BroncoSpace-Lab/scales-hardware/README.md

# scales-hardware
Hardware design files for the Spacecraft Compartmentalized Autonomous Learning and Edge Computing System (SCALES)
