BroncoSpace-Lab/scales-hardware/power_system/readme.md

    
- **Viking 1-C Board Ordered (7/9/25)**
    
    This is the third board of the SCALES EPS. It is based on the RevF schematic which yields the Viking 1-C Board. This board improves on the success of the 1-B board and implements some minor improvements that prevented the Peripheral and Jetson subsystem from activating correctly. 
    
    **List of Changes in Viking 1-C After Production Errors in Viking 1-B**
    
    - Removed R48
    - Removed R83
    - The above mentioned resistors caused too low of a voltage to fully enable the En pins on the load switches, and by simply removing them we can successfully drive the load switches on using GPIO pins.
    - Added 3 MCP9808 I2C Temperature Sensors so we can have some on board temp monitoring, I made sure the addresses dont conflict with that of the other i2c devices on board.
    
    **EPS REV F/ Viking 1-C System Overview:**
    
    - Power Requirements (+28v 8A Max)
        - ML/Edge Computer - Nvidia Jetson (+20V 4A)
        - OBC/Flight Computer - IMX8 (+3.3V 2A)
        - Peripheral System - Raspberry Pi + Wiznet (+5V 2A)
    - Component List
        - Load Switch + Controller: [TPS1HA08-Q1](https://www.ti.com/lit/ds/symlink/tps1ha08-q1.pdf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)
        - Switching Regulator: [LT8612](https://jlcpcb.com/api/file/downloadByFileSystemAccessId/8589836477510287360)
        - IV-Sensor: [INA260AIPWR](https://jlcpcb.com/api/file/downloadByFileSystemAccessId/8589836477510287360)
        - Temperature Sensor: [MCP9808](https://www.microchip.com/en-us/product/mcp9800)
        - Clock Generator: [LTC6902](https://www.analog.com/media/en/technical-documentation/data-sheets/6902f.pdf)
        - I2C Buffer: [TCA4307](https://www.ti.com/lit/ds/symlink/tca4307.pdf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)
        - Comparator (WD Circuit): [TLV1704](https://www.ti.com/lit/ds/symlink/tlv1704-sep.pdf)
        - Subsystem Connector: [DF-11 (2x8)](https://www.lcsc.com/product-detail/Wire-To-Board-Wire-To-Wire-Connector_HRS-Hirose-HRS-DF11-16DP-2DSA-08_C530981.html)
        - Power Connector: [XT-60PWF](https://www.lcsc.com/product-detail/plug_Changzhou-Amass-Elec-XT60PW-F_C428722.html)
    - Concept of Operations
        - OBC is the primary subsystem, which is always enabled. The OBC controls the ML and Perif. via load switches. OBC must hold the respective subsystem EN pin high for it to be active.
        - Each subsystem has a Watch dog that verifies its normal operation; in the case of a fault, the subsystem is disabled by its watch dog.
            - OBC: If the OBC hangs and fails to pet, it is power cycled, as the EN pin for its load switch is always held high with respect to the battery voltage
            - ML/Perif: If either of these subsystems hang and fail to pet, they are disabled until the OBC re-enables them.
        - Monitoring is done by the OBC via I2C from the INA260s, which allows the subsystem to get basic telemetry on the subsystem state of operation
        - There are also 3 seperate temperature sensors that send telemetry back to the IMX8X over a 3.3v I2C
    
    **Block Diagram and Visual Con. Ops**
    
    - EPS RevF Block Diagram

      

    - EPS RevF Concept of Operations
        
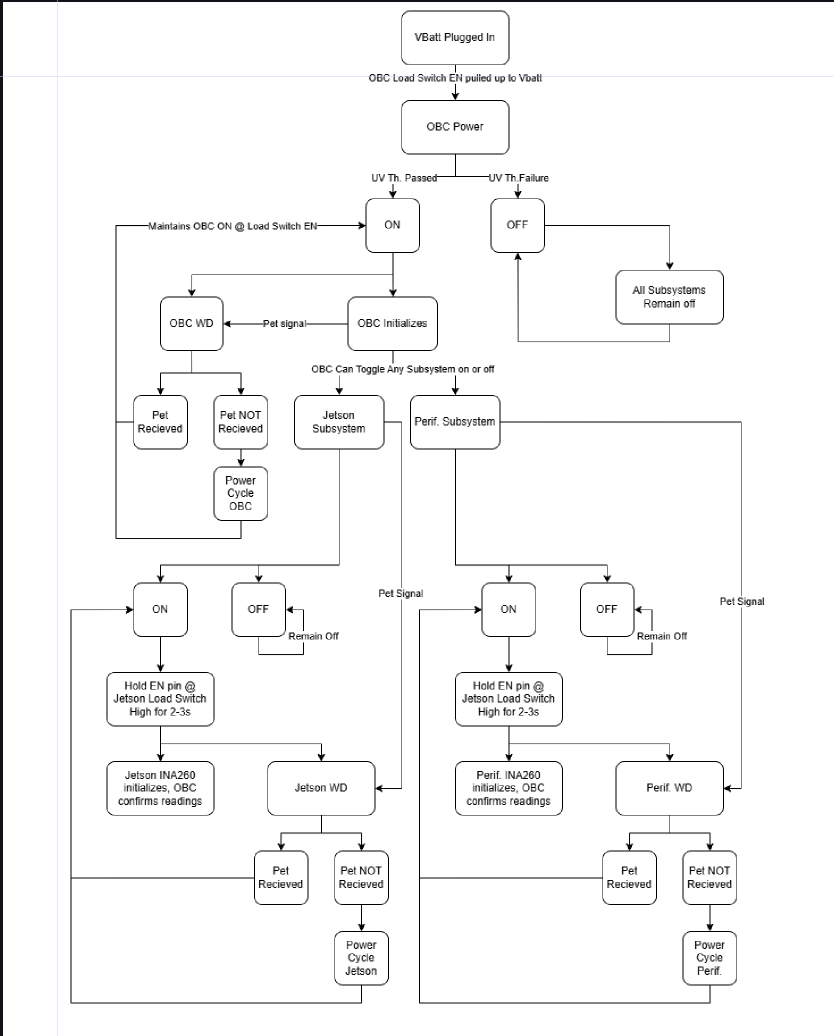
[picture p1: power_system/images/RevE/RevE Con Cops.png]
EPS RevE Con Ops
        

    **Board Schematic**
    
    - Root
        
       
        
    - OBC Subsystem
        
        
        
    - Perif. Subsystem
        
       
        
    - Jetson Subsystem
        
       
        
    - OBC Watchdog Circuit
        
        
        
    - Peripheral Watchdog Circuit
        
       
        
    - Jetson Watchdog Circuit
        
       

    **Board Layout**
    
    - Signal1 Layer
        
        
        
    - GND Layer
        
       
        
    - Power Layer
        
        
        
    - Signal2 Layer
        
        

    **3D Render Front and Back**
    
    - Front
        
        
        
    - Back
        
        
      
###  Viking 1-B Board Ordered (6/20/25) ###
This is the second board of the SCALES EPS. It is based on the RevE schematic which yields the Viking 1-B Board. It seeks to improve on numerous calculation and placement errors in the first prototype. Particularly miscalculated resistor and inductor values as well as significant improvements in placement, routing, fills, and smaller components.

### List of Changes in Viking 1-B After Production Errors in Viking 1-A ###
* R66 was incorrect in 1-A, should have been a 100k, was a 10k instead. Fixed in this revision
* L2 was 8.2uH, should have been 6.1uH (OBC Subsystem)
* L1 was 12uH, should have been 10uH (Perif. Subsystem)
* L3 was 4.7uH, should have been 47uH (Jetson Subsystem)
* Most capacitors were changed to 50V/35V rated 0603 caps, any others are 10v 0402 caps.
* Small change to the Jetson WD circuit, adding a voltage divider to make the voltage safe for the the 10v 0402 caps
* Soft start capacitor was changed for each subsystem, set to 2.2uF for about 1 second. Using the V(t) = (I/C) * t equation, rearrange for t, and I is 2.1*10^-6, C is 2.2uF, and V(t) is 0.97v.
* LEDs on ST pin for all load switches were rearranged for (hopefully) proper fault indication
* 4.7k resistor removed for the I2C buffer
* Connectors were changed for identical variants of the 2*8 Df11 due to low stock
* D1N141WS diodes were changes to D1N4448WS diodes. Almost identical, same package
* Replaced mounting holes with slightly larger ones to match the M2.5 Spec (2.7mm hole diameter)

## EPS_REVE / Viking 1-BSystem Overview: ##

- Power Requirements (+28v 8A Max)
    - ML/Edge Computer - Nvidia Jetson (+20V 4A)
    - OBC/Flight Computer - IMX8 (+3.3V 2A)
    - Peripheral System - Raspberry Pi + Wiznet (+5V 2A)
- Component List
    - Load Switch + Controller: [TPS1HA08-Q1](https://www.ti.com/lit/ds/symlink/tps1ha08-q1.pdf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)
    - Switching Regulator: [LT8612](https://jlcpcb.com/api/file/downloadByFileSystemAccessId/8589836477510287360)
    - IV-Sensor: [INA260AIPWR](https://jlcpcb.com/api/file/downloadByFileSystemAccessId/8589836477510287360)
    - Clock Generator: [LTC6902](https://www.analog.com/media/en/technical-documentation/data-sheets/6902f.pdf)
    - I2C Buffer: [TCA4307](https://www.ti.com/lit/ds/symlink/tca4307.pdf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)
    - Comparator (WD Circuit): [TLV1704](https://www.ti.com/lit/ds/symlink/tlv1704-sep.pdf)
    - Subsystem Connector: [DF-11 (2x8)](https://www.lcsc.com/product-detail/Wire-To-Board-Wire-To-Wire-Connector_HRS-Hirose-HRS-DF11-16DP-2DSA-08_C530981.html)
    - Power Connector: [XT-60PWF](https://www.lcsc.com/product-detail/plug_Changzhou-Amass-Elec-XT60PW-F_C428722.html)
- Concept of Operations
    - OBC is the primary subsystem, which is always enabled. The OBC controls the ML and Perif. via load switches. OBC must hold the respective subsystem EN pin high for it to be active.
    - Each subsystem has a Watch dog that verifies its normal operation; in the case of a fault, the subsystem is disabled by its watch dog.
        - OBC: If the OBC hangs and fails to pet, it is power cycled, as the EN pin for its load switch is always held high with respect to the battery voltage
        - ML/Perif: If either of these subsystems hang and fail to pet, they are disabled until the OBC re-enables them.
    - Monitoring is done by the OBC via I2C from the INA260s, which allows the subsystem to get basic telemetry on the subsystem state of operation

## Block Diagram and Visual Con. Ops ##

* EPS RevE Block Diagram

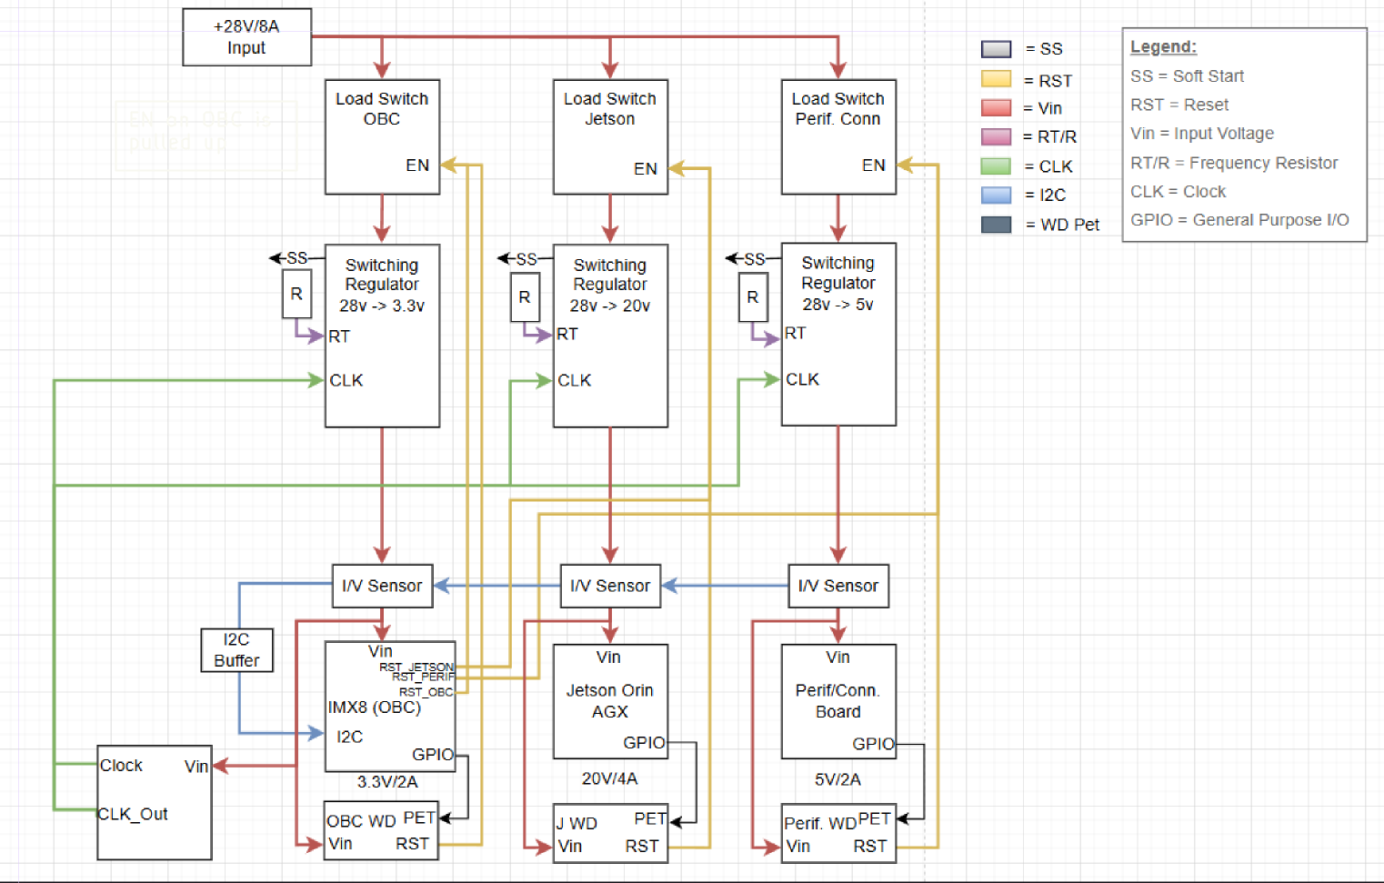
[picture p2: power_system/images/RevE/EPSREVEBlockDiagram.png]
EPS RevE Block Diagram
    

* EPS RevD Concept of Operations

    EPS RevE Con Ops

## **Board Schematic** ##
* Root

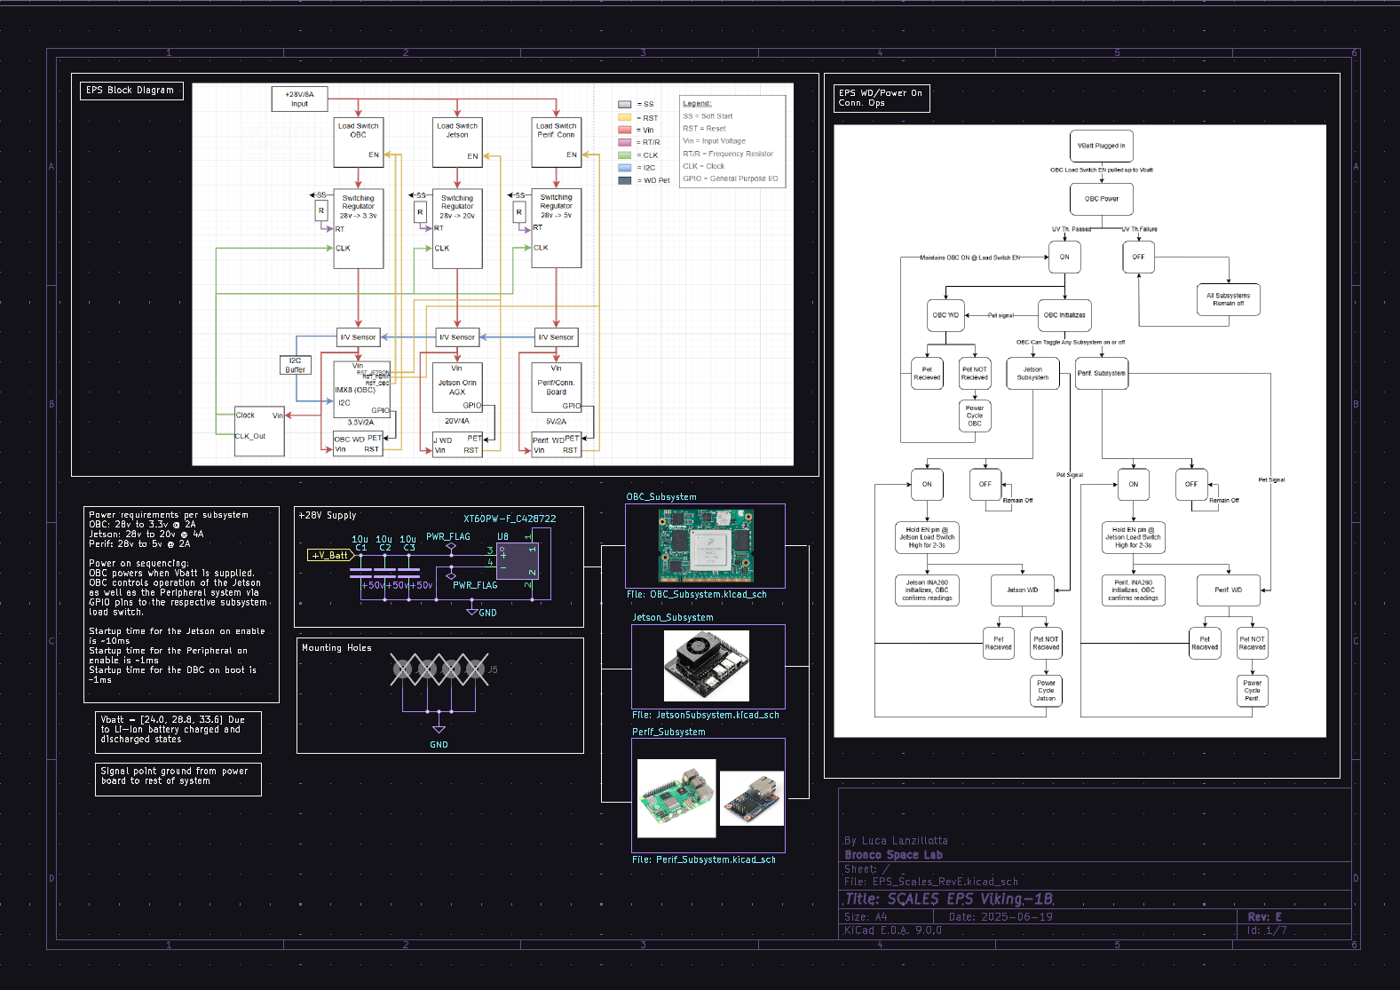
[picture p3: power_system/images/RevE/Root.png]
Root
    

* OBC Subsystem

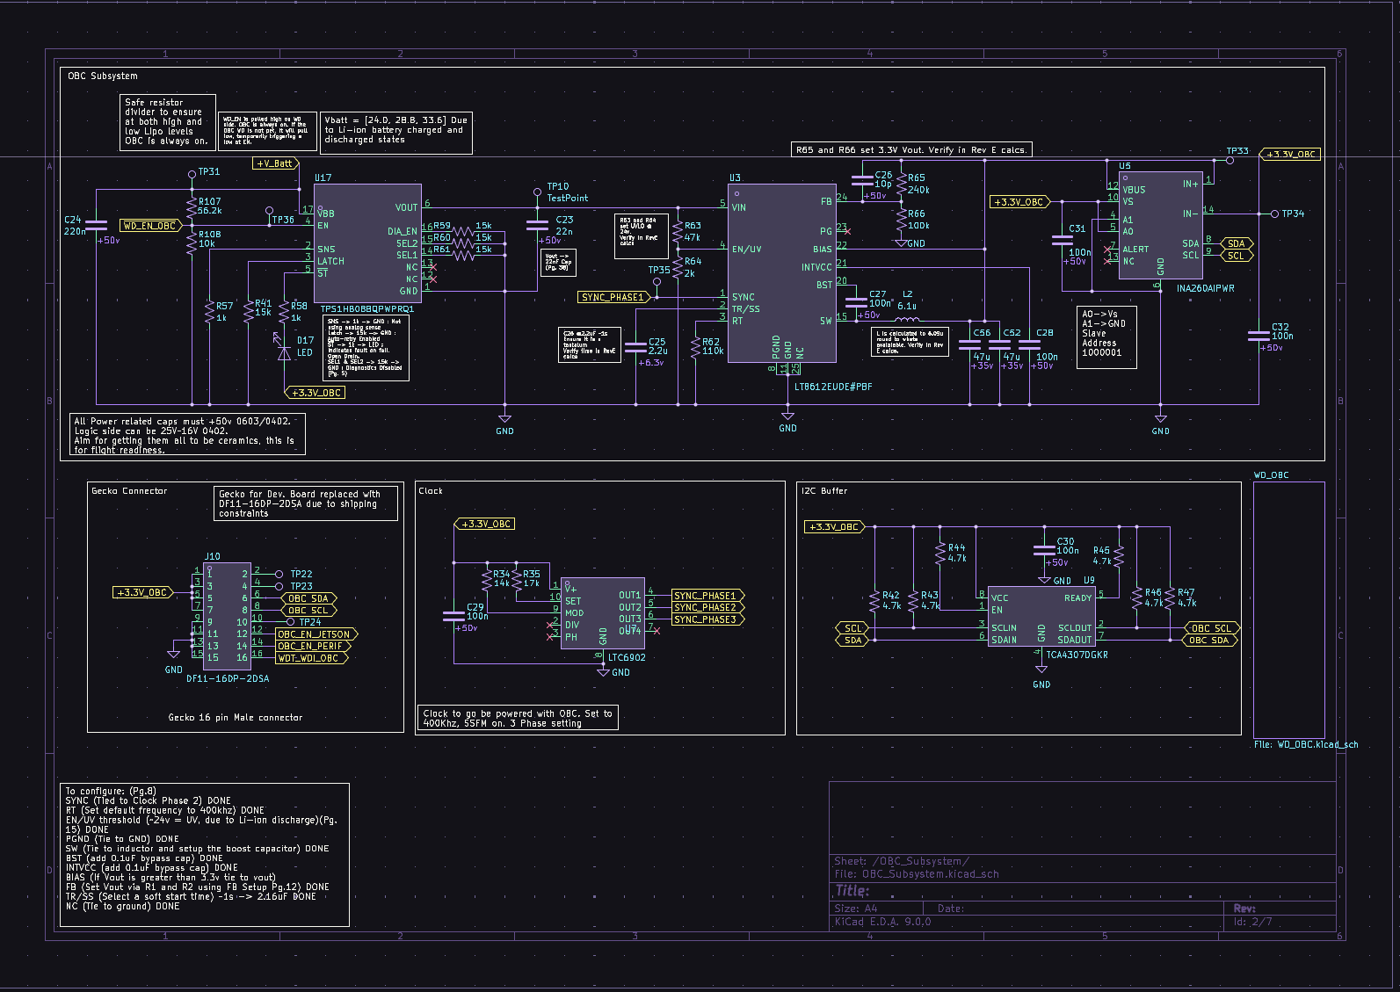
[picture p4: power_system/images/RevE/OBCSubsystem.png]
OBC Subsystem
    

* Perif. Subsystem

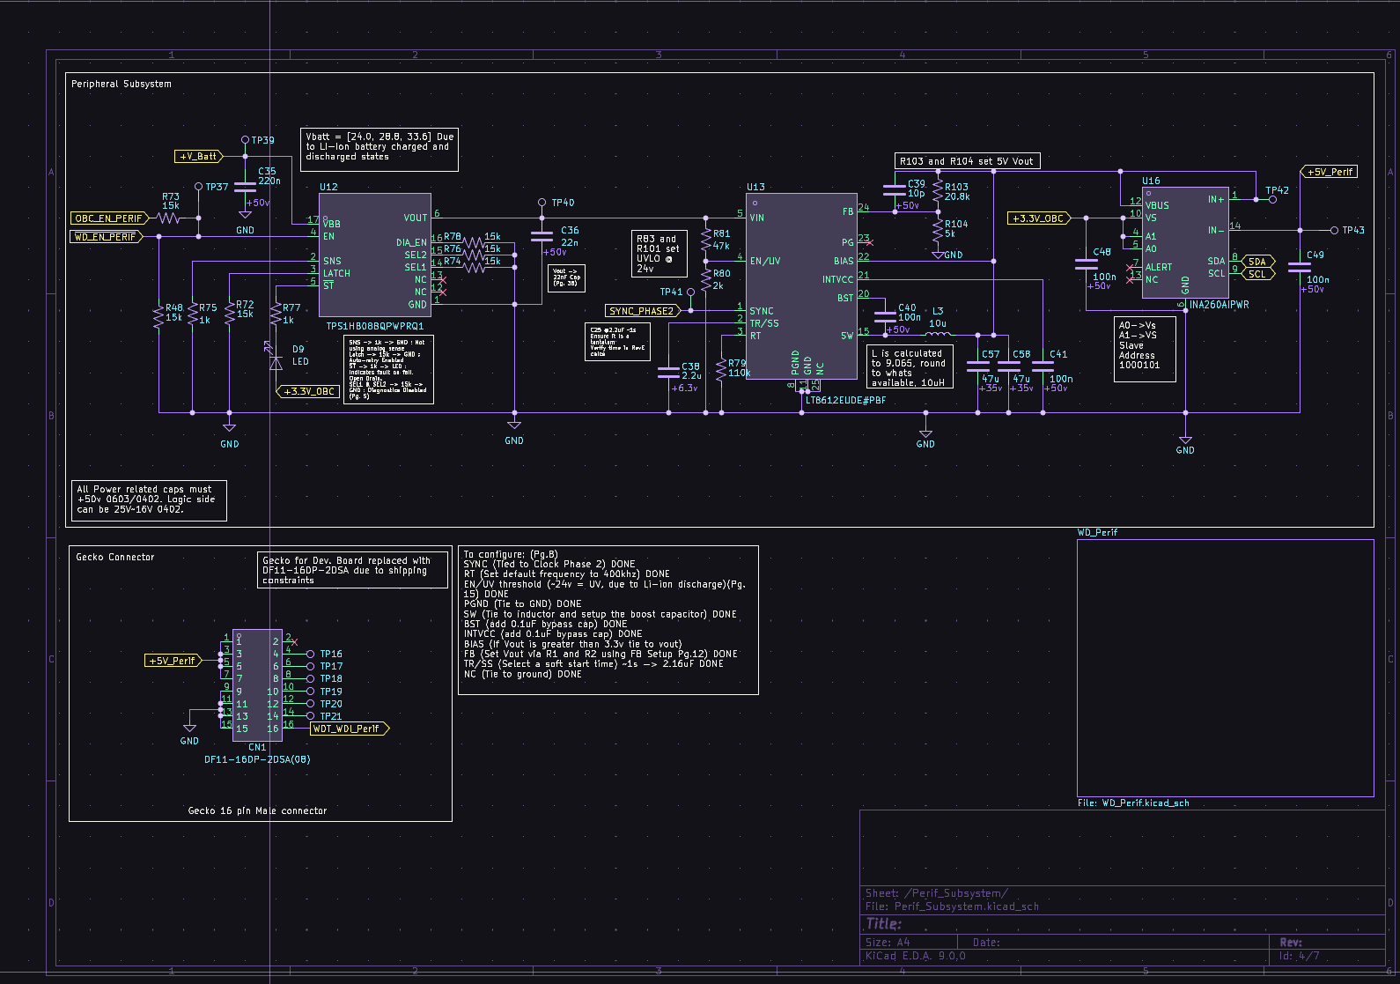
[picture p5: power_system/images/RevE/Perif.Subsystem.png]
Perif. Subsystem
    

* Jetson Subsystem

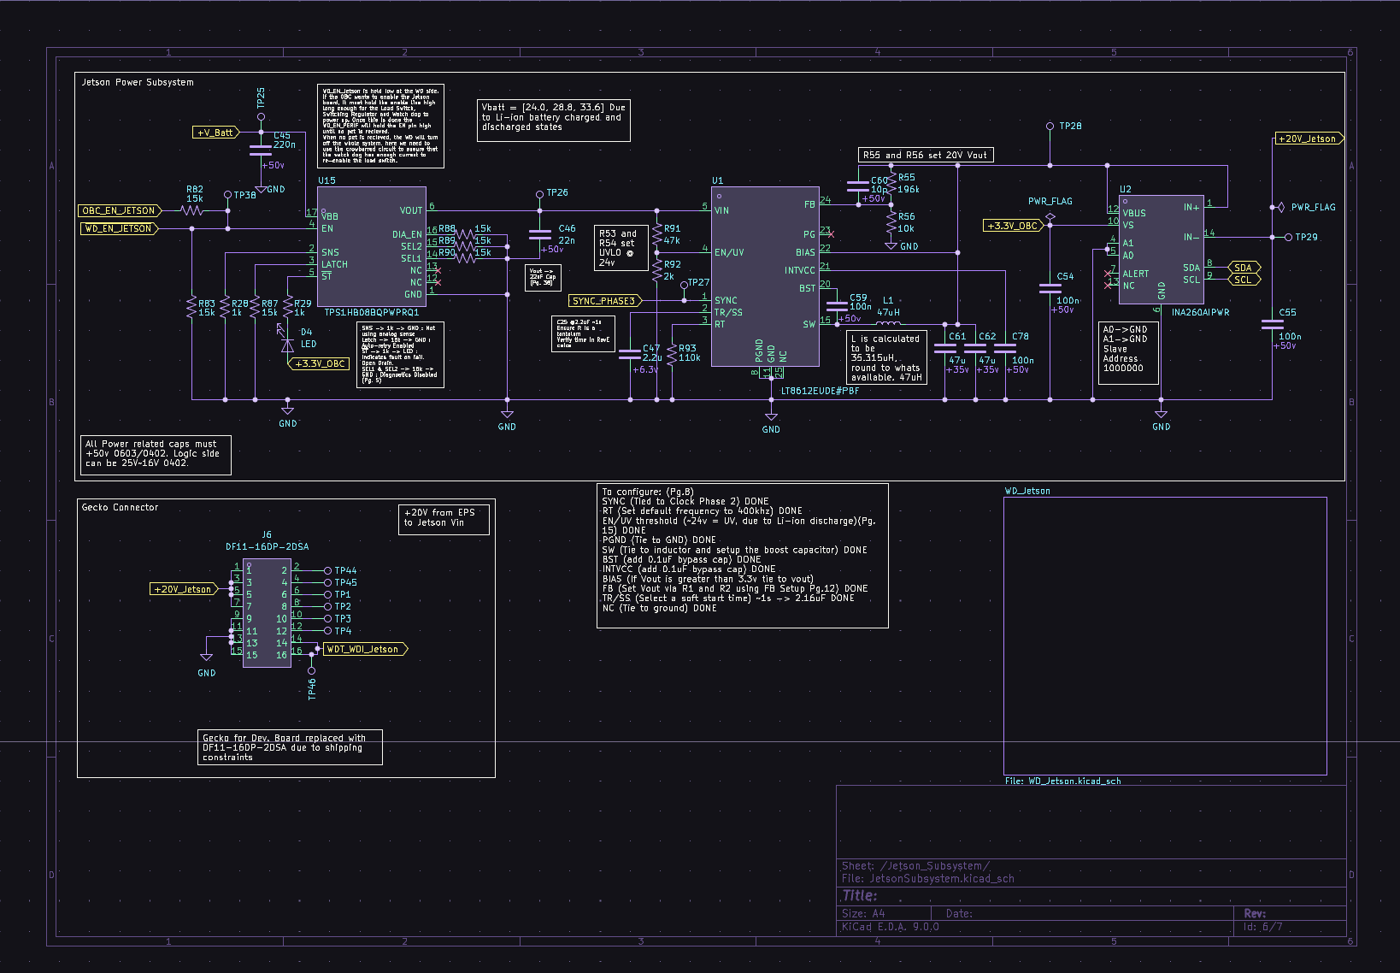
[picture p6: power_system/images/RevE/JetsonSubsystem.png]
Jetson Subsystem
    

* OBC Watchdog Circuit

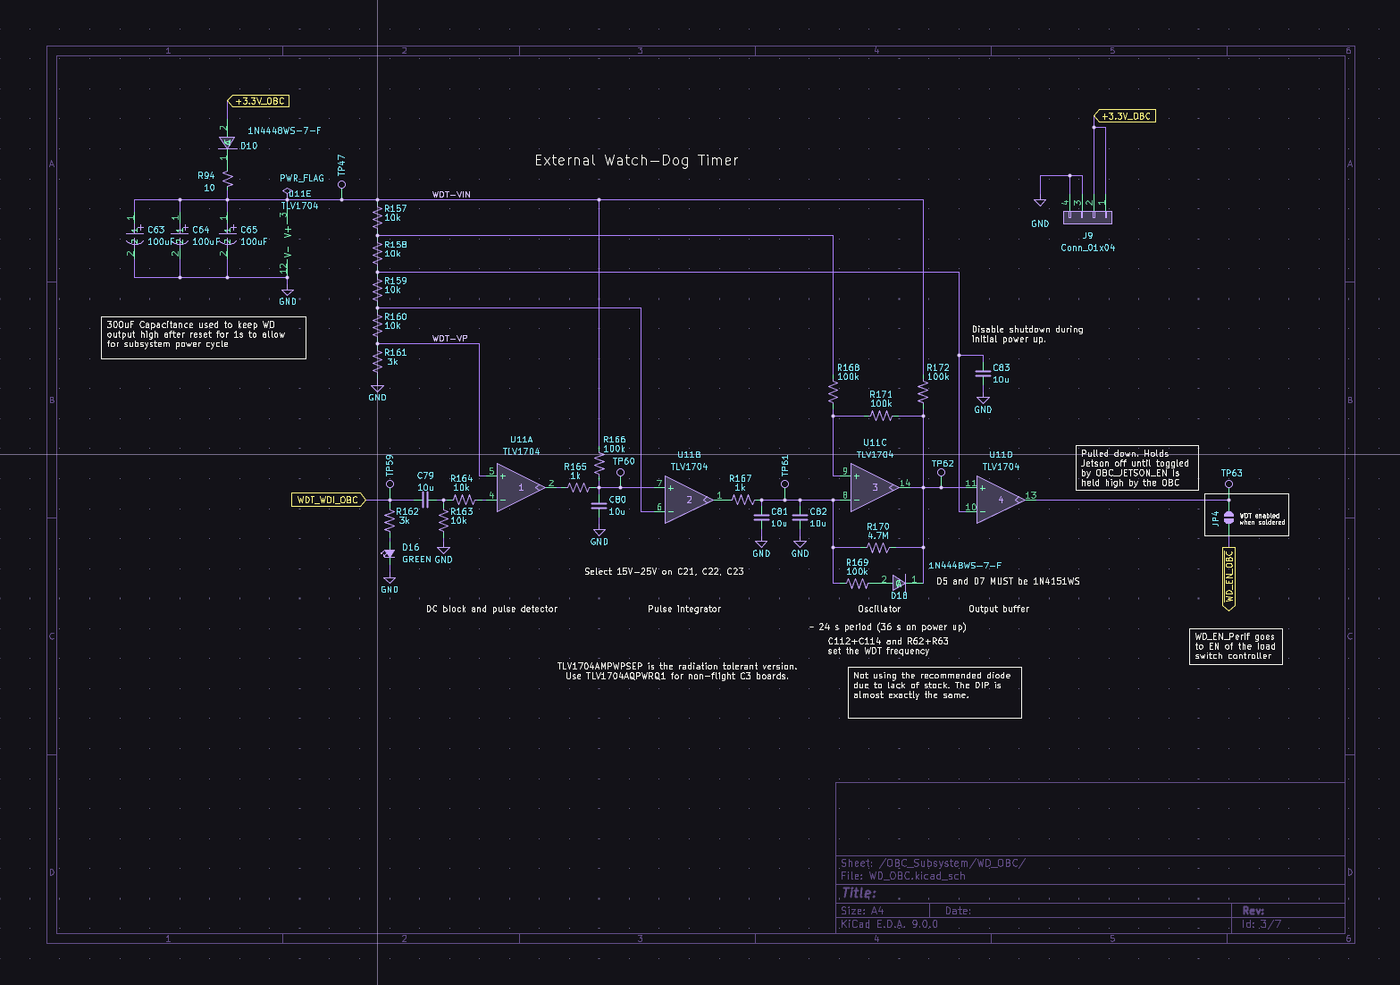
[picture p7: power_system/images/RevE/OBCWD.png]
    

* Peripheral Watchdog Circuit

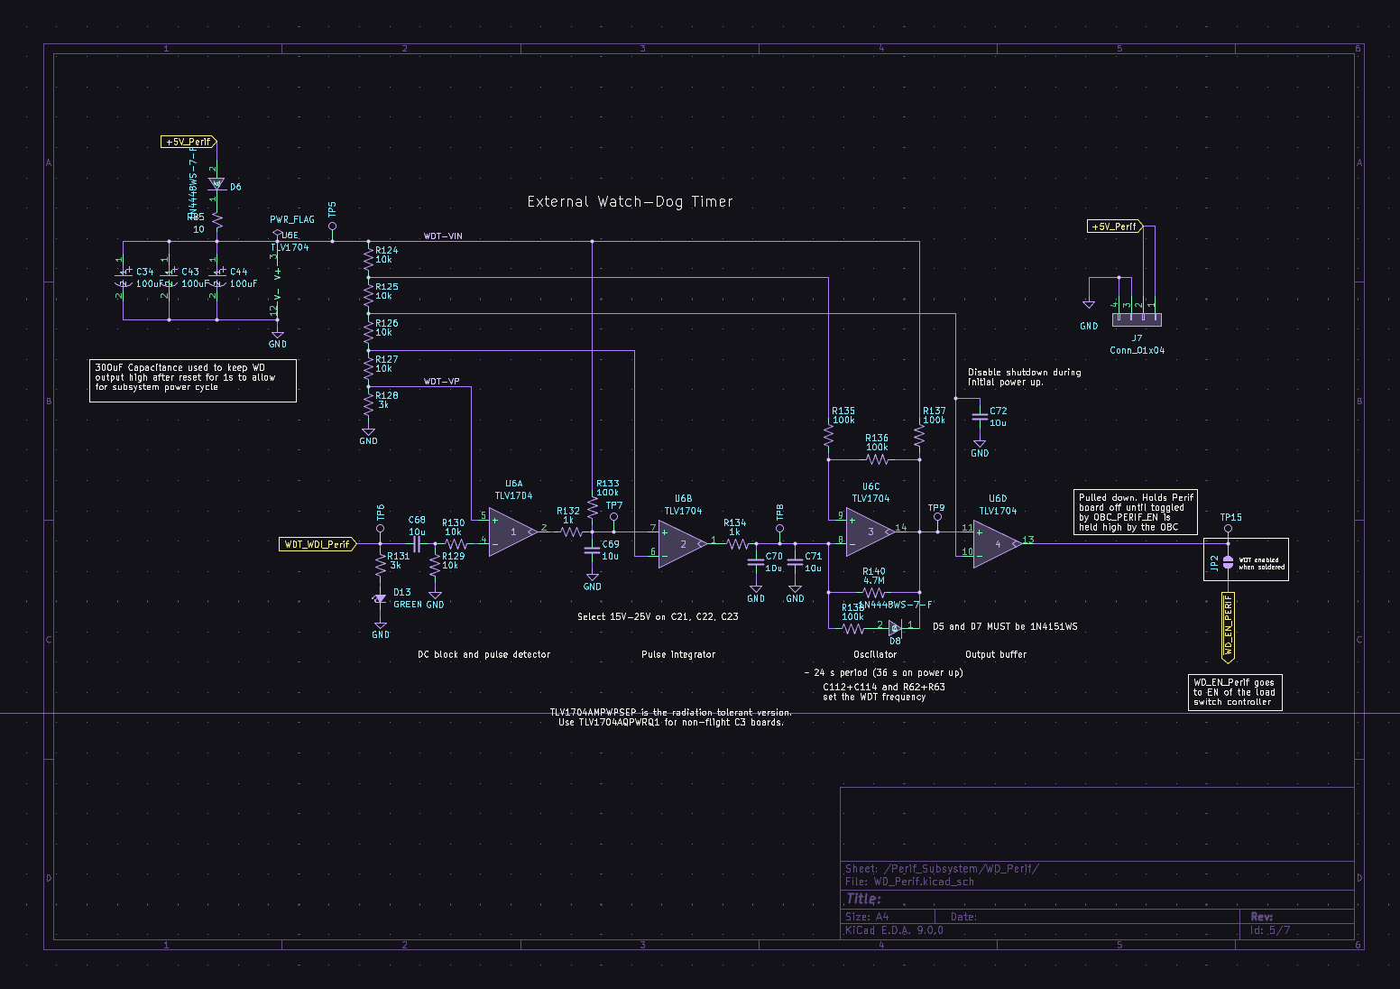
[picture p8: power_system/images/RevE/PerifWD.png]
    

* Jetson Watchdog Circuit
    
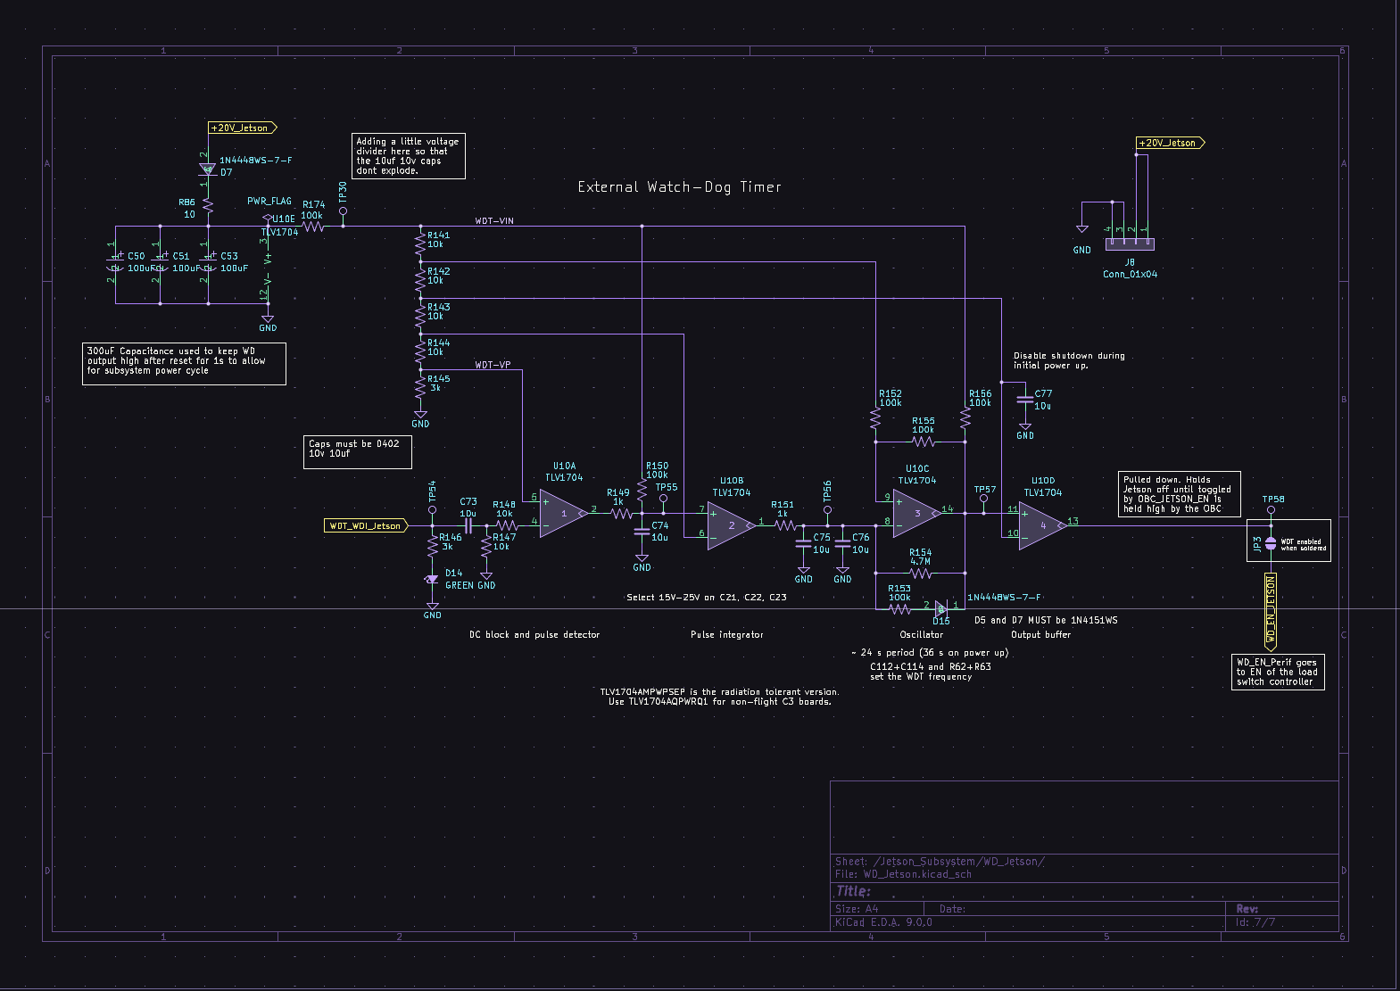
[picture p9: power_system/images/RevE/JetsonWD.png]
    

## **Board Layout** ##

* Signal1 Layer

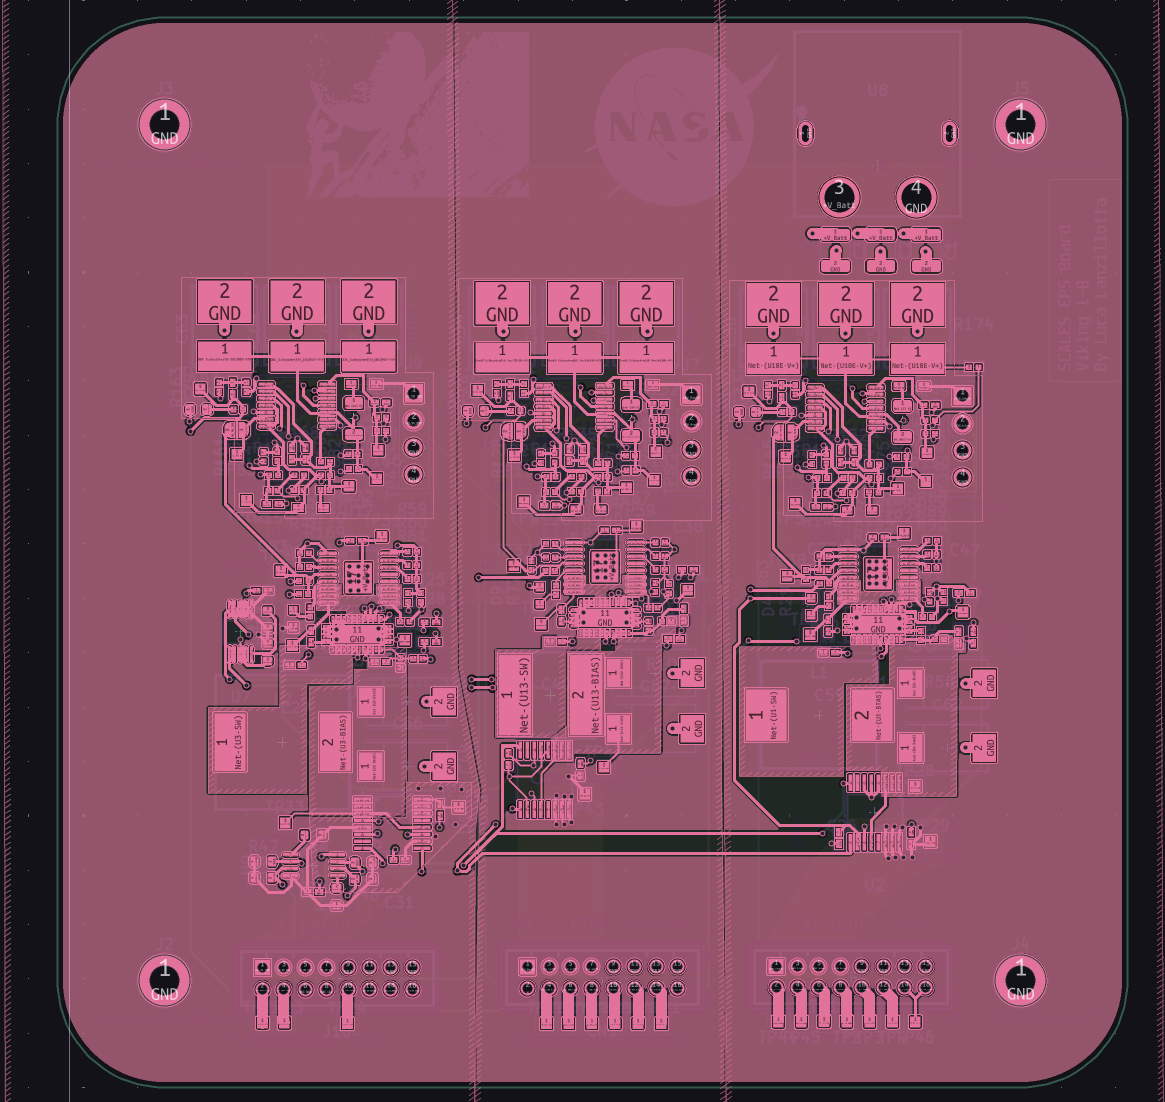
[picture p10: power_system/images/RevE/Signal1.png]
Signal1 Layer
    
    
* GND Layer

    GND Layer
    
* Power Layer

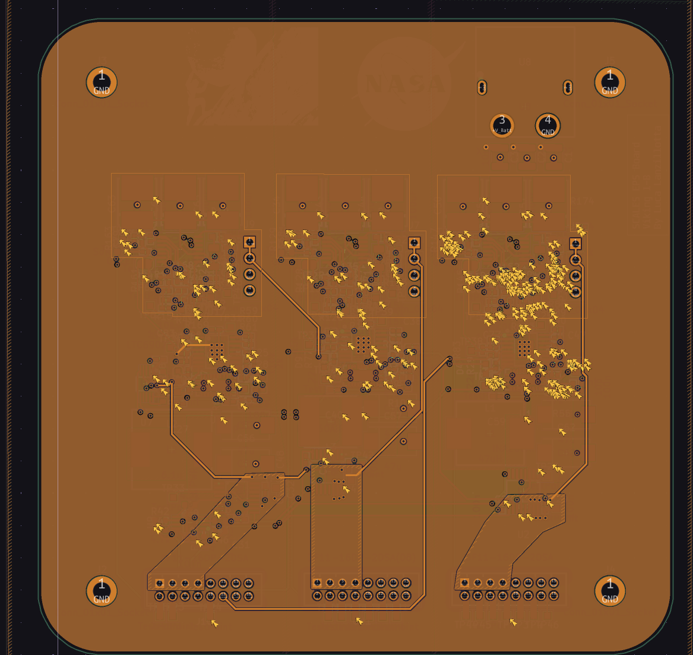
[picture p11: power_system/images/RevE/Power.png]
Power Layer
    
    
* Signal2 Layer

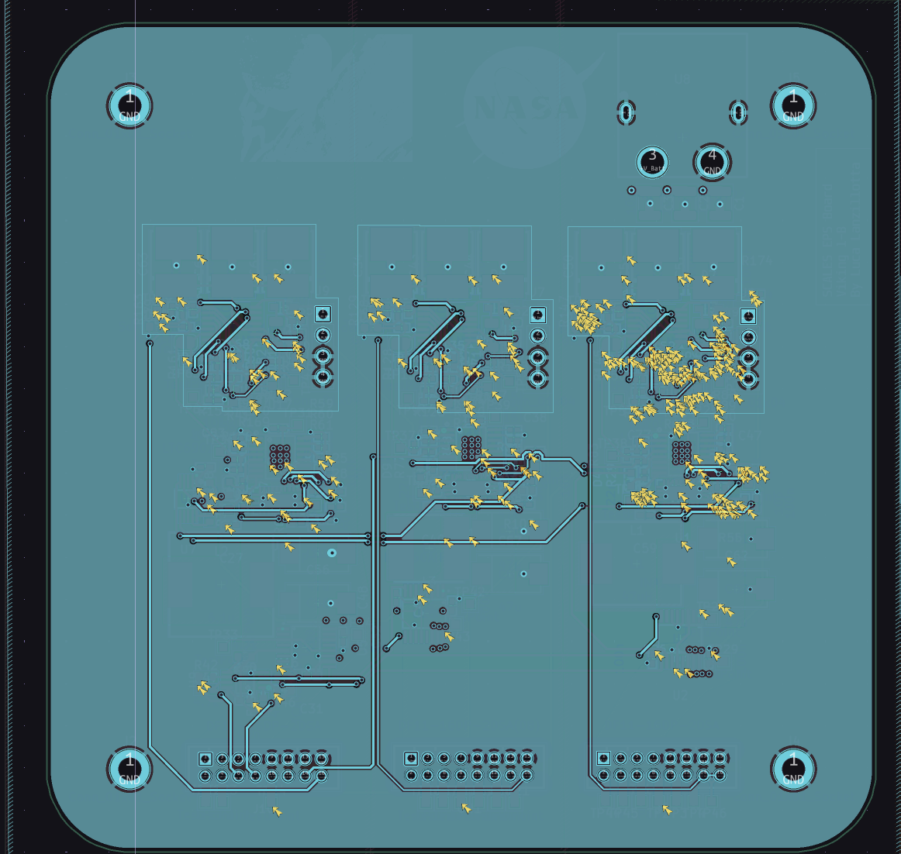
[picture p12: power_system/images/RevE/Signal2.png]
Signal2 Layer
    
    
## 3D Render Front and Back ##
    
* Front

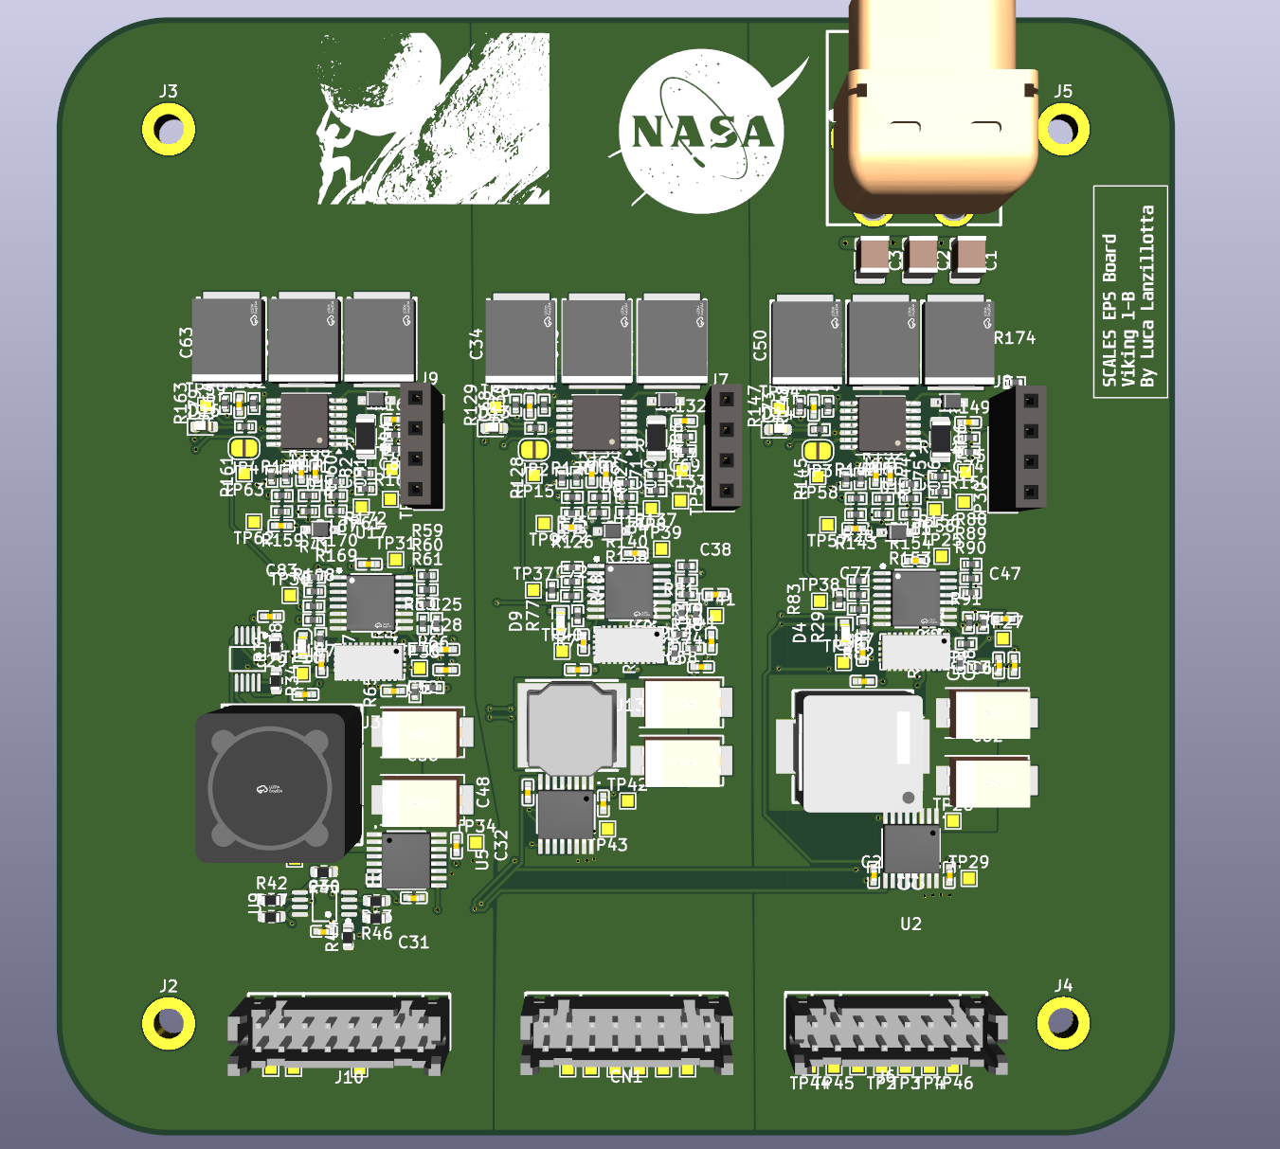
[picture p13: power_system/images/RevE/Front.png]
Front
    
        
* Back   

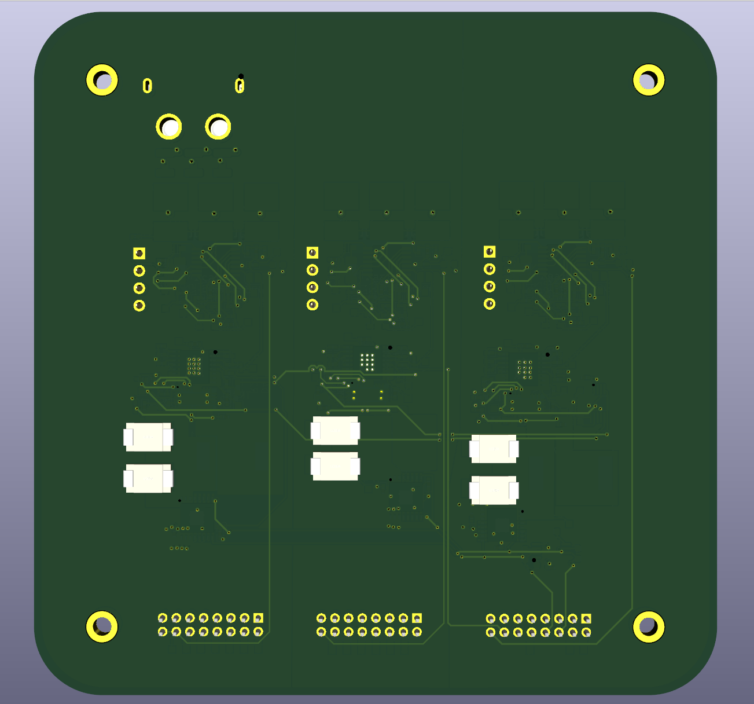
[picture p14: power_system/images/RevE/Back.png]
Back
    

## **Testing and Evaluation**

Using the on board test points in the schematic, we can check if all the voltages behave as designed. Use the below references to check if the expectations are met.

Overall Board:

- [ ]  TP 31, 39, 25  → 28v (Vbatt)
- [ ]  Mounting Holes → GND

OBC Subsystem:

- [ ]  TP 36 → EN (Should be 28*10k/66.2k)
- [ ]  TP 32 → ~28v to Switching Regulator
- [ ]  TP 35 → SYNCPHASE1 (400Khz 0 deg out of phase)
- [ ]  TP 33 → Output of Switching regulator (~3.3V)
- [ ]  TP 34 → Output of INA260 (~3.3V)

WD_OBC:

- [ ]  TP 48 → Ensures WD is supplied with power
- [ ]  TP 49 → WD Input from OBC GPIO for pet
- [ ]  TP 53 → WD Open collector output, can only drive low, otherwise floating

Jetson Subsystem: 

- [ ]  TP 38 → Tests the GPIO input from the OBC/WD EN Pin (Should be held high when System is active, low on PET failure)
- [ ]  TP 25 → ~28v (Vbatt)
- [ ]  TP 26 → ~28v output from load switch
- [ ]  TP 27 → SYNCPHASE3 (400khz 180 deg out of phase from PHASE1)
- [ ]  TP28 → ~20v (Output from Switching regulator)
- [ ]  TP 29 → ~20v (Output from INA290 to Jetson Subsystem)
    
    WD_OBC:
    
    - [ ]  TP 10 → Check WD Supply power, should be 20v
    - [ ]  TP 11 → WD Interface input line, held high when there is a pet
    - [ ]  TP 47 Open collector output from the Watchdog, should be half of whatever the OBC GPIO pin voltage is when high, and then ground any other time

Peripheral Subsystem:

- [ ]  TP 39 → ~28v (Vbatt)
- [ ]  TP 82 → OBC GPIO input for EN line and WD En line, should be ~1.4v when high for OBC holding it high, and low when not held high.
- [ ]  TP 40 → ~28v output of the load switch
- [ ]  TP 41 → SYNCPHASE2 Output of LTC6902 (400khz 90 deg out of phase)
- [ ]  TP 42 → Input regulated power to the INA260, should be roughly +5v
- [ ]  TP 43 → output for the Peripheral subsystem, should be roughly +5v
    
    WD_Perif:
    
    - [ ]  TP 5 → 5v supply to power the watch dog
    - [ ]  TP 15 → WD Perif output always pulled low, should be low when the system is off, and held high when the OBC enables it, when the pet fails it will hold low until the subsystem turns off.

------------------------------------------------------------------------------------------------------------------------------------------

###  Viking 1-A Board Ordered (6/4/25) ###
The first board that was ordered was based on the EPS SCALES REV D schematic and is the Viking 1-A board.
This board can be found on github with the commit titled the same name.
This board does have some production issues which were already fixed and committed under the same name.
The production errors that this board include are simple, which is why they are included under the same board revision, they are simply lack of copper fills over the remaining area of the board which were corrected by the manufacturer. Post evaluation and testing of the Viking 1-A board will allow for next design implementation and lead to the Viking 1-B board.

### List of Changes After Production Errors for Viking 1-A ###
Copper fills were missing around the majority of non power traces and were causing difficulties in manufacuring, this was corrected by JLCPCB by their fab engineers, but I took the liberty of adding the same type of corrections to the existing board version. These are included in the latest commit.

## EPS_REVD / Viking 1-A System Overview: ##

- Power Requirements (+28v 8A Max)
    - ML/Edge Computer - Nvidia Jetson (+20V 4A)
    - OBC/Flight Computer - IMX8 (+3.3V 2A)
    - Peripheral System - Raspberry Pi + Wiznet (+5V 2A)
- Component List
    - Load Switch + Controller: [TPS1HA08-Q1](https://www.ti.com/lit/ds/symlink/tps1ha08-q1.pdf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)
    - Switching Regulator: [LT8612](https://jlcpcb.com/api/file/downloadByFileSystemAccessId/8589836477510287360)
    - IV-Sensor: [INA260AIPWR](https://jlcpcb.com/api/file/downloadByFileSystemAccessId/8589836477510287360)
    - Clock Generator: [LTC6902](https://www.analog.com/media/en/technical-documentation/data-sheets/6902f.pdf)
    - I2C Buffer: [TCA4307](https://www.ti.com/lit/ds/symlink/tca4307.pdf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)
    - Comparator (WD Circuit): [TLV1704](https://www.ti.com/lit/ds/symlink/tlv1704-sep.pdf)
    - Subsystem Connector: [DF-11 (2x8)](https://www.lcsc.com/product-detail/Wire-To-Board-Wire-To-Wire-Connector_HRS-Hirose-HRS-DF11-16DP-2DSA-08_C530981.html)
    - Power Connector: [XT-60PWF](https://www.lcsc.com/product-detail/plug_Changzhou-Amass-Elec-XT60PW-F_C428722.html)
- Concept of Operations
    - OBC is the primary subsystem, which is always enabled. The OBC controls the ML and Perif. via load switches. OBC must hold the respective subsystem EN pin high for it to be active.
    - Each subsystem has a Watch dog that verifies its normal operation; in the case of a fault, the subsystem is disabled by its watch dog.
        - OBC: If the OBC hangs and fails to pet, it is power cycled, as the EN pin for its load switch is always held high with respect to the battery voltage
        - ML/Perif: If either of these subsystems hang and fail to pet, they are disabled until the OBC re-enables them.
    - Monitoring is done by the OBC via I2C from the INA260s, which allows the subsystem to get basic telemetry on the subsystem state of operation

## Block Diagram and Visual Con. Ops ##

* EPS RevD Block Diagram

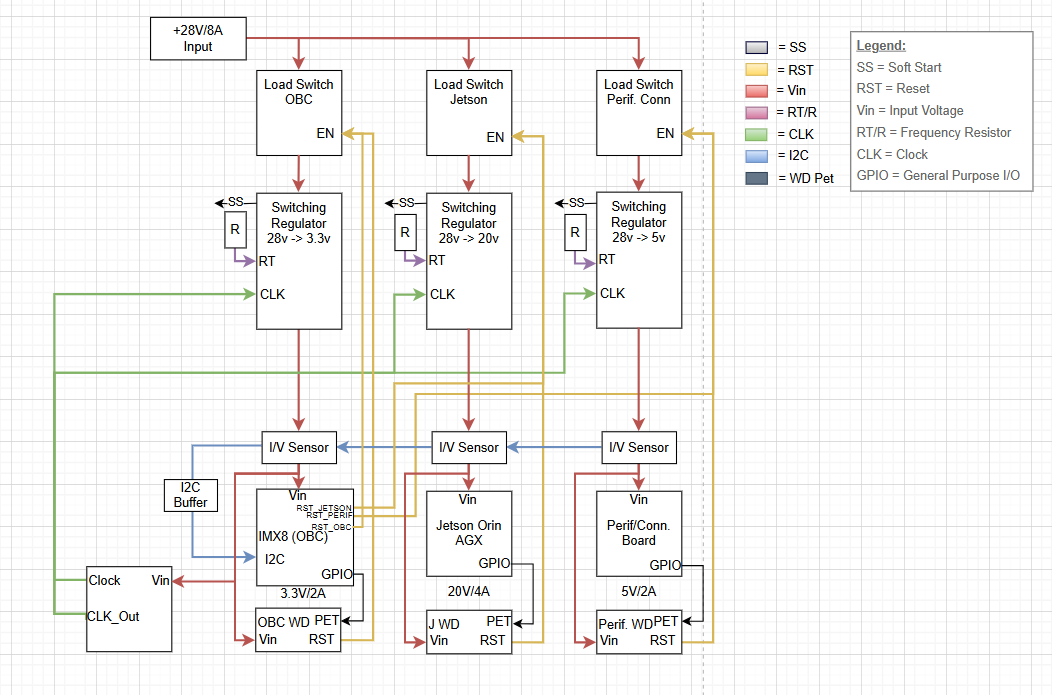
[picture p15: power_system/images/RevD/Block_Diagram_EPSREVD.png]
EPS RevD Block Diagram
    

* EPS RevD Concept of Operations

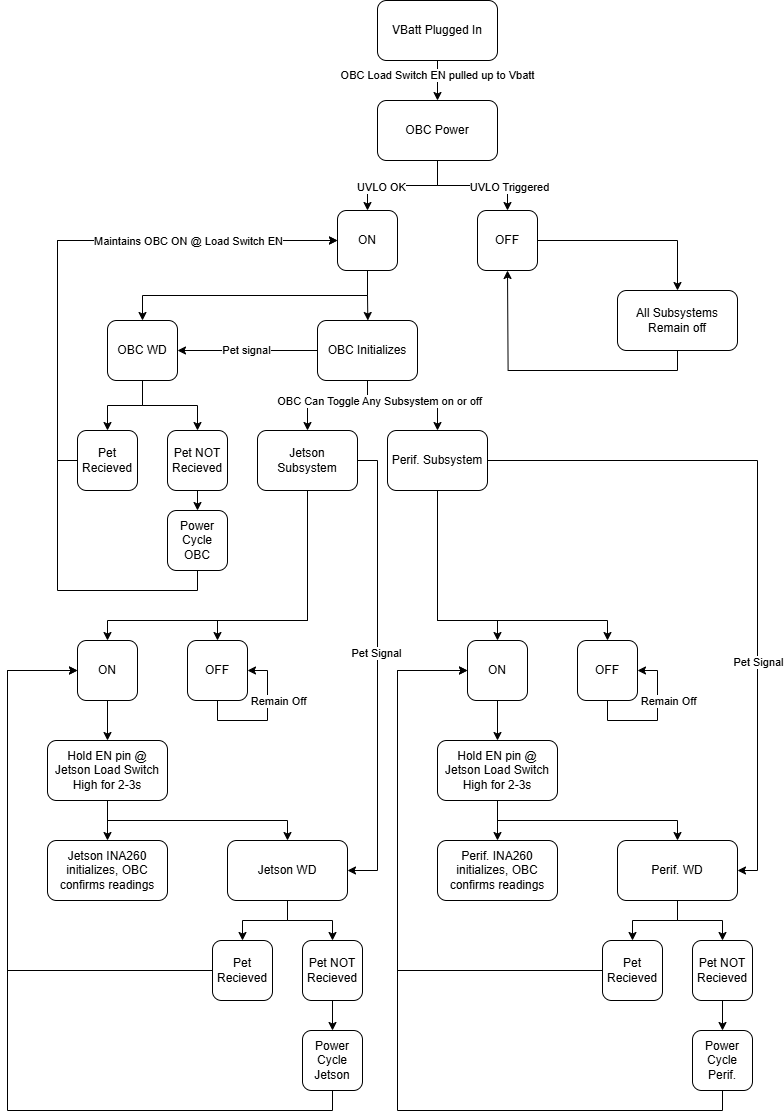
[picture p16: power_system/images/RevD/EPS_RevD_ConnOps.drawio.png]
EPS RevD Concept of Operations
    

## **Board Schematic** ##
* Root

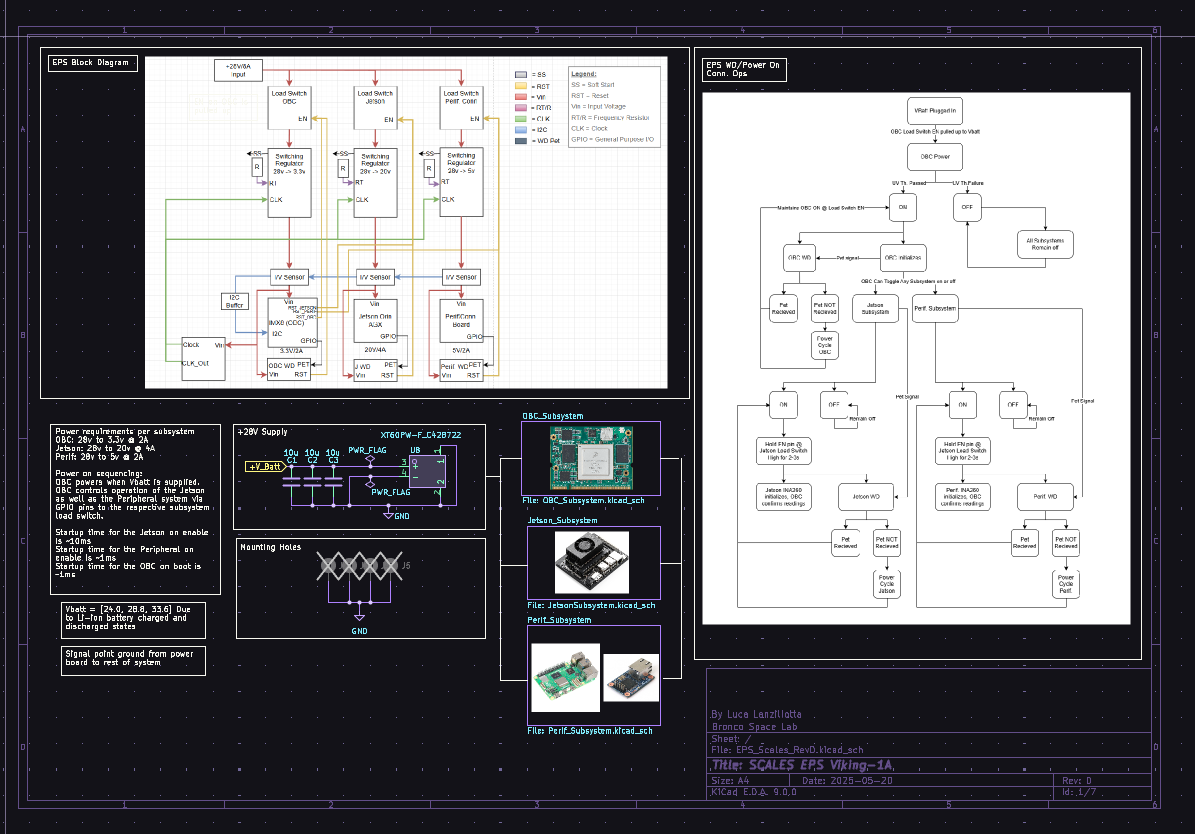
[picture p17: power_system/images/RevD/Root.png]
Root
    

* Jetson Subsystem

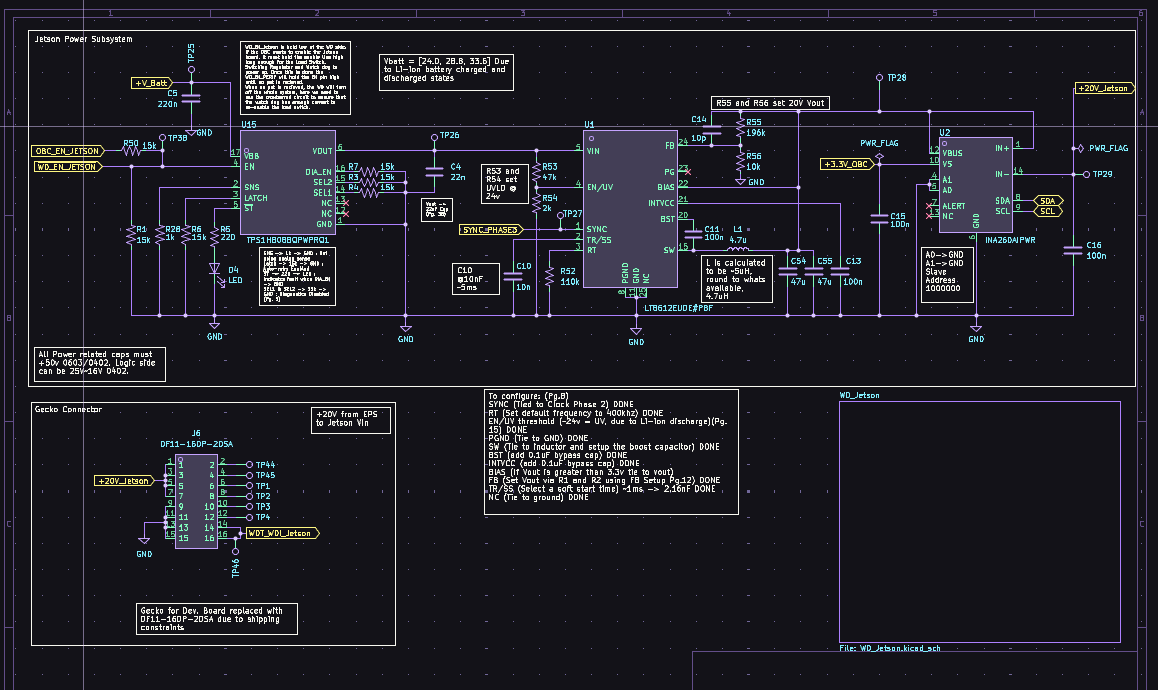
[picture p18: power_system/images/RevD/Jetson Subsystem.png]
Jetson Subsystem
    

* OBC Subsystem

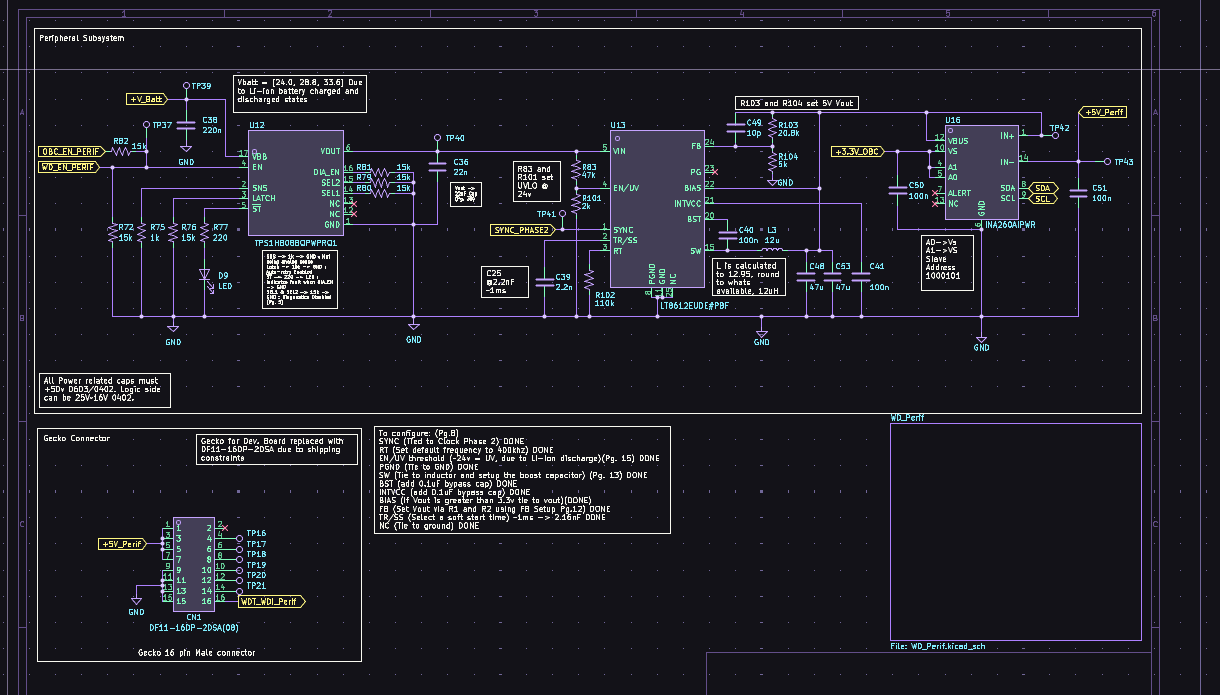
[picture p19: power_system/images/RevD/OBC Subsystem.png]
OBC Subsystem
    

* Perif. Subsystem

    Perif. Subsystem
    
* Watchdog Circuit

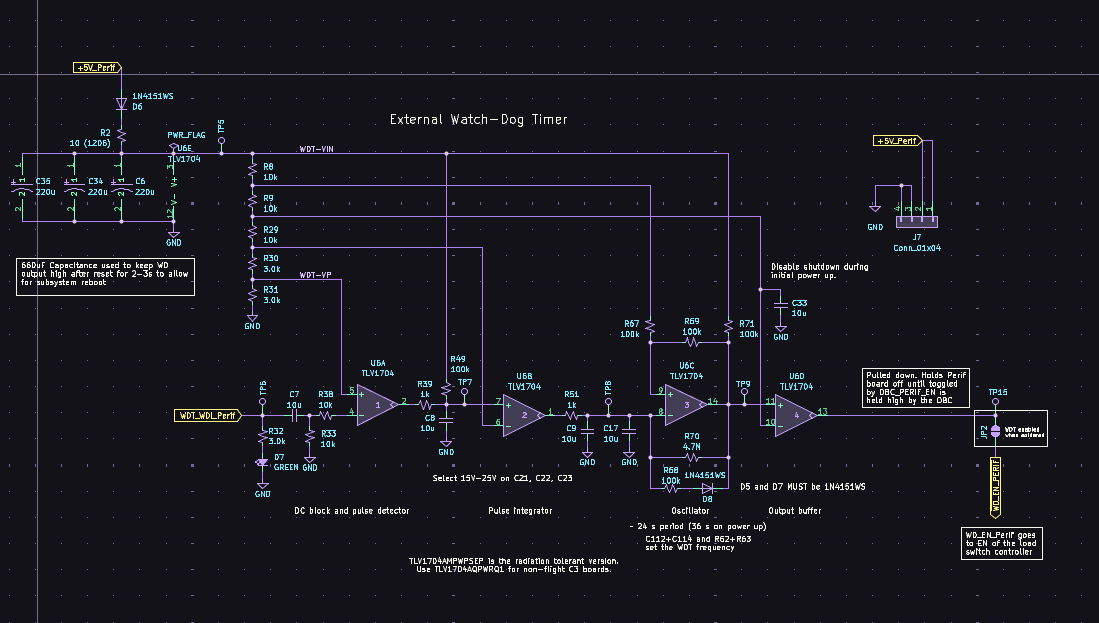
[picture p20: power_system/images/RevD/Watchdog Circuit.png]
Watchdog Circuit
    

## **Board Layout** ##

* Signal1 Layer

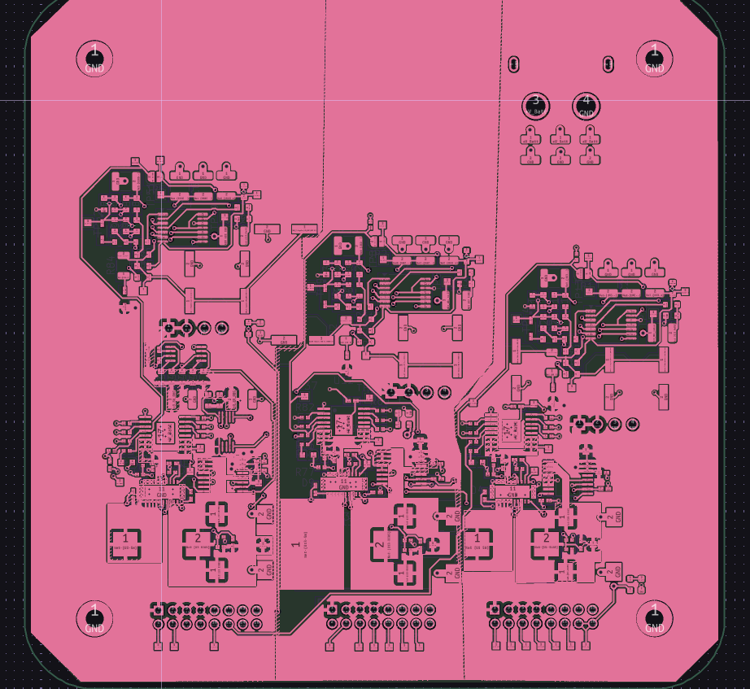
[picture p21: power_system/images/RevD/Signal1 Layer.png]
Signal1 Layer
    
    
* GND Layer

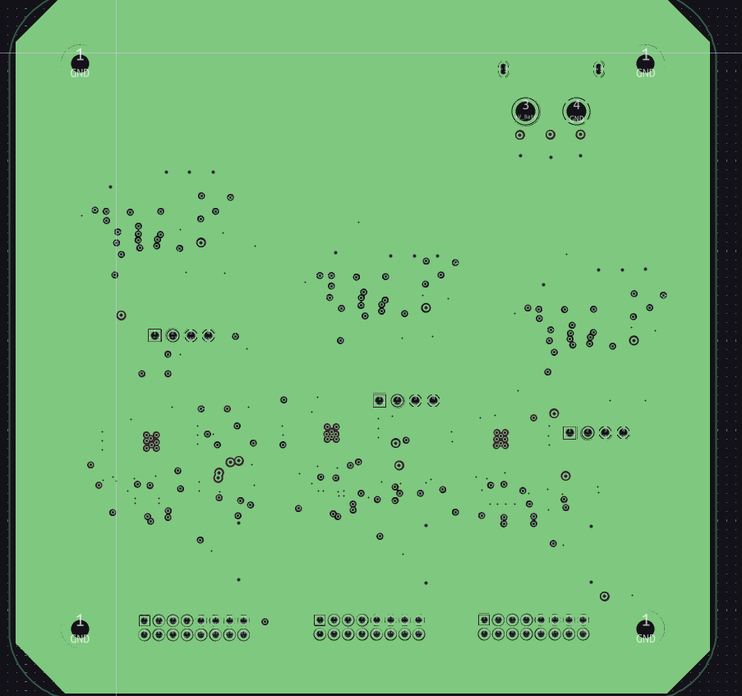
[picture p22: power_system/images/RevD/GND Layer.png]
GND Layer
    
    
* Power Layer

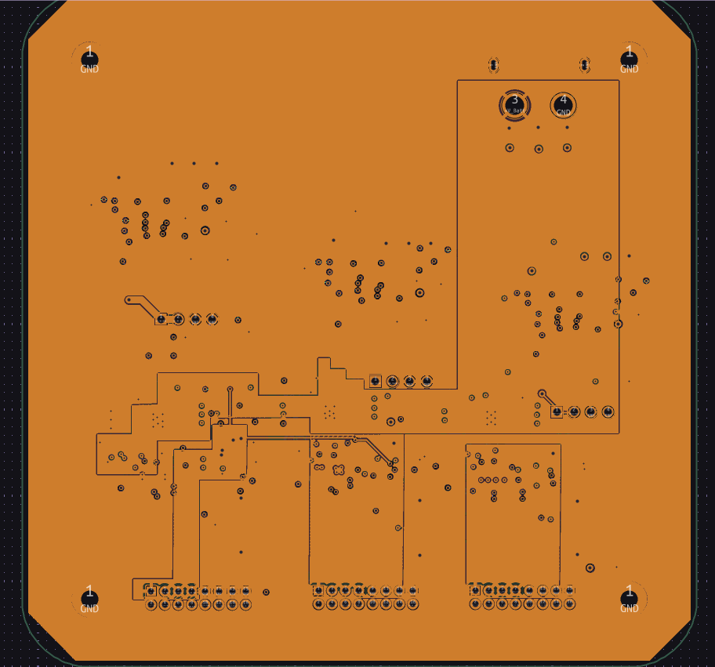
[picture p23: power_system/images/RevD/Power Layer.png]
Power Layer
    
    
* Signal2 Layer

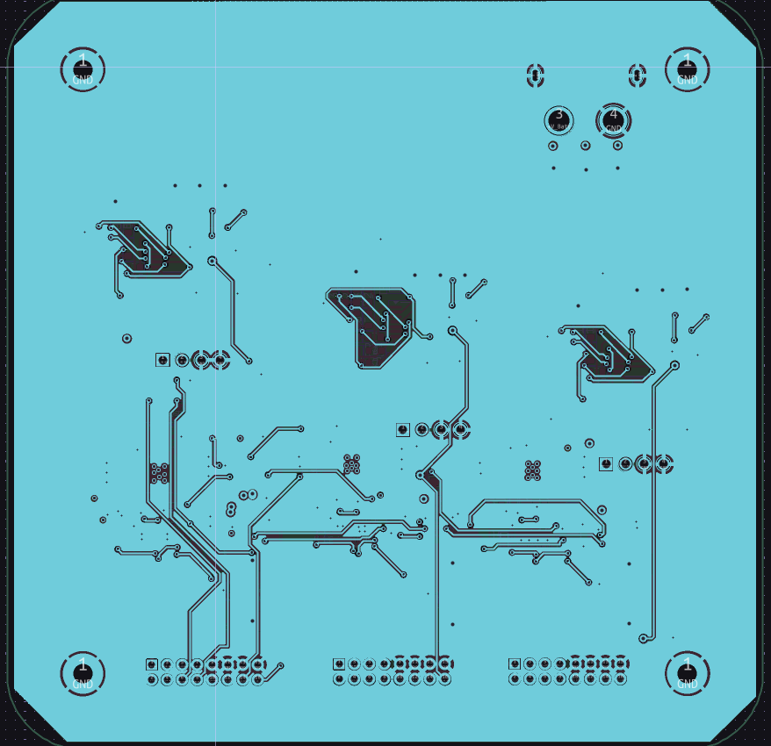
[picture p24: power_system/images/RevD/Signal2 Layer.png]
Signal2 Layer
    
    
## 3D Render Front and Back ##
    
* Front

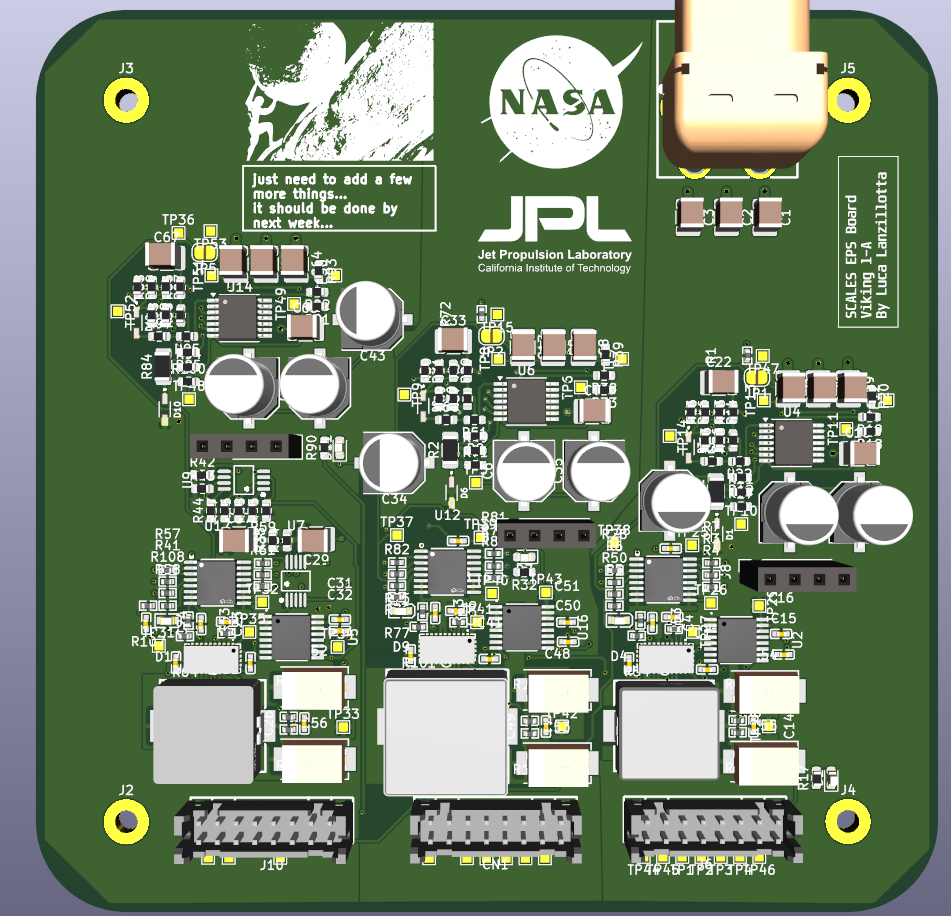
[picture p25: power_system/images/RevD/Front.png]
Front
    
        
* Back   

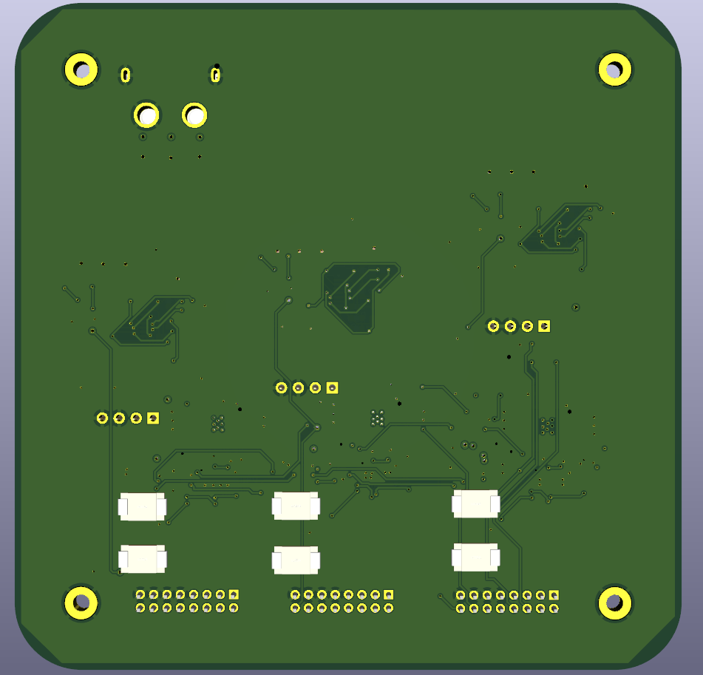
[picture p26: power_system/images/RevD/Back.png]
Back
    

## **Testing and Evaluation**

Using the on board test points and the expected probe locations based on the schematic, we can check if all the voltages are as required, if the watch dogs are behaving as expected, and if there are any components that may not be performing as required.

Overall Board:

- [ ]  TP 25, 31, 39 → 28v (Vbatt)
- [ ]  Mounting Holes → GND

OBC Subsystem:

- [ ]  TP 36 → EN
- [ ]  TP 32 → ~28v to Switching Regulator
- [ ]  TP 35 → SYNCPHASE1 (400Khz 0 deg out of phase)
- [ ]  TP 33 → Output of Switching regulator (~3.3V)
- [ ]  TP 34 → Output of INA260 (~3.3V)

WD_OBC:

- [ ]  TP 48 → Ensures WD is supplied with power
- [ ]  TP 49 → WD Input from OBC GPIO for pet
- [ ]  TP 53 → WD Open collector output, can only drive low, otherwise floating

Jetson Subsystem: 

- [ ]  TP 38 → Tests the GPIO input from the OBC/WD EN Pin (Should be held high when System is active, low on PET failure)
- [ ]  TP 25 → ~28v (Vbatt)
- [ ]  TP 26 → ~28v output from load switch
- [ ]  TP 27 → SYNCPHASE3 (400khz 180 deg out of phase from PHASE1)
- [ ]  TP28 → ~20v (Output from Switching regulator)
- [ ]  TP 29 → ~20v (Output from INA290 to Jetson Subsystem)
    
    WD_OBC:
    
    - [ ]  TP 10 → Check WD Supply power, should be 20v
    - [ ]  TP 11 → WD Interface input line, held high when there is a pet
    - [ ]  TP 47 Open collector output from the Watchdog, should be half of whatever the OBC GPIO pin voltage is when high, and then ground any other time

Peripheral Subsystem:

- [ ]  TP 39 → ~28v (Vbatt)
- [ ]  TP 82 → OBC GPIO input for EN line and WD En line, should be ~1.4v when high for OBC holding it high, and low when not held high.
- [ ]  TP 40 → ~28v output of the load switch
- [ ]  TP 41 → SYNCPHASE2 Output of LTC6902 (400khz 90 deg out of phase)
- [ ]  TP 42 → Input regulated power to the INA260, should be roughly +5v
- [ ]  TP 43 → output for the Peripheral subsystem, should be roughly +5v
    
    WD_Perif:
    
    - [ ]  TP 5 → 5v supply to power the watch dog
    - [ ]  TP 15 → WD Perif output always pulled low, should be low when the system is off, and held high when the OBC enables it, when the pet fails it will hold low until the subsystem turns off.
