BroncoSpace-Lab/scales-hardware/peripheral_board/Raspberry_Pi_Dev_Code/readme.md

# Development of the code for the Peripheral Board
Using the [Adafruit networking with WizNet](https://learn.adafruit.com/networking-in-circuitpython/networking-with-wiznet-ethernet) as a foundation of the code. 

Might be using [fprime-arduino](https://github.com/fprime-community/fprime-arduino)

*Still in development*
