BroncoSpace-Lab/scales-hardware/imx8x/fprime/docs/terminal outputs.md

Final build error:

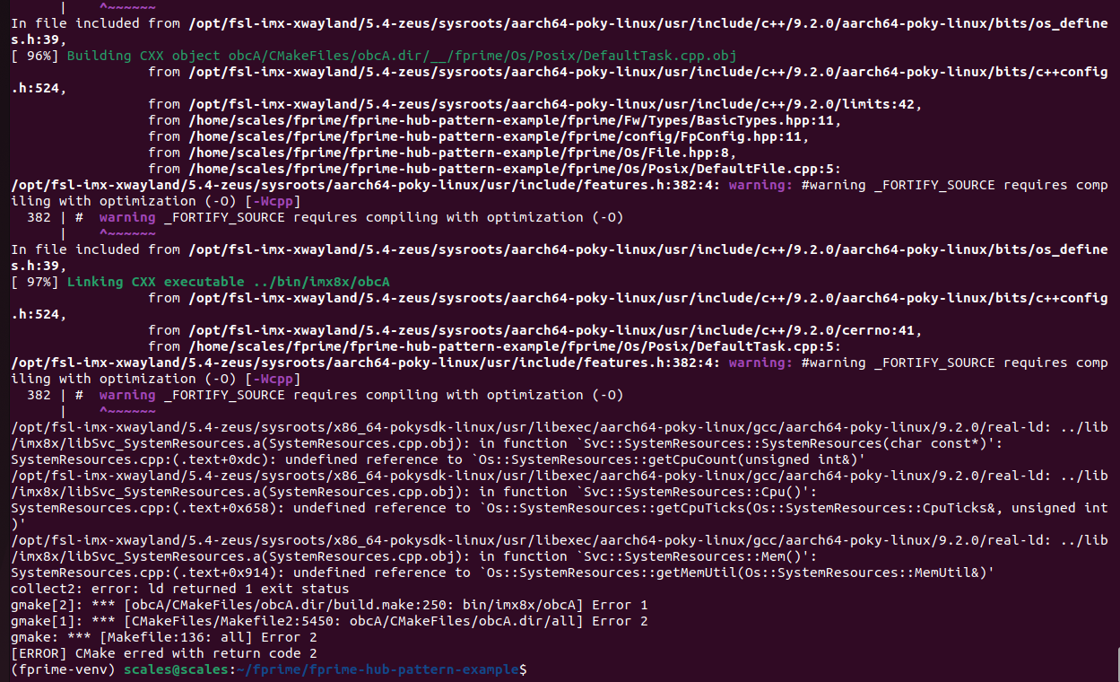
[picture p53: imx8x/fprime/docs/fprime terminal output 7.png]
final build error
