BroncoSpace-Lab/scales-hardware/docs/Images/peripheral_board_back_v0.png

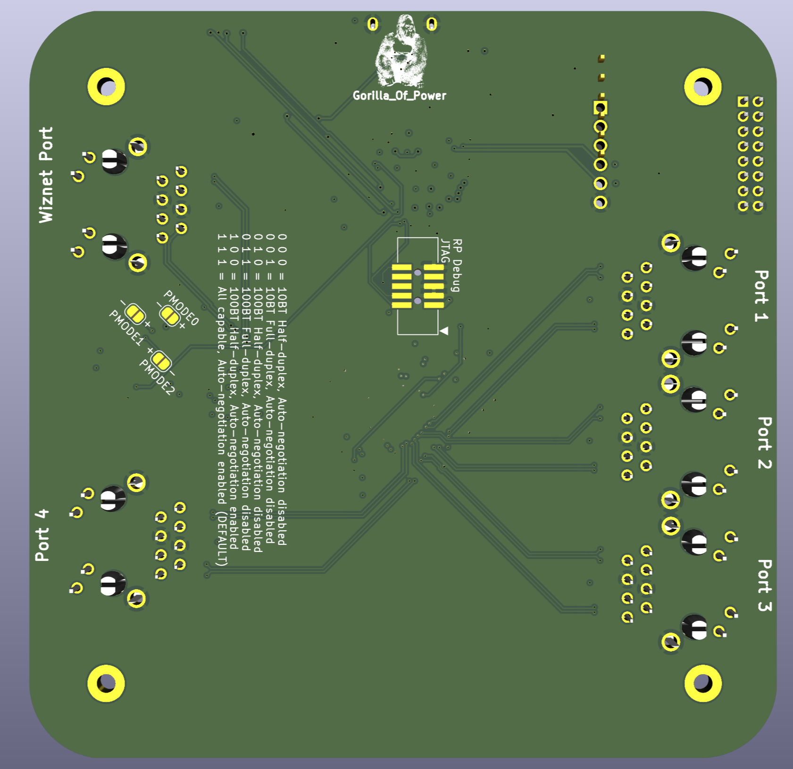
docs/Images/peripheral_board_back_v0.png
