BroncoSpace-Lab/scales-hardware/docs/Images/peripheral_board_front_v0.png

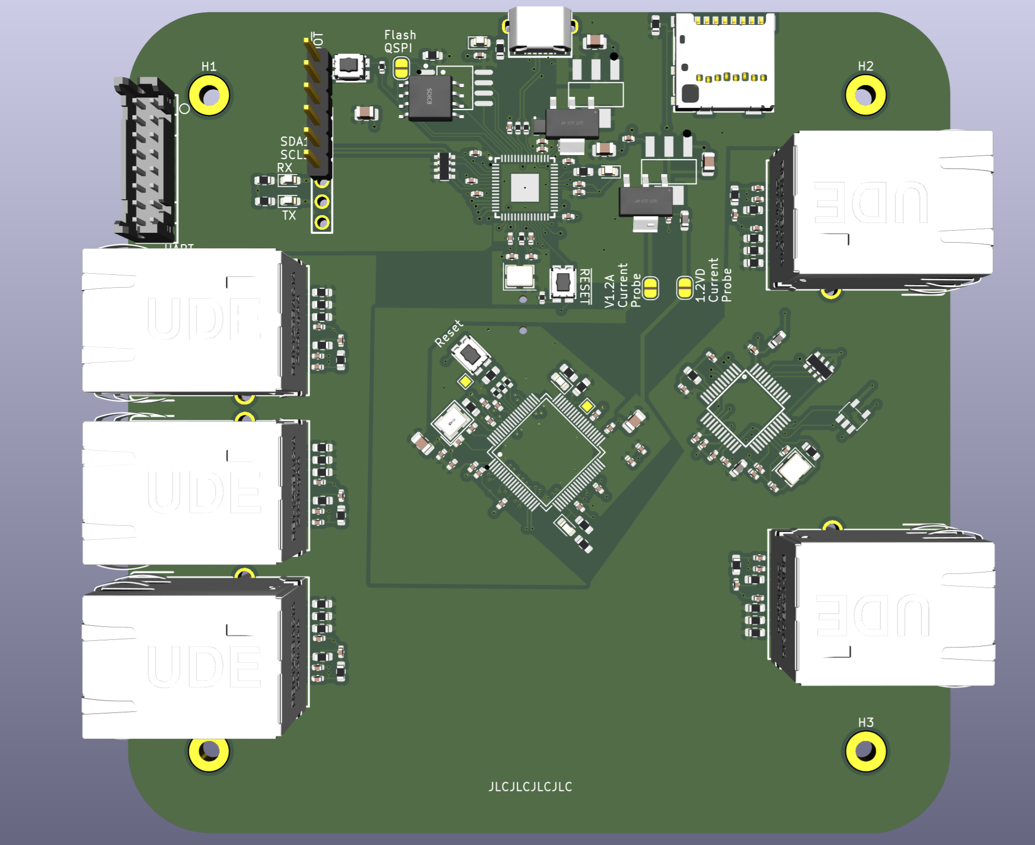
docs/Images/peripheral_board_front_v0.png
