BroncoSpace-Lab/scales-hardware/docs/Images/resnet_training_15W_gr3d.png

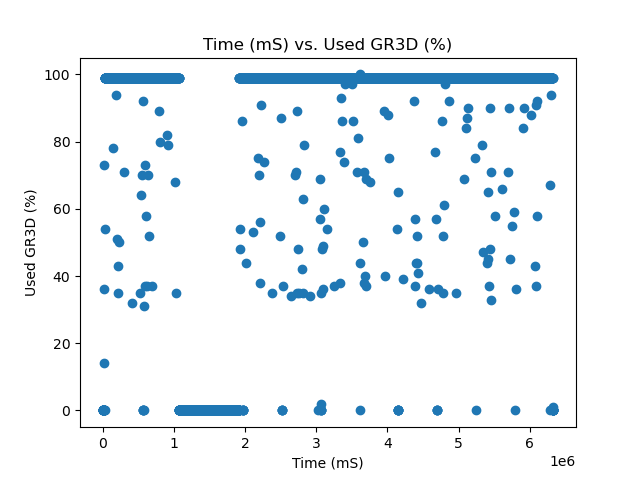
docs/Images/resnet_training_15W_gr3d.png
