BroncoSpace-Lab/scales-hardware/docs/Images/resnet_training_30W_gr3d.png

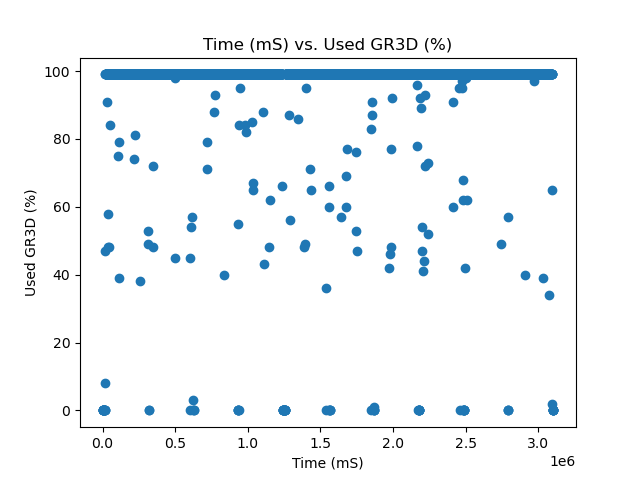
docs/Images/resnet_training_30W_gr3d.png
