BroncoSpace-Lab/scales-hardware/docs/Images/resnet_training_30W_used_ram.png

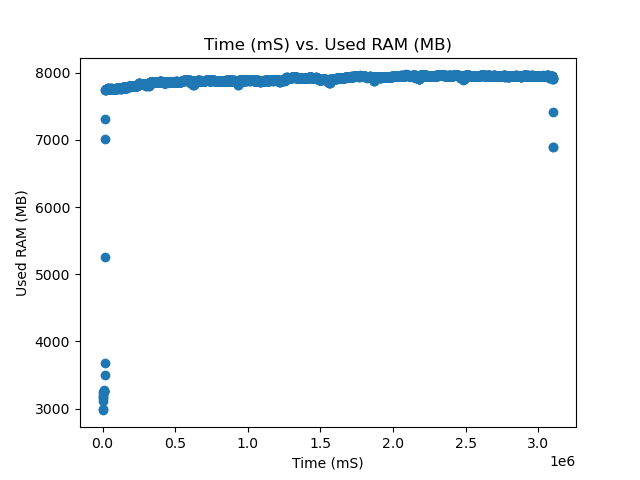
docs/Images/resnet_training_30W_used_ram.png
