BroncoSpace-Lab/scales-hardware/docs/Images/resnet_training_50W_used_ram.png

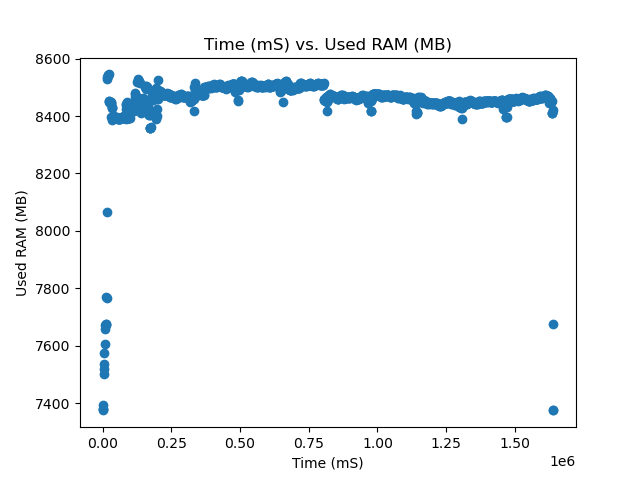
docs/Images/resnet_training_50W_used_ram.png
