BroncoSpace-Lab/scales-hardware/docs/Images/satcat_switch_config.png

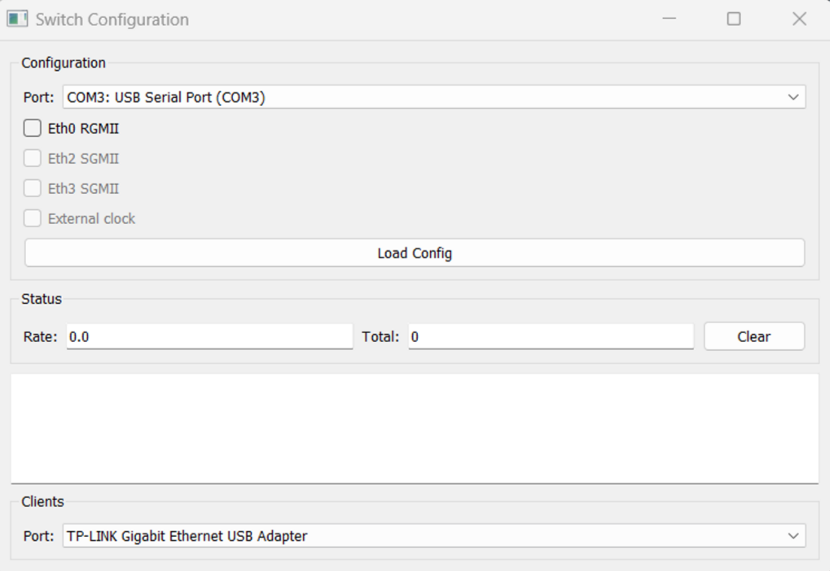
docs/Images/satcat_switch_config.png
