BroncoSpace-Lab/scales-hardware/imx8x/fprime/docs/fprime terminal output 1.png

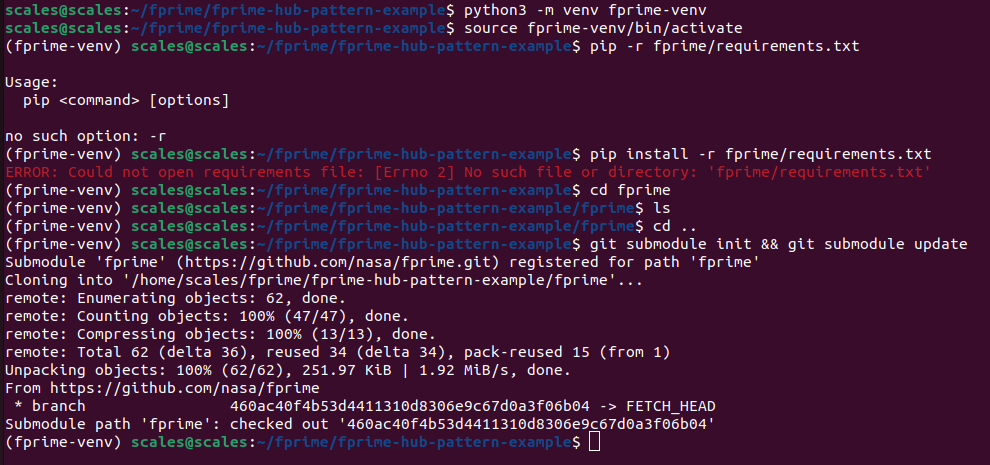
imx8x/fprime/docs/fprime terminal output 1.png
