BroncoSpace-Lab/scales-hardware/imx8x/fprime/docs/fprime terminal output 3.png

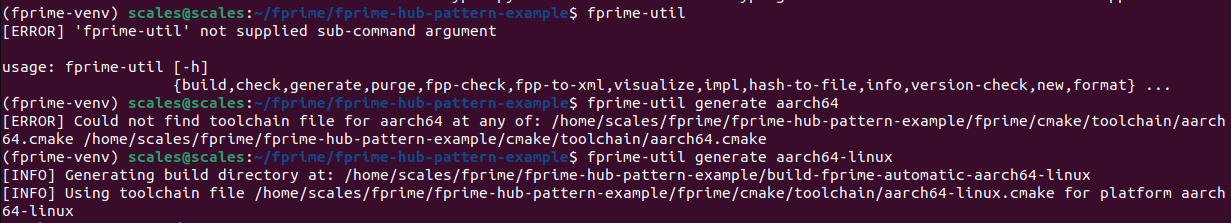
imx8x/fprime/docs/fprime terminal output 3.png
