BroncoSpace-Lab/scales-hardware/imx8x/fprime/docs/fprime terminal output 5.png

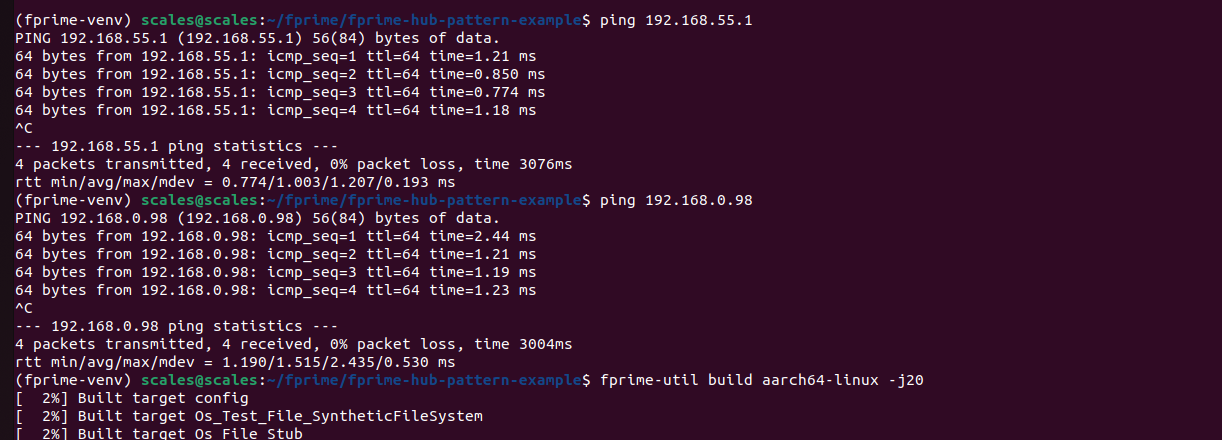
imx8x/fprime/docs/fprime terminal output 5.png
