BroncoSpace-Lab/scales-hardware/imx8x/fprime/docs/fprime terminal output 6.png

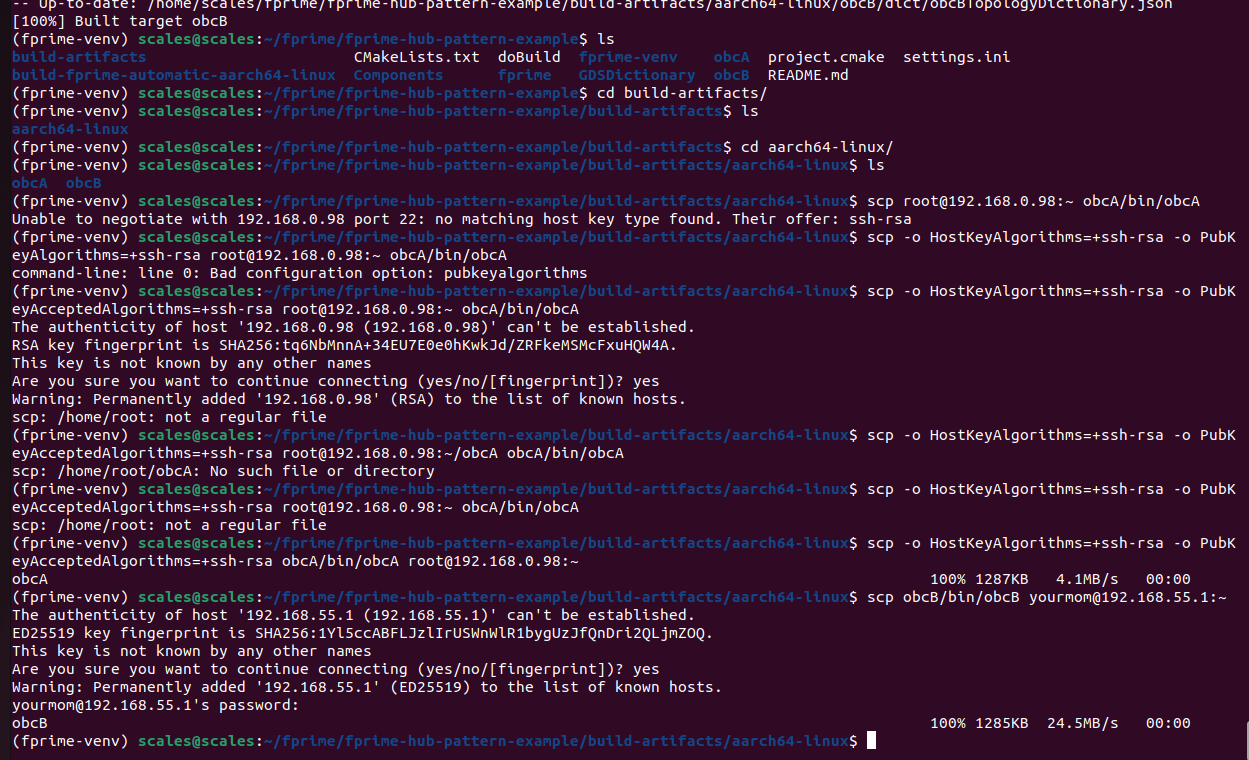
imx8x/fprime/docs/fprime terminal output 6.png
