BroncoSpace-Lab/scales-hardware/imx8x_eps_leviathan_v2/simulation_models/pspiceForTI/TPS1HB08/TPS1HB08.png

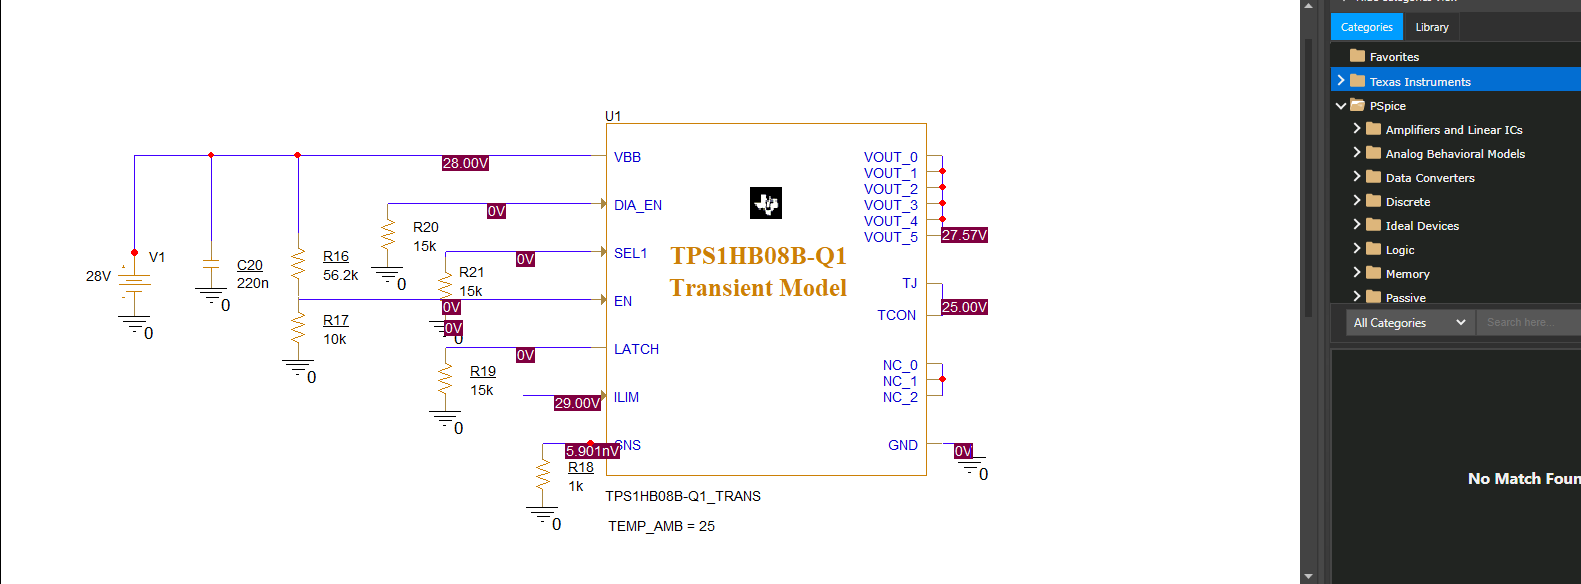
imx8x_eps_leviathan_v2/simulation_models/pspiceForTI/TPS1HB08/TPS1HB08.png
