BroncoSpace-Lab/scales-hardware/power_system/images/RevE/GND.png

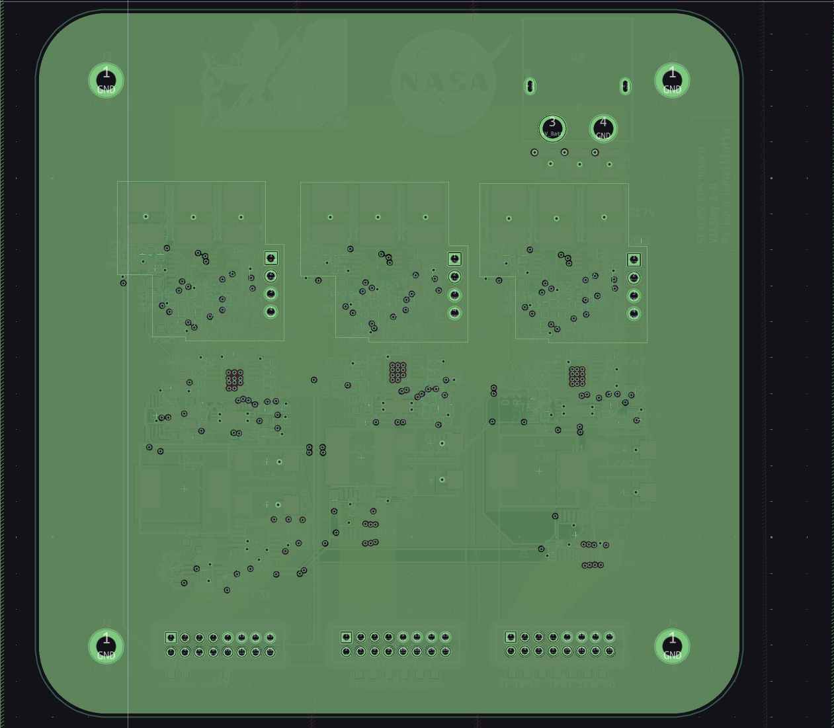
power_system/images/RevE/GND.png
