BroncoSpace-Lab/scales-hardware/imx8x_carrier_board/imx8x_carrier_v1/SOM_config/SCALES i.MX8QXP SOM config_pinmux.xlsx

Pin | Signal Pad Name | Signal Name | Fixed Pin or Not | Included in Schematic? | PinMUX Parity? | Notes
A10 | USDHC1_CD_B | CONN_USDHC1_CD_B | N | Y | Y | Leave Unconnected
A11 | USDHC1_RESET_B | CONN_USDHC1_RESET_B | N | Y | Y | Not usng Wifi or BT, leave unconnected
A12 | GND | GND | Y | Y | Y
A13 | USDHC1_DATA3 | CONN_USDHC1_DATA3 | N | Y | Y
A14 | USDHC1_DATA2 | CONN_USDHC1_DATA2 | N | Y | Y
A15 | USDHC1_DATA1 | CONN_USDHC1_DATA1 | N | Y | Y
A16 | USDHC1_DATA0 | CONN_USDHC1_DATA0 | N | Y | Y
A17 | VCC_LDO_SD1 | VCC_LDO_SD1 | Y | Y | Y
A18 | USDHC1_CLK | CONN_USDHC1_CLK | N | Y | Y
A19 | USDHC1_CMD | CONN_USDHC1_CMD | N | Y | Y
A2 | GND | GND | Y | Y | Y
A20 | GND | GND | Y | Y | Y
A21 | SPI2_CS0 | ADMA_SPI2_CS0 | N | Y | Y
A22 | SPI2_SCK | ADMA_SPI2_SCK | N | Y | Y
A23 | SPI2_SDI | ADMA_SPI2_SDI | N | Y | Y
A24 | SPI2_SDO | ADMA_SPI2_SDO | N | Y | Y
A25 | GND | GND | Y | Y | Y
A26 | SPI0_CS0 | ADMA_SPI0_CS0 | N | Y | Y
A27 | SPI0_SCK | ADMA_SPI0_SCK | N | Y | Y
A28 | SPI0_CS1 | ADMA_SPI0_CS1 | N | Y | Y
A29 | SPI0_SDO | ADMA_SPI0_SDO | N | Y | Y
A30 | SPI0_SDI | ADMA_SPI0_SDI | N | Y | Y
A31 | GND | GND | Y | Y | Y
A34 | SAI0_TXFS | ADMA_SPI2_CS1 | N | Y | Y
A36 | GND | GND | Y | Y | Y
A37 | SAI1_RXD | ADMA_SPI1_CS1 | N | Y | Y
A38 | SAI1_RXC | LSIO_GPIO0_IO30 | N | Y | Y
A39 | SAI1_RXFS | LSIO_GPIO0_IO31 | N | Y | Y
A40 | GND | GND | Y | Y | Y
A41 | FLEXCAN0_TX | ADMA_UART0_CTS_B | N | ? | ? | Pretty sure not needed in UART 0. Please verify
A42 | FLEXCAN0_RX | ADMA_UART0_RTS_B | N | ? | ? | Pretty sure not needed in UART 0. Please verify
A43 | FLEXCAN1_RX | LSIO_GPIO1_IO17 | N | Y | Y
A44 | FLEXCAN1_TX | LSIO_GPIO1_IO18 | N | Y | Y
A45 | GND | GND | Y | Y | Y
A46 | FLEXCAN2_TX | LSIO_GPIO1_IO20 | N | Y | Y
A47 | FLEXCAN2_RX | LSIO_GPIO1_IO19 | N | Y | Y
A48 | UART0_TX | ADMA_UART0_TX | N | Y | Y
A49 | UART0_RX | ADMA_UART0_RX | N | Y | Y
A5 | GND | GND | Y | Y | Y
A50 | UART2_RX | ADMA_UART2_RX | N | Y | Y
A51 | UART2_TX | ADMA_UART2_TX | N | Y | Y
A52 | GND | GND | Y | Y | Y
A53 | MCLK_IN0 | LSIO_GPIO0_IO19 | N | Y | Y
A54 | MCLK_IN1 | ADMA_I2C3_SDA | N | Y | Y
A55 | MCLK_OUT0 | LSIO_GPIO0_IO20 | N | Y | Y
A56 | GND | GND | Y | Y | Y
A57 | UART1_CTS_B | ADMA_UART1_CTS_B | N | Y | Y
A58 | UART1_RTS_B | ADMA_UART1_RTS_B | N | Y | Y
A59 | UART1_RX | ADMA_UART1_RX | N | Y | Y
A60 | UART1_TX | ADMA_UART1_TX | N | Y | Y
A61 | GND | GND | Y | Y | Y
A62 | X_ETH0_LED0/MAC_RXD3 | X_ETH0_LED0/MAC_RXD3 | Y
A63 | X_ETH0_LED1/MAC_RXD2 | X_ETH0_LED1/MAC_RXD2 | Y
A64 | X_ETH_GPIO0 | X_ETH_GPIO0 | Y | Y | Y
A65 | X_ETH_GPIO1 | X_ETH_GPIO1 | Y | Y | Y
A66 | GND | GND | Y | Y | Y
A67 | ENET0_MDIO | CONN_ENET0_MDIO | N | Y | Y
A68 | ENET0_MDC | CONN_ENET0_MDC | N | Y | Y
A69 | X_ETH0_INT | X_ETH0_INT | Y |  |  | Leave Disconnected on the dev schematic is is floating
A7 | GND | GND | Y | Y | Y
A70 | GND | GND | Y | Y | Y
A8 | USDHC1_VSELECT | CONN_USDHC1_VSELECT | N | Y | Y` | No Connect based on dev schematic
A9 | USDHC1_WP | CONN_USDHC1_WP | N | ? | ? | No Connect based on Hardware Developer Guide (Pg. 80)
B1 | USB_OTG2_VBUS | CONN_USB_OTG2_VBUS | N | Y | Y | 10k to GND based on Hardware Developer Guide (Pg. 80)
B11 | USB_SS3_TC3 | CONN_USB_OTG2_OC | N | Y | Y | Leave unconnected
B12 | GND | GND | Y | Y | Y
B15 | GND | GND | Y | Y | Y
B18 | GND | GND | Y | Y | Y
B2 | USB_OTG2_ID | CONN_USB_OTG2_ID | N | Y | Y | 10k to GND based on Hardware Developer Guide (Pg. 80)
B20 | GND | GND | Y | Y | Y
B23 | GND | GND | Y | Y | Y
B26 | GND | GND | Y | Y | Y
B29 | GND | GND | Y | Y | Y
B3 | GND | GND | Y | Y | Y
B32 | GND | GND | Y | Y | Y
B33 | SCU_BOOT_MODE0 | SCU_DSC_BOOT_MODE0 | N | Y | Y | Custom Configuration based on the boot select configuration we have setup for this board.
B34 | SCU_BOOT_MODE1 | SCU_DSC_BOOT_MODE1 | N | Y | Y | Custom Configuration based on the boot select configuration we have setup for this board.
B35 | SCU_BOOT_MODE2 | SCU_DSC_BOOT_MODE2 | N | Y | Y | Custom Configuration based on the boot select configuration we have setup for this board.
B36 | SCU_BOOT_MODE3 | SCU_DSC_BOOT_MODE3 | N | Y | Y | Custom Configuration based on the boot select configuration we have setup for this board.
B37 | GND | GND | Y | Y | Y
B38 | ESAI0_FST | CONN_ENET1_RGMII_TXD2 | N | Y | Y
B39 | ESAI0_FSR | CONN_ENET1_RGMII_TXC | N | Y | Y
B4 | USB_OTG2_DN | CONN_USB_OTG2_DN | N | Y | Y | 10k to GND based on Hardware Developer Guide (Pg. 80)
B40 | GND | GND | Y | Y | Y
B41 | ESAI0_SCKT | CONN_ENET1_RGMII_TXD3 | N | Y | Y
B42 | ESAI0_SCKR | CONN_ENET1_RGMII_TX_CTL | N | Y | Y
B43 | ESAI0_TX0 | CONN_ENET1_RGMII_RXC | N | Y | Y
B44 | ESAI0_TX1 | CONN_ENET1_RGMII_RXD3 | N | Y | Y
B45 | GND | GND | Y | Y | Y
B46 | ESAI0_TX2_RX3 | CONN_ENET1_RGMII_RXD2 | N | Y | Y
B47 | ESAI0_TX3_RX2 | CONN_ENET1_RGMII_RXD1 | N | Y | Y
B48 | ESAI0_TX4_RX1 | CONN_ENET1_RGMII_TXD0 | N | Y | Y
B49 | ESAI0_TX5_RX0 | CONN_ENET1_RGMII_TXD1 | N | Y | Y
B5 | USB_OTG2_DP | CONN_USB_OTG2_DP | N | Y | Y | 10k to GND based on Hardware Developer Guide (Pg. 80)
B50 | GND | GND | Y | Y | Y
B51 | SPDIF0_RX | CONN_ENET1_RGMII_RXD0 | N | Y | Y
B52 | SPDIF0_TX | CONN_ENET1_RGMII_RX_CTL | N | Y | Y
B53 | SPDIF0_EXT_CLK | CONN_ENET1_REFCLK_125M_25M | N | Y | Y
B54 | GND | GND | Y | Y | Y
B55 | SPI3_CS0 | LSIO_GPIO0_IO16 | N | Y | Y
B56 | SPI3_CS1 | ADMA_I2C3_SCL | N | Y | Y
B57 | SPI3_SCK | LSIO_GPIO0_IO13 | N | Y | Y
B58 | SPI3_SDI | LSIO_GPIO0_IO15 | N | Y | Y
B59 | SPI3_SDO | LSIO_GPIO0_IO14 | N | Y | Y
B6 | GND | GND | Y | Y | Y
B60 | GND | GND | Y | Y | Y
B61 | X_ETH0_D-/MAC_CLK | X_ETH0_D-/MAC_CLK | Y | Y | Y
B62 | X_ETH0_D+/MAC_RXDV | X_ETH0_D+/MAC_RXDV | Y | Y | Y
B63 | GND | GND | Y | Y | Y
B64 | X_ETH0_C-/MAC_TXEN | X_ETH0_C-/MAC_TXEN | Y | Y | Y
B65 | X_ETH0_C+/MAC_TXCLK | X_ETH0_C+/MAC_TXCLK | Y | Y | Y
B66 | X_ETH0_B-/RX0-/MAC_TXD0 | X_ETH0_B-/RX0-/MAC_TXD0 | Y | Y | Y
B67 | X_ETH0_B+/RX0+/MAC_TXD1 | X_ETH0_B+/RX0+/MAC_TXD1 | Y | Y | Y
B68 | X_ETH0_A-/TX0-/MAC_TXD2 | X_ETH0_A-/TX0-/MAC_TXD2 | Y | Y | Y
B69 | X_ETH0_A+/TX0+/MAC_TXD3 | X_ETH0_A+/TX0+/MAC_TXD3 | Y | Y | Y
B70 | GND | GND | Y | Y | Y
B8 | USB_SS3_TC1 | CONN_USB_OTG2_PWR | N | Y | Y | Leave unconnected (Page. 81)
B9 | GND | GND | Y | Y | Y
C1 | QSPI0A_SS0_B | LSIO_QSPI0A_SS0_B | N | Y | Y
C10 | GND | GND | Y | Y | Y
C11 | MIPI_DSI0_I2C0_SDA | LSIO_GPIO1_IO26 | N | Y | Y
C12 | MIPI_DSI0_I2C0_SCL | LSIO_GPIO1_IO25 | N | Y | Y
C13 | MIPI_DSI0_GPIO0_00 | ADMA_I2C1_SCL | N | Y | Y
C14 | MIPI_DSI0_GPIO0_01 | ADMA_I2C1_SDA | N | Y | Y
C15 | GND | GND | Y | Y | Y
C2 | QSPI0A_SS1_B | LSIO_QSPI0A_SS1_B | N | Y | Y
C20 | GND | GND | Y | Y | Y
C25 | GND | GND | Y | Y | Y
C3 | QSPI0A_SCLK | LSIO_QSPI0A_SCLK | N | Y | Y
C30 | GND | GND | Y | Y | Y
C35 | GND | GND | Y | Y | Y
C4 | QSPI0A_DQS | LSIO_QSPI0A_DQS | N | Y | Y
C40 | GND | GND | Y | Y | Y
C41 | MIPI_DSI1_I2C0_SCL | LSIO_GPIO1_IO29 | N | Y | Y
C42 | MIPI_DSI1_I2C0_SDA | LSIO_GPIO1_IO30 | N | Y | Y
C43 | MIPI_DSI1_GPIO0_00 | ADMA_I2C2_SCL | N | Y | Y
C44 | MIPI_DSI1_GPIO0_01 | ADMA_I2C2_SDA | N | Y | Y
C45 | GND | GND | Y | Y | Y
C46 | X_nRESET_IN | X_nRESET_IN | Y | Y | Y
C47 | VCC_SCU_1V8 | VCC_SCU_1V8 | Y | Y | Y
C48 | GND | GND | Y | Y | Y
C49 | NC | NC | Y | Y | Y
C5 | GND | GND | Y | Y | Y
C51 | X_POR_B_1V8 | X_POR_B_1V8 | Y | Y | Y
C52 | X_POR_B_3V3 | X_POR_B_3V3 | Y | Y | Y
C53 | X_PGOOD | X_PGOOD | Y | ? | ? | Page 27 HW Manual
C54 | GND | GND | Y | Y | Y
C55 | X_PMIC_EWARN | X_PMIC_EWARN | Y | ? | ?
C56 | X_SCU_PMIC_ON_REQ | X_SCU_PMIC_ON_REQ | Y | ? | ?
C57 | X_SCU_PMIC_STANDBY | X_SCU_PMIC_STANDBY | Y | ? | ?
C58 | GND | GND | Y | Y | Y
C59 | X_PMIC_INT_B | X_PMIC_INT_B | Y | ? | ?
C6 | QSPI0B_SS0_B | LSIO_QSPI0B_SS0_B | N | Y | Y
C60 | X_PMIC_WDI | X_PMIC_WDI | Y | ? | ?
C61 | SCU_GPIO0_00 | M40_UART0_RX | N | Y | Y
C62 | SCU_GPIO0_01 | SCU_WDOG0_WDOG_OUT | N | ? | ?
C63 | GND | GND | Y | Y | Y
C64 | VCC_1V8 | VCC_1V8 | Y | Y | Y
C65 | VCC_3V3 | VCC_3V3 | Y | Y | Y
C66 | VBAT | VBAT | Y | Y | Y | Leave unconnected
C67 | VCC | VCC | Y | Y | Y
C68 | VCC | VCC | Y | Y | Y
C69 | VCC | VCC | Y | Y | Y
C7 | QSPI0B_SS1_B | LSIO_QSPI0B_SS1_B | N | Y | Y
C70 | VCC | VCC | Y | Y | Y
C8 | QSPI0B_SCLK | LSIO_QSPI0B_SCLK | N | Y | Y
C9 | QSPI0B_DQS | LSIO_QSPI0B_DQS | N | Y | Y
D1 | QSPI0A_DATA0 | LSIO_QSPI0A_DATA0 | N | Y | Y
D10 | VCC_OSPI_1V8 | VCC_OSPI_1V8 | Y | ? | ? | Leave unconnected?
D11 | GND | GND | Y | Y | Y
D12 | NC | NC | Y | Y | Y
D13 | NC | NC | Y | Y | Y
D18 | GND | GND | Y | Y | Y
D2 | QSPI0A_DATA1 | LSIO_QSPI0A_DATA1 | N | Y | Y
D23 | GND | GND | Y | Y | Y
D26 | CSI_EN | ADMA_SPI1_SDI | N | Y | Y
D27 | CSI_RESET | ADMA_SPI1_CS0 | N | Y | Y
D28 | GND | GND | Y | Y | Y
D29 | CSI_MCLK | ADMA_SPI1_SDO | N | Y | Y
D3 | QSPI0A_DATA2 | LSIO_QSPI0A_DATA2 | N | Y | Y
D30 | CSI_PCLK | ADMA_SPI1_SCK | N | Y | Y
D31 | GND | GND | Y | Y | Y
D33 | MIPI_CSI0_GPIO0_00 | ADMA_I2C0_SCL | N | Y | Y
D34 | MIPI_CSI0_GPIO0_01 | ADMA_I2C0_SDA | N | Y | Y
D35 | GND | GND | Y | Y | Y
D4 | QSPI0A_DATA3 | LSIO_QSPI0A_DATA3 | N | Y | Y
D40 | GND | GND | Y | Y | Y
D45 | GND | GND | Y | Y | Y
D5 | GND | GND | Y | Y | Y
D50 | GND | GND | Y | Y | Y
D51 | JTAG_TCK | SCU_JTAG_TCK | N | Y | Y
D52 | JTAG_TDO | SCU_JTAG_TDO | N | Y | Y
D53 | JTAG_TDI | SCU_JTAG_TDI | N | Y | Y
D54 | JTAG_TMS | SCU_JTAG_TMS | N | Y | Y
D55 | JTAG_TRST_B | SCU_JTAG_TRST_B | N | Y | Y
D56 | GND | GND | Y | Y | Y
D57 | VDD_ADC_1V8 | VDD_ADC_1V8 | Y | Y | Y
D58 | ADC_IN1 | LSIO_GPIO1_IO09 | N | Y | Y
D59 | ADC_IN0 | LSIO_GPIO1_IO10 | N | Y | Y
D6 | QSPI0B_DATA0 | LSIO_QSPI0B_DATA0 | N | Y | Y
D60 | GND | GND | Y | Y | Y
D61 | ADC_IN4 | LSIO_GPIO1_IO14 | N | Y | Y
D62 | ADC_IN3 | M40_UART0_TX | N | Y | Y
D63 | ADC_IN2 | LSIO_GPIO1_IO12 | N | Y | Y
D64 | ADC_IN5 | LSIO_GPIO1_IO13 | N | Y | Y
D65 | GND | GND | Y | Y | Y
D66 | VCC | VCC | Y | Y | Y
D67 | VCC | VCC | Y | Y | Y
D68 | VCC | VCC | Y | Y | Y
D69 | VCC | VCC | Y | Y | Y
D7 | QSPI0B_DATA1 | LSIO_QSPI0B_DATA1 | N | Y | Y
D70 | VCC | VCC | Y | Y | Y
D8 | QSPI0B_DATA2 | LSIO_QSPI0B_DATA2 | N | Y | Y
D9 | QSPI0B_DATA3 | LSIO_QSPI0B_DATA3 | N | Y | Y
