BroncoSpace-Lab/scales-hardware/imx8x_eps_leviathan_v2/simulation_models/ngspice/ngspice-manual.pdf

# Ngspice User’s Manual Version 45 (ngspice release version)

### Holger Vogt, Giles Atkinson, Paolo Nenzi September 1st, 2025

2

## Locations

The project and download pages of ngspice may be found at

Ngspice home page https://ngspice.sourceforge.io/

Project page at SourceForge https://sourceforge.net/projects/ngspice/

Download page at SourceForge https://sourceforge.net/projects/ngspice/files/ng-spice-rework/

Git source download https://sourceforge.net/p/ngspice/ngspice/ci/master/tree/

## Status

This manual is a work in progress. Some to-dos are listed in Chapt. 20.3. More is surely needed. You are invited to report bugs, missing items, wrongly described items, bad English style, etc. The preferred place for such reports is our bug tracker. (https://sourceforge.net/p/ngspice/bugs/)

## How to use this Manual

The manual is a “work in progress.” It may accompany a specific ngspice release, e.g. ngspice-44 as manual version 44. If its name contains ‘Version xxplus’, it describes the actual code status, found at the date of issue in the Git Source Code Management (SCM) tool. This manual is intended to provide a complete description of ngspice’s functionality, features, commands, and procedures. This manual is not a book about learning SPICE usage, however the novice user may find some hints how to start using ngspice. Chapter 17.1 gives a short introduction how to set up and simulate a small circuit. Chapter 28 is about compiling and installing ngspice from a tarball or the actual Git source code, which you may find on the ngspice web pages. (http://ngspice.sourceforge.net/download.html) If you are running a specific Linux distribution, you may check if it provides ngspice as part of the package. Some are listed here. (http://ngspice.sourceforge.net/packages.html)

## License

This document is covered by the Creative Commons Attribution Share-Alike (CC-BY-SA) v4.0.. (https://creativecommons.org/licenses/by-sa/4.0/)

Part of chapters 12 and 25-29 are in the public domain.

Chapter 30 is covered by New BSD (chapt. 29.3.2).

# Contents

I Ngspice User’s Manual | 29
1 Introduction | 35

3

4 | CONTENTS
2 Circuit Description | 47

CONTENTS | 5
3 Circuit Elements and Models | 71
4 Voltage and Current Sources | 93

6 | CONTENTS
5 Non-linear Dependent Sources (Behavioral Sources) | 105

CONTENTS | 7
6 Transmission Lines | 121
7 Device Models | 129

8 | CONTENTS
8 Mixed-Mode and Behavioral Modeling with XSPICE | 175

CONTENTS | 9

10 | CONTENTS

CONTENTS | 11
9 Verilog-A Compact Device Models | 301
9.1 Introduction | 301
9.2 OSDI/OpenVAF | 301
9.3 How to create and apply OpenVAF models | 302
9.3.1 | Preparing for simulation | 302
9.3.2 | OSDI/OpenVAF examples distributed with ngspice | 304
10 Digital Device Models | 305
10.1 U devices (basic digital building blocks) | 305
10.1.1 General format | 306
10.1.2 List of devices available in ngspice (basic types) | 306
10.1.3 URC transmission line versus U devices | 307
10.2 Support for standard digital devices | 307
10.3 Digital devices defined by a Hardware Description Language | 308
10.3.1 Using Verilator, Verilog, and code model d_cosim | 309
10.3.2 Using Icarus Verilog, and code model d_cosim | 309
10.3.3 Using GHDL and code model d_cosim | 310

10.3.4 Using independent processes (e.g. C coded), pipes, and code model
d_process | 311

10.3.5 Using Yosys to map digital Verilog onto basic code model cells . . . . 311

11 Analyses and Output Control (batch mode) | 313
11.1 Simulator Variables (.options) | 313
11.1.1 General Options | 314
11.1.2 OP and DC Solution Options | 315
11.1.3 AC Solution Options | 317
11.1.4 Transient Analysis Options | 317
11.1.5 ELEMENT Specific options | 318
11.1.6 Transmission Lines Specific Options | 319
11.1.7 Precedence of option and .options commands | 319
11.2 Initial Conditions | 319
11.2.1 .NODESET: Specify Initial Node Voltage Guesses | 319
11.2.2 .IC: Set Initial Conditions | 320
11.3 Analyses | 321
11.3.1 .AC: Small-Signal AC Analysis | 321
11.3.2 .DC: DC Transfer Function | 322

12 | CONTENTS
11.3.3 .DISTO: Distortion Analysis | 322
11.3.4 .NOISE: Noise Analysis | 324
11.3.5 .OP: Operating Point Analysis | 325
11.3.6 .PZ: Pole-Zero Analysis | 327
11.3.7 .SENS: DC or Small-Signal AC Sensitivity Analysis | 327
11.3.8 .SP S-Parameter Analysis | 328
11.3.9 .TF: Transfer Function Analysis | 329
11.3.10 .TRAN: Transient Analysis | 329
11.3.11 Transient noise analysis (at low frequency) | 330
11.3.12 .PSS: Periodic Steady State Analysis | 333
11.4 Measurements after AC, DC and Transient Analysis | 334
11.4.1 .meas(ure) | 334
11.4.2 batch versus interactive mode | 334
11.4.3 General remarks | 334
11.4.4 Input | 335
11.4.5 Trig Targ | 335
11.4.6 Find ... When | 337
11.4.7 AVG|MIN|MAX|PP|RMS|MIN_AT|MAX_AT | 338
11.4.8 Integ | 338
11.4.9 param | 339
11.4.10 par(’expression’ ) | 339
11.4.11 Deriv | 340
11.4.12 More examples | 340
11.5 Safe Operating Area (SOA) warning messages | 341
11.5.1 Resistor and Capacitor SOA model parameters | 342
11.5.2 Diode SOA model parameters | 342
11.5.3 BJT SOA model parameters | 343
11.5.4 MOS SOA model parameters | 344
11.5.5 VDMOS SOA model parameters | 345
11.6 Batch Output | 345
11.6.1 .SAVE: Name vector(s) to be saved in raw file | 345
11.6.2 .PRINT Lines | 346
11.6.3 .PLOT Lines | 347
11.6.4 .FOUR: Fourier Analysis of Transient Analysis Output | 347

CONTENTS | 13

11.6.5 .PROBE: Save device node currents, device power dissipation, or dif-
ferential voltages between arbitrary nodes | 348
11.6.6 par(’expression’): Algebraic expressions for output | 352
11.6.7 .width | 353
11.7 Measuring current through device terminals | 353
11.7.1 Using the .probe command | 353
11.7.2 Adding a voltage source in series | 353
11.7.3 Using option ’savecurrents’ | 354
12 Starting ngspice | 355
12.1 Introduction | 355
12.2 Where to obtain ngspice | 355
12.3 Command line options for starting ngspice | 356
12.4 Starting options | 358
12.4.1 Batch mode | 358
12.4.2 Interactive mode | 358

12.4.3 Control mode (Interactive mode with control file or control section) . . 359

12.5 Standard configuration file spinit | 360
12.6 User defined configuration file .spiceinit | 362
12.7 Environmental variables | 363
12.7.1 Ngspice specific variables | 363
12.7.2 Common environment variables | 364
12.8 Memory usage | 364
12.9 Simulation time | 364
12.10Ngspice on multi-core processors using OpenMP | 365
12.10.1 Introduction | 365
12.10.2 Internals | 365
12.10.3 Some results | 366
12.10.4 Usage | 367
12.10.5 Literature | 367
12.11Server mode option -s | 367
12.12Pipe mode option -p | 369
12.13Ngspice control via input, output fifos | 370
12.14Compatibility | 371
12.14.1 Compatibility mode | 371

14 | CONTENTS
12.14.2 Missing functions | 372
12.14.3 Devices | 372
12.14.4 Controls and commands | 373
12.14.5 PSPICE Compatibility mode | 374
12.14.6 LTSPICE Compatibility mode | 375
12.14.7 LTSPICE/PSPICE Compatibility mode | 377
12.14.8 KiCad Compatibility mode | 377
12.14.9 Spectre Compatibility mode | 378
12.14.10HSPICE Compatibility mode | 378
12.15Tests | 378
12.16Tools for debugging a circuit netlist | 379
12.16.1 options and initial conditions | 379
12.16.2 set debug | 379
12.16.3 set ngdebug | 379
12.16.4 miscellaneous | 380
12.17Reporting bugs and errors | 380
13 Interactive Interpreter | 381
13.1 Introduction | 381
13.2 Expressions, Functions, and Constants | 382
13.3 Plots | 386
13.4 Command Interpretation | 387
13.4.1 On the console | 387
13.4.2 Scripts | 387
13.4.3 Add-on to circuit file | 387
13.5 Commands | 388
13.5.1 Ac: Perform an AC, small-signal frequency response analysis | 388
13.5.2 Alias: Create an alias for a command | 389
13.5.3 Alter: Change a device or model parameter | 389
13.5.4 Altermod: Change model parameter(s) | 391
13.5.5 Alterparam: Change value of a global parameter | 392
13.5.6 Asciiplot: Plot values using old-style character plots | 393
13.5.7 Aspice*: Asynchronous ngspice run | 393
13.5.8 Bg_ctrl**: suspend running controls until bg_run has finished | 393
13.5.9 Bg_halt**: halt a run | 393

CONTENTS | 15

13.5.10 Bg_run**: Run analysis from the input file in the background thread . . 394

13.5.11 Bug: Output URL for ngspice bug tracker | 394
13.5.12 Cd: Change directory | 394
13.5.13 Cdump: Dump the control flow to the screen | 394
13.5.14 Circbyline: Enter a circuit line by line | 395
13.5.15 Codemodel: Load an XSPICE code model library | 396
13.5.16 Compose: Compose a vector | 397
13.5.17 Cutout: Cut out a section of all vectors in a tran plot | 398
13.5.18 Dc: Perform a DC-sweep analysis | 398
13.5.19 Define: Define a function | 398
13.5.20 Deftype: Define a new type for a vector or plot | 399
13.5.21 Delete: Remove a trace or breakpoint | 399
13.5.22 Destroy: Delete an output data set | 399
13.5.23 Devhelp: information on available devices | 400
13.5.24 Diff: Compare vectors | 401
13.5.25 Display: List known vectors and types | 401
13.5.26 Echo: Print text | 401
13.5.27 Edit*: Edit the current circuit | 402
13.5.28 Edisplay: Print a list of all the event nodes | 402
13.5.29 Eprint: Print an event driven node | 402
13.5.30 Eprvcd: Dump nodes in VCD format | 402
13.5.31 Esave: Save a set of event node outputs | 403
13.5.32 Fclose: close an open file handle | 403
13.5.33 FFT: fast Fourier transform of vectors | 403
13.5.34 Fopen: open a text file | 405
13.5.35 Fourier: Perform a Fourier transform | 405
13.5.36 Fread: read into a variable from a text file | 406
13.5.37 Getcwd: Print the current working directory | 407
13.5.38 Gnuplot: Graphics output via gnuplot | 407
13.5.39 Hardcopy: Save a plot to a file for printing | 407
13.5.40 Help: Print summaries of Ngspice commands | 407
13.5.41 History: Review previous commands | 408
13.5.42 Inventory: Print circuit inventory | 410
13.5.43 Iplot*: Incremental plot | 411
13.5.44 Jobs*: List active asynchronous ngspice runs | 411

16 | CONTENTS
13.5.45 Let: Assign a value to a vector | 411
13.5.46 Linearize: Interpolate to a linear scale | 412
13.5.47 Listing: Print a listing of the current circuit | 413
13.5.48 Load: Load rawfile data | 414
13.5.49 Mc_source: Reload the circuit netlist from an internal storage | 414
13.5.50 Meas: Measurements on simulation data | 414
13.5.51 Mdump: Dump the matrix values to a file (or to console) | 415

13.5.52 Mrdump: Dump the matrix right hand side values to a file (or to console) 415

13.5.53 Noise: Noise analysis | 415
13.5.54 Op: Perform an operating point analysis | 416
13.5.55 Option: Set a ngspice option | 416
13.5.56 Plot*: Plot vectors on the display | 417

13.5.57 Pre_<command>: execute commands prior to parsing the circuit . . . . 419

13.5.58 Pre_OSDI: load a *.osdi compact device model shared library | 419
13.5.59 Print: Print values | 419
13.5.60 Psd: power spectral density of vectors | 420
13.5.61 Quit: Leave Ngspice | 420
13.5.62 Rehash: Reset internal hash tables | 421
13.5.63 Remcirc: Remove the current circuit | 421
13.5.64 Remzerovec: Remove zero length vectors | 421
13.5.65 Reset: Reset an analysis | 421
13.5.66 Reshape: Alter the dimensionality or dimensions of a vector | 422
13.5.67 Resume: Continue a simulation after a stop | 422
13.5.68 Rspice*: Remote ngspice submission | 423
13.5.69 Run: Run analysis from the input file | 423
13.5.70 Rusage: Resource usage | 423
13.5.71 Save: Save a set of outputs | 424
13.5.72 Sens: Run a sensitivity analysis | 426
13.5.73 Set: Set the value of a variable | 426
13.5.74 Setcs: Set the value of a variable, case preserved | 427
13.5.75 Setcirc: Change the current circuit | 428
13.5.76 Setplot: Switch the current set of vectors | 428
13.5.77 Setscale: Set the scale vector for the current plot | 429
13.5.78 Setseed: Set the seed value for the random number generator | 429
13.5.79 Settype: Set the type of a vector | 429

CONTENTS | 17
13.5.80 Shell: Call the command interpreter | 430
13.5.81 Shift: Alter a list variable | 430
13.5.82 Show: List device state | 430
13.5.83 Showmod: List model parameter values | 430
13.5.84 Snload: Load the snapshot file | 431
13.5.85 Snsave: Save a snapshot file | 432
13.5.86 Source: Read a ngspice input file | 433
13.5.87 Sp: S-Parameter Analysis | 434
13.5.88 Spec: Create a frequency domain plot | 434
13.5.89 Status: Display breakpoint information | 435
13.5.90 Step: Run a fixed number of time-points | 435
13.5.91 Stop: Set a breakpoint | 435
13.5.92 Strcmp: Compare two strings | 436
13.5.93 Strslice: Extract a substring | 436
13.5.94 Strstr: Find a substring | 436
13.5.95 Sysinfo: Print system information | 436
13.5.96 Tf: Run a Transfer Function analysis | 437
13.5.97 Trace: Trace nodes | 438
13.5.98 Tran: Perform a transient analysis | 438
13.5.99 Transpose: Swap the elements in a multi-dimensional data set | 439
13.5.100Unalias: Retract an alias | 439
13.5.101Undefine: Retract a definition | 439
13.5.102Unlet: Delete the specified vector(s) | 439
13.5.103Unset: Clear a variable | 440
13.5.104Version: Print the version of ngspice | 440
13.5.105Where: Identify troublesome node or device | 441
13.5.106Wrdata: Write data to a file (simple table) | 442
13.5.107Write: Write data to a file (Spice3f5 format) | 442
13.5.108Wrnodev: Write node voltage values to a file (.ic=xx format) | 443

13.5.109Wrs2p: Write scattering parameters to file (Touchstone® format) . . . 444

13.6 Control Structures | 444
13.6.1 While - End | 444
13.6.2 Repeat - End | 445
13.6.3 Dowhile - End | 446
13.6.4 Foreach - End | 446

18 | CONTENTS
13.6.5 If - Then - Else | 447
13.6.6 Label | 447
13.6.7 Goto | 447
13.6.8 Continue | 448
13.6.9 Break | 448
13.7 Internally predefined variables | 448
13.8 Scripts | 457
13.8.1 Variables | 457
13.8.2 Vectors | 458
13.8.3 Assessing vectors in subcircuits | 458
13.8.4 Commands | 459
13.8.5 control structures | 459
13.8.6 Example script ’spectrum’ | 463
13.8.7 Example script for random numbers | 465
13.8.8 Parameter sweep | 466
13.8.9 Output redirection | 466
13.9 Scattering parameters (S-parameters) | 468
13.9.1 Intro | 468
13.9.2 S-parameter measurement basics | 468
13.9.3 Usage of .sp and sp | 470
13.9.4 Usage of the script | 470
13.10Using shell variables | 470
13.11MISCELLANEOUS | 471
13.12Bugs | 471
14 Ngspice User Interfaces | 473
14.1 MS Windows Graphical User Interface | 473
14.2 MS Windows Console | 476
14.3 Linux | 476
14.4 CygWin | 476
14.5 Error handling | 477
14.6 Output-to-file options | 477
14.6.1 Graphics files | 477
14.6.2 Tabulated files | 483
14.7 Gnuplot | 486

CONTENTS | 19

14.7.1 Using Gnuplot to produce 1D graphs of (electrical) simulation results . 486

14.7.2 Using gnuplot to produce 2D contour plots for Cider | 487
14.8 Integration with CAD software and ‘third party’ GUIs | 491
14.8.1 KiCad | 491
14.8.2 Xschem | 491
14.8.3 Qucs-S | 491
14.8.4 GNU Spice GUI | 491
14.8.5 XCircuit | 492
14.8.6 GEDA | 492
14.8.7 MSEspice | 492
14.8.8 GNU Octave | 492
15 ngspice as shared library or dynamic link library | 493
15.1 Compile options | 493
15.1.1 How to get the sources | 493
15.1.2 Linux, MINGW, CYGWIN | 493
15.1.3 MS Visual Studio | 494
15.2 Linking shared ngspice to a calling application | 494
15.2.1 Linking during creating the caller | 494
15.2.2 Loading at runtime | 494
15.3 Shared ngspice API | 494
15.3.1 structs and types defined for transporting data | 494
15.3.2 Exported functions | 496
15.3.3 Callback functions | 500
15.4 General remarks on using the API | 504
15.4.1 Loading a netlist | 504
15.4.2 Running the simulation | 506
15.4.3 Accessing data | 507
15.4.4 Altering model or device parameters | 508
15.4.5 Output | 508
15.4.6 Error handling | 508
15.5 Example applications | 508
15.6 ngspice parallel | 509
15.6.1 Go parallel! | 509
15.6.2 Additional exported functions | 510
15.6.3 Additional callback functions | 511
15.6.4 Parallel ngspice example | 511

20 | CONTENTS
16 TCLspice | 513
16.1 tclspice framework | 513
16.2 tclspice documentation | 513
16.3 spicetoblt | 513
16.4 Running TCLspice | 514
16.5 examples | 514
16.5.1 Active capacitor measurement | 514
16.5.2 Optimization of a linearization circuit for a Thermistor | 517
16.5.3 Progressive display | 521
16.6 Compiling | 522
16.6.1 Linux | 522
16.6.2 MS Windows | 522
16.7 MS Windows 32 Bit binaries | 523
17 Example Circuits | 525
17.1 AC coupled transistor amplifier | 525
17.2 Differential Pair | 531
17.3 MOSFET Characterization | 531
17.4 RTL Inverter | 531
17.5 Four-Bit Binary Adder (Bipolar) | 532
17.6 Four-Bit Binary Adder (MOS) | 534
17.7 Transmission-Line Inverter | 535
18 Statistical circuit analysis | 537
18.1 Introduction | 537
18.2 Using random param(eters) | 537
18.3 Behavioral sources (B, E, G, R, L, C) with random control | 539
18.4 ngspice control language | 540
18.5 Monte-Carlo Simulation | 541
18.5.1 Varying model or instance parameters | 542
18.5.2 Using the ngspice control language | 542
18.6 Data evaluation with Gnuplot | 544

CONTENTS | 21
19 Circuit optimization with ngspice | 547
19.1 Optimization of a circuit | 547
19.2 ngspice optimizer using ngspice scripts | 548
19.3 ngspice optimizer using tclspice | 548
19.4 ngspice optimizer using a Python script | 548
19.5 ngspice optimizer using ASCO | 548
19.5.1 Three stage operational amplifier | 549
19.5.2 Digital inverter | 550
19.5.3 Bandpass | 552
19.5.4 Class-E power amplifier | 552
20 Notes | 553
20.1 Glossary | 553
20.2 Acronyms and Abbreviations | 554
20.3 To Do | 555
II XSPICE Software User’s Manual | 561
21 XSPICE Basics | 563
21.1 ngspice with the XSPICE option | 563
21.2 The XSPICE Code Model Subsystem | 563
21.3 XSPICE Top-Level Diagram | 564
22 Execution Procedures | 565
22.1 Simulation and Modeling Overview | 565
22.1.1 Describing the Circuit | 565
22.2 Circuit Description Syntax | 571
22.2.1 XSPICE Syntax Extensions | 571
22.3 How to create code models | 573
23 Example circuits | 577
23.1 Amplifier with XSPICE model ‘gain’ | 577
23.2 XSPICE advanced usage | 579
23.2.1 Circuit example C3 | 579
23.2.2 Running example C3 | 582

22 | CONTENTS
24 Code Models and User-Defined Nodes | 587
24.1 Code Model Data Type Definitions | 588
24.2 Creating Code Models | 588
24.3 Creating User-Defined Nodes | 589
24.4 Adding a new code model library | 590
24.5 Compiling and loading the new code model (library) | 590
24.6 Interface Specification File | 591
24.6.1 The Name Table | 593
24.6.2 The Port Table | 593
24.6.3 The Parameter Table | 595
24.6.4 Static Variable Table | 596
24.7 Model Definition File | 598
24.7.1 Macros | 598
24.7.2 Function Library | 607
24.8 User-Defined Node Definition File | 617
24.8.1 Macros | 617
24.8.2 Function Library | 618
24.8.3 Example UDN Definition File | 620
25 Error Messages | 625
25.1 Preprocessor Error Messages | 625
25.2 Simulator Error Messages | 630
25.3 Code Model Error Messages | 631
25.3.1 Code Model aswitch | 631
25.3.2 Code Model climit | 632
25.3.3 Code Model core | 632
25.3.4 Code Model d_osc | 632
25.3.5 Code Model d_source | 633
25.3.6 Code Model d_state | 633
25.3.7 Code Model oneshot | 634
25.3.8 Code Model pwl | 634
25.3.9 Code Model s_xfer | 634
25.3.10 Code Model sine | 635
25.3.11 Code Model square | 635
25.3.12 Code Model triangle | 636

CONTENTS | 23
III CIDER | 637
26 CIDER User’s Manual | 639

24 | CONTENTS

CONTENTS | 25
26.16.1 DESCRIPTION | 662
26.16.2 Parameters | 663
26.16.3 EXAMPLES | 663
26.16.4 SEE ALSO | 663
26.17NUMD | 664
26.17.1 DESCRIPTION | 664
26.17.2 Parameters | 665
26.17.3 EXAMPLES | 665
26.17.4 SEE ALSO | 666
26.17.5 BUGS | 666
26.18NBJT | 666
26.18.1 DESCRIPTION | 666
26.18.2 Parameters | 667
26.18.3 EXAMPLES | 667
26.18.4 SEE ALSO | 668
26.18.5 BUGS | 668
26.19NUMOS | 668
26.19.1 DESCRIPTION | 668
26.19.2 Parameters | 669
26.19.3 EXAMPLES | 669
26.19.4 SEE ALSO | 670
26.202D contour plots | 670
26.21Cider examples | 670
IV Miscellaneous | 671
27 Model and Device Parameters | 673
27.1 Accessing internal device parameters | 673
27.2 Elementary Devices | 675
27.2.1 Resistor | 675
27.2.2 Capacitor - Fixed capacitor | 677
27.2.3 Inductor - Fixed inductor | 678
27.2.4 Mutual - Mutual Inductor | 679
27.3 Voltage and current sources | 680
27.3.1 Bxxxx - Arbitrary source (ASRC) | 680

26 | CONTENTS
27.3.2 Isource - Independent current source | 681
27.3.3 Vsource - Independent voltage source | 682
27.3.4 Fxxxx: Current-Controlled Current Source (CCCS) | 683
27.3.5 Hxxxx: Current-Controlled Voltage Source (CCVS) | 683
27.3.6 Gxxxx: Voltage-Controlled Current Source (VCCS) | 684
27.3.7 Exxxx: Voltage-Controlled Voltage Source (VCVS) | 684
27.4 Transmission Lines | 685
27.4.1 CplLines - Simple Coupled Multiconductor Lines | 685
27.4.2 LTRA - Lossy transmission line | 686
27.4.3 Tranline - Lossless transmission line | 687
27.4.4 TransLine - Simple Lossy Transmission Line | 688
27.4.5 URC - Uniform R. C. line | 689
27.5 BJTs | 690
27.5.1 BJT - Bipolar Junction Transistor | 690
27.5.2 VBIC - Vertical Bipolar Inter-Company Model | 693
27.6 MOSFETs | 697

27.6.1 MOS1 - Level 1 MOSFET model with Meyer capacitance model . . . . 697

27.6.2 MOS2 - Level 2 MOSFET model with Meyer capacitance model . . . . 700

27.6.3 MOS3 - Level 3 MOSFET model with Meyer capacitance model . . . . 704

27.6.4 MOS6 - Level 6 MOSFET model with Meyer capacitance model . . . . 708

27.6.5 MOS9 - Modified Level 3 MOSFET model | 711
27.6.6 BSIM1 - Berkeley Short Channel IGFET Model | 715
27.6.7 BSIM2 - Berkeley Short Channel IGFET Model | 718
27.6.8 BSIM3 | 722
27.6.9 BSIM4 | 723
28 Compilation notes | 725
28.1 Ngspice Installation under Linux (and other ’UNIXes’) | 725
28.1.1 Prerequisites | 725
28.1.2 Install from Git | 725
28.1.3 Install from a tarball, e.g. from ngspice-44.tar.gz | 727

28.1.4 Compilation using an user defined directory tree for object files . . . . 728

28.1.5 ngspice as a shared library | 728
28.1.6 Relative paths for spinit and code models | 728

28.1.7 Installation on Red Hat or Oracle Linux (and similar, e.g. Centos) . . . 729

CONTENTS | 27
28.1.8 Advanced Install | 729
28.2 Ngspice Compilation under Windows OS | 733
28.2.1 Building ngspice with MS Visual Studio 2022 | 733
28.2.2 How to make ngspice with MINGW and MSYS2 | 737
28.2.3 make ngspice with pure CYGWIN | 740
28.2.4 ngspice mingw or cygwin console executable w/o graphics | 740
28.2.5 ngspice for MS Windows, cross compiled from Linux | 741
28.3 Ngspice Compilation under macOS | 741
28.3.1 Prerequisites | 741
28.3.2 Compiling ngspice | 742
28.3.3 Compiling ngspice shared library | 742
28.3.4 Compiling with Apple M2 | 743
28.4 Reporting errors | 743
29 Copyrights and licenses | 745
29.1 Documentation license | 745
29.2 ngspice license | 745
29.3 Some license details | 745
29.3.1 CC-BY-SA | 745
29.3.2 ‘Modified’ BSD license | 746
29.4 On the historical evolvement of the ngspice licenses | 747
29.4.1 XSPICE SOFTWARE (documentation) copyright | 747

29.4.2 CIDER RESEARCH SOFTWARE AGREEMENT (superseded by 29.4.3)747

29.4.3 ‘Modified’ BSD license | 748
29.4.4 XSPICE | 748
29.4.5 OSDI | 748
29.4.6 tclspice, numparam | 749
29.4.7 Linking to GPLd libraries (e.g. readline, fftw, table.cm): | 749
Index | 751

28 | CONTENTS

# Part I

# Ngspice User’s Manual

29

# Prefaces

## Preface to the first edition

This manual has been assembled from different sources:

1. The spice3f5 manual,
2. the XSPICE user’s manual,
3. the CIDER user’s manual

and some original material needed to describe the new features and the newly implemented models. This cut and paste approach, while not being orthodox, allowed ngspice to have a full manual in a fraction of the time that writing a completely new text would have required. The use of LaTex and LYX instead of TeXinfo, which was the original encoding for the manual, further helped to reduce the writing effort and improved the quality of the result, at the expense of an on-line version of the manual but, due to the complexity of the software I hardly think that users will ever want to read an on-line text version.

In writing this text I followed the spice3f5 manual, both in the chapter sequence and presentation of material, mostly because that was already the user manual of SPICE.

Ngspice is an open source software, users can download the source code, compile, and run it. This manual has an entire chapter describing program compilation and available options to help users in building ngspice (see Chapt. 28). The source package already comes with all ‘safe’ options enabled by default, and activating the others can produce unpredictable results and thus is recommended to expert users only. This is the first ngspice manual and I have removed all the historical material that described the differences between ngspice and spice3, since it was of no use for the user and not so useful for the developer who can look for it in the Changelogs of in the revision control system.

I want to acknowledge the work done by Emmanuel Rouat and Arno W. Peters for converting the original spice3f documentation to TEXinfo. Their effort gave ngspice users the only available documentation that described the changes for many years. A good source of ideas for this manual came from the on-line spice3f manual written by Charles D.H. Williams (Spice3f5 User Guide), (http://newton.ex.ac.uk/teaching/CDHW/Electronics2/userguide/index.html#toc) constantly updated and useful for its many insights.

As always, errors, omissions and unreadable phrases are only my fault.

Paolo Nenzi

Roma, March 24th 2001

31

32

Indeed. At the end of the day, this is engineering, and one learns to live within the limitations of the tools.

Kevin Aylward, Warden of the King’s Ale

## Preface to the current edition (as of Dec 2024)

Due to the wealth of new material and options in ngspice the actual order of chapters has been revised. Several new chapters have been added. The LYX text processor has allowed adding internal cross references. The PDF format has become the standard format for distribution of the manual. There is also a xhtml (http://ngspice.sourceforge.net/docs/ngspice-html-manual/manual.xhtml) version available. Within each new ngspice distribution a manual edition is provided reflecting the ngspice status at the time of distribution. At the same time, located at ngspice manuals, (http://ngspice.cvs.sourceforge.net/viewvc/ngspice/ngspice/ng-spice-manuals/) the manual is constantly updated. Every new ngspice feature should enter this manual as soon as it has been made available in the Git source code master branch.

Holger Vogt

Mülheim, 2024

# Acknowledgments

## ngspice contributors

Spice3 and CIDER were originally written at The University of California at Berkeley (USA).

XSPICE has been provided by Georgia Institute of Technology, Atlanta (USA).

Since then, there have been many people working on the software, most of them releasing patches to the original code through the Internet.

The following people have contributed in some way:

Vera Albrecht,
Cecil Aswell,
Giles Atkinson,
Giles C. Billingsley,
Phil Barker,
Steven Borley,
Stuart Brorson,
Alessio Cacciatori,
Mansun Chan,
Wayne A. Christopher,
Al Davis,
Glao S. Dezai,
Jon Engelbert,
Daniele Foci,
Noah Friedman,
David A. Gates,
Alan Gillespie,
John Heidemann,
Marcel Hendrix,
Jeffrey M. Hsu,
JianHui Huang,
S. Hwang,
Chris Inbody,
Gordon M. Jacobs,
Min-Chie Jeng,
Beorn Johnson,
Stefan Jones,
Kenneth H. Keller,

33

34

Francesco Lannutti,
Robert Larice,
Mathew Lew,
Robert Lindsell,
Weidong Liu,
Kartikeya Mayaram,
Richard D. McRoberts,
Manfred Metzger,
Jim Monte,
Wolfgang Muees,
Paolo Nenzi,
Gary W. Ng,
Hong June Park,
Stefano Perticaroli,
Arno Peters,
Serban-Mihai Popescu,
Georg Post,
Thomas L. Quarles,
Emmanuel Rouat,
Jean-Marc Routure,
Jaijeet S. Roychowdhury,
Lionel Sainte Cluque,
Takayasu Sakurai,
Amakawa Shuhei,
Kanwar Jit Singh,
Bill Swartz,
Hitoshi Tanaka,
Brian Taylor,
Steve Tell,
Andrew Tuckey,
Andreas Unger,
Holger Vogt,
Dietmar Warning,
Michael Widlok,
Charles D.H. Williams,
Antony Wilson,

and many others...

If someone helped in the development and has not been inserted in this list then this omission was unintentional. If you feel you should be on this list then please write to <ngspicedevel@lists.sourceforge.net>. Do not be shy, we would like to make a list as complete as possible.

# Chapter 1

# Introduction

Ngspice is a general-purpose circuit simulation program for nonlinear and linear analyses. Circuits may contain resistors, capacitors, inductors, mutual inductors, independent or dependent voltage and current sources, loss-less and lossy transmission lines, switches, uniform distributed RC lines, and the five most common semiconductor devices: diodes, BJTs, JFETs, MESFETs, and MOSFETs.

The most common way to use Ngspice is to start it from the OS command prompt, passing the name of a netlist file: one containing the definition of a circuit. The largest part of this manual is the description of such files. For a full description of starting options see Chapter 12. Input files may also contain scripts written in Ngspice’s command language (13). Interactive user interfaces are described in Chapter 14.

Some introductory remarks on how to use ngspice may be found in Chapter 17.

Ngspice is an update of Spice3f5, the last Berkeley’s release of Spice3 simulator family. Ngspice is being developed to include new features to existing Spice3f5 and to fix its bugs. Improving a complex software like a circuit simulator is a very hard task and, while some improvements have been made, most of the work has been done on bug fixing and code refactoring.

Ngspice has built-in models for the semiconductor devices, and the user need specify only the pertinent model parameter values.

Ngspice supports mixed-level simulation and provides a direct link between technology parameters and circuit performance. A mixed-level circuit and device simulator can provide greater simulation accuracy than a stand-alone circuit or device simulator by numerically modeling the critical devices in a circuit. Compact models can be used for all other devices. The mixed-level extensions to ngspice is CIDER, a mixed-level circuit and device simulator integrated into ngspice code.

Ngspice supports mixed-signal simulation through the integration of XSPICE code. XSPICE software, developed as an extension to Spice3C1 by GeorgiaTech, has been enhanced and ported to ngspice to provide ‘board’ level and mixed-signal simulation. Digital Verilog modules, compiled with Verilator or Icarus Verilog, can be attached. Communication with (C coded) processes via pipes may be established.

The XSPICE extension enables pure digital simulation as well.

New devices can be added to ngspice by several means: behavioral B-, E- or G-sources, the XSPICE code-model interface for C-like device coding, and Verilog-A models, when compiled with OpenVAF, via the OSDI interface.

35

36 | CHAPTER 1. INTRODUCTION

Finally, numerous small bugs have been discovered and fixed, and the program has been ported to a wider variety of computing platforms.

## 1.1 Simulation Algorithms

Computer-based circuit simulation is often used as a tool by designers, test engineers, and others who want to analyze the operation of a design without examining the physical circuit. Simulation allows you to change quickly the parameters of many of the circuit elements to determine how they affect the circuit response. Often it is difficult or impossible to change these parameters in a physical circuit.

However, to be practical, a simulator must execute in a reasonable amount of time. The key to efficient execution is choosing the proper level of modeling abstraction for a given problem. To support a given modeling abstraction, the simulator must provide appropriate algorithms.

Historically, circuit simulators have supported either an analog simulation algorithm or a digital simulation algorithm. Ngspice inherits the XSPICE framework and supports both analog and digital algorithms and is a ‘mixed-mode’ simulator.

### 1.1.1 Analog Simulation

Analog simulation focuses on the linear and non-linear behavior of a circuit over a continuous time or frequency interval. The circuit response is obtained by iteratively solving Kirchhoff’s Laws for the circuit at time steps selected to ensure the solution has converged to a stable value and that numerical approximations of integrations are sufficiently accurate. Since Kirchhoff’s laws form a set of simultaneous equations, the simulator operates by solving a matrix of equations at each time point. This matrix processing generally results in slower simulation times when compared to digital circuit simulators.

The response of a circuit is a function of the applied sources. Ngspice offers a variety of source types including DC, sine-wave, and pulse. In addition to specifying sources, the user must define the type of simulation to be run. This is termed the ‘mode of analysis’. Analysis modes include DC analysis, AC analysis, and transient analysis. For DC analysis, the time-varying behavior of reactive elements is neglected and the simulator calculates the DC solution of the circuit. Swept DC analysis may also be accomplished with ngspice. This is simply the repeated application of DC analysis over a range of DC levels for the input sources. For AC analysis, the simulator determines the response of the circuit, including reactive elements to small-signal sinusoidal inputs over a range of frequencies. The simulator output in this case includes amplitudes and phases as a function of frequency. For transient analysis, the circuit response, including reactive elements, is analyzed to calculate the behavior of the circuit as a function of time.

### 1.1.2 Matrix solvers

Since version 42 ngspice offers two matrix solvers. Spice3f5 originally has used the solver Sparse 1.3, which has proven to be robust for all simulation tasks [26]. It is especially suited for simulating behavioral models. Optionally, to speed up the simulation of large circuits with thousands of transistors, the KLU matrix solver [27, 28] may be selected (see chapter 11.1.1).

1.1. SIMULATION ALGORITHMS | 37

### 1.1.3 Device Models for Analog Simulation

There are three models for bipolar junction transistors, all based on the integral-charge model of Gummel and Poon; however, if the Gummel-Poon parameters are not specified, the basic model (BJT) reduces to the simpler Ebers-Moll model. In either case and in either model, charge storage effects, ohmic resistances, and a current-dependent output conductance may be included. The second bipolar model BJT2 adds dc current computation in the substrate diode. The third model (VBIC) contains further enhancements for advanced bipolar devices.

The semiconductor diode model can be used for either junction diodes or Schottky barrier diodes. There are two models for JFET: the first (JFET) is based on the model of Shichman and Hodges, the second (JFET2) is based on the Parker-Skellern model. All the original six MOSFET models are implemented: MOS1 is described by a square-law I-V characteristic, MOS2 [28] is an analytical model, while MOS3 [28] is a semi-empirical model; MOS6 [2] is a simple analytic model accurate in the short channel region; MOS9, is a slightly modified Level 3 MOSFET model - not to confuse with Philips level 9; BSIM 1 [3, 4]; BSIM2 [5] are the old BSIM (Berkeley Short-channel IGFET Model) models. MOS2, MOS3, and BSIM include second-order effects such as channel-length modulation, subthreshold conduction, scatteringlimited velocity saturation, small-size effects, and charge controlled capacitances. The recent MOS models for submicron devices are the BSIM3 (Berkeley BSIM3 web page) (http://bsim.berkeley.edu/models/bsim3/) and BSIM4 (Berkeley BSIM4 web page) (http://bsim.berkeley.edu/models/bsim4/) models. Silicon-on-insulator MOS transistors are described by the SOI models from the BSIMSOI family (Berkeley BSIMSOI web page) (http://bsim.berkeley.edu/models/bsimsoi/) and the STAG [18] model. There is some support for a couple of HFET models and one model for MESA devices. Verilog-A models are made available via the OpenVAF/OSDI interface (see chapter 9).

### 1.1.4 Digital Simulation

Digital circuit simulation differs from analog circuit simulation in several respects. A primary difference is that a solution of Kirchhoff’s laws is not required. Instead, the simulator must only determine whether a change in the logic state of a node has occurred and propagate this change to connected elements. Such a change is called an ‘event’.

When an event occurs, the simulator examines only those circuit elements that are affected by the event. As a result, matrix analysis is not required in digital simulators. By comparison, analog simulators must iteratively solve for the behavior of the entire circuit because of the forward and reverse transmission properties of analog components. This difference results in a considerable computational advantage for digital circuit simulators, which is reflected in the significantly greater speed of digital simulations.

### 1.1.5 Mixed-Signal Simulation

Modern circuits often contain a mix of analog and digital circuits. To simulate such circuits efficiently and accurately, a mix of analog and digital simulation techniques is required. When analog simulation algorithms are combined with digital simulation algorithms, the result is termed ‘mixed-mode simulation’.

Two basic methods of implementing mixed-mode simulation used in practice are the ‘native mode’ and ‘glued mode’ approaches. Native mode simulators implement both an analog algorithm and a digital algorithm in the same executable. Glued mode simulators actually use two

38 | CHAPTER 1. INTRODUCTION

simulators, one of which is analog and the other digital. This type of simulator must define an input/output protocol so that the two executables can communicate with each other effectively. The communication constraints tend to reduce the speed, and sometimes the accuracy, of the complete simulator. On the other hand, the use of a glued mode simulator allows the component models developed for the separate executables to be used without modification.

Ngspice is a native mode simulator providing both analog and event-based simulation in the same executable. The underlying algorithms of ngspice (coming from XSPICE and its Code Model Subsystem) allow use of all the standard SPICE models, provide a pre-defined collection of the most common analog and digital functions, and provide an extensible base on which to build additional models.

### 1.1.5.1 User-Defined Nodes

Ngspice supports creation of ‘User-Defined Node’ types. User-Defined Node types allow you to specify nodes that propagate data other than voltages, currents, and digital states. Like digital nodes, User-Defined Nodes use event-driven simulation, but the state value may be an arbitrary data type. A simple example application of User-Defined Nodes is the simulation of a digital signal processing filter algorithm. In this application, each node could assume a real or integer value. More complex applications may define types that involve complex data such as digital data vectors or even non-electronic data.

Ngspice digital simulation is actually implemented as a special case of this User-Defined Node capability where the digital state is defined by a data structure that holds a Boolean logic state and a strength value.

### 1.1.6 Mixed-Level Simulation (Electronic and TCAD)

Ngspice implements mixed-level simulation through the merging of its code with CIDER (details see Chapt. 26).

CIDER is a mixed-level circuit and device simulator that provides a direct link between technology parameters and circuit performance. A mixed-level circuit and device simulator can provide greater simulation accuracy than a stand-alone circuit or device simulator by numerically modeling the critical devices in a circuit. Compact models can be used for noncritical devices.

CIDER couples ngspice to a internal C-based device simulator, thus providing circuit analyses, compact models for semiconductor devices, and an interactive user interface. CIDER provides accurate, one- and two-dimensional numerical device models based on the solution of Poisson’s equation, and the electron and hole current-continuity equations. CIDER incorporates many of the same basic physical models found in the the Stanford two-dimensional device simulator PISCES [PINT85]. Input to CIDER consists of a SPICE-like description of the circuit and its compact models, and PISCES-like descriptions of the structures of numerically modeled devices. As a result, CIDER should seem familiar to designers already accustomed to these two tools.

The CIDER input format has great flexibility and allows increased access to physical model parameters. New physical models have been added to allow simulation of state-of-the-art devices. These include transverse field mobility degradation [GATE90] that is important in scaled-down

1.2. SUPPORTED ANALYSES | 39

MOSFETs and a polysilicon model for poly-emitter bipolar transistors. Temperature dependence has been included for most physical models over the range from -50°C to 150°C. The numerical models can be used to simulate all the basic types of semiconductor devices: resistors, MOS capacitors, diodes, BJTs, JFETs and MOSFETs. BJTs and JFETs can be modeled with or without a substrate contact. Support has been added for the management of device internal states. Post-processing of device states can be performed using the control language user interface of ngspice. Previously computed states can be loaded into the program to provide accurate initial guesses for subsequent analyses.

Details of the basic semiconductor equations and the physical models used by CIDER are not provided in this manual. Unfortunately, no other single source exists that describes all of the relevant background material. Comprehensive reviews of device simulation can be found in [PINT90] and the book [SELB84]. CODECS (predecessor to CIDER) and its inversion-layer mobility model are described in [MAYA88] and [LGATE90], respectively. PISCES and its models are described in [PINT85]. Temperature dependencies for the PISCES models used by CIDER are available in [SOLL90].

For Linux users the cooperation of the TCAD software GSS with ngspice might be of interest, see https://ngspice.sourceforge.io/gss.html. This project is no longer maintained however, but has moved into the Genius simulator, still available as open source cogenda genius. (http://www.cogenda.com/article/download)

## 1.2 Supported Analyses

The ngspice simulator supports the following different types of analysis:

1. DC Analysis (Operating Point and DC Sweep) (11.3.2 and 11.3.5)
2. AC Small-Signal Analysis (11.3.1)
3. Transient Analysis (11.3.10)
4. Pole-Zero Analysis (11.3.6)
5. Small-Signal Distortion Analysis (11.3.3)
6. Sensitivity Analysis (11.3.7)
7. Noise Analysis (11.3.4)

The different types of analysis are described below, the cross-references above are to the netlist directives used to request them. Applications that are exclusively analog can make use of all analysis modes with the exception of the Code Model subsystem that does not implement Pole-Zero, Distortion, Sensitivity and Noise analyses. Event-driven applications that include digital and User-Defined Node types may make use of DC (operating point and DC sweep) and Transient only.

In order to understand the relationship between the different analyses and the two underlying simulation algorithms of ngspice, it is important to understand what is meant by each analysis type. This is detailed below.

40 | CHAPTER 1. INTRODUCTION

### 1.2.1 DC Analysis

The DC analysis portion of ngspice determines the dc operating point of the circuit with inductors shorted and capacitors opened. DC analysis options are specified on the .DC, .TF, and .OP control lines.

DC analysis does not consider any time dependence on any of the sources within the system description. The simulator algorithm subdivides the circuit into those portions that require the analog simulator algorithm and those that require the event-driven algorithm. Each subsystem block is then iterated to solution, with the interfaces between analog nodes and event-driven nodes iterated for consistency across the entire system.

Once stable values are obtained for all nodes in the system, the analysis halts and the results may be displayed or printed out as you request them.

A dc analysis is automatically performed prior to a transient analysis to determine the transient initial conditions, and prior to an ac small-signal analysis to determine the linearized, small-signal models for nonlinear devices. If requested, the DC small-signal value of a transfer function (ratio of output variable to input source), input resistance, and output resistance is also computed as a part of the DC solution. DC analysis can also be used to generate DC transfer curves: a specified independent voltage, current source, resistor or temperature is stepped over a user-specified range and the DC output variables are stored for each sequential source value.

### 1.2.2 AC Small-Signal Analysis

AC analysis is limited to analog nodes and represents the small signal, sinusoidal solution of the analog system described at a particular frequency or set of frequencies. This analysis is similar to the DC analysis in that it represents the steady-state behavior of the described system with a single input node at a given set of stimulus frequencies.

The program first computes the dc operating point of the circuit and determines linearized, small-signal models for all of the nonlinear devices in the circuit. The resultant linear circuit is then analyzed over a user-specified range of frequencies. The desired output of an ac small-signal analysis is usually a transfer function (voltage gain, transimpedance, etc). If the circuit has only one ac input, it is convenient to set that input to unity and zero phase, so that output variables have the same value as the transfer function of the output variable with respect to the input.

### 1.2.3 Transient Analysis

Transient analysis is an extension of DC analysis to the time domain. A transient analysis first obtains a DC solution to provide a point of departure for simulating time-varying behavior. Once the DC solution is obtained, the time-dependent aspects of the system are reintroduced, and the two simulator algorithms incrementally solve for the time varying behavior of the entire system. Inconsistencies in node values are resolved by the two simulation algorithms such that the time-dependent waveforms created by the analysis are consistent across the entire simulated time interval. Resulting time-varying descriptions of node behavior for the specified time interval are accessible to you.

All sources that are not time dependent (for example, power supplies) are set to their dc value. The transient time interval is specified on a .TRAN control line.

1.2. SUPPORTED ANALYSES | 41

### 1.2.4 Pole-Zero Analysis

Pole-zero analysis in ngspice computes the poles and/or zeros in the small-signal ac transfer function. Ngspice first computes the dc operating point and then determines the linearized, small-signal models for all the nonlinear devices in the circuit. The small-signal circuit model is then used to find the poles and zeros of the transfer function. Two types of transfer functions are allowed: one of the form (output voltage)/(input voltage) and the other of the form (output voltage)/(input current). These two types of transfer functions cover all the cases and one can find the poles/zeros of functions like input/output impedance and voltage gain. The input and output ports are specified as two pairs of nodes. The pole-zero analysis works with resistors, capacitors, inductors, linear-controlled sources, independent sources, BJTs, MOSFETs, JFETs and diodes. Transmission lines are not supported.

The method used in the analysis is a sub-optimal numerical search. For large circuits it may take a considerable time or fail to find all poles and zeros. Please note, that for some circuits, the method becomes “lost” and may find an excessive number of poles or zeros.

### 1.2.5 Small-Signal Distortion Analysis

Distortion analysis in ngspice computes steady-state harmonic and intermodulation products for small input signal magnitudes. If signals of a single frequency are specified as the input to the circuit, the complex values of the second and third harmonics are determined at every point in the circuit. If there are signals of two frequencies input to the circuit, the analysis finds out the complex values of the circuit variables at the sum and difference of the input frequencies, and at the difference of the smaller frequency from the second harmonic of the larger frequency. Distortion analysis is supported for the following nonlinear devices:

- Diodes (DIO),
- BJT,
- JFET (level 1),
- MOSFETs (levels 1, 2, 3, 9, and BSIM1),
- MESFET (level 1).

All linear devices are automatically supported by distortion analysis. If there are switches present in the circuit, the analysis continues to be accurate provided the switches do not change state under the small excitations used for distortion calculations.

If a device model does not support direct small signal distortion analysis, please use the Fourier of FFT statements and evaluate the output per scripting.

### 1.2.6 Sensitivity Analysis

Ngspice can calculate either the DC operating-point sensitivity or the AC small-signal sensitivity of an output variable with respect to all circuit variables, including model parameters. Ngspice calculates the difference in an output variable (either a node voltage or a branch current)

42 | CHAPTER 1. INTRODUCTION

by perturbing each parameter of each device independently. Since the method is a numerical approximation, the results may demonstrate second order effects in highly sensitive parameters, or may fail to show very low but non-zero sensitivity.

Since each variable is perturbed by a small fraction of its value, zero-valued parameters are not analyzed, reducing what is usually a very large amount of data.

### 1.2.7 Noise Analysis

Noise analysis in ngspice measures the device-generated noise for a given circuit. When provided with an input source and an output port, the analysis calculates the noise contributions of each device, and each noise generator within each device, as measured as a voltage at the output port. Noise analysis also calculates the equivalent input noise of the circuit, based on the output noise. This is done for every frequency point in a specified range - the calculated value of the noise corresponds to the spectral density of the circuit variable viewed as a stationary Gaussian stochastic process. After calculating the spectral densities, noise analysis integrates these values over the specified frequency range to arrive at the total noise voltage and current over this frequency range. The calculated values correspond to the variance of the circuit variables viewed as stationary Gaussian processes.

### 1.2.8 Periodic Steady State Analysis

Experimental code.

PSS is a radio frequency periodical large-signal dedicated analysis. The implementation is based on a time domain shooting method that make use of transient analysis. As it is in early development stage, PSS performs analysis only on autonomous circuits, meaning that it is able to predict fundamental frequency and (harmonic) amplitude(s) for oscillators, VCOs, etc.. The algorithm is based on a search of the minimum error vector defined as the difference of RHS vectors between two occurrences of an estimated period. Convergence is reached when the mean of this error vector decreases below a given threshold parameter. Results of PSS are the basis of periodical large-signal analyses like PAC or PNoise.

## 1.3 Analysis at Different Temperatures

### 1.3.1 Introduction

Temperature, in ngspice, is a property associated to the entire circuit, rather than an analysis option. Circuit temperature has a default (nominal) value of 27°C (300.15 K) that can be changed using the TEMP option in an .option control line (see 11.1.1) or by the .TEMP line (see 2.14), which has precedence over the .option TEMP line. All analyses are, thus, performed at circuit temperature, and if you want to simulate circuit behavior at different temperatures you should prepare a netlist for each temperature.

All input data for ngspice is assumed to have been measured at the circuit nominal temperature. This value can further be overridden for any device that models temperature effects by specifying the TNOM parameter on the .model itself. Individual instances may further override

1.3. ANALYSIS AT DIFFERENT TEMPERATURES | 43

the circuit temperature through the specification of TEMP and DTEMP parameters on the instance. The two options are not independent even if you can specify both on the instance line, the TEMP option overrides DTEMP. The algorithm to compute instance temperature is described below:

Algorithm 1.1 Instance temperature computation

IF TEMP is specified THEN
instance_temperature = TEMP
ELSE
instance_temperature = circuit_temperature + DTEMP END IF

Temperature dependent support is provided for all devices except voltage and current sources (either independent and controlled) and BSIM models. BSIM MOSFETs have an alternate temperature dependency scheme that adjusts all of the model parameters before input to ngspice.

For details of the BSIM temperature adjustment, see [6] and [7]. Temperature appears explicitly in the exponential terms of the BJT and diode model equations. In addition, saturation currents have a built-in temperature dependence. The temperature dependence of the saturation current in the BJT models is determined by:

IS (T1) = IS (T0)

T1
T0

XT I
exp
Egq(T1 −T0)
k (T1T0)
(1.1)

where k is Boltzmann’s constant, q is the electronic charge, Eg is the energy gap model parameter, and XT I is the saturation current temperature exponent (also a model parameter, and usually equal to 3).

The temperature dependence of forward and reverse beta is according to the formula:

B(T1) = B(T0)

T1
T0

XT B
(1.2)

where T0 and T1 are in degrees Kelvin, and XT B is a user-supplied model parameter. Temperature effects on beta are carried out by appropriate adjustment to the values of BF, ISE, BR, and ISC (SPICE model parameters BF, ISE, BR, and ISC, respectively).

Temperature dependence of the saturation current in the junction diode model is determined by:

IS (T1) = IS (T0)

T1
T0

XT I
N

exp
Egq(T1 −T0)
Nk (T1T0)
(1.3)

where N is the emission coefficient model parameter, and the other symbols have the same meaning as above. Note that for Schottky barrier diodes, the value of the saturation current temperature exponent, XT I, is usually 2. Temperature appears explicitly in the value of junction potential, U (in Ngspice PHI), for all the device models.

The temperature dependence is determined by:

U (T) = kT
q

ln

NaNd
Ni(T)

2

!
(1.4)

44 | CHAPTER 1. INTRODUCTION

where k is Boltzmann’s constant, q is the electronic charge, Na is the acceptor impurity density, Nd is the donor impurity density, Ni

is the intrinsic carrier concentration, and Eg is the energy gap. Temperature appears explicitly in the value of surface mobility, M0(or U0), for the MOSFET model.

The temperature dependence is determined by:

M0 (T) = M0 (T0)
T
T0

1.5

(1.5)

The effects of temperature on resistors, capacitor and inductors is modeled by the formula:

R(T) = R(T0)

h
1+TC1 (T −T0) +TC2 (T −T0)

2

i
(1.6)

where T is the circuit temperature, T0 is the nominal temperature, and TC1 and TC2 are the first and second order temperature coefficients.

### 1.3.2 Controlling the temperature

The default temperature is set to 27 °C.

.temp 40

will set the overall temperature to 40 °C (2.14). The command

.options temp=60

will set the overall temperature to 60 °C (11.1.1). Both commands are equivalent, however .temp will override .options temp.

The temperature of an individual device may be determined by the instance parameters temp or dtemp.

M1 d g s b MOSN temp=35

will set the temperature of the specific MOS device to 35 °C.

M2 d g s b MOSN dtemp=20

will set the temperature of device M2 at a delta of 20° above the overall temperature.

The temperatures thus set are static throughout the simulation. It is possible, however, to sweep the temperature by a command like

.dc temp 25 49 2

1.4. CONVERGENCE | 45

starting at 25 °C, stopping at 49 °C with a step of 2° (see 11.3.2).

The current overall temperature may be assessed by the variable TEMPER, which can be used as part of an equation in B sources (5.1.2) or behavioral E, G, R, L, C sources (e.g. 5.2). A typical example may look like

Bt1 1 2 V=’5 + TEMPER*TEMPER’

The nominal temperature, a reference temperature where device model parameters have been measured, is called tnom.

.options tnom=25

will set the nominal temperature for all devices to 25 °C (11.1.1). Tnom sometimes may be set as a model parameter in a .model line (3.2.2), depending on the specific class of devices and its model parameter set.

## 1.4 Convergence

Ngspice uses the Newton-Raphson algorithm to solve nonlinear equations arising from circuit description. The NR algorithm is interactive and terminates when both of the following conditions hold:

1. The nonlinear branch currents converge to within a tolerance of 0.1% or 1 picoamp (1.0e-12 Amp), whichever is larger.
2. The node voltages converge to within a tolerance of 0.1% or 1 microvolt (1.0e-6 Volt), whichever is larger.

### 1.4.1 Voltage convergence criterion

The algorithm has reached convergence when the difference between the last iteration k and the current one (k +1)

v

(k+1)
n −v

(k)
| n
≤ RELTOL vnmax +VNTOL, | (1.7)

where

vnmax = max

v

(k+1)
n

,

v

(k)
n
. | (1.8)
The RELTOL (RELative TOLerance) parameter, which default value is 10⁻³ | , specifies how small
the solution update must be, relative to the node voltage, to consider the solution to have converged. The VNTOL (absolute convergence) parameter, which has 1µV as default value, becomes important when node voltages have near zero values. The relative parameter alone, in such case, would need too strict tolerances, perhaps lower than computer round-off error, and thus convergence would never be achieved. VNTOL forces the algorithm to consider as converged any node whose solution update is lower than its value.

46 | CHAPTER 1. INTRODUCTION

### 1.4.2 Current convergence criterion

Ngspice checks the convergence on the non-linear functions that describe the non-linear branches in circuit elements. In semiconductor devices the functions defines currents through the device and thus the name of the criterion.

Ngspice computes the difference between the value of the nonlinear function computed for the last voltage and the linear approximation of the same current computed with the actual voltage

i\(k+1)
branch −i

(k)
branch
≤ RELTOL ibrmax +ABSTOL, | (1.9)

where

ibrmax = max

i\(k+1)
branch,i

(k)

branch
. | (1.10)

In the two expressions above, the i\branch indicates the linear approximation of the current.

### 1.4.3 Convergence failure

Although the algorithm used in ngspice has been found to be very reliable, in some cases it fails to converge to a solution. When this failure occurs, the program terminates the job. Failure to converge in dc analysis is usually due to an error in specifying circuit connections, element values, or model parameter values. Regenerative switching circuits or circuits with positive feedback probably will not converge in the dc analysis unless the OFF option is used for some of the devices in the feedback path, .nodeset control line is used to force the circuit to converge to the desired state.

# Chapter 2

# Circuit Description

## 2.1 General Structure and Conventions

### 2.1.1 Input file structure

The circuit to be analyzed is described to ngspice by a set of element instance lines, which define the circuit topology and element instance values, and a set of control lines, which define the model parameters and the run controls. All lines are assembled in an input file to be read by ngspice. Two lines are essential:

- The first line in the input file must be the title, which is the only comment line that does not need any special character in the first place.
- The last line must be .end, plus a newline delimiter.

The order of the remaining lines is alomost arbitrary (except, of course, that continuation lines must immediately follow the line being continued, .subckt ... .ends, .if ... .endif, or .control ... .endc have to enclose their specific lines). Leading white spaces in a line are ignored, as well as empty lines.

The lines described in sections 2.1 to 2.12 are typically used in the core of the input file, outside of a .control section (see 12.4.3). An exception is the .include includefile line (2.8) that may be placed anywhere in the input file. The contents of includefile will be inserted exactly in place of the .include line.

### 2.1.2 Syntax check

A very preliminary syntax check has been added to the input parser.

### 2.1.2.1 Valid utf-8 characters

The input file will be scanned for valid utf-8 characters. If non-valid characters are found, reading the input is stopped.

47

48 | CHAPTER 2. CIRCUIT DESCRIPTION

### 2.1.2.2 Special characters leading a line

If the first character in a netlist or .control line is one of =[]?()&%$§\"!:, then ngspice replaces it by ’*’ and issues a warning. Command set strict_errorhandling will force ngspice to exit.

### 2.1.2.3 Dot command couple completion

Check for .control ... | .endc, .subckt ... | .ends, .if ... | .endif.

### 2.1.3 Some naming conventions

### 2.1.3.1 Lines

Fields on a line are separated by one or more blanks, a comma, an equal (=) sign, or a left or right parenthesis; extra spaces are ignored. A line may be continued by entering a ‘+’ (plus) in column 1 of the following line; ngspice continues reading beginning with column 2. Lines may also be continued in Unix shell style, when the final two characters are backslashes. A device name field must begin with a letter (A through Z) and cannot contain any delimiters.

### 2.1.3.2 Numbers

A number field may be an integer field (12, -44), a floating point field (3.14159), either an integer or floating point number followed by an integer exponent (1e-14, 2.65e3), or either an integer or a floating point number followed by one of the following scale factors:

Suffix | Name | Factor
T | Tera | 10¹²
G | Giga | 10⁹
Meg | Mega | 10⁶
K | Kilo | 10³
mil | Mil | 25.4×10⁻⁶
m | milli | 10⁻³
u | micro | 10⁻⁶
n | nano | 10⁻⁹
p | pico | 10⁻¹²
f | femto | 10⁻¹⁵
a | atto | 10⁻¹⁸

Table 2.1: Ngspice scale factors

### 2.1.3.3 Letters following a number

Letters immediately following a number that are not scale factors are ignored, and letters immediately following a scale factor are ignored. Hence, 10, 10V, 10Volts, and 10Hz all represent the same number, and M, MA, MSec, and MMhos all represent the same scale factor. Note

2.2. DOT COMMANDS | 49

that 1000, 1000.0, 1000Hz, 1e3, 1.0e3, 1kHz, and 1k all represent the same number. Note that ‘M’ or ‘m’ denote ‘milli’, i.e. 10⁻³
. Suffix meg has to be used for 10⁶ . If compatibility mode
LT (12.14.6) is set, ngspice will accept the RKM notation for entering resistance or capacitance values, e.g. 2K7 or 100R.

### 2.1.3.4 Node names

Node names may be arbitrary character strings (exceptions see below) and are case insensitive, if ngspice is used in batch mode (12.4.1). If in interactive (12.4.2) or control (12.4.3) mode, node names may either be plain numbers or arbitrary character strings, not starting with a number. The following characters = % ( ) , [ ] < > ~ are not allowed in a node name, especially when XSPICE code models are used (they have their special meanings then and act as string delimiters).

### 2.1.3.5 Ground node

The ground node must be named ‘0’ (zero). For compatibility reason gnd is accepted as ground node, and will internally be treated as a global node and be converted to ‘0’. If this is not feasible, you may switch the conversion off by setting set no_auto_gnd in one of the configuration files spinit or .spiceinit. Each circuit has to have a ground node (gnd or 0)! Note the difference in ngspice where the nodes are treated as character strings and not evaluated as numbers, thus ‘0’ and 00 are distinct nodes in ngspice but not in SPICE2.

### 2.1.4 Topological constraints

Ngspice requires that the following topological constraints are satisfied:

- The circuit cannot contain a loop of voltage sources and/or inductors and cannot contain a cut-set of current sources and/or capacitors.
- Each node in the circuit must have a dc path to ground.
- Every node must have at least two connections except for transmission line nodes (to permit unterminated transmission lines) and MOSFET substrate nodes (which have two internal connections anyway).

## 2.2 Dot commands

This section summarizes all dot commands available in ngspice, with links to their detailed presentation, in alphabetical order. Control section (or interactive) commands are listed and explained in chapter 13.5.

.AC start an ac simulation (11.3.1).

.CONTROL start a .control section (12.4.3).

50 | CHAPTER 2. CIRCUIT DESCRIPTION

.CSPARAM define parameter(s) made available in a control section (2.13).

.DC start a dc simulation (11.3.2).

.DISTO start a distortion analysis simulation (11.3.3).

.ELSE conditional branching in the netlist (2.15).

.ELSEIF conditional branching in the netlist (2.15).

.END end of the netlist (2.4.2).

.ENDC end of the .control section (12.4.3).

.ENDIF conditional branching in the netlist (2.15).

.ENDS end of subcircuit definition (2.6.2).

.FOUR Fourier analysis of transient simulation output (11.6.4).

.FUNC define a function (2.12).

.GLOBAL define global nodes (2.7).

.IC set initial conditions (11.2.2).

.IF conditional branching in the netlist (2.15).

.INCLUDE include part of the netlist (2.8).

.INCPSLT include part of the netlist with compatibility mode ’pslt’ (2.9, 12.14.4.2).

.LIB include a library (2.10).

.MEAS measurements during the simulation (11.4).

.MODEL list of device model parameters (2.5).

.NODESET set initial conditions (11.2.1).

.NOISE start a noise simulation (11.3.4).

.OP start an operating point simulation (11.3.5).

.OPTIONS set simulator options (11.1).

.PARAM define parameter(s) (2.11).

.PLOT printer plot during batch simulation (11.6.3).

.PRINT tabular listing during batch simulation (11.6.2).

.PROBE save device currents, voltages and differential voltages (11.6.5).

.PSS start a periodic steady state analysis (11.3.12).

.PZ start a pole-zero analysis simulation (11.3.6).

2.3. CIRCUIT ELEMENTS (DEVICE INSTANCES) | 51

.SAVE name simulation result vectors to be saved (11.6.1).

.SENS start a sensitivity analysis (11.3.7).

.SP S parameter analysis (11.3.8).

.SUBCKT start of subcircuit definitions (2.6).

.TEMP set the ciruit temperature (2.14).

.TF start a transfer function analysis (11.3.9).

.TITLE title of the netlist (2.4.1).

.TRAN start a transient simulation (11.3.10).

.WIDTH width of printer plot (11.6.7).

## 2.3 Circuit elements (device instances)

Each element in the circuit is a device instance specified by an instance line that contains:

- the element instance name,
- the circuit nodes to which the element is connected,
- and the values of the parameters that determine the electrical characteristics of the element.

The first letter of the element instance name specifies the element type. The format for the ngspice element types is given in the following manual chapters, e.g. BZZZZ. The tokens XXXXXXX, YYYYYYY, and ZZZZZZZ denote arbitrary alphanumeric strings.

For example, a resistor instance name must begin with the letter R and can contain one or more characters. Hence, R, R1, RSE, ROUT, and R3AC2ZY are valid resistor names. Details of each type of device are supplied in a following section 3. Table 2.2 lists the element types available in ngspice, sorted by their first letter.

52 | CHAPTER 2. CIRCUIT DESCRIPTION
First letter | Element description | Comments, links
A | XSPICE code model | 8 analog (8.2) digital (8.4) mixed signal (8.3)
B | Behavioral (arbitrary) source | 5.1
C | Capacitor | 3.3.6
D | | 7
E | Voltage-controlled voltage source (VCVS) | linear (4.2.2), non-linear (5.2)
F | Current-controlled current source (CCCs) | linear (4.2.3)
G | Voltage-controlled current source (VCCS) | linear (4.2.1), non-linear (5.3)
H | Current-controlled voltage source (CCVS) | linear (4.2.4)
I | Current source | 4.1
J | Junction field effect transistor (JFET) | 7.4
K | Coupled (Mutual) Inductors | 3.3.12
L | Inductor | 3.3.10
M | Metal oxide field effect transistor (MOSFET) | 7.6 BSIM3 (7.6.3.3) BSIM4 (7.6.3.4)
N | Verilog-A Compact Device Models | 9
O | Lossy transmission line | 6.2
P | Coupled multiconductor line (CPL) | 6.4.2
Q | Bipolar junction transistor (BJT) | 7.3
R | Resistor | 3.3.1
S | Switch (voltage-controlled) | 3.3.15
T | Lossless transmission line | 6.1
U | Uniformly distributed RC line | 6.3*
U | Basic digital building blocks using XSPICE | 10*
V | Voltage source | 4.1
W | Switch (current-controlled) | 3.3.15
X | Subcircuit | 2.6.3
Y | Single lossy transmission line (TXL) | 6.4.1
Z | Metal semiconductor field effect transistor (MESFET) | 7.5

Table 2.2: ngspice element types

*) For a disambiguation see chapter 10.1.3.

2.4. BASIC LINES | 53

## 2.4 Basic lines

### 2.4.1 .TITLE line

Examples:

POWER AMPLIFIER CIRCUIT
* additional lines following *...

Test of CAM cell
* additional lines following
*...

The title line must be the first in the input file. Its contents are printed verbatim as the heading for each section of output.

As an alternative, you may place a .TITLE <any title> line anywhere in your input deck. The first line of your input deck will be overridden by the contents of this line following the .TITLE statement.

.TITLE line example:

****************************** * additional lines following *...
.TITLE Test of CAM cell
* additional lines following *...

will internally be replaced by

Internal input deck:

Test of CAM cell
* additional lines following *...
*TITLE Test of CAM cell
* additional lines following *...

### 2.4.2 .END Line

Examples:

.end

The .end line must always be the last in the input file. Note that the period is an integral part of the name.

54 | CHAPTER 2. CIRCUIT DESCRIPTION

### 2.4.3 Comments

General Form:

* <any comment>

Examples:

* RF=1K Gain should be 100
| * Check open-loop gain and phase margin

The asterisk in the first column indicates that this line is a comment line. Comment lines may be placed anywhere in the circuit description.

### 2.4.4 End-of-line comments

General Form:

<any command> $ <any comment> <any command> ; <any comment>

Examples:

RF2=1K $ Gain should be 100
| C1=10p ; Check open-loop gain and phase margin
.param n1=1 //new value

ngspice supports comments that begin with double characters ‘$ ’ (dollar plus space) or ‘//’. For readability you should precede each comment character with a space. ngspice will accept the single character ‘$’.
Please note that the ‘$’ character is not a valid end-of-line comment delimiter, if the PSPICE compatibility mode (12.14.5) has been chosen. Then ’$’ becomes an ordinary character.

### 2.4.5 Continuation lines

General Form:

<any command>
| + <continuation of any command> ; some comment + <further continuation of any command>

If input lines get overly long, they may be split into two or more lines (e.g. for better readability). Internally they will be merged into a single line. Each follow-up line starts with character ’+’ plus additional space. Follow-up lines have to follow immediately after each other. Endof-line comments will be ignored. Lines may also be continued by ending the line with two backslashes, as used in Unix shells. The following lines do not allow using continuation lines: .title, .lib, and .include.

2.5. .MODEL DEVICE MODELS | 55

## 2.5 .MODEL Device Models

General form:

.model mname type(pname1=pval1 pname2=pval2 ... )

Examples:

.model MOD1 npn (bf=50 is=1e-13 vbf=50)

Most simple circuit elements typically require only a few parameter values. However, some devices (semiconductor devices in particular) that are included in ngspice require many parameter values. Often, many devices in a circuit are defined by the same set of device model parameters. For these reasons, a set of device model parameters is defined on a separate .model line and assigned a unique model name. The device element lines in ngspice then refer to the model name.

For these more complex device types, each device element line contains the device name, the nodes the device is connected to, and the device model name. In addition, other optional parameters may be specified for some devices: geometric factors and an initial condition (see the following section on Transistors (7.3 to 7.6) and Diodes (7) for more details). mname in the above is the model name, and type is one of the following fifteen types:

Code | Model Type
R | Semiconductor resistor model
C | Semiconductor capacitor model
L | Inductor model
SW | Voltage controlled switch
CSW | Current controlled switch
URC | Uniform distributed RC model
LTRA | Lossy transmission line model
D | Diode model
NPN | NPN BJT model
PNP | PNP BJT model
NJF | N-channel JFET model
PJF | P-channel JFET model
NMOS | N-channel MOSFET model
PMOS | P-channel MOSFET model
NMF | N-channel MESFET model
PMF | P-channel MESFET model
VDMOS | Power MOS model

Table 2.3: Ngspice model types

Parameter values are defined by appending the parameter name followed by an equal sign and the parameter value. Model parameters that are not given a value are assigned the default values given below for each model type. Models are listed in the section on each device along with the description of device element lines. Model parameters and their default values are given in Chapt. 27.

56 | CHAPTER 2. CIRCUIT DESCRIPTION

## 2.6 .SUBCKT Subcircuits

Subcircuits consisting of ngspice elements can be defined and used similarly to device models. Subcircuits are the way ngspice implements hierarchical modeling and make circuits with repeated sections easier to represent. During parsing of a SPICE deck, each subcircuit instance is replaced by its definition using text expansion and the hierarchy is not present after input processing.

The subcircuit is defined in the input deck by a grouping of element cards delimited by the .subckt and the .ends cards (or the keywords defined by the substart and subend options (see 13.7)); the program then automatically inserts the defined group of elements wherever the subcircuit is referenced. Instances of subcircuits within a larger circuit are defined through the use of an instance card that begins with the letter ‘X’. A complete example of all three of these cards follows:

Example:

| * The following is the instance card:
*
xdiv1 10 7 0 vdivide
| * The following are the subcircuit definition cards:
*
.subckt vdivide 1 2 3
r1 1 2 10K
r2 2 3 5K
.ends

The above specifies a subcircuit with ports numbered ‘1’, ‘2’ and ‘3’:

| • Resistor ‘R1’ is connected from port ‘1’ to port ‘2’, and has value 10 kOhms.
| • Resistor ‘R2’ is connected from port ‘2’ to port ‘3’, and has value 5 kOhms.

The instance card, when placed in an ngspice deck, will cause subcircuit port ‘1’ to be equated to circuit node ‘10’, while port ‘2’ will be equated to node ‘7’ and port ‘3’ will equated to node ‘0’.

There is no limit on the size or complexity of subcircuits, and subcircuits may contain other subcircuits. An example of subcircuit usage is given in Chapt. 17.6.

### 2.6.1 .SUBCKT Line

General form:

.SUBCKT subnam N1 <N2 N3 ...>

Examples:

.SUBCKT OPAMP 1 2 3 4

2.6. .SUBCKT SUBCIRCUITS | 57

A circuit definition is begun with a .SUBCKT line. subnam is the subcircuit name, and N1, N2, ... are the external nodes, which cannot be zero. The group of element lines that immediately follow the .SUBCKT line define the subcircuit. The last line in a subcircuit definition is the .ENDS line (see below). Control lines may not appear within a subcircuit definition; however, subcircuit definitions may contain anything else, including other subcircuit definitions, device models, and subcircuit calls (see below). Note that any device models or subcircuit definitions included as part of a subcircuit definition are strictly local (i.e., such models and definitions are not known outside the subcircuit definition). Also, any element nodes not included on the .SUBCKT line are strictly local, with the exception of 0 (ground) and any other nodes that have been declared as global. If you use parameters, the .SUBCKT line will be extended (see 2.11.3).

### 2.6.2 .ENDS Line

General form:

.ENDS <SUBNAM>

Examples:

.ENDS OPAMP

The .ENDS line must be the last one for any subcircuit definition. The subcircuit name, if included, indicates which subcircuit definition is being terminated, but is not checked.

### 2.6.3 Subcircuit Calls

General form:

XYYYYYYY N1 <N2 N3 ...> SUBNAM

Examples:

X1 2 4 17 3 1 MULTI

Subcircuits are used in ngspice by specifying pseudo-elements beginning with the letter X, followed by the circuit nodes to be used in expanding the subcircuit. If you use parameters, the subcircuit call will be modified (see 2.11.3).

58 | CHAPTER 2. CIRCUIT DESCRIPTION

## 2.7 .GLOBAL

General form:

.GLOBAL nodename1 [ nodename2 ... ]

Examples:

.GLOBAL gnd vcc

Nodes defined in the .GLOBAL statement are available to all circuit and subcircuit blocks independently from any circuit hierarchy. After parsing the circuit, these nodes are accessible from top level.

## 2.8 .INCLUDE

General form:

.INCLUDE filename

Examples:

.INCLUDE /users/spice/common/bsim3-param.mod

Frequently, portions of circuit descriptions will be reused in several input files, particularly with common models and subcircuits. In any ngspice input file, the .INCLUDE line may be used to copy some other file as if that second file appeared in place of the .INCLUDE line in the original file.

If the filename is a relative path and the file is not found, it is searched for in the locations given by variable sourcepath (13.7). There is no restriction on the file name imposed by ngspice beyond those imposed by the local operating system.

## 2.9 .INCPSLT

General form:

.INCPSLT filename

Examples:

.INCPSLT /users/spice/models/OPA1641.lib

2.10. .LIB | 59

A special form of including a portion of a netlist: The included part is treated as if its compatibility mode had been set to ’pslt’, even if the main netlist has a different compatibility mode. See also chapter 12.14.4.2.

If the filename is a relative path and the file is not found, it is searched for in the locations given by variable sourcepath (13.7). There is no restriction on the file name imposed by ngspice beyond those imposed by the local operating system.

## 2.10 .LIB

General form:

.LIB filename libname

Examples:

.LIB /users/spice/common/mosfets.lib mos1

The .LIB statement allows including library descriptions into the input file. Inside the *.lib file a library libname will be selected. The statements of each library inside the *.lib file are enclosed in .LIB libname <...> .ENDL statements. The file is searched for in the same way as for .include.

If the compatibility mode (12.14) is set to ’ps’ by set ngbehavior=ps (13.7) in spinit (12.5) or .spiceinit (12.6), then a simplified syntax .LIB filename is available: a warning is issued and filename is simply included as described in Chapt. 2.8.

## 2.11 .PARAM Parametric netlists

Ngspice allows for the definition of parametric attributes in the netlists. This is an enhancement of the ngspice front-end that adds arithmetic functionality to the circuit description language.

### 2.11.1 .param line

General form:

.param <ident> = <expr> <ident> = <expr> ...

Examples:

.param pippo=5
.param po=6 pp=7.8 pap={AGAUSS(pippo, 1, 1.67)} .param pippp={pippo + pp}
.param p={pp}
.param pop=’pp+p’

60 | CHAPTER 2. CIRCUIT DESCRIPTION

This line assigns numerical values to identifiers. More than one assignment per line is possible using a separating space. Parameter identifier names must begin with an alphabetic character. The other characters must be either alphabetic, a number, or ! # $ % [ ] _ as special characters. The variables time, temper, and hertz (see 5.1.1) are not valid identifier names. Other restrictions on naming conventions apply as well, see 2.11.6.

The .param lines inside subcircuits are copied per call, like any other line. All assignments are executed sequentially through the expanded circuit. Before its first use, a parameter name must have been assigned a value. Expressions defining a parameter should be put within braces {p+p2}, or alternatively within single quotes ’AGAUSS(pippo, 1, 1.67)’. An assignment cannot be self-referential, something like .param pip = ’pip+3’ will not work.

The current ngspice version does not always need quotes or braces in expressions, especially when spaces are used sparingly. However, it is recommended to do so, as the following examples demonstrate.

.param a = 123 * 3 | b = sqrt(9) $ doesn’t work, a <= 123
.param a = ’123 * 3’ | b = sqrt(9) $ ok.
.param c = a + 123 | $ won’t work
.param c = ’a + 123’ $ ok.
.param c = a+123 | $ ok.

Parameters may also have string values, but support is limited. String-valued parameters can be defined by .param and used in the same ways as numeric parameters. The only operation on string values is concatenation and that is possible only in top-level .param assignments.

.param str1="first" str2="second"
.param both={str1}" and "str2

### 2.11.2 Brace expressions in circuit elements:

General form:

{ <expr> }

Examples:

These are allowed in .model lines and in device lines. A SPICE number is a floating point number with an optional scaling suffix, immediately glued to the numeric tokens (see Chapt. 2.11.5). Brace expressions ({..}) cannot be used to parameterize node names or parts of names. All identifiers used within an <expr> must have known values at the time when the line is evaluated, else an error is flagged.

2.11. .PARAM PARAMETRIC NETLISTS | 61

### 2.11.3 Subcircuit parameters

General form:

.subckt <identn> node node ... <ident>=<value> <ident>=<value> ...

Examples:

.subckt myfilter in out rval=100k cval=100nF

<identn> is the name of the subcircuit given by the user. node is an integer number or an identifier, for one of the external nodes. The first <ident>=<value> introduces an optional section of the line. Each <ident> is a formal parameter, and each <value> is either a SPICE number or a brace expression. Inside the .subckt ... .ends context, each formal parameter may be used like any identifier that was defined on a .param control line. The <value> parts are default values of the parameters.

The syntax of a subcircuit call (invocation) is:

General form:

X<name> node node ... <identn> <ident>=<value> <ident>=<value> ...

Examples:

X1 input output myfilter rval=1k

Here <name> is the symbolic name given to that instance of the subcircuit, <identn> is the name of a subcircuit defined beforehand. node node ... is the list of actual nodes where the subcircuit is connected. <value> is either a SPICE number or a brace expression { <expr> } .

Subcircuit example with parameters:

* Param-example
.param amplitude= 1V
*
.subckt myfilter in out rval=100k | cval=100nF
Ra in p1 | {2*rval}
Rb p1 out | {2*rval}
C1 p1 0 | {2*cval}
Ca in p2 | {cval}
Cb p2 out | {cval}
R1 p2 0 | {rval}
.ends myfilter
*
X1 input output myfilter rval=1k cval=1n V1 input 0 AC {amplitude}
.end

62 | CHAPTER 2. CIRCUIT DESCRIPTION

### 2.11.4 Symbol scope

All subcircuit and model names are considered global and must be unique. The .param symbols that are defined outside of any .subckt ... .ends section are global. Inside such a section, the pertaining params: symbols and any .param assignments are considered local: they mask any global identical names, until the .ends line is encountered. You cannot reassign to a global number inside a .subckt, a local copy is created instead. Scope nesting works up to a level of
10. For example, if the main circuit calls A that has a formal parameter xx, A calls B that has a param. xx, and B calls C that also has a formal param. xx, there will be three versions of ‘xx’ in the symbol table but only the most local one - belonging to C - is visible.

### 2.11.5 Syntax of expressions

| <expr> ( optional parts within [...] )

An expression may be one of:

<atom> where <atom> is either a spice number or an identifier <unary-operator> <atom>
<function-name> ( <expr> [ , <expr> ...] )
<atom> <binary-operator> <expr>
( <expr> )

As expected, atoms, built-in function calls and stuff within parentheses are evaluated before the other operators. The operators are evaluated following a list of precedence close to the one of the C language. For equal precedence binary ops, evaluation goes left to right. Most functions operate on real values only!

Operator | Alias | Precedence | Description
- | | 1 | unary -
! | | 1 | unary not
** | ^ | 2 | power, like pwr
* | | 3 | multiply
/ | | 3 | divide
% | | 3 | modulo
\ | | 3 | integer divide
+ | | 4 | add
- | | 4 | subtract
== | | 5 | equality
!= | <> | 5 | non-equal
<= | | 5 | less or equal
>= | | 5 | greater or equal
< | | 5 | less than
> | | 5 | greater than
&& | | 6 | boolean and
|| | | 7 | boolean or
c?x:y | | 8 | ternary operator

2.11. .PARAM PARAMETRIC NETLISTS | 63

The evaluation of the power functions ** or ^ depends on the compatibility mode (12.14.1) chosen.

Power function source code implementation:

compatmode hs: x>0 pow(x, y); x<0 pow(x, round(y)); X=0 0 compatmode lt: x>0 pow(x, y); x<0 pow(x, y)
if y is close to integer; else 0

The number zero is used to represent boolean False. Any other number represents boolean True. The result of logical operators is 1 or 0. An example input file is shown below:

Example input file with logical operators:

* Logical operators

v1or | 1 0 | {1 || 0}
v1and | 2 0 | {1 && 0}
v1not | 3 0 | {! 1}
v1mod | 4 0 | {5 % 3}
v1div | 5 0 | {5 \ 3}
v0not | 6 0 | {! 0}

.control
op
print allv
.endc

.end

64 | CHAPTER 2. CIRCUIT DESCRIPTION
Built-in function | Notes
sqrt(x) | y = sqrt(x)
sin(x), cos(x), tan(x)
sinh(x), cosh(x), tanh(x)
asin(x), acos(x), atan(x)
asinh(x), acosh(x), atanh(x)
arctan(x) | atan(x), kept for compatibility
exp(x)
ln(x), log(x)
abs(x)
nint(x) | Nearest integer, half integers towards even
int(x) | Nearest integer rounded towards 0
floor(x) | Nearest integer rounded towards -∞
ceil(x) | Nearest integer rounded towards +∞
pow(x,y) | x raised to the power of y (pow from C runtime library)
pwr(x,y) | pow(fabs(x), y)
min(x, y)
max(x, y)
sgn(x) | 1.0 for x > 0, 0.0 for x == 0, -1.0 for x < 0
ternary_fcn(x, y, z) | x ? y : z
gauss(nom, rvar, sigma) | nominal value plus variation drawn from Gaussian distribution with mean 0 and standard deviation rvar (relative to nominal), divided by sigma
agauss(nom, avar, sigma) | nominal value plus variation drawn from Gaussian distribution with mean 0 and standard deviation avar (absolute), divided by sigma
unif(nom, rvar) | nominal value plus relative variation (to nominal) uniformly distributed between +/-rvar
aunif(nom, avar) | nominal value plus absolute variation uniformly distributed between +/-avar
limit(nom, avar) | nominal value +/-avar, depending on random number in [-1, 1[ being > 0 or < 0
var(name) | returns the value of an interpreter variable, or zero if the variable does not exist. The argument is evaluated as a string expression, but used directly if that fails.
vec(name) | similar to var(), but returns the first value of a vector in the current plot, or the const plot if that fails. It may be used to access the named constants from the const plot, for example “vec(pi)”.

The scaling suffixes (any decorative alphanumeric string may follow):

2.12. .FUNC | 65
suffix | value
g | 1e9
meg | 1e6
k | 1e3
m | 1e-3
u | 1e-6
n | 1e-9
p | 1e-12
f | 1e-15

Note: there are intentional redundancies in expression syntax, e.g. x^y , x**y and pwr(x,y) all have nearly the same result.

### 2.11.6 Reserved words

In addition to the above function names and to the verbose operators ( not and or div mod ), other words are reserved and cannot be used as parameter names: or, defined, sqr, sqrt, sin, cos, exp, ln, log, log10, arctan, abs, pwr, time, temper, hertz.

### 2.11.7 A word of caution on the three ngspice expression parsers

The historical parameter notation using & as the first character of a line as equivalence to .param. is deprecated and will be removed in a coming release.

Confusion may arise in ngspice because of its multiple numerical expression features. The .param lines and the brace expressions (see 2.11.1 and 2.11.2) are evaluated in the front-end, that is, just after the subcircuit expansion. (Technically, the X lines are kept as comments in the expanded circuit so that the actual parameters can be correctly substituted). Therefore, after the netlist expansion and before the internal data setup, all number attributes in the circuit are known constants. However, there are circuit elements in Spice that accept arithmetic expressions not evaluated at this point, but only later during circuit analysis. These are the arbitrary current and voltage sources (B-sources, 5), as well as E- and G-sources and R-, L-, or C-devices. The syntactic difference is that ‘compile-time’ expressions are within braces, but ‘run-time’ expressions have no braces. To make things more complicated, the back-end ngspice scripting language accepts arithmetic/logic expressions that operate only on its own scalar or vector data sets (13.2). Please see Chapt. 2.16.

It would be desirable to have the same expression syntax, operator and function set, and precedence rules, for the three contexts mentioned above. In the current Numparam implementation, that goal is not achieved.

## 2.12 .FUNC

This keyword defines a function. The syntax of the expression is the same as for a .param (2.11.5).

66 | CHAPTER 2. CIRCUIT DESCRIPTION

General form:

.func <ident> { <expr> }
.func <ident> = { <expr> }

Examples:

.func icos(x) {cos(x) - 1} .func f(x,y) {x*y}
.func foo(a,b) = {a + b}

.func will initiate a replacement operation. After reading the input files, and before parameters are evaluated, all occurrences of the icos(x) function will be replaced by cos(x)-1. All occurrences of f(x,y) will be replaced by x*y. Function statements may be nested to a depth of t.b.d..

## 2.13 .CSPARAM

Create a constant vector (see 13.8.2) from a parameter in plot (13.3) const.

General form:

.csparam <ident> = <expr>

Examples:

.param pippo=5
.param pp=6
.csparam pippp={pippo + pp} .param p={pp}
.csparam pap=’pp+p’

In the example shown, vectors pippp, and pap are added to the constants that already reside in plot const, having length one and real values. These vectors are generated during circuit parsing and thus cannot be changed later (same as with ordinary parameters). They may be used in ngspice scripts and .control sections (see Chapt. 13).

The use of .csparam is still experimental and has to be tested. A simple usage is shown below.

* test csparam
.param TEMPS = 27
.csparam newt = {3*TEMPS}
.csparam mytemp = ’2 + TEMPS’ .control
echo $&newt $&mytemp
.endc
.end

2.14. .TEMP | 67

## 2.14 .TEMP

Sets the circuit temperature in degrees Celsius.

General form:

.temp value

Examples:

.temp 27

This card overrides the circuit temperature given in an .option line (11.1.1).

## 2.15 .IF Condition-Controlled Netlist

A simple .IF-.ELSE(IF) block allows condition-controlling of the netlist. boolean expression is any expression according to Chapt. 2.11.5 that evaluates parameters and returns a boolean 1 or 0. The netlist block in between the .if ... .endif statements may contain device instances or .model cards that are selected according to the logic condition.

68 | CHAPTER 2. CIRCUIT DESCRIPTION

General form:

.if(boolean expression)
.elseif(boolean expression) ...
.else
.endif

Example 1:

* device instance in IF-ELSE block .param ok=0 ok2=1

v1 1 0 1
R1 1 0 2

.if (ok && ok2)
R11 1 0 2
.else
R11 1 0 0.5 $ <-- selected .endif

Example 2:

* .model in IF-ELSE block
.param m0=0 m1=1

M1 1 2 3 4 N1 W=1 L=0.5

.if(m0==1)
.model N1 NMOS level=49 Version=3.1
.elseif(m1==1)
.model N1 NMOS level=49 Version=3.2.4 $ <-- selected .else
.model N1 NMOS level=49 Version=3.3.0
.endif

Nesting of .IF-.ELSE(IF)-.ENDIF blocks is possible. Several .elseif (but of course only one .else)are allowed per block (please see example ngspice/tests/regression/misc/if-elseif.cir). However some restrictions apply, as the following netlist components are not supported within the .IF-.ENDIF block: .SUBCKT, .INC, .LIB, and .PARAM.

2.16. PARAMETERS, FUNCTIONS, EXPRESSIONS, AND COMMAND SCRIPTS 69

## 2.16 Parameters, functions, expressions, and command scripts

In ngspice there are several ways to describe functional dependencies. In fact there are three independent function parsers, being active before, during, and after the simulation. So it might be due to have a few words on their interdependence.

### 2.16.1 Parameters

Parameters (Chapt. 2.11.1) and functions, either defined within the .param statement or with the .func statement (Chapt. 2.12) are evaluated before any simulation is started, that is during the setup of the input and the circuit. Therefore these statements may not contain any simulation output (voltage or current vectors), because it is simply not yet available. The syntax is described in Chapt. 2.11.5. During the circuit setup all functions are evaluated, all parameters are replaced by their resulting numerical values. Thus it will not be possible to get feedback from a later stage (during or after simulation) to change any of the parameters.

### 2.16.2 Nonlinear sources

During the simulation, the B source (Chapt. 5) and their associated E and G sources, as well as some devices (R, C, L) may contain expressions. These expressions may contain parameters from above (evaluated immediately upon ngspice start up), numerical data, predefined functions, but also node voltages and branch currents resulting from the simulation. The source or device values are continuously updated during the simulation. Therefore the sources are powerful tools to define non-linear behavior, you may even create new ‘devices’ by yourself. Unfortunately the expression syntax (see Chapt. 5.1) and the predefined functions may deviate from the ones for parameters listed in 2.11.1.

### 2.16.3 Control commands, Command scripts

Commands, as described in detail in Chapt. 13.5, may be used interactively, but also as a command script enclosed in .control ... .endc lines. The scripts may contain expressions (see Chapt. 13.2). The expressions may work upon simulation output vectors (of node voltages, branch currents), as well as upon predefined or user defined vectors and variables, and are invoked after the simulation. Parameters from 2.11.1 defined by the .param statement are not allowed in these expressions. However you may define such parameters with .csparam (2.13). Again the expression syntax (see Chapt. 13.2) will deviate from the one for parameters or B sources listed in 2.11.1 and 5.1.

If you want to use parameters from 2.11.1 inside your control script, you may use .csparam
(2.13) or apply a trick by defining a voltage source with the parameter as its value, and then have it available as a vector (e.g. after a transient simulation) with a then constant output (the parameter). A feedback from here back into parameters (2.16.1) is never possible. Also you cannot access non-linear sources of the preceding simulation. However you may start a first simulation inside your control script, then evaluate its output using expressions, change some of the element or model parameters with the alter and altermod statements (see Chapt. 13.5.3) and then automatically start a new simulation.

70 | CHAPTER 2. CIRCUIT DESCRIPTION

Expressions and scripting are powerful tools within ngspice, and we will enhance the examples given in Chapt. 17 continuously to describe these features.

# Chapter 3

# Circuit Elements and Models

Data fields that are enclosed in less-than and greater-than signs (‘< >’) are optional. All indicated punctuation (parentheses, equal signs, etc.) is optional but indicate the presence of any delimiter. Further, future implementations may require the punctuation as stated. A consistent style adhering to the punctuation shown here makes the input easier to understand. With respect to branch voltages and currents, ngspice uniformly uses the associated reference convention (current flows in the direction of voltage drop).

## 3.1 About netlists, device instances, models and model parameters

The input to ngspice is a netlist, which lists all circuit elements, their interconnects and model parameters.

71

72 | CHAPTER 3. CIRCUIT ELEMENTS AND MODELS

Netlist example of a simple bipolar amplifier:

bipolar amplifier

R3 vcc intc 10k
R1 vcc intb 68k
R2 intb 0 10k
Cout out intc 10u
Cin intb in 10u
RLoad out 0 100k
Q1 intc intb 0 BC546B

VCC vcc 0 5
Vin in 0 dc 0 ac 1 sin(0 1m 500)

.model BC546B npn ( IS=7.59E-15 VAF=73.4 BF=480 IKF=0.0962 + NE=1.2665 ISE=3.278E-15 IKR=0.03 ISC=2.00E-13 NC=1.2 NR=1 + BR=5 RC=0.25 CJC=6.33E-12 FC=0.5 MJC=0.33 VJC=0.65
+ CJE=1.25E-11 MJE=0.55 VJE=0.65 TF=4.26E-10 ITF=0.6 VTF=3 + XTF=20 RB=100 IRB=0.0001 RBM=10 RE=0.5 TR=1.50E-07)
.end

After the first line, which is always a title line only, the netlist starts. Each line here is a device instance (except for lines starting with a dot ’.’). We have simple circuit elements that consist of a single line only, e.g. resistors like R3. In its simplest implementation, the resistor model does not need any model parameters except for the resistance value (same for capacitors like Cout). Netlist lines like R3 vcc intc 10k are called instance lines, as each line is the representation of an instance of a generic model hard-coded into the ngspice simulator (here: resistor). R3 denotes the device name. Its first character R denotes a resistor. The next two tokens vcc intc are the two nodes of the resistor, 10k is the resistance value. Equal node names on different devices denote a connection between these nodes.

A more complex device is described by the instance line Q1 intc intb 0 BC546B. Q denotes a bipolar transistor, intc intb 0 are the three nodes collector, base, and emitter. BC546B is the name of a model parameter set, named after a real transistor and describing (together with the implemented bipolar transistor model) its electrical behavior. The associated model parameters are given in the line .model BC546B npn (IS=7.59E-15 ...). This is not an instance line, because starting with a dot. It contains the model parameters as supplied by the device manufacturer or by people having them extracted from the electrical behavior and data sheet (to be found e.g. on his or her web pages). BC546B is the name of the model parameter set and relates it to the device instance. npn is the type of the device. The parameters (name=value) are given in brackets.

The instance Q1... requires model parameters. For a quick test one may do without device maker’s model parameters.

Simplified bipolar transistor instance and model parameter set:

Q1 intc intb 0 defaultmod
.model defaultmod npn

3.2. GENERAL OPTIONS | 73

If you enter the bipolar transistor instance as shown above, you make use of a default model parameter set supplied by ngspice. defaultmod is an arbitrary name. This procedure models a generic bipolar transistor, not resembling any commercial device. The default parameter values may be assessed by the command showmod Q1.

You will get more information on devices, instances and models in the following chapters 3.3 to 12.

## 3.2 General options

### 3.2.1 Paralleling devices with multiplier m

When it is needed to simulate several devices of the same kind in parallel, use the ‘m’ (parallel multiplier) instance parameter available for the devices listed in Table 3.1. This multiplies the value of the element’s matrix stamp with m’s value. The netlist below shows how to correctly use the parallel multiplier:

Multiple device example:

d1 2 0 mydiode m=10
d01 1 0 mydiode
d02 1 0 mydiode
d03 1 0 mydiode
d04 1 0 mydiode
d05 1 0 mydiode
d06 1 0 mydiode
d07 1 0 mydiode
d08 1 0 mydiode
d09 1 0 mydiode
d10 1 0 mydiode

The d1 instance connected between nodes 2 and 0 is equivalent to the 10 parallel devices d01-d10 connected between nodes 1 and 0.

The following devices support the multiplier m:

74 | CHAPTER 3. CIRCUIT ELEMENTS AND MODELS
First letter | Element description
C | Capacitor
D
F | Current-controlled current source (CCCs)
G | Voltage-controlled current source (VCCS)
I | Current source
J | Junction field effect transistor (JFET)
L | Inductor
M | Metal oxide field effect transistor (MOSFET)
Q | Bipolar junction transistor (BJT)
R | Resistor
X | Subcircuit (for details see below)
Z | Metal semiconductor field effect transistor (MESFET)

Table 3.1: ngspice elements supporting multiplier ’m’

When the X line (e.g. x1 a b sub1 m=5) contains the token m=value (as shown) or m=expression, subcircuit invocation is done in a special way. If an instance line of the subcircuit sub1 contains any of the elements shown in table 3.1, then these elements are instantiated with the additional parameter m (in this example having the value 5). If such an element already has an m multiplier parameter, the element m is multiplied with the m derived from the X line. This works recursively, meaning that if a subcircuit contains another subcircuit (a nested X line), then the latter m parameter will be multiplied by the former one, and so on.

Example 1:

.param madd = 6
X1 a b sub1 m=5
.subckt sub1 a1 b1
Cs1 a1 b1 C=5p m=’madd-2’
.ends

In example 1, the capacitance between nodes a and b will be C = 5pF*(madd-2)*5 = 100pF.

Example 2:

.param madd = 4
X1 a b sub1 m=3
.subckt sub1 a1 b1
X2 a1 b1 sub2 m=’madd-2’
.ends
.subckt sub2 a2 b2
Cs2 a2 b2 3p m=2
.ends

In example 2, the capacitance between nodes a and b is C = 3pF*2*(madd-2)*3 = 36pF.

Using m may fail to correctly describe geometrical properties for real devices like MOS transistors.

3.2. GENERAL OPTIONS | 75

M1 d g s nmos W=0.3u L=0.18u m=20

is probably not be the same as

M1 d g s nmos W=6u L=0.18u

because the former may suffer from small width (or edge) effects, whereas the latter is simply a wide transistor.

### 3.2.2 Instance and model parameters

The simple device example below consists of two lines: The device is defined on the instance line, starting with Lload ...: The first letter determines the device type (an inductor in this example). Following the device name are two nodes 1 and 2, then the inductance value 1u is set. The model name ind1 is a connection to the respective model line. Finally we have a parameter on the instance line, together with its value dtemp=5. Parameters on an instance line are called instance parameters.

The model line starts with the token .model, followed by the model name, the model type and at least one model parameter, here tc1=0.001. There are complex models with more than 100 model parameters.

Lload 1 2 1u ind1 dtemp=5
.MODEL ind1 L tc1=0.001

Instance parameters are listed in each of the following device descriptions. Model parameters sometimes are given below as well, for complex models like the BSIM transistor models, they are available in the model makers documentation. (http://ngspice.sourceforge.net/literature.html) Instance parameters may also be placed in the .model line. Thus they are recognized by each device instance referring to that model. Their values may be overridden for a specific instance of a device by placing them additionally onto its instance line.

### 3.2.3 Model binning

Binning is a kind of range partitioning for geometry dependent models like MOSFET’s. The purpose is to cover larger geometry ranges (Width and Length) with higher accuracy than the model built-in geometry formulas. Each size range described by the additional model parameters LMIN, LMAX, WMIN and WMAX has its own model parameter set. These model cards are defined by a number extension, like ‘nch.1’. ngspice has an algorithm to choose the right model card by the requested W and L.

This is implemented for BSIM3 (7.6.3.3) and BSIM4 (7.6.3.4) models.

### 3.2.4 Initial conditions

Two different forms of initial conditions may be specified for some devices. The first form is included to improve the dc convergence for circuits that contain more than one stable state. If a device is specified OFF, the dc operating point is determined with the terminal voltages for that device set to zero. After convergence is obtained, the program continues to iterate to

76 | CHAPTER 3. CIRCUIT ELEMENTS AND MODELS

obtain the exact value for the terminal voltages. If a circuit has more than one dc stable state, the OFF option can be used to force the solution to correspond to a desired state. If a device is specified OFF when in reality the device is conducting, the program still obtains the correct solution (assuming the solutions converge) but more iterations are required since the program must independently converge to two separate solutions.

The .NODESET control line (see Chapt. 11.2.1) serves a similar purpose as the OFF option. The .NODESET option is easier to apply and is the preferred means to aid convergence. The second form of initial conditions are specified for use with the transient analysis. These are true ‘initial conditions’ as opposed to the convergence aids above. See the description of the .IC control line (Chapt. 11.2.2) and the .TRAN control line (Chapt. 11.3.10) for a detailed explanation of initial conditions.

## 3.3 Elementary Devices

### 3.3.1 Resistors

General form:

RXXXXXXX n+ n- <resistance|r=>value <ac=val> <m=val>
+ <scale=val> <temp=val> <dtemp=val> <tc1=val> <tc2=val> + <noisy=0|1>

Examples:

R1 1 2 100
RC1 12 17 1K
R2 5 7 1K ac=2K
RL 1 4 2K m=2

Ngspice has a fairly complex model for resistors. It can simulate both discrete and semiconductor resistors. Semiconductor resistors in ngspice means: resistors described by geometrical parameters. So, do not expect detailed modeling of semiconductor effects.

n+ and n- are the two element nodes, value is the resistance (in ohms) and may be positive or negative¹ but not zero. If value resistance 0 is given, it will be automatically set to 1e-12.

Simulating small valued resistors: If you need to simulate very small resistors (0.001 Ohm or less), you should use CCVS (transresistance). It is less
efficient but improves overall numerical accuracy. Consider a small resistance as a large conductance.

Ngspice can assign a resistor instance a different value for AC analysis, specified using the ac keyword. This value must not be zero as described above. The AC resistance is used in AC analysis only (neither Pole-Zero nor Noise). If you do not specify the ac parameter, it is defaulted to value.

Ngspice calculates the nominal resistance as

1A negative resistor modeling an active element can cause convergence problems, please avoid it.

3.3. ELEMENTARY DEVICES | 77

Rnom =

VALUE scale
m

Racnom =

ac scale
m

(3.1)

If you want to simulate temperature dependence of a resistor, you need to specify its temperature coefficients, using a .model line or as instance parameters, like in the examples below:

Examples:

RE1 1 2 800 newres dtemp=5 .MODEL newres R tc1=0.001

RE2 a b 1.4k tc1=2m tc2=1.4u

RE3 n1 n2 1Meg tce=700m

The temperature coefficients tc1 and tc2 describe a quadratic temperature dependence (see equation 1.6) of the resistance. If given in the instance line (the R... line) their values will override the tc1 and tc2 of the .model line (3.3.3). Ngspice has an additional temperature model equation 3.2 parameterized by tce given in model or instance line. If all parameters are given (quadratic and exponential) the exponential temperature model is chosen.

R(T) = R(T0)

h
1.01TCE·(T−T0)

i
(3.2)

where T is the circuit temperature, T0 is the nominal temperature, and TCE is the exponential temperature coefficients.

Instance temperature is useful even if resistance does not vary with it, since the thermal noise generated by a resistor depends on its absolute temperature. Resistors in ngspice generates two different noises: thermal and flicker. While thermal noise is always generated in the resistor, to add a flicker noise²
source you have to add a .model card defining the flicker noise parameters. It is possible to simulate resistors that do not generate any kind of noise using the noisy (or noise) keyword and assigning zero to it, as in the following example:

Example:

Rmd 134 57 1.5k noisy=0

If you are interested in temperature effects or noise equations, read the next section on semiconductor resistors.

2Flicker noise can be used to model carbon resistors.

78 | CHAPTER 3. CIRCUIT ELEMENTS AND MODELS

### 3.3.2 Semiconductor Resistors

General form:

| RXXXXXXX n+ n- <value> <mname> <l=length> <w=width> + <temp=val> <dtemp=val> <m=val> <ac=val> <scale=val>

+ <noisy = 0|1>

Examples:

RLOAD 2 10 10K
| RMOD 3 7 RMODEL L=10u W=1u

This is the more general form of the resistor presented before (3.3.1) and allows the modeling of temperature effects and for the calculation of the actual resistance value from strictly geometric information and the specifications of the process. If value is specified, it overrides the geometric information and defines the resistance. If mname is specified, then the resistance may be calculated from the process information in the model mname and the given length and width. If value is not specified, then mname and length must be specified. If width is not specified, then it is taken from the default width given in the model.

The (optional) temp value is the temperature at which this device is to operate, and overrides the temperature specification on the .option control line and the value specified in dtemp.

### 3.3.3 Semiconductor Resistor Model (R)

The resistor model consists of process-related device data that allow the resistance to be calculated from geometric information and to be corrected for temperature. The parameters available are as follows:

Name | Parameter | Units | Default | Example
TC1 | first order temperature coeff. | Ω/ ◦C | 0.0 | -
TC2 | second order temperature coeff. | Ω/ ◦C 2 | 0.0 | -
RSH | sheet resistance | Ω/□ | - | 50
DEFW | default width | m | 1e-6 | 2e-6
NARROW | narrowing due to side etching | m | 0.0 | 1e-7
SHORT | shortening due to side etching | m | 0.0 | 1e-7
TNOM | parameter measurement temperature | ◦C | 27 | 50
KF | flicker noise coefficient | | 0.0 | 1e-25
AF | flicker noise exponent | | 0.0 | 1.0
WF | flicker noise width exponent | | 1.0
LF | flicker noise length exponent | | 1.0
EF | flicker noise frequency exponent | | 1.0
R (RES) | default value if element value not given | Ω | - | 1000

The sheet resistance is used with the narrowing parameter and l and w from the resistor device to determine the nominal resistance by the formula:

3.3. ELEMENTARY DEVICES | 79

Rnom = rsh l −SHORT
w−NARROW

(3.3)

DEFW is used to supply a default value for w if one is not specified for the device. If either rsh or l is not specified, then the standard default resistance value of 1 mOhm is used. TNOM is used to override the circuit-wide value given on the .options control line where the parameters of this model have been measured at a different temperature. After the nominal resistance is calculated, it is adjusted for temperature by the formula:

R(T) = R(TNOM)

1+TC1(T −TNOM) +TC2(T −TNOM)

2

(3.4)

where R(TNOM) = Rnom|Racnom. In the above formula, ‘T’ represents the instance temperature, which can be explicitly set using the temp keyword or calculated using the circuit temperature and dtemp, if present. If both temp and dtemp are specified, the latter is ignored. Ngspice improves SPICE’s resistors noise model, adding flicker noise (¹/f) to it and the noisy (or noise) keyword to simulate noiseless resistors. The thermal noise in resistors is modeled according to the equation:

¯
i

2
R =

4kT
R
∆f | (3.5)

where ‘k’ is the Boltzmann’s constant, and ‘T’ the instance temperature.

Flicker noise model is:

¯
i

2
R f n =

KFI

AF
R
WWFL

LF f

EF ∆f | (3.6)

A small list of sheet resistances (in Ω/□) for conductors is shown below. The table represents typical values for MOS processes in the 0.5 - 1 um

range. The table is taken from: N. Weste, K. Eshraghian - Principles of CMOS VLSI Design 2nd Edition, Addison Wesley.

Material | Min. | Typ. | Max.
Inter-metal (metal1 - metal2) | 0.005 | 0.007 | 0.1
Top-metal (metal3) | 0.003 | 0.004 | 0.05
Polysilicon (poly) | 15 | 20 | 30
Silicide | 2 | 3 | 6
Diffusion (n+, p+) | 10 | 25 | 100
Silicided diffusion | 2 | 4 | 10
n-well | 1000 | 2000 | 5000

80 | CHAPTER 3. CIRCUIT ELEMENTS AND MODELS

### 3.3.4 Resistors, dependent on expressions (behavioral resistor)

General form:

RXXXXXXX n+ n- R = ’expression’ <tc1=value> <tc2=value> <noisy=0> RXXXXXXX n+ n- ’expression’ <tc1=value> <tc2=value> <noisy=0>

Examples:

R1 rr 0 r = ’V(rr) < {Vt} ? {R0} : {2*R0}’ tc1=2e-03 tc2=3.3e-06 R2 r2 rr r = {5k + 50*TEMPER}
.param rp1 = 20
R3 no1 no2 r = ’5k * rp1’ noisy=1

Expression may be an equation or an expression containing node voltages or branch currents (in the form of i(vm)) and any other terms as given for the B source and described in Chapt. 5.1. It may contain parameters (2.11.1) and the special variables time, temper, and hertz (5.1.2). An example file is given below. Small signal noise in the resistor (11.3.4) may be evaluated as white noise, depending on resistance, temperature and tc1, tc2. To enable noise calculation, add the flag noisy=1 to the instance line. As a default the behavioral resistor is noiseless.

Example input file for non-linear resistor:

Non-linear resistor
.param R0=1k Vi=1 Vt=0.5
* resistor depending on control voltage V(rr) R1 rr 0 r = ’V(rr) < {Vt} ? {R0} : {2*R0}’
* control voltage
V1 rr 0 PWL(0 0 100u {Vi})
.control
unset askquit
tran 100n 100u uic
plot i(V1)
.endc
.end

### 3.3.5 Resistor with nonlinear r2_cmc or r3_cmc models

2-terminal resistor models developed by the resistor subcommittee of the CMC are made available via the OSDI interface by loading OpenVAF-compiled Verilog-A models (see chapter 9.2 for details). The goal was to have a standard 2-terminal resistor model with standard parameter names and a standard, numerically well behaved nonlinearity model.

3.3. ELEMENTARY DEVICES | 81

### 3.3.6 Capacitors

General form:

CXXXXXXX n+ n- <value> <mname> <m=val> <scale=val> <temp=val> + <dtemp=val> <tc1=val> <tc2=val> <ic=init_condition>

Examples:

CBYP 13 0 1UF
COSC 17 23 10U IC=3V

Ngspice provides a detailed model for capacitors. Capacitors in the netlist can be specified giving their capacitance or their geometrical and physical characteristics. Following the original SPICE3 ‘convention’, capacitors specified by their geometrical or physical characteristics are called ‘semiconductor capacitors’ and are described in the next section.

In this first form n+ and n- are the positive and negative element nodes, respectively and value is the capacitance in Farads.

Capacitance can be specified in the instance line as in the examples above or in a .model line, as in the example below:

C1 15 5 cstd
C2 2 7 cstd
.model cstd C cap=3n

Both capacitors have a capacitance of 3nF.

If you want to simulate temperature dependence of a capacitor, you need to specify its temperature coefficients, using a .model line, like in the example below:

CEB 1 2 1u cap1 dtemp=5
.MODEL cap1 C tc1=0.001

The (optional) initial condition is the initial (time zero) value of capacitor voltage (in Volts). Note that the initial conditions (if any) apply only if the uic option is specified on the .tran control line.

Ngspice calculates the nominal capacitance as described below:

Cnom = value ·scale ·m | (3.7)

The temperature coefficients tc1 and tc2 describe a quadratic temperature dependence (see equation13.14) of the capacitance. If given in the instance line (the C... line) their values will override the tc1 and tc2 of the .model line (3.3.8).

82 | CHAPTER 3. CIRCUIT ELEMENTS AND MODELS

### 3.3.7 Semiconductor Capacitors

General form:

| CXXXXXXX n+ n- <value> <mname> <l=length> <w=width> <m=val> + <scale=val> <temp=val> <dtemp=val> <ic=init_condition>

Examples:

CLOAD 2 10 10P
| CMOD 3 7 CMODEL L=10u W=1u

This is the more general form of the Capacitor presented in section (3.3.6), and allows for the calculation of the actual capacitance value from strictly geometric information and the specifications of the process. If value is specified, it defines the capacitance and both process and geometrical information are discarded. If value is not specified, the capacitance is calculated from information contained model mname and the given length and width (l, w keywords, respectively).

It is possible to specify mname only, without geometrical dimensions and set the capacitance in the .model line (3.3.6).

### 3.3.8 Semiconductor Capacitor Model (C)

The capacitor model contains process information that may be used to compute the capacitance from strictly geometric information.

Name | Parameter | Units | Default | Example
CAP | model capacitance | F | 0.0 | 1e-6
CJ | junction bottom capacitance | F/m 2 | - 5e-5
CJSW | junction sidewall capacitance | F/m | - | 2e-11
DEFW | default device width | m | 1e-6 | 2e-6
DEFL | default device length | m | 0.0 | 1e-6
NARROW | narrowing due to side etching | m | 0.0 | 1e-7
SHORT | shortening due to side etching | m | 0.0 | 1e-7
TC1 | first order temperature coeff. | F/ ◦C | 0.0 | 0.001
TC2 | second order temperature coeff. | F/ ◦C 2 | 0.0 | 0.0001
TNOM | parameter measurement temperature | ◦C | 27 | 50
DI | relative dielectric constant | F/m | - | 1
THICK | insulator thickness | m | 0.0 | 1e-9

The capacitor has a capacitance computed as:

If value is specified on the instance line then

Cnom = value ·scale ·m | (3.8)

If model capacitance is specified then

3.3. ELEMENTARY DEVICES | 83
Cnom = CAP·scale ·m | (3.9)

If neither value nor CAP are specified, then geometrical and physical parameters are take into account:

C0 = CJ(l −SHORT)(w−NARROW) +2CJSW(l −SHORT+w−NARROW) (3.10)

CJ can be explicitly given on the .model line or calculated by physical parameters. When CJ is not given, is calculated as:

If THICK is not zero:

CJ =

DI ε0
THICK if DI is specified,

CJ =

εSiO2
THICK otherwise.

(3.11)

If the relative dielectric constant is not specified the one for SiO2 is used. The values of the constants are ε0 = 8.854214871e − 12F
m

and εSiO2 = 3.4531479969e − 11F
m

. The nominal capacitance is then computed as:

Cnom = C0 scalem | (3.12)

After the nominal capacitance is calculated, it is adjusted for temperature by the formula:

C(T) = C(TNOM)

1+TC1(T −TNOM) +TC2(T −TNOM)

2

(3.13)

where C(TNOM) = Cnom.

In the above formula, ‘T’ represents the instance temperature, which can be explicitly set using the temp keyword or calculated using the circuit temperature and dtemp, if present.

### 3.3.9 Capacitors, dependent on expressions (behavioral capacitor)

There are two forms for behavioral capacitors allowed:

1. Capacitance formulated expressions C = ’expression’
2. Charge formulated expressions Q = ’expression’

84 | CHAPTER 3. CIRCUIT ELEMENTS AND MODELS

General form:

CXXXXXXX n+ n- C = ’expression’ <tc1=value> <tc2=value> CXXXXXXX n+ n- ’expression’ <tc1=value> <tc2=value>

CXXXXXXX n+ n- Q = ’expression’ <tc1=value> <tc2=value>

Examples:

C1 cc 0 c = ’V(cc) < {Vt} ? {C1} : {Ch}’ tc1=-1e-03 tc2=1.3e-05 C1 a b q = ’1u*(4*atan(V(a,b)/4)*2+V(a,b))/3’

Expression may be an equation or an expression containing node voltages or branch currents (in the form of i(vm)) and any other terms as given for the B source and described in Chapt. 5.1. It may contain parameters (2.11.1) and the special variables time, temper, and hertz (5.1.2).

Example input file:

Behavioral Capacitor
.param Cl=5n Ch=1n Vt=1m Il=100n
.ic v(cc) = 0 v(cc2) = 0
* capacitor depending on control voltage V(cc) C1 cc 0 c = ’V(cc) < {Vt} ? {Cl} : {Ch}’
I1 0 1 {Il}
Exxx | n1-copy n2 | n2 cc2 | 1
Cxxx | n1-copy n2 | 1
Bxxx | cc2 n2 | I = ’(V(cc2) < {Vt} ? {Cl} : {Ch})’ * i(Exxx)
I2 n2 22 {Il}
vn2 n2 0 DC 0
* measure charge by integrating current
aint1 %id(1 cc) 2 time_count
aint2 %id(22 cc2) 3 time_count
.model time_count int(in_offset=0.0 gain=1.0 + out_lower_limit=-1e12 out_upper_limit=1e12 + limit_range=1e-9 out_ic=0.0)
.control
unset askquit
tran 100n 100u
plot v(2)
plot v(cc) v(cc2)
.endc
.end

3.3. ELEMENTARY DEVICES | 85

### 3.3.10 Inductors

General form:

LYYYYYYY n+ n- <value> <mname> <nt=val> <m=val> + <scale=val> <temp=val> <dtemp=val> <tc1=val> + <tc2=val> <ic=init_condition>

Examples:

LLINK 42 69 1UH
LSHUNT 23 51 10U IC=15.7MA

The inductor device implemented into ngspice has many enhancements over the original one.n+ and n- are the positive and negative element nodes, respectively. value is the inductance in Henry. The initial condition (a curremt through L) becomes effective when the uic parameter is set on the .tran line. Inductance can be specified in the instance line as in the examples above or in a .model line, as in the example below:

L1 15 5 indmod1
L2 2 7 indmod1
.model indmod1 L ind=3n

Both inductors have an inductance of 3nH.
The nt is used in conjunction with a .model line, and is used to specify the number of turns of the inductor. If you want to simulate temperature dependence of an inductor, you need to specify its temperature coefficients, using a .model line, like in the example below:

Lload 1 2 1u ind1 dtemp=5
.MODEL ind1 L tc1=0.001

The (optional) initial condition is the initial (time zero) value of inductor current (in Amps) that flows from n+, through the inductor, to n-. Note that the initial conditions (if any) apply only if the UIC option is specified on the .tran analysis line.

Ngspice calculates the nominal inductance as described below:

Lnom =

value scale
m

(3.14)

### 3.3.11 Inductor model

The inductor model contains physical and geometrical information that may be used to compute the inductance of some common topologies like solenoids and toroids, wound in air or other material with constant magnetic permeability.

86 | CHAPTER 3. CIRCUIT ELEMENTS AND MODELS
Name | Parameter | Units | Default | Example
IND | model inductance | H | 0.0 | 1e-3
CSECT | cross section | m 2 | 0.0 | 1e-6
DIA | coil diameter | m | 0.0 | 1e-3
LENGTH | length | m | 0.0 | 1e-2
TC1 | first order temperature coeff. | H/ ◦C | 0.0 | 0.001
TC2 | second order temperature coeff. | H/ ◦C 2 | 0.0 | 0.0001
TNOM | parameter measurement temperature | ◦C | 27 | 50
NT | number of turns | - | 0.0 | 10
MU | relative magnetic permeability | - | 1.0 | -

The inductor’s inductance is computed as follows:

If value is specified on the instance line then

Lnom =

value scale
m

(3.15)

If model inductance is specified then

Lnom =

IND scale
m

(3.16)

If neither value nor IND are specified, then geometrical and physical parameters are taken into account. In the following formulas

NT refers to both instance and model parameter (instance parameter overrides model parameter):

If LENGTH is not zero:
(
Lnom =

MU µ0 NT² π DIA²
4 LENGTH if DIA is specified,

Lnom =

MU µ0 NT² CSECT
LENGTH otherwise.

(3.17)

with µ0 = 1.25663706143592 µH
m

. DIA takes preference over CSECT. kl is the geometry correction factor according to Lundin (see D. W. Knight, (https://g3ynh.info/zdocs/magnetics/Solenoids.pdf) pp. 35-36), which is important when inductor length and diameter have the same order of magnitude. After the nominal inductance is calculated, it is adjusted for temperature by the formula

L(T) = L(TNOM)

1+TC1(T −TNOM) +TC2(T −TNOM)

2

, | (3.18)

where L(TNOM) = Lnom. In the above formula, ‘T’ represents the instance temperature, which can be explicitly set using the temp keyword or calculated using the circuit temperature and dtemp, if present.

3.3. ELEMENTARY DEVICES | 87

### 3.3.12 Coupled (Mutual) Inductors

General form:

KXXXXXXX LYYYYYYY LZZZZZZZ value

Examples:

K43 LAA LBB 0.999
KXFRMR L1 L2 0.87

LYYYYYYY and LZZZZZZZ are the names of the two coupled inductors, and value is the coefficient of coupling, K, which must be greater than 0 and less than or equal to 1. Using the ‘dot’ convention for drawing the coupled inductors, place a ‘dot’ on the first node of each inductor. If you have more than two inductors interacting, pairwise coupling is supported.

Pairwise coupling of more than two inductors:

L1 1 0 | 10u
L2 2 0 | 11u
L3 3 0 | 10u

K12 L1 L2 0.99
K23 L2 L3 0.99
K13 L1 L3 0.98

When there are more than two inductors coupled for interaction, some combinations of coupling constants are not possible physically because the magnetic fields then would violate energy conservation. ngspice checks the coupling matrix for such conditions and issues a warning.

Coupling of more than two inductors in a single K statement is supported as well. All coupling constants are then equal.

Coupling of more than two inductors in a single statement:

L1 1 0 | 10u
L2 2 0 | 11u
L3 3 0 | 10u

K123 L1 L2 L3 0.97

88 | CHAPTER 3. CIRCUIT ELEMENTS AND MODELS

### 3.3.13 Inductors, dependent on expressions (behavioral inductor)

General form:

LXXXXXXX n+ n- L = ’expression’ <tc1=value> <tc2=value> LXXXXXXX n+ n- ’expression’ <tc1=value> <tc2=value>

Examples:

L1 l2 lll L = ’i(Vm) < {It} ? {Ll} : {Lh}’ tc1=-4e-03 tc2=6e-05

Expression may be an equation or an expression containing node voltages or branch currents (in the form of i(vm)) and any other terms as given for the B source and described in Chapt. 5.1. It may contain parameters (2.11.1) and the special variables time, temper, and hertz (5.1.2).

3.3. ELEMENTARY DEVICES | 89

Example input file:

Variable inductor
.param Ll=0.5m Lh=5m It=50u Vi=2m
.ic v(int21) = 0

* variable inductor depending on control current i(Vm) L1 l2 lll L = ’i(Vm) < {It} ? {Ll} : {Lh}’
* measure current through inductor
vm lll 0 dc 0
* voltage on inductor
V1 l2 0 {Vi}

* fixed inductor
L3 33 331 {Ll}
* measure current through inductor vm33 331 0 dc 0
* voltage on inductor
V3 33 0 {Vi}

* non linear inductor (discrete setup)
F21 int21 0 B21 -1
L21 int21 0 1
B21 n1 n2 V = ’(i(Vm21) < {It} ? {Ll} : {Lh})’ * v(int21) * measure current through inductor
vm21 n2 0 dc 0
V21 n1 0 {Vi}

.control
unset askquit
tran 1u 100u uic
plot i(Vm) i(vm33)
plot i(vm21) i(vm33)
plot i(vm)-i(vm21)
.endc
.end

### 3.3.14 Capacitor or inductor with initial conditions

The simulator supports the specification of voltage and current initial conditions on capacitor and inductor models, respectively. These models are not the standard ones supplied with SPICE3, but are in fact code models that can be substituted for the SPICE models when realistic initial conditions are required. For details please refer to Chapter 8. A XSPICE deck example using these models is shown below:

*
* This circuit contains a capacitor and an inductor with

90 | CHAPTER 3. CIRCUIT ELEMENTS AND MODELS

* initial conditions on them. Each of the components
* has a parallel resistor so that an exponential decay
* of the initial condition occurs with a time constant of * 1 second.
*
a1 1 0 cap
.model cap capacitoric (c=1000uf ic=1) r1 1 0 1k
*
a2 2 0 ind
.model ind inductoric (l=1H ic=1) r2 2 0 1.0
*
.control
tran 0.01 3
plot v(1) v(2)
.endc
.end

### 3.3.15 Switches

Two types of switches are available: a voltage controlled switch (type SXXXXXX, model SW) and a current controlled switch (type WXXXXXXX, model CSW). A switching hysteresis may be defined, as well as on- and off-resistances (0 < R < ∞).

General form:

SXXXXXXX N+ N- NC+ NC- MODEL <ON><OFF> WYYYYYYY N+ N- VNAM MODEL <ON><OFF>

Examples:

s1 1 2 3 4 switch1 ON
s2 5 6 3 0 sm2 off
Switch1 1 2 10 0 smodel1
w1 1 2 vclock switchmod1
W2 3 0 vramp sm1 ON
wreset 5 6 vclck lossyswitch OFF

Nodes 1 and 2 are the nodes between which the switch terminals are connected. The model name is mandatory while the initial conditions are optional. For the voltage controlled switch, nodes 3 and 4 are the positive and negative controlling nodes respectively. For the current controlled switch, the controlling current is that through the specified voltage source. The direction of positive controlling current flow is from the positive node, through the source, to the negative node.

The instance parameters ON or OFF are required, when the controlling voltage (current) starts inside the range of the hysteresis loop (different outputs during forward vs. backward voltage or current ramp). Then ON or OFF determine the initial state of the switch.

3.3. ELEMENTARY DEVICES | 91

### 3.3.16 Switch Model (SW/CSW)

The switch model allows an almost ideal switch to be described in ngspice. The switch is not quite ideal, in that the resistance can not change from 0 to infinity, but must always have a finite positive value. By proper selection of the on and off resistances, they can be effectively zero and infinity in comparison to other circuit elements. The parameters available are shown below.

Name | Parameter | Units | Default | Switch model
VT | threshold voltage | V | 0.0 | SW
IT | threshold current | A | 0.0 | CSW
VH | hysteresis voltage | V | 0.0 | SW
IH | hysteresis current | A | 0.0 | CSW
RON | on resistance | Ω | 1.0 | SW,CSW
ROFF | off resistance | Ω | 1.0e+12 (*) | SW,CSW

(*) Or 1/GMIN, if you have set GMIN to any other value, see the .OPTIONS control line
(11.1.2) for a description of GMIN, its default value results in an off-resistance of 1.0e+12 ohms.

The use of an ideal element that is highly nonlinear such as a switch can cause large discontinuities to occur in the circuit node voltages. A rapid change such as that associated with a switch changing state can cause numerical round-off or tolerance problems leading to erroneous results or time step difficulties. The user of switches can improve the situation by taking the following steps:

- First, it is wise to set the ideal switch impedance just high or low enough to be negligible with respect to other circuit elements. Using switch impedances that are close to ‘ideal’ in all cases aggravates the problem of discontinuities mentioned above. Of course, when modeling real devices such as MOSFETS, the on resistance should be adjusted to a realistic level depending on the size of the device being modeled.
- If a wide range of ON to OFF resistance must be used in the switches (ROFF/RON > 1e+12), then the tolerance on errors allowed during transient analysis should be decreased by using the .OPTIONS control line and specifying TRTOL to be less than the default value of 7.0.
- When switches are placed around capacitors, then the option CHGTOL should also be reduced. Suggested values for these two options are 1.0 and 1e-16 respectively. These changes inform ngspice to be more careful around the switch points so that no errors are made due to the rapid change in the circuit.

92 | CHAPTER 3. CIRCUIT ELEMENTS AND MODELS

Example input file:

Switch test
.tran 2us 5ms
*switch control voltage
v1 1 0 DC 0.0 PWL(0 0 2e-3 2 4e-3 0)
*switch control voltage starting inside hysteresis window *please note influence of instance parameters ON, OFF
v2 2 0 DC 0.0 PWL(0 0.9 2e-3 2 4e-3 0.4)
*switch control current
i3 3 0 DC 0.0 PWL(0 0 2e-3 2m 4e-3 0) $ <--- switch control current *load voltage
v4 4 0 DC 2.0
*input load for current source i3
r3 3 33 10k
vm3 0 33 dc 0 $ <--- measure the current * ouput load resistors
r10 4 10 10k
r20 4 20 10k
r30 4 30 10k
r40 4 40 10k
*
s1 10 0 1 0 switch1 OFF
s2 20 0 2 0 switch1 OFF
s3 30 0 2 0 switch1 ON
.model switch1 sw vt=1 vh=0.2 ron=1 roff=10k
*
w1 40 0 vm3 wswitch1 off
.model wswitch1 csw it=1m ih=0.2m ron=1 roff=10k *
.control
run
set xbrushwidth=3
plot v(1) v(10)
plot v(10) vs v(1) retraceplot $ <-- get hysteresis loop plot v(2) v(20) $ <--- different initial values
plot v(20) vs v(2) retraceplot $ <-- get hysteresis loop
plot v(2) v(30) $ <--- different initial values
plot v(30) vs v(2) retraceplot $ <-- get hysteresis loop
plot v(40) vs vm3#branch retraceplot $ <--- current controlled switch hysteresis .endc
.end

# Chapter 4

# Voltage and Current Sources

## 4.1 Independent Sources for Voltage or Current

General form:

VXXXXXXX N+ N- <<DC> DC/TRAN VALUE> <AC <ACMAG <ACPHASE>>> + <DISTOF1 <F1MAG <F1PHASE>>> <DISTOF2 <F2MAG <F2PHASE>>>

IYYYYYYY N+ N- <<DC> DC/TRAN VALUE> <AC <ACMAG <ACPHASE>>> + <DISTOF1 <F1MAG <F1PHASE>>> <DISTOF2 <F2MAG <F2PHASE>>>

Examples:

VCC 10 0 DC 6
VIN 13 2 0.001 AC 1 SIN(0 1 1MEG)
ISRC 23 21 AC 0.333 45.0 SFFM(0 1 10K 5 1K) VMEAS 12 9
VCARRIER 1 0 DISTOF1 0.1 -90.0
VMODULATOR 2 0 DISTOF2 0.01
IIN1 1 5 AC 1 DISTOF1 DISTOF2 0.001

n+ and n- are the positive and negative nodes, respectively. Note that voltage sources need not be grounded. Positive current is assumed to flow from the positive node, through the source, to the negative node. A current source of positive value forces current to flow out of the n+ node, through the source, and into the n- node. Voltage sources, in addition to being used for circuit excitation, are the ‘ammeters’ for ngspice, that is, zero valued voltage sources may be inserted into the circuit for the purpose of measuring current. They of course have no effect on circuit operation since they represent short-circuits.

DC/TRAN is the dc and transient analysis value of the source. If the source value is zero both for dc and transient analyses, this value may be omitted. If the source value is time-invariant (e.g., a power supply), then the value may optionally be preceded by the letters DC.

The keyword AC together with its value ACMAG (and optional value ACPHASE) are required when the voltage or current source is intended to become the small signal source in an ac simulation.

93

94 | CHAPTER 4. VOLTAGE AND CURRENT SOURCES

ACMAG is the ac magnitude and ACPHASE is the ac phase. The voltage or current source then will become a reference for all nodes. All small signal node amplitude values obtained after the simulation have been divided by the reference ACMAG. A typcal ACMAG value thus may be unity. Any measured phase has been shifted by ACPHASE. If ACPHASE is omitted, a value of zero is assumed. If the source is not an ac small-signal input, the keyword AC and the ac values are to be avoided.

DISTOF1 and DISTOF2 are the keywords that specify that the independent source has distortion inputs at the frequencies F1 and F2 respectively (see the description of the .DISTO control line). The keywords may be followed by an optional magnitude and phase. The default values of the magnitude and phase are 1.0 and 0.0 respectively.

Any independent source can be assigned a time-dependent value for transient analysis. If a source is assigned a time-dependent value, the time-zero value is used for dc analysis. There are nine independent source functions:

- pulse,
- exponential,
- sinusoidal,
- piece-wise linear,
- single-frequency FM,
- AM,
- transient noise,
- random voltages or currents,
- external data (only with ngspice shared library),
- and RF port

If parameters other than source values are omitted or set to zero, the default values shown are assumed. TSTEP is the printing increment and TSTOP is the final time – see the .TRAN control line for an explanation.

### 4.1.1 Pulse

General form:

PULSE(V1 V2 TD TR TF PW PER NP)

Examples:

VIN 3 0 PULSE(-1 1 2NS 2NS 2NS 50NS 100NS 5)

4.1. INDEPENDENT SOURCES FOR VOLTAGE OR CURRENT | 95
Name | Parameter | Default Value | Units
V1 | Initial value | - | V, A
V2 | Pulsed value | - | V, A
TD | Delay time | 0.0 | sec
TR | Rise time | TSTEP | sec
TF | Fall time | TSTEP | sec
PW | Pulse width | TSTOP | sec
PER | Period | TSTOP | sec
NP | Number of Pulses *) | unlimited | -
A single pulse, without repetition count or phase offset, is described by the following table:
Time | Value
0 | V1
TD | V1
TD+TR | V2
TD+TR+PW | V2
TD+TR+PW+TF | V1
TSTOP | V1
Intermediate points are determined by linear interpolation.

*) NP set to 0 or omitted denotes unlimited pulses. If compatibility mode (see 12.14.1) set ngbehavior=xs is set in .spiceinit, the 8th parameter is the phase of the pulse signal (in degrees), which results in forward running (pos. value) or a delay (neg. value) of the pulse sequence.

### 4.1.2 Sinusoidal

General form:

SIN(VO VA FREQ TD THETA PHASE)

Examples:

VIN 3 0 SIN(0 1 100MEG 1NS 1E10)

Name | Parameter | Default Value | Units
VO | Offset | - | V, A
VA | Amplitude | - | V, A
FREQ | Frequency | 1/T STOP | Hz
TD | Delay | 0.0 | sec
THETA | Damping factor | 0.0 | 1/sec
PHASE | Phase | 0.0 | degrees
The shape of the waveform is described by the following formula:

V (t) = (
V0 | if 0 ≤ t < T D
V0+VAe | −(t−T D)T HETA sin(2π ·FREQ·(t −T D) +PHASE) if T D ≤ t < T STOP.
(4.1)

96 | CHAPTER 4. VOLTAGE AND CURRENT SOURCES

### 4.1.3 Exponential

General form:

| EXP(V1 V2 TD1 TAU1 TD2 TAU2)

Examples:

| VIN 3 0 EXP(-4 -1 2NS 30NS 60NS 40NS)
Name | Parameter | Default Value | Units
V1 | Initial value | - | V, A
V2 | pulsed value | - | V, A
TD1 | rise delay time | 0.0 | sec
TAU1 | rise time constant | TSTEP | sec
TD2 | fall delay time | TD1+TSTEP | sec
TAU2 | fall time constant | TSTEP | sec

The shape of the waveform is described by the following formula:

Let V21 = V2−V1,V12 = V1−V2:

V (t) =

V1 | if 0 ≤ t < T D1,
V1+V21
1−e

−

(t−T D1)
TAU1
| if T D1 ≤ t < T D2,
V1+V21
1−e

−

(t−T D1)
TAU1

+V12
1−e

−

(t−T D2)
TAU2
| if T D2 ≤ t < T STOP.

(4.2)

### 4.1.4 Piece-Wise Linear

General form:

PWL(T1 V1 <T2 V2 T3 V3 T4 V4 ...>) <r=value> <td=value>

Examples:

VCLOCK 7 5 PWL(0 -7 10NS -7 11NS -3 17NS -3 18NS -7 50NS -7) + r=0 td=15NS

Each pair of values (Ti

, Vi) specifies that the value of the source is Vi (in Volts or Amps) at time = Ti

. The value of the source at intermediate values of time is determined by using linear interpolation on the input values. The parameter r determines a repeat time point. If r is set to -1 or is not given, the whole sequence of values (Ti

, Vi) is issued once only, then the output stays at its final value. If r = 0, the whole sequence from time 0 to time Tn is repeated forever. If r = 10ns, the sequence between 10ns and 50ns is repeated forever. The r value has to be one of the time points T1 to T(n-1) of the PWL sequence, not the last point Tn. If td is given, the whole PWL sequence is delayed by the value of td. Please note that for now r and td are available only with the voltage source, not with the current source.

4.1. INDEPENDENT SOURCES FOR VOLTAGE OR CURRENT | 97

### 4.1.5 Single-Frequency FM

General Form:

SFFM(VO VA FM MDI FC TD PHASEM PHASEC)

Examples:

V1 12 0 SFFM(0 2 20 45 1k 1m 0 0)

Name | Parameter | Default value | Units
VO | Offset | - | V, A
VA | Amplitude | - | V, A
FM | Modulating frequency | 5/T STOP | Hz
MDI | Modulation index | 90
FC | Carrier frequency | 500/T STOP | Hz
TD | Signal delay | 0.0 | s
PHASEM | Modulation signal phase | 0.0 | degrees
PHASEC | Carrier signal phase | 0.0 | degrees

The shape of the waveform is described by the following equation:

V(t) = VO +VA·
sin(2π ·FC·(t −T D) + MDI sin(2π ·FM ·(t −T D) +PHASEM) +PHASEC) (4.3)

with t > T D, else V(t) = 0.

MDI is limited to 0 <= MDI <= FC/FM. VO and VA have to be given always.

### 4.1.6 Amplitude modulated source (AM)

General form:

AM(VO VMO VMA FM FC TD PHASEM PHASEC)

Examples:

V1 12 0 AM(0.5 2 1.8 20K 5MEG 1m)

98 | CHAPTER 4. VOLTAGE AND CURRENT SOURCES
Name | Parameter | Default value | Units
VO | Overall offset | - | V, A
VMO | Modulation signal offset | - | V, A
VMA | Modulation signal amplitude | 1 | V, A
FM | Modulation signal frequency | 5/T STOP | Hz
FC | Carrier signal frequency | 500/T STOP | Hz
TD | Overall delay | 0.0 | s
PHASEM | Modulation signal phase | 0.0 | degrees
PHASEC | Carrier signal phase | 0.0 | degrees

The shape of the waveform is described by the following equation:

V(t) = VO+ (V MO+V MA·sin(2π ·FM ·(t −T D) +PHASEM))· sin(2π ·FC·(t −T D) +PHASEC) (4.4)

with t > T D, else V(t) = 0.

VO and VMO have to be given always.

With the modulation depth, given by V MA/V MO, varied between 0 and 1, a standard amplitude modulated signal is provided. VMO then also acts as overall multiplier to the signal. On the other hand one may set VMO to 0, then obtaining a signal with double side band and suppressed carrier.

### 4.1.7 Transient noise source

General form:

TRNOISE(NA NT NALPHA NAMP RTSAM RTSCAPT RTSEMT)

Examples:

VNoiw 1 0 DC 0 TRNOISE(20n 0.5n 0 0) | $ white
VNoi1of 1 0 DC 0 TRNOISE(0 10p 1.1 12p) | $ 1/f
VNoiw1of 1 0 DC 0 TRNOISE(20 10p 1.1 12p) $ white and 1/f IALL 10 0 DC 0 trnoise(1m 1u 1.0 0.1m 15m 22u 50u)
| $ white, 1/f, RTS

Transient noise is an experimental feature allowing (low frequency) transient noise injection and analysis. See Chapt. 11.3.11 for a detailed description. NA is the Gaussian noise rms voltage amplitude, NT is the time between sample values (breakpoints will be enforced on multiples of this value). NALPHA (exponent to the frequency dependency), NAMP (rms voltage or current amplitude) are the parameters for 1/f noise, RTSAM the random telegraph signal amplitude, RTSCAPT the mean of the exponential distribution of the trap capture time, and RTSEMT its emission time mean. White Gaussian, 1/f, and RTS noise may be combined into a single statement.

4.1. INDEPENDENT SOURCES FOR VOLTAGE OR CURRENT | 99
Name | Parameter | Default value | Units
NA | Rms noise amplitude (Gaussian) | - | V, A
NT | Time step | - | sec
NALPHA | 1/f exponent | 0 < α < 2 | -
NAMP | Amplitude (1/f) | - | V, A
RTSAM | Amplitude | - | V, A
RTSCAPT | Trap capture time | - | sec
RTSEMT | Trap emission time | - | sec

If you set NT and RTSAM to 0, the noise option TRNOISE ... is ignored. Thus you may switch off the noise contribution of an individual voltage source VNOI by the command

alter @vnoi[trnoise] = [ 0 0 0 0 ] $ no noise

alter @vrts[trnoise] = [ 0 0 0 0 0 0 0] $ no noise

See Chapt. 13.5.3 for the alter command.

You may switch off all TRNOISE noise sources by setting

set notrnoise

to your .spiceinit file (for all your simulations) or into your control section in front of the next run or tran command (for this specific and all following simulations). The command

unset notrnoise

will reinstate all noise sources.

The noise generators are implemented into the independent voltage (vsrc) and current (isrc) sources.

### 4.1.8 Random voltage source

The TRRANDOM option yields statistically distributed voltage values, derived from the ngspice random number generator. These values may be used in the transient simulation directly within a circuit, e.g. for generating a specific noise voltage, but especially they may be used in the control of behavioral sources (B, E, G sources 5, voltage controllable A sources 8, capacitors 3.3.9, inductors 3.3.13, or resistors 3.3.4) to simulate the circuit dependence on statistically varying device parameters. A Monte-Carlo simulation may thus be handled in a single simulation run.

General form:

TRRANDOM(TYPE TS <TD <PARAM1 <PARAM2>>>)

Examples:

VR1 r1 0 dc 0 trrandom (2 10m 0 1) ; Gaussian with mean 0
V1 1 0 dc 0 trrandom (1 1u 0.5u 0.5 0.5) ; Uniform between 0 and 1

100 | CHAPTER 4. VOLTAGE AND CURRENT SOURCES

TYPE determines the random variates generated: 1 is uniformly distributed, 2 Gaussian, 3 exponential, 4 Poisson. TS is the duration of an individual voltage value. TD is a time delay with the output staying at the Offset or Mean value, before the random voltage values start up.

PARAM1 and PARAM2 depend on the type selected. The uniform distribution issues values in the range of ±PARAM1 around the offset PARAM2. The Gaussian distribution issues values with the standard deviation of PARAM1 around the mean PARAM2.
TYPE | description | PARAM1 | default | PARAM2 | default
1 | Uniform | Range | 1 | Offset | 0
2 | Gaussian | Standard Dev. | 1 | Mean | 0
3 | Exponential | Mean | 1 | Offset | 0
4 | Poisson | Lambda | 1 | Offset | 0

### 4.1.9 External voltage or current input

General form:

EXTERNAL

Examples:

Vex 1 0 dc 0 external
Iex i1 i2 dc 0 external <m = xx>

Voltages or currents may be set from the calling process, if ngspice is compiled as a shared library and loaded by the process. See Chapter 15 and 15.3.3.11 for an explanation.

### 4.1.10 Arbitrary Phase Sources

ngspice supports arbitrary phase independent sources that output at TIME=0.0 a value corresponding to some specified phase shift. Other versions of SPICE use the TD (delay time) parameter to set phase-shifted sources to their time-zero value until the delay time has elapsed. The ngspice phase parameter is specified in degrees and is included after the SPICE3 parameters normally used to specify an independent source. Partial examples of usage for pulse and sine waveforms are shown below:

* Phase shift is specified as final parameter
* on the independent source cards. Phase shift for both of the * following is specified as +45 degrees
*
v1 1 0 0.0 sin(0 1 1k 0 0 45.0)
r1 1 0 1k
*
v2 2 0 0.0 pulse(-1 1 0 1e-5 1e-5 5e-4 1e-3 45.0) r2 2 0 1k
*

4.2. LINEAR DEPENDENT SOURCES | 101

### 4.1.11 RF Port

A voltage source VSRC may be defined as RF Port. To do so, there are at least two more parameters required. The first is portnum (integer) which defines the VSRC as a RF Port. Portnum of all VSRCs defined as RF ports must start from 1 and count up to the number of RF ports. You cannot have duplicate portnums. Then you have Z0 (real) which defines the internal impedance. If not provided, its default value is 50Ohm. When declaring a RF ports, the VSRC now become a VSRC with Z0 Ohm in series. This extra resistor affects all simulations.

General form:

DC 0 AC 1 portnum n1 <z0 n2>

Examples:

V1 in 0 dc 0 ac 1 portnum 1 z0 100

At least two ports are required for the S-parameter simulation with the command .sp (11.3.8). If portnum is not provided, the voltage source VRSC behaves as normal.

## 4.2 Linear Dependent Sources

Ngspice allows circuits to contain linear dependent sources characterized by any of the four equations

i = gv | v = ev | i = f i | v = hi

where g, e, f , and h are constants representing transconductance, voltage gain, current gain, and transresistance, respectively. Non-linear dependent sources for voltages or currents (B, E,
G) are described in Chapt. 5.

### 4.2.1 Gxxxx: Linear Voltage-Controlled Current Sources (VCCS)

General form:

GXXXXXXX N+ N- NC+ NC- VALUE <m=val>

Examples:

G1 2 0 5 0 0.1

n+ and n- are the positive and negative nodes, respectively. Current flow is from the positive node, through the source, to the negative

node. nc+ and nc- are the positive and negative controlling nodes, respectively. value is the transconductance (in mhos). m is an optional multiplier to the output current. val may be a numerical value or an expression according to 2.11.5 containing references to other parameters. Instance parameters are listed in chapt. 27.3.6.

102 | CHAPTER 4. VOLTAGE AND CURRENT SOURCES

### 4.2.2 Exxxx: Linear Voltage-Controlled Voltage Sources (VCVS)

General form:

| EXXXXXXX N+ N- NC+ NC- VALUE

Examples:

E1 2 3 14 1 2.0

n+ is the positive node, and n- is the negative node. nc+ and nc- are the positive and negative controlling nodes, respectively. value is the voltage gain. Instance parameters are listed in chapt. 27.3.7.

### 4.2.3 Fxxxx: Linear Current-Controlled Current Sources (CCCS)

General form:

| FXXXXXXX N+ N- VNAM VALUE <m=val>

Examples:

F1 13 5 VSENS 5 m=2

n+ and n- are the positive and negative nodes, respectively. Current flow is from the positive node, through the source, to the negative node. vnam is the name of a voltage source through which the controlling current flows. The direction of positive controlling current flow is from the positive node, through the source, to the negative node of vnam. value is the current gain. m is an optional multiplier to the output current. Instance parameters are listed in chapt. 27.3.4.

### 4.2.4 Hxxxx: Linear Current-Controlled Voltage Sources (CCVS)

General form:

HXXXXXXX N+ N- VNAM VALUE

Examples:

HX 5 17 VZ 0.5K

n+ and n- are the positive and negative nodes, respectively. vnam is the name of a voltage source through which the controlling current flows. The direction of positive controlling current flow is from the positive node, through the source, to the negative node of vnam. value is the transresistance (in ohms). Instance parameters are listed in chapt. 27.3.5.

4.2. LINEAR DEPENDENT SOURCES | 103

### 4.2.5 Polynomial Source Compatibility

Dependent polynomial sources available in SPICE2G6 are fully supported in ngspice using the XSPICE extension (21.1). The form used to specify these sources is shown in Table 4.1. For details on its usage please see Chapt. 5.5.

Dependent Polynomial Sources
Source Type | Instance Card
POLYNOMIAL VCVS | EXXXXXXX N+ N- POLY(ND) NC1+ NC1- P0 (P1...)
POLYNOMIAL VCCS | GXXXXXXX N+ N- POLY(ND) NC1+ NC1- P0 (P1...)
POLYNOMIAL CCCS | FXXXXXXX N+ N- POLY(ND) VNAM1 !VNAM2...? P0 (P1...)
POLYNOMIAL CCVS | HXXXXXXX N+ N- POLY(ND) VNAM1 !VNAM2...? P0 (P1...)

Table 4.1: Dependent Polynomial Sources

104 | CHAPTER 4. VOLTAGE AND CURRENT SOURCES

# Chapter 5

# Non-linear Dependent Sources (Behavioral Sources)

The non-linear dependent sources B ( see Chapt. 5.1), E (see 5.2), G see (5.3) described in this chapter allow the generation of voltages or currents that result from evaluating a mathematical expression. Internally E and G sources are converted to the more general B source. All three sources may be used to introduce behavioral modeling and analysis.

## 5.1 Bxxxx: Nonlinear dependent source (ASRC)

### 5.1.1 Syntax and usage

General form:

BXXXXXXX n+ n- <i=expr> <v=expr> <tc1=value> <tc2=value> + <temp=value> <dtemp=value>

Examples:

B1 0 1 I=cos(v(1))+sin(v(2))
B2 0 1 V=ln(cos(log(v(1,2)^2)))-v(3)^4+v(2)^v(1) B3 3 4 I=17
B4 3 4 V=exp(pi^i(vdd))
B5 2 0 V = V(1) < {Vlow} ? {Vlow} :
+ V(1) > {Vhigh} ? {Vhigh} : V(1)

n+ is the positive node, and n- is the negative node. The values of the V and I parameters determine the voltages and currents across and through the device, respectively. If I is given then the device is a current source, and if V is given the device is a voltage source. One and only one of these parameters must be given. All instance parameters are listed in chapter 27.3.1.

A simple model is implemented for temperature behavior by the formula:

| I(T) = I(TNOM)
| 1+TC1(T −TNOM) +TC2(T −TNOM)

2

(5.1)

105

106 CHAPTER 5. NON-LINEAR DEPENDENT SOURCES (BEHAVIORAL SOURCES)

or

V(T) = V(TNOM)

1+TC1(T −TNOM) +TC2(T −TNOM)

2

(5.2)

In the above formula, ‘T’ represents the instance temperature, which can be explicitly set using the temp keyword or calculated using the circuit temperature and dtemp, if present. If both temp and dtemp are specified, the latter is ignored.

The small-signal AC behavior of the nonlinear source is a linear dependent source (or sources) with a proportionality constant equal to the derivative (or derivatives) of the source at the DC operating point. The expressions given for V and I may be any function of voltages and currents through voltage sources in the system.

The following functions of a single real variable are defined:

Trigonometric functions: cos, sin, tan, acos, asin, atan

Hyperbolic functions: cosh, sinh, acosh, asinh, atanh

Exponential and logarithmic: exp, ln, log, log10 (ln, log with base e, log10 with base 10)

Other: abs, sqrt, u, u2, uramp, floor, ceil, i

Functions of two variables are min, max, pow, **, pwr, ^

Functions of three variables are a ? b:c

For convergence reasons the ‘exp’ function has a limit of 14 for its argument, beyond that value it will increase linearily. The function ‘u’ is the unit step function, with a value of one for arguments greater than zero, a value of 0.5 at zero, and a value of zero for arguments less than zero. The function ‘u2’ returns a value of zero for arguments less than zero, one for arguments greater than one and assumes the value of the argument between these limits. The function ‘uramp’ is the integral of the unit step: for an input x, the value is zero if x is less than zero, or, if x is greater than or equal to zero, the value is x. These three functions are useful in synthesizing piece-wise non-linear functions, though convergence may be adversely affected.

The function i(xyz) returns the current through the first node of device instance xyz.

The following standard operators are defined: +, -, *, /, ^, unary -

Logical operators are !=, <>, >=, <=, ==, >, <, ||, &&, ! | .
A ternary function is defined as a ? | b : | c , which means IF a, THEN b, ELSE c. Be
sure to place a space in front of ‘?’ to allow the parser distinguishing it from other tokens.

The B source functions pow, **, ^, and pwr need some special care to avoid undefined regions in x1, as they differ from the common mathematical usage (and from the functions depicted in chapt. 2.11.5).

The functions y = pow(x1,x2), x1**x2, and x1^x2 , all of them describing y = x1

| | x2 , resolve
to the following:

y = pow(fabs(x1), x2)

5.1. BXXXX: NONLINEAR DEPENDENT SOURCE (ASRC) | 107

pow in the preceding line is the standard C math library function.

The function y = pwr(x1,x2) resolves to

if (x1 < 0.0)
y = (-pow(-x1, x2));
else
y = (pow(x1, x2));

pow here again is the standard C math library function.

Example: Ternary function

* B source test Clamped voltage source
* C. P. Basso "Switched-mode power supplies", New York, 2008 .param Vhigh = 4.6
.param Vlow = 0.4
Vin1 1 0 DC 0 PWL(0 0 1u 5)
Bcl 2 0 V = V(1) < Vlow ? Vlow : V(1) > Vhigh ? Vhigh : V(1) .control
unset askquit
tran 5n 1u
plot V(2) vs V(1)
.endc
.end

If the argument of log, ln, or sqrt becomes less than zero, the absolute value of the argument is used. If a divisor becomes zero or the argument of log or ln becomes zero, an error will result. Other problems may occur when the argument for a function in a partial derivative enters a region where that function is undefined.

Parameters may be used like {Vlow} shown in the example above. Parameters will be evaluated upon set up of the circuit, vectors like V(1) will be evaluated during the simulation.

To get time into the expression you can integrate the current from a constant current source with a capacitor and use the resulting voltage (don’t forget to set the initial voltage across the capacitor).

Non-linear resistors, capacitors, and inductors may be synthesized with the nonlinear dependent source. Nonlinear resistors, capacitors and inductors are implemented with their linear counterparts by a change of variables implemented with the nonlinear dependent source. The following subcircuit will implement a nonlinear capacitor:

108 CHAPTER 5. NON-LINEAR DEPENDENT SOURCES (BEHAVIORAL SOURCES)

Example: Non linear capacitor

.Subckt nlcap pos neg
* Bx: calculate f(input voltage) Bx 1 0 v = f(v(pos,neg))
* Cx: linear capacitance
Cx 2 0 1
* Vx: Ammeter to measure current into the capacitor Vx 2 1 DC 0Volts
* Drive the current through Cx back into the circuit Fx pos neg Vx 1
.ends

Example for f(v(pos,neg)):

Bx 1 0 V = v(pos,neg)*v(pos,neg)

Non-linear resistors or inductors may be described in a similar manner. An example for a nonlinear resistor using this template is shown below.

Example: Non linear resistor

* use of ’hertz’ variable in nonlinear resistor *.param rbase=1k
* some tests
B1 | 1 0 | V = hertz*v(33)
B2 | 2 0 V = v(33)*hertz
b3 | 3 0 V = 6.283e3/(hertz+6.283e3)*v(33)
V1 33 0 DC 0 AC 1
*** Translate R1 10 0 R=’1k/sqrt(HERTZ)’ to B source *** .Subckt nlres pos neg rb=rbase
* Bx: calculate f(input voltage)
Bx | 1 | 0 | v = -1 / {rb} / sqrt(HERTZ) * v(pos, neg)
* Rx: linear resistance
Rx | 2 | 0 | 1

5.1. BXXXX: NONLINEAR DEPENDENT SOURCE (ASRC) | 109

Example: Non linear resistor (continued)

* Vx: Ammeter to measure current into the resistor
Vx | 2 | 1 | DC 0Volts
* Drive the current through Rx back into the circuit
Fx | pos | neg | Vx 1
.ends
Xres 33 10 nlres rb=1k
*Rres 33 10 1k
Vres 10 0 DC 0
.control
define check(a,b) vecmax(abs(a - b)) ac lin 10 100 1k
* some checks
print v(1) v(2) v(3)
if check(v(1), frequency) < 1e-12 echo "INFO: ok"
end
plot vres#branch
.endc
.end

### 5.1.2 Special B-Source Variables time, temper, hertz

The special variables time and temper are available in a transient analysis, reflecting the actual simulation time and circuit temperature. temper returns the circuit temperature, given in degree C (see 2.14). The variable hertz is available in an AC analysis. time is zero in the AC analysis, hertz is zero during transient analysis. Using the variable hertz may cost some CPU time if you have a large circuit, because for each frequency the operating point has to be determined before calculating the AC response.

### 5.1.3 par(’expression’)

The B source syntax may also be used in output lines like .plot as algebraic expressions for output (see Chapt.11.6.6 ).

### 5.1.4 Piecewise Linear Function: pwl

Both B source types may contain a piece-wise linear dependency of one network variable: Example: pwl_current

Bdio 1 0 I = pwl(v(A), 0,0, 33,10m, 100,33m, 200,50m)

v(A) is the independent variable x. Each pair of values following describes the x,y functional relation: In this example at node A voltage of 0V the current of 0A is generated - next pair gives 10mA flowing from ground to node 1 at 33V on node A and so forth.

110 CHAPTER 5. NON-LINEAR DEPENDENT SOURCES (BEHAVIORAL SOURCES)

The same is possible for voltage sources:

Example: pwl_voltage

Blimit b 0 V = pwl(v(1), -4,0, -2,2, 2,4, 4,5, 6,5)

Monotony of the independent variable in the pwl definition is checked - non-monotonic x entries will stop the program execution. v(1) may be replaced by a controlling current source, or it may be replaced by time (for transient simulations). v(1) may also be replaced by an expression, e.g. −2∗i(Vin). The value pairs may also be parameters, and have to be predefined by a .param statement. An example for the pwl function using all of these options is shown below.

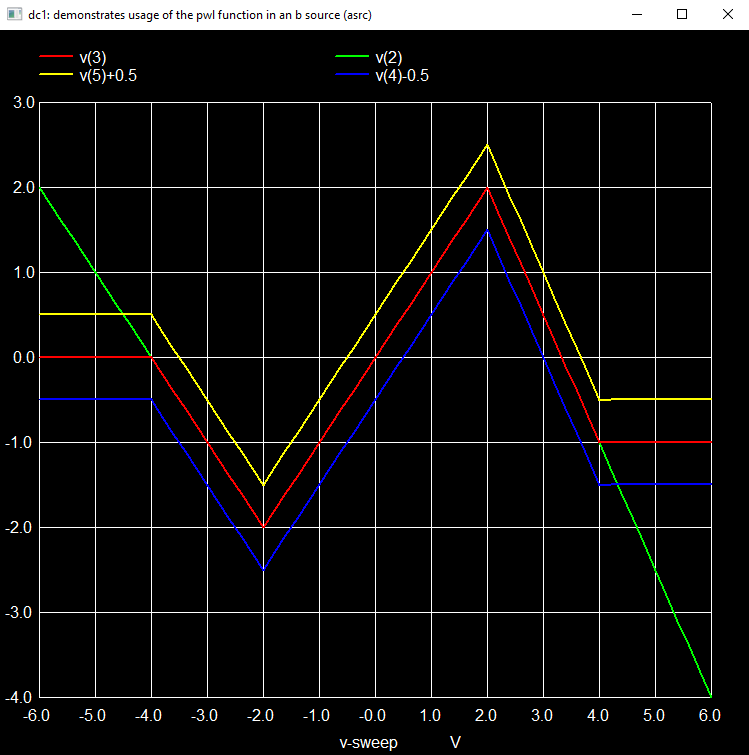
[picture p70: figure]

Figure 5.1: pwl (piece-wise linear) B source

5.1. BXXXX: NONLINEAR DEPENDENT SOURCE (ASRC) | 111

Example: pwl function in B source

Demonstrates usage of the pwl function in an B source (ASRC) * Also emulates the TABLE function with limits

.param x0=-4 y0=0
.param x1=-2 y1=2
.param x2=2 y2=-2
.param x3=4 y3=1
.param xx0=x0-1
.param xx3=x3+1

Vin ctrl 0 DC=0V
R1 ctrl 0 2

* no limits outside of the tabulated x values
* (continues linearily)
Btest2 2 0 I = pwl(v(ctrl),’x0’,’y0’,’x1’,’y1’,’x2’,’y2’, + ’x3’,’y3’)

* like TABLE function with limits:
Btest3 3 0 I = (v(ctrl) < ’x0’) ? ’y0’ : (v(ctrl) < ’x3’) + ? pwl(v(1),’x0’,’y0’,’x1’,’y1’,’x2’,’y2’,’x3’,’y3’) : ’y3’

* more efficient and elegant TABLE function with limits *(voltage controlled):
Btest4 4 0 I = pwl(v(ctrl),
+ ’xx0’,’y0’, ’x0’,’y0’,
+ | | | ’x1’,’y1’,
+ | | | ’x2’,’y2’,
+ | | | ’x3’,’y3’, ’xx3’,’y3’)
*
* more efficient and elegant TABLE function with limits * (controlled by current):
Btest5 5 0 I = pwl(-2*i(Vin),
+ ’xx0’,’y0’, ’x0’,’y0’,
+ | | | ’x1’,’y1’,
+ | | | ’x2’,’y2’,
+ | | | ’x3’,’y3’, ’xx3’,’y3’)

Rint2 2 0 1
Rint3 3 0 1
Rint4 4 0 1
Rint5 5 0 1
.control
dc | Vin | -6 6 | 0.2
plot v(2) v(3) v(4)-0.5 v(5)+0.5 .endc

.end

112 CHAPTER 5. NON-LINEAR DEPENDENT SOURCES (BEHAVIORAL SOURCES)

One characteristic to note: What happens when the controlling input (V(1) or −2 ∗ i(Vin)) is outside of the given limits, e.g. smaller than x0 or larger than x3 in the example given above? New y values outside of the given range will be determined by adding x,y pairs calculated by extending the slope of the output curve, e.g. with (y3−y2)/(x3−x2), as seen with v(2) from example Btest2. If you want to limit the function, keeping the last y value, e.g. y3, you have to add another point (x,y pair) with slightly extended x and y kept constant, e.g. x3+1,y3.

This gets important when we are for example using a behavioral resistor with pwl. In the example below, RR1 quickly moves towards (and beyond) 0, which is unphysical and leads the transient simulation to fail, because the current through RR1 is unbounded. RR2 with its limit given by the 15.1ms,1 couple avoids such malfunctioning.

Example: pwl function in behavioral resistor

* pwl for behavioral R, transient sim
VU1 3 0 DC 9
RR1 3 0 R = pwl(time, 0,1, 7m,1, 8m,1.19, 14m,1.19, 15m,1) RR2 3 0 R = pwl(time, 0,1, 7m,1, 8m,1.19, 14m,1.19, 15m,1, + 15.1m,1)

.tran 100u 20m 0
.probe alli

.control
option noinit
run
display
set xbrushwidth=2
plot rr1#branch rr2#branch ylimit 7 17 .endc

.end

## 5.2 Exxxx: non-linear voltage source

### 5.2.1 VOL

General form:

EXXXXXXX n+ n- vol=’expr’

Examples:

E41 4 0 vol = ’V(3)*V(3)-Offs’

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

5.2. EXXXX: NON-LINEAR VOLTAGE SOURCE | 113
5.1. It may contain parameters (2.11.1) and the special variables time, temper, hertz (5.1.2). ’ or { } may be used to delimit the function.

### 5.2.2 VALUE

Optional syntax:

EXXXXXXX n+ n- value={expr}

Examples:

E41 4 0 value = {V(3)*V(3)-Offs}

The ’=’ sign is optional.

### 5.2.3 TABLE

Data may be entered from the listings of a data table similar to the pwl B-Source (5.1.4). Data are grouped into x, y pairs. Expression may be an equation or an expression containing node voltages or branch currents (in the form of i(vm)) and any other terms as given for the B source and described in Chapt. 5.1. It may contain parameters (2.11.1). ’ or { } may be used to delimit the function. Expression delivers the x-value, which is used to generate a corresponding y-value according to the tabulated value pairs, using linear interpolation. If the x-value is below x0 , y0 is returned, above x2 y2 is returned (limiting function). The value pairs have to be real numbers, parameters are not allowed.

Syntax for data entry from table:

Exxx n1 n2 TABLE {expression} = (x0, y0) (x1, y1) (x2, y2)

Example (simple comparator):

ECMP 11 0 TABLE {V(10,9)} = (-5mV, 0V) (5mV, 5V)

An ’=’ sign may follow the keyword TABLE.

### 5.2.4 POLY

see E-Source at Chapt. 5.5.

### 5.2.5 LAPLACE

Currently ngspice does not offer a direct E-Source element with the LAPLACE option. There is however a XSPICE code model equivalent called s_xfer (see Chapt. 8.2.18), which you

114 CHAPTER 5. NON-LINEAR DEPENDENT SOURCES (BEHAVIORAL SOURCES)

may invoke manually. The XSPICE option has to be enabled (28.1). AC (11.3.1) and transient analysis (11.3.10) is supported.

The following E-Source:

ELOPASS 4 0 LAPLACE {V(1)}
+ | {5 * (s/100 + 1) / (s^2/42000 + s/60 + 1)}

may be replaced by:

AELOPASS 1 int_4 filter1
.model filter1 s_xfer(gain=5
+ | num_coeff=[{1/100} 1]
+ | den_coeff=[{1/42000} {1/60} 1]
+ | int_ic=[0 0])
ELOPASS 4 0 int_4 0 1

where you have the voltage of node 1 as input, an intermediate output node int_4 and an Esource as buffer to keep the name ‘ELOPASS’ available if further processing is required.

If the controlling expression is more complex than just a voltage node, you may add a B-Source
(5.1) for evaluating the expression before entering the A-device.

E-Source with complex controlling expression:

ELOPASS 4 0 LAPLACE {V(1)*v(2)} {10 / (s/6800 + 1)}

may be replaced by:

BELOPASS int_1 0 V=V(1)*v(2) AELOPASS int_1 int_4 filter1
.model filter1 s_xfer(gain=10
+ | num_coeff=[1]
+ | den_coeff=[{1/6800} 1]
+ | int_ic=[0])
ELOPASS 4 0 int_4 0 1

### 5.2.6 FREQ

Currently ngspice does not offer a direct E-Source element with the FREQ option but it is implemented by a XSPICE code model equivalent called xfer (see 8.2.19) that is automatically invoked by rewriting the netlist. The XSPICE option has to be enabled (28.1) and only AC
(11.3.1) analysis is supported.

5.3. GXXXX: NON-LINEAR CURRENT SOURCE | 115

This E-Source:

EXFER 1 0 FREQ {V(20,21)}= DB +(1.000000e+07Hz, 1.633257e-07, -1.859873e+01) +(1.025641e+08Hz, -4.165672e+00, -4.076855e+02)
+(2.000000e+08Hz, -2.798303e-05, -7.519027e+02)

produces a complex voltage determined by multiplying an input differential voltage (v(20, 21)) by a complex-valued PWL function of the simulation frequency (transfer function). The DB keyword indicates that the second column is gain in db and the third is phase in degrees. Alternative keywords are MAG (linear gain), RAD (phase in radians), DEG (phase in degrees, already the default) or R_I (real and imaginary parts).

### 5.2.7 AND/OR/NAND/NOR

This form of E-source provides simple behavioural implementations of basic logic gates with analog inputs and output. It is implemented by a XSPICE code model called multi_input_pwl (see 8.2.10) that is automatically invoked by rewriting the netlist. The XSPICE option has to be enabled (28.1).

This E-Source:

EAND out1 out0 and(2) in1 0 in2 0 (0.5, 0) (2.8, 3.3)

produces a differential output voltage determined by selecting the smallest of any number of differential input voltages, and applying a PWL output function. Here “and(2)” determines the logic function and number of PWL points: output is zero for minimum input voltage less than 0.5 and 3.3 for inputs greater than 2.8, with a linear ramp between. The other three functions are similar: “or” selects the maximum input and “nand/nor” reverse the order of PWL points. Only two points are supported.

An example circuit can be found at examples/digital/compare/adder_esource.cir.

## 5.3 Gxxxx: non-linear current source

### 5.3.1 CUR

General form:

GXXXXXXX n+ n- cur=’expr’ <m=val>

Examples:

G51 55 225 cur = ’V(3)*V(3)-Offs’

116 CHAPTER 5. NON-LINEAR DEPENDENT SOURCES (BEHAVIORAL SOURCES)

Expression may be an equation or an expression containing node voltages or branch currents (in the form of i(vm)) and any other terms as given for the B source and described in Chapt.
5.1. It may contain parameters (2.11.1) and special variables (5.1.2). m is an optional multiplier to the output current. val may be a numerical value or an expression according to 2.11.5 containing only references to other parameters (no node voltages or branch currents!), because it is evaluated before the simulation commences.

### 5.3.2 VALUE

Optional syntax:

GXXXXXXX n+ n- value=’expr’ <m=val>

Examples:

G51 55 225 value = ’V(3)*V(3)-Offs’

The ’=’ sign is optional.

### 5.3.3 TABLE

A data entry by a tabulated listing is available with syntax similar to the E-Source (see Chapt. 5.2.3).

Syntax for data entry from table:

Gxxx n1 n2 TABLE | {expression} =
+ | (x0, y0) (x1, y1) (x2, y2) <m=val>

Example (simple comparator with current output and voltage control):

GCMP 0 11 TABLE {V(10,9)} = (-5MV, 0V) (5MV, 5V)
R 11 0 1k

m is an optional multiplier to the output current. val may be a numerical value or an expression according to 2.11.5 containing only references to other parameters (no node voltages or branch currents!), because it is evaluated before the simulation commences. An ’=’ sign may follow the keyword TABLE.

### 5.3.4 POLY

see E-Source at Chapt. 5.5.

### 5.3.5 LAPLACE

See E-Source, Chapt. 5.2.5 , for an equivalent code model replacement.

5.4. DEBUGGING A BEHAVIORAL SOURCE | 117

### 5.3.6 FREQ

See E-Source, Chapt.5.2.6 , for an equivalent code model replacement.

### 5.3.7 Example

An example file is given below.

Example input file:

VCCS, VCVS, non-linear dependency .param Vi=1
.param Offs=’0.01*Vi’
* VCCS depending on V(3)
B21 int1 0 V = V(3)*V(3)
G1 21 22 int1 0 1
* measure current through VCCS vm 22 0 dc 0
R21 21 0 1
* new VCCS depending on V(3) G51 55 225 cur = ’V(3)*V(3)-Offs’ * measure current through VCCS vm5 225 0 dc 0
R51 55 0 1
* VCVS depending on V(3)
B31 int2 0 V = V(3)*V(3)
E1 1 0 int2 0 1
R1 1 0 1
* new VCVS depending on V(3) E41 4 0 vol = ’V(3)*V(3)-Offs’ R4 4 0 1
* control voltage
V1 3 0 PWL(0 0 100u {Vi})
.control
unset askquit
tran 10n 100u uic
plot i(E1) i(E41)
plot i(vm) i(vm5)
.endc
.end

## 5.4 Debugging a behavioral source

The B, E, G, sources and the behavioral R, C, L elements are powerful tools to set up user defined models. Unfortunately debugging these models is not very comfortable.

118 CHAPTER 5. NON-LINEAR DEPENDENT SOURCES (BEHAVIORAL SOURCES)

Example input file with bug (log(-2)):

B source debugging

V1 1 0 1
V2 2 0 -2

E41 4 0 vol = ’V(1)*log(V(2))’

.control
tran 1 1
.endc

.end

The input file given above results in an error message:

Error: -2 out of range for log

In this trivial example, the reason and location for the bug is obvious. However, if you have several equations using behavioral sources, and several occurrences of the log function, then debugging is nearly impossible.

However, if the variable ngdebug (see 13.7) is set (e.g. in file .spiceinit), a more distinctive error message is issued that (after some closer investigation) will reveal the location and value of the buggy parameter.

Detailed error message for input file with bug (log(-2)):

Error: -2 out of range for log calling PTeval, tree =
(v0) * (log (v1))
d / d v0 : log (v1)
d / d v1 : (v0) * ((0.434294) / (v1)) values: var0 = 1
var1 = -2

If variable strict_errorhandling (see 13.7) is set, ngspice exits after this message. If not, gmin and source stepping may be started, typically without success.

## 5.5 POLY Sources

Polynomial sources are only available when the XSPICE option (see Chapt. 28) is not disabled.

5.5. POLY SOURCES | 119

### 5.5.1 E voltage source, G current source

General form:

EXXXX N+ N- POLY(ND) NC1+ NC1- (NC2+ NC2-...) P0 (P1...)

Example:

ENONLIN 100 101 POLY(2) 3 0 4 0 0.0 13.6 0.2 0.005

POLY(ND) Specifies the number of dimensions of the polynomial. The number of pairs of controlling nodes must be equal to the number of dimensions.

(N+) and (N-) nodes are output nodes. Positive current flows from the (+) node through the source to the (-) node.

The <NC1+> and <NC1-> are in pairs and define a set of controlling voltages. A particular node can appear more than once, and the output and controlling nodes need not be different.

The example yields a voltage output controlled by two input voltages v(3,0) and v(4,0). Four polynomial coefficients are given. The equivalent function to generate the output is:

0 + 13.6 * v(3) + 0.2 * v(4) + 0.005 * v(3) * v(3)

Generally you will set the equation according to

POLY(1) y = p0 + p1*X1 | + p2*X1*X1 | + p3*X1*X1*X1 + ...
POLY(2) y = p0 + p1*X1 | + p2*X2 +
+ p3*X1*X1 | + p4*X2*X1 | + p5*X2*X2 | +
+ p6*X1*X1*X1 | + p7*X2*X1*X1 + p8*X2*X2*X1 +
+ p9*X2*X2*X2 | + ...
POLY(3) y = p0 + p1*X1 | + p2*X2 | + p3*X3 | +
+ p4*X1*X1 + p5*X2*X1 + p6*X3*X1 +
+ p7*X2*X2 + p8*X2*X3 + p9*X3*X3 + ...

where X1 is the voltage difference of the first input node pair, X2 of the second pair and so on. Keeping track of all polynomial coefficient is rather tedious for large polynomials.

### 5.5.2 F voltage source, H current source

General form:

FXXXX N+ N- POLY(ND) V1 (V2 V3 ...) P0 (P1...)

Example:

FNONLIN 100 101 POLY(2) VDD Vxx 0 0.0 13.6 0.2 0.005

120 CHAPTER 5. NON-LINEAR DEPENDENT SOURCES (BEHAVIORAL SOURCES)

POLY(ND) Specifies the number of dimensions of the polynomial. The number of controlling sources must be equal to the number of dimensions.

(N+) and (N-) nodes are output nodes. Positive current flows from the (+) node through the source to the (-) node.

V1 (V2 V3 ...) are the controlling voltage sources. Control variable is the current through these sources.

P0 (P1...) are the coefficients, as have been described in 5.5.1.

# Chapter 6

# Transmission Lines

Ngspice implements both the original SPICE3f5 transmission lines models and the one introduced with KSPICE. The latter provide an improved transient analysis of lossy transmission lines. Unlike SPICE models that use the state-based approach to simulate lossy transmission lines, KSPICE simulates lossy transmission lines and coupled multiconductor line systems using the recursive convolution method. The impulse response of an arbitrary transfer function can be determined by deriving a recursive convolution from the Pade approximations of the function. We use this approach for simulating each transmission line’s characteristics and each multiconductor line’s modal functions. This method of lossy transmission line simulation has been proved to give a speedup of one to two orders of magnitude over SPICE3f5.

## 6.1 Lossless Transmission Lines

General form:

TXXXXXXX N1 N2 N3 N4 Z0=VALUE <TD=VALUE> + <F=FREQ <NL=NRMLEN>> <IC=V1, I1, V2, I2>

Examples:

T1 1 0 2 0 Z0=50 TD=10NS

n1 and n2 are the nodes at port 1; n3 and n4 are the nodes at port 2. z0 is the characteristic impedance. The length of the line may be expressed in either of two forms. The transmission delay, td, may be specified directly (as td=10ns, for example). Alternatively, a frequency f may be given, together with nl, the normalized electrical length of the transmission line with respect to the wavelength in the line at the frequency f. The transmission delay then is calculated as td = nl/ f.If a frequency is specified but nl is omitted, 0.25 is assumed (that is, the frequency is assumed to be the quarter-wave frequency). Note that although both forms for expressing the line length are indicated as optional, one of the two must be specified.

No .model line is required for this element.

Note that this element models only one propagating mode. If all four nodes are distinct in the actual circuit, then two modes may be excited. To simulate such a situation, two transmission-line

121

122 | CHAPTER 6. TRANSMISSION LINES

elements are required. (see the example in Chapt. 17.7 for further clarification.) The (optional) initial condition specification consists of the voltage and current at each of the transmission line ports. Note that the initial conditions (if any) apply only if the UIC option is specified on the .TRAN control line.

Note that a lossy transmission line (see below) with zero loss may be more accurate than the lossless transmission line due to implementation details.

## 6.2 Lossy Transmission Lines

General form:

OXXXXXXX n1 n2 n3 n4 mname

Examples:

O23 1 0 2 0 LOSSYMOD
.model LOSSYMOD ltra rel=1 r=12.45 g=0 l=8.972e-9 c=0.468e-12 +len=16 steplimit compactrel=1.0e-3 compactabs=1.0e-14

OCONNECT 10 5 20 5 INTERCONNECT

This is a two-port convolution model for single conductor lossy transmission lines. n1 and n2 are the nodes at port 1; n3 and n4 are the nodes at port 2. Note that a lossy transmission line with zero loss may be more accurate than the lossless transmission line due to implementation details.

### 6.2.1 Lossy Transmission Line Model (LTRA)

The uniform RLC/RC/LC/RG transmission line model (referred to as the LTRA model henceforth) models a uniform constant-parameter distributed transmission line. The RC and LC cases may also be modeled using the URC and TRA models; however, the newer LTRA model is usually faster and more accurate than the others. The operation of the LTRA model is based on the convolution of the transmission line’s impulse responses with its inputs (see [8]). The LTRA model takes a number of parameters, some of which must be given and some of which are optional.

6.2. LOSSY TRANSMISSION LINES | 123
Name | Parameter | Units/Type | Default | Example
R | resistance/length | Ω/unit | 0.0 | 0.2
L | inductance/length | H/unit | 0.0 | 9.13e-9
G | conductance/length | mhos/unit | 0.0 | 0.0
C | capacitance/length | F/unit | 0.0 | 3.65e-12
LEN | length of line | unit | no default | 1.0
REL | breakpoint control | arbitrary unit | 1 | 0.5
ABS | breakpoint control | | 1 | 5
NOSTEPLIMIT | don’t limit time-step to less than line delay | flag | not set | set
NO CONTROL | don’t do complex time-step control | flag | not set | set
LININTERP | use linear interpolation | flag | not set | set
MIXEDINTERP | use linear when quadratic seems bad | flag | not set | set
COMPACTREL | special reltol for history compaction | | RELTOL | 1.0e-3
COMPACTABS | special abstol for history compaction | | ABSTOL | 1.0e-9
TRUNCNR | use Newton-Raphson method for time-step control | flag | not set | set
TRUNCDONTCUT | don’t limit time-step to keep impulse-response errors low | flag | not set | set

The following types of lines have been implemented so far:

- RLC (uniform transmission line with series loss only),
- RC (uniform RC line),
- LC (lossless transmission line),
- RG (distributed series resistance and parallel conductance only).

Any other combination will yield erroneous results and should not be tried. The length LEN of the line must be specified. NOSTEPLIMIT is a flag that will remove the default restriction of limiting time-steps to less than the line delay in the RLC case. NO CONTROL is a flag that prevents the default limiting of the time-step based on convolution error criteria in the RLC and RC cases. This speeds up simulation but may in some cases reduce the accuracy of results. LININTERP is a flag that, when specified, will use linear interpolation instead of the default quadratic interpolation for calculating delayed signals. MIXEDINTERP is a flag that, when specified, uses a metric for judging whether quadratic interpolation is not applicable and if so uses linear interpolation; otherwise it uses the default quadratic interpolation. TRUNCDONTCUT is a flag that removes the default cutting of the time-step to limit errors in the actual calculation of impulse-response related quantities. COMPACTREL and COMPACTABS are quantities that control the compaction of the past history of values stored for convolution. Larger values of these lower accuracy but usually increase simulation speed. These are to be used with the TRYTOCOMPACT option, described in the .OPTIONS section. TRUNCNR is a flag that turns on the use of Newton-Raphson iterations to determine an appropriate time-step in the time-step control routines. The

124 | CHAPTER 6. TRANSMISSION LINES

default is a trial and error procedure by cutting the previous time-step in half. REL and ABS are quantities that control the setting of breakpoints.

The option most worth experimenting with for increasing the speed of simulation is REL. The default value of 1 is usually safe from the point of view of accuracy but occasionally increases computation time. A value greater than 2 eliminates all breakpoints and may be worth trying depending on the nature of the rest of the circuit, keeping in mind that it might not be safe from the viewpoint of accuracy.

Breakpoints may usually be entirely eliminated if it is expected the circuit will not display sharp discontinuities. Values between 0 and 1 are usually not required but may be used for setting many breakpoints.

COMPACTREL may also be experimented with when the option TRYTOCOMPACT is specified in a .OPTIONS card. The legal range is between 0 and 1. Larger values usually decrease the accuracy of the simulation but in some cases improve speed. If TRYTOCOMPACT is not specified on a .OPTIONS card, history compaction is not attempted and accuracy is high.

NO CONTROL, TRUNCDONTCUT and NOSTEPLIMIT also tend to increase speed at the expense of accuracy.

## 6.3 Uniform Distributed RC Lines

General form:

UXXXXXXX n1 n2 n3 mname l=len <n=lumps>

Examples:

U1 1 2 0 URCMOD L=50U
.model URCMOD URC CPERL=100p RPERL=100k FMAX=10G

URC2 1 12 2 UMODL l=1MIL N=6

n1 and n2 are the two element nodes the RC line connects, while n3 is the node the capacitances are connected to. mname is the model name, len is the length of the RC line in meters. lumps, if specified, is the number of lumped segments to use in modeling the RC line (see the model description for the action taken if this parameter is omitted).

### 6.3.1 Uniform Distributed RC Model (URC)

The URC model is derived from a model proposed by L. Gertzberg in 1974. The model is accomplished by a subcircuit type expansion of the URC line into a network of lumped RC segments with internally generated nodes. The RC segments are in a geometric progression, increasing toward the middle of the URC line, with K as a proportionality constant. The number of lumped segments used, if not specified for the URC line device, is determined by the following formula:

6.4. KSPICE LOSSY TRANSMISSION LINES | 125

N =

log

Fmax

R
L

C
L

2πL

2

(K−1)
K

2

logK

(6.1)

The URC line is made up strictly of resistor and capacitor segments unless the ISPERL parameter is given a nonzero value, in which case the capacitors are replaced with reverse biased diodes with a zero-bias junction capacitance equivalent to the capacitance replaced, and with a saturation current of ISPERL amps per meter of transmission line and an optional series resistance equivalent to RSPERL ohms per meter.

Name | Parameter | Units | Default | Example | Area
K | Propagation Constant | - | 1.5 | 1.2 | -
FMAX | Maximum Frequency of interest | Hz | 1.0 G | 6.5 Meg | -
RPERL | Resistance per unit length | Ω/m | 1000 | 10 | -
CPERL | Capacitance per unit length | F/m | 10e-15 | 1 p | -
ISPERL | Saturation Current per unit length | A/m | 0 | - | -
RSPERL | Resistance per unit length | Ω/m | 0 | - | -

## 6.4 KSPICE Lossy Transmission Lines

Unlike SPICE3, which uses the state-based approach to simulate lossy transmission lines, KSPICE simulates lossy transmission lines and coupled multiconductor line systems using the recursive convolution method. The impulse response of an arbitrary transfer function can be determined by deriving a recursive convolution from the Pade approximations of the function. ngspice is using this approach for simulating each transmission line’s characteristics and each multiconductor line’s modal functions. This method of lossy transmission line simulation has shown to give a sigificant speedup. Please note that the following two models will support only transient simulation, no ac.

Additional Documentation Available:

- S. Lin and E. S. Kuh, ‘Pade Approximation Applied to Transient Simulation of Lossy Coupled Transmission Lines,’ Proc. IEEE Multi-Chip Module Conference, 1992, pp. 52-55.
- S. Lin, M. Marek-Sadowska, and E. S. Kuh, ‘SWEC: A StepWise Equivalent Conductance Timing Simulator for CMOS VLSI Circuits,’ European Design Automation Conf., February 1991, pp. 142-148.
- S. Lin and E. S. Kuh, ‘Transient Simulation of Lossy Interconnect,’ Proc. Design Automation Conference, Anaheim, CA, June 1992, pp. 81-86.

126 | CHAPTER 6. TRANSMISSION LINES

### 6.4.1 Single Lossy Transmission Line (TXL)

General form:

YXXXXXXX N1 0 N2 0 mname <LEN=LENGTH>

Example:

Y1 1 0 2 0 ymod LEN=2
| .MODEL ymod txl R=12.45 L=8.972e-9 G=0 C=0.468e-12 length=16

n1 and n2 are the nodes of the two ports. The optional instance parameter len is the length of the line and may be expressed in multiples of [unit]. Typically unit is given in meters. len will override the model parameter length for the specific instance only.

The TXL model takes a number of parameters:

Name | Parameter | Units/Type | Default | Example
R | resistance/length | Ω/unit | 0.0 | 0.2
L | inductance/length | H/unit | 0.0 | 9.13e-9
G | conductance/length | mhos/unit | 0.0 | 0.0
C | capacitance/length | F/unit | 0.0 | 3.65e-12
LENGTH | length of line | unit | no default | 1.0

Model parameter length must be specified as a multiple of unit. Typically unit is given in [m]. For transient simulation only.

### 6.4.2 Coupled Multiconductor Line (CPL)

The CPL multiconductor line model is in theory similar to the RLGC model, but without frequency dependent loss (neither skin effect nor frequency-dependent dielectric loss). Up to 8 coupled lines are supported in ngspice.

General form:

PXXXXXXX NI1 NI2...NIX GND1 NO1 NO2...NOX GND2 mname <LEN=LENGTH>

Example:

P1 in1 in2 0 b1 b2 0 PLINE .model PLINE CPL length={Len} +R=1 0 1
+L={L11} {L12} {L22}
+G=0 0 0
+C={C11} {C12} {C22}
.param Len=1 Rs=0
+ C11=9.143579E-11 C12=-9.78265E-12 C22=9.143578E-11 + L11=3.83572E-7 L12=8.26253E-8 L22=3.83572E-7

6.4. KSPICE LOSSY TRANSMISSION LINES | 127

ni1 ... nix are the nodes at port 1 with gnd1; no1 ... nox are the nodes at port 2 with gnd2. The optional instance parameter len is the length of the line and may be expressed in multiples of [unit]. Typically unit is given in meters. len will override the model parameter length for the specific instance only.

The CPL model takes a number of parameters:

Name | Parameter | Units/Type | Default | Example
R | resistance/length | Ω/unit | 0.0 | 0.2
L | inductance/length | H/unit | 0.0 | 9.13e-9
G | conductance/length | mhos/unit | 0.0 | 0.0
C | capacitance/length | F/unit | 0.0 | 3.65e-12
LENGTH | length of line | unit | no default | 1.0

All RLGC parameters are given in Maxwell matrix form. For the R and G matrices the diagonal elements must be specified, for L and C matrices the lower or upper triangular elements must specified. The parameter LENGTH is a scalar and is mandatory. For transient simulation only.

128 | CHAPTER 6. TRANSMISSION LINES

# Chapter 7

# Device Models

## 7.1 Instance lines and .model lines

Adding a device to the ngspice netlist as described in this chapter will require two lines: the instance line and a .model line.

Instance line:

QXXXXXXX node1 node2 node3 modelname <instpar1=val> <instpar2=val> <off>

.model line:

.model modelname modeltype mpar1=val mpar2=val ...

The first letter of the instance line (e.g. Q for bipolar) will select the device (see 2.2), QXXXXXXX denotes a unique name. Next there are the device nodes. modelname is a user-given reference to a specific .model line. Instance parameters (specific to the device, often optional) may follow.

The .model line adds a set of model parameters. After the .model token the modelname sets the link to the devices calling this model parameter set. modeltype links the parameter set to a specific model type, e.g. NPN or PNP for bipolar transistors (see 2.3 for model types available in ngspice). Model parameters may follow.Their number may differ. If no parameters is given, default parameters hardcoded into ngspice are selected. Complex device models may require several hundred parameters. level and version parameters allow to access sub-categories of a specific device model.

Example (integrated NMOS transistor, BSIM3):

M1 dnode1 gnode1 snode1 bnode1 mosnb3 L=0.35u W=2u
.model mosnb3 NMOS level=8 version=3.3.0 tox=6.5n nch=2.4e17 nsub=5e16 vth0=0.3

129

130 | CHAPTER 7. DEVICE MODELS

## 7.2 Junction Diodes

General form:

DXXXXXXX n+ n- mname <area=val> <m=val> <pj=val> <off>
+ | <ic=vd> <temp=val> <dtemp=val>
+ | <lm=val> <wm=val> <lp=val> <wp=val>

Examples:

DBRIDGE 2 10 DIODE1
DCLMP aa cc DMOD AREA=3.0 IC=0.2

The pn junction (diode) implemented in ngspice expands the one found in SPICE3f5. Perimeter effects and high injection level have been introduced into the original model and temperature dependence of some parameters has been added. n+ and n- are the positive (anode) and negative (cathode) nodes, respectively. mname is the model name. Instance parameters may follow, dedicated to only the diode described on the respective line. area is the area scale factor, which may scale the saturation current given by the model parameters (and others, see table below). pj (perim) is the perimeter scale factor, scaling the sidewall saturation current and its associated capacitance. m is a multiplier of area and perimeter, and off indicates an (optional) starting condition on the device for dc analysis. If the area factor is omitted, a value of 1.0 is assumed. The (optional) initial condition specification using ic is intended for use with the uic option on the .tran control line, when a transient analysis is desired starting from other than the quiescent operating point. You should supply the initial voltage across the diode there. The (optional) temp value is the temperature at which this device is to operate, and overrides the temperature specification on the .option control line. The temperature of each instance can be specified as an offset to the circuit temperature with the dtemp option.

To fulfill requirements of modern process design kits (PDK) the basic spice3 model was extended with the capability of modeling parasitic effects like sidewall junction currents and capacitances, tunnel currents and metal and polysilicon overlap capacitances. Latter effect can be activated by LEVEL=3 model parameter or by setting element parameters lm, wm, lp and wp. If both are given, element parameters have priority.

With the (new in ngspice-39) OpenVAF/OSDI approach (see 9), all modern diode models, written in Verilog-A, become available, like JUNCAP etc..

### 7.2.1 Diode Model (D)

Diode models may be described in the netlist input file (or an file included by .inc) according to the following example:

7.2. JUNCTION DIODES | 131

General form:

.model mname type(pname1=pval1 pname2=pval2 ... )

Examples:

.model DIODE1 D (bv=50 is=1e-13 n=1.05)

with a user defined model name mname, and the model type D.

A basic model statement using only the internal default model parameters is

Basic model statement:

.model DMOD D

The dc characteristics of the diode are determined by the parameters IS and N. An ohmic resistance, RS, is included. Charge storage effects are modeled by a transit time, TT, and a nonlinear depletion layer capacitance that is determined by the parameters CJO, VJ, and M. The temperature dependence of the saturation current is defined by the parameters EG, the energy, and XTI, the saturation current temperature exponent. The nominal temperature where these parameters were measured is TNOM, which defaults to the circuit-wide value specified on the .options control line. Reverse breakdown is modeled by an exponential increase in the reverse diode current and is determined by the parameters BV and IBV (both of which are positive numbers).

132 | CHAPTER 7. DEVICE MODELS

Junction DC parameters

Name | Parameter | Units | Default | Example | Scale factor
IS (JS) | Saturation current | A | 1.0e-14 | 1.0e-16 | area
JSW (ISW) | Sidewall saturation current | A | 0.0 | 1.0e-15 | perimeter
N | Emission coefficient | - | 1 | 1.5
RS | Ohmic resistance | Ω | 0.0 | 100 | 1/area
BV (VB,VRB,VAR) | Reverse breakdown voltage | V | ∞ | 40
IBV (IB) | Current at breakdown voltage | A | 1.0e-3 | 1.0e-4
NBV (NZ) | Breakdown Emission Coefficient | - | N | 1.2
IKF (IK) | Forward knee current | A | 0.0 | 1.0e-3
IKR | Reverse knee current | A | 0.0 | 1.0e-3
JTUN | Tunneling saturation current | A | 0.0 | | area
JTUNSW | Tunneling sidewall saturation current | A | 0.0 | | perimeter
NTUN | Tunneling emission coefficient | - 30
XTITUN | Tunneling saturation current exponential | - 3
KEG | EG correction factor for tunneling | - 1.0
ISR | Recombination saturation current | A | 1e-14 | 1pA | area
NR | Recombination current emission coefficient | - | 2 | 1.5

Junction capacitance parameters

Name | Parameter | Units | Default | Example | Scale factor
CJO (CJ0) | Zero-bias junction bottom-wall capacitance | F | 0.0 | 2pF | area
CJP (CJSW) | Zero-bias junction sidewall capacitance | F | 0.0 | .1pF | perimeter
FC | Coefficient for forward-bias depletion bottom-wall capacitance formula | - | 0.5 | -
FCS | Coefficient for forward-bias depletion sidewall capacitance formula | - | 0.5 | -
M (MJ) | Area junction grading coefficient | - | 0.5 | 0.5
MJSW | Periphery junction grading coefficient | - | 0.33 | 0.5
VJ (PB) | Junction potential | V | 1 | 0.6
PHP | Periphery junction potential | V | 1 | 0.6
TT | Transit-time | sec | 0 | 0.1ns

7.2. JUNCTION DIODES | 133

Metal and Polysilicon Overlap Capacitances (level=3)

Name | Parameter | Units | Default | Example | Scale factor
LM | Length of metal capacitor | m | 0.0 | 4um | SCALE
LP | Length of polysilicon capacitor | m | 0.0 | 5um | SCALE
WM | Width of metal capacitor | m | 0.0 | 2um | SCALE
WP | Width of polysilicon capacitor | m | 0.0 | 4um | SCALE
XOM | Thickness of the metal to bulk oxide | Å | 10k | -
XOI | Thickness of the polysilicon to bulk oxide | Å | 10k | -
XM | Masking and etching effects in metal | m | 0.0 | -
XP | Masking and etching effects in polysilicon | m | 0.0 | -
XW | Masking and etching effects | m | 0.0 | -

134 | CHAPTER 7. DEVICE MODELS

Temperature effects

Name | Parameter | Units | Default | Example
EG | Activation energy | eV | 1.11 | 1.11 Si 0.69 Sbd 0.67 Ge
GAP1 | First bandgap correction factor (TLEV=2) | eV | 7.02e-4
GAP2 | Secnd bandgap correction factor (TLEV=2) | - 1108
TNOM (TREF) | Parameter measurement temperature | ◦C | 27 | 50
TRS1 (TRS) | 1st order tempco for RS | 1/ ◦C | 0.0 | -
TRS2 | 2nd order tempco for RS | 1/ ◦C 2 | 0.0 | -
TM1 | 1st order tempco for MJ | 1/ ◦C | 0.0 | -
TM2 | 2nd order tempco for MJ | 1/ ◦C 2 | 0.0 | -
TTT1 | 1st order tempco for TT | 1/ ◦C | 0.0 | -
TTT2 | 2nd order tempco for TT | 1/ ◦C 2 | 0.0 | -
XTI | Saturation current temperature exponent | - | 3.0 | 3.0 pn 2.0 Sbd
TLEV | Diode temperature equation selector (0,1,2) | - 0
TLEVC | Diode capac. temperature equation selector | - 0
CTA (CTC) | Area junct. cap. temperature coefficient | 1/ ◦C | 0.0 | -
CTP | Perimeter junct. cap. temperature coefficient | 1/ ◦C | 0.0 | -
TCV (TBV1) | Breakdown voltage temperature coefficient | 1/ ◦C | 0.0 | -

Noise modeling

Name | Parameter | Units | Default | Example | Scale factor
KF | Flicker noise coefficient | - | 0
AF | Flicker noise exponent | - | 1

### 7.2.2 Diode Equations

The junction diode is the basic semiconductor device and the simplest one in ngspice, but its model is quite complex, even when not all the physical phenomena affecting a pn junction are handled. The diode is modeled in three different regions:

- Forward bias: the anode is more positive than the cathode, the diode is ‘on’ and can conduct large currents. To avoid convergence problems and unrealistic high current, it is prudent to specify a series resistance to limit current with the RS model parameter.

7.2. JUNCTION DIODES | 135
- Reverse bias: the cathode is more positive than the anode and the diode is ‘off’. A reverse bias diode conducts a small leakage current.
- Breakdown: the breakdown region is modeled only if the BV model parameter is given. When a diode enters breakdown the current increases exponentially (remember to limit it); BV is a positive value.

Parameters Scaling

Model parameters are scaled using the unit-less parameters area and pj and the multiplier m as depicted below:

AREAe f f = AREAm

PJe f f = PJm

ISe f f = ISAREAe f f +JSWPJe f f

IBVe f f = IBVAREAe f f

IKe f f = IKAREAe f f

IKRe f f = IKRAREAe f f

CJe f f = CJ0AREAe f f

CJPe f f = CJPPJe f f

Diode DC, Transient and AC model equations

The diode model has certain dc currents for bottom and sidewall components. Exemplary here is the equation for the bottom part:

ID =

ISe f f(e

qVD
NkT −1) +VD ·GMIN, | if VD ≥ −3

NkT
q
−ISe f f [1+ ( ³NkT
qVDe

)

3
] +VD ·GMIN, if −BVe f f < VD < −3

NkT
q
−ISe f f(e

−q(BVe f f +VD)
NkT ) +VD ·GMIN, if VD ≤ −BVe f f

(7.1)

Two secondary effects are modeled if the appropriate parameters (see table Junction DC parameters) are given: Recombination current and bottom and sidewall tunnel current.

The breakdown region must be described with more depth since the breakdown is not modeled physically. As written before, the breakdown modeling is based on two model parameters: the ‘nominal breakdown voltage’ BV and the current at the onset of breakdown IBV. For the diode model to be consistent, the current value cannot be arbitrarily chosen, since the reverse bias and breakdown regions must match. When the diode enters breakdown region from reverse bias, the current is calculated using the formula¹
:

Ibdwn = −ISe f f(e

−qBV
NkT −1) | (7.2)

The computed current is necessary to adjust the breakdown voltage making the two regions match. The algorithm is a little bit convoluted and only a brief description is given here:

1
if you look at the source code in file diotemp.c you will discover that the exponential relation is replaced with a first order Taylor series expansion.

136 | CHAPTER 7. DEVICE MODELS

Algorithm 7.1 Diode breakdown current calculation

if IBVe f f < Ibdwn then
IBVe f f = Ibdwn
BVe f f = BV
else
BVe f f = BV−NVt

ln(

IBVe f f

Ibdwn

)

Most real diodes shows a current increase that, at high current levels, does not follow the exponential relationship given above. This behavior is due to high level of carriers injected into the junction. High injection effects (as they are called) are modeled with IK and IKR.

IDe f f =

ID

1+

r
ID
IKe f f

, if VD ≥ −3

NkT
q

ID

1+

r
ID
IKRe f f | , otherwise.

(7.3)

Diode capacitance is divided into two different terms:

- Depletion capacitance
- Diffusion capacitance

Depletion capacitance is composed by two different contributes, one associated to the bottom of the junction (bottom-wall depletion capacitance) and the other to the periphery (sidewall depletion capacitance). The basic equations are

CDiode = Cdi f f usion +Cdepletion

Where the depletion capacitance is defined as:

Cdepletion = Cdeplbw +Cdeplsw

The diffusion capacitance, due to the injected minority carriers, is modeled with the transit time TT:

Cdi f f usion = TT

∂ IDe f f
∂VD

The depletion capacitance is more complex to model, since the function used to approximate it diverges when the diode voltage become greater than the junction built-in potential. To avoid function divergence, the capacitance function is approximated with a linear extrapolation for applied voltage greater than a fraction of the junction built-in potential.

Cdeplbw =

CJe f f(1−

VD
VJ)

−MJ
, | if VD < FC·VJ

CJe f f

1−FC(1+MJ)+MJVD
VJ
(1−FC)

(1+MJ)

, otherwise.

(7.4)

7.2. JUNCTION DIODES | 137

Cdeplsw =

CJPe f f(1−

VD
PHP)
−MJSW, | if VD < FCS·PHP

CJPe f f

1−FCS(1+MJSW)+MJSW·

VD
PHP
(1−FCS) (1+MJSW) | , otherwise.

(7.5)

Temperature dependence

The temperature affects many of the parameters in the equations above, and the following equations show how. One of the most significant parameters that varies with the temperature for a semiconductor is the band-gap energy:

EGnom = 1.16−7.02e

−4 | TNOM²
| TNOM+1108.0

(7.6)

EG(T) = 1.16−7.02e

−4 | T
| 2

TNOM+1108.0

| (7.7)

The leakage current temperature’s dependence is:

IS(T) = ISe

log f actor
N | (7.8)

JSW(T) = JSWe

log f actor
N | (7.9)

where ‘logfactor’ is defined as

log f actor =

EG
Vt(TNOM)

−

EG
Vt(T)

+XTI ln(

T
TNOM
) | (7.10)

The contact potentials (bottom-wall an sidewall) temperature dependence is:

V J(T) = VJ(

T
TNOM

)−Vt(T)

3 ·ln(

T
TNOM

) + EGnom Vt(TNOM)
−

EG(T)
Vt(T)
(7.11)

PHP(T) = PHP(

T
TNOM

)−Vt(T)

3 ·ln(

T
TNOM

) + EGnom
Vt(TNOM)

−

EG(T)
Vt(T)
(7.12)

The depletion capacitances temperature dependence is:

CJ(T) = CJ
1+MJ(4.0e

−4
(T −TNOM)−

V J(T)
VJ

+1)

(7.13)

CJSW(T) = CJSW
1+MJSW(4.0e

−4
(T −TNOM)−

PHP(T)
PHP

+1)

(7.14)

The transit time temperature dependence is:

T T(T) = TT(1+TTT1(T −TNOM) +TTT2(T −TNOM)

2
) | (7.15)

138 | CHAPTER 7. DEVICE MODELS

The junction grading coefficient temperature dependence is:

MJ(T) = MJ(1+TM1(T −TNOM) +TM2(T −TNOM)

2
) | (7.16)

The series resistance temperature dependence is:

RS(T) = RS(1+TRS(T −TNOM) +TRS2(T −TNOM)

2
) | (7.17)

Noise model

The diode has three noise contribution, one due to the presence of the parasitic resistance RS and the other two (shot and flicker) due to the pn junction.

The thermal noise due to the parasitic resistance is:

i

2
RS =

4kT∆f
RS

(7.18)

The shot and flicker noise contributions with model parameters KF and AF are

i

2
d = 2qID∆f +

KF ·I

AF
D
f
∆f | (7.19)

Self Heating model

Ngspice diode model has implemented a simple self heating approach. A current equivalent to the dissipated power is conducted to a RC parallel circuit. The connection node voltage is so a thermal equivalent to the junction overtemperature. This temperature follows in a electro-thermal feedback with appropriate change of the diode current and capacitance.

Compared to the standard diode we have a third node tj and a flag thermal on element line. In the model description we have to set RTH0 and CTH0 model parameter.

General form element usage:

DXXXXXXX n+ n- tj mname <off> <ic=vd> thermal

Example model:

.model DPWR D (bv=16 is=1e-10 n=1.03 rth0=50 cth0=1u)

### 7.2.3 Diode models available via OpenVAF/OSDI

With its integrated OSDI interface (https://semimod.de/projects/) and the OpenVAF (https://openvaf.semimod.de/) compiler (see chapter 9 for details), ngspice makes available more Verilog-A compact diode models:

7.3. BJT | 139

### 7.2.3.1 JUNCAP2 model

Initially developed by Philips research. A widely used diode model in integrated circuit design. Works together with MOS models like PSP and as an alternative diode model for source/drain junctions of BSIM4 models.

### 7.2.3.2 DIODE_CMC

The DIODE_CMC model includes following enhancement beyond JUNCAP2:

1. Series resistor
2. Diffusion cap with soft recovery
3. Breakdown voltage temperature coefficient
4. Noise
5. Min-max parameters for warning purposes

## 7.3 BJT

### 7.3.1 Bipolar Junction Transistors (BJTs)

General form:

QXXXXXXX nc nb ne <ns> <tj> mname <area=val> <areac=val> + <areab=val> <m=val> <off> <ic=vbe,vce> <temp=val>
+ <dtemp=val>

Examples:

Q23 10 24 13 QMOD IC=0.6, 5.0
Q50A 11 26 4 20 MOD1

nc, nb, and ne are the collector, base, and emitter nodes, respectively. ns is the (optional) substrate node. When unspecified, ground is used. tj is the (optional) junction temperature node, available in the VBIC model (see 7.3.4). mname is the model name, area, areab, areac are the area factors (emitter, base and collector respectively), and off indicates an (optional) initial condition on the device for the dc analysis. If the area factor is omitted, a value of 1.0 is assumed.

The (optional) initial condition specification using ic=vbe,vce is intended for use with the uic option on a .tran control line, when a transient analysis is desired to start from other than the quiescent operating point. See the .ic control line description for a better way to set transient initial conditions. The (optional) temp value is the temperature where this device is to operate, and overrides the temperature specification on the .option control line. Using the dtemp option one can specify the instance’s temperature relative to the circuit temperature.

140 | CHAPTER 7. DEVICE MODELS

### 7.3.2 BJT Models (NPN/PNP)

Ngspice provides three different BJT device models, which are selected by the .model card.

.model QMOD1 PNP

.model QMOD3 NPN level=4

These are the minimal versions, using default parameters supplied by ngspice. Further optional parameters listed in the table below may replace the ngspice default parameters. The LEVEL keyword specifies the model to be used:

| • LEVEL=1: This is the original SPICE BJT model, and it is the default model if the LEVEL keyword is not specified on the .model line. By activating certain parameter a modified version of the original SPICE BJT that models both vertical and lateral devices, includes temperature corrections of collector, emitter and base resistors and allow modeling of

quasi-saturation effects.

| • LEVEL=4: Advanced VBIC model (see 7.3.4 and http://www.designers-guide.org/VBIC/
for details)
| • LEVEL=8: HICUM/L2 model (see 7.3.5 and the official website (https://www.iee.et.tu-dresden.de/iee/eb/hic_new/hic_intro.html) for details)

With the (new in ngspice-39) OpenVAF/OSDI approach (see 9), all modern bipolar models, written in Verilog-A, become available, like VBIC, Mextram and HICUM.

### 7.3.3 Gummel-Poon Models

The bipolar junction transistor model in ngspice is an adaptation of the integral charge control model of Gummel and Poon. This modified Gummel-Poon model extends the original model to include several effects at high bias levels. The model automatically simplifies to the simpler Ebers-Moll model when certain parameters are not specified. The parameter names used in the modified Gummel-Poon model have been chosen to be more easily understood by the user, and to reflect better both physical and circuit design thinking.

The dc model is defined by the parameters IS, BF, NF, ISE, IKF, and NE, which determine the forward current gain characteristics, IS, BR, NR, ISC, IKR, and NC, which determine the reverse current gain characteristics, and VAF and VAR, which determine the output conductance for forward and reverse regions.

A more accurate model for transport current components is possible by specification of model parameter IBE and IBC instead of IS.

Parameter NKF(NK)was introduced for more accurate high current beta rolloff modelling.

The BJT model has among the standard temperature parameters an extension compatible with most foundry provided process design kits (see parameter table below TLEV).

The BJT model includes the substrate saturation current ISS. Three ohmic resistances RB, RC, and RE are included, where RB can be high current dependent. Base charge storage is modeled by forward and reverse transit times, TF and TR, where the forward transit time TF can be bias dependent if desired. Nonlinear depletion layer capacitances are defined with CJE, VJE, and

7.3. BJT | 141

NJE for the B-E junction, CJC, VJC, and NJC for the B-C junction and CJS, VJS, and MJS for the C-S (collector-substrate) junction.

The BJT model support a substrate capacitance that is connected to the device’s base or collector, to model lateral or vertical devices dependent on the parameter SUBS. The temperature dependence of the saturation currents, IS and ISS, is determined by the energy-gap, EG, and the saturation current temperature exponent, XTI.

In the new model, additional base current temperature dependence is modeled by the beta temperature exponent XTB. The values specified are assumed to have been measured at the temperature TNOM, which can be specified on the .options control line or overridden by a specification on the .model line.

The BJT parameters used in the modified Gummel-Poon model are listed below. The parameter names used in earlier versions of SPICE2 are still accepted.

Gummel-Poon BJT Parameters (incl. model extensions)

Name | Parameters | Units | Default | Example | Scale factor
SUBS | Substrate connection: 1 for vertical geometry, -1 for lateral geometry | | 1
IS | Transport saturation current | A | 1.0e-16 | 1.0e-15 | area
IBE | Base-Emitter saturation current | A | 0.0 | 1.0e-16 | area
IBC | Base-Collector saturation current | A | 0.0 | 1.0e-16 | areab,areac
ISS | Reverse saturation current, substrate-to-collector for vertical device or substrate-to-base for lateral | A | 0.0 | 1.0e-15 | area
BF | Ideal maximum forward beta. | - | 100 | 100
NF | Forward current emission coefficient | - | 1.0 | 1
VAF (VA) | Forward Early voltage | V | ∞ | 200
IKF | Corner for forward beta current roll-off | A | ∞ | 0.01 | area
NKF(NK) | High current Beta rolloff exponent | - | 0.5 | 0.9
ISE | B-E leakage saturation current. | A | 0.0 | 1e-13 | area
NE | B-E leakage emission coefficient | - | 1.5 | 2
BR | Ideal maximum reverse beta | - | 1 | 0.1
NR | Reverse current emission coefficient | - | 1 | 1
VAR (VB) | Reverse Early voltage | V | ∞ | 200
IKR | Corner for reverse beta high current roll-off | A | ∞ | 0.01 | area
ISC | B-C leakage saturation current (scale is ‘areab’ for vertical devices and ‘areac’ for lateral) | A | 0.0 | 1e-13 | areab,areac
NC | B-C leakage emission coefficient | - | 2 | 1.5
RB | Zero bias base resistance | Ω | 0 | 100 | 1/area

142 | CHAPTER 7. DEVICE MODELS
IRB | Current where base resistance falls halfway to its min value | A | ∞ | 0.1 | area
RBM | Minimum base resistance at high currents | Ω | RB | 10 | 1/area
RE | Emitter resistance | Ω | 0 | 1 | 1/area
RC | Collector resistance | Ω | 0 | 10 | 1/area
CJE | B-E zero-bias depletion capacitance | F | 0 | 2pF | area
VJE (PE) | B-E built-in potential | V | 0.75 | 0.6
MJE (ME) | B-E junction exponential factor | - | 0.33 | 0.33
TF | Ideal forward transit time | sec | 0 | 0.1ns
XTF | Coefficient for bias dependence of TF | - 0
VTF | Voltage describing VBC dependence of TF | V | ∞
ITF | High-current parameter for effect on TF | A | 0 | - | area
PTF | Excess phase at freq= 1 Hz 2πT F | deg | 0
CJC | B-C zero-bias depletion capacitance (scale is ‘areab’ for vertical devices and ‘areac’ for lateral) | F | 0 | 2pF | areab,areac
VJC (PC) | B-C built-in potential | V | 0.75 | 0.5
MJC | B-C junction exponential factor | - | 0.33 | 0.5
XCJC | Fraction of B-C depletion capacitance connected to internal base node | - 1
TR | Ideal reverse transit time | sec | 0 | 10ns
CJS | Zero-bias collector-substrate capacitance (scale is ‘areac’ for vertical devices and ‘areab’ for lateral) | F | 0 | 2pF | areab,areac
VJS (PS) | Substrate junction built-in potential | V | 0.75
MJS (MS) | Substrate junction exponential factor | - | 0 | 0.5
XTB | Forward and reverse beta temperature exponent | - 0
EG | Energy gap for temperature effect on IS | eV | 1.11
XTI | Temperature exponent for effect on IS | - 3
KF | Flicker-noise coefficient | - | 0
AF | Flicker-noise exponent | - | 1
FC | Coefficient for forward-bias depletion capacitance formula | - | 0.5 | 0

7.3. BJT | 143
TNOM (TREF) | Parameter measurement temperature | ◦C | 27 | 50
TLEV | BJT temperature equation selector | - | 0
TLEVC | BJT capac. temperature equation selector | - 0
TRE1 | 1st order temperature coefficient for RE | 1/ ◦C | 0.0 | 1e-3
TRE2 | 2nd order temperature coefficient for RE | 1/ ◦C 2 | 0.0 | 1e-5
TRC1 | 1st order temperature coefficient for RC | 1/ ◦C | 0.0 | 1e-3
TRC2 | 2nd order temperature coefficient for RC | 1/ ◦C 2 | 0.0 | 1e-5
TRB1 | 1st order temperature coefficient for RB | 1/ ◦C | 0.0 | 1e-3
TRB2 | 2nd order temperature coefficient for RB | 1/ ◦C 2 | 0.0 | 1e-5
TRBM1 | 1st order temperature coefficient for RBM | 1/ ◦C | 0.0 | 1e-3
TRBM2 | 2nd order temperature coefficient for RBM | 1/ ◦C 2 | 0.0 | 1e-5
TBF1 | 1st order temperature coefficient for BF | 1/ ◦C | 0.0 | 1e-3
TBF2 | 2nd order temperature coefficient for BF | 1/ ◦C 2 | 0.0 | 1e-5
TBR1 | 1st order temperature coefficient for BR | 1/ ◦C | 0.0 | 1e-3
TBR2 | 2nd order temperature coefficient for BR | 1/ ◦C 2 | 0.0 | 1e-5
TIKF1 | 1st order temperature coefficient for IKF | 1/ ◦C | 0.0 | 1e-3
TIKF2 | 2nd order temperature coefficient for IKF | 1/ ◦C 2 | 0.0 | 1e-5
TIKR1 | 1st order temperature coefficient for IKR | 1/ ◦C | 0.0 | 1e-3
TIKR2 | 2nd order temperature coefficient for IKR | 1/ ◦C 2 | 0.0 | 1e-5
TIRB1 | 1st order temperature coefficient for IRB | 1/ ◦C | 0.0 | 1e-3
TIRB2 | 2nd order temperature coefficient for IRB | 1/ ◦C 2 | 0.0 | 1e-5
TNC1 | 1st order temperature coefficient for NC | 1/ ◦C | 0.0 | 1e-3
TNC2 | 2nd order temperature coefficient for NC | 1/ ◦C 2 | 0.0 | 1e-5

144 | CHAPTER 7. DEVICE MODELS
TNE1 | 1st order temperature coefficient for NE | 1/ ◦C | 0.0 | 1e-3
TNE2 | 2nd order temperature coefficient for NE | 1/ ◦C 2 | 0.0 | 1e-5
TNF1 | 1st order temperature coefficient for NF | 1/ ◦C | 0.0 | 1e-3
TNF2 | 2nd order temperature coefficient for NF | 1/ ◦C 2 | 0.0 | 1e-5
TNR1 | 1st order temperature coefficient for IKF | 1/ ◦C | 0.0 | 1e-3
TNR2 | 2nd order temperature coefficient for IKF | 1/ ◦C 2 | 0.0 | 1e-5
TVAF1 | 1st order temperature coefficient for VAF | 1/ ◦C | 0.0 | 1e-3
TVAF2 | 2nd order temperature coefficient for VAF | 1/ ◦C 2 | 0.0 | 1e-5
TVAR1 | 1st order temperature coefficient for VAR | 1/ ◦C | 0.0 | 1e-3
TVAR2 | 2nd order temperature coefficient for VAR | 1/ ◦C 2 | 0.0 | 1e-5
CTC | 1st order temperature coefficient for CJC | 1/ ◦C | 0.0 | 1e-3
CTE | 1st order temperature coefficient for CJE | 1/ ◦C | 0.0 | 1e-3
CTS | 1st order temperature coefficient for CJS | 1/ ◦C | 0.0 | 1e-3
TVJC | 1st order temperature coefficient for VJC | 1/ ◦C 2 | 0.0 | 1e-5
TVJE | 1st order temperature coefficient for VJE | 1/ ◦C | 0.0 | 1e-3
TITF1 | 1st order temperature coefficient for ITF | 1/ ◦C | 0.0 | 1e-3
TITF2 | 2nd order temperature coefficient for ITF | 1/ ◦C 2 | 0.0 | 1e-5
TTF1 | 1st order temperature coefficient for TF | 1/ ◦C | 0.0 | 1e-3
TTF2 | 2nd order temperature coefficient for TF | 1/ ◦C 2 | 0.0 | 1e-5
TTR1 | 1st order temperature coefficient for TR | 1/ ◦C | 0.0 | 1e-3
TTR2 | 2nd order temperature coefficient for TR | 1/ ◦C 2 | 0.0 | 1e-5
TMJE1 | 1st order temperature coefficient for MJE | 1/ ◦C | 0.0 | 1e-3
TMJE2 | 2nd order temperature coefficient for MJE | 1/ ◦C 2 | 0.0 | 1e-5

7.3. BJT | 145
TMJC1 | 1st order temperature coefficient for MJC | 1/ ◦C | 0.0 | 1e-3
TMJC2 | 2nd order temperature coefficient for MJC | 1/ ◦C 2 | 0.0 | 1e-5

Quasi-Saturation Model extension

By defining parameter RCO, VO, GAMMA and QCO an extension of the Gummel-Poon model will be switched on to model bipolar junction transistors that exhibit quasi-saturation effects. A description can be found in [24].

Name | Parameters | Units | Default | Example | Scale factor
RCO | Epitaxial region resistance | Ω | 0 | 0.45 | 1/area
VO | Carrier mobility knee voltage | V | 10 | 4.16
GAMMA | Epitaxial region doping factor | − | 1e-11 | 1.0e-15
QCO | Epitaxial region charge factor | C | 0.0 | 3.4E-11
VG | Energy gap QS temp. depend. | V | 1.206 | 1.2
CN | Temperature exponent of RCI | | 2.42 NPN 2.2 PNP
D | Temperature exponent of VO | | .87 NPN .52 PNP

The Collector current output characteristic shows a special moderate transition in the BJT saturation region, see figure 7.1. Furthermore DC current gain and the unity gain frequency fT falls sharply.

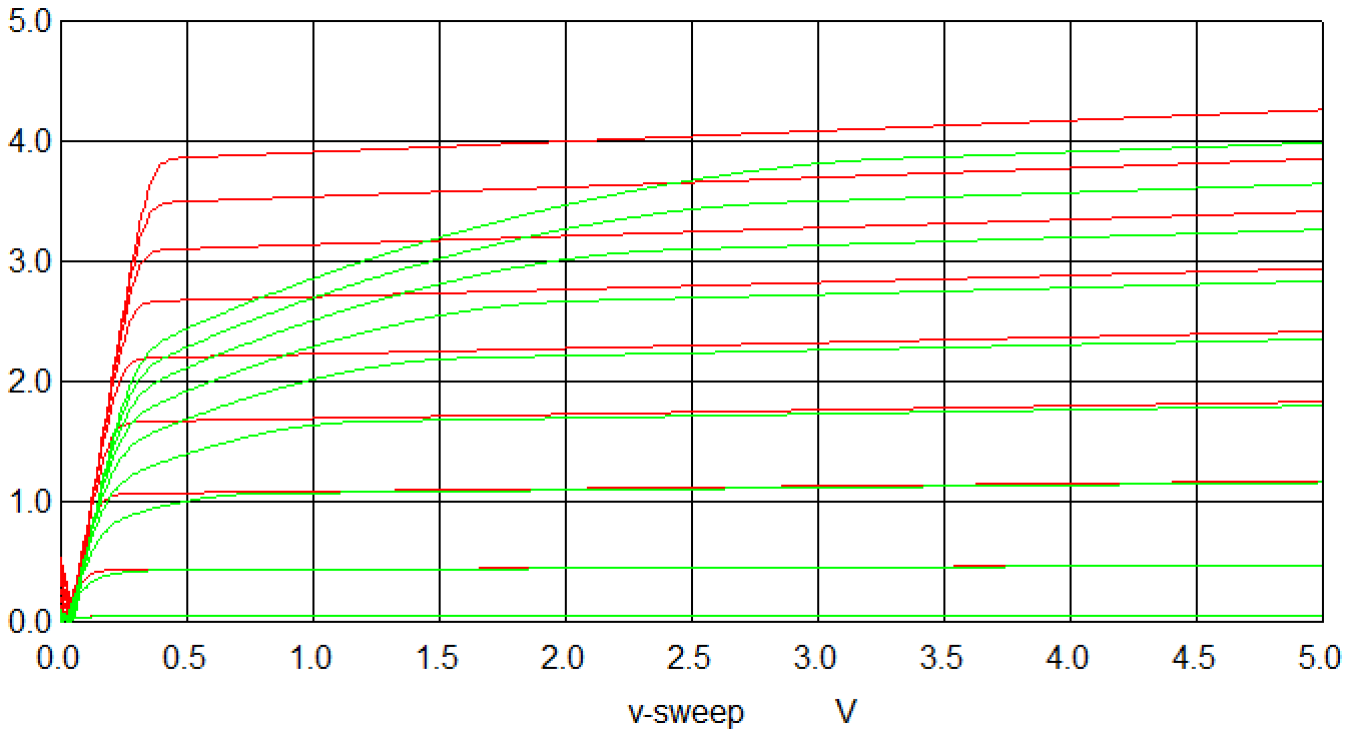
[picture p71: figure]

Figure 7.1: Output characteristic with and w/o Quasi-Saturation

146 | CHAPTER 7. DEVICE MODELS

### 7.3.4 VBIC Model

The VBIC model is an extended development of the Standard Gummel-Poon (SGP) model with the focus of integrated bipolar transistors in today’s modern semiconductor technologies. With the implemented modified Quasi-Saturation model from Kull and Nagel it is also possible to model the special output characteristic of discrete switching and RF transistors. It is a improved alternative to the SGP model for silicon, SiGe and III-V HBT devices.

VBIC Capabilities compared to Standard Gummel-Poon Model:

| • Integrated substrate transistor for parasitic devices in integrated processes
- Weak avalanche and base-emitter breakdown model
- Improved Early effect modeling
- Physical separation of Ic and Ib
- Improved depletion capacitance model
- Improved temperature modeling
- Self-heating modeling

VBIC self-heating model

This model has implemented a simple 1-pole thermal network to cover self-heating effects. That means that the power dissipation is gathered in all branches of the device model and is conducted as an equivalent current Ith into one model node dt. This node has a resistor Rth and capacitor Cth parallel connection to ground. Because the resistor plays the role of the thermal resistance from junction to case the arising voltage at node dt is equivalent the BJT junctions temperature. The model realisizes that this temperature rise leads to deviations for internal resistors, currents and capacitors values, calculated by temperature update equations. This process is included into the ngspice iteration schema for all analyses and is controlled by the model parameter SELFT (SELFT=0: self heating calculation is off (default value), SELFT=1: self-heating is on). In addition the model parameter RTH has to be given.

The simple thermal network of the VBIC model is shown in Fig. 7.2.

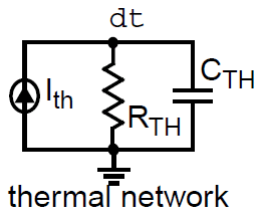
[picture p72: figure]

Figure 7.2: VBIC thermal network

7.3. BJT | 147

How to instantiate the bipolar VBIC model (only minimal version) with self-heating:

vc c 0 0
vb b 0 1
ve e 0 0
vs s 0 0
Q1 c b e s dt mod1 area=1
.model mod1 npn Level=4 selft=1 rth=100

Of course it is possible to connect an more accurate thermal network to the node dt. The following example is showing a simplified thermal network covering the thermal resistances and capacitances of junction-case and case-ambient transitions induced by a heat-sink.

Q1 c b e s dt mod2
.model mod2 npn Level=9 selft=1 rth=20 X1 dt tamb junction-ambient
VTamb tamb 0 30
.subckt junction-ambient jct amb
rjc jct 1 0.4
ccs 1 0 5m
rcs 1 2 0.1
csa 2 0 30m
rsa 2 amb 1.3
.ends

### 7.3.5 HICUM level 2 Model

The physics-based HIgh-CUrrent Model (HICUM) Level2 (L2) has been a standard compact model for bipolar junction transistors and heterojunction bipolar transistors (HBTs) for many years. The model has been shown to be applicable to many process generations of SiGe HBTs and also to InP HBTs, including high-speed and high-voltage device designs. The implemented version in Ngspice is HICUML2/2.4 and can be activated by BJT model parameter level=8.

HICUML2 captures most to all known physical effects relevant in HBTs, in example:

- substrate transistor
- avalanche effect
- physics based transfer current model
- self-heating
- accurate modeling of the temperature dependence
- excess phase between base and collector current

148 | CHAPTER 7. DEVICE MODELS

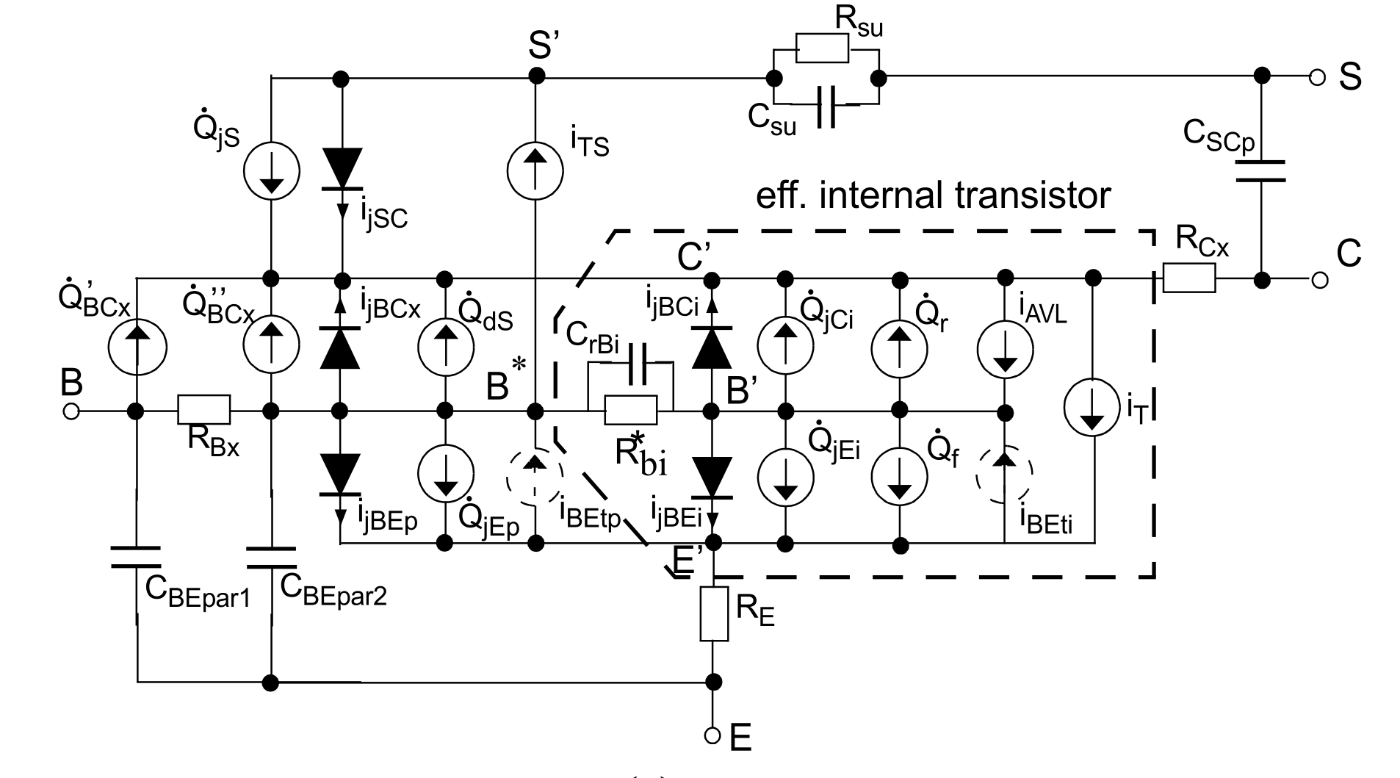
[picture p73: figure]

Figure 7.3: The equivalent circuit of HICUM/L2 without the self-heating, NQS and noise correlation networks.

Note that the noise correlation network is not implemented in Ngspice. More information regarding the model and its parameters can be found on the website. (https://www.iee.et.tu-dresden.de/iee/eb/hic_new/hic_intro.html)

The equivalent circuit of the model is shown in fig. 7.3. The model is employed in many PDKs for state-of-the-art SiGe and InP HBTs and is actively developed at TU Dresden.

The HICUM model exposes the following nodes to the user:

C(ollector) B(ase) E(mitter) S(ubstrate) T(emperature)

By connecting the T and S nodes of the model to other circuit elements, the thermal and substrate network can be modified by the user. Note that both self-heating and the avalanche effect may cause convergency issues if the operating region is too extreme.

The HICUM/L2 model can be initiated like this example:

vc c 0 0
vb b 0 1
ve e 0 0
vs s 0 0
Q1 c b e s dt mod1 area=1
.model mod1 npn Level=8

Self-heating is activated by model parameters FLSH, RTH and connecting T node of the device instance. FLSH = 1 will only consider main thermal contributions of IC and IB, FLSH = 2 include all power dissipations of the transistor.

### 7.3.6 BJT models available via OpenVAF/OSDI

With its integrated OSDI interface (https://semimod.de/projects/) and the OpenVAF (https://openvaf.semimod.de/) compiler (see chapter 9 for details), ngspice makes available more Verilog-A compact BJT models:

7.4. JFETS | 149

### 7.3.6.1 HICUM level 0

HICUM/L0 is being developed to reduce the simulation and design time especially for larger circuits. It addresses, compared to the SPICE Gummel-Poon model, modern BJT and HBT technologies by including more accurate formulations for important physical effects such as forward transit time, base-collector punch-through and collector impact ionization.

### 7.3.6.2 HICUM level 2

HICUM/L2 stands for HIgh CUrrent Model and targets the design of bipolar transistor circuits at high-frequencies and high-current densities using a wide range of Si, SiGe or III-V based process technologies. The compact model that contains accurate formulations of all known physical effects, enables geometry scaling and statistical modeling, and covers a wide temperature, operating and frequency range.

### 7.3.6.3 MEXTRAM 504 and 505

MEXTRAM is an advanced compact model for the description of bipolar transistors. It contains many features that the widely-used Gummel-Poon model lacks. Mextram can be used for advanced processes like double-poly or even SiGe transistors and for high-voltage power devices.

## 7.4 JFETs

### 7.4.1 Junction Field-Effect Transistors (JFETs)

General form:

JXXXXXXX nd ng ns mname <area> <off> <ic=vds,vgs> <temp=t>

Examples:

J1 7 2 3 JM1 OFF

nd, ng, and ns are the drain, gate, and source nodes, respectively. mname is the model name, area is the area factor, and off indicates an (optional) initial condition on the device for dc analysis. If the area factor is omitted, a value of 1.0 is assumed. The (optional) initial condition specification, using ic=VDS,VGS is intended for use with the uic option on the .TRAN control line, when a transient analysis is desired starting from other than the quiescent operating point. See the .ic control line for a better way to set initial conditions. The (optional) temp value is the temperature where this device is to operate, and overrides the temperature specification on the .option control line.

150 | CHAPTER 7. DEVICE MODELS

### 7.4.2 JFET Models (NJF/PJF)

### 7.4.3 Basic model statement

.model JM1 NJF level=1

.model JMOD2 PJF level=2

### 7.4.4 JFET level 1 model with Parker Skellern modification

The JFET level 1 model is derived from the FET model of Shichman and Hodges. The dc characteristics are defined by the parameters VTO and BETA, which determine the variation of drain current with gate voltage, LAMBDA, which determines the output conductance, and IS, the saturation current of the two gate junctions. Two ohmic resistances, RD and RS, are included.

vgst = vgs−V TO | (7.20)
βp = BETA(1+LAMBDA vds) | (7.21)

b f ac =

1−B
PB−V TO

(7.22)

IDrain =

vds·GMIN, | if vgst ≤ 0
βp vds(vds(b f ac vds−B) vgst (2B+3b f ac (vgst −vds))) +vds·GMIN, if vgst ≥ vds βp vgst²
(B+vgst b f ac) +vds·GMIN, | if vgst < vds
| (7.23)

Note that in Spice3f and later, the fitting parameter B has been added by Parker and Skellern. For details, see [9]. If parameter B is set to 1 equation above simplifies to

IDrain =

vds·GMIN, | if vgst ≤ 0
βp vds(2vgst −vds) +vds·GMIN, if vgst ≥ vds
βp vgst² +vds·GMIN, | if vgst < vds

(7.24)

Charge storage is modeled by nonlinear depletion layer capacitances for both gate junctions, which vary as the −¹/2 power of junction voltage and are defined by the parameters CGS, CGD, and PB.

7.4. JFETS | 151
Name | Parameter | Units | Default | Example | Scaling factor
VTO | Threshold voltage VT0 | V | -2.0 | -2.0
BETA | Transconductance parameter (β) | A/V ” | 1.0e-4 | 1.0e-3 | area
LAMBDA | Channel-length modulation parameter (λ) | 1/V | 0 | 1.0e-4
RD | Drain ohmic resistance | Ω | 0 | 100 | 1/area
RS | Source ohmic resistance | Ω | 0 | 100 | 1/area
CGS | Zero-bias G-S junction capacitance Cgs | F | 0 | 5pF | area
CGD | Zero-bias G-D junction capacitance Cgd | F | 0 | 1pF | area
PB | Gate junction potential | V | 1 | 0.6
IS | Gate saturation current IS | A | 1.0e-14 | 1.0e-14 | area
B | Doping tail parameter | - | 1 | 1.1
KF | Flicker noise coefficient | - | 0
AF | Flicker noise exponent | - | 1
NLEV | Noise equation selector | - | 1 | 3
GDSNOI | Channel noise coefficient for nlev=3 | | 1.0 | 2.0
FC | Coefficient for forward-bias depletion capacitance formula | | 0.5
TNOM | Parameter measurement temperature | ◦C | 27 | 50
TCV | Threshold voltage temperature coefficient | 1/°C | 0.0 | 0.01
VTOTC | Threshold voltage temperature coefficient (alternative model) | 1/°C | 0.0 | -2.5m
BEX | Mobility temperature exponent | - | 0.0 | 1.1
BETATCE | Mobility temperature exponent (alternative model) | %/°C | 0.0 | -0.5
XTI | Gate saturation current temperature coefficient | - 3.0
EG | Bandgap voltage | | 1.11

Additional to the standard thermal and flicker noise model an alternative thermal channel noise model is implemented and is selectable by setting NLEV parameter to 3. This leads to a correct channel thermal noise description in the linear region.

Snoise =

2
3

4kT ·BETA·V gst

(1+α +α

2
)
1+α
GDSNOI | (7.25)

with

α =

(
1−

vds
vgs−V TO, if vgs−V TO ≥ vds
0, | else

(7.26)

JFET level 1 model has an alternative temperature model for main parameter VTO and BETA:

152 | CHAPTER 7. DEVICE MODELS
- VTOTC is given:
V TO(Temp) = V TO+V TOTC∗ (Temp−T NOM) | (7.27)
- VTOTC not given:
V TO(Temp) = V TO−TCV ∗ (Temp−T NOM) | (7.28)
- BETATCE is given:

BETA(Temp) = BETA∗ 1.01BETATCE∗(Temp−T NOM) (7.29)

- BETATCE not given:

BETA(Temp) = BETA∗

Temp

T NOM BEX
(7.30)

### 7.4.5 JFET level 2 Parker Skellern model

The level 2 model is an improvement to level 1. Details are available in a pdf (https://ngspice.sourceforge.io/external-documents/models/psfet.pdf) originating from Macquarie University. Some important items are

- The description maintains strict continuity in its high-order derivatives, which is essential for prediction of distortion and intermodulation.
- Frequency dependence of output conductance and transconductance is described as a function of bias.
- Both drain-gate and source-gate potentials modulate the pinch-off potential, which is consistent with S-parameter and pulsed-bias measurements.
- Self-heating varies with frequency.
- Extreme operating regions - subthreshold, forward gate bias, controlled resistance, and breakdown regions - are included.
- Parameters provide independent fitting to all operating regions. It is not necessary to compromise one region in favor of another.
- Strict drain-source symmetry is maintained. The transition during drain-source potential reversal is smooth and continuous.

The model equations are described in this pdf document (https://ngspice.sourceforge.io/external-documents/models/psfet.pdf) and in [19].

7.4. JFETS | 153
Name | Description | Units | Default
ID | Device IDText | Text | PF1
ACGAM | Capacitance modulation | - | 0
BETA | Linear-region transconductance scale | - | 10⁻⁴
CGD | Zero-bias gate-source capacitance | F | 0
CGS | Zero-bias gate-drain capacitance | F | 0
DELTA | Thermal reduction coefficient | 1/W | 0
FC | Forward bias capacitance parameter | - | 0.5
HFETA | High-frequency VGS feedback parameter | - | 0
HFE1 | HFGAM modulation by VGD | 1/V | 0
HFE2 | HFGAM modulation by VGS | 1/V | 0
HFGAM | High-frequency VGD feedback parameter | - | 0
HFG1 | HFGAM modulation by VSG | 1/V | 0
HFG2 | HFGAM modulation by VDG | 1/V | 0
IBD | Gate-junction breakdown current | A | 0
IS | Gate-junction saturation current | A | 10⁻¹⁴
LFGAM | Low-frequency feedback parameter | - | 0
LFG1 | LFGAM modulation by VSG | 1/V | 0
LFG2 | LFGAM modulation by VDG | 1/V | 0
MVST | Subthreshold modulation | 1/V | 0
N | Gate-junction ideality factor | - | 1
P | Linear-region power-law exponent | - | 2
Q | Saturated-region power-law exponent | - | 2
RS | Source ohmic resistance | Ω | 0
RD | Drain ohmic resistance | Ω | 0
TAUD | Relaxation time for thermal reduction | s | 0
TAUG | Relaxation time for gamma feedback | s | 0
VBD | Gate-junction breakdown potential | V | 1
VBI | Gate-junction potential | V | 1
VST | Subthreshold potential | V | 0
VTO | Threshold voltage | V | -2.0
XC | Capacitance pinch-off reduction factor | - | 0
XI | Saturation-knee potential factor | - | 1000
Z | Knee transition parameter | - | 0.5
RG | Gate ohmic resistance | Ω | 0
LG | Gate inductance | H | 0
LS | Source inductance | H | 0
LD | Drain inductance | H | 0
CDSS | Fixed Drain-source capacitance | F | 0
AFAC | Gate-width scale factor | - | 1
NFING | Number of gate fingers scale factor | - | 1
TNOM | Nominal Temperature (Not implemented) | K | 300 K
TEMP | Temperature | K | 300 K

154 | CHAPTER 7. DEVICE MODELS

## 7.5 MESFETs

### 7.5.1 MESFET devices

General form:

ZXXXXXXX ND NG NS MNAME <AREA> <OFF> <IC=VDS, VGS>

Examples:

Z1 7 2 3 ZM1 OFF

### 7.5.2 MESFET Models (NMF/PMF)

.model ZM1 NMF level=1

.model MZMOD PMF level=4

These model statements will use the default parameters (level 1 listed below).

7.5.3 Model by Statz e.a.

The MESFET model level 1 is derived from the GaAs FET model of Statz et al. as described in [11]. The dc characteristics are defined by the parameters VTO, B, and BETA, which determine the variation of drain current with gate voltage, ALPHA, which determines saturation voltage, and LAMBDA, which determines the output conductance. The formula are given by:

Id =

β(Vgs−VTO)

2

1+B(Vgs−VTO)

1−
1−α

Vds
3

3

(1+λVds) for 0 < Vds <

3
α

β(Vgs−VTO)

2

1+B(Vgs−VTO)

(1+λVds) | for Vds ≥

3
α

(7.31)

Two ohmic resistances, RD and RS, are included. Charge storage is modeled by total gate charge as a function of gate-drain and gate-source voltages and is defined by the parameters CGS, CGD, and PB.

7.5. MESFETS | 155
Name | Parameter | Units | Default | Example | Area
VTO | Pinch-off voltage | V | -2.0 | -2.0
BETA | Transconductance parameter | A/V 2 | 1.0e-4 | 1.0e-3 | *
B | Doping tail extending parameter | 1/V | 0.3 | 0.3 | *
ALPHA | Saturation voltage parameter | 1/V | 2 | 2 | *
LAMBDA | Channel-length modulation parameter | 1/V | 0 | 1.0e-4
RD | Drain ohmic resistance | Ω | 0 | 100 | *
RS | Source ohmic resistance | Ω | 0 | 100 | *
CGS | Zero-bias G-S junction capacitance | F | 0 | 5pF | *
CGD | Zero-bias G-D junction capacitance | F | 0 | 1pF | *
PB | Gate junction potential | V | 1 | 0.6
KF | Flicker noise coefficient | - | 0
AF | Flicker noise exponent | - | 1
FC | Coefficient for forward-bias depletion capacitance formula | - 0.5

Device instance:

z1 2 3 0 mesmod area=1.4

Model:

.model mesmod nmf level=1 rd=46 rs=46 vt0=-1.3 + lambda=0.03 alpha=3 beta=1.4e-3

7.5.4 Model by Ytterdal e.a.

level 2 (and levels 3,4) Copyright 1993: T. Ytterdal, K. Lee, M. Shur and T. A. Fjeldly

to be written

M. Shur, T.A. Fjeldly, T. Ytterdal, K. Lee, "Unified GaAs MESFET Model for Circuit Simulation", Int. Journal of High Speed Electronics, vol. 3, no. 2, pp. 201-233, 1992

### 7.5.5 hfet1 and hfet2

hfet1 level 5

Heterostructure Field Effect Transistor model as described in section 4.6 of the book

K. Lee, M. Shur, T. A. Fjeldly and T. Ytterdal, Semiconductor Device Modeling for VLSI, 1993, Prentice Hall, New Jersey.

Model parameters, equivalent circuit diagrams and device equations are also described in the AIM-Spice reference manual, (http://www.aimspice.com/downloads/aimspiceref.2020.100.pdf) section Device Models A.

hfet2 level6

The HFET level 2 model is a simplified version of the level 1 model. The model is optimized for speed and is suitable for simulation of digital circuits. To increase the speed, some of the features included in the level 1 model is not implemented for the level 2 model.

156 | CHAPTER 7. DEVICE MODELS

## 7.6 MOSFETs

Ngspice supports all the original MOSFET models present in SPICE3f5 and almost all the newer ones that have been published and made open-source. Both bulk and SOI (Silicon on Insulator) models are available. When compiled with the cider option, ngspice implements the four terminals numerical model that can be used to simulate a MOSFET (please refer to numerical modeling documentation for additional information and examples).

### 7.6.1 MOSFET devices

General form:

| MXXXXXXX nd ng ns nb mname <m=val> <l=val> <w=val> + <ad=val> <as=val> <pd=val> <ps=val> <nrd=val> + <nrs=val> <off> <ic=vds, vgs, vbs> <temp=t>

Examples:

M1 24 2 0 20 TYPE1
M31 2 17 6 10 MOSN L=5U W=2U
| M1 2 9 3 0 MOSP L=10U W=5U AD=100P AS=100P PD=40U PS=40U

Note the suffixes in the example: the suffix ‘u’ specifies microns (1e-6 m) and ‘p’ sq-microns (1e-12 m²
).

The instance card for MOS devices starts with the letter ’M’. nd, ng, ns, and nb are the drain, gate, source, and bulk (substrate) nodes, respectively. mname is the model name and m is the multiplicity parameter, which simulates ‘m’ paralleled devices. All MOS models support the ‘m’ multiplier parameter. Instance parameters l and w, channel length and width respectively, are expressed in meters. The drain and source diffusion areas are ad and as, in square meters (m²
| ).

If any of l, w, ad, or as are not specified, default values are used. The use of defaults simplifies input file preparation, as well as the editing required if device geometries are to be changed. pd and ps are the perimeters of the drain and source junctions, in meters. nrd and nrs designate the equivalent number of squares of the drain and source diffusions; these values multiply the sheet resistance rsh specified on the .model control line for an accurate representation of the parasitic series drain and source resistance of each transistor. pd and ps default to 0.0 while nrd and nrs to 1.0. off indicates an (optional) initial condition on the device for dc analysis. The (optional) initial condition specification using ic=vds,vgs,vbs is intended for use with the uic option on the .tran control line, when a transient analysis is desired starting from other than the quiescent operating point. See the .ic control line for a better and more convenient way to specify transient initial conditions. The (optional) temp value is the temperature at which this device is to operate, and overrides the temperature specification on the .option control line.

The temperature specification is ONLY valid for level 1, 2, 3, and 6 MOSFETs, not for level 4 or 5 (BSIM) devices.

BSIM3 (v3.2 and v3.3.0), BSIM4 (v4.7 and v4.8) and BSIMSOI models are also supporting the instance parameter delvto and mulu0 for local mismatch and NBTI (negative bias temperature instability) modeling:

7.6. MOSFETS | 157
Name | Parameter | Units | Default | Example
delvto (delvt0) | Threshold voltage shift | V | 0.0 | 0.07
mulu0 | Low-field mobility multiplier (U0) | - | 1.0 | 0.9

### 7.6.2 MOSFET models (NMOS/PMOS)

MOSFET models are the central part of ngspice, probably because they are the most widely used devices in the electronics world. Ngspice provides all the MOSFETs implemented in the original Spice3f and adds several models developed by UC Berkeley’s Device Group (http://www-device.eecs.berkeley.edu/bsim/) and other independent groups.

Each model is invoked with a .model card. A minimal version is:

.model MOSN NMOS level=8 version=3.3.0

The model name MOSN corresponds to the model name in the instance card (see 7.6.1). Parameter NMOS selects an n-channel device, PMOS would point to a p-channel transistor. The LEVEL and VERSION parameters select the specific model. Further model parameters are optional and replace ngspice default values. Due to the large number of parameters (more than 100 for modern models), model cards may be stored in extra files and loaded into the netlist by the .include
(2.8) command. Model cards are specific for a an IC manufacturing process and are typically provided by the IC foundry. Some generic parameter sets, not linked to a specific process, are made available by the model developers, e.g. UC Berkeley’s Device Group (http://www-device.eecs.berkeley.edu/bsim/) for BSIM4 and BSIMSOI.

Ngspice provides several MOSFET device models, which differ in the formulation of the I-V characteristic, and are of varying complexity. Models available are listed in table 7.3. Current models for IC design are BSIM3 (7.6.3.3, down to channel length of 0.25 µm), BSIM4 (7.6.3.4, below 0.25 µm), BSIMSOI (7.6.4, silicon-on-insulator devices), HiSIM2 and HiSIM_HV (7.6.6, surface potential models for standard and high voltage/high power MOS devices).

With the (new in ngspice-39) OpenVAF/OSDI approach (see 9), all modern MOS models, written in Verilog-A, become available, like BSIMBULK, BSIM-CMG and BSIM-IMG, PSP, HiSim etc..

### 7.6.2.1 MOS Level 1

This model is also known as the ‘Shichman-Hodges’ model. This is the first model written and the one often described in the introductory textbooks for electronics. This model is applicable only to long channel devices. The use of Meyer’s model for the C-V part makes it non charge conserving.

### 7.6.2.2 MOS Level 2

This model tries to overcome the limitations of the Level 1 model addressing several short-channel effects, like velocity saturation. The implementation of this model is complicated and this leads to many convergence problems. C-V calculations can be done with the original Meyer model (non charge conserving).

158 | CHAPTER 7. DEVICE MODELS Level Name Model Version Developer References Notes

1 MOS1 Shichman-Hodges - Berkeley This is the classical quadratic model.

2 MOS2 Grove-Frohman - Berkeley Described in [2]

3 MOS3 Berkeley A semi-empirical model (see [1])

4 BSIM1 Berkeley Described in [3]

5 BSIM2 Berkeley Described in [5]

6 MOS6 Berkeley Described in [2]

9 MOS9 Alan Gillespie

8, 49 BSIM3v0 3.0 Berkeley extensions by Alan Gillespie

8, 49 BSIM3v1 3.1 Berkeley extensions by Serban Popescu

8, 49 BSIM3v32 3.2 - 3.2.4 Berkeley Multi version code
8, 49 BSIM3 3.3.0 Berkeley Described in [13]

10, 58 B4SOI 4.3.1 Berkeley

14, 54 BSIM4v5 4.0 - 4.5 Berkeley Multi version code

14, 54 BSIM4v6 4.6.2 Berkeley

14, 54 BSIM4v7 4.7.0 Berkeley

14, 54 BSIM4 4.8.3 Berkeley

55 B3SOIFD Berkeley

56 B3SOIDD Berkeley

57 B3SOIPD Berkeley

60 STAG SOI3 Southampton
68 HiSIM2 2.8.0 Hiroshima

73 HiSIM_HV 1.2.4/2.2.0 Hiroshima High Voltage Version for LDMOS

VDMOS Power MOS ngspice team weak inversion, quasi saturation, self heating
OSDI see 9.2 With its OSDI interface all MOS models written in Verilog-A and compiled with OpenVAF are available Examples: BSIMBULK, BSIM-CMG, BSIM-IMG, PSP, HiSIM (see VA-Models).

Table 7.3: MOSFET model summary

7.6. MOSFETS | 159

### 7.6.2.3 MOS Level 3

This is a semi-empirical model derived from the Level 2 model. In the 80s this model has often been used for digital design and, over the years, has proved to be robust. A discontinuity in the model with respect to the KAPPA parameter has been detected (see [10]). The supplied fix has been implemented in Spice3f2 and later. Since this fix may affect parameter fitting, the option badmos3 may be set to use the old implementation (see the section on simulation variables and the .options line). Ngspice level 3 implementation takes into account length and width mask adjustments (XL and XW) and device width narrowing due to diffusion (WD).

### 7.6.2.4 MOS Level 6

This model is described in [26]. The model can express the current characteristics of short-channel MOSFETs at least down to 0.25 µm channel-length, GaAs FET, and resistance inserted MOSFETs. The model evaluation time is about 1/3 of the evaluation time of the SPICE3 mos level 3 model. The model also enables analytical treatments of circuits in short-channel region and makes up for a missing link between a complicated MOSFET current characteristics and circuit behaviors in the deep submicron region.

### 7.6.2.5 Notes on Level 1-6 models

The dc characteristics of the level 1 through level 3 MOSFETs are defined by the model parameters VTO, KP, LAMBDA, PHI and GAMMA. These parameters are computed by ngspice if process parameters (NSUB, TOX, ...) are given, but users specified values always override. VTO is positive (negative) for enhancement mode and negative (positive) for depletion mode N-channel (P-channel) devices.

Charge storage is modeled by three constant capacitors, CGSO, CGDO and CGBO, which represent overlap capacitances, by the nonlinear thin-oxide capacitance that is distributed among the gate, source, drain, and bulk regions, and by the nonlinear depletion-layer capacitances for both substrate junctions divided into bottom and periphery, which vary as the MJ and MJSW power of junction voltage respectively, and are determined by the parameters CBD, CBS, CJ, CJSW, MJ, MJSW and PB.

Charge storage effects are modeled by the piecewise linear voltages-dependent capacitance model proposed by Meyer. The thin-oxide charge-storage effects are treated slightly different for the level 1 model. These voltage-dependent capacitances are included only if TOX is specified in the input description and they are represented using Meyer’s formulation.

There is some overlap among the parameters describing the junctions, e.g. the reverse current can be input either as IS (in A) or as JS (in A/m
2

). Whereas the first is an absolute value the second is multiplied by ad and as to give the reverse current of the drain and source junctions respectively.

This methodology has been chosen since there is no sense in relating always junction characteristics with ad and as entered on the device line; the areas can be defaulted. The same idea applies also to the zero-bias junction capacitances CBD and CBS (in F) on one hand, and CJ (in

F/m
2

) on the other.

160 | CHAPTER 7. DEVICE MODELS

The parasitic drain and source series resistance can be expressed as either RD and RS (in ohms) or RSH (in ohms/sq.), the latter being multiplied by the number of squares nrd and nrs input on the device line.

MOS level 1, 2, 3 and 6 parameters

Name | Parameter | Units | Default | Example
LEVEL | Model index | - | 1
VTO | Zero-bias threshold voltage (VT0) | V | 0.0 | 1.0
KP GAMMA | Transconductance parameter Bulk threshold parameter | A/V 2 √ | 2.0e-5 | 3.1e-5
| | V | 0.0 | 0.37
PHI | Surface potential (U) | V | 0.6 | 0.65
LAMBDA | Channel length modulation (MOS1 and MOS2 only) (λ) | 1/V | 0.0 | 0.02
RD | Drain ohmic resistance | Ω | 0.0 | 1.0
RS | Source ohmic resistance | Ω | 0.0 | 1.0
CBD | Zero-bias B-D junction capacitance | F | 0.0 | 20fF
CBS | Zero-bias B-S junction capacitance | F | 0.0 | 20fF
IS | Bulk junction saturation current (IS) | A | 1.0e-14 | 1.0e-15
PB | Bulk junction potential | V | 0.8 | 0.87
CGSO | Gate-source overlap capacitance per meter channel width | F/m | 0.0 | 4.0e-11
CGDO | Gate-drain overlap capacitance per meter channel width | F/m | 0.0 | 4.0e-11
CGBO | Gate-bulk overlap capacitance per meter channel width | F/m | 0.0 | 2.0e-11
RSH | Drain and source diffusion sheet resistance | Ω/□ | 0.0 | 10
CJ | Zero-bias bulk junction bottom cap. per sq-meter of junction area | F/m 2 | 0.0 | 2.0e-4
MJ | Bulk junction bottom grading coeff. | - | 0.5 | 0.5
CJSW | Zero-bias bulk junction sidewall cap. per meter of junction perimeter | F/m | 0.0 | 1.0e-9

7.6. MOSFETS | 161
Name | Parameter | Units | Default | Example
MJSW | Bulk junction sidewall grading coeff. | - | 0.50 (level1) 0.33 (level2,3)
JS | Bulk junction saturation current
TOX | Oxide thickness | m | 1.0e-7 | 1.0e-7
NSUB | Substrate doping | cm⁻³ | 0.0 | 4.0e15
NSS | Surface state density | cm⁻² | 0.0 | 1.0e10
NFS | Fast surface state density | cm⁻² | 0.0 | 1.0e10
TPG | Type of gate material: +1 opp. to substrate, -1 same as substrate, 0 Al gate | - 1.0
XJ | Metallurgical junction depth | m | 0.0 | 1M
LD | Lateral diffusion | m | 0.0 | 0.8M
UO | Surface mobility | cm² /V·sec | 600 | 700
UCRIT | Critical field for mobility degradation (MOS2 only) | V/cm | 1.0e4 | 1.0e4
UEXP | Critical field exponent in mobility degradation (MOS2 only) | - | 0.0 | 0.1
UTRA | Transverse field coeff. (mobility) (deleted for MOS2) | - | 0.0 | 0.3
VMAX | Maximum drift velocity of carriers | m/s | 0.0 | 5.0e4
NEFF | Total channel-charge (fixed and mobile) coefficient (MOS2 only) | - | 1.0 | 5.0
KF | Flicker noise coefficient | - | 0.0 | 1.0e-26
AF | Flicker noise exponent | - | 1.0 | 1.2
NLEV | Noise equation selector | - | 1 | 3
GDSNOI | Channel noise coefficient for nlev=3 | | 1.0 | 2.0
FC | Coefficient for forward-bias depletion capacitance formula | - 0.5
DELTA | Width effect on threshold voltage (MOS2 and MOS3) | - | 0.0 | 1.0
THETA | Mobility modulation (MOS3 only) | 1/V | 0.0 | 0.1
ETA | Static feedback (MOS3 only) | - | 0.0 | 1.0
KAPPA | Saturation field factor (MOS3 only) | - | 0.2 | 0.5
TNOM | Parameter measurement temperature | ◦C | 27 | 50

162 | CHAPTER 7. DEVICE MODELS

### 7.6.2.6 MOS Level 9

Documentation is not available..

### 7.6.3 BSIM Models

Ngspice implements many of the BSIM models developed by Berkeley’s BSIM group. (http://bsim.berkeley.edu/) BSIM stands for Berkeley Short-Channel IGFET Model and groups a class of models that is continuously updated. BSIM3 (7.6.3.3) and BSIM4 (7.6.3.4) are industry standards for CMOS processes down to 0.15 µm (BSIM3) and below (BSIM4), are very stable and are supported by model parameter sets from foundries all over the world. BSIM1 and BSIM2 are obsolete today.

In general, all parameters of BSIM models are obtained from process characterization, in particular level 4 and level 5 (BSIM1 and BSIM2) parameters can be generated automatically.
J. Pierret [4] describes a means of generating a ‘process’ file, and the program ngproc2mod provided with ngspice converts this file into a sequence of BSIM1 .model lines suitable for inclusion in an ngspice input file.

Parameters marked below with an * in the l/w column also have corresponding parameters with a length and width dependency. For example, VFB is the basic parameter with units of Volts, and LVFB and WVFB also exist and have units of Volt-meter.

The formula

P = P0 +

PL

Leffective

+

PW

Weffective

(7.32)

is used to evaluate the parameter for the actual device specified with

Leffective = Linput −DL | (7.33)
Weffective = Winput −DW | (7.34)

Note that unlike the other models in ngspice, the BSIM models are designed for use with a process characterization system that provides all the parameters, thus there are no defaults for the parameters, and leaving one out is considered an error. For an example set of parameters and the format of a process file, see the SPICE2 implementation notes [3]. For more information on BSIM2, see reference [5]. BSIM3 (7.6.3.3) and BSIM4 (7.6.3.4) represent state of the art for submicron and deep submicron IC design.

### 7.6.3.1 BSIM1 model (level 4)

BSIM1 model (the first is a long series) is an empirical model. Developers placed less emphasis on device physics and based the model on parametrical polynomial equations to model the various physical effects. This approach pays in terms of circuit simulation behavior but the accuracy degrades in the submicron region. A known problem of this model is the negative output conductance and the convergence problems, both related to poor behavior of the polynomial equations.

7.6. MOSFETS | 163

BSIM1 (level 4) parameters

Name | Parameter | Units | l/w
VFB | Flat-band voltage | V | *
PHI K1 | Surface inversion potential Body effect coefficient | V √ | *
| | V | *
K2 | Drain/source depletion charge-sharing coefficient | - *
ETA | Zero-bias drain-induced barrier-lowering coefficient | - *
MUZ | Zero-bias mobility | cm² /V·sec
DL | Shortening of channel | µm
DW | Narrowing of channel | µm
U0 | Zero-bias transverse-field mobility degradation coefficient | 1/V | *
U1 | Zero-bias velocity saturation coefficient | µ/V | *
X2MZ | Sens. of mobility to substrate bias at v=0 | cm² /V 2 ·sec | *
X2E | Sens. of drain-induced barrier lowering effect to substrate bias | 1/V | *
X3E | Sens. of drain-induced barrier lowering effect to drain bias at Vds = Vdd | 1/V | *
X2U0 | Sens. of transverse field mobility degradation effect to substrate bias | 1/V 2 | *
X2U1 | Sens. of velocity saturation effect to substrate bias | µm/V 2 | *
MUS | Mobility at zero substrate bias and at Vds = Vdd | cm² /V 2 sec
X2MS | Sens. of mobility to substrate bias at Vds = Vdd | cm² /V 2 sec | *
X3MS | Sens. of mobility to drain bias at Vds = Vdd | cm² /V 2 sec | *
X3U1 | Sens. of velocity saturation effect on drain bias at Vds=Vdd | µm/V 2 | *
TOX | Gate oxide thickness | µm
TEMP | Temperature where parameters were measured | ◦C
VDD | Measurement bias range | V
CGDO | Gate-drain overlap capacitance per meter channel width | F/m
CGSO | Gate-source overlap capacitance per meter channel width | F/m
CGBO | Gate-bulk overlap capacitance per meter channel length | F/m
XPART | Gate-oxide capacitance-charge model flag | -
N0 | Zero-bias subthreshold slope coefficient | - | *
NB | Sens. of subthreshold slope to substrate bias | - | *
ND | Sens. of subthreshold slope to drain bias | - | *
RSH | Drain and source diffusion sheet resistance | Ω/□
JS | Source drain junction current density | A/m 2
PB | Built in potential of source drain junction | V
MJ | Grading coefficient of source drain junction | -

164 | CHAPTER 7. DEVICE MODELS
Name | Parameter | Units | l/w
PBSW | Built in potential of source, drain junction sidewall | V
MJSW | Grading coefficient of source drain junction sidewall | -
CJ | Source drain junction capacitance per unit area | F/m 2
CJSW | source drain junction sidewall capacitance per unit length | F/m
WDF | Source drain junction default width | m
DELL | Source drain junction length reduction | m

XPART=0 selects a 40/60 drain/source charge partition in saturation, while XPART=1 selects a 0/100 drain/source charge partition. nd, ng, and ns are the drain, gate, and source nodes, respectively. mname is the model name, area is the area factor, and off indicates an (optional) initial condition on the device for dc analysis. If the area factor is omitted, a value of 1.0 is assumed. The (optional) initial condition specification, using ic=vds,vgs is intended for use with the uic option on the .tran control line, when a transient analysis is desired starting from other than the quiescent operating point. See the .ic control line for a better way to set initial conditions.

### 7.6.3.2 BSIM2 model (level 5)

This model contains many improvements over BSIM1 and is suitable for analog simulation. Nevertheless, even BSIM2 breaks transistor operation into several distinct regions and this leads to discontinuities in the first derivative in C-V and I-V characteristics that can cause numerical problems during simulation.

### 7.6.3.3 BSIM3 model (levels 8, 49)

BSIM3 solves the numerical problems of previous models with the introduction of smoothing functions. It adopts a single equation to describe device characteristics in the operating regions. This approach eliminates the discontinuities in the I-V and C-V characteristics. The original model, BSIM3 (http://bsim.berkeley.edu/models/bsim3/) evolved through three versions: BSIM3v1, BSIM3v2 and BSIM3v3. Both BSIM3v1 and BSIM3v2 had suffered from many mathematical problems and were replaced by BSIM3v3. The latter is the only surviving release and has itself a long revision history.

The following table summarizes the story of this model and their available ngspice versions:

Release | Date | Notes | Version flag
BSIM3v3.0 | 10/30/1995 | | 3.0
BSIM3v3.1 | 12/09/1996 | | 3.1
BSIM3v3.2 | 06/16/1998 | Revisions available: BSIM3v3.2.2, BSIM3v3.2.3, and BSIM3v3.2.4 Parallel processing with OpenMP is available for BSIM3v3.2.4. | 3.2, 3.2.2, 3.2.3, 3.2.4
BSIM3v3.3 | 07/29/2005 | Parallel processing with OpenMP is available for this model. | 3.3.0

7.6. MOSFETS | 165

BSIM3v2 and 3v3 models have been proven for accurate use in 0.18 µm technologies. The model is publicly available as source code (http://bsim.berkeley.edu/BSIM4/BSIM3/ftpv330.zip) form from University of California, Berkeley.

A detailed description is given in the user’s manual available from here (http://ngspice.sourceforge.net/external-documents/models/bsim330_manual.pdf) .

We recommend that you use only the most recent BSIM3 models (version 3.3.0), because it contains corrections to all known bugs. To achieve that, change the version parameter in your modelcard files to

VERSION = 3.3.0.

If no version number is given in the .model card, this (newest) version is selected as the default.

A basic model card using only the intrinsic default parameters may look like

.model n1 nmos level=49 version=3.3.0
.model p1 pmos level=49 version=3.3.0

Unfortunately, due to historical reasons, these purely intrinsic parameters do not describe realistic devices. A better minimum model configuration, roughly describing 0.35µm transistors, is

.model n1 nmos level=49 version=3.3.0 tox=10n nch=1e17 nsub=5e16 .model p1 pmos level=49 version=3.3.0 tox=10n nch=1e17 nsub=5e16

BSIM3v3.2.4 supports the extra model parameter LMLT on channel length scaling and is still used by many foundries today.

The older BSIM3 models will not be supported, they are made available for reference only.

### 7.6.3.4 BSIM4 model (levels 14, 54)

This is the newest class of the BSIM family and introduces noise modeling and extrinsic parasitics. BSIM4, as the extension of BSIM3 model, addresses the MOSFET physical effects into sub-100nm regime. It is a physics-based, accurate, scalable, robust and predictive MOSFET SPICE model for circuit simulation and CMOS technology development. It is developed by the BSIM Research Group in the Department of Electrical Engineering and Computer Sciences (EECS) at the University of California, Berkeley (see BSIM4 home page). (http://bsim.berkeley.edu/models/bsim4/) BSIM4 has a long revision history. The models offered by ngspice are summarized below.

Release | Date | Notes | Version flag
BSIM4.5.0 | 07/29/2005 | ** | 4.5.0
BSIM4.6.5 | 22/09/2009 | ** | 4.6.5
BSIM4.7.0 | 04/08/2011 | ** | 4.7
BSIM4.8.3 | 19/05/2025 | ** | 4.8

**) Parallel processing using OpenMP support is available for this model.

Details of any revision are to be found in the Berkeley user’s manuals, a pdf download of the most recent edition is to be found here. (http://ngspice.sourceforge.net/external-documents/models/BSIM480_Manual.pdf)

We recommend that you use only the most recent BSIM4 model (version 4.8.3), because it contains corrections to all known bugs. To achieve that, change the version parameter in your modelcard files to

166 | CHAPTER 7. DEVICE MODELS

VERSION = 4.8.3

If no version number is given in the .model card, this (newest) version is selected as the default. The older models will typically not be supported, they are made available for reference only. All version parameter starting with 4.8 will use the code of the recent version.

The basic model card, using only the intrinsic default parameters, already delivers reasonable device characteristics.

.model n1 nmos level=54 version=4.8.3 .model p1 pmos level=54 version=4.8.3

### 7.6.4 BSIMSOI models (levels 10, 58, 55, 56, 57)

BSIMSOI is a SPICE compact model for SOI (Silicon-On-Insulator) circuit design, created by University of California at Berkeley. (http://bsim.berkeley.edu/models/bsimsoi/) This model is formulated on top of the BSIM3 framework. It shares the same basic equations with the bulk model so that the physical nature and smoothness of BSIM3v3 are retained. Four models are supported in ngspice, those based on BSIM3 and modeling fully depleted (FD, level 55), partially depleted (PD, level 57) and both (DD, level 56), as well as the modern BSIMSOI version 4 model (levels 10, 58). Detailed descriptions are beyond the scope of this manual, but see e.g. BSIMSOIv4.4 User Manual (http://ngspice.sourceforge.net/external-documents/models/BSIMSOIv4.4_UsersManual.pdf) for a very extensive description of the recent model version. OpenMP support is available for levels 10, 58, version 4.4.

### 7.6.5 SOI3 model (level 60)

see literature citation [18] for a description.

### 7.6.6 HiSIM models of the University of Hiroshima

There are two model implementations available - see also HiSIM Research Center: (https://www.hisim.hiroshima-u.ac.jp/index.php?id=87)

1. HiSIM2 model: Surface-Potential-Based MOSFET Model for Circuit Simulation version 2.8.0 - level 68 (see link to HiSIM2 (http://home.hiroshima-u.ac.jp/usdl/HiSIM2/HiSIM_2.5.1_Release_20110407.zip) for source code and manual).
2. HiSIM_HV model: Surface-Potential-Based HV/LD-MOSFET Model for Circuit Simulation version 1.2.4 and 2.2.0 - level 73 (see link to HiSIM_HV (http://home.hiroshima-u.ac.jp/usdl/HiSIM_HV/C-Code/HiSIM_HV_1.2.2_Release_20110629.zip) for source code and manual).

### 7.6.7 MOS models available via OpenVAF/OSDI

With its integrated OSDI interface (https://semimod.de/projects/) and the OpenVAF (https://openvaf.semimod.de/) compiler (see chapter 9 for details), ngspice makes available several Verilog-A compact MOS models. To obtain the sources you may visit the github repository VA-Models (https://github.com/dwarning/VA-Models) which assembles most of the publicly available Verilog-A compact models. To just name a few models:

7.7. POWER MOSFET MODEL (VDMOS) | 167

### 7.6.7.1 PSP model

The PSP model is a compact MOSFET model intended for digital, analog and RF-design, which is jointly developed by NXP Semiconductors Research (formerly part of Philips), different universities and CEA-Leti.

PSP is a surface-potential based MOS Model, containing all relevant physical effects to model present-day and upcoming deep-submicron bulk CMOS technologies:

- mobility reduction
- velocity saturation drain induced barrier lowering DIBL
- gate current
- lateral doping gradient effects
- STI stress

The source/drain junction model, c.q. the JUNCAP2 model, is fully integrated in PSP. Detailes information and the most recent version of the model documentation are available on the the CEA-Leti web site, (https://www.cea.fr/cea-tech/leti/pspsupport/CurrentRelease) see also the PSP Summary. (https://www.cea.fr/cea-tech/leti/pspsupport/Documents/psp103p8_summary.pdf)

### 7.6.7.2 BSIM-BULK model

BSIM-BULK (http://bsim.berkeley.edu/models/bsimbulk/) is the successor to BSIM4, with high accuracy compared to measured data in all regions of operation. It features model symmetry valued for analog and RF applications.

### 7.6.7.3 BSIM-CMG model

BSIM-CMG (http://bsim.berkeley.edu/models/bsimcmg/) (Common Multi-Gate) is a compact model for the class of common multi-gate FETs, namely FinFETs, Nanowire and Gate-All-Around transistors.

### 7.6.7.4 EKV3

EKV3 (https://github.com/MatBucher/ekv3model) Due to CMOS scaling, ICs operate more and more in moderate and weak inversion. Evolution of CMOS device performance – from planar bulk to double-gate and FinFET. The model is a charge-based compact model – close to physics and design. Modularity allows high-frequency application with special attention to analog/RF IC design requirements.

## 7.7 Power MOSFET model (VDMOS)

The VDMOS model is a relativly simple power MOS model with 3 terminals drain, gate and source. Its current equations are partly based on a modified MOS1 model. The gate-source capacitance is set to a constant value by model parameter CGS. The drain-source capacitance is evaluated from parameters CGDMAX, CGDMIN, and A. The drain-source capacitance is that of a parallel pn diode and calculated by CJO, FC, and M. Leakage and breakdown are modeled by

168 | CHAPTER 7. DEVICE MODELS

the parallel pn diodes as well, using is and other parameters. A subthreshold current model is available, using a single parameter KSUBTHRES. Quasi-saturation is modelled with parameters RQ and VQ. MTRIODE may be used here as well.

The thermal network of the VDMOS model is shown in Fig. 7.4.

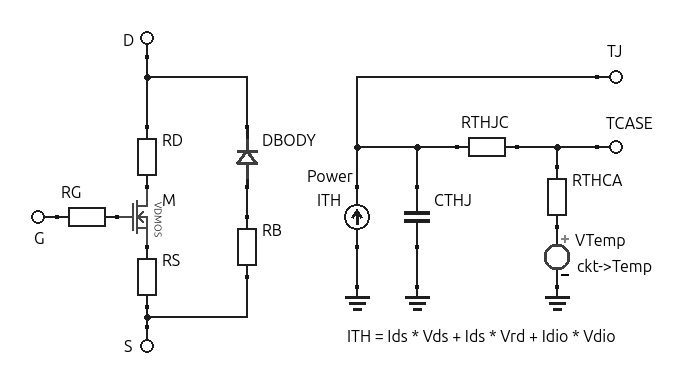
[picture p74: figure]

Figure 7.4: VDMOS model including thermal network

This model does not have a level parameter. It is invoked by the VDMOS token preceding the parameters on the .model line. P-channel or n-channel are selected by the model parameter PCHAN and NCHAN. If no flag is given, n-channel is the default. Standard MOS instance parameters W and L are not acknowledged because they are no design parameters and are not provided by the device manufacturers.

The following ’parameters’ in the .model line are no model parameters, but serve information purposes for the user: mfg=..., Vds=..., Ron=..., and Qg=... They are ignored by ngspice.

General form:

MXXXXXXX nd ng ns mname <m=val> <temp=t> <dtemp=t> .model mname VDMOS <Pchan> <parameters>

Example:

M1 24 2 0 IXTH48P20P
.MODEL IXTH48P20P VDMOS Pchan Vds=200 VTO=-4 KP=10 Lambda=5m + Mtriode=0.3 Ksubthres=120m Rs=10m Rd=20m Rds=200e6
+ Cgdmax=6000p Cgdmin=100p A=0.25 Cgs=5000p Cjo=9000p
+ Is=2e-6 Rb=20m BV=200 IBV=250e-6 NBV=4 TT=260e-9

VDMOS instance parameters

7.7. POWER MOSFET MODEL (VDMOS) | 169
Name | Parameter | Units | Default | Example
m | device multiplier | - | 1 | -
off | Device initially off | - | 0
icvds | Initial D-S voltage | V | 0.0
icvgs | Initial G-S voltage | V | 0.0
temp | device temperature | ◦C | 27 | 100
dtemp | device temperature difference | ◦C | 0.0 | 50
ic | Vector of D-S, G-S voltages | V | 0.0
thermal | Thermal model switch on/off | - -

170 | CHAPTER 7. DEVICE MODELS

VDMOS model parameters

Name | Parameter | Units | Default | Example
VDMOS | select VDMOS model | - | must given | -
NCHAN | nch type transistor | - | default, if not given | -
PCHAN | pch type transistor | - | required, if PMOS | -
VTO | Zero-bias threshold voltage (VT0) | V | 3.0 | 4
KP | Transconductance parameter | A/V 2 | 25+10*chantype | 5.9
PHI | Surface potential | V
LAMBDA | Channel length modulation (λ) | 1/V | 0.0 | 0.001
THETA | Vgs influence on mobility | 1/V | 0.0 | 0.015
RD | Drain ohmic resistance | Ω | 0.0 | 61m
RS | Source ohmic resistance | Ω | 0.0 | 18m
RG | Gate ohmic resistance | Ω | 0.0 | 3
KF | Flicker noise coefficient | - | 0.0
AF | Flicker noise exponent | - | 1.0
TNOM | Parameter measurement temperature | ◦C | 27 | 25
RQ | Quasi saturation resistance fitting parameter | Ω | 0.0 | 0.5
VQ | Quasi saturation voltage fitting parameter | V | 0.0 | 100
MTRIODE | Conductance multiplier in triode region | − | 1.0 | 0.8
SUBSHIFT | shift along gate voltage axis in the dual parameter subthreshold model | V | 0.0
KSUBTHRES | slope in the single parameter subthreshold model | - | 0.1 | 0.27
BV | Vds breakdown voltage | V | ∞
IBV | Current at Vds=bv | A | 1.0e-10
NBV | Vds breakdown emission coefficient | - 1.0
RDS | Drain-source shunt resistance | Ω | ∞ | 1e7
RB | Body diode ohmic resistance | Ω | 0.0 | 14m
N | Body diode emission coefficient | - | 1.0 | 1.1
TT | Body diode transit time | s | 0.0

7.7. POWER MOSFET MODEL (VDMOS) | 171
Name | Parameter | Units | Default | Example
EG | Body diode activation energy for temperature effect on IS | eV | 1.11
XTI | Body diode saturation current temperature exponent | - | 3.0 | 3.2
IS | Body diode saturation current | A | 1e-14 | 60p
VJ | Body diode junction potential | V | 0.8
FC | Body diode coefficient for forward-bias depletion capacitance formula | - 0.5
CJO | Zero-bias body diode junction capacitance | F | 0.5n | 1.5n
M | Body diode grading coefficient | - | 0.5 | 0.6
CGDMIN | Minimum non-linear G-D capacitance | F | 20p | 10p
CGDMAX | Maximum non-linear G-D capacitance | F | 2n | 2.45n
A | Non-linear Cgd capacitance parameter | - | 1 | 0.3
CGS | Gate-source capacitance | F | 1.4n | 1.2n
TCVTH (VTOTC) | Linear Vth0 temperature coefficient | 1/°C | 0.0 | 0.0065
MU (BEX) | Exponent of gain temperature dependency | - | -1.5 | -1.27
TEXP0 | Drain resistance rd0 temperature exponent | - 1.5
TEXP1 | Drain resistance rd1 temperature exponent | - 0.3
TRD1 | Drain resistance linear temperature coefficient | 1/°C | 0.0
TRD2 | Drain resistance quadratic temperature coefficient | 1/(°C) 2 | 0.0
TRG1 | Gate resistance linear temperature coefficient | 1/°C | 0.0
TRG2 | Gate resistance quadratic temperature coefficient | 1/(°C) 2 | 0.0
TRS1 | Source resistance linear temperature coefficient | 1/°C | 0.0

172 | CHAPTER 7. DEVICE MODELS
Name | Parameter | Units | Default | Example
TRS2 | Source resistance quadratic temperature coefficient | 1/(°C) 2 | 0.0
TRB1 | Body resistance linear temperature coefficient | 1/°C | 0.0
TRB2 | Body resistance quadratic temperature coefficient | 1/(°C) 2 | 0.0
TKSUBTHRES1 | Linear temperature coefficient of ksubthres | 1/°C | 0.0
TKSUBTHRES2 | Quadratic temperature coefficient of ksubthres | 1/(°C) 2 | 0.0
RTHJC | Thermal resistance junction-case | K/W | 1.0 | 0.4
CTHJ | Thermal capacitance | J/K | 10e-6 | 5e-3
RTHCA | Thermal resistance case-ambient (w/o heatsink) | K/W | 1000

VDMOS electro-thermal model

Power electronic devices behavior the effect of self-heating effect. That means that the dissipated power has an impact to the electrical behavior of the terminal currents. To minimize this effect and to protect the element from thermal destruction heat sinks are supplied to this kind of power devices.

The ngspice VDMOS model has introduced an electro-thermal approach by stamping additional elements into the circuit matrix and by iteration the additional current control inside the spice solver.

The transistor now has 5 terminals. Besides D, G, and S we have TJ and TCASE. The additional terminals must be activated by the device switch THERMAL. Heat is generated in the MOS channel and peripheral elements like resistors, its temperature is available and may be measured at node TJ, and is fed back internally into the device equations. Within the transistor package the heat is flowing from the channel to the metal surface of the case, at terminal TCASE. Here you may connect a heat sink, to offer a flow path for the heat away from the device. The internal heat resistance is RTHJC (junction to case), a typical data sheet value. The model also includes the heat capacitance CTHJ of the semiconductor die and package (typically not available in the data sheet, so to be estimated only). Internal model resistor RTHCA (case to ambient) is connected to internal voltage source with a value of circuit temperature Tamb and act as an alternative for a missing external heat sink.

The following example show the usage of ngspice electro-thermal model including a simple heat sink:

7.7. POWER MOSFET MODEL (VDMOS) | 173

General form:

MXXXXXXX nd ng ns tj tc mname thermal <m=val> <temp=t> <dtemp=t>

Example:

M1 24 2 0 tj tc IXTH48P20P thermal rcs tc 1 0.1
csa 1 0 30m
rsa 1 amb 1.3
VTamb tamb 0 25
.MODEL IXTH48P20P VDMOS Pchan Vds=200 VTO=-4 KP=10 Lambda=5m + Mtriode=0.3 Ksubthres=120m Rs=10m Rd=20m Rds=200e6
+ Cgdmax=6000p Cgdmin=100p A=0.25 Cgs=5000p Cjo=9000p
+ Is=2e-6 Rb=20m BV=200 IBV=250e-6 NBV=4 TT=260e-9
+ Rthjc=0.4 Cthj=5e-3

174 | CHAPTER 7. DEVICE MODELS

# Chapter 8

# Mixed-Mode and Behavioral Modeling with XSPICE

Ngspice implements XSPICE extensions for behavioral and mixed-mode (analog and digital) modeling. In the XSPICE framework this is referred to as code level modeling. Behavioral modeling may benefit dramatically because XSPICE offers a means to add analog functionality programmed in C. Many examples (amplifiers, oscillators, filters ...) are presented in the following. Even more flexibility is available because you may define your own models and use them in addition and in combination with all the already existing ngspice functionality. Digital and mixed mode simulation is sped up significantly by simulating the digital part in an event driven manner, in that state equations use only a few allowed states and are evaluated only during switching, and not continuously in time and signal as in a pure analog simulator.

This chapter describes the predefined models available in ngspice, stemming from the original XSPICE simulator or being added to enhance the usability. The instructions for writing new code models are given in Chapt. 24.

To make use of the XSPICE extensions, you need to compile them in. Linux, CYGWIN, MINGW and other users may add the flag --enable-xspice to their ./configure command and then recompile. The pre-built ngspice for Windows distribution has XSPICE already enabled. For detailed compiling instructions see Chapt. 28.1.

## 8.1 Code Model Element & .MODEL Cards

### 8.1.1 Syntax

Ngspice includes a library of predefined ‘Code Models’ that can be placed within any circuit description in a manner similar to that used to place standard device models. Code model instance cards always begin with the letter ‘A’, and always make use of a .MODEL card to describe the code model desired. Section 24 of this document goes into greater detail as to how a code model similar to the predefined models may be developed, but once any model is created and linked into the simulator it may be placed using one instance card and one .MODEL card (note here we conform to the SPICE custom of referring to a single logical line of information as a ‘card’). As an example, the following uses a predefined ‘gain’ code model taking as an input some value on node 1, multiplies it by a gain of 5.0, and outputs the new value to node 2.

175

176 CHAPTER 8. MIXED-MODE AND BEHAVIORAL MODELING WITH XSPICE

Note that, by convention, input ports are specified first on code models. Output ports follow the inputs.

Example:

a1 1 2 amp
.model amp gain(gain=5.0)

In this example the numerical values picked up from single-ended (i.e. ground referenced) input node 1 and output to single-ended output node 2 will be voltages, since in the Interface Specification File for this code model (i.e., gain), the default port type is specified as a voltage (more on this later). However, if you didn’t know this, the following modifications to the instance card could be used to insure it:

Example:

a1 %v(1) %v(2) amp
.model amp gain(gain=5.0)

The specification %v preceding the input and output node numbers of the instance card indicate to the simulator that the inputs to the model should be single-ended voltage values. Other possibilities exist, as described later.

Some of the other features of the instance and .MODEL cards are worth noting. Of particular interest is the portion of the .MODEL card that specifies gain=5.0. This portion of the card assigns a value to a parameter of the ‘gain’ model. There are other parameters that can be assigned values for this model, and in general code models will have several. In addition to numeric values, code model parameters can take non-numeric values (such as TRUE and FALSE), and even vector values. All of these topics will be discussed at length in the following pages. In general, however, the instance and .MODEL cards that define a code model will follow the abstract form described below. This form illustrates that the number of inputs and outputs and the number of parameters that can be specified is relatively open-ended and can be interpreted in a variety of ways (note that angle-brackets ‘<’ and ‘>’ enclose optional inputs):

8.1. CODE MODEL ELEMENT & .MODEL CARDS | 177

Example:

AXXXXXXX <%v,%i,%vd,%id,%g,%gd,%h,%hd, or %d> + <[> <~><%v,%i,%vd,%id,%g,%gd,%h,%hd, or %d> + <NIN1 or +NIN1 -NIN1 or "null">
+ <~>...<NIN2.. <]> >
+ <%v,%i,%vd,%id,%g,%gd,%h,%hd,%d or %vnam> + <[> <~><%v,%i,%vd,%id,%g,%gd,%h,%hd,
or %d><NOUT1 or +NOUT1 -NOUT1>
+ <~>...<NOUT2.. <]>>
+ MODELNAME

.MODEL MODELNAME MODELTYPE
+ <( PARAMNAME1= <[> VAL1 <VAL2... <]>> PARAMNAME2..>)>

Square brackets ([ ]) are used to enclose vector input nodes. In addition, these brackets are used to delineate vectors of parameters.

The literal string ‘null’, when included in a node list, is interpreted as no connection at that input to the model. ‘Null’ is not allowed as the name of a model’s input or output if the model only has one input or one output. Also, ‘null’ should only be used to indicate a missing connection for a code model; use on other XSPICE component is not interpreted as a missing connection, but will be interpreted as an actual node name.

The tilde, ‘~’, when prepended to a digital node name, specifies that the logical value of that node be inverted prior to being passed to the code model. This allows for simple inversion of input and output polarities of a digital model in order to handle logically equivalent cases and others that frequently arise in digital system design. The following example defines a NAND gate, one input of which is inverted:

a1 [~1 2] 3 nand1
.model nand1 d_nand (rise_delay=0.1 fall_delay=0.2)

The optional symbols %v, %i, %vd, etc. specify the type of port the simulator is to expect for the subsequent port or port vector. The meaning of each symbol is given in Table 8.1.

The symbols described in Table 8.1 may be omitted if the default port type for the model is desired. Note that non-default port types for multi-input or multi-output (vector) ports must be specified by placing one of the symbols in front of EACH vector port. On the other hand, if all ports of a vector port are to be declared as having the same non-default type, then a symbol may be specified immediately prior to the opening bracket of the vector. The following examples should make this clear:

Example 1: - Specifies two differential voltage connections, one to nodes 1 & 2, and one to nodes 3 & 4.

178 CHAPTER 8. MIXED-MODE AND BEHAVIORAL MODELING WITH XSPICE

Port Type Modifiers
Modifier | Interpretation
%v | represents a single-ended voltage port - one node name or number is expected for each port.
%i | represents a single-ended current port - one node name or number is expected for each port.
%g | represents a single-ended voltage-input, current-output (VCCS) port - one node name or number is expected for each port. This type of port is auto-matically an input/output.
%h | represents a single-ended current-input, voltage-output (CCVS) port - one node name or number is expected for each port. This type of port is auto-matically an input/output.
%d | represents a digital port - one node name or number is expected for each port. This type of port may be either an input or an output.
%vnam | represents the name of a voltage source, the current through which is taken as an input. This notation is provided primarily in order to allow models defined using SPICE2G6 syntax to operate properly in XSPICE.
%vd | represents a differential voltage port - two node names or numbers are ex-pected for each port.
%id | represents a differential current port - two node names or numbers are ex-pected for each port.
%gd | represents a differential VCCS port - two node names or numbers are expected for each port.
%hd | represents a differential CCVS port - two node names or numbers are expected for each port.

Table 8.1: Port Type Modifiers

8.1. CODE MODEL ELEMENT & .MODEL CARDS | 179

%vd [1 2 3 4]

Example 2: - Specifies two single-ended connections to node 1 and at node 2, and one differential connection to nodes 3 & 4.

%v [1 2 %vd 3 4]

Example 3: - Identical to the previous example...parenthesis are added for additional clarity.

%v [1 2 %vd(3 4)]

Example 4: - Specifies that the node numbers are to be treated in the default fashion for the particular model.
If this model had ‘%v” as a default for this
port, then this notation would represent four single-ended voltage connections.

[1 2 3 4]

The parameter names listed on the .MODEL card must be identical to those named in the code model itself. The parameters for each predefined code model are described in detail in Sections 8.2 (analog), 8.3 (Hybrid, A/D) and 8.4 (digital). The steps required in order to specify parameters for user-defined models are described in Chapter 24.

### 8.1.2 Examples

The following is a list of instance card and associated .MODEL card examples showing use of predefined models within an XSPICE deck:

a1 1 2 amp
.model amp gain(in_offset=0.1 gain=5.0 out_offset=-0.01)

a2 %i[1 2] 3 sum1
.model sum1 summer(in_offset=[0.1 -0.2] in_gain=[2.0 1.0] + out_gain=5.0 out_offset=-0.01)

a21 %i[1 %vd(2 5) 7 10] 3 sum2
.model sum2 summer(out_gain=10.0)

a5 1 2 limit5
.model limit5 limit(in_offset=0.1 gain=2.5
+ out_lower_limit=-5.0 out_upper_limit=5.0 limit_range=0.10 + fraction=FALSE)

a7 2 %id(4 7) xfer_cntl1
.model xfer_cntl1 pwl(x_array=[-2.0 -1.0 2.0 4.0 5.0] + y_array=[-0.2 -0.2 0.1 2.0 10.0]

180 CHAPTER 8. MIXED-MODE AND BEHAVIORAL MODELING WITH XSPICE

+ input_domain=0.05 fraction=TRUE)

a8 3 %gd(6 7) switch3
.model switch3 aswitch(cntl_off=0.0 cntl_on=5.0 r_off=1e6 + r_on=10.0 log=TRUE)

### 8.1.3 Search path for file input

Several code models (filesource 8.2.9, d_source 8.4.21, d_state 8.4.18) call additional files for supply of input data. A call to file="path/filename" (or input_file=, state_file=) in the .model card will start a search sequence for finding the file. path may be an absolute path. If path is omitted or is a relative path, filename is looked for according to the following search list:

Infile_Path/<path/filename> (Infile_Path is the path of the input file *.sp containing the netlist)

NGSPICE_INPUT_DIR/<path/filename> (where an additional path is set by the environmental variable)

<path/filename> (where the search is relative to the current directory (OS dependent))

### 8.1.4 Code model location and assessment

To make use of the XSPICE extensions, you have to compile ngspice accordingly (see Chapt. 28.1). ngspice then is prepared to load and use the code models. At the same time the code models are re-made. They are, however, not linked into ngspice at compile time, but reside in extra shared libraries or dlls, with names analog.cm, digital.cm, spice2poly.cm, xtradev.cm, xtraevt.cm, and table.cm. At run time, with XSPICE enabled, they are loaded dynamically into ngspice by the command codemodel (13.5.15). The sequence to load the codemodels is: Upon start-up ngspice locates, reads, and executes spinit, the standard initialization file (12.5). Within spinit, you will find the commands to load the codemodels, typically with a path for the code models relative to the current working directory (the location of ngspice, in case of shared ngspice the location of the caller).

If you don’t want to make use of spinit, you may run a script in ngspice, before loading any circuit, which contains the codemodel commands. When using shared ngspice, one may issue the codemodel commands directly after initialization, with absolute path or path relative to the current working directory.

In a standard ngspice installation in MS Windows, the codemodels are located in ../lib/ngspice, e.g. in C:\Spice64\lib\ngspice (see also 28.2.1).

In Linux, it depends on the OS invocation. In openSUSE you may find the codemodels in /usr/local/lib64/ngspice, while ngspice resides in /usr/local/bin.

8.2. ANALOG MODELS | 181

## 8.2 Analog Models

The following analog models are supplied with XSPICE. The descriptions included consist of the model Interface Specification File and a description of the model’s operation. This is followed by an example of a simulator-deck placement of the model, including the .MODEL card and the specification of all available parameters.

### 8.2.1 Gain

NAME_TABLE:
C_Function_Name: | cm_gain
Spice_Model_Name: | gain
Description: | "A simple gain block"

PORT_TABLE:
Port Name: | in | out
Description: | "input" | "output"
Direction: | in | out
Default_Type: | v | v
Allowed_Types: | [v,vd,i,id,vnam] | [v,vd,i,id]
Vector: | no | no
Vector.Bounds: | - | -
Null.Allowed: | no | no

PARAMETER_TABLE:
Parameter_Name: | in_offset | gain | out_offset
Description: | "input offset" | "gain" | "output offset"
Data_Type: | real | real | real
Default_Value: | 0.0 | 1.0 | 0.0
Limits: | - | - | -
Vector: | no | no | no
Vector_Bounds: | - | - | -
Null_Allowed: | yes | yes | yes

Description: This function is a simple gain block with optional offsets on the input and the output. The input offset is added to the input, the sum is then multiplied by the gain, and the result is produced by adding the output offset. This model will operate in DC, AC, and Transient analysis modes.

Example:

a1 1 2 amp
.model amp gain(in_offset=0.1 gain=5.0 + out_offset=-0.01)

182 CHAPTER 8. MIXED-MODE AND BEHAVIORAL MODELING WITH XSPICE

### 8.2.2 Summer

NAME_TABLE:
C_Function_Name: | cm_summer
Spice_Model_Name: | summer
Description: | "A summer block"

PORT_TABLE:
Port Name: | in | out
Description: | "input vector" | "output"
Direction: | in | out
Default_Type: | v | v
Allowed_Types: | [v,vd,i,id,vnam] | [v,vd,i,id]
Vector: | yes | no
Vector_Bounds: | - | -
Null_Allowed: | no | no

PARAMETER_TABLE:
Parameter_Name: | in_offset | in_gain
Description: | "input offset vector" | "input gain vector"
Data_Type: | real | real
Default_Value: | 0.0 | 1.0
Limits: | - | -
Vector: | yes | yes
Vector_Bounds: | in | in
Null_Allowed: | yes | yes

PARAMETER_TABLE:
Parameter_Name: | out_gain | out_offset
Description: | "output gain" | "output offset"
Data_Type: | real | real
Default_Value: | 1.0 | 0.0
Limits: | - | -
Vector: | no | no
Vector_Bounds: | - | -
Null_Allowed: | yes | yes

Description: This function is a summer block with 2-to-N input ports. Individual gains and offsets can be applied to each input and to the output. Each input is added to its respective offset and then multiplied by its gain. The results are then summed, multiplied by the output gain and added to the output offset. This model will operate in DC, AC, and Transient analysis modes.

Example usage:

a2 [1 2] 3 sum1
.model sum1 summer(in_offset=[0.1 -0.2] in_gain=[2.0 1.0] + out_gain=5.0 out_offset=-0.01)

8.2. ANALOG MODELS | 183

### 8.2.3 Multiplier

NAME_TABLE:
C_Function_Name: | cm_mult
Spice_Model_Name: | mult
Description: | "multiplier block"
PORT_TABLE:
Port_Name: | in | out
Description: | "input vector" | "output"
Direction: | in | out
Default_Type: | v | v
Allowed_Types: | [v,vd,i,id,vnam] | [v,vd,i,id]
Vector: | yes | no
Vector_Bounds: | [2 -] | -
Null_Allowed: | no | no
PARAMETER_TABLE:
Parameter_Name: | in_offset | in_gain
Description: | "input offset vector" | "input gain vector"
Data_Type: | real | real
Default_Value: | 0.0 | 1.0
Limits: | - | -
Vector: | yes | yes
Vector_Bounds: | in | in
Null_Allowed: | yes | yes
PARAMETER_TABLE:
Parameter_Name: | out_gain | out_offset
Description: | "output gain" | "output offset"
Data_Type: | real | real
Default_Value: | 1.0 | 0.0
Limits: | - | -
Vector: | no | no
Vector_Bounds: | - | -
Null_Allowed: | yes | yes

Description: This function is a multiplier block with 2-to-N input ports. Individual gains and offsets can be applied to each input and to the output. Each input is added to its respective offset and then multiplied by its gain. The results are multiplied along with the output gain and are added to the output offset. This model will operate in DC, AC, and Transient analysis modes. However, in ac analysis it is important to remember that results are invalid unless only one input of the multiplier is connected to a node that i connected to an AC signal (this is exemplified by the use of a multiplier to perform a potentiometer function: one input is DC, the other carries the AC signal).

Example SPICE Usage:

a3 [1 2 3] 4 sigmult
.model sigmult mult(in_offset=[0.1 0.1 -0.1]
+ in_gain=[10.0 10.0 10.0] out_gain=5.0 out_offset=0.05)

184 CHAPTER 8. MIXED-MODE AND BEHAVIORAL MODELING WITH XSPICE

### 8.2.4 Divider

NAME_TABLE:
C_Function_Name: | cm_divide
Spice_Model_Name: | divide
Description: | "divider block"
PORT_TABLE:
Port_Name: | num | den | out
Description: | "numerator" | "denominator" | "output"
Direction: | in | in | out
Default_Type: | v | v | v
Allowed_Types: | [v,vd,i,id,vnam] | [v,vd,i,id,vnam] | [v,vd,i,id]
Vector: | no | no | no
Vector_Bounds: | - | - | -
Null_Allowed: | no | no | no
PARAMETER_TABLE:
Parameter_Name: | num_offset | num_gain
Description: | "numerator offset" | "numerator gain"
Data_Type: | real | real
Default_Value: | 0.0 | 1.0
Limits: | - | -
Vector: | no | no
Vector_Bounds: | - | -
Null_Allowed: | yes | yes
PARAMETER_TABLE:
Parameter_Name: | den_offset | den_gain
Description: | "denominator offset" | "denominator gain"
Data_Type: | real | real
Default_Value: | 0.0 | 1.0
Limits: | - | -
Vector: | no | no
Vector_Bounds: | - | -
Null_Allowed: | yes | yes
PARAMETER_TABLE:
Parameter_Name: | den_lower_limit
Description: | "denominator lower limit"
Data_Type: | real
Default_Value: | 1.0e-10
Limits: | -
Vector: | no
Vector_Bounds: | -
Null_Allowed: | yes
PARAMETER_TABLE:
Parameter_Name: | den_domain
Description: | "denominator smoothing domain"
Data_Type: | real
Default_Value: | 1.0e-10
Limits: | -
Vector: | no

8.2. ANALOG MODELS | 185
Vector_Bounds: | -
Null_Allowed: | yes
PARAMETER_TABLE:
Parameter_Name: | fraction
Description: | "smoothing fraction/absolute value switch"
Data_Type: | boolean
Default_Value: | false
Limits: | -
Vector: | no
Vector_Bounds: | -
Null_Allowed: | yes
PARAMETER_TABLE:
Parameter_Name: | out_gain | out_offset
Description: | "output gain" | "output offset"
Data_Type: | real | real
Default_Value: | 1.0 | 0.0
Limits: | - | -
Vector: | no | no
Vector_Bounds: | - | -
Null_Allowed: | yes | yes

Description: This function is a two-quadrant divider. It takes two inputs; num (numerator) and den (denominator). Divide offsets its inputs, multiplies them by their respective gains, divides the results, multiplies the quotient by the output gain, and offsets the result. The denominator is limited to a value above zero via a user specified lower limit. This limit is approached through a quadratic smoothing function, the domain of which may be specified as a fraction of the lower limit value (default), or as an absolute value. This model will operate in DC, AC and Transient analysis modes. However, in ac analysis it is important to remember that results are invalid unless only one input of the divider is connected to a node that is connected to an ac signal (this is exemplified by the use of the divider to perform a potentiometer function: one input is dc, the other carries the ac signal).

Example SPICE Usage:
a4 1 2 4 divider
.model divider divide(num_offset=0.1 num_gain=2.5 den_offset=-0.1 + den_gain=5.0 den_lower_limit=1e-5 den_domain=1e-6
+ fraction=FALSE out_gain=1.0 out_offset=0.0)

### 8.2.5 Limiter

NAME_TABLE:
C_Function_Name: | cm_limit
Spice_Model_Name: | limit
Description: | "limit block"
PORT_TABLE:
Port Name: | in | out
Description: | "input" | "output"
Direction: | in | out

186 | CHAPTER 8. MIXED-MODE AND BEHAVIORAL MODELING WITH XSPICE
Default_Type: | v | v
Allowed_Types: | [v,vd,i,id] | [v,vd,i,id]
Vector: | no | no
Vector_Bounds: | - | -
Null_Allowed: | no | no
PARAMETER_TABLE:
Parameter_Name: | in_offset | gain
Description: | "input offset" | "gain"
Data_Type: | real | real
Default_Value: | 0.0 | 1.0
Limits: | - | -
Vector: | no | no
Vector_Bounds: | - | -
Null_Allowed: | yes | yes
PARAMETER_TABLE:
Parameter_Name: | out_lower_limit | out_upper_limit
Description: | "output lower limit" | "output upper limit"
Data_Type: | real | real
Default_Value: | 0.0 | 1.0
Limits: | - | -
Vector: | no | no
Vector_Bounds: | - | -
Null_Allowed: | yes | yes
PARAMETER_TABLE:
Parameter_Name: | limit_range
Description: | "upper & lower smoothing range"
Data_Type: | real
Default_Value: | 1.0e-6
Limits: | -
Vector: | no
Vector_Bounds: | -
Null_Allowed: | yes
PARAMETER_TABLE:
Parameter_Name: | fraction
Description: | "smoothing fraction/absolute value switch"
Data_Type: | boolean
Default_Value: | FALSE
Limits: | -
Vector: | no
Vector_Bounds: | -
Null_Allowed: | yes

Description: The Limiter is a single input, single output function similar to the Gain Block. However, the output of the Limiter function is restricted to the range specified by the output lower and upper limits. This model will operate in DC, AC and Transient analysis modes. Note that the limit range is the value below the upper limit and above the lower limit at which smoothing of the output begins. For this model, then, the limit range represents the delta with respect to the output level at which smoothing occurs. Thus, for

8.2. ANALOG MODELS | 187

an input gain of 2.0 and output limits of 1.0 and -1.0 volts, the output will begin to smooth out at ±0.9 volts, which occurs when the input value is at ±0.4.

Example SPICE Usage:
a5 1 2 limit5
.model limit5 limit(in_offset=0.1 gain=2.5 out_lower_limit=-5.0 + out_upper_limit=5.0 limit_range=0.10 fraction=FALSE)

### 8.2.6 Controlled Limiter

NAME_TABLE:
C_Function_Name: | cm_climit
Spice_Model_Name: | climit
Description: | "controlled limiter block"
PORT_TABLE:
Port_Name: | in | cntl_upper
Description: | "input" | "upper lim. control input"
Direction: | in | in
Default_Type: | v | v
Allowed_Types: | [v,vd,i,id,vnam] | [v,vd,i,id,vnam]
Vector: | no | no
Vector_Bounds: | - | -
Null_Allowed: | no | no
PORT_TABLE:
Port_Name: | cntl_lower | out
Description: | "lower limit control input" | "output"
Direction: | in | out
Default_Type: | v | v
Allowed_Types: | [v,vd,i,id,vnam] | [v,vd,i,id]
Vector: | no | no
Vector_Bounds: | - | -
Null_Allowed: | no | no
PARAMETER_TABLE:
Parameter_Name: | in_offset | gain
Description: | "input offset" | "gain"
Data_Type: | real | real
Default_Value: | 0.0 | 1.0
Limits: | - | -
Vector: | no | no
Vector_Bounds: | - | -
Null_Allowed: | yes | yes
PARAMETER_TABLE:
Parameter_Name: | upper_delta | lower_delta
Description: | "output upper delta" | "output lower delta"
Data_Type: | real | real
Default_Value: | 0.0 | 0.0
Limits: | - | -
Vector: | no | no

188 | CHAPTER 8. MIXED-MODE AND BEHAVIORAL MODELING WITH XSPICE
Vector_Bounds: | - | -
Null_Allowed: | yes | yes
PARAMETER_TABLE:
Parameter_Name: | limit_range | fraction
Description: | "upper & lower sm. range" | "smoothing %/abs switch"
Data_Type: | real | boolean
Default_Value: | 1.0e-6 | FALSE
Limits: | - | -
Vector: | no | no
Vector_Bounds: | - | -
Null_Allowed: | yes | yes

Description: The Controlled Limiter is a single input, single output function similar to the Gain Block. However, the output of the Limiter function is restricted to the range specified by the output lower and upper limits. This model will operate in DC, AC, and Transient analysis modes. Note that the limit range is the value below the cntl_upper limit and above the cntl_lower limit at which smoothing of the output begins (minimum positive value of voltage must exist between the cntl_upper input and the cntl_lower input at all times). For this model, then, the limit range represents the delta with respect to the output level at which smoothing occurs. Thus, for an input gain of 2.0 and output limits of 1.0 and -1.0 volts, the output will begin to smooth out at ±0.9 volts, which occurs when the input value is at ±0.4. Note also that the Controlled Limiter code tests the input values of cntl_upper and cntl_lower to make sure that they are spaced far enough apart to guarantee the existence of a linear range between them. The range is calculated as the difference between (cntl_upper −upper_delta−limit_range) and (cntl_lower + lower_delta + limit_range) and must be greater than or equal to zero. Note that when the limit range is specified as a fractional value, the limit range used in the above is taken as the calculated fraction of the difference between cntl_upper and cntl_lower. Still, the potential exists for too great a limit range value to be specified for proper operation, in which case the model will return an error message.

Example SPICE Usage:
a6 3 6 8 4 varlimit
.model varlimit climit(in_offset=0.1 gain=2.5 upper_delta=0.0 + lower_delta=0.0 limit_range=0.10 fraction=FALSE)

### 8.2.7 PWL Controlled Source

NAME_TABLE:
C_Function_Name: | cm_pwl
Spice_Model_Name: | pwl
Description: | "piecewise linear controlled source"
PORT_TABLE:
Port_Name: | in | out
Description: | "input" | "output"
Direction: | in | out

8.2. ANALOG MODELS | 189
Default_Type: | v | v
Allowed_Types: | [v,vd,i,id,vnam] | [v,vd,i,id]
Vector: | no | no
Vector_Bounds: | - | -
Null_Allowed: | no | no
PARAMETER_TABLE:
Parameter_Name: | x_array | y_array
Description: | "x-element array" | "y-element array"
Data_Type: | real | real
Default_Value: | - | -
Limits: | - | -
Vector: | yes | yes
Vector_Bounds: | [2 -] | [2 -]
Null_Allowed: | no | no
PARAMETER_TABLE:
Parameter_Name: | input_domain | fraction
Description: | "input sm. domain" | "smoothing %/abs switch"
Data_Type: | real | boolean
Default_Value: | 0.01 | TRUE
Limits: | [1e-12 0.5] | -
Vector: | no | no
Vector_Bounds: | - | -
Null_Allowed: | yes | yes
STATIC_VAR_TABLE:
Static_Var_Name: | last_x_value
Data_Type: | pointer
Description: | "iteration holding variable for limiting"

Description: The Piece-Wise Linear Controlled Source is a single input, single output function similar to the Gain Block. However, the output of the PWL Source is not necessarily linear for all values of input. Instead, it follows an I/O relationship specified by you via the x_array and y_array coordinates. This is detailed below.
The x_array and y_array values represent vectors of coordinate points on the x and y axes, respectively. The x_array values are progressively increasing input coordinate points, and the associated y_array values represent the outputs at those points. There may be as few as two (x_array[n], y_array[n]) pairs specified, or as many as memory and simulation speed allow. This permits you to very finely approximate a non-linear function by capturing multiple input-output coordinate points.
Two aspects of the PWL Controlled Source warrant special attention. These are the handling of endpoints and the smoothing of the described transfer function near coordinate points.
In order to fully specify outputs for values of in outside of the bounds of the PWL function (i.e., less than x_array[0] or greater than x_array[n], where n is the largest user-specified coordinate index), the PWL Controlled Source model extends the slope found between the lowest two coordinate pairs and the highest two coordinate pairs. This has the effect of making the transfer function completely linear for in less than x_array[0] and in greater than x_array[n]. It also has the potentially subtle effect of unrealistically causing an output to reach a very large or small value for large inputs. You should thus

190 CHAPTER 8. MIXED-MODE AND BEHAVIORAL MODELING WITH XSPICE

keep in mind that the PWL Source does not inherently provide a limiting capability.
In order to diminish the potential for non-convergence of simulations when using the PWL block, a form of smoothing around the x_array, y_array coordinate points is necessary. This is due to the iterative nature of the simulator and its reliance on smooth first derivatives of transfer functions in order to arrive at a matrix solution. Consequently, the input_domain and fraction parameters are included to allow you some control over the amount and nature of the smoothing performed.
Fraction is a switch that is either TRUE or FALSE. When TRUE (the default setting), the simulator assumes that the specified input domain value is to be interpreted as a fractional figure. Otherwise, it is interpreted as an absolute value. Thus, if fraction=TRUE and input_domain=0.10, The simulator assumes that the smoothing radius about each coordinate point is to be set equal to 10% of the length of either the x_array segment above each coordinate point, or the x_array segment below each coordinate point. The specific segment length chosen will be the smallest of these two for each coordinate point. On the other hand, if fraction=FALSE and input_domain=0.10, then the simulator will begin smoothing the transfer function at 0.10 volts (or amperes) below each x_array coordinate and will continue the smoothing process for another 0.10 volts (or amperes) above each x_array coordinate point. Since the overlap of smoothing domains is not allowed, checking is done by the model to ensure that the specified input domain value is not excessive.
One subtle consequence of the use of the fraction=TRUE feature of the PWL Controlled Source is that, in certain cases, you may inadvertently create extreme smoothing of functions by choosing inappropriate coordinate value points. This can be demonstrated by considering a function described by three coordinate pairs, such as (-1,-1), (1,1), and (2,1). In this case, with a 10% input_domain value specified (fraction=TRUE, input_domain=0.10), you would expect to see rounding occur between in=0.9 and in=1.1, and nowhere else. On the other hand, if you were to specify the same function using the coordinate pairs (-100,-100), (1,1) and (201,1), you would find that rounding occurs between in=-19 and in=21. Clearly in the latter case the smoothing might cause an excessive divergence from the intended linearity above and below in=1.

Example SPICE Usage:
a7 in out xfer_cntl1
.model xfer_cntl1 pwl(x_array=[-2.0 -1.0 2.0 4.0 5.0]
+ | y_array=[-0.2 -0.2 0.1 2.0 10.0]
+ | input_domain=0.05 fraction=TRUE)

### 8.2.8 PWL Time Controlled Source with optional edge smoothing

NAME_TABLE:
C_Function_Name: | cm_pwlts
Spice_Model_Name: | pwlts
Description: | "piecwise linear controlled source, time input"
PORT_TABLE:
Port_Name: | out
Description: | "output"
Direction: | out
Default_Type: | v

8.2. ANALOG MODELS | 191
Allowed_Types: | [v,vd,i,id]
Vector: | no
Vector_Bounds: | -
Null_Allowed: | no
PARAMETER_TABLE:
Parameter_Name: | x_array | y_array
Description: | "x-element array" | "y-element array"
Data_Type: | real | real
Default_Value: | - | -
Limits: | - | -
Vector: | yes | yes
Vector_Bounds: | [2 -] | [2 -]
Null_Allowed: | no | no
PARAMETER_TABLE:
Parameter_Name: | input_domain | fraction
Description: | "input sm. domain" | "smoothing %/abs switch"
Data_Type: | real | boolean
Default_Value: | 0.01 | TRUE
Limits: | [1e-12 0.5] | -
Vector: | no | no
Vector_Bounds: | - | -
Null_Allowed: | yes | yes
PARAMETER_TABLE:
Parameter_Name: | limit
Description: | "const or linearily extrapolated output"
Data_Type: | boolean
Default_Value: | FALSE
Limits: | -
Vector: | no
Vector_Bounds: | -
Null_Allowed: | yes
STATIC_VAR_TABLE:
Static_Var_Name: | last_x_value
Data_Type: | pointer
Vector: | no
Description: | "iteration holding variable for limiting"
STATIC_VAR_TABLE:
Static_Var_Name: | x | y
Data_Type: | pointer | pointer
Description: | "time array" | "y-coefficient array"

Description: The Piece-Wise Linear Time Controlled Source is a time input, single output function. The output follows an time/output relationship specified by you via the x_array and y_array coordinates. This is detailed below.
The x_array and y_array values represent vectors of coordinate points on the x and y axes, respectively. The x_array values are progressively increasing positive input coordinate points (minimum is 0), and the associated y_array values represent the outputs at those points. There may be as few as two (x_array[n], y_array[n]) pairs specified, or as many as memory and simulation speed allow. This permits you to very finely

192 CHAPTER 8. MIXED-MODE AND BEHAVIORAL MODELING WITH XSPICE

approximate a non-linear time dependent waveform by capturing multiple input-output coordinate points.
Two aspects of the PWLTS Controlled Source warrant special attention. These are the handling of endpoints and the smoothing of the described transfer function near coordinate points.
In order to fully specify outputs for values of in outside of the bounds of the PWLTS function (i.e., less than x_array[0] (with x_array[0] >= 0 always) or greater than x_array[n], where n is the largest user-specified coordinate index), the PWLTS Time Controlled Source model extends the slope found between the lowest two coordinate pairs and the highest two coordinate pairs. This has the effect of making the transfer function completely linear for times less than x_array[0] and times greater than x_array[n]. It also has the potentially subtle effect of unrealistically causing an output to reach a very large or small value for large input times.
In order to diminish the potential for non-convergence of simulations when using the PWL block, a form of smoothing around the x_array, y_array coordinate points is necessary. This is due to the iterative nature of the simulator and its reliance on smooth first derivatives of transfer functions in order to arrive at a matrix solution. Consequently, the input_domain and fraction parameters are included to allow you some control over the amount and nature of the smoothing performed.
Fraction is a switch that is either TRUE or FALSE. When TRUE (the default setting), the simulator assumes that the specified input domain value is to be interpreted as a fractional figure. Otherwise, it is interpreted as an absolute value. Thus, if fraction=TRUE and input_domain=0.10, the simulator assumes that the smoothing radius about each coordinate point is to be set equal to 10% of the length of either the x_array segment above each coordinate point, or the x_array segment below each coordinate point. The specific segment length chosen will be the smallest of these two for each coordinate point. On the other hand, if fraction=FALSE and input_domain=0.10, then the simulator will begin smoothing the transfer function at 0.10 seconds below each x_array coordinate and will continue the smoothing process for another 0.10 seconds above each x_array coordinate point. Since the overlap of smoothing domains is not allowed, checking is done by the model to ensure that the specified input domain value is not excessive.
One subtle consequence of the use of the fraction=TRUE feature of the PWL Time Controlled Source is that, in certain cases, you may inadvertently create extreme smoothing of functions by choosing inappropriate coordinate value points. This can be demonstrated by considering a function described by three coordinate pairs, such as (0,-1), (2,1), and (3,1). In this case, with a 10% input_domain value specified (fraction=TRUE, input_domain=0.10), you would expect to see rounding occur between time=1.9 and time=2.1, and nowhere else. On the other hand, if you were to specify the same function using the coordinate pairs (0,-100), (101,1) and (301,1), you would find that rounding occurs between time=81 and time=121. Clearly in the latter case the smoothing might cause an excessive divergence from the intended linearity above and below time=101.

Example SPICE Usage:
a8 out pwl_cntl1

.model pwl_cntl1 pwlts(x_array=[0 1m 1.1m 2m 2.1m]
+ | y_array=[-0.2 -0.2 0.6 0.6 0.35]
+ | input_domain=0.2 fraction=TRUE
+ | limit=TRUE)

8.2. ANALOG MODELS | 193

### 8.2.9 Filesource (PWL sourced from file)

NAME_TABLE:
C_Function_Name: | cm_filesource
Spice_Model_Name: | filesource
Description: | "File Source"
PORT_TABLE:
Port_Name: | out
Description: | "output"
Direction: | out
Default_Type: | v
Allowed_Types: | [v,vd,i,id]
Vector: | yes
Vector_Bounds: | [1 -]
Null_Allowed: | no
PARAMETER_TABLE:
Parameter_Name: | timeoffset | timescale
Description: | "time offset" | "timescale"
Data_Type: | real | real
Default_Value: | 0.0 | 1.0
Limits: | - | -
Vector: | no | no
Vector_Bounds: | - | -
Null_Allowed: | yes | yes
PARAMETER_TABLE:
Parameter_Name: | timerelative | amplstep
Description: | "relative time" | "step amplitude"
Data_Type: | boolean | boolean
Default_Value: | FALSE | FALSE
Limits: | - | -
Vector: | no | no
Vector_Bounds: | - | -
Null_Allowed: | yes | yes
PARAMETER_TABLE:
Parameter_Name: | amploffset | amplscale
Description: | "ampl offset" | "amplscale"
Data_Type: | real | real
Default_Value: | - | -
Limits: | - | -
Vector: | yes | yes
Vector_Bounds: | [1 -] | [1 -]
Null_Allowed: | yes | yes
PARAMETER_TABLE:
Parameter_Name: | file
Description: | "file name"
Data_Type: | string
Default_Value: | "filesource.txt"
Limits: | -
Vector: | no

194 | CHAPTER 8. MIXED-MODE AND BEHAVIORAL MODELING WITH XSPICE
Vector_Bounds: | -
Null_Allowed: | yes

Description: The File Source is similar to the Piece-Wise Linear (PWL) Source, except that the waveform data is read from a file instead of being taken from parameter vectors. The file format is line oriented ASCII. ‘#’ and ‘;’ are comment characters; all characters from a comment character until the end of the line are ignored. Each line consists of two or more real values. The first value is the time; subsequent values correspond to the outputs. Values are separated by spaces. Time values are absolute and must be monotonically increasing, unless timerelative is set to TRUE, in which case the values specify the interval between two samples and must be positive. Waveforms may be scaled and shifted in the time dimension by setting timescale and timeoffset.
Amplitudes can also be scaled and shifted using amplscale and amploffset. Amplitudes are normally interpolated between two samples, unless amplstep is set to TRUE.

Note: The file named by the parameter filename in file="filename" is sought after according to a search list described in 8.1.3.

Example SPICE Usage:
a8 %vd([1 0 2 0]) filesrc
.model filesrc filesource (file="sine.m" amploffset=[0 0] amplscale=[1 1]
+ | timeoffset=0 timescale=1
+ | timerelative=false amplstep=false)

Example input file:
# name: sine.m

# two output ports

# column 1: time

# columns 2, 3: values

0 0 1
3.90625e-09 0.02454122852291229 0.9996988186962042 7.8125e-09 0.04906767432741801 0.9987954562051724 1.171875e-08 0.07356456359966743 0.9972904566786902 ...

### 8.2.10 Multi_input_PWL_block

NAME_TABLE:
C_Function_Name: | cm_multi_input_pwl
Spice_Model_Name: | multi_input_pwl
Description: | "multi_input_pwl block"
PORT_TABLE:
Port_Name: | in | out
Description: | "input array" | "output"

8.2. ANALOG MODELS | 195
Direction: | in | out
Default_Type: | vd | vd
Allowed_Types: | [vd,id] | [vd,id]
Vector: | yes | no
Vector_Bounds: | [2 -] | -
Null_Allowed: | no | no
PARAMETER_TABLE:
Parameter_Name: | x | y
Description: | "x array" | "y array"
Data_Type: | real | real
Default_Value: | - | -
Limits: | - | -
Vector: | yes | yes
Vector_Bounds: | [2 -] | [2 -]
Null_Allowed: | no | no
PARAMETER_TABLE:
Parameter_Name: | model
Description: | "model type"
Data_Type: | string
Default_Value: | "and"
Limits: | -
Vector: | no
Vector_Bounds: | -
Null_Allowed: | yes

Description: Multi-input gate voltage controlled voltage source that supports and or or gating. The x’s and y’s represent the piecewise linear variation of output (y) as a function of input (x). The type of gate is selectable by the parameter model. In case the model is and, the smallest input determines the output value (i.e. the and function). In case the model is or, the largest input determines the output value (i.e. the or function). The inverse of these functions (i.e. nand and nor) is constructed by complementing the y array.

Example SPICE Usage:
a82 [1 0 2 0 3 0] 7 0 pwlm
.model pwlm multi_input_pwl((x=[-2.0 -1.0 2.0 4.0 5.0]
+ | | y=[-0.2 -0.2 0.1 2.0 10.0]
+ | | model="and")

### 8.2.11 Analog Switch

NAME_TABLE:
C_Function_Name: | cm_aswitch
Spice_Model_Name: | aswitch
Description: | "analog switch"
PORT_TABLE:
Port Name: | cntl_in | out

196 | CHAPTER 8. MIXED-MODE AND BEHAVIORAL MODELING WITH XSPICE
Description: | "input" | "resistive output"
Direction: | in | out
Default_Type: | v | gd
Allowed_Types: | [v,vd,i,id] | [gd]
Vector: | no | no
Vector_Bounds: | - | -
Null_Allowed: | no | no
PARAMETER_TABLE:
Parameter_Name: | cntl_off | cntl_on
Description: | "control ‘off’ value" "control ‘on’ value"
Data_Type: | real | real
Default_Value: | 0.0 | 1.0
Limits: | - | -
Vector: | no | no
Vector_Bounds: | - | -
Null_Allowed: | yes | yes
PARAMETER_TABLE:
Parameter_Name: | r_off | log
Description: | "off resistance" | "log/linear switch"
Data_Type: | real | boolean
Default_Value: | 1.0e12 | TRUE
Limits: | - | -
Vector: | no | no
Vector_Bounds: | - | -
Null_Allowed: | yes | yes
PARAMETER_TABLE:
Parameter_Name: | r_on | limit
Description: | "on resistance" | "set upper and lower
| | limits to resistance"
Data_Type: | real | boolean
Default_Value: | 1.0 | false
Limits: | - | -
Vector: | no | no
Vector_Bounds: | - | -
Null_Allowed: | yes | yes

Description: The Analog Switch is a resistor that varies either logarithmically or linearly between specified values of a controlling input voltage or current. Note that the input is not internally limited when parameter limit is not given. Therefore, if the controlling signal exceeds the specified OFF state or ON state value, the resistance may become excessively large or excessively small (in the case of logarithmic dependence), or may become negative (in the case of linear dependence). For the experienced user, these excursions may prove valuable for modeling certain devices, but in most cases you are advised to add limiting of the controlling input if the possibility of excessive control value variation exists. Alternatively you may set the parameter limit to TRUE. Then the resulting resistance is limited to r_on or r_off if the controlling voltage exceeds the given boundaries cntl_on or cntl_off. At these boundaries sharp edges in the R(control) characteristics will occur which may lead to convergence problems.

8.2. ANALOG MODELS | 197

Example SPICE Usage:
a8 3 %gd(6 7) switch3
.model switch3 aswitch(cntl_off=0.0 cntl_on=5.0 r_off=1e6
+ | r_on=10.0 log=TRUE limit=TRUE)

### 8.2.12 Alternative Analog Switch

NAME_TABLE:
C_Function_Name: | cm_pswitch
Spice_Model_Name: | pswitch
Description: | "analog switch alternative"
PORT_TABLE:
Port Name: | cntl_in | out
Description: | "input" | "resistive output"
Direction: | inout | inout
Default_Type: | gd | gd
Allowed_Types: | [g,gd] | [gd]
Vector: | no | no
Vector_Bounds: | - | -
Null_Allowed: | no | no
PARAMETER_TABLE:
Parameter_Name: | cntl_off | cntl_on
Description: | "control ‘off’ value" "control ‘on’ value"
Data_Type: | real | real
Default_Value: | 0.0 | 1.0
Limits: | - | -
Vector: | no | no
Vector_Bounds: | - | -
Null_Allowed: | yes | yes
PARAMETER_TABLE:
Parameter_Name: | r_off | log
Description: | "off resistance" | "log/linear switch"
Data_Type: | real | boolean
Default_Value: | 1.0e12 | TRUE
Limits: | - | -
Vector: | no | no
Vector_Bounds: | - | -
Null_Allowed: | yes | yes
PARAMETER_TABLE:
Parameter_Name: | r_on | r_cntl_in
Description: | "on resistance" | "input resistance for control terminal"
Data_Type: | real | real
Default_Value: | 1.0 | 1e12
Limits: | - | -
Vector: | no | no
Vector_Bounds: | - | -

198 | CHAPTER 8. MIXED-MODE AND BEHAVIORAL MODELING WITH XSPICE
Null_Allowed: | yes | yes

Description: The Alternative Analog Switch is a resistor that varies either logarithmically or linearly between specified values of a controlling input voltage or current. An input resistance r_cntl_in may be specified. The output resistance is limited to r_on or r_off. At the control boundaries cntl_on or cntl_off the R(control) characteristics are slightly rounded. This behaviour is PSPICE-compatible and instances of this device are generated when parsing PSPICE netlists in compatability mode.

Example SPICE Usage:
a9 %g 13 %gd(16 17) switch4
.model switch4 pswitch(cntl_off=0.0 cntl_on=5.0 r_off=1e6
+ | r_on=10.0 r_cntl_in=1e11 log=TRUE)

### 8.2.13 Zener Diode

NAME_TABLE:
C_Function_Name: | cm_zener
Spice_Model_Name: | zener
Description: | "zener diode"
PORT_TABLE:
Port Name: | z
Description: | "zener"
Direction: | inout
Default_Type: | gd
Allowed_Types: | [gd]
Vector: | no
Vector_Bounds: | -
Null_Allowed: | no
PARAMETER_TABLE:
Parameter_Name: | v_breakdown | i_breakdown
Description: | "breakdown voltage" | "breakdown current"
Data_Type: | real | real
Default_Value: | - | 2.0e-2
Limits: | [1.0e-6 1.0e6] | [1.0e-9 -]
Vector: | no | no
Vector_Bounds: | - | -
Null_Allowed: | no | yes
PARAMETER_TABLE:
Parameter_Name: | i_sat | n_forward
Description: | "saturation current" | "forward emission coefficient"
Data_Type: | real | real
Default_Value: | 1.0e-12 | 1.0
Limits: | [1.0e-15 -] | [0.1 10]
Vector: | no | no
Vector_Bounds: | - | -

8.2. ANALOG MODELS | 199
Null_Allowed: | yes | yes
PARAMETER_TABLE:
Parameter_Name: | limit_switch
Description: | "switch for on-board limiting (convergence aid)"
Data_Type: | boolean
Default_Value: | FALSE
Limits: | -
Vector: | no
Vector_Bounds: | -
Null_Allowed: | yes
STATIC_VAR_TABLE:
Static_Var_Name: | previous_voltage
Data_Type: | pointer
Description: | "iteration holding variable for limiting"

Description: The Zener Diode models the DC characteristics of most zeners. This model differs from the Diode/Rectifier by providing a user-defined dynamic resistance in the reverse breakdown region. The forward characteristic is defined by only a single point, since most data sheets for zener diodes do not give detailed characteristics in the forward region.
The first three parameters define the DC characteristics of the zener in the breakdown region and are usually explicitly given on the data sheet.
The saturation current refers to the relatively constant reverse current that is produced when the voltage across the zener is negative, but breakdown has not been reached. The reverse leakage current determines the slight increase in reverse current as the voltage across the zener becomes more negative. It is modeled as a resistance parallel to the zener with value v breakdown / i rev.
Note that the limit switch parameter engages an internal limiting function for the zener. This can, in some cases, prevent the simulator from converging to an unrealistic solution if the voltage across or current into the device is excessive. If use of this feature fails to yield acceptable results, the convlimit option should be tried (add the following statement to the SPICE input deck: .options convlimit)

Example SPICE Usage:
a9 3 4 vref10
.model vref10 zener(v_breakdown=10.0 i_breakdown=0.02
+ | r_breakdown=1.0 i_rev=1e-6 i_sat=1e-12)

### 8.2.14 Current Limiter

NAME_TABLE:
C_Function_Name: | cm_ilimit
Spice_Model_Name: | ilimit
Description: | "current limiter block"
PORT_TABLE:
Port Name: | in | pos_pwr

200 | CHAPTER 8. MIXED-MODE AND BEHAVIORAL MODELING WITH XSPICE
Description: | "input" | "positive power supply"
Direction: | in | inout
Default_Type: | v | g
Allowed_Types: | [v,vd] | [g,gd]
Vector: | no | no
Vector_Bounds: | - | -
Null_Allowed: | no | yes
PORT_TABLE:
Port Name: | neg_pwr | out
Description: | "negative power supply" | "output"
Direction: | inout | inout
Default_Type: | g | g
Allowed_Types: | [g,gd] | [g,gd]
Vector: | no | no
Vector_Bounds: | - | -
Null_Allowed: | yes | no
PARAMETER_TABLE:
Parameter_Name: | in_offset | gain
Description: | "input offset" | "gain"
Data_Type: | real | real
Default_Value: | 0.0 | 1.0
Limits: | - | -
Vector: | no | no
Vector_Bounds: | - | -
Null_Allowed: | yes | yes
PARAMETER_TABLE:
Parameter_Name: | r_out_source | r_out_sink
Description: | "sourcing resistance" | "sinking resistance"
Data_Type: | real | real
Default_Value: | 1.0 | 1.0
Limits: | [1.0e-9 1.0e9] | [1.0e-9 1.0e9]
Vector: | no | no
Vector_Bounds: | - | -
Null_Allowed: | yes | yes
PARAMETER_TABLE:
Parameter_Name: | i_limit_source
Description: | "current sourcing limit"
Data_Type: | real
Default_Value: | -
Limits: | [1.0e-12 -]
Vector: | no
Vector_Bounds: | -
Null_Allowed: | yes
PARAMETER_TABLE:
Parameter_Name: | i_limit_sink
Description: | "current sinking limit"
Data_Type: | real
Default_Value: | -

8.2. ANALOG MODELS | 201
Limits: | [1.0e-12 -]
Vector: | no
Vector_Bounds: | -
Null_Allowed: | yes
PARAMETER_TABLE:
Parameter_Name: | v_pwr_range | i_source_range
Description: | "upper & lower power | "sourcing current
| supply smoothing range" | smoothing range"
Data_Type: | real | real
Default_Value: | 1.0e-6 | 1.0e-9
Limits: | [1.0e-15 -] | [1.0e-15 -]
Vector: | no | no
Vector_Bounds: | - | -
Null_Allowed: | yes | yes
PARAMETER_TABLE:
Parameter_Name: | i_sink_range
Description: | "sinking current smoothing range"
Data_Type: | real
Default_Value: | 1.0e-9
Limits: | [1.0e-15 -]
Vector: | no
Vector_Bounds: | -
Null_Allowed: | yes
PARAMETER_TABLE:
Parameter_Name: | r_out_domain
Description: | "internal/external voltage delta smoothing range"
Data_Type: | real
Default_Value: | 1.0e-9
Limits: | [1.0e-15 -]
Vector: | no
Vector_Bounds: | -
Null_Allowed: | yes

Description: The Current Limiter models the behavior of an operational amplifier or comparator device at a high level of abstraction. All of its pins act as inputs; three of the four also act as outputs. The model takes as input a voltage value from the in connector. It then applies an offset and a gain, and derives from it an equivalent internal voltage (veq), which it limits to fall between pos_pwr and neg_pwr. If veq is greater than the output voltage seen on the out connector, a sourcing current will flow from the output pin. Conversely, if the voltage is less than vout, a sinking current will flow into the output pin.
Depending on the polarity of the current flow, either a sourcing or a sinking resistance value (r_out_source, r_out_sink) is applied to govern the vout/i_out relationship. The chosen resistance will continue to control the output current until it reaches a maximum value specified by either i_limit_source or i_limit_sink. The latter mimics the current limiting behavior of many operational amplifier output stages.
During all operation, the output current is reflected either in the pos_pwr connector current or the neg_pwr current, depending on the polarity of i_out. Thus, realistic power consumption as seen in the supply rails is included in the model.

202 CHAPTER 8. MIXED-MODE AND BEHAVIORAL MODELING WITH XSPICE

The user-specified smoothing parameters relate to model operation as follows: v_pwr_range controls the voltage below vpos_pwr and above vneg_pwr inputs beyond which veq = gain(vin+vo f f set)is smoothed; i_source_range specifies the current below i_limit_source at which smoothing begins, as well as specifying the current increment above i_out=0.0
at which i_pos_pwr begins to transition to zero; i_sink_range serves the same purpose with respect to i_limit_sink and i_neg_pwr that i_source_range serves for i_limit_source and i_pos_pwr; r_out_domain specifies the incremental value above
and below (veq-vout)=0.0 at which r_out will be set to r_out_source and r_out_sink, respectively. For values of (veq-vout) less than r_out_domain and greater than -r_out_domain, r_out is interpolated smoothly between r_out_source and r_out_sink.

Example SPICE Usage:
a10 3 10 20 4 amp3
.model amp3 ilimit(in_offset=0.0 gain=16.0 r_out_source=1.0
+ | r_out_sink=1.0 i_limit_source=1e-3
+ | i_limit_sink=10e-3 v_pwr_range=0.2
+ | i_source_range=1e-6 i_sink_range=1e-6
+ | r_out_domain=1e-6)

### 8.2.15 Hysteresis Block

NAME_TABLE:
C_Function_Name: | cm_hyst
Spice_Model_Name: | hyst
Description: | "hysteresis block"
PORT_TABLE:
Port Name: | in | out
Description: | "input" | "output"
Direction: | in | out
Default_Type: | v | v
Allowed_Types: | [v,vd,i,id] | [v,vd,i,id]
Vector: | no | no
Vector_Bounds: | - | -
Null_Allowed: | no | no
PARAMETER_TABLE:
Parameter_Name: | in_low | in_high
Description: | "input low value" | "input high value"
Data_Type: | real | real
Default_Value: | 0.0 | 1.0
Limits: | - | -
Vector: | no | no
Vector_Bounds: | - | -
Null_Allowed: | yes | yes
PARAMETER_TABLE:
Parameter_Name: | hyst | out_lower_limit
Description: | "hysteresis" | "output lower limit"

8.2. ANALOG MODELS | 203
Data_Type: | real | real
Default_Value: | 0.1 | 0.0
Limits: | [0.0 -] | -
Vector: | no | no
Vector_Bounds: | - | -
Null_Allowed: | yes | yes
PARAMETER_TABLE:
Parameter_Name: | out_upper_limit | input_domain
Description: | "output upper limit" | "input smoothing domain"
Data_Type: | real | real
Default_Value: | 1.0 | 0.01
Limits: | - | -
Vector: | no | no
Vector_Bounds: | - | -
Null_Allowed: | yes | yes
PARAMETER_TABLE:
Parameter_Name: | fraction
Description: | "smoothing fraction/absolute value switch"
Data_Type: | boolean
Default_Value: | TRUE
Limits: | -
Vector: | no
Vector_Bounds: | -
Null_Allowed: | yes

Description: The Hysteresis block is a simple buffer stage that provides hysteresis of the output with respect to the input. The in_low and in_high parameter values specify the center voltage or current inputs about which the hysteresis effect operates. The output values are limited to out_lower_limit and out_upper_limit. The value of hyst is added to the in_low and in_high points in order to specify the points at which the slope of the hysteresis function would normally change abruptly as the input transitions from a low to a high value. Likewise, the value of hyst is subtracted from the in high and in low values in order to specify the points at which the slope of the hysteresis function would normally change abruptly as the input transitions from a high to a low value. In fact, the slope of the hysteresis function is never allowed to change abruptly but is smoothly varied whenever the input domain smoothing parameter is set greater than zero.

Example SPICE Usage:
a11 1 2 schmitt1
.model schmitt1 hyst(in_low=0.7 in_high=2.4 hyst=0.5
+ | out_lower_limit=0.5 out_upper_limit=3.0
+ | input_domain=0.01 fraction=TRUE)

### 8.2.16 Differentiator

NAME_TABLE:

204 | CHAPTER 8. MIXED-MODE AND BEHAVIORAL MODELING WITH XSPICE
C_Function_Name: | cm_d_dt
Spice_Model_Name: | d_dt
Description: | "time-derivative block"
PORT_TABLE:
Port Name: | in | out
Description: | "input" | "output"
Direction: | in | out
Default_Type: | v | v
Allowed_Types: | [v,vd,i,id] | [v,vd,i,id]
Vector: | no | no
Vector_Bounds: | - | -
Null_Allowed: | no | no
PARAMETER_TABLE:
Parameter_Name: | gain | out_offset
Description: | "gain" | "output offset"
Data_Type: | real | real
Default_Value: | 1.0 | 0.0
Limits: | - | -
Vector: | no | no
Vector_Bounds: | - | -
Null_Allowed: | yes | yes
PARAMETER_TABLE:
Parameter_Name: | out_lower_limit | out_upper_limit
Description: | "output lower limit" | "output upper limit"
Data_Type: | real | real
Default_Value: | - | -
Limits: | - | -
Vector: | no | no
Vector_Bounds: | - | -
Null_Allowed: | yes | yes
PARAMETER_TABLE:
Parameter_Name: | limit_range
Description: | "upper & lower limit smoothing range"
Data_Type: | real
Default_Value: | 1.0e-6
Limits: | -
Vector: | no
Vector_Bounds: | -
Null_Allowed: | yes

Description: The Differentiator block is a simple derivative stage that approximates the time derivative of an input signal by calculating the incremental slope of that signal since the previous time point. The block also includes gain and output offset parameters to allow for tailoring of the required signal, and output upper and lower limits to prevent convergence errors resulting from excessively large output values. The incremental value of output below the output upper limit and above the output lower limit at which smoothing begins is specified via the limit range parameter. In AC analysis, the value returned is equal to the radian frequency of analysis multiplied by the gain.

8.2. ANALOG MODELS | 205

Note that since truncation error checking is not included in the d_dt block, it is not recommended that the model be used to provide an integration function through the use of a feedback loop. Such an arrangement could produce erroneous results. Instead, you should make use of the "integrate" model, which does include truncation error checking for enhanced accuracy.

Example SPICE Usage:
a12 7 12 slope_gen
.model slope_gen d_dt(out_offset=0.0 gain=1.0
+ | out_lower_limit=1e-12 out_upper_limit=1e12
+ | limit_range=1e-9)

### 8.2.17 Integrator

NAME_TABLE:
C_Function_Name: | cm_int
Spice_Model_Name: | int
Description: | "time-integration block"
PORT_TABLE:
Port Name: | in | out
Description: | "input" | "output"
Direction: | in | out
Default_Type: | v | v
Allowed_Types: | [v,vd,i,id] | [v,vd,i,id]
Vector: | no | no
Vector_Bounds: | - | -
Null_Allowed: | no | no
PARAMETER_TABLE:
Parameter_Name: | in_offset | gain
Description: | "input offset" | "gain"
Data_Type: | real | real
Default_Value: | 0.0 | 1.0
Limits: | - | -
Vector: | no | no
Vector_Bounds: | - | -
Null_Allowed: | yes | yes
PARAMETER_TABLE:
Parameter_Name: | out_lower_limit | out_upper_limit
Description: | "output lower limit" | "output upper limit"
Data_Type: | real | real
Default_Value: | - | -
Limits: | - | -
Vector: | no | no
Vector_Bounds: | - | -
Null_Allowed: | yes | yes
PARAMETER_TABLE:

206 | CHAPTER 8. MIXED-MODE AND BEHAVIORAL MODELING WITH XSPICE
Parameter_Name: | limit_range
Description: | "upper & lower limit smoothing range"
Data_Type: | real
Default_Value: | 1.0e-6
Limits: | -
Vector: | no
Vector_Bounds: | -
Null_Allowed: | yes
PARAMETER_TABLE:
Parameter_Name: | out_ic
Description: | "output initial condition"
Data_Type: | real
Default_Value: | 0.0
Limits: | -
Vector: | no
Vector_Bounds: | -
Null_Allowed: | yes

Description: The Integrator block is a simple integration stage that approximates the integral with respect to time of an input signal. The block also includes gain and input offset parameters to allow for tailoring of the required signal, and output upper and lower limits to prevent convergence errors resulting from excessively large output values. Note that these limits specify integrator behavior similar to that found in an operational amplifierbased integration stage, in that once a limit is reached, additional storage does not occur. Thus, the input of a negative value to an integrator that is currently driving at the out upper limit level will immediately cause a drop in the output, regardless of how long the integrator was previously summing positive inputs. The incremental value of output below the output upper limit and above the output lower limit at which smoothing begins is specified via the limit range parameter. In AC analysis, the value returned is equal to the gain divided by the radian frequency of analysis.
Note that truncation error checking is included in the int block. This should provide for a more accurate simulation of the time integration function, since the model will inherently request smaller time increments between simulation points if truncation errors would otherwise be excessive.

Example SPICE Usage:
a13 7 12 time_count
.model time_count int(in_offset=0.0 gain=1.0
+ | out_lower_limit=-1e12 out_upper_limit=1e12
+ | limit_range=1e-9 out_ic=0.0)

### 8.2.18 S-Domain Transfer Function

NAME_TABLE:
C_Function_Name: | cm_s_xfer
Spice_Model_Name: | s_xfer
Description: | "s-domain transfer function"
PORT_TABLE:

8.2. ANALOG MODELS | 207
Port Name: | in | out
Description: | "input" | "output"
Direction: | in | out
Default_Type: | v | v
Allowed_Types: | [v,vd,i,id] | [v,vd,i,id]
Vector: | no | no
Vector_Bounds: | - | -
Null_Allowed: | no | no
PARAMETER_TABLE:
Parameter_Name: | in_offset | gain
Description: | "input offset" | "gain"
Data_Type: | real | real
Default_Value: | 0.0 | 1.0
Limits: | - | -
Vector: | no | no
Vector_Bounds: | - | -
Null_Allowed: | yes | yes
PARAMETER_TABLE:
Parameter_Name: | num_coeff
Description: | "numerator polynomial coefficients"
Data_Type: | real
Default_Value: | -
Limits: | -
Vector: | yes
Vector_Bounds: | [1 -]
Null_Allowed: | no
PARAMETER_TABLE:
Parameter_Name: | den_coeff
Description: | "denominator polynomial coefficients"
Data_Type: | real
Default_Value: | -
Limits: | -
Vector: | yes
Vector_Bounds: | [1 -]
Null_Allowed: | no
PARAMETER_TABLE:
Parameter_Name: | int_ic
Description: | "integrator stage initial conditions"
Data_Type: | real
Default_Value: | 0.0
Limits: | -
Vector: | yes
Vector_Bounds: | den_coeff
Null_Allowed: | yes
PARAMETER_TABLE:
Parameter_Name: | denormalized_freq
Description: | "denorm. corner freq.(radians) for 1 rad/s coeffs"
Data_Type: | real

208 | CHAPTER 8. MIXED-MODE AND BEHAVIORAL MODELING WITH XSPICE
Default_Value: | 1.0
Limits: | -
Vector: | no
Vector_Bounds: | -
Null_Allowed: | yes

Description: The s-domain transfer function is a single input, single output transfer function in the Laplace transform variable ‘s’ that allows for flexible modulation of the frequency domain characteristics of a signal. Ac and transient simulations are supported. The code model may be configured to produce an arbitrary s-domain transfer function with the following restrictions:

### 1. The degree of the numerator polynomial cannot exceed that

of the denominator polynomial in the variable "s".

### 2. The coefficients for a polynomial must be stated

explicitly. That is, if a coefficient is zero, it must be included as an input to the num coeff or den coeff vector.

The order of the coefficient parameters is from that associated with the highest-powered term decreasing to that of the lowest. Thus, for the coefficient parameters specified below, the equation in ‘s’ is shown:

.model filter s_xfer(gain=0.139713
+ | num_coeff=[1.0 0.0 0.7464102]
+ | den_coeff=[1.0 0.998942 0.001170077]
+ | int_ic=[0 0])

It specifies a transfer function of the form

N(s) = 0.139713 ·

s

2+0.7464102
s

2+0.998942s+0.00117077

The s-domain transfer function includes gain and in_offset (input offset) parameters to allow for tailoring of the required signal. There are no limits on the internal signal values or on the output value of the s-domain transfer function, so you are cautioned to specify gain and coefficient values that will not cause the model to produce excessively large values. In AC analysis, the value returned is equal to the real and imaginary components of the total s-domain transfer function at each frequency of interest.

The denormalized_freq term allows you to specify coefficients for a normalized filter (i.e. one in which the frequency of interest is 1 rad/s). Once these coefficients are included, specifying the denormalized frequency value ‘shifts’ the corner frequency to the actual one of interest. As an example, the following transfer function describes a Chebyshev low-pass filter with a corner (pass-band) frequency of 1 rad/s:

N(s) = 0.139713 ·

1.0
s

2+1.09773s+1.10251

In order to define an s_xfer model for the above, but with the corner frequency equal to 1500 rad/s (239 Hz), the following instance and model lines would be needed:

8.2. ANALOG MODELS | 209

a12 node1 node2 cheby1
.model cheby1 s_xfer(num_coeff=[1] den_coeff=[1 1.09773 1.10251]
+ | int_ic=[0 0] denormalized_freq=1500)

In the above, you add the normalized coefficients and scale the filter through the use of the denormalized freq parameter. Similar results could have been achieved by performing the denormalization prior to specification of the coefficients, and setting denormalized freq to the value 1.0 (or not specifying the frequency, as the default is 1.0 rad/s) Note in the above that frequencies are always specified as radians/second.

Truncation error checking is included in the s-domain transfer block. This should provide for more accurate simulations, since the model will inherently request smaller time increments between simulation points if truncation errors would otherwise be excessive.

The int_ic parameter is an array that must be of size one less as the array of values specified for the den_coeff parameter. Even if a 0 start value is required, you have to add the specific int_ic vector to the set of coefficients (see the examples above and below).

Example SPICE Usage:
a14 9 22 cheby_LP_3kHz
.model cheby_LP_3kHz s_xfer(in_offset=0.0 gain=1.0 int_ic=[0 0]
+ | num_coeff=[1.0]
+ | den_coeff=[1.0 1.42562 1.51620])

### 8.2.19 PWL Transfer Function

NAME_TABLE:
Spice_Model_Name: | xfer
C_Function_Name: | cm_xfer
Description: | "AC transfer function block"
PORT_TABLE:
Port_Name: | in | out
Description: | "input" | "output"
Direction: | in | out
Default_Type: | v | v
Allowed_Types: | [v,vd,i,id] | [v,vd,i,id]
Vector: | no | no
Vector_Bounds: | - | -
Null_Allowed: | no | no
PARAMETER_TABLE:
Parameter_Name: | table
Description: | "PWL table: frequency/magnitude/phase"
Data_Type: | real
Default_Value: | 0
Limits: | -
Vector: | yes
Vector_Bounds: | [3 -]

210 | CHAPTER 8. MIXED-MODE AND BEHAVIORAL MODELING WITH XSPICE
Null_Allowed: | yes
PARAMETER_TABLE:
Parameter_Name: | file
Description: | "File in Touchstone format"
Data_Type: | string
Default_Value: | -
Limits: | -
Vector: | no
Vector_Bounds: | -
Null_Allowed: | yes
PARAMETER_TABLE:
Parameter_Name: | r_i
Description: | "table is in real/imaginary format"
Data_Type: | boolean
Default_Value: | false
Limits: | -
Vector: | no
Vector_Bounds: | -
Null_Allowed: | yes
PARAMETER_TABLE:
Parameter_Name: | db
Description: | "table is in magnitude(dB)/phase format"
Data_Type: | boolean
Default_Value: | true
Limits: | -
Vector: | no
Vector_Bounds: | -
Null_Allowed: | yes
PARAMETER_TABLE:
Parameter_Name: | rad
Description: | "phase in radians, not degrees"
Data_Type: | boolean
Default_Value: | false
Limits: | -
Vector: | no
Vector_Bounds: | -
Null_Allowed: | yes
PARAMETER_TABLE:
Parameter_Name: | span | offset
Description: | "Length of table rows" | "Offset within row"
Data_Type: | int | int
Default_Value: | 3 | 1
Limits: | [ 3 - ] | [ 1 - ]
Vector: | no | no
Vector_Bounds: | - | -
Null_Allowed: | yes | yes
/* This is used internally to store the table in compact complex form. */ STATIC_VAR_TABLE:

8.2. ANALOG MODELS | 211
Static_Var_Name: | table
Description: | "Internal copy of data"
Data_Type: | pointer
/* Only warn once about use in transient analysis. */ STATIC_VAR_TABLE:
Static_Var_Name: | warned
Description: | "Warning indicator"
Data_Type: | int

This code model is useful only in AC analysis, where it applies a complex transfer function to its input. The current circuit frequency is input to a PWL function defined by a table and the output is produced by multiplying the input by the resulting complex number. The parameters supply the PWL table and determine its format. The “table” parameter supplies the data directly, while “file” defines a path (which must be all lower-case) to a file in Touchstone format containing the data. Exactly one of those parameters must be specified.

The data is treated as consisting of rows, each of “span” real numbers. The first number is the frequency of a PWL corner and a pair of numbers at the “offset” position in the row supply the data. That allows a single Touchstone file to be shared by several instances of this code model, as such files for an n-port device will contain logical rows of 2*n^2+1 numbers: one frequency value and the components of an NxN complex matrix. The format of the data pairs is determined by the “db”, “rad” and “r_i” parameters. If any of these are set, they override the internal indicators in a Touchstone file which themselves override the parameter defaults.

Examples of using this model are in the examples/sp directory: netlist file.sp shows direct use, while filter.sp uses the E-source wrapper (5.2.6).

### 8.2.20 Slew Rate Block

NAME_TABLE:
C_Function_Name: | cm_slew
Spice_Model_Name: | slew
Description: | "A simple slew rate follower block"
PORT_TABLE:
Port Name: | in | out
Description: | "input" | "output"
Direction: | in | out
Default_Type: | v | v
Allowed_Types: | [v,vd,i,id] | [v,vd,i,id]
Vector: | no | no
Vector_Bounds: | - | -
Null_Allowed: | no | no
PARAMETER_TABLE:
Parameter_Name: | rise_slope
Description: | "maximum rising slope value"
Data_Type: | real
Default_Value: | 1.0e9
Limits: | -
Vector: | no

212 | CHAPTER 8. MIXED-MODE AND BEHAVIORAL MODELING WITH XSPICE
Vector_Bounds: | -
Null_Allowed: | yes
PARAMETER_TABLE:
Parameter_Name: | fall_slope
Description: | "maximum falling slope value"
Data_Type: | real
Default_Value: | 1.0e9
Limits: | -
Vector: | no
Vector_Bounds: | -
Null_Allowed: | yes
PARAMETER_TABLE:
Parameter_Name: | range
Description: | "smoothing range"
Data_Type: | real
Default_Value: | 0.1
Limits: | -
Vector: | no
Vector_Bounds: | -
Null_Allowed: | yes

Description: This function is a simple slew rate block that limits the absolute slope of the output with respect to time to some maximum or value. The actual slew rate effects of over-driving an amplifier circuit can thus be accurately modeled by cascading the amplifier with this model. The units used to describe the maximum rising and falling slope values are expressed in volts or amperes per second. Thus a desired slew rate of 0.5 V/µs will be expressed as 0.5e+6, etc.
The slew rate block will continue to raise or lower its output until the difference between the input and the output values is zero. Thereafter, it will resume following the input signal, unless the slope again exceeds its rise or fall slope limits. The range input specifies a smoothing region above or below the input value. Whenever the model is slewing and the output comes to within the input + or - the range value, the partial derivative of the output with respect to the input will begin to smoothly transition from 0.0 to 1.0. When the model is no longer slewing (output = input), dout/din will equal 1.0.

Example SPICE Usage:
a15 1 2 slew1
.model slew1 slew(rise_slope=0.5e6 fall_slope=0.5e6)

### 8.2.21 Inductive Coupling

NAME_TABLE:
C_Function_Name: | cm_lcouple
Spice_Model_Name: | lcouple
Description: | "inductive coupling (for use with ’core’ model)"
PORT_TABLE:
Port_Name: | l | mmf_out
Description: | "inductor" | "mmf output (in ampere-turns)"

8.2. ANALOG MODELS | 213
Direction: | inout | inout
Default_Type: | hd | hd
Allowed_Types: | [h,hd] | [hd]
Vector: | no | no
Vector_Bounds: | - | -
Null_Allowed: | no | no
PARAMETER_TABLE:
Parameter_Name: | num_turns
Description: | "number of inductor turns"
Data_Type: | real
Default_Value: | 1.0
Limits: | -
Vector: | no
Vector_Bounds: | -
Null_Allowed: | yes

Description: This function is a conceptual model that is used as a building block to create a wide variety of inductive and magnetic circuit models. This function is normally used in conjunction with the core model, but can also be used with resistors, hysteresis blocks, etc. to build up systems that mock the behavior of linear and nonlinear components. The lcouple takes as an input (on the ‘l’ port), a current. This current value is multiplied by the num_turns value, N, to produce an output value (a voltage value that appears on the mmf_out port). The mmf_out acts similar to a magnetomotive force in a magnetic circuit; when the lcouple is connected to the core model, or to some other resistive device, a current will flow. This current value (which is modulated by whatever the lcouple is connected to) is then used by the lcouple to calculate a voltage ‘seen’ at the l port. The voltage is a function of the derivative with respect to time of the current value seen at mmf_out.
The most common use for lcouples will be as a building block in the construction of transformer models. To create a transformer with a single input and a single output, you would require two lcouple models plus one core model. The process of building up such a transformer is described under the description of the core model, below.

Example SPICE Usage:
a150 (7 0) (9 10) lcouple1
.model lcouple1 lcouple(num_turns=10.0)

### 8.2.22 Magnetic Core

NAME_TABLE:
C_Function_Name: | cm_core
Spice_Model_Name: | core
Description: | "magnetic core"
PORT_TABLE:
Port_Name: | mc
Description: | "magnetic core"
Direction: | inout
Default_Type: | gd

214 | CHAPTER 8. MIXED-MODE AND BEHAVIORAL MODELING WITH XSPICE
Allowed_Types: | [g,gd]
Vector: no
Vector_Bounds: | -
Null_Allowed: | no
PARAMETER_TABLE:
Parameter_Name: | H_array | B_array
Description: | "magnetic field array" | "flux density array"
Data_Type: | real | real
Default_Value: | - | -
Limits: | - | -
Vector: | yes | yes
Vector_Bounds: | [2 -] | [2 -]
Null_Allowed: | no | no
PARAMETER_TABLE:
Parameter_Name: | area | length
Description: | "cross-sectional area" | "core length"
Data_Type: | real | real
Default_Value: | - | -
Limits: | - | -
Vector: | no | no
Vector_Bounds: | - | -
Null_Allowed: | no | no
PARAMETER_TABLE:
Parameter_Name: | input_domain
Description: | "input sm. domain"
Data_Type: | real
Default_Value: | 0.01
Limits: | [1e-12 0.5]
Vector: | no
Vector_Bounds: | -
Null_Allowed: | yes
PARAMETER_TABLE:
Parameter_Name: | fraction
Description: | "smoothing fraction/abs switch"
Data_Type: | boolean
Default_Value: | TRUE
Limits: | -
Vector: | no
Vector_Bounds: | -
Null_Allowed: | yes
PARAMETER_TABLE:
Parameter_Name: | mode
Description: | "mode switch (1 = pwl, 2 = hyst)"
Data_Type: | int
Default_Value: | 1
Limits: | [1 2]
Vector: | no
Vector_Bounds: | -

8.2. ANALOG MODELS | 215
Null_Allowed: | yes
PARAMETER_TABLE:
Parameter_Name: | in_low | in_high
Description: | "input low value" | "input high value"
Data_Type: | real | real
Default_Value: | 0.0 | 1.0
Limits: | - | -
Vector: | no | no
Vector_Bounds: | - | -
Null_Allowed: | yes | yes
PARAMETER_TABLE:
Parameter_Name: | hyst | out_lower_limit
Description: | "hysteresis" | "output lower limit"
Data_Type: | real | real
Default_Value: | 0.1 | 0.0
Limits: | [0 -] | -
Vector: | no | no
Vector_Bounds: | - | -
Null_Allowed: | yes | yes
PARAMETER_TABLE:
Parameter_Name: | out_upper_limit
Description: | "output upper limit"
Data_Type: | real
Default_Value: | 1.0
Limits: | -
Vector: | no
Vector_Bounds: | -
Null_Allowed: | yes

Description: This function is a conceptual model that is used as a building block to create a wide variety of inductive and magnetic circuit models. This function is almost always expected to be used in conjunction with the lcouple model to build up systems that mock the behavior of linear and nonlinear magnetic components. There are two fundamental modes of operation for the core model. These are the pwl mode (which is the default, and which is the most likely to be of use to you) and the hysteresis mode. These are detailed below.

| PWL Mode (mode = 1)

The core model in PWL mode takes as input a voltage that it treats as a magnetomotive force (mmf) value. This value is divided by the total effective length of the core to produce a value for the Magnetic Field Intensity, H. This value of H is then used to find the corresponding Flux Density, B, using the piecewise linear relationship described by you in the H array / B array coordinate pairs. B is then multiplied by the cross-sectional area of the core to find the Flux value, which is output as a current. The pertinent mathematical equations are listed below:

H =

mm f
L

, where L = Length

216 CHAPTER 8. MIXED-MODE AND BEHAVIORAL MODELING WITH XSPICE

Here H, the Magnetic Field Intensity, is expressed in ampere-turns/meter.

B = f(H)

The B value is derived from a piecewise linear transfer function described to the model via the (H_array[],B_array[]) parameter coordinate pairs. This transfer function does not include hysteretic effects; for that, you would need to substitute a HYST model for the core.

φ = BA, where A = Area

The final current allowed to flow through the core is equal to φ. This value in turn is used by the "lcouple" code model to obtain a value for the voltage reflected back across its terminals to the driving electrical circuit.

The following example code shows the use of two lcouple models and one core model to produce a simple primary/secondary transformer.

Example SPICE Usage:
a1 (2 0) (3 0) primary
.model primary lcouple (num_turns = 155)
a2 (3 4) iron_core
.model iron_core core (H_array = [-1000 -500 -375 -250 -188 -125 -63 0
+ | 63 125 188 250 375 500 1000]
+ | B_array = [-3.13e-3 -2.63e-3 -2.33e-3 -1.93e-3
+ | -1.5e-3 -6.25e-4 -2.5e-4 0 2.5e-4
+ | 6.25e-4 1.5e-3 1.93e-3 2.33e-3
+ | 2.63e-3 3.13e-3]
+ | area = 0.01 length = 0.01)
a3 (5 0) (4 0) secondary
.model secondary lcouple (num_turns = 310)
| HYSTERESIS Mode (mode = 2)

The core model in HYSTERESIS mode takes as input a voltage that it treats as a magnetomotive force (mmf) value. This value is used as input to the equivalent of a hysteresis code model block. The parameters defining the input low and high values, the output low and high values, and the amount of hysteresis are as in that model. The output from this mode, as in PWL mode, is a current value that is seen across the mc port. An example of the core model used in this fashion is shown below:

Example SPICE Usage:
a1 (2 0) (3 0) primary
.model primary lcouple (num_turns = 155) a2 (3 4) iron_core

8.2. ANALOG MODELS | 217

.model iron_core core (mode = 2 in_low=-7.0 in_high=7.0
+ | out_lower_limit=-2.5e-4 out_upper_limit=2.5e-4
+ | hyst = 2.3 )
a3 (5 0) (4 0) secondary
.model secondary lcouple (num_turns = 310)

One final note to be made about the two core model nodes is that certain parameters are available in one mode, but not in the other. In particular, the in_low, in_high, out_lower_limit, out_upper_limit, and hysteresis parameters are not available in PWL mode. Likewise, the H_array, B_array, area, and length values are unavailable in HYSTERESIS mode. The input domain and fraction parameters are common to both modes (though their behavior is somewhat different; for explanation of the input domain and fraction values for the HYSTERESIS mode, you should refer to the hysteresis code model discussion).

### 8.2.23 Controlled Sine Wave Oscillator

NAME_TABLE:
C_Function_Name: | cm_sine
Spice_Model_Name: | sine
Description: | "controlled sine wave oscillator"
PORT_TABLE:
Port Name: | cntl_in | out
Description: | "control input" | "output"
Direction: | in | out
Default_Type: | v | v
Allowed_Types: | [v,vd,i,id] | [v,vd,i,id]
Vector: | no | no
Vector_Bounds: | - | -
Null_Allowed: | no | no
PARAMETER_TABLE:
Parameter_Name: | cntl_array | freq_array
Description: | "control array" | "frequency array"
Data_Type: | real | real
Default_Value: | [0.0 1.0] | [1.0e3 2.0e3]
Limits: | - | [0 -]
Vector: | yes | yes
Vector_Bounds: | [2 -] | [2 -]
Null_Allowed: | yes | yes
PARAMETER_TABLE:
Parameter_Name: | out_low | out_high
Description: | "output peak low value" "output peak high value"
Data_Type: | real | real
Default_Value: | -1.0 | 1.0
Limits: | - | -
Vector: | no | no
Vector_Bounds: | - | -
Null_Allowed: | yes | yes

218 CHAPTER 8. MIXED-MODE AND BEHAVIORAL MODELING WITH XSPICE

Description: This function is a controlled sine wave oscillator with parametrizable values of low and high peak output. It takes an input voltage or current value. This value is used as the independent variable in the piecewise linear curve described by the coordinate points of the cntl array and freq array pairs. From the curve, a frequency value is determined, and the oscillator will output a sine wave at that frequency. From the above, it is easy to see that array sizes of 2 for both the cntl array and the freq array will yield a linear variation of the frequency with respect to the control input. Any sizes greater than 2 will yield a piecewise linear transfer characteristic. For more detail, refer to the description of the piecewise linear controlled source, which uses a similar method to derive an output value given a control input.

Example SPICE Usage:
asine 1 2 in_sine
.model in_sine sine(cntl_array = [-1 0 5 6]
+ | freq_array=[10 10 1000 1000] out_low = -5.0
+ | out_high = 5.0)

### 8.2.24 Controlled Triangle Wave Oscillator

NAME_TABLE:
C_Function_Name: | cm_triangle
Spice_Model_Name: | triangle
Description: | "controlled triangle wave oscillator"
PORT_TABLE:
Port Name: | cntl_in | out
Description: | "control input" | "output"
Direction: | in | out
Default_Type: | v | v
Allowed_Types: | [v,vd,i,id] | [v,vd,i,id]
Vector: | no | no
Vector_Bounds: | - | -
Null_Allowed: | no | no
PARAMETER_TABLE:
Parameter_Name: | cntl_array | freq_array
Description: | "control array" | "frequency array"
Data_Type: | real | real
Default_Value: | [0.0 1.0] | [1.0e3 2.0e3]
Limits: | - | [0 -]
Vector: | yes | yes
Vector_Bounds: | [2 -] | cntl_array
Null_Allowed: | yes | yes
PARAMETER_TABLE:
Parameter_Name: | out_low | out_high
Description: | "output peak low value" "output peak high value"
Data_Type: | real | real
Default_Value: | -1.0 | 1.0
Limits: | - | -
Vector: | no | no

8.2. ANALOG MODELS | 219
Vector_Bounds: | - | -
Null_Allowed: | yes | yes
PARAMETER_TABLE:
Parameter_Name: | duty_cycle
Description: | "rise time duty cycle"
Data_Type: | real
Default_Value: | 0.5
Limits: | [1e-10 0.999999999]
Vector: | no
Vector_Bounds: | -
Null_Allowed: | yes

Description: This function is a controlled triangle/ramp wave oscillator with parametrizable values of low and high peak output and rise time duty cycle. It takes an input voltage or current value. This value is used as the independent variable in the piecewise linear curve described by the coordinate points of the cntl_array and freq_array pairs.
From the curve, a frequency value is determined, and the oscillator will output a triangle wave at that frequency. From the above, it is easy to see that array sizes of 2 for both the cntl_array and the freq_array will yield a linear variation of the frequency with respect to the control input. Any sizes greater than 2 will yield a piecewise linear transfer characteristic. For more detail, refer to the description of the piecewise linear controlled source, which uses a similar method to derive an output value given a control input.

Example SPICE Usage:
ain 1 2 ramp1
.model ramp1 triangle(cntl_array = [-1 0 5 6]
+ | freq_array=[10 10 1000 1000] out_low = -5.0
+ | out_high = 5.0 duty_cycle = 0.9)

### 8.2.25 Controlled Square Wave Oscillator

NAME_TABLE:
C_Function_Name: | cm_square
Spice_Model_Name: | square
Description: | "controlled square wave oscillator"
PORT_TABLE:
Port Name: | cntl_in | out
Description: | "control input" | "output"
Direction: | in | out
Default_Type: | v | v
Allowed_Types: | [v,vd,i,id] | [v,vd,i,id]
Vector: | no | no
Vector_Bounds: | - | -
Null_Allowed: | no | no
PARAMETER_TABLE:
Parameter_Name: | cntl_array | freq_array
Description: | "control array" | "frequency array"
Data_Type: | real | real

220 | CHAPTER 8. MIXED-MODE AND BEHAVIORAL MODELING WITH XSPICE
Default_Value: | [0.0 1.0] | [1.0e3 2.0e3]
Limits: | - | [0 -]
Vector: | yes | yes
Vector_Bounds: | [2 -] | [2 -]
Null_Allowed: | yes | yes
PARAMETER_TABLE:
Parameter_Name: | out_low | out_high
Description: | "output peak low value" "output peak high value"
Data_Type: | real | real
Default_Value: | -1.0 | 1.0
Limits: | - | -
Vector: | no | no
Vector_Bounds: | - | -
Null_Allowed: | yes | yes
PARAMETER.TABLE:
Parameter_Name: | duty_cycle | rise_time
Description: | "duty cycle" | "output rise time"
Data_Type: | real | real
Default_Value: | 0.5 | 1.0e-9
Limits: | [1e-6 0.999999] | -
Vector: | no | no
Vector_Bounds: | - | -
Null_Allowed: | yes | yes
PARAMETER_TABLE:
Parameter_Name: | fall_time
Description: | "output fall time"
Data_Type: | real
Default_Value: | 1.0e-9
Limits: | -
Vector: | no
Vector_Bounds: | -
Null_Allowed: | yes

Description: This function is a controlled square wave oscillator with parametrizable values of low and high peak output, duty cycle, rise time, and fall time. It takes an input voltage or current value. This value is used as the independent variable in the piecewise linear curve described by the coordinate points of the cntl_array and freq_array pairs. From the curve, a frequency value is determined, and the oscillator will output a square wave at that frequency.
From the above, it is easy to see that array sizes of 2 for both the cntl_array and the freq_array will yield a linear variation of the frequency with respect to the control input. Any sizes greater than 2 will yield a piecewise linear transfer characteristic. For more detail, refer to the description of the piecewise linear controlled source, which uses a similar method to derive an output value given a control input.

Example SPICE Usage:
ain 1 2 pulse1
.model pulse1 square(cntl_array = [-1 0 5 6]

8.2. ANALOG MODELS | 221
+ | freq_array=[10 10 1000 1000] out_low = 0.0
+ | out_high = 4.5 duty_cycle = 0.2
+ | rise_time = 1e-6 fall_time = 2e-6)

### 8.2.26 Controlled One-Shot

NAME_TABLE:
C_Function_Name: | cm_oneshot
Spice_Model_Name: | oneshot
Description: | "controlled one-shot"
PORT_TABLE:
Port Name: | clk | cntl_in
Description: | "clock input" | "control input"
Direction: | in | in
Default_Type: | v | v
Allowed_Types: | [v,vd,i,id] | [v,vd,i,id]
Vector: | no | no
Vector_Bounds: | - | -
Null_Allowed: | no | yes
PORT_TABLE:
Port Name: | clear | out
Description: | "clear signal" | "output"
Direction: | in | out
Default_Type: | v | v
Allowed_Types: | [v,vd,i,id] | [v,vd,i,id]
Vector: | no | no
Vector_Bounds: | - | -
Null_Allowed: | yes | no
PARAMETER_TABLE:
Parameter_Name: | clk_trig | retrig
Description: | "clock trigger value" | "retrigger switch"
Data_Type: | real | boolean
Default_Value: | 0.5 | FALSE
Limits: | - | -
Vector: | no | no
Vector_Bounds: | - | -
Null_Allowed: | no | yes
PARAMETER_TABLE:
Parameter_Name: | pos_edge_trig
Description: | "positive/negative edge trigger switch"
Data_Type: | boolean
Default_Value: | TRUE
Limits: | -
Vector: | no q
Vector_Bounds: | -
Null_Allowed: | no
PARAMETER_TABLE:
Parameter_Name: | cntl_array | pw_array

222 | CHAPTER 8. MIXED-MODE AND BEHAVIORAL MODELING WITH XSPICE
Description: | "control array" | "pulse width array"
Data_Type: | real | real
Default_Value: | [0.0 1.0] | [1.0e-6 0.9999999]
Limits: | - | [0.00 -]
Vector: | yes | yes
Vector_Bounds: | - | cntl_array
Null_Allowed: | yes | yes
PARAMETER_TABLE:
Parameter_Name: | out_low | out_high
Description: | "output low value" | "output high value"
Data_Type: | real | real
Default_Value: | 0.0 | 1.0
Limits: | - | -
Vector: | no | no
Vector_Bounds: | - | -
Null_Allowed: | yes | yes
PARAMETER_TABLE:
Parameter_Name: | fall_time | rise_time
Description: | "output fall time" | "output rise time"
Data_Type: | real | real
Default_Value: | 1.0e-9 | 1.0e-9
Limits: | - | -
Vector: | no | no
Vector_Bounds: | - | -
Null_Allowed: | yes | yes
PARAMETER_TABLE:
Parameter_Name: | rise_delay
Description: | "output delay from trigger"
Data_Type: | real
Default_Value: | 1.0e-9
Limits: | -
Vector: | no
Vector_Bounds: | -
Null_Allowed: | yes
PARAMETER_TABLE:
Parameter_Name: | fall_delay
Description: | "output delay from pw"
Data_Type: | real
Default_Value: | 1.0e-9
Limits: | -
Vector: | no
Vector_Bounds: | -
Null_Allowed: | yes

Description: This function is a controlled oneshot with parametrizable values of low and high peak output, input trigger value level, delay, and output rise and fall times. It takes an input voltage or current value. This value is used as the independent variable in the piecewise linear curve described by the coordinate points of the cntl_array and pw_array

8.2. ANALOG MODELS | 223

pairs. From the curve, a pulse width value is determined. The one-shot will output a pulse of that width, triggered by the clock signal (rising or falling edge), delayed by the delay value, and with specified rise and fall times. A positive slope on the clear input will immediately terminate the pulse, which resets with its fall time.
From the above, it is easy to see that array sizes of 2 for both the cntl_array and the pw_array will yield a linear variation of the pulse width with respect to the control input. Any sizes greater than 2 will yield a piecewise linear transfer characteristic. For more detail, refer to the description of the piecewise linear controlled source, which uses a similar method to derive an output value given a control input.

Example SPICE Usage:
ain 1 2 3 4 pulse2
.model pulse2 oneshot(cntl_array = [-1 0 10 11]
+ | pw_array=[1e-6 1e-6 1e-4 1e-4]
+ | clk_trig = 0.9 pos_edge_trig = FALSE
+ | out_low = 0.0 out_high = 4.5
+ | rise_delay = 20.0e-9 fall_delay = 35.0e-9)

### 8.2.27 Capacitance Meter

NAME_TABLE:
C_Function_Name: | cm_cmeter
Spice_Model_Name: | cmeter
Description: | "capacitance meter"
PORT_TABLE:
Port Name: | in | out
Description: | "input" | "output"
Direction: | in | out
Default_Type: | v | v
Allowed_Types: | [v,vd,i,id] | [v,vd,i,id]
Vector: | no | no
Vector_Bounds: | - | -
Null_Allowed: | no | no
PARAMETER_TABLE:
Parameter_Name: | gain
Description: | "gain"
Data_Type: | real
Default_Value: | 1.0
Limits: | -
Vector: | no
Vector_Bounds: | -
Null_Allowed: | yes

Description: The capacitance meter is a sensing device that is attached to a circuit node and produces as an output a scaled value equal to the total capacitance seen on its input multiplied by the gain parameter. This model is primarily intended as a building block for other models that must sense a capacitance value and alter their behavior based upon it.

224 CHAPTER 8. MIXED-MODE AND BEHAVIORAL MODELING WITH XSPICE

Example SPICE Usage:
atest1 1 2 ctest
.model ctest cmeter(gain=1.0e12)

### 8.2.28 Inductance Meter

NAME_TABLE:
C_Function_Name: | cm_lmeter
Spice_Model_Name: | lmeter
Description: | "inductance meter"
PORT_TABLE:
Port Name: | in | out
Description: | "input" | "output"
Direction: | in | out
Default_Type: | v | v
Allowed_Types: | [v,vd,i,id] | [v,vd,i,id]
Vector: | no | no
Vector_Bounds: | - | -
Null_Allowed: | no | no
PARAMETER_TABLE:
Parameter_Name: | gain
Description: | "gain"
Data_Type: | real
Default_Value: | 1.0
Limits: | -
Vector: | no
Vector_Bounds: | -
Null_Allowed: | yes

Description: The inductance meter is a sensing device that is attached to a circuit node and produces as an output a scaled value equal to the total inductance seen on its input multiplied by the gain parameter. This model is primarily intended as a building block for other models that must sense an inductance value and alter their behavior based upon it.

Example SPICE Usage:
atest2 1 2 ltest
.model ltest lmeter(gain=1.0e6)

### 8.2.29 Memristor

NAME_TABLE:
C_Function_Name: | cm_memristor
Spice_Model_Name: | memristor
Description: | "Memristor Interface"
PORT_TABLE:
Port_Name: | memris
Description: | "memristor terminals"

8.2. ANALOG MODELS | 225
Direction: | inout
Default_Type: | gd
Allowed_Types: | [gd]
Vector: | no
Vector_Bounds: | -
Null_Allowed: | no
PARAMETER_TABLE:
Parameter_Name: | rmin | rmax
Description: | "minimum resistance" | "maximum resistance"
Data_Type: | real | real
Default_Value: | 10.0 | 10000.0
Limits: | - | -
Vector: | no | no
Vector_Bounds: | - | -
Null_Allowed: | yes | yes
PARAMETER_TABLE:
Parameter_Name: | rinit | vt
Description: | "initial resistance" | "threshold"
Data_Type: | real | real
Default_Value: | 7000.0 | 0.0
Limits: | - | -
Vector: | no | no
Vector_Bounds: | - | -
Null_Allowed: | yes | yes
PARAMETER_TABLE:
Parameter_Name: | alpha | beta
Description: | "model parameter 1" | "model parameter 2"
Data_Type: | real | real
Default_Value: | 0.0 | 1.0
Limits: | - | -
Vector: | no | no
Vector_Bounds: | - | -
Null_Allowed: | yes | yes

Description: The memristor is a two-terminal resistor with memory, whose resistance depends on the time integral of the voltage across its terminals. rmin and rmax provide the lower and upper limits of the resistance, rinit is its starting value (no voltage applied so far). The voltage has to be above a threshold vt to become effective in changing the resistance. alpha and beta are two model parameters. The memristor code model is derived from a SPICE subcircuit published in [23].

Example SPICE Usage:
amen 1 2 memr
.model memr memristor (rmin=1k rmax=10k rinit=7k + alpha=0 beta=2e13 vt=1.6)

### 8.2.30 2D table model

NAME_TABLE:

226 | CHAPTER 8. MIXED-MODE AND BEHAVIORAL MODELING WITH XSPICE
C_Function_Name: | cm_table2D
Spice_Model_Name: | table2D
Description: | "2D table model"
PORT_TABLE:
Port_Name: | inx | iny | out
Description: | "inputx" | "inputy" | "output"
Direction: | in | in | out
Default_Type: | v | v | i
Allowed_Types: | [v,vd,i,id,vnam] | [v,vd,i,id,vnam] | [v,vd,i,id]
Vector: | no | no | no
Vector_Bounds: | - | - | -
Null_Allowed: | no | no | no
PARAMETER_TABLE:
Parameter_Name: | order | verbose
Description: | "order" | "verbose"
Data_Type: | int | int
Default_Value: | 3 | 0
Limits: | - | -
Vector: | no | no
Vector_Bounds: | - | -
Null_Allowed: | yes | yes
PARAMETER_TABLE:
Parameter_Name: | offset | gain
Description: | "offset" | "gain"
Data_Type: | real | real
Default_Value: | 0.0 | 1.0
Limits: | - | -
Vector: | no | no
Vector_Bounds: | - | -
Null_Allowed: | yes | yes
PARAMETER_TABLE:
Parameter_Name: | file
Description: | "file name"
Data_Type: | string
Default_Value: | "2D-table-model.txt"
Limits: | -
Vector: | no
Vector_Bounds: | -
Null_Allowed: | yes

Description: The 2D table model reads a matrix from file "file name" (default 2D-tablemodel.txt) which has x columns and y rows. Each x,y pair, addressed by inx and iny, yields an output value out. Linear interpolation is used for out, eno (essentially non oscillating) interpolation for its derivatives. Parameters offset (default 0) and gain (default 1) modify the output table values according to o f f set +gain out. Parameter order (default 3) influences the calculation of the derivatives. Parameter verbose (default 0) yields test outputs, if set to 1 or 2. The table format is shown below. Be careful to include the data point inx = 0, iny = 0 into your table, because ngspice uses these during .OP computations. The x horizontal and y vertical address values have to increase monotonically.

8.2. ANALOG MODELS | 227

Table Example:
* table source
* number of columns (x)
8
* number of rows (y)
9
* x horizontal (column) address values (real numbers) -1 0 1 2 3 4 5 6
* y vertical (row) address values (real numbers)
-0.6 0 0.6 1.2 1.8 2.4 3.0 3.6 4.2
* table with output data (horizontally addressed by x, vertically by y) 1 0.9 0.8 0.7 0.6 0.5 0.4 0.3
1 1 1 1 1 1 1 1
1 1.2 1.4 1.6 1.8 2 2.2 2.4
1 1.5 2 2.5 3 3.5 4 4.5
1 2 3 4 5 6 7 8
1 2.5 4 5.5 7 8.5 10 11.5
1 3 5 7 9 11 13 15
1 3.5 6 8.5 11 13.5 16 18.5
1 4 7 10 13 16 19 22

Description: The usage example consists of two input voltages referenced to ground and a current source output with two floating nodes.

Example SPICE Usage:
atab inx iny %id(out1 out2) tabmod
.model tabmod table2d (offset=0.0 gain=1 order=3 file="table-simple.txt")

### 8.2.31 3D table model

NAME_TABLE:
C_Function_Name: | cm_table3D
Spice_Model_Name: | table3D
Description: | "3D table model"
PORT_TABLE:
Port_Name: | inx | iny | inz
Description: | "inputx" | "inputy" | "inputz"
Direction: | in | in | in
Default_Type: | v | v | v
Allowed_Types: | [v,vd,i,id,vnam] | [v,vd,i,id,vnam] | [v,vd,i,id,vnam]
Vector: | no | no | no
Vector_Bounds: | - | - | -
Null_Allowed: | no | no | no
PORT_TABLE:
Port_Name: | out
Description: | "output"
Direction: | out
Default_Type: | i

228 | CHAPTER 8. MIXED-MODE AND BEHAVIORAL MODELING WITH XSPICE
Allowed_Types: | [v,vd,i,id]
Vector: | no
Vector_Bounds: | -
Null_Allowed: | no
PARAMETER_TABLE:
Parameter_Name: | order | verbose
Description: | "order" | "verbose"
Data_Type: | int | int
Default_Value: | 3 | 0
Limits: | - | -
Vector: | no | no
Vector_Bounds: | - | -
Null_Allowed: | yes | yes
PARAMETER_TABLE:
Parameter_Name: | offset | gain
Description: | "offset" | "gain"
Data_Type: | real | real
Default_Value: | 0.0 | 1.0
Limits: | - | -
Vector: | no | no
Vector_Bounds: | - | -
Null_Allowed: | yes | yes
PARAMETER_TABLE:
Parameter_Name: | file
Description: | "file name"
Data_Type: | string
Default_Value: | "3D-table-model.txt"
Limits: | -
Vector: | no
Vector_Bounds: | -
Null_Allowed: | yes

Description: The 3D table model reads a matrix from file "file name" (default 3D-tablemodel.txt) which has x columns, y rows per table and z tables. Each x,y,z triple, addressed by inx, iny, and inz, yields an output value out. Linear interpolation is used for out, eno (essentially non oscillating) interpolation for its derivatives. Parameters offset (default 0) and gain (default 1) modify the output table values according to o f f set +gain out. Parameter order (default 3) influences the calculation of the derivatives. Parameter verbose (default 0) yields test outputs, if set to 1 or 2. The table format is shown below. Be careful to include the data point inx = 0, iny = 0, inz = 0 into your table, because ngspice needs these to for the .OP calculation. The x horizontal, y vertical, and z table address values have to increase monotonically.

Table Example:
* 3D table for nmos bsim 4, W=10um, L=0.13um *x
39
*y

8.2. ANALOG MODELS | 229

39
*z
11
*x (drain voltage)
-0.1 -0.05 0 0.05 0.1 0.15 0.2 0.25 ... *y (gate voltage)
-0.1 -0.05 0 0.05 0.1 0.15 0.2 0.25 ...
*z (substrate voltage)
-1.8 -1.6 -1.4 -1.2 -1 -0.8 -0.6 -0.4 -0.2 0 0.2 *table -1.8
-4.50688E-10 -4.50613E-10 -4.50601E-10 -4.50599E-10 ... -4.49622E-10 -4.49267E-10 -4.4921E-10 -4.49202E-10 ... -4.50672E-10 -4.49099E-10 -4.48838E-10 -4.48795E-10 ... -4.55575E-10 -4.4953E-10 -4.48435E-10 -4.48217E-10 ... ...
*table -1.6
-3.10015E-10 -3.09767E-10 -3.0973E-10 -3.09724E-10 ... -3.09748E-10 -3.08524E-10 -3.08339E-10 -3.08312E-10 ... ...
*table -1.4
-2.04848E-10 -2.04008E-10 -2.03882E-10 ... -2.07275E-10 -2.03117E-10 -2.02491E-10 ... ...

Description:

The usage example simulates a NMOS transistor with independent drain, gate and bulk nodes, referenced to source. Parameter gain may be used to emulate transistor width, with respect to the table transistor.

Example SPICE Usage:
amos1 %vd(d s) %vd(g s) %vd(b s) %id(d s) mostable1 .model mostable1 table3d (offset=0.0 gain=0.5 order=3 + verbose=1 file="table-3D-bsim4n.txt")

### 8.2.32 Simple Diode Model

NAME_TABLE:
C_Function_Name: | cm_sidiode
Spice_Model_Name: | sidiode
Description: | "simple diode"
PORT_TABLE:
Port_Name: | ds
Description: | "diode port"
Direction: | inout
Default_Type: | gd
Allowed_Types: | [gd]
Vector: | no

230 | CHAPTER 8. MIXED-MODE AND BEHAVIORAL MODELING WITH XSPICE
Vector_Bounds: | -
Null_Allowed: | no
PARAMETER_TABLE:
Parameter_Name: | ron | | roff
Description: | "resistance on-state" | "resistance off-state"
Data_Type: | real | | real
Default_Value: | 1 | | 1¹
Limits: | [1e-6 | - ] | [1e-12 -]
Vector: | no | | no
Vector_Bounds: | - | | -
Null_Allowed: | yes | | yes
PARAMETER_TABLE:
Parameter_Name: | vfwd | | vrev
Description: | "forward voltage" | "reverse breakdown voltage"
Data_Type: | real | | real
Default_Value: | 0. | | 1e30
Limits: | [0. -] | | [0. -]
Vector: | no | | no
Vector Bounds: | - | | -
Null_Allowed: | yes | | yes
PARAMETER_TABLE:
Parameter_Name: | ilimit | | revilimit
Description: | "limit of on-current" | "limit of breakdown current"
Data_Type: | real | | real
Default_Value: | 1e30 | | 1e30
Limits: | [1e-15 -] | [1e-15 -]
Vector: | no | | no
Vector_Bounds: | - | | -
Null_Allowed: | yes | | yes
PARAMETER_TABLE:
Parameter_Name: | epsilon | | revepsilon
Description: | "width quadrat. reg. 1" | "width quadratic region 2"
Data_Type: | real | | real
Default_Value: | 0. | | 0.
Limits: | [0. -] | | [0. -]
Vector: | no | | no
Vector_Bounds: | - | | -
Null_Allowed: | yes | | yes
PARAMETER_TABLE:
Parameter_Name: | rrev
Description: | "resistance in breakdown"
Data_Type: | real
Default_Value: | 0.0
Limits: | -
Vector: | no
Vector_Bounds: | -
Null_Allowed: | yes

1
If roff is not given, ron is the default

8.2. ANALOG MODELS | 231

This is a model for a simple diode. Three regions are modelled as linear I(V) curves: Reverse (breakdown) current with Rrev starting at Vrev into the negative direction, Off current with Roff between Vrev and Vfwd and an On region with Ron, staring at Vfwd. The interface between the regions is described by a quadratic function, the width of the interface region is determined by Revepsilon and Epsilon. Current limits in the reverse breakdown (Revilimit) and in the forward (on) state (Ilimit) may be set. The interface is a tanh function. Thus the first derivative of the I(V) curve is continuous. All parameter values are entered as positive numbers. A diode capacitance is not modelled.

Example SPICE Usage:
a1 a k ds1
.model ds1 sidiode(Roff=1000 Ron=0.7 Rrev=0.2 Vfwd=1
+ Vrev=10 Revepsilon=0.2 Epsilon=0.2 Ilimit=7 Revilimit=7)

### 8.2.33 Analog delay

NAME_TABLE:
C_Function_Name: | cm_delay
Spice_Model_Name: | delay
Description: | "analog delay line"
PORT_TABLE:
Port_Name: | in | out | cntrl
Description: | "input" | "output" | "control"
Direction: | in | out | in
Default_Type: | v | v | v
Allowed_Types: | [v,vd,vnam] | [v,vd] | [v,vd,i,id]
Vector: | no | no | no
Vector_Bounds: | - | - | -
Null_Allowed: | no | no | yes
PARAMETER_TABLE:
Parameter_Name: | delay | buffer_size
Description: | "time delay" | "size of delay buffer"
Data_Type: | real | int
Default_Value: | 0.0 | 1024
Limits: | - | [1 -]
Vector: | no | no
Vector_Bounds: | - | -
Null_Allowed: | yes | yes
PARAMETER_TABLE:
Parameter_Name: | has_delay_cnt
Description: | "controlled delay"
Data_Type: | boolean
Default_Value: | FALSE
Limits: | -
Vector: | no
Vector_Bounds: | -
Null_Allowed: | yes
PARAMETER_TABLE:

232 | CHAPTER 8. MIXED-MODE AND BEHAVIORAL MODELING WITH XSPICE
Parameter_Name: | delmin | delmax
Description: | "min delay" | "max delay"
Data_Type: | real | real
Default_Value: | 0 | 0
Limits: | [0 -] | [0 -]
Vector: | no | no
Vector_Bounds: | - | -
Null_Allowed: | yes | yes

Description:

During a transient simulation the input voltage at node in and its associated time value are stored in a ring buffer. buffer_size allows to set the size of the buffer, the default is 1024 time steps. There are two modes to read out the buffer contents with a delay and obtain the delayed values at port out, determined by has_delay_cnt. If
has_delay_cnt is TRUE, then you may vary the delay time between delmin and delmax by a control voltage between 0 and 1 at the input terminal cntrl. Parameter delay is ignored. If has_delay_cnt has been set to FALSE, then the signal is delayed by the time value given by delay .

Example SPICE Usage:
adelay1 in out cntrl mydel1
.model mydel1 delay(delay=2m buffer_size=2048)
adelay2 in out cntrl mydel2
.model mydel2 delay(has_delay_cnt=TRUE delmin=5u delmax=8u)

Due to the fact that time steps are not constant during a transient simulation, but optimized by the simulator, the delayed values are sometimes slightly deviating from the original, depending on the number of steps. So in a sinusoidal wave we will see a distortion < 0.3% for 1000 steps per sin cycle.

### 8.2.34 Potentiometer

NAME_TABLE:
Spice_Model_Name: | potentiometer
C_Function_Name: | cm_potentiometer
Description: | "potentiometer"
PORT_TABLE:
Port_Name: | r0 | wiper
Description: | "pot connection 0" | "wiper contact"
Direction: | inout | inout
Default_Type: | g | g
Allowed_Types: | [g] | [g]
Vector: | no | no
Vector_Bounds: | - | -
Null_Allowed: | no | no
PORT_TABLE:

8.2. ANALOG MODELS | 233
Port_Name: | r1
Description: | "pot connection 1"
Direction: | inout
Default_Type: | g
Allowed_Types: | [g]
Vector: | no
Vector_Bounds: | -
Null_Allowed: | no
PARAMETER_TABLE:
Parameter_Name: | position
Description: | "position of wiper connection (0.0 to 1.0)"
Data_Type: | real
Default_Value: | 0.5
Limits: | [0.0 1.0]
Vector: | no
Vector_Bounds: | -
Null_Allowed: | yes
PARAMETER_TABLE:
Parameter_Name: | log | r
Description: | "log-linear switch" | "total resistance"
Data_Type: | boolean | real
Default_Value: | FALSE | 1.0e5
Limits: | - | -
Vector: | no | no
Vector_Bounds: | - | -
Null_Allowed: | yes | yes
PARAMETER_TABLE:
Parameter_Name: | log_multiplier
Description: | "multiplier constant for log resistance"
Data_Type: | real
Default_Value: | 1.0
Limits: | -
Vector: | no
Vector_Bounds: | -
Null_Allowed: | yes

Description:

A resistance potentiometer with three connections: r0, wiper , and r1. Parameter position determines the lower and upper portions of the resistance. Rlower is located between r0 and wiper, Rupper between wiper and r1. If log is set to FALSE, Rlower = position ∗ r. If log is set to TRUE, then Rlower = r ∗ 10⁻position∗log_multiplier .
For Rupper we always have Rupper = r −Rlower. position <= 0 is resolved to position = 1e−9, position >= 1 is resolved to position = 0.999999999.

Example SPICE Usage:
Apot r0 w r1 potmod
.model potmod potentiometer(position=0.45 r=1k log=FALSE log_multiplier=1)

234 CHAPTER 8. MIXED-MODE AND BEHAVIORAL MODELING WITH XSPICE

## 8.3 Hybrid Models

The following hybrid models are supplied with XSPICE. The descriptions included below consist of the model Interface Specification File and a description of the model’s operation. This is followed by an example of a simulator-deck placement of the model, including the .MODEL card and the specification of all available parameters.

A note should be made with respect to the use of hybrid models for other than simple digital-toanalog and analog-to-digital translations. The hybrid models represented in this section address that specific need, but in the development of user-defined nodes you may find a need to translate not only between digital and analog nodes, but also between real and digital, real and int, etc. In most cases such translations will not need to be as involved or as detailed as shown in the following.
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
