BroncoSpace-Lab/scales-hardware/docs/test_results/analysis_results.txt

Total Samples: 664

Used RAM (MB):
  Mean: 10153.84
  Min:  9591.00
  Max:  10200.00
  Std:  61.88

Used GR3D (%):
  Mean: 51.36
  Min:  0.00
  Max:  97.00
  Std:  9.64

 Temperature (C):
  Mean: 41.26
  Min:  40.03
  Max:  41.97
  Std:  0.49

Total RAM (MB):
  Mean: 30698.00
  Min:  30698.00
  Max:  30698.00
  Std:  0.00
