BroncoSpace-Lab/scales-hardware/docs/test_results/rolling_averages.csv

Time (mS) | Used RAM (MB)_rolling_avg | Used GR3D (%)_rolling_avg | Temperature (C)_rolling_avg | Total RAM (MB)_rolling_avg
0
1000
2000
3000
4000 | 9634.6 | 0.0 | 40.0998 | 30698.0
5000 | 9673.4 | 0.0 | 40.149800000000006 | 30698.0
6000 | 9718.2 | 0.0 | 40.168600000000005 | 30698.0
7000 | 9768.6 | 0.0 | 40.181 | 30698.0
8000 | 9825.4 | 0.0 | 40.1746 | 30698.0
9000 | 9860.8 | 0.0 | 40.224599999999995 | 30698.0
10000 | 9886.2 | 0.0 | 40.1872 | 30698.0
11000 | 9905.8 | 0.0 | 40.1872 | 30698.0
12000 | 9923.4 | 0.0 | 40.1622 | 30698.0
13000 | 9937.2 | 1.8 | 40.168600000000005 | 30698.0
14000 | 9983.4 | 21.2 | 40.168600000000005 | 30698.0
15000 | 10029.6 | 35.2 | 40.181 | 30698.0
16000 | 10075.6 | 48.2 | 40.2122 | 30698.0
17000 | 10118.2 | 63.0 | 40.205999999999996 | 30698.0
18000 | 10158.2 | 73.8 | 40.230999999999995 | 30698.0
19000 | 10158.4 | 67.6 | 40.205999999999996 | 30698.0
20000 | 10158.8 | 66.4 | 40.218599999999995 | 30698.0
21000 | 10159.2 | 66.2 | 40.218599999999995 | 30698.0
22000 | 10159.6 | 65.0 | 40.2374 | 30698.0
23000 | 10159.8 | 66.4 | 40.2248 | 30698.0
24000 | 10160.0 | 67.0 | 40.2372 | 30698.0
25000 | 10160.2 | 68.0 | 40.224599999999995 | 30698.0
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
