BroncoSpace-Lab/scales-hardware/docs/data/resnet_test.csv

Tue Oct 22 10:33:21 PM UTC 2024
Index | Time (mS) | Used RAM (MB) | Total RAM (MB) | Number of Free RAM Blocks | Size of Free RAM Blocks (MB) | Used SWAP (MB) | Total SWAP (MB) | Cached SWAP (MB) | CPU Frequency (MHz) | CPU 0 Load (%) | CPU 1 Load (%) | CPU 2 Load (%) | CPU 3 Load (%) | CPU 4 Load (%) | CPU 5 Load (%) | CPU 6 Load (%) | CPU 7 Load (%) | CPU 8 Load (%) | CPU 9 Load (%) | CPU 10 Load (%) | CPU 11 Load (%) | Used GR3D (%) | GR3D Frequency (MHz) | cpu Temperature (C) | tboard Temperature (C) | Temperature (C) | tdiode Temperature (C) | gpu Temperature (C) | tj Temperature (C) | VDD_GPU_SOC Current (mW) | VDD_GPU_SOC Average (mW) | VDD_CPU_CV Current (mW) | VDD_CPU_CV Average (mW) | VIN_SYS_5V0 Current (mW) | VIN_SYS_5V0 Average (mW) | VDDQ_VDD2_1V8AO Current (mW) | VDDQ_VDD2_1V8AO Average (mW)
0 | 0 | 9559.0 | 30698.0 | 33.0 | 4.0 | 0.0 | 15349.0 | 0.0 | 729.0 | 3 | 21 | 3 | 0 | 7 | 14 | 4 | 4 | 5 | 31 | 4 | 1 | 0.0 |  | 44.031 | 32.75 | 40.312 | 37.375 | 40.468 | 44.031 | 2783.0 | 2783.0 | 795.0 | 795.0 | 3009.0 | 3009.0 | 702.0 | 702.0
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
