BroncoSpace-Lab/scales-hardware/(threads)

Thread 55 (2025-05-27):

Considering a Load Switch IC Swap

Mikefly123, 2025-05-27:
## Summary
Currently on the SCALES EPS board we are using the LTC4365 Surge Protection Controller. This IC does indeed function as a load switch through the `SHDN` pin and offers under and over voltage protection as inherent features.

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

Recently on the new PROVES V5b flight controller boards, we started using the [TPS2HB50](https://www.ti.com/lit/ds/symlink/tps2hb50-q1.pdf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) and the [TPS4H160](https://www.ti.com/lit/ds/symlink/tps4h160-q1.pdf?ts=1747253789632) automotive load switches for controller the burn wire and heater circuits on that board. As dedicated load switching IC's these chips come with internal MOSFETs, current and thermal limiting features, and even diagnostic outputs for power monitoring and fault determination.

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

## Proposed Change
The `LTC4365` will probably meet our current needs for load switching on the EPS board, but I'm not actually sure that we need over and under voltage protections for a spaceflight system. As the IC describes these features are mainly for surge protection, to stop negative voltages or bursts of high voltages from reaching the downstream electronics when you're powering from the wall let's say.

Switching to using either or both of these Ti Automotive Load Switches could have the following benefits:
- Improved thermal management and integrated current limiting to protect against short circuit conditions
- More built in protections for the uController and Loads from things like reverse battery or missing ground
- Diagnostic outputs potentially replacing the need for dedicated power monitors (although you may still need one to monitor it from off board)
- BOM consolidation, because these are multi-channel parts we could tighten up the schematic and layout
- TPS4 offers a functional safety ready IC, which has additional testing done to ensure very low probability of failure
- Good part availability at JLC

The drawbacks of switching may be:
- No more UV/OV protection built in
- BOM Consolidation makes the design somewhat less modular
- Extra work having to refactor the design

Mikefly123, 2025-06-09:
Marking this as accepted and closed through #56

Closed 2025-06-09.

Thread 57 (2025-06-09):

[TASK] DF11 Crimping Tool Research

Mikefly123, 2025-06-09:
## Description of Task
When we go for vacuum chamber testing (or flight!) for our SCALES hardware we'll need to use PTFE or ETFE insulated wires in order to meet the outgassing requirements. Since PTFE and EFTE wire harnesses don't come off the shelf that probably means we need to buy a tool and make them ourselves!

This is a task to compile some research into what tools are on the market at what price, along with any pros / cons of spending more or less money on this. As a bonus you may also want to reach out to some cable harness making companies and ask what their rates would be to make customer wire assemblies for us rather than us buying a tool and doing it ourselves.

## Acceptance Criteria
- [ ] List of DF11 Crimping Tools along with their price and ordering info
- [ ] Quick analysis of pros and cons of each one
- [ ] (Optional) Investigate if there are any companies we can go to who can make us custom wire harnesses that would be cheaper than getting a tool

LucaLanzi, 2025-06-09:
### Selected Connector for Development Boards ###
* The currently selected connector for all the SCALES development boards is the [DF11-16DP-2DSA(08)](https://jlcpcb.com/partdetail/hrs_hirose-DF11_16DP_2DSA_08/C530981) note that this is the drop in replacement for the currently selected [Gecko connector](https://www.harwin.com/products/G125-MH11605L1P) which will be used in the flight ready system.
* AWG#22 to AWG#30
* 2mm pin pitch
* Manufacturer: Hirose
* Some options are available to either make these cable harnesses at the lab using proprietary crimping tools, or having them made elsewhere, below are our options.
### List of DF11 Crimping Tools along with their price and ordering info ###
* Original Crimp tool from Hirose Electric: [DF11TA22HC](https://www.hirose.com/product/p/CL0550-0228-6-00?lang=en) OUT OF STOCK ~$800
* Clone tool from Misumi, standard crimp tool for DF11 Connectors: [MSHT-H02](https://us.misumi-ec.com/vona2/detail/110400416910/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) IN STOCK ~$280
* Newer revision of the original DF11TA22HC from Hirose electric, this one is in stock but very expensive: [HT801/DF11-2428S(A)](https://www.digikey.com/en/products/detail/hirose-electric-co-ltd/HT801-DF11-2428S-A/13168733) ~$821 IN STOCK
* Another pretty good option is to get pre crimped cables from Digikey [here](https://www.digikey.com/en/products/filter/jumper-wires-pre-crimped-leads/453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) and then buy the
And then get the connectors from Digikey [here](https://www.digikey.com/en/products/detail/hirose-electric-co-ltd/DF11-16DS-2C/141271). That way we dont need to buy the crimping tool and we can just assemble them ourselves without crimping
Personally I think option makes the most sense because the DF11 connectors arent even going to be the final flight connectors so spending $280 on a crimping tool doesnt make too much sense when we can assemble our own cables for a fraction of the cost.

### List of Potential DF11 Cable Assembly Manufacturers ###
* CableConn, San Diego, CA. (Reached out to for a quote of 5-10 connectors)
* Components Express, Woodridge, Illinois (Reached out to for a quote of 5-10 connectors)
* Interconnect Solutions Company, Fountain Valley CA (Reached out to for a quote)

Mikefly123, 2025-06-11:
Thanks for this @LucaLanzi! If and when you hear from those manufacturers, it would be cool to post some of the ROM (Rough Order of Magnitude) quotes they come back to you with here so we have them documented.

Mikefly123, 2025-07-14:
Closing this as completed

Thread 60 (2025-06-11):

Consider Swapping From TCA4307 to TCA4311 for the I2C Hotswap Buffer

Mikefly123, 2025-06-11:
## Why Would Swap?
Right now, we are using the TCA4307 as a I2C Hotswap Buffer to improve the signal integrity of the I2C bus that is coming from the i.Mx and going into the power board.

There is a moderate supply chain risk with this part though, as there are only 44 of them in stock at JLCPCB. If we swap over to the most more readily available TCA4311A chip this risk would go away. We would have to give up the automatic stuck bus resolution features of the TCA4307 though. Personally, I don't think that feature is particularly important to us as our I2C bus is very small (not too many devices), but happy to hear if folks think otherwise.

The TCA4307DGKR and TCA4311ADGKR should be drop-in replacements.

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

LucaLanzi, 2025-06-11:
This is completely fine because the automatic stuck bus is used for hotswap applications for when the card side sensors are taken out, in this case its the IMX8X that is pulled out via the DF11, so it should be completely fine. Ill make note of it for the next iteration.

Closed 2025-07-14.
