BroncoSpace-Lab/scales-hardware/imx8x_eps_leviathan_v2/reviews/current/imx8x_eps_leviathan-1_dsmith_4-23-26.pdf

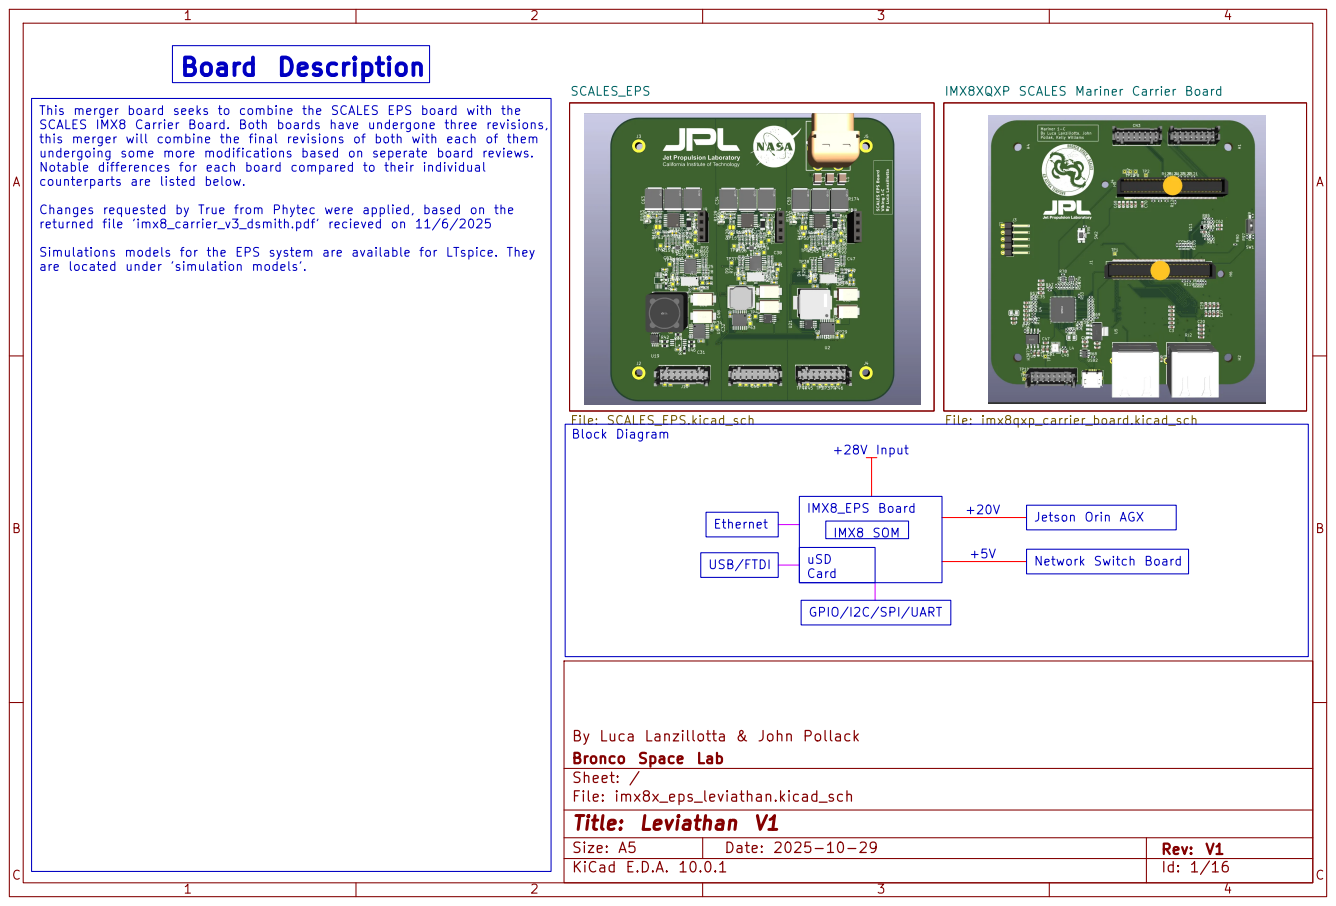
[picture p97: page 1]

SCALES_EPS IMX8XQXP SCALES Mariner Carrier Board

This merger board seeks to combine the SCALES EPS board with the SCALES IMX8 Carrier Board. Both boards have undergone three revisions, this merger will combine the final revisions of both with each of them

undergoing some more modifications based on seperate board reviews. Notable differences for each board compared to their individual counterparts are listed below. Changes requested by True from Phytec were applied, based on the

returned file 'imx8_carrier_v3_dsmith.pdf' recieved on 11/6/2025

Simulations models for the EPS system are available for LTspice. They are located under 'simulation models'.

By Luca Lanzillotta & John Pollack
Bronco Space Lab
Sheet: /
File: imx8x_eps_leviathan.kicad_sch
Title: Leviathan V1

Size: A5 | Rev: V1 | C Date: 2025-10-29
KiCad E.D.A. 10.0.1 | Id: 1/16

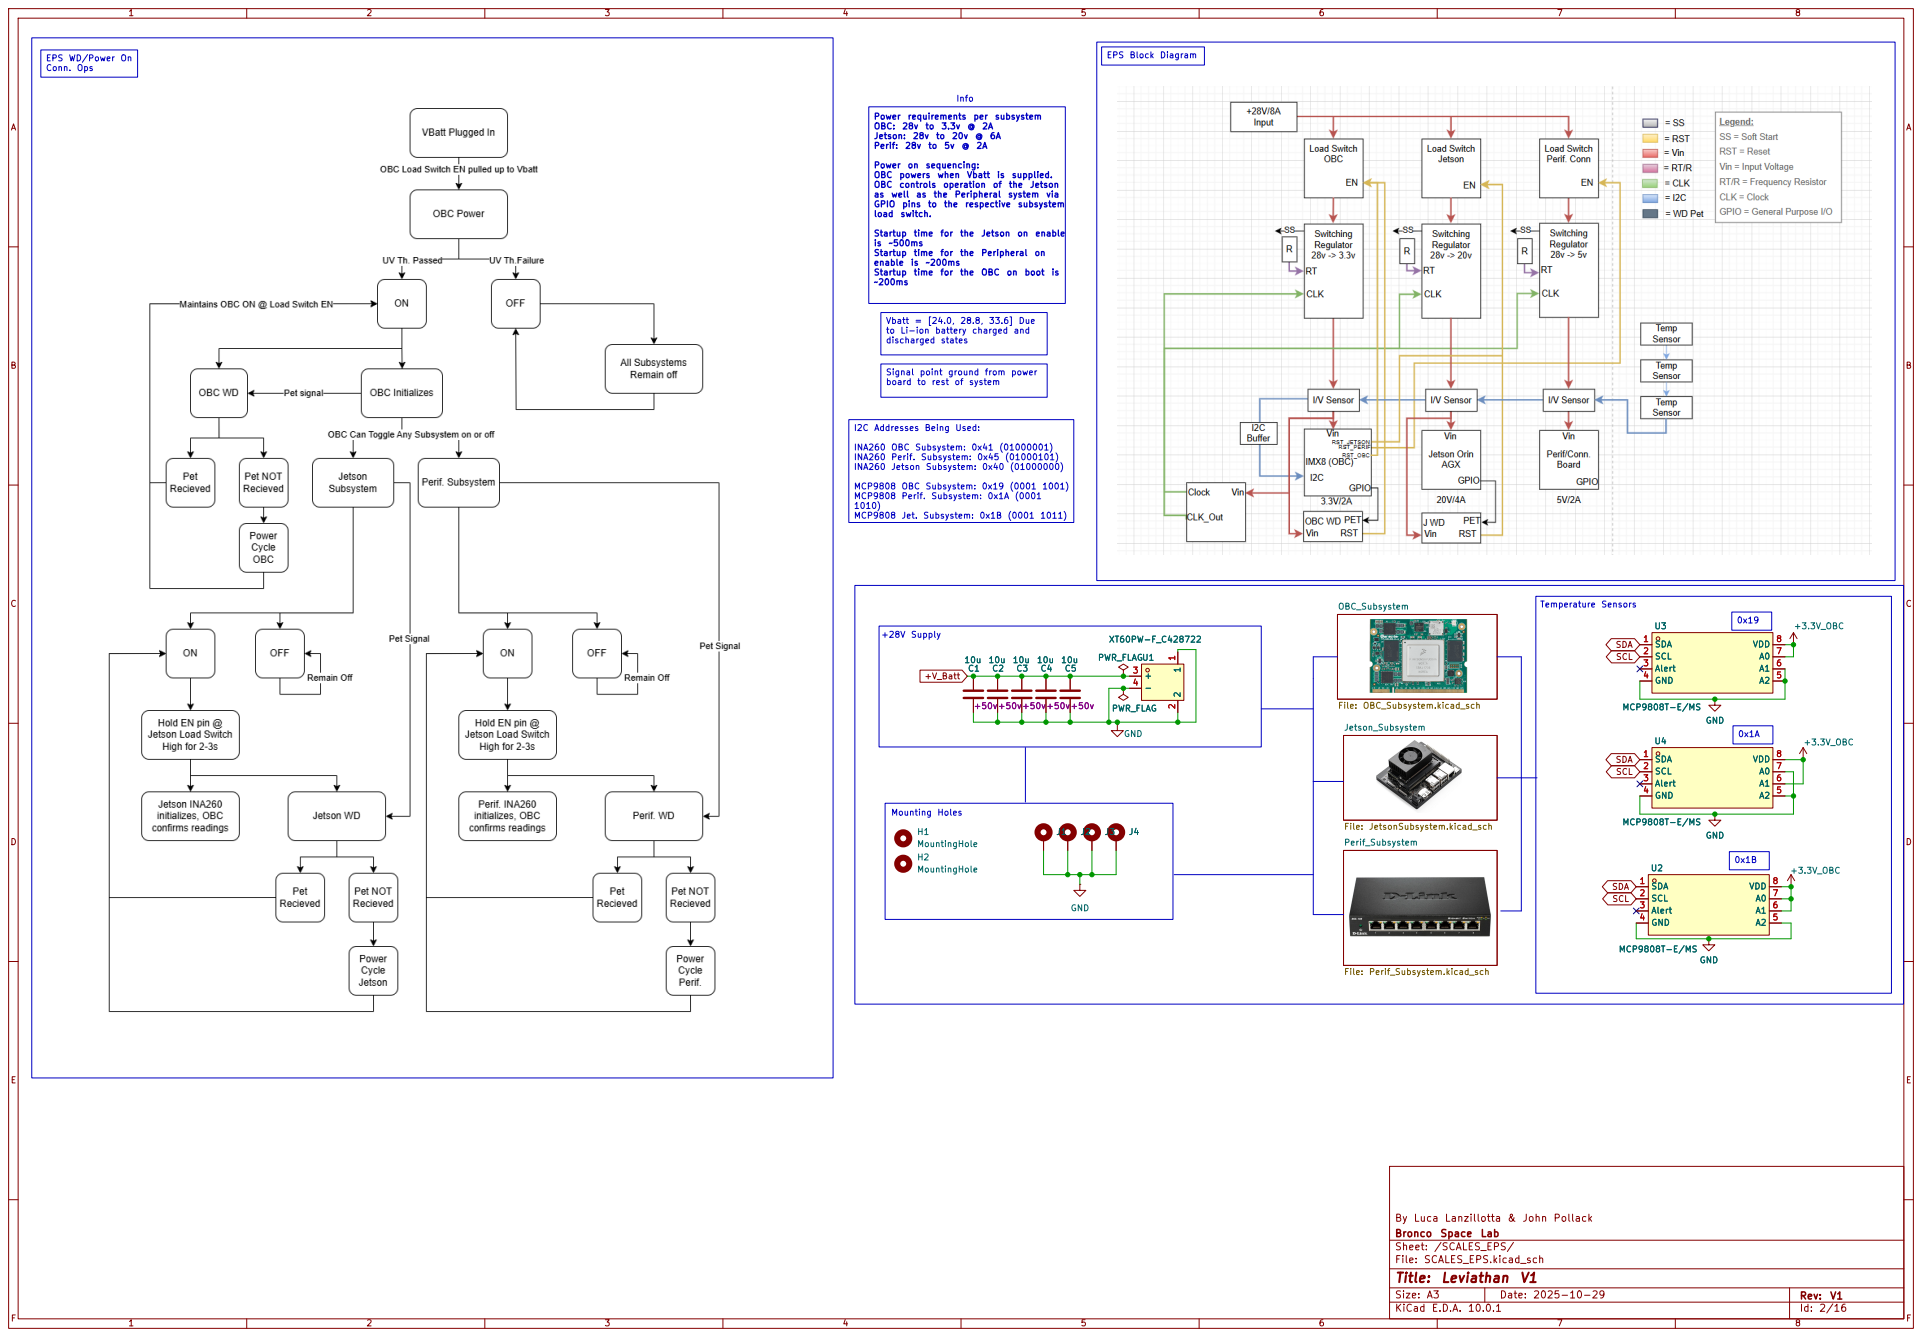
[picture p98: page 2]

~200ms EPS WD/Power On Conn. Ops

EPS Block Diagram
Info +28V Supply
Power requirements per subsystem
OBC: 28v to 3.3v @ 2A
Jetson: 28v to 20v @ 6A Perif: 28v to 5v @ 2A Power on sequencing: OBC powers when Vbatt is supplied. OBC controls operation of the Jetson

as well as the Peripheral system via GPIO pins to the respective subsystem
load switch. Startup time for the Jetson on enable

is ~500ms Startup time for the Peripheral on
enable is ~200ms Startup time for the OBC on boot is

Vbatt = [24.0, 28.8, 33.6] Due
to Li-ion battery charged and
discharged states Signal point ground from power board to rest of system

INA260 OBC Subsystem: 0x41 (01000001)
INA260 Perif. Subsystem: 0x45 (01000101)
INA260 Jetson Subsystem: 0x40 (01000000) MCP9808 OBC Subsystem: 0x19 (0001 1001) MCP9808 Perif. Subsystem: 0x1A (0001

By Luca Lanzillotta & John Pollack
Bronco Space Lab
Sheet: /SCALES_EPS/
File: SCALES_EPS.kicad_sch
Title: Leviathan V1

Size: A3 | Rev: V1
KiCad E.D.A. 10.0.1 | Id: 2/16

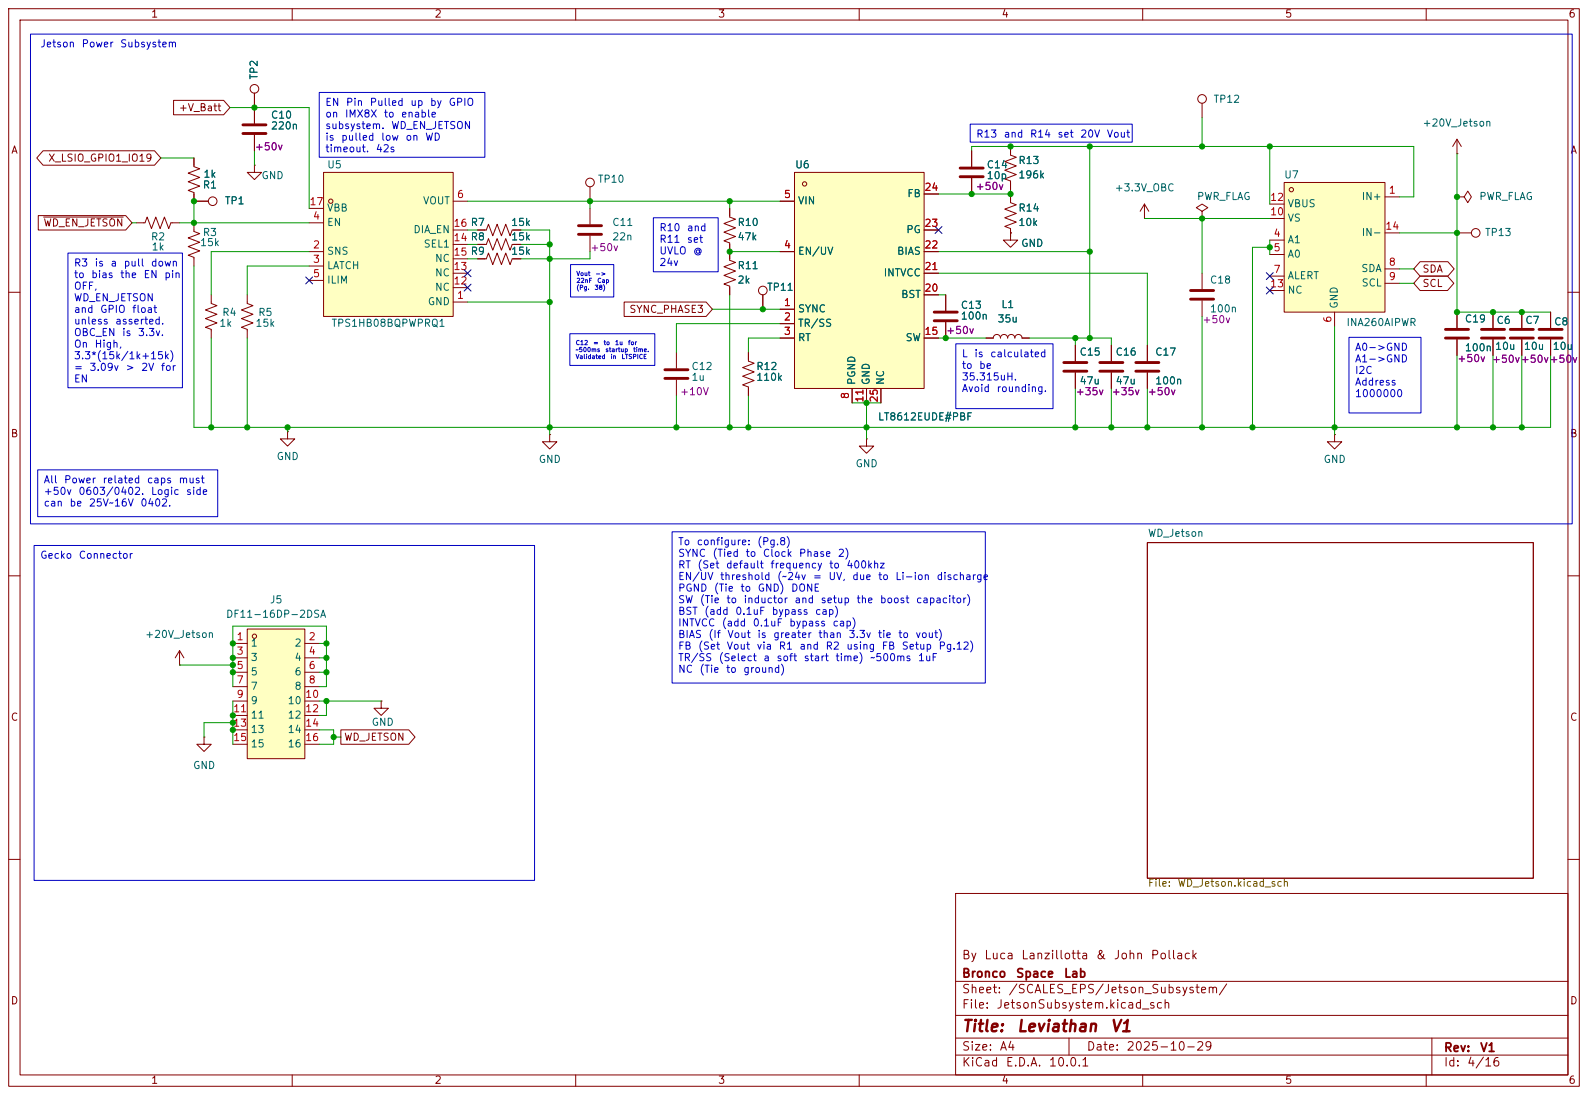
[picture p99: page 3]

R13 and R14 set 20V Vout EN Pin Pulled up by GPIO
on IMX8X to enable
subsystem. WD_EN_JETSON
is pulled low on WD

timeout. 42s All Power related caps must +50v 0603/0402. Logic side

TR/SS (Select a soft start time) ~500ms 1uF NC (Tie to ground) R10 and R11 set UVLO @

to be 35.315uH. Avoid rounding. R3 is a pull down
to bias the EN pin
OFF, WD_EN_JETSON

and GPIO float unless asserted. OBC_EN is 3.3v. On High,

can be 25V~16V 0402. Gecko Connector

To configure: (Pg.8) SYNC (Tied to Clock Phase 2) RT (Set default frequency to 400khz EN/UV threshold (~24v = UV, due to Li-ion discharge PGND (Tie to GND) DONE SW (Tie to inductor and setup the boost capacitor) BST (add 0.1uF bypass cap)

By Luca Lanzillotta & John Pollack WD_Jetson

1 | 1 2 3 4 5 6 7 8 9 | 2

INTVCC (add 0.1uF bypass cap) BIAS (If Vout is greater than 3.3v tie to vout) FB (Set Vout via R1 and R2 using FB Setup Pg.12)

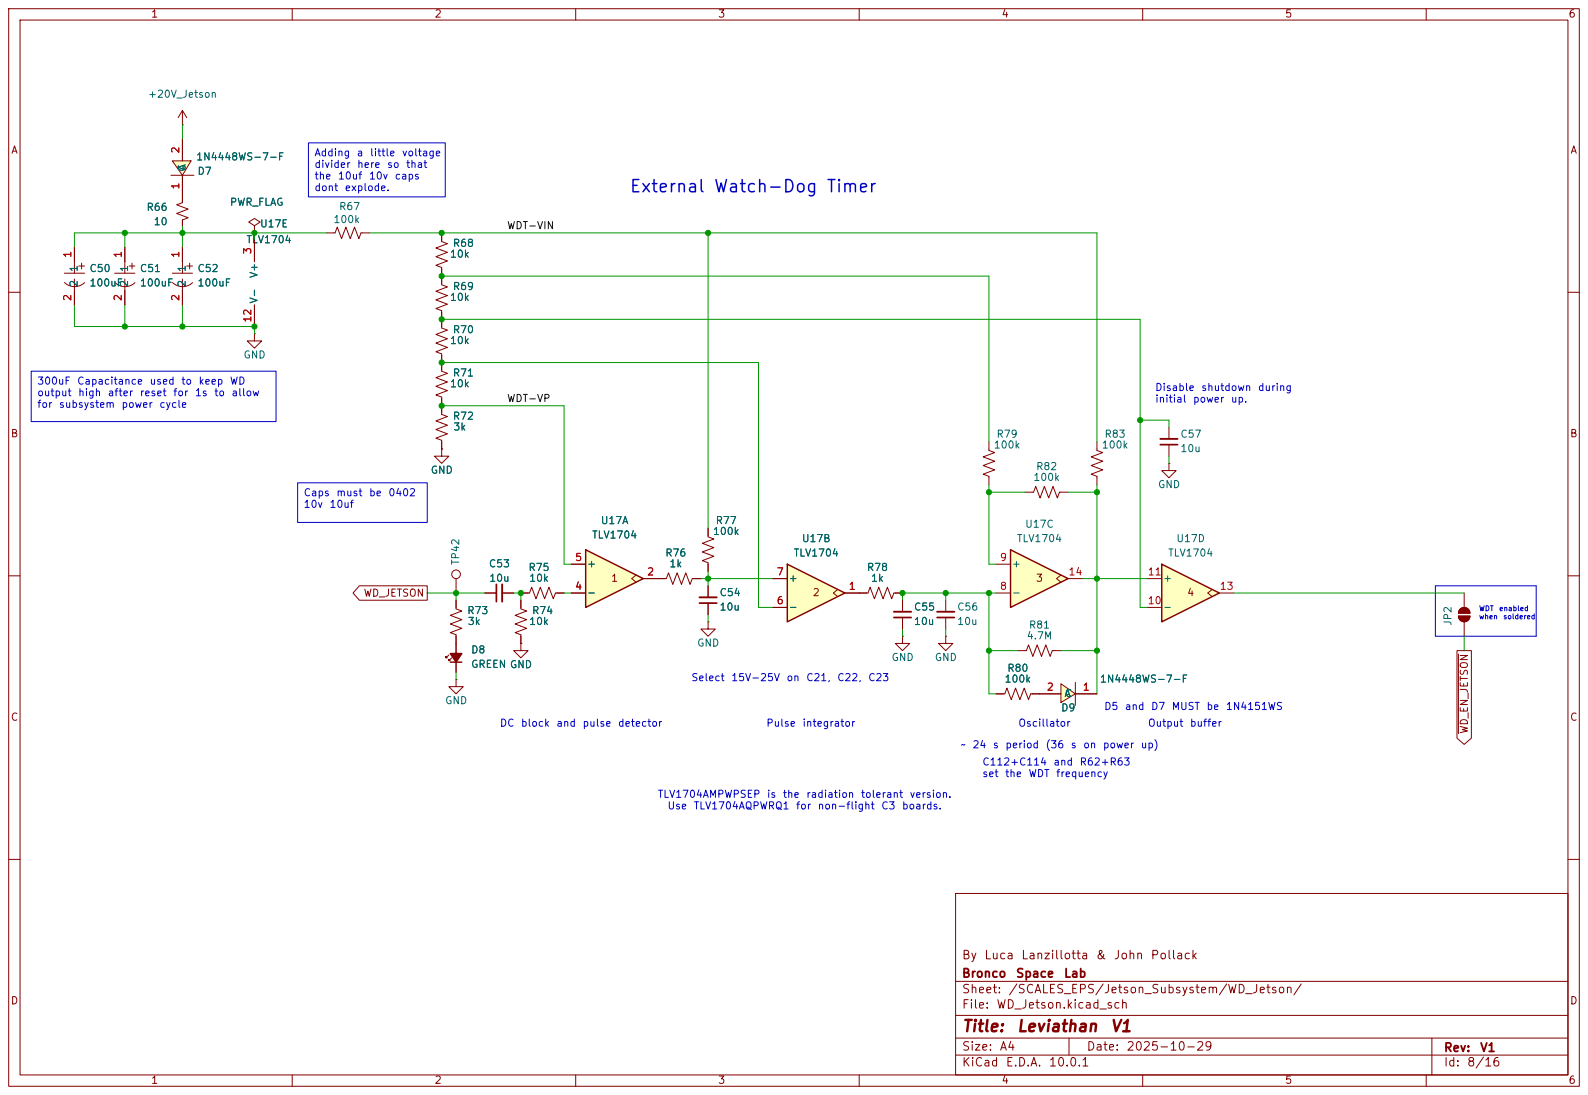
[picture p100: page 4]

Adding a little voltage divider here so that

the 10uf 10v caps dont explode.

10v 10uf 300uF Capacitance used to keep WD
output high after reset for 1s to allow

~ 24 s period (36 s on power up)Disable shutdown during

By Luca Lanzillotta & John Pollack C

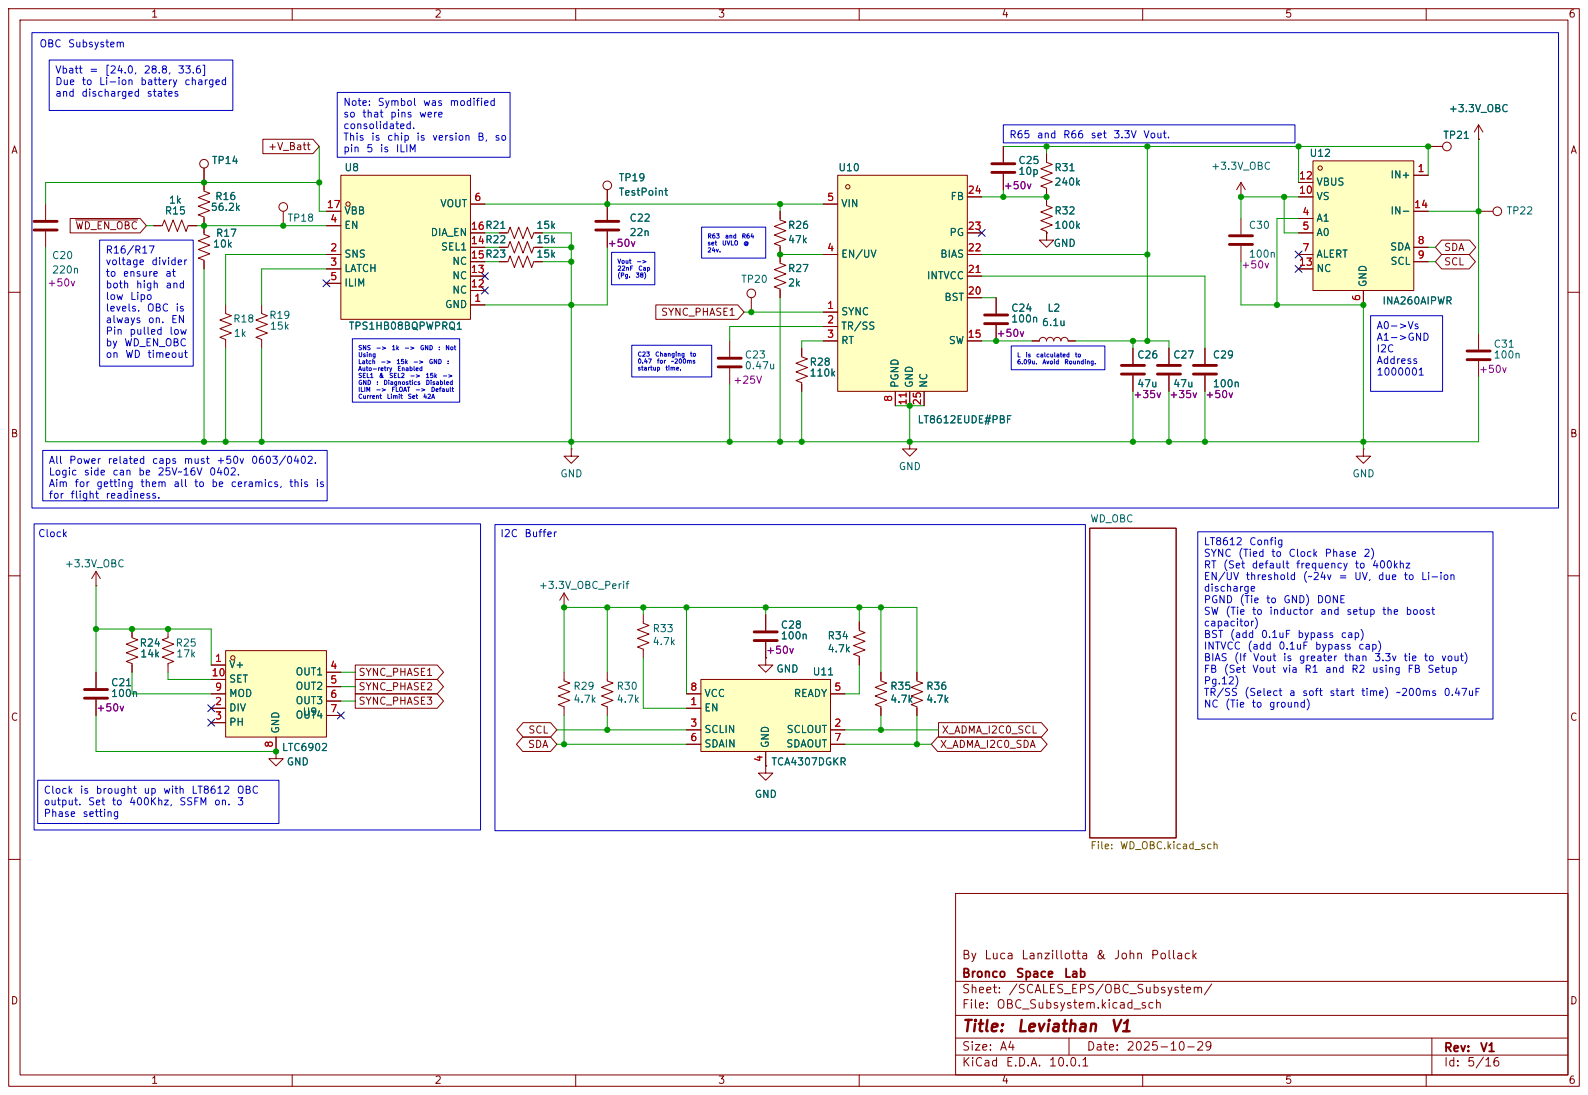
[picture p101: page 5]

output. Set to 400Khz, SSFM on. 3 Phase setting Clock OBC Subsystem

startup time. Vbatt = [24.0, 28.8, 33.6] Due to Li-ion battery charged

so that pins were
consolidated. This is chip is version B, so

voltage divider
to ensure at both high and

22nF Cap
(Pg. 38) C23 Changing to 0.47 for ~200ms

low Lipo
levels. OBC is always on. EN
Pin pulled low
by WD_EN_OBC

L is calculated to 6.09u. Avoid Rounding. All Power related caps must +50v 0603/0402.
Address 1000001 Clock is brought up with LT8612 OBC

SNS -> 1k -> GND : Not Using

Latch -> 15k -> GND : Auto-retry Enabled SEL1 & SEL2 -> 15k ->

GND : Diagnostics Disabled
ILIM -> FLOAT -> Default Current Limit Set 42A

Logic side can be 25V~16V 0402. Aim for getting them all to be ceramics, this is

By Luca Lanzillotta & John Pollack WD_OBC

LT8612 Config SYNC (Tied to Clock Phase 2) RT (Set default frequency to 400khz EN/UV threshold (~24v = UV, due to Li-ion

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

TR/SS (Select a soft start time) ~200ms 0.47uF NC (Tie to ground)

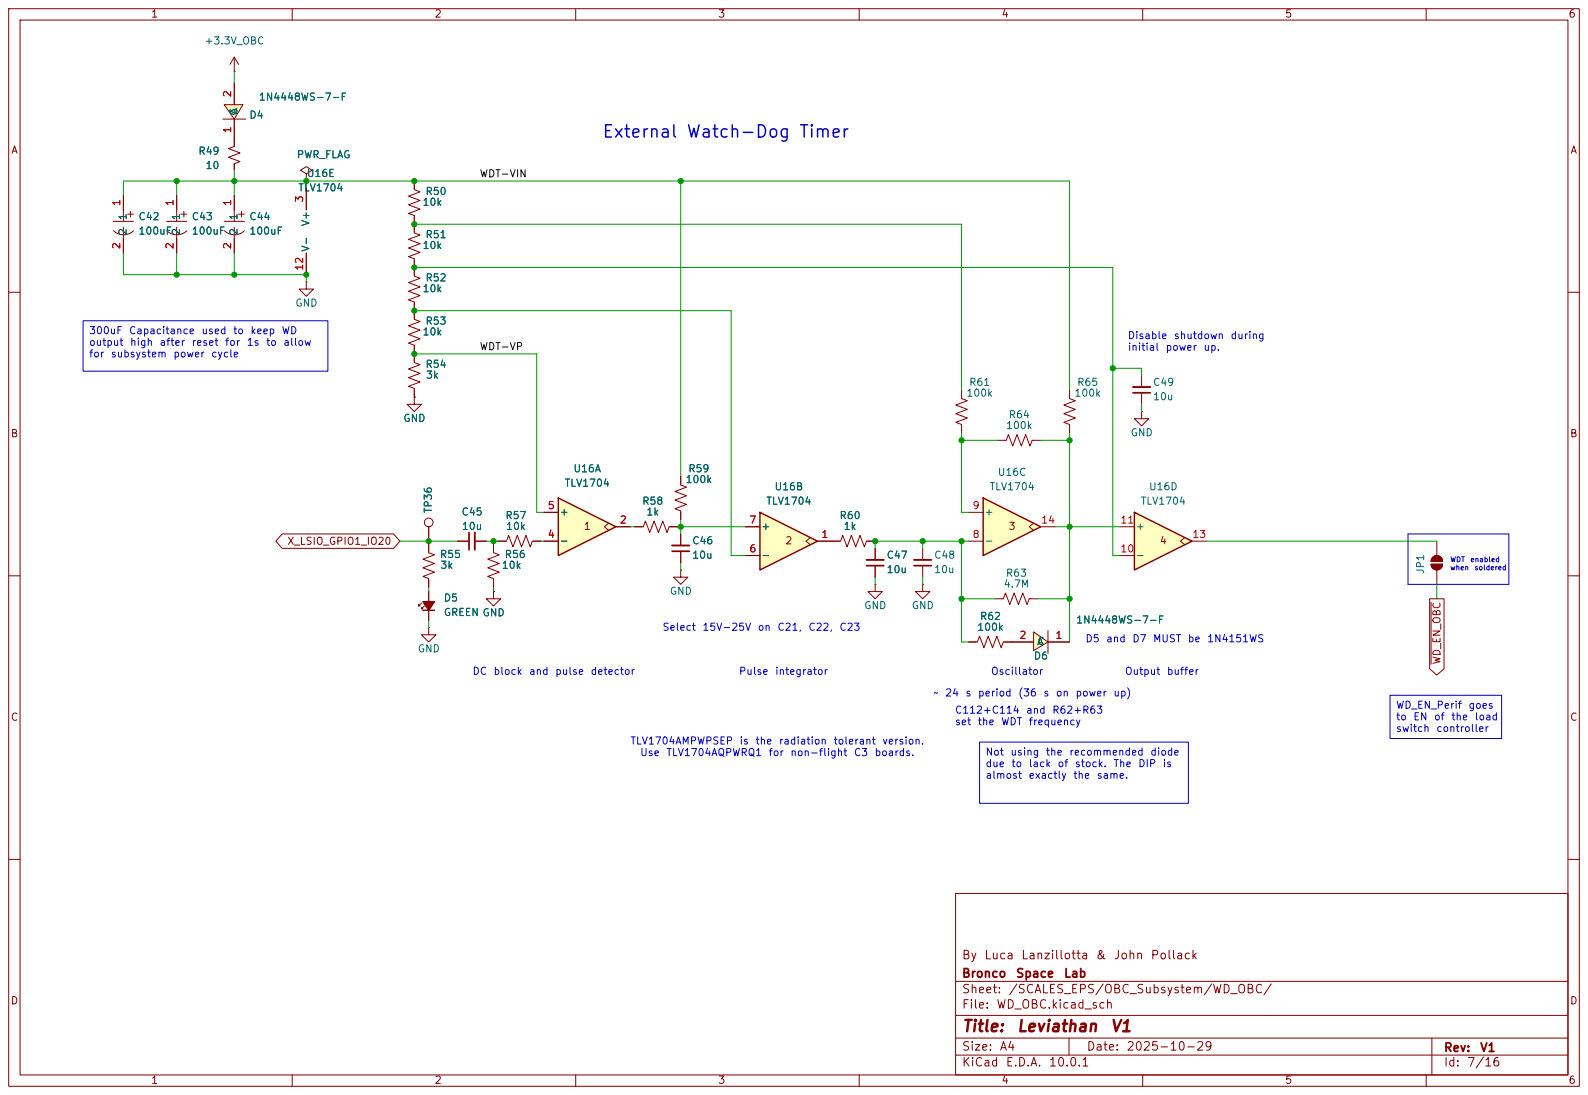
[picture p102: page 6]

initial power up. Select 15V-25V on C21, C22, C23 External Watch-Dog Timer

switch controller Not using the recommended diode due to lack of stock. The DIP is almost exactly the same. 300uF Capacitance used to keep WD
output high after reset for 1s to allow

TLV1704AMPWPSEP is the radiation tolerant version. Use TLV1704AQPWRQ1 for non-flight C3 boards. C47

to EN of the load

By Luca Lanzillotta & John Pollack
Bronco Space Lab
Sheet: /SCALES_EPS/OBC_Subsystem/WD_OBC/
File: WD_OBC.kicad_sch
Title: Leviathan V1

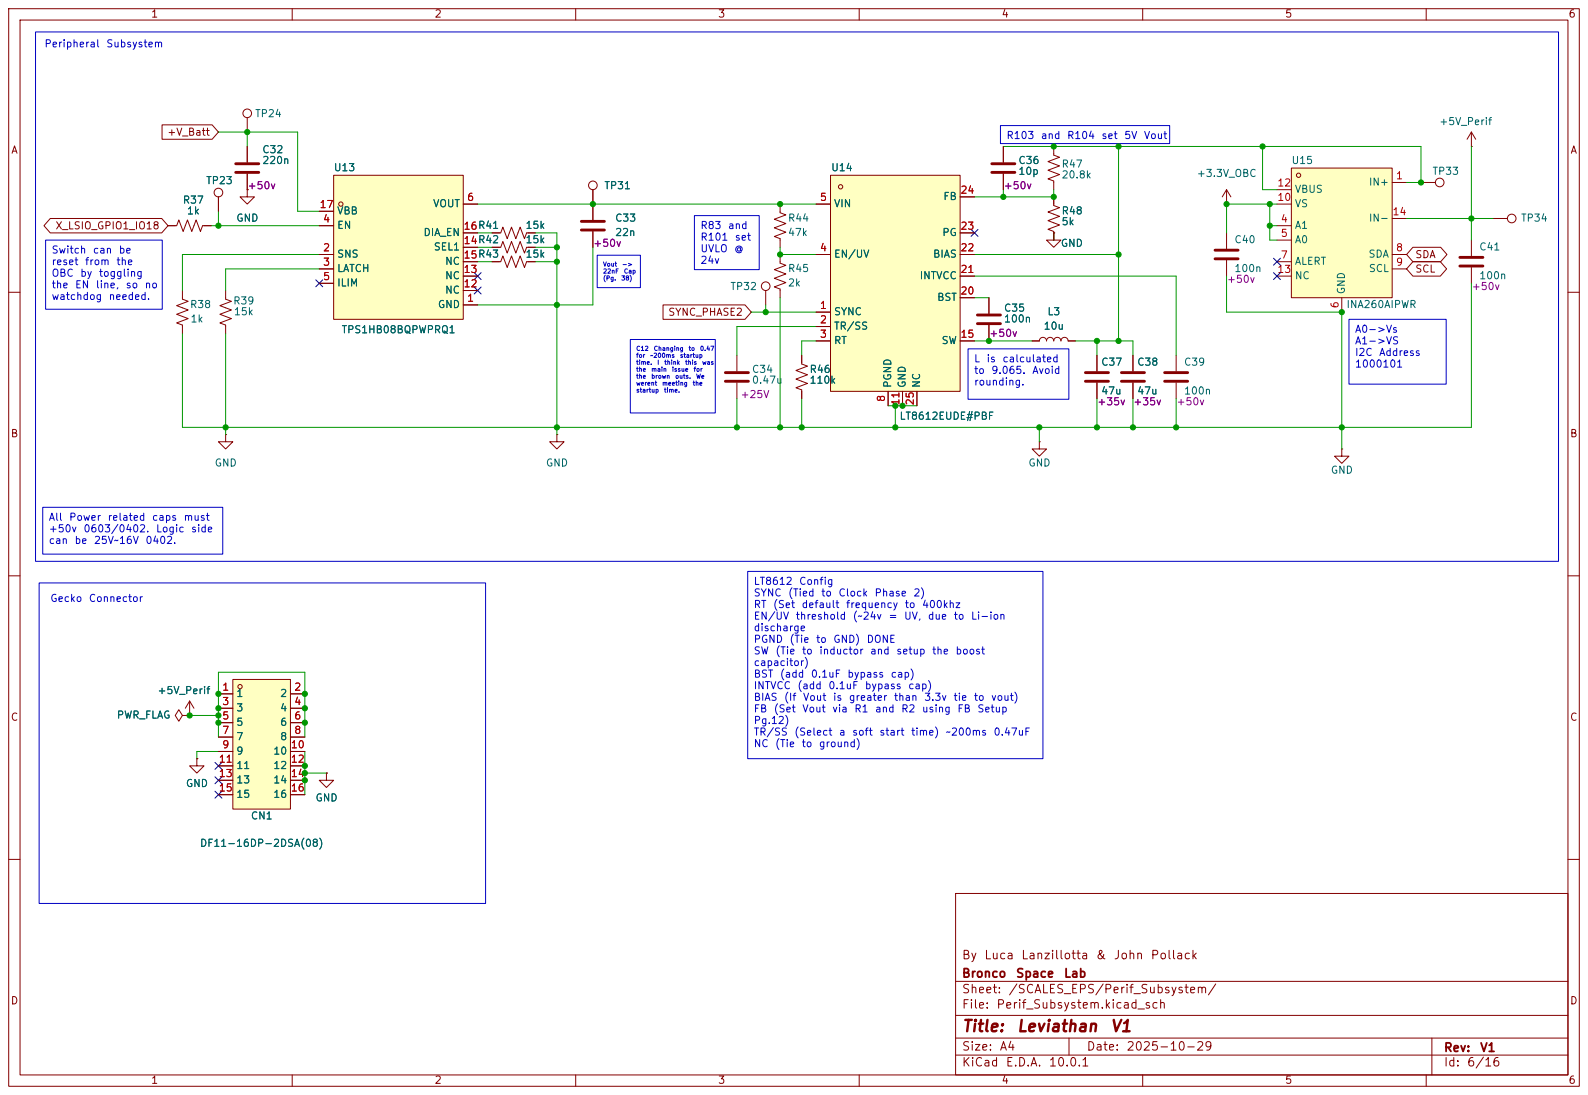
[picture p103: page 7]

TP31 GND
the EN line, so no watchdog needed. Gecko Connector

Switch can be
reset from the OBC by toggling

C12 Changing to 0.47
for ~200ms startup
time. I think this was
the main issue for
the brown outs. We werent meeting the

All Power related caps must +50v 0603/0402. Logic side

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

TR/SS (Select a soft start time) ~200ms 0.47uF NC (Tie to ground)

By Luca Lanzillotta & John Pollack
Bronco Space Lab
Sheet: /SCALES_EPS/Perif_Subsystem/
File: Perif_Subsystem.kicad_sch
Title: Leviathan V1

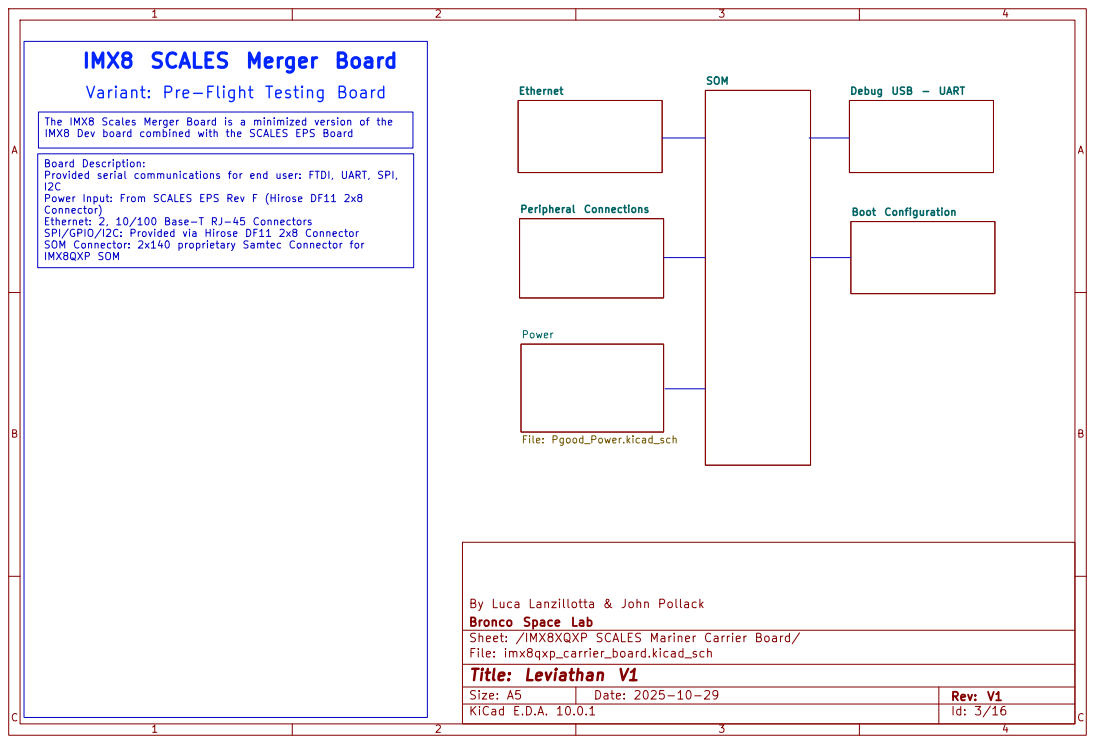
[picture p104: page 8]

IMX8QXP SOM Variant: Pre-Flight Testing Board

The IMX8 Scales Merger Board is a minimized version of the
IMX8 Dev board combined with the SCALES EPS Board Board Description: Provided serial communications for end user: FTDI, UART, SPI,

Power Input: From SCALES EPS Rev F (Hirose DF11 2x8 Connector) Ethernet: 2, 10/100 Base-T RJ-45 Connectors SPI/GPIO/I2C: Provided via Hirose DF11 2x8 Connector SOM Connector: 2x140 proprietary Samtec Connector for

Bronco Space Lab
Sheet: /IMX8XQXP SCALES Mariner Carrier Board/
File: imx8qxp_carrier_board.kicad_sch
Title: Leviathan V1

Size: A5 | Rev: V1 | C Date: 2025-10-29
KiCad E.D.A. 10.0.1 | Id: 3/16

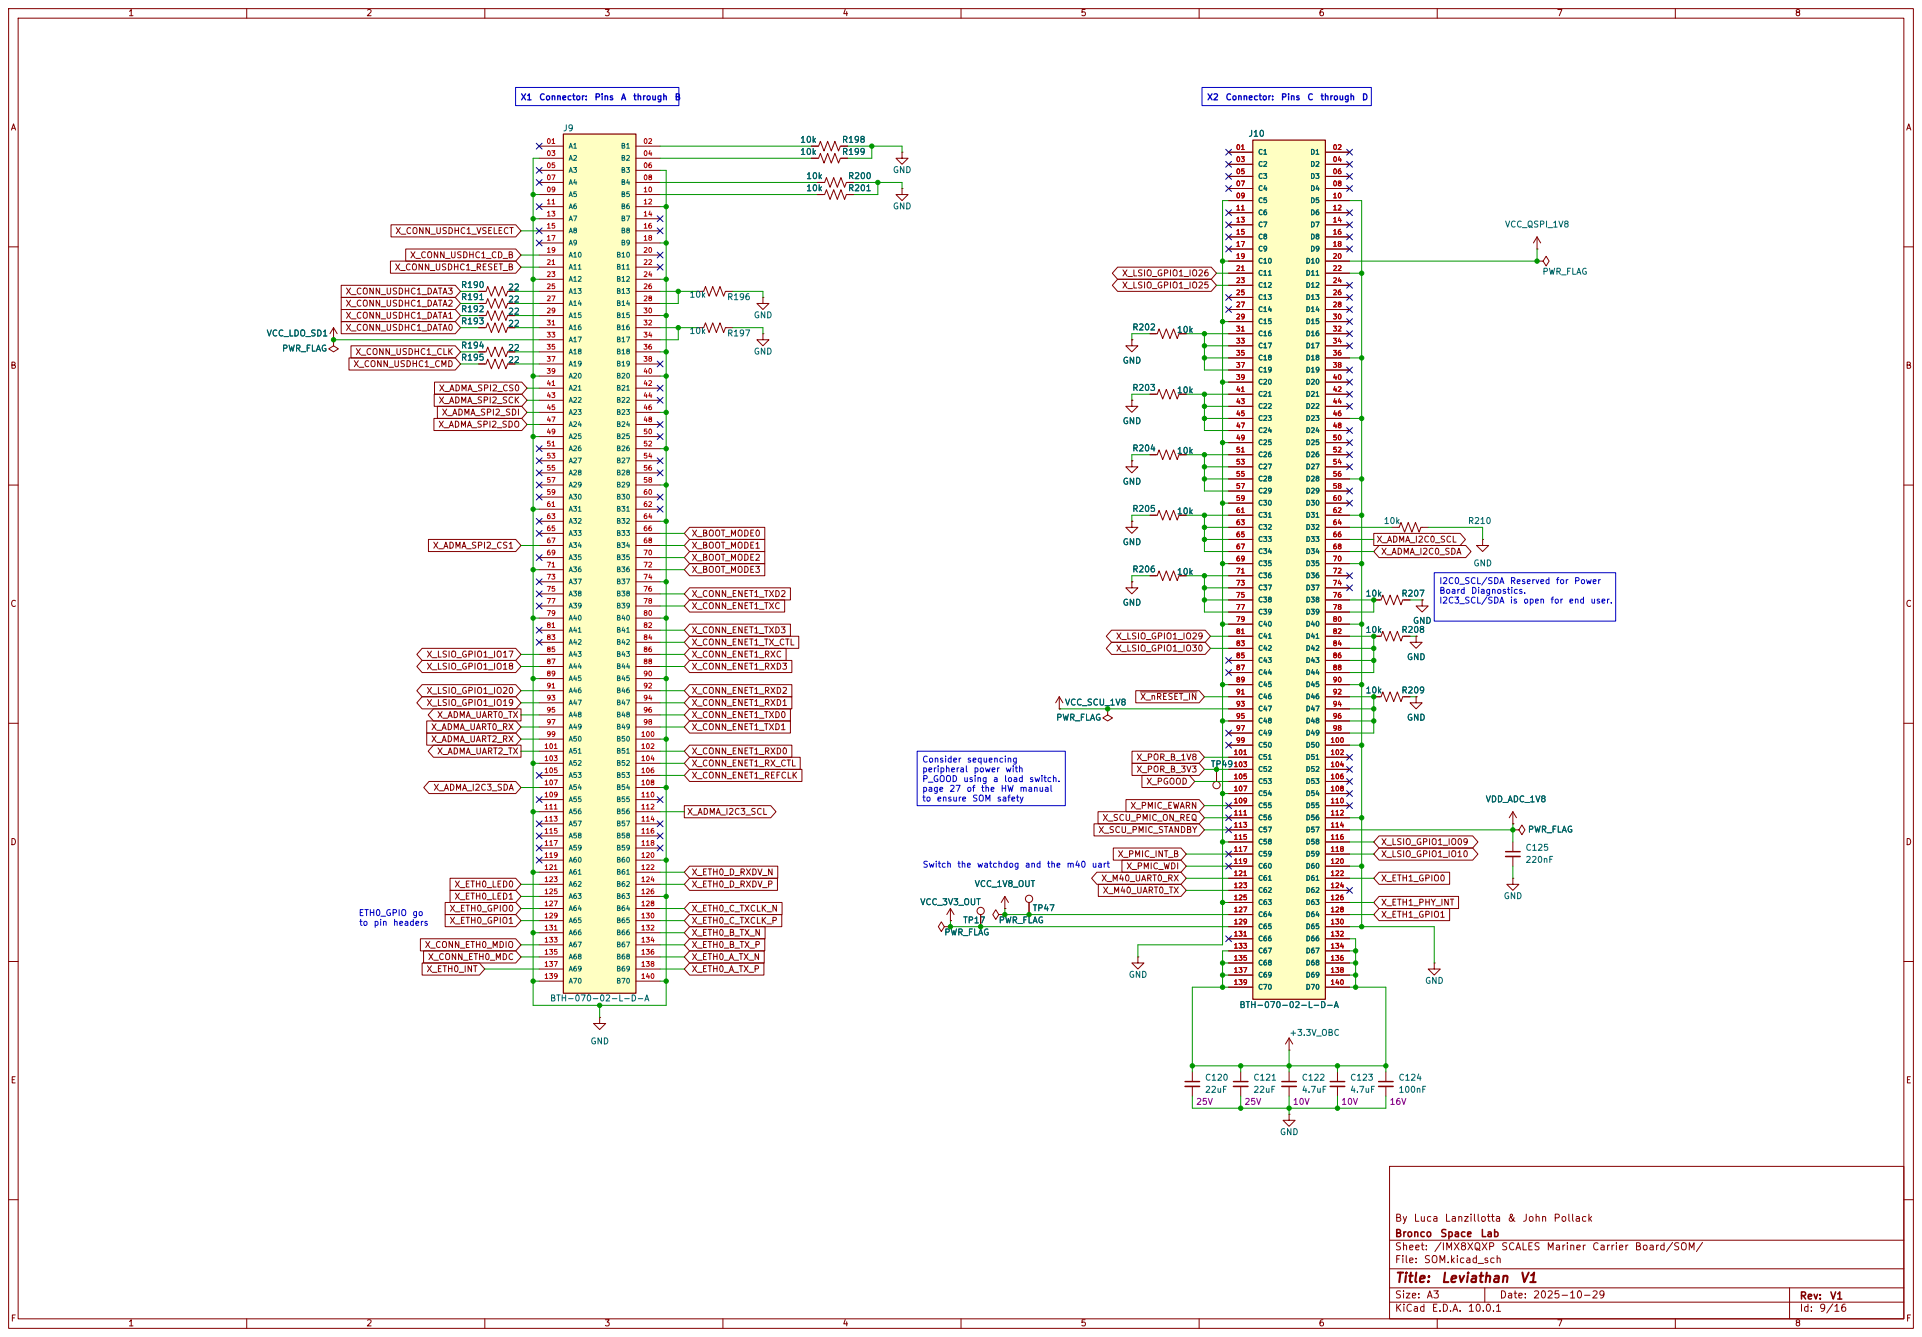
[picture p105: page 9]

I2C0_SCL/SDA Reserved for Power Board Diagnostics.

I2C3_SCL/SDA is open for end user.

peripheral power with P_GOOD using a load switch. page 27 of the HW manual to ensure SOM safety ETH0_GPIO go

By Luca Lanzillotta & John Pollack
Bronco Space Lab
Sheet: /IMX8XQXP SCALES Mariner Carrier Board/SOM/
File: SOM.kicad_sch
Title: Leviathan V1

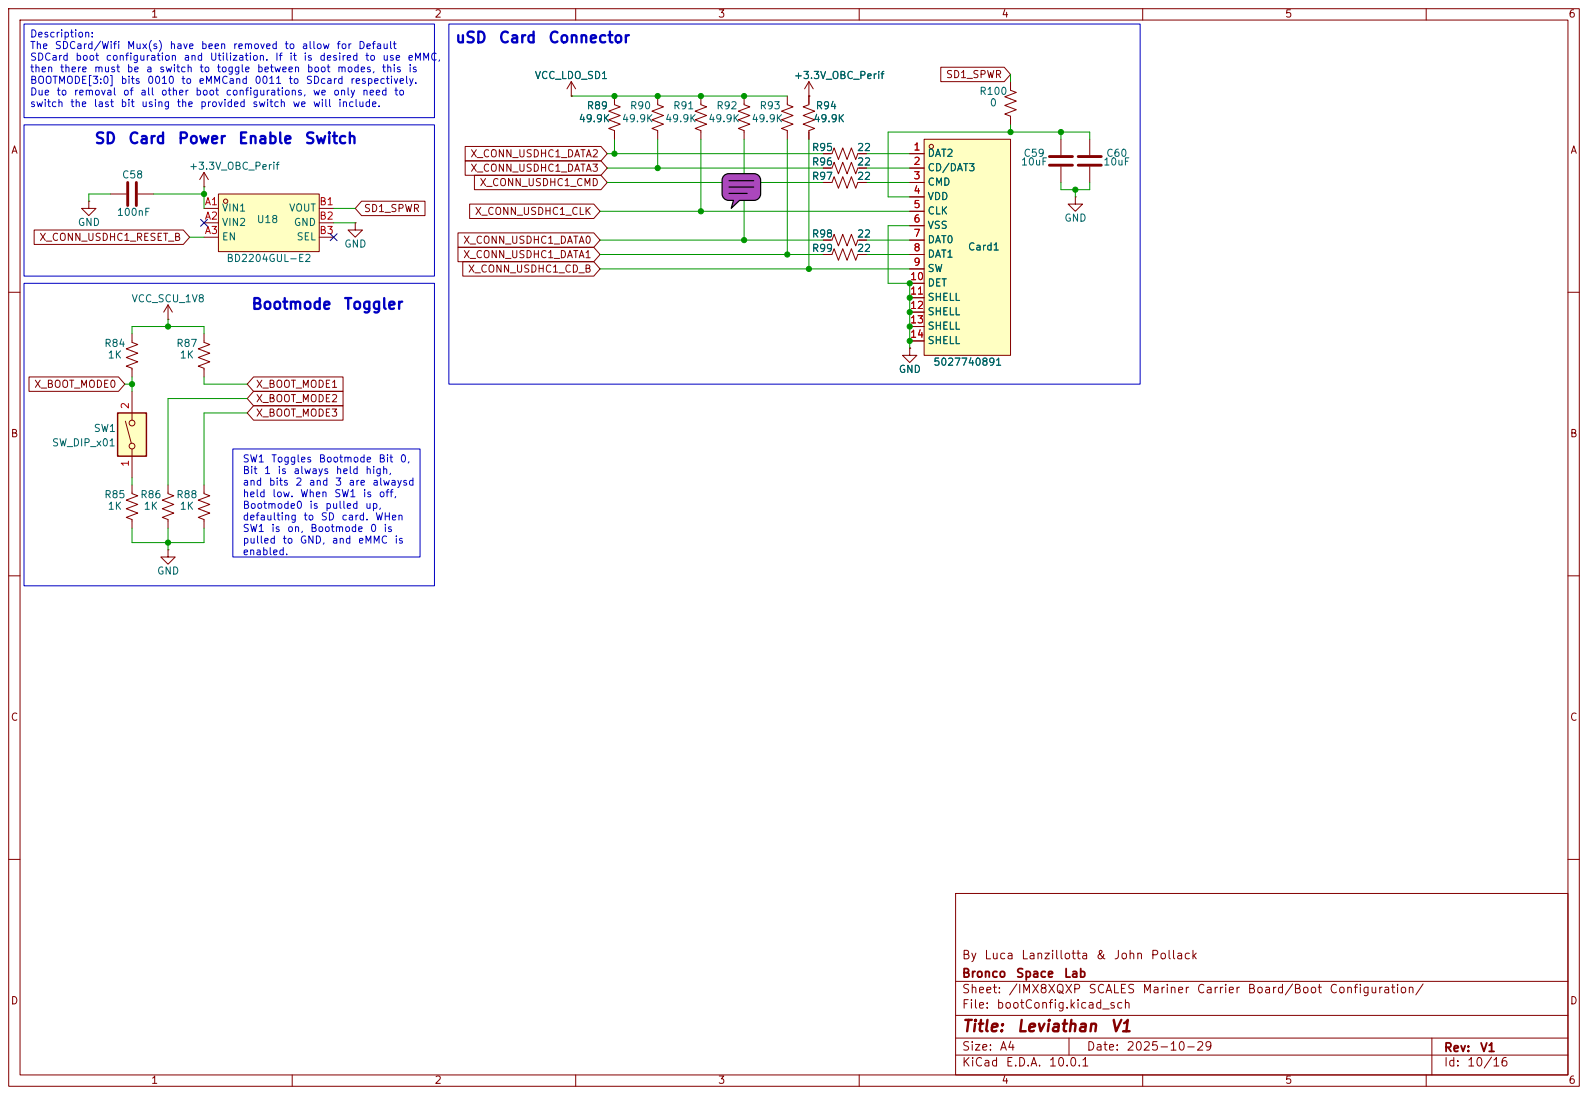
[picture p106: page 10]

X_BOOT_MODE1 Description: The SDCard/Wifi Mux(s) have been removed to allow for Default SDCard boot configuration and Utilization. If it is desired to use eMMC, then there must be a switch to toggle between boot modes, this is BOOTMODE[3:0] bits 0010 to eMMCand 0011 to SDcard respectively. Due to removal of all other boot configurations, we only need to

switch the last bit using the provided switch we will include. SW1 Toggles Bootmode Bit 0, Bit 1 is always held high, and bits 2 and 3 are alwaysd

held low. When SW1 is off, Bootmode0 is pulled up, defaulting to SD card. WHen SW1 is on, Bootmode 0 is pulled to GND, and eMMC is enabled. SD Card Power Enable Switch

By Luca Lanzillotta & John Pollack
Bronco Space Lab
Sheet: /IMX8XQXP SCALES Mariner Carrier Board/Boot Configuration/
File: bootConfig.kicad_sch
Title: Leviathan V1

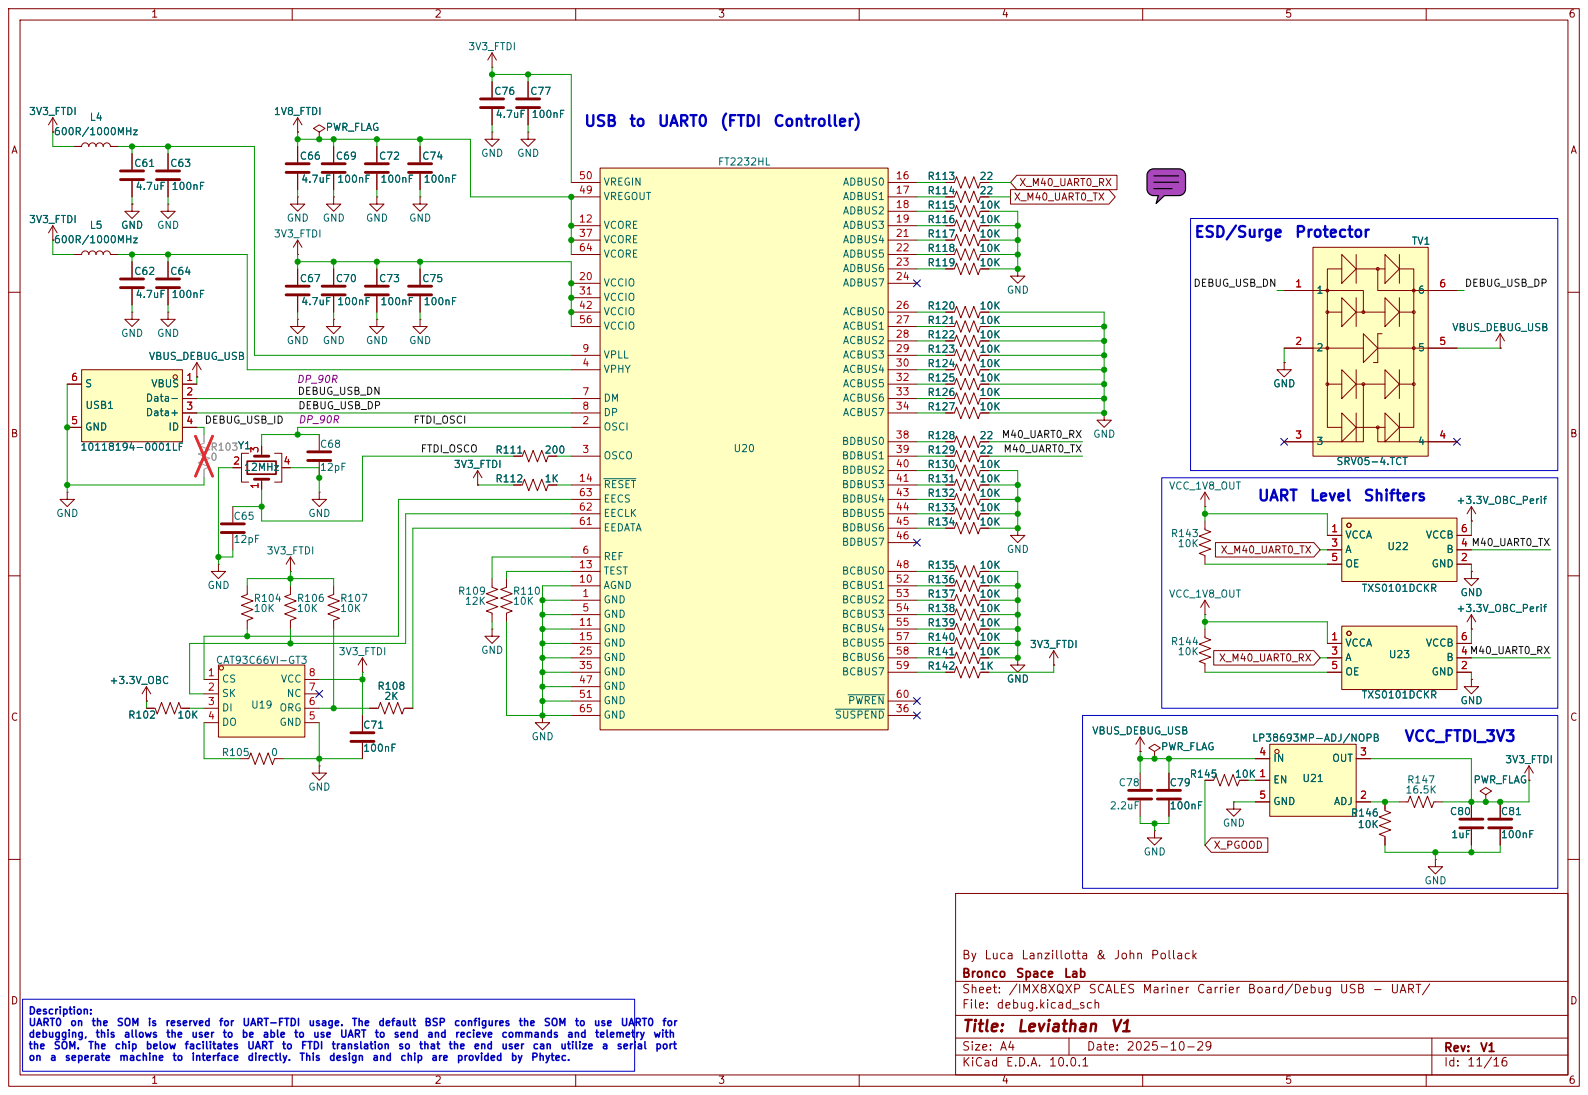
[picture p107: page 11]

USB to UART0 (FTDI Controller)

Bronco Space Lab
Sheet: /IMX8XQXP SCALES Mariner Carrier Board/Debug USB - UART/
File: debug.kicad_sch
Title: Leviathan V1

Description: UART0 on the SOM is reserved for UART-FTDI usage. The default BSP configures the SOM to use UART0 for debugging, this allows the user to be able to use UART to send and recieve commands and telemetry with

the SOM. The chip below facilitates UART to FTDI translation so that the end user can utilize a serial port on a seperate machine to interface directly. This design and chip are provided by Phytec.

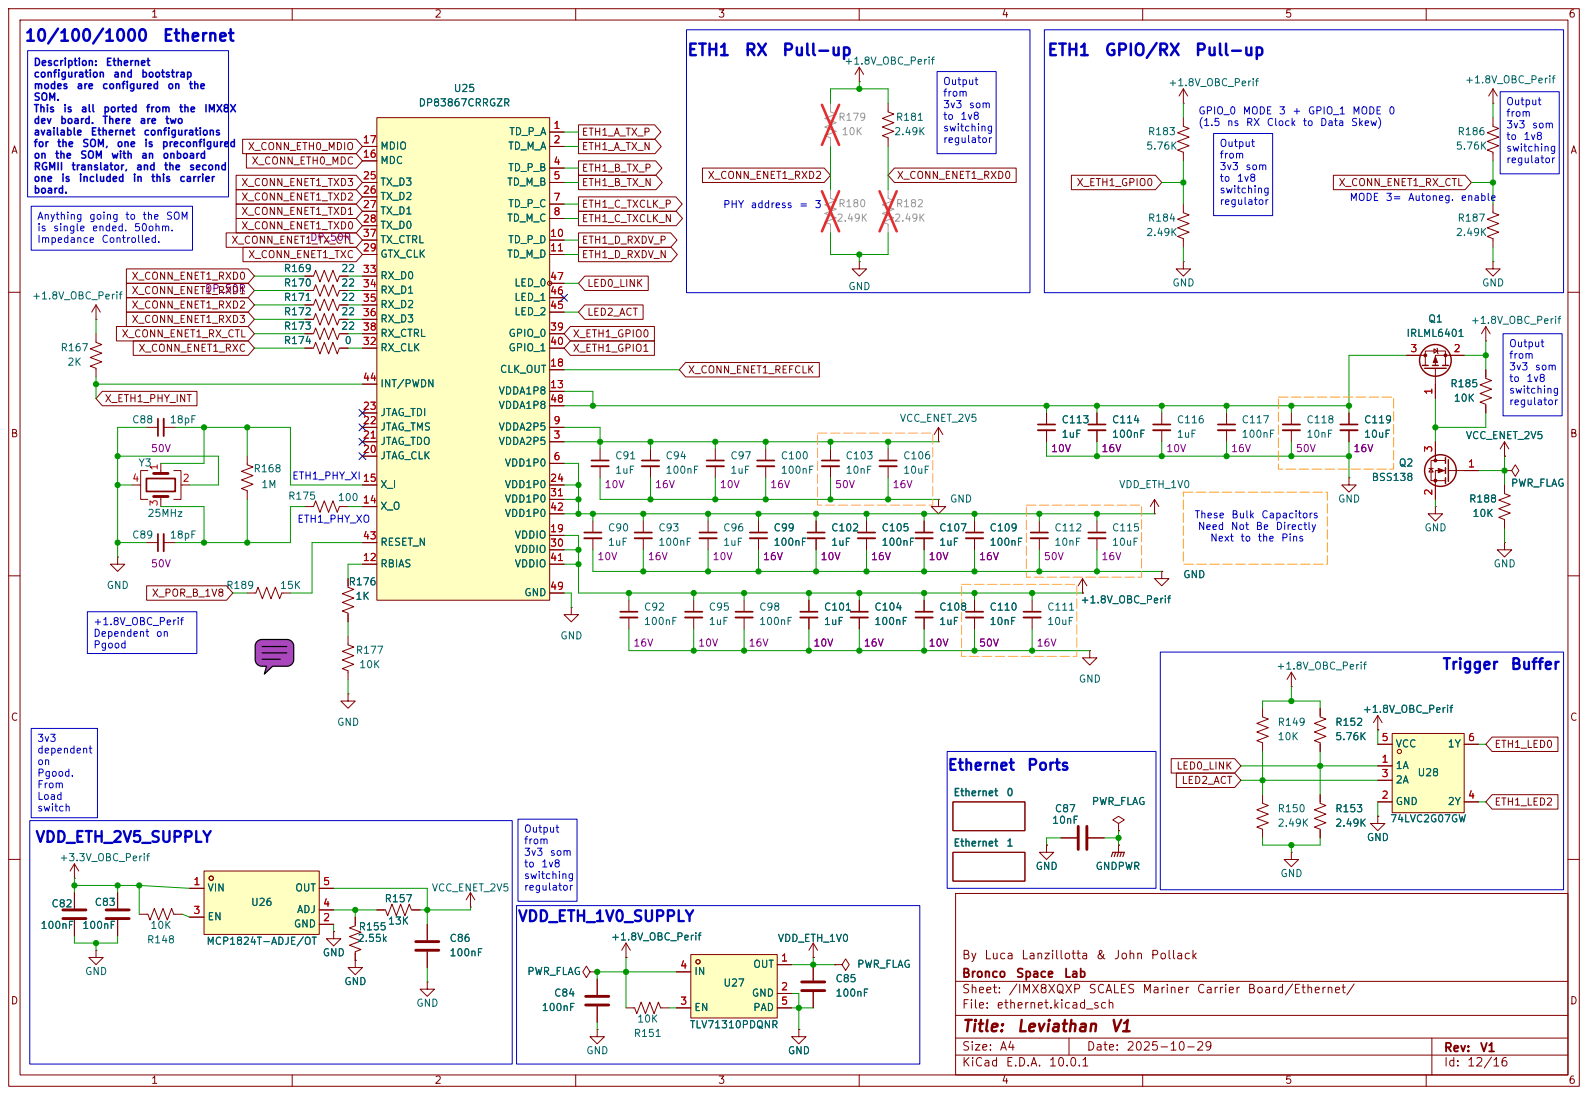
[picture p108: page 12]

ETH1 GPIO/RX Pull-up
10nF 50V +1.8V_OBC_Perif C108

Description: Ethernet configuration and bootstrap modes are configured on the SOM. This is all ported from the IMX8X

dev board. There are two
available Ethernet configurations
for the SOM, one is preconfigured
on the SOM with an onboard RGMII translator, and the second
X_CONN_ENET1_RX_CTL Anything going to the SOM

GPIO_0 MODE 3 + GPIO_1 MODE 0
(1.5 ns RX Clock to Data Skew)

regulator +1.8V_OBC_Perif Dependent on Pgood

These Bulk Capacitors Need Not Be Directly Next to the Pins VDD_ETH_1V0_SUPPLY
VDDIO 19
VDDIO 30
VDDIO 41

2.49K | Trigger Buffer

VDD_ETH_2V5_SUPPLY | Output from 3v3 som to 1v8 switching regulator

By Luca Lanzillotta & John Pollack
Bronco Space Lab
Sheet: /IMX8XQXP SCALES Mariner Carrier Board/Ethernet/
File: ethernet.kicad_sch
Title: Leviathan V1

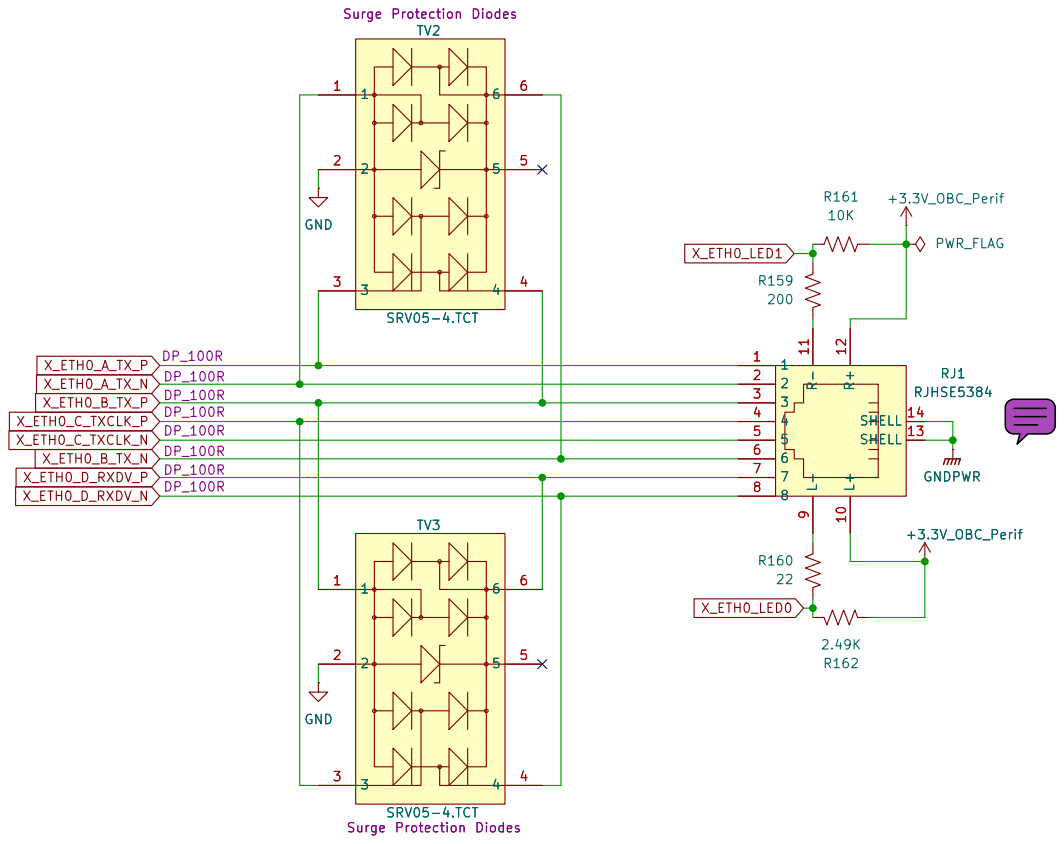
[picture p109: page 13]

SRV05-4.TCT Surge Protection Diodes GND

SRV05-4.TCT Surge Protection Diodes 1

By Luca Lanzillotta & John Pollack
Bronco Space Lab
Sheet: /IMX8XQXP SCALES Mariner Carrier Board/Ethernet/Ethernet 0/
File: ethernet0.kicad_sch
Title: Leviathan V1

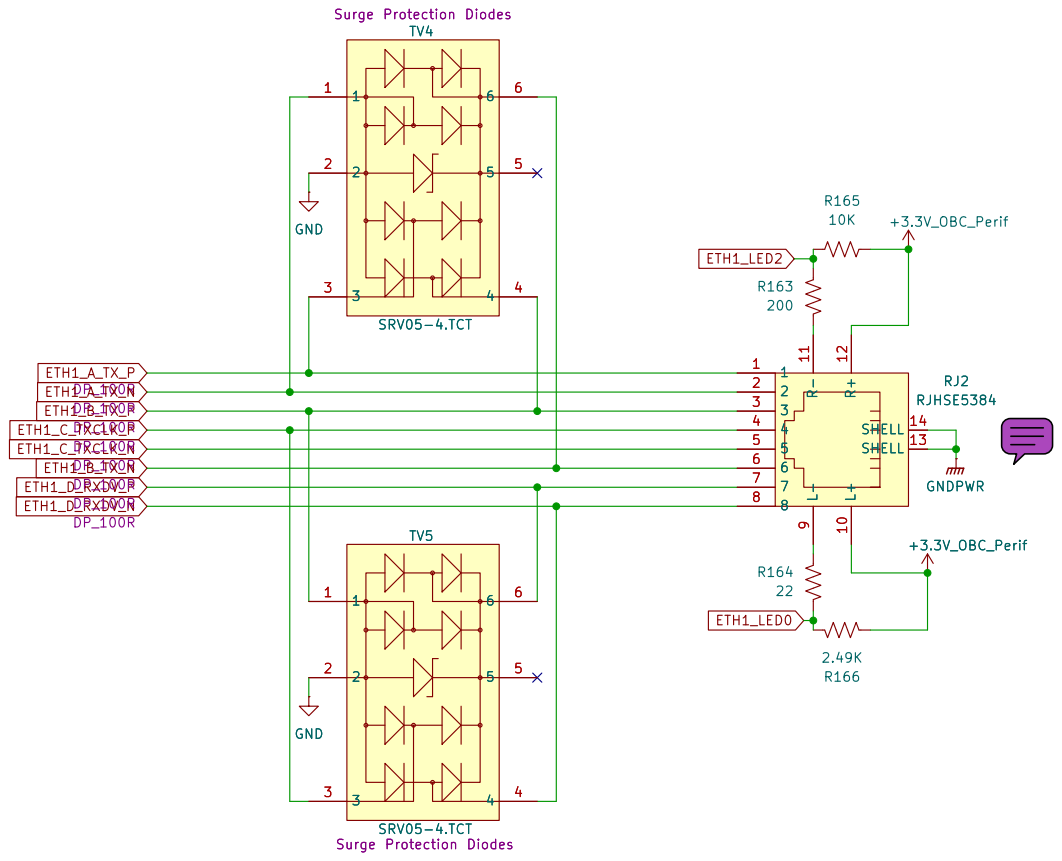
[picture p110: page 14]

SRV05-4.TCT Surge Protection Diodes 1

SRV05-4.TCT Surge Protection Diodes GND

By Luca Lanzillotta & John Pollack
Bronco Space Lab
Sheet: /IMX8XQXP SCALES Mariner Carrier Board/Ethernet/Ethernet 1/
File: ethernet1.kicad_sch
Title: Leviathan V1

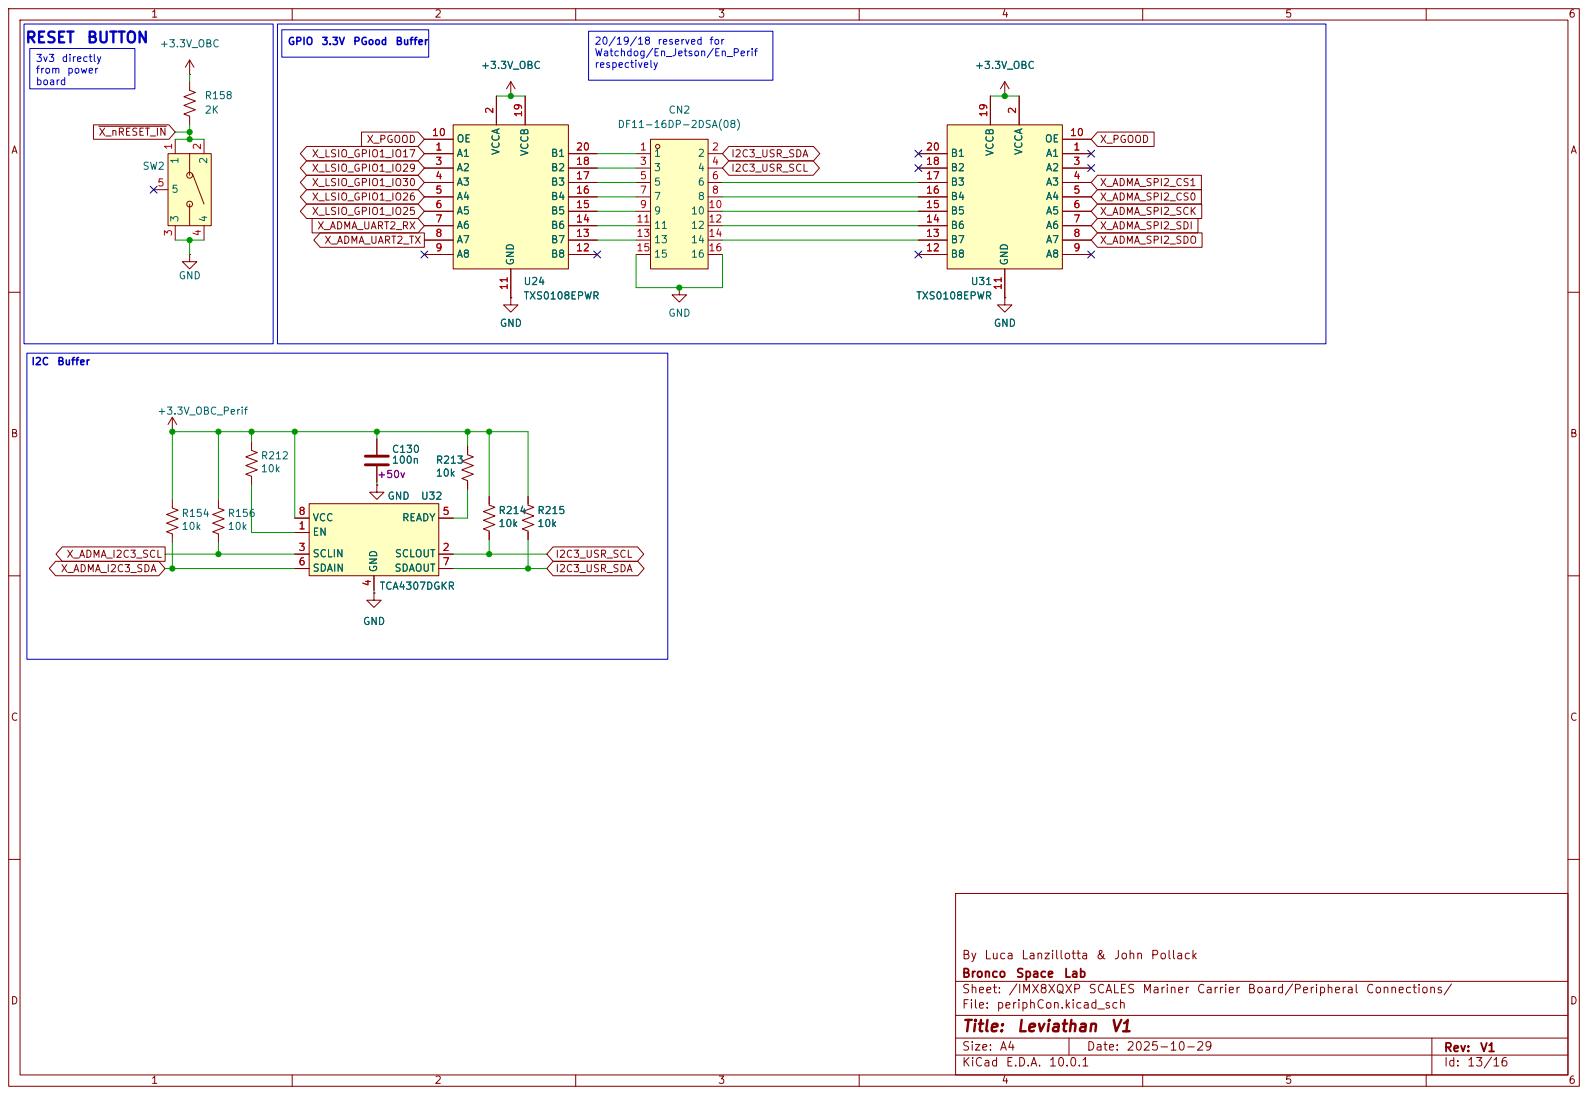
[picture p111: page 15]

A3 4 | 5 | | 6
A4 5 | 7 | | 8
A5 6 | 9 | 10 10
A6 7 | | 11 11 12 12
A7 8 | | 13 13 14 14

By Luca Lanzillotta & John Pollack
Bronco Space Lab
Sheet: /IMX8XQXP SCALES Mariner Carrier Board/Peripheral Connections/
File: periphCon.kicad_sch
Title: Leviathan V1

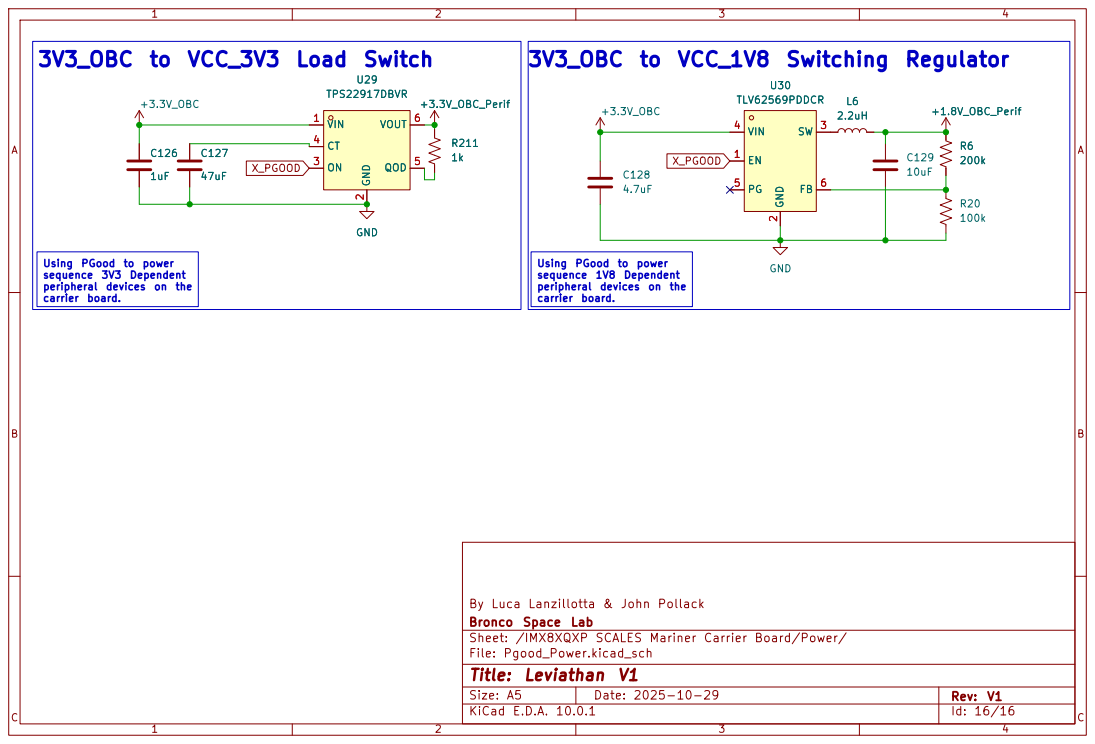
[picture p112: page 16]

By Luca Lanzillotta & John Pollack C127

carrier board. Using PGood to power sequence 3V3 Dependent
peripheral devices on the

Bronco Space Lab
Sheet: /IMX8XQXP SCALES Mariner Carrier Board/Power/
File: Pgood_Power.kicad_sch
Title: Leviathan V1

Size: A5 | Rev: V1 | C Date: 2025-10-29
KiCad E.D.A. 10.0.1 | Id: 16/16
