BroncoSpace-Lab/scales-hardware/imx8x_eps_leviathan_v2/reviews/revision reviews/imx8x_eps_leviathan_dsmith.pdf

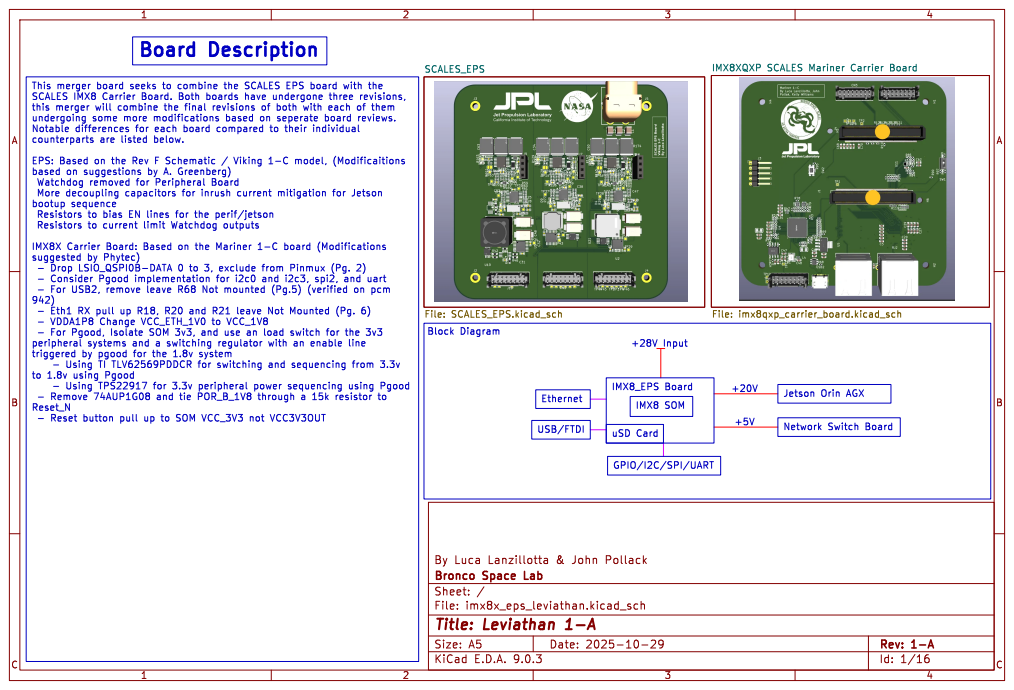
[picture p113: page 1]

Jetson Orin AGX USB/FTDI Network Switch Board Board Description IMX8XQXP SCALES Mariner Carrier Board File: imx8qxp_carrier_board.kicad_sch

SCALES_EPS

IMX8X Carrier Board: Based on the Mariner 1-C board (Modifications

- Eth1 RX pull up R18, R20 and R21 leave Not Mounted (Pg. 6)
- VDDA1P8 Change VCC_ETH_1V0 to VCC_1V8
- For Pgood, Isolate SOM 3v3, and use an load switch for the 3v3
to 1.8v using Pgood
- Reset button pull up to SOM VCC_3V3 not VCC3V3OUT

File: SCALES_EPS.kicad_sch
uSD Card Ethernet Block Diagram

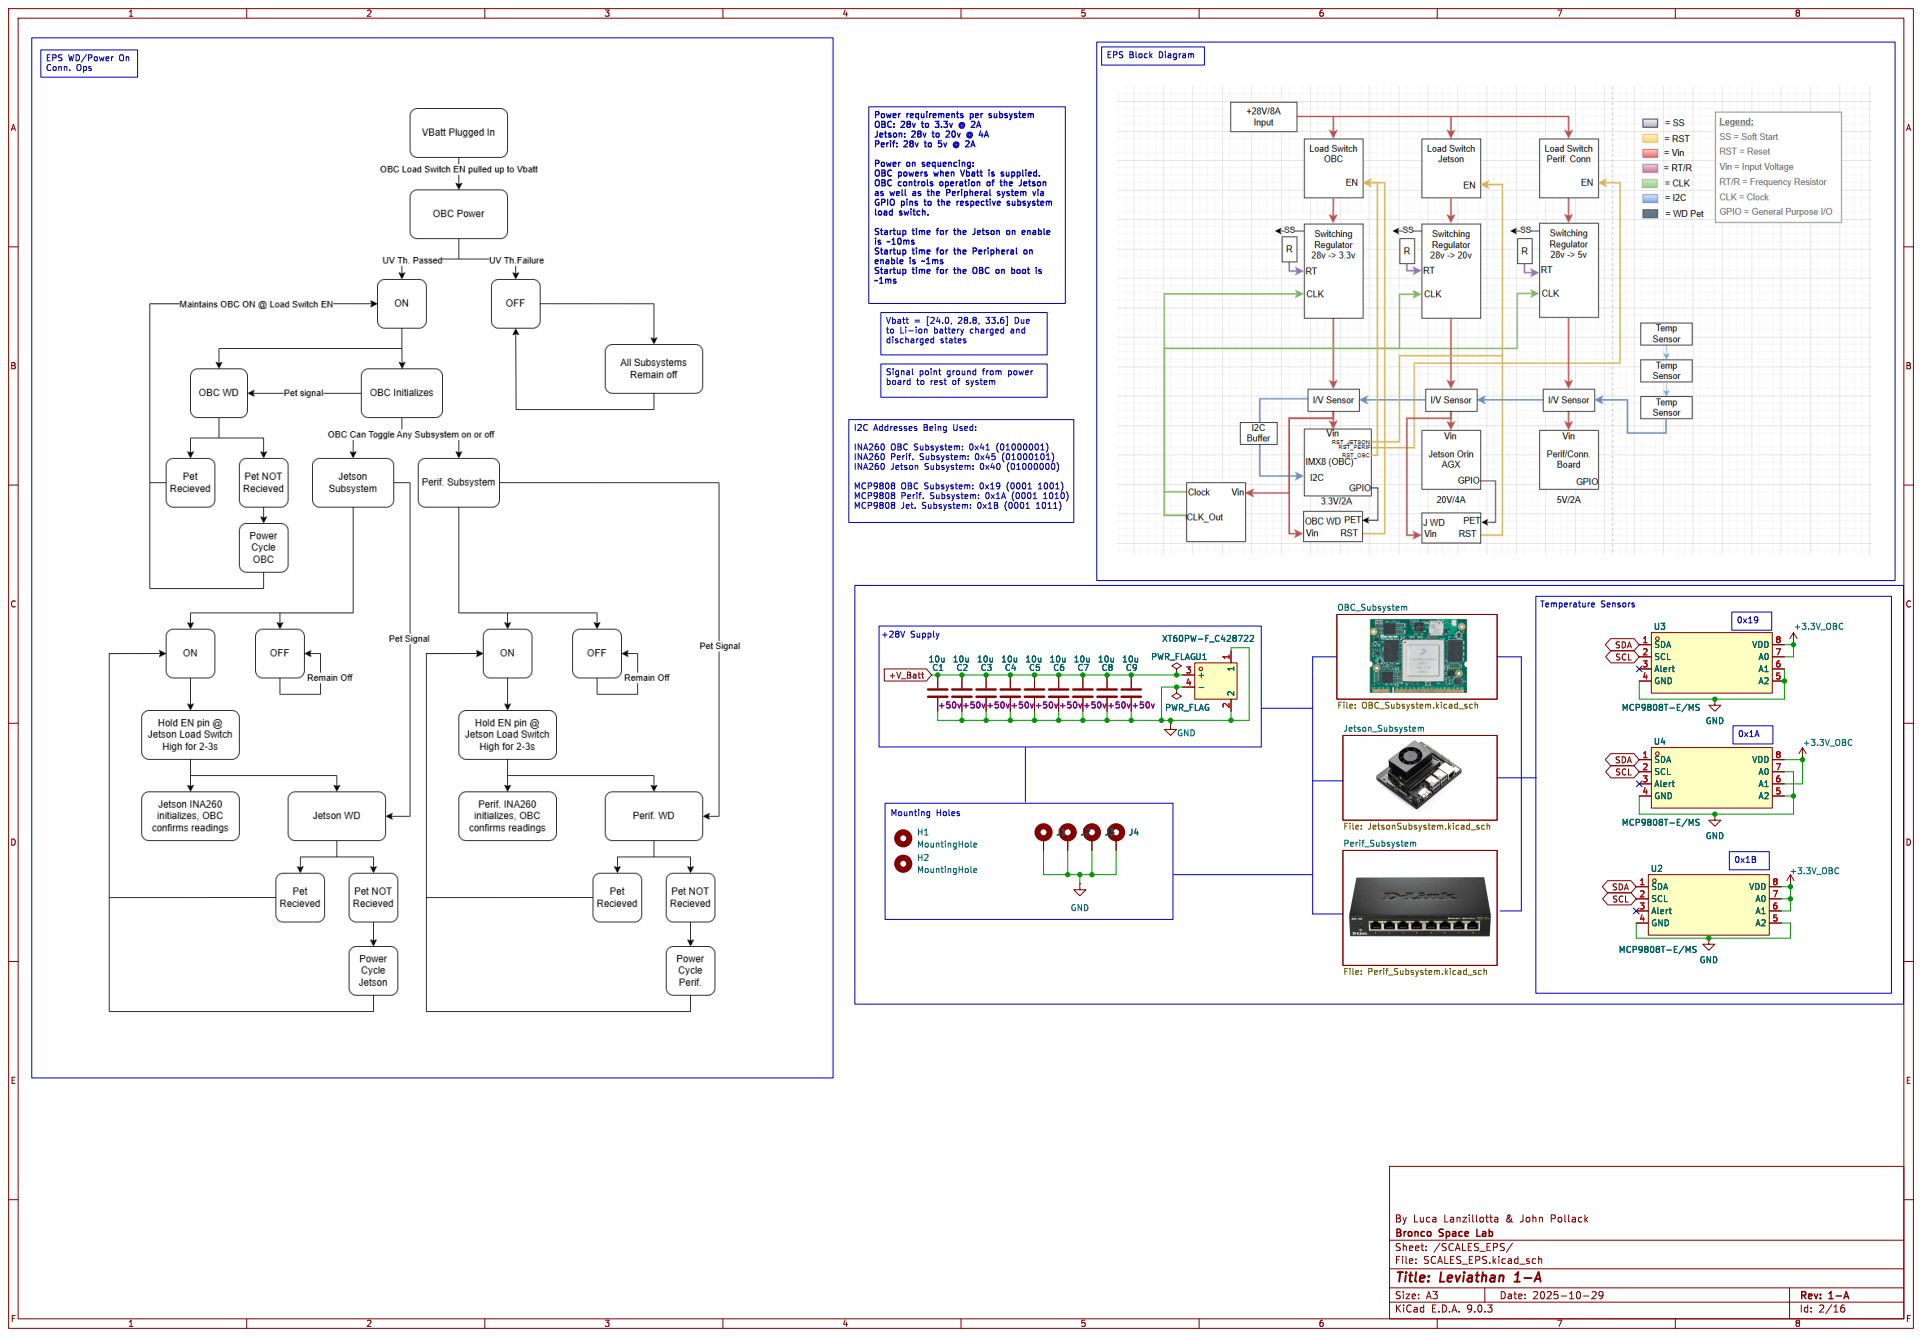
[picture p114: page 2]

Power on sequencing: OBC powers when Vbatt is supplied. OBC controls operation of the Jetson

load switch. Startup time for the Jetson on enable

Signal point ground from power board to rest of system

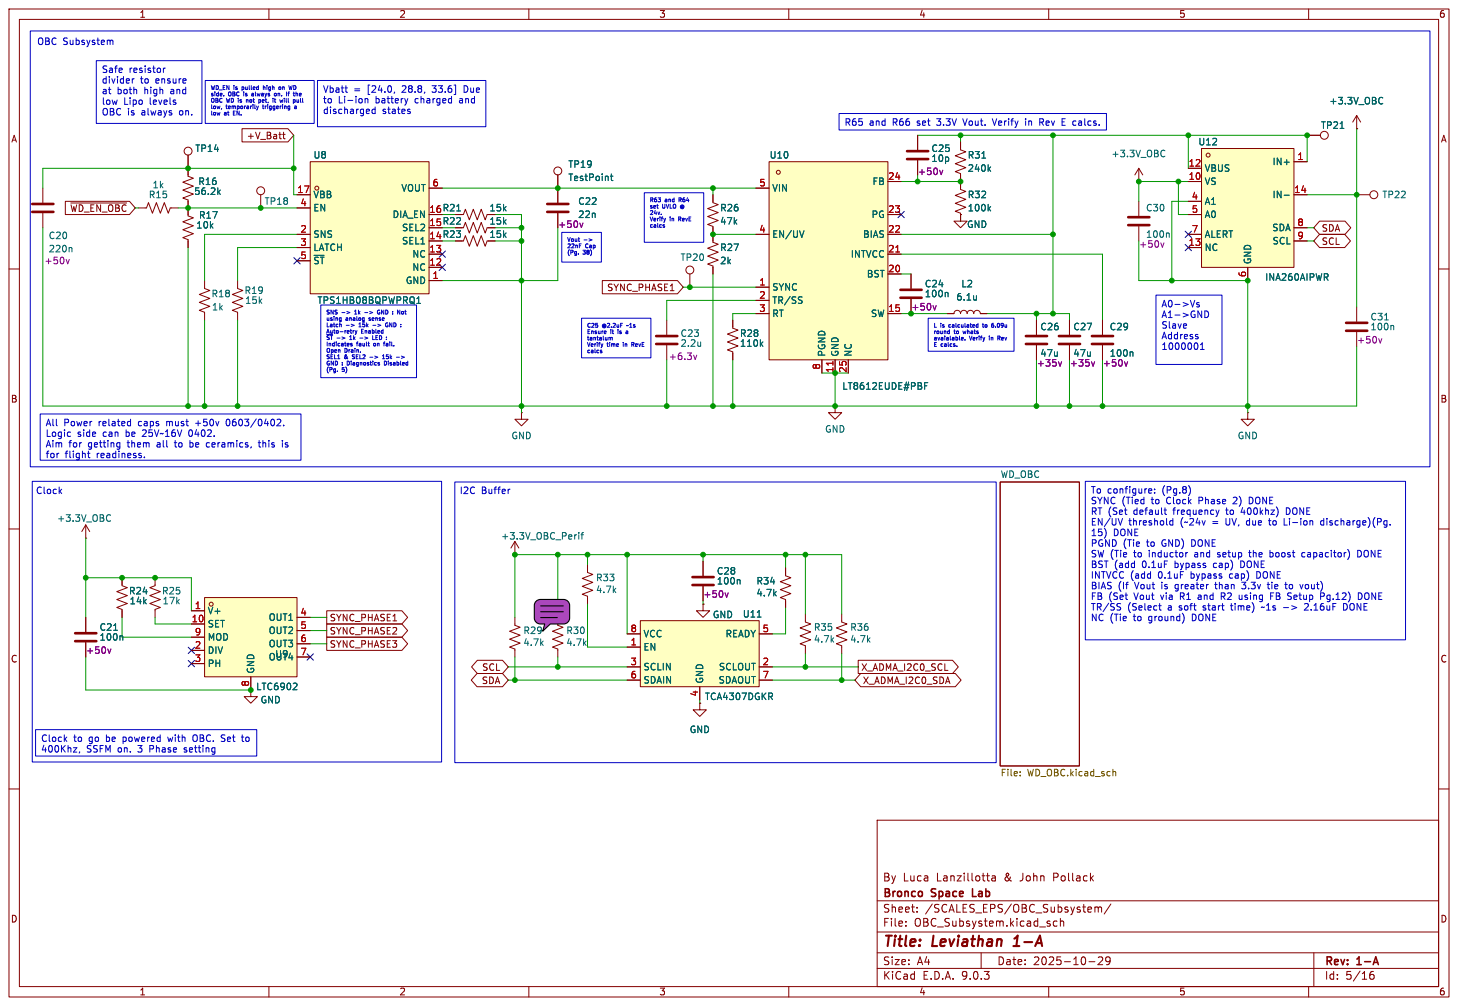
[picture p115: page 3]

Safe resistor divider to ensure

at both high and

side. OBC is always on. If the OBC WD is not pet, it will pull

8 GND 11 NC 25 FB 24 PG 23 BIAS 22

22nF Cap
(Pg. 38) C25 @2.2uF ~1s Ensure it is a

tantalum
Verify time in RevE

calcs Clock to go be powered with OBC. Set to

15) DONE
PGND (Tie to GND) DONE
BST (add 0.1uF bypass cap) DONE
INTVCC (add 0.1uF bypass cap) DONE
BIAS (If Vout is greater than 3.3v tie to vout) FB (Set Vout via R1 and R2 using FB Setup Pg.12) DONE

400Khz, SSFM on. 3 Phase setting

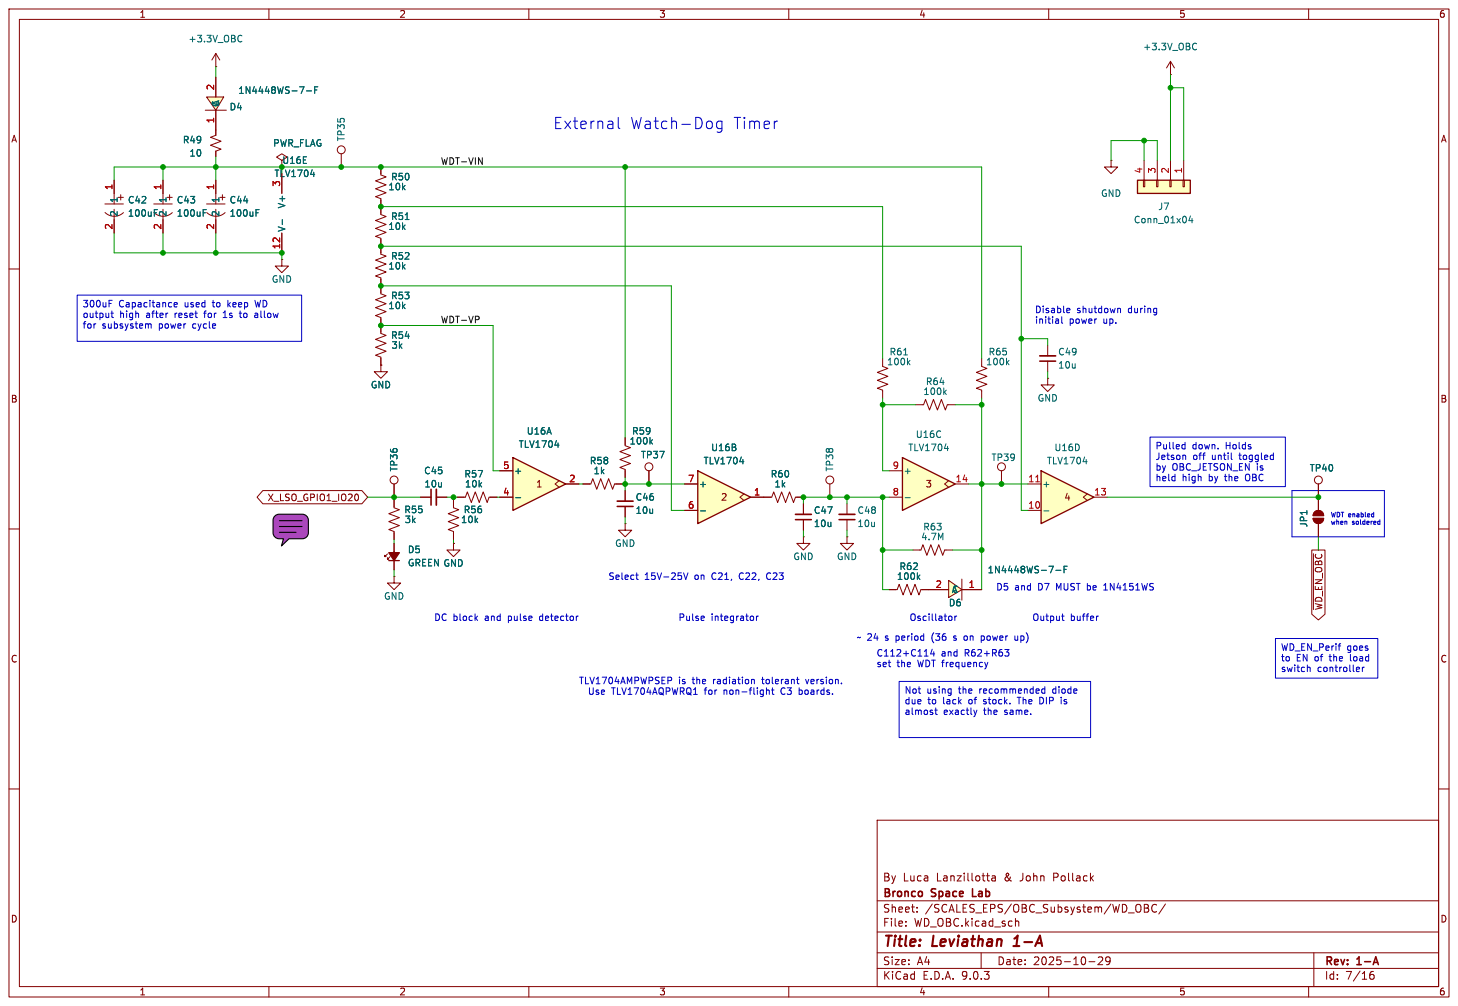
[picture p116: page 4]

output high after reset for 1s to allow

switch controller Pulled down. Holds
Jetson off until toggled
by OBC_JETSON_EN is held high by the OBC

to EN of the load

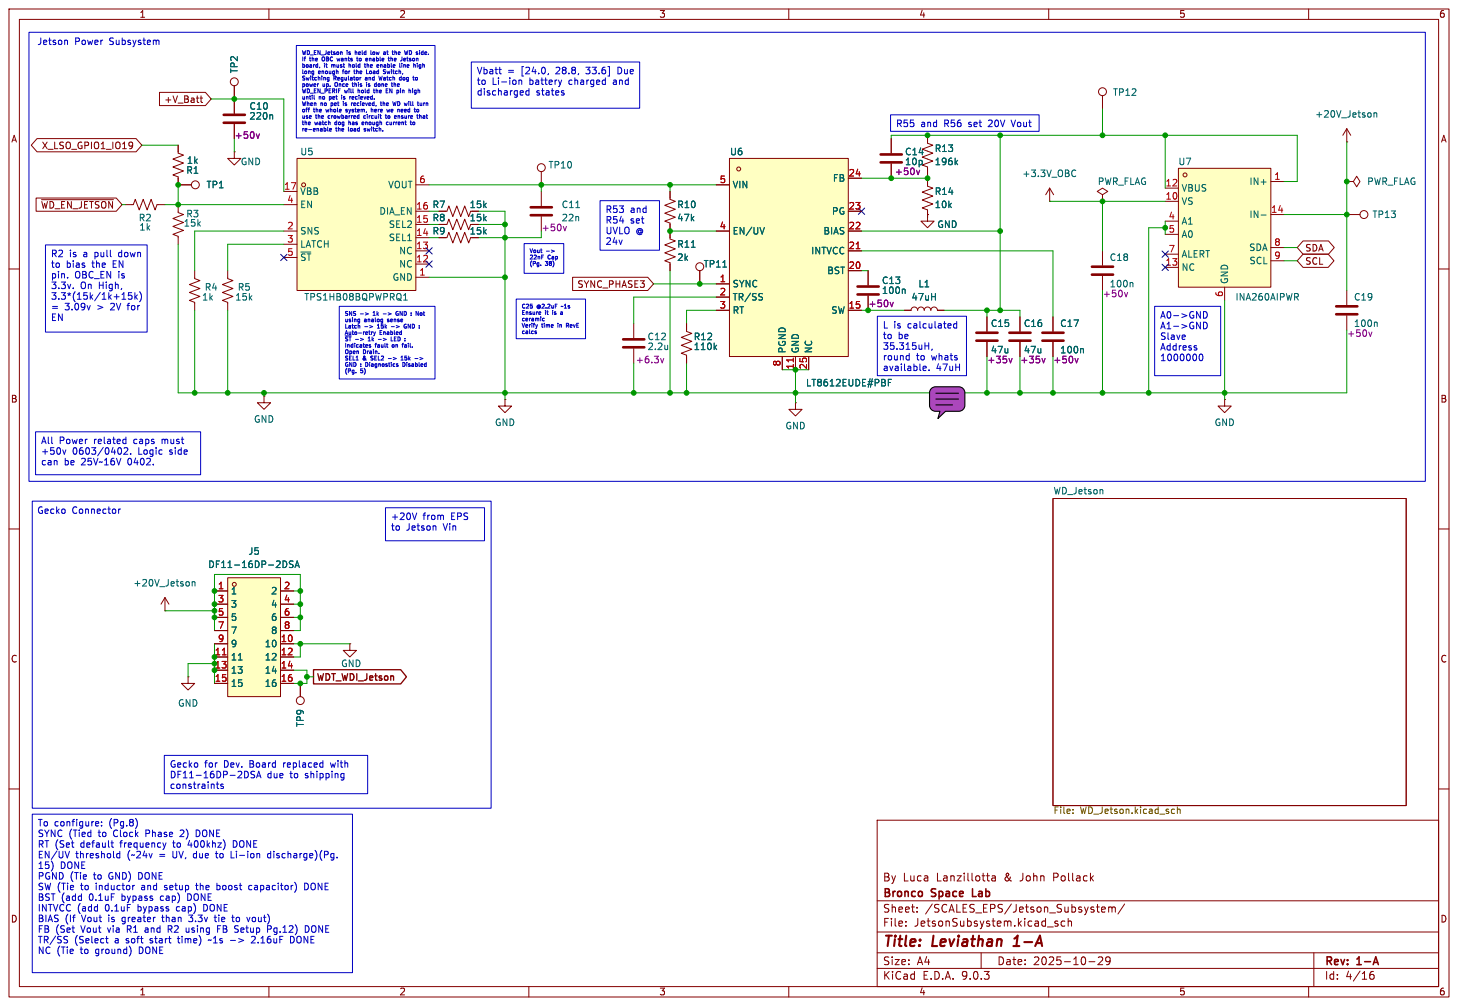
[picture p117: page 5]

WD_EN_Jetson is held low at the WD side.
If the OBC wants to enable the Jetson
board, it must hold the enable line high

power up. Once this is done the WD_EN_PERIF will hold the EN pin high

8 GND 11 NC 25 FB 24 PG 23 BIAS 22

to bias the EN
pin. OBC_EN is 3.3v. On High,

ceramic Verify time in RevE

15) DONE
PGND (Tie to GND) DONE
BST (add 0.1uF bypass cap) DONE
INTVCC (add 0.1uF bypass cap) DONE
BIAS (If Vout is greater than 3.3v tie to vout) FB (Set Vout via R1 and R2 using FB Setup Pg.12) DONE

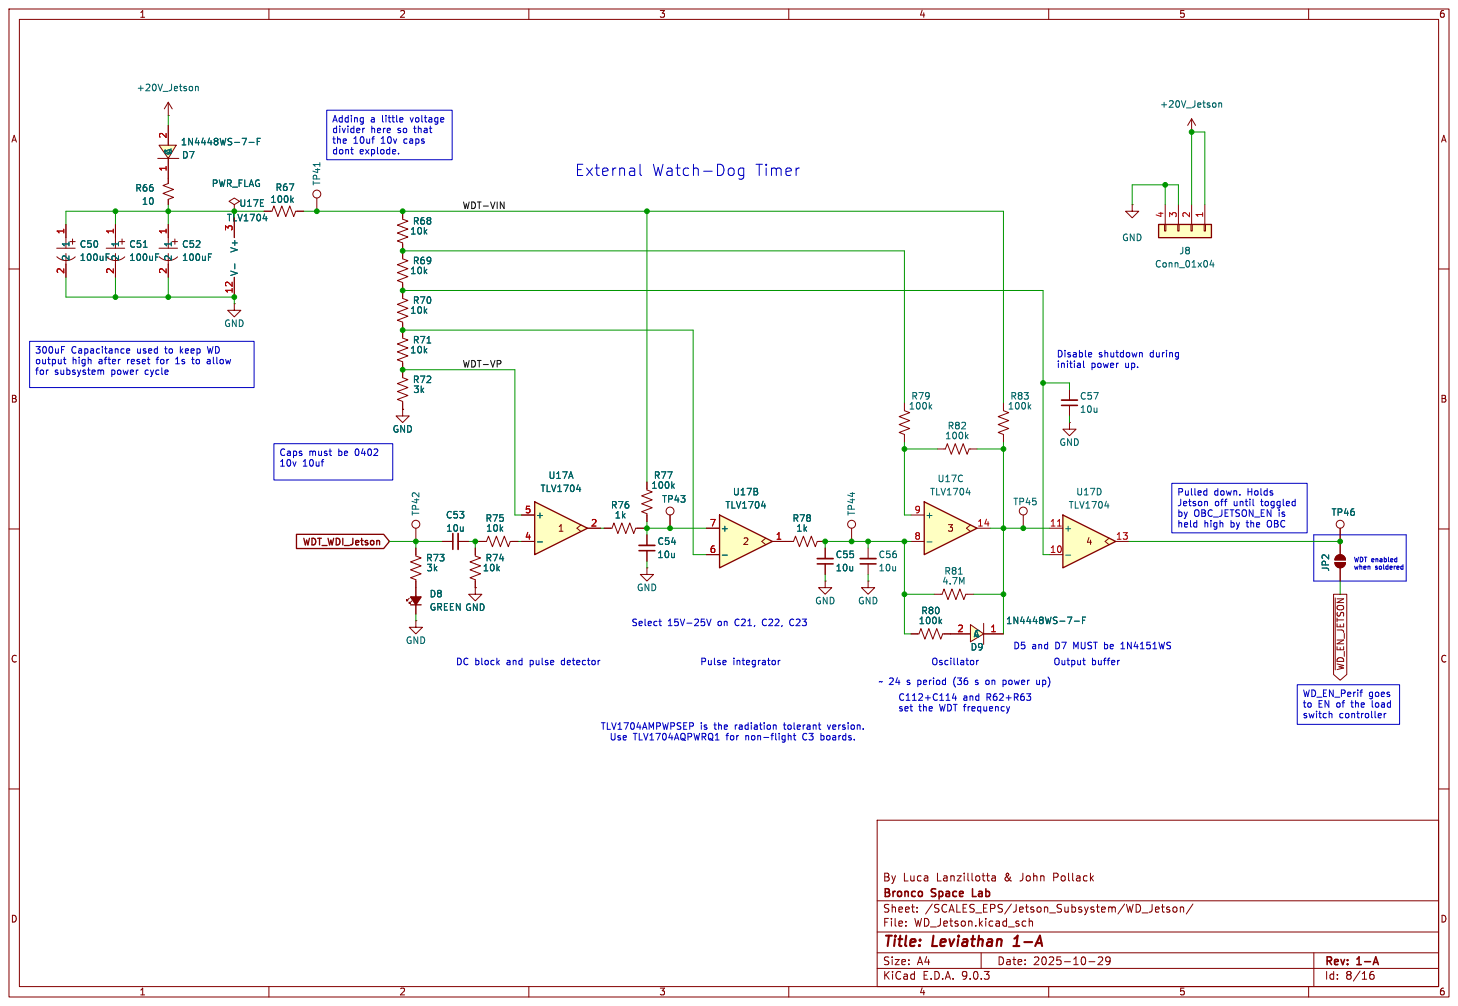
[picture p118: page 6]

divider here so that

output high after reset for 1s to allow

switch controller Caps must be 0402

Jetson off until toggled
by OBC_JETSON_EN is held high by the OBC WD_EN_Perif goes

set the WDT frequency

to EN of the load

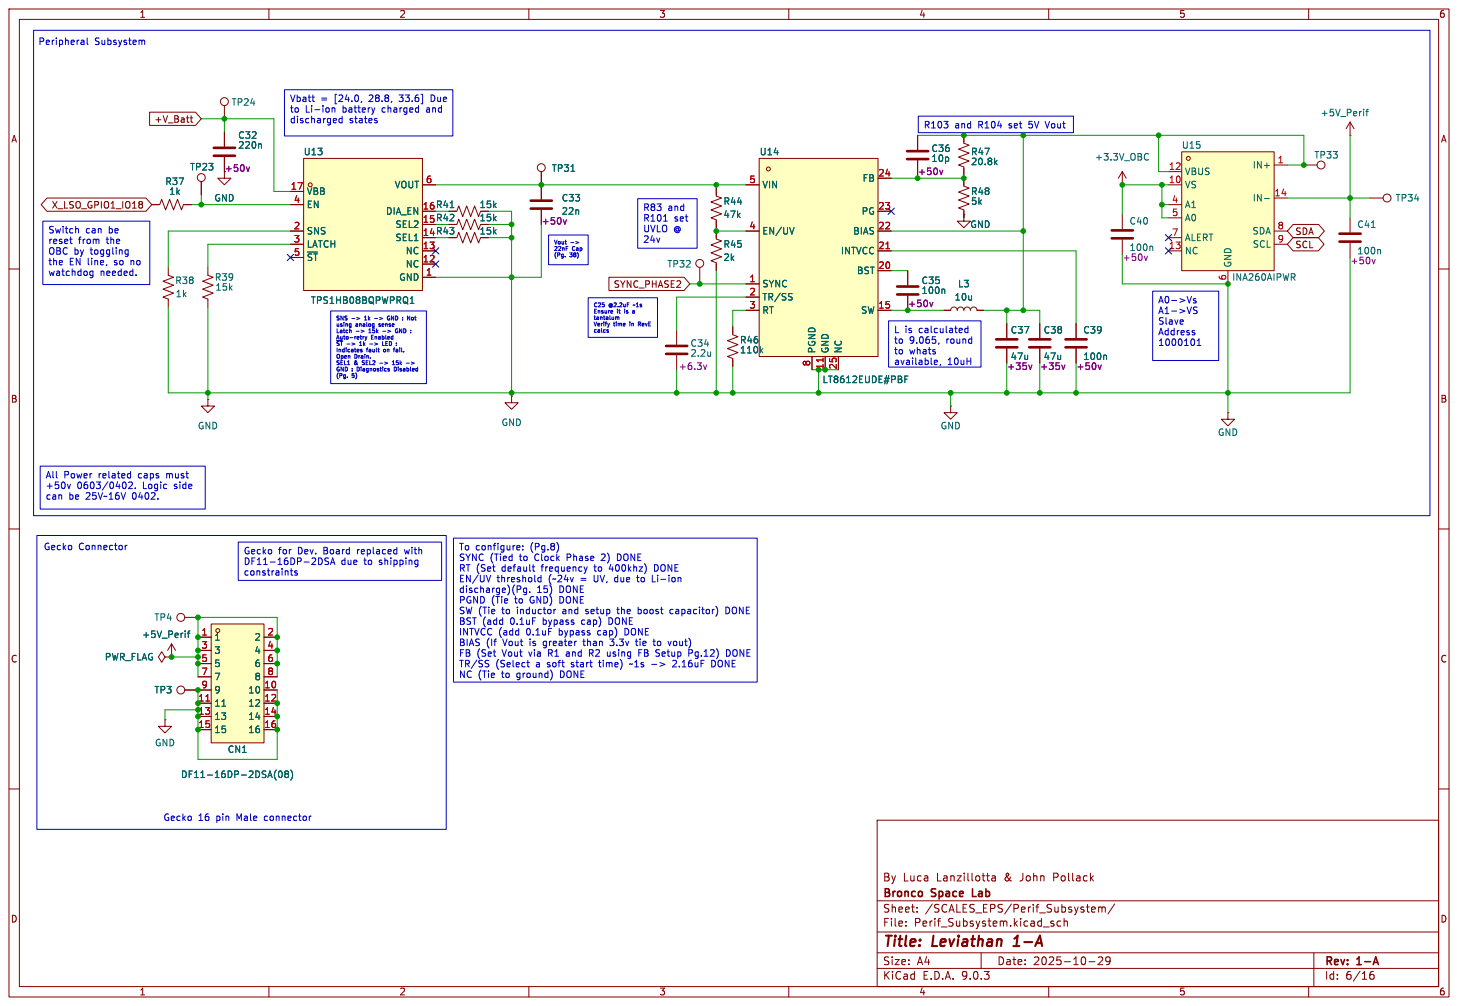
[picture p119: page 7]

R103 and R104 set 5V Vout L is calculated

8 GND 11 NC 25 FB 24 PG 23 BIAS 22

Slave Address 1000101 Switch can be
reset from the OBC by toggling

tantalum
Verify time in RevE

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

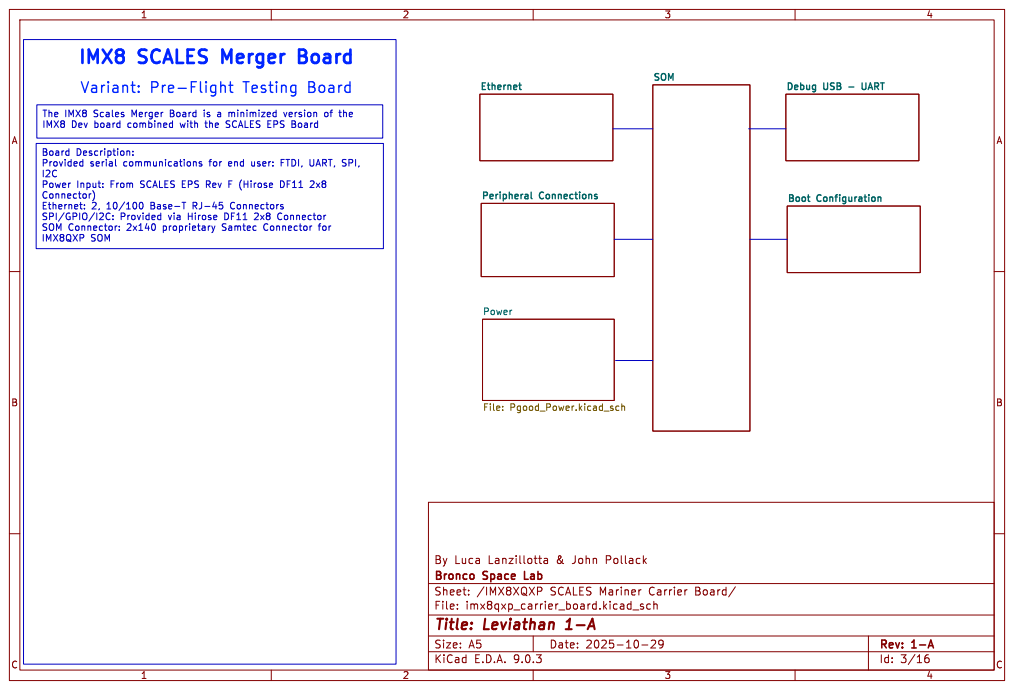
[picture p120: page 8]

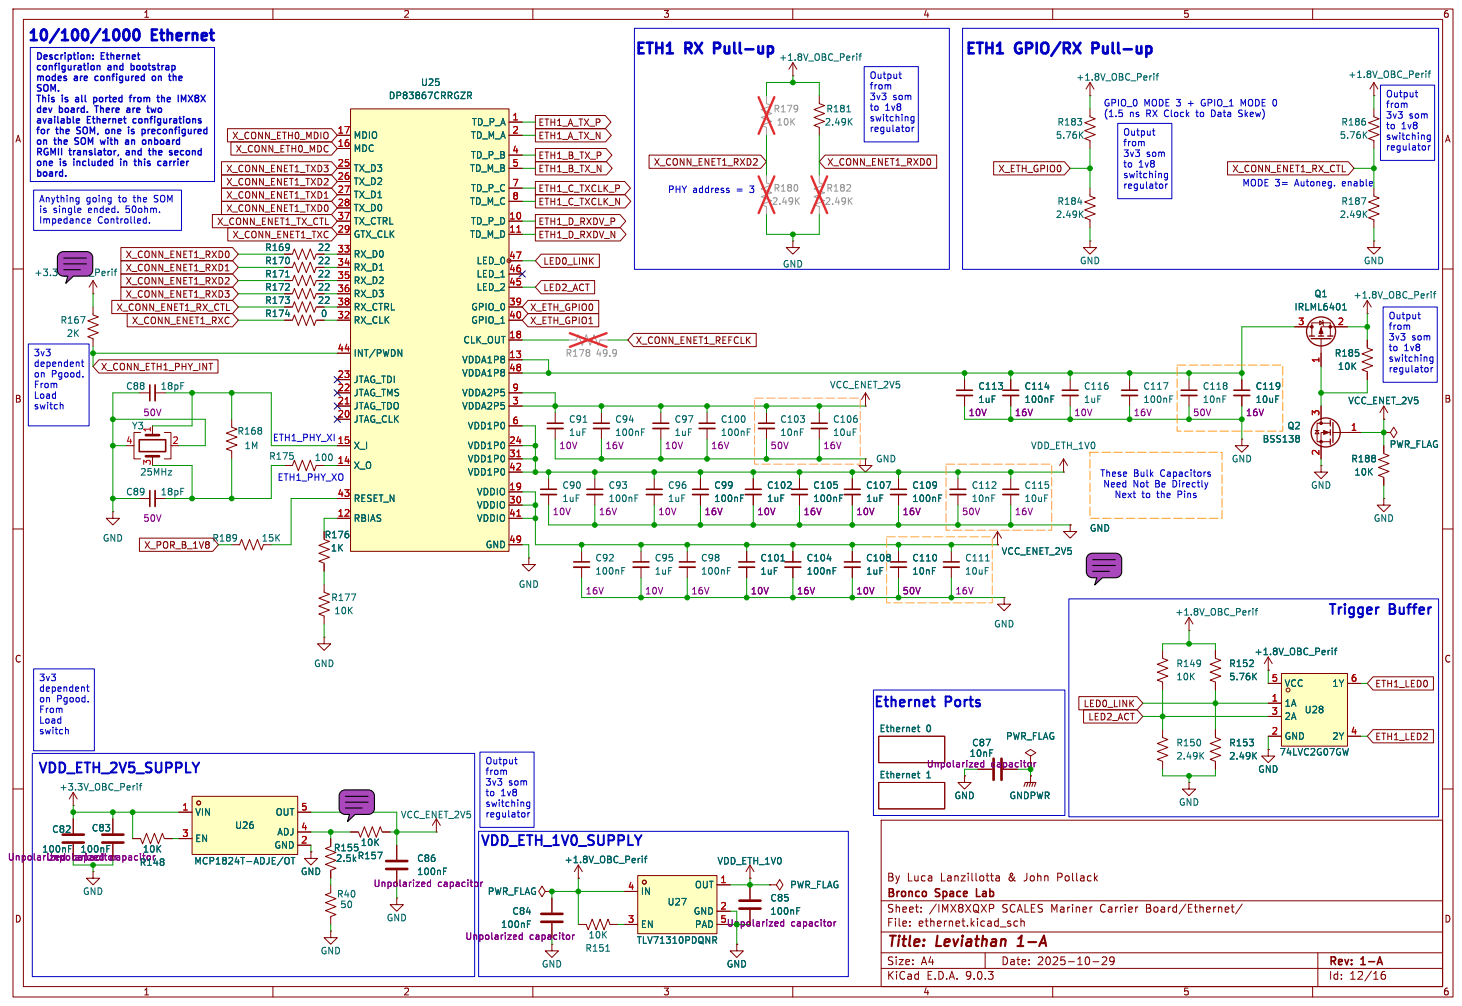
[picture p121: page 9]

LED_2 45 GPIO_0 39 GPIO_1 40 CLK_OUT 18 VDDA1P8 13 VDDA1P8 48 VDDA2P5 9 VDDA2P5 3 VDD1P0 6 VDD1P0 24 VDD1P0 31 VDD1P0 42 VDDIO 19 VDDIO 30 VDDIO 41 GND 49 U25 DP83867CRRGZR

dev board. There are two
for the SOM, one is preconfigured

Anything going to the SOM
is single ended. 50ohm.

dependent on Pgood. From

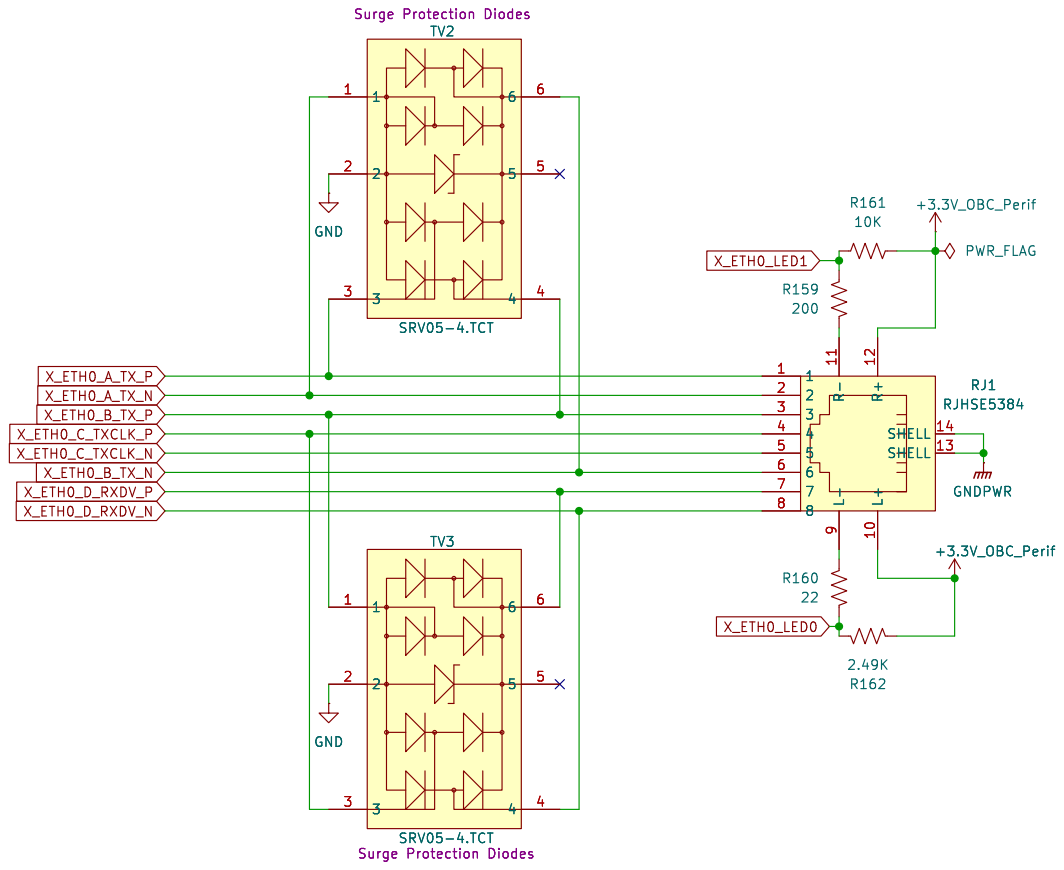
[picture p122: page 10]

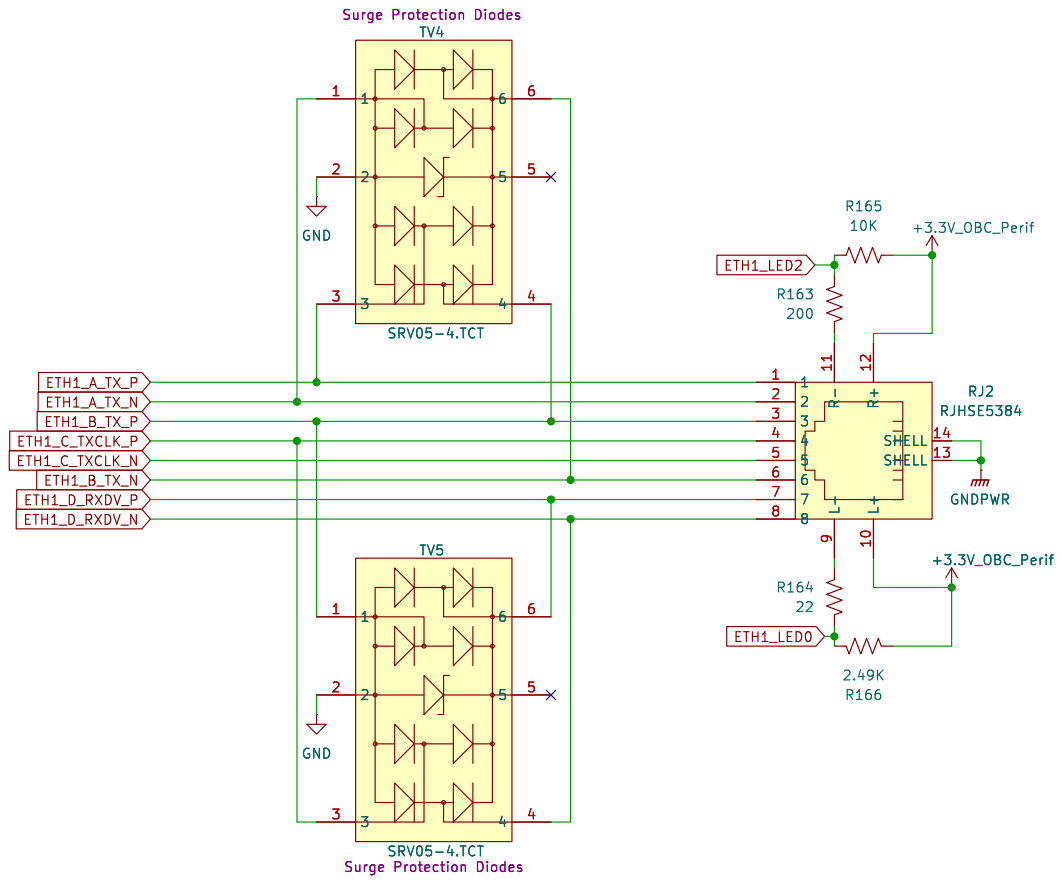
[picture p123: page 11]

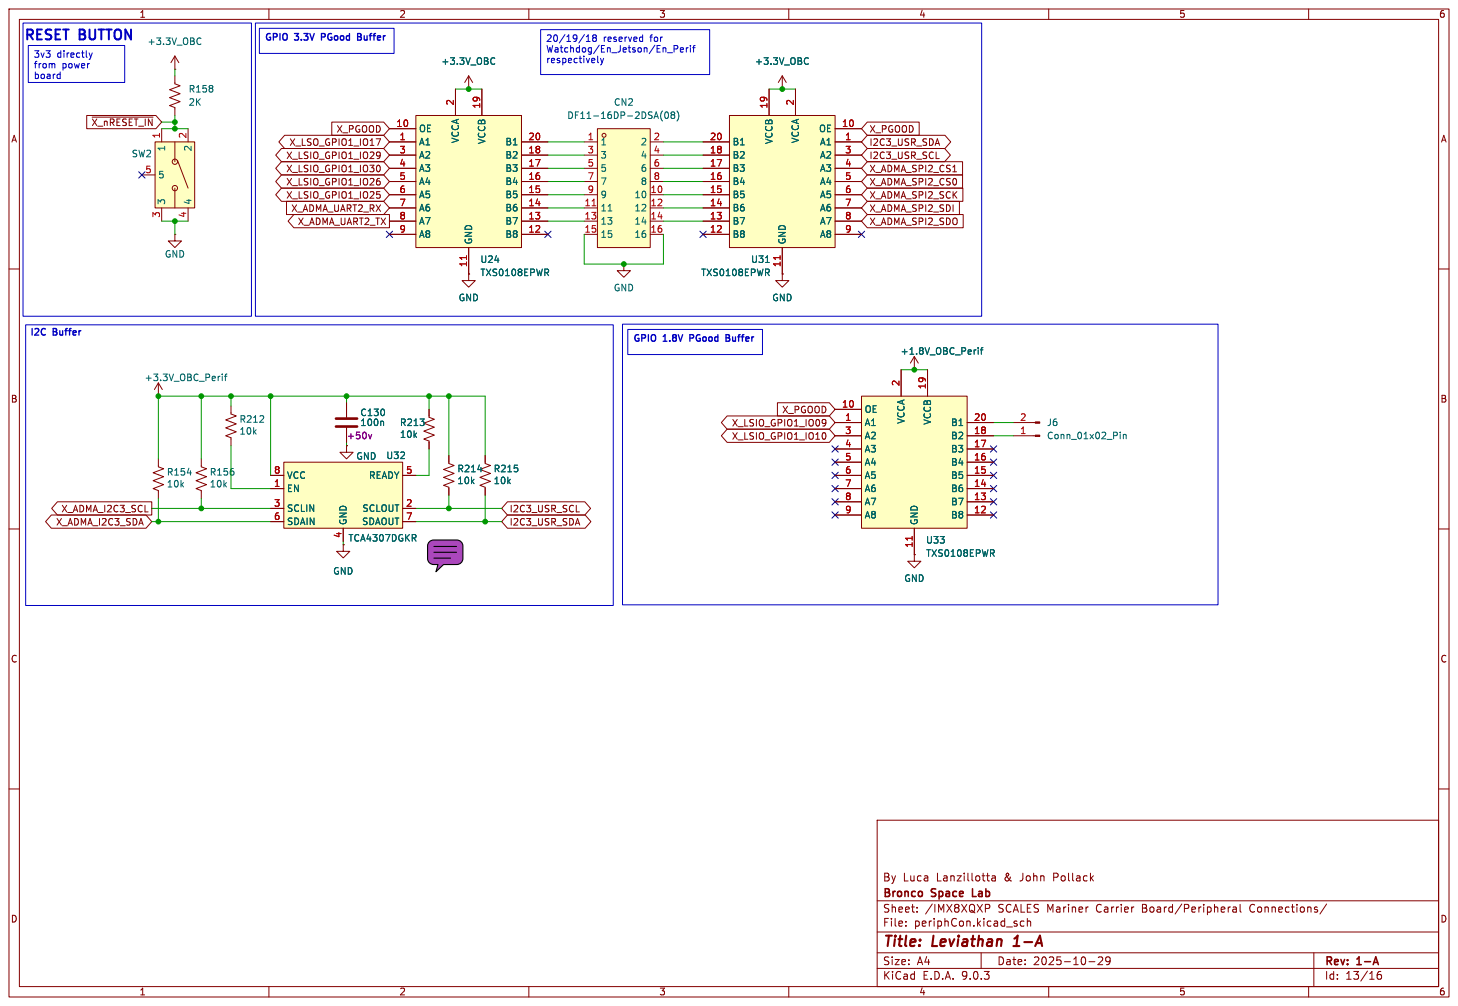
[picture p124: page 12]

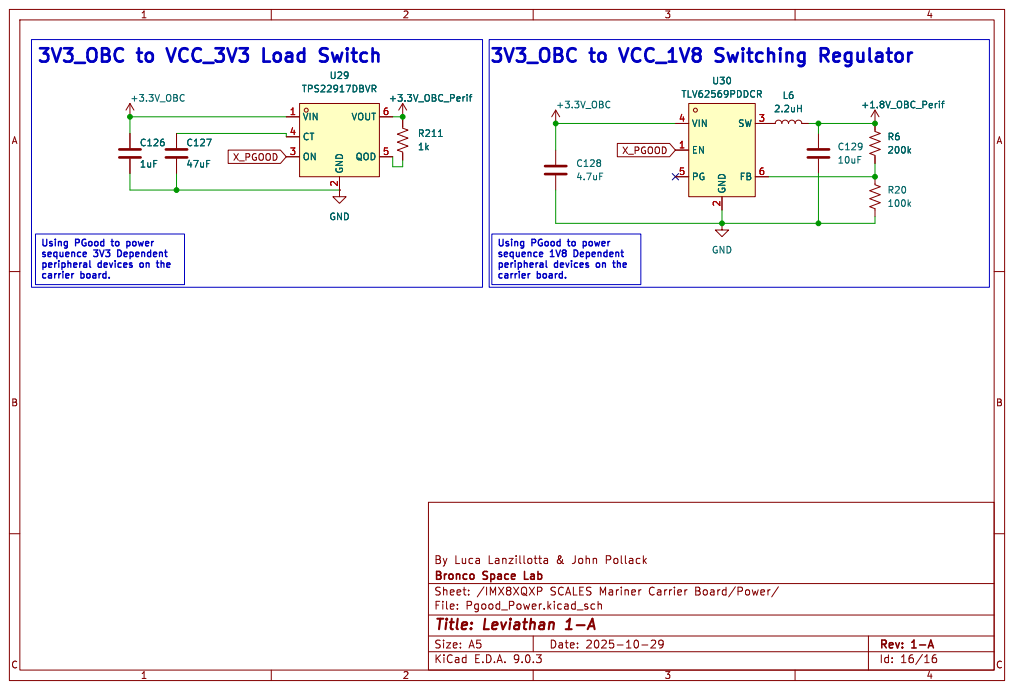
[picture p125: page 13]

carrier board. Using PGood to power sequence 3V3 Dependent

Using PGood to power sequence 1V8 Dependent

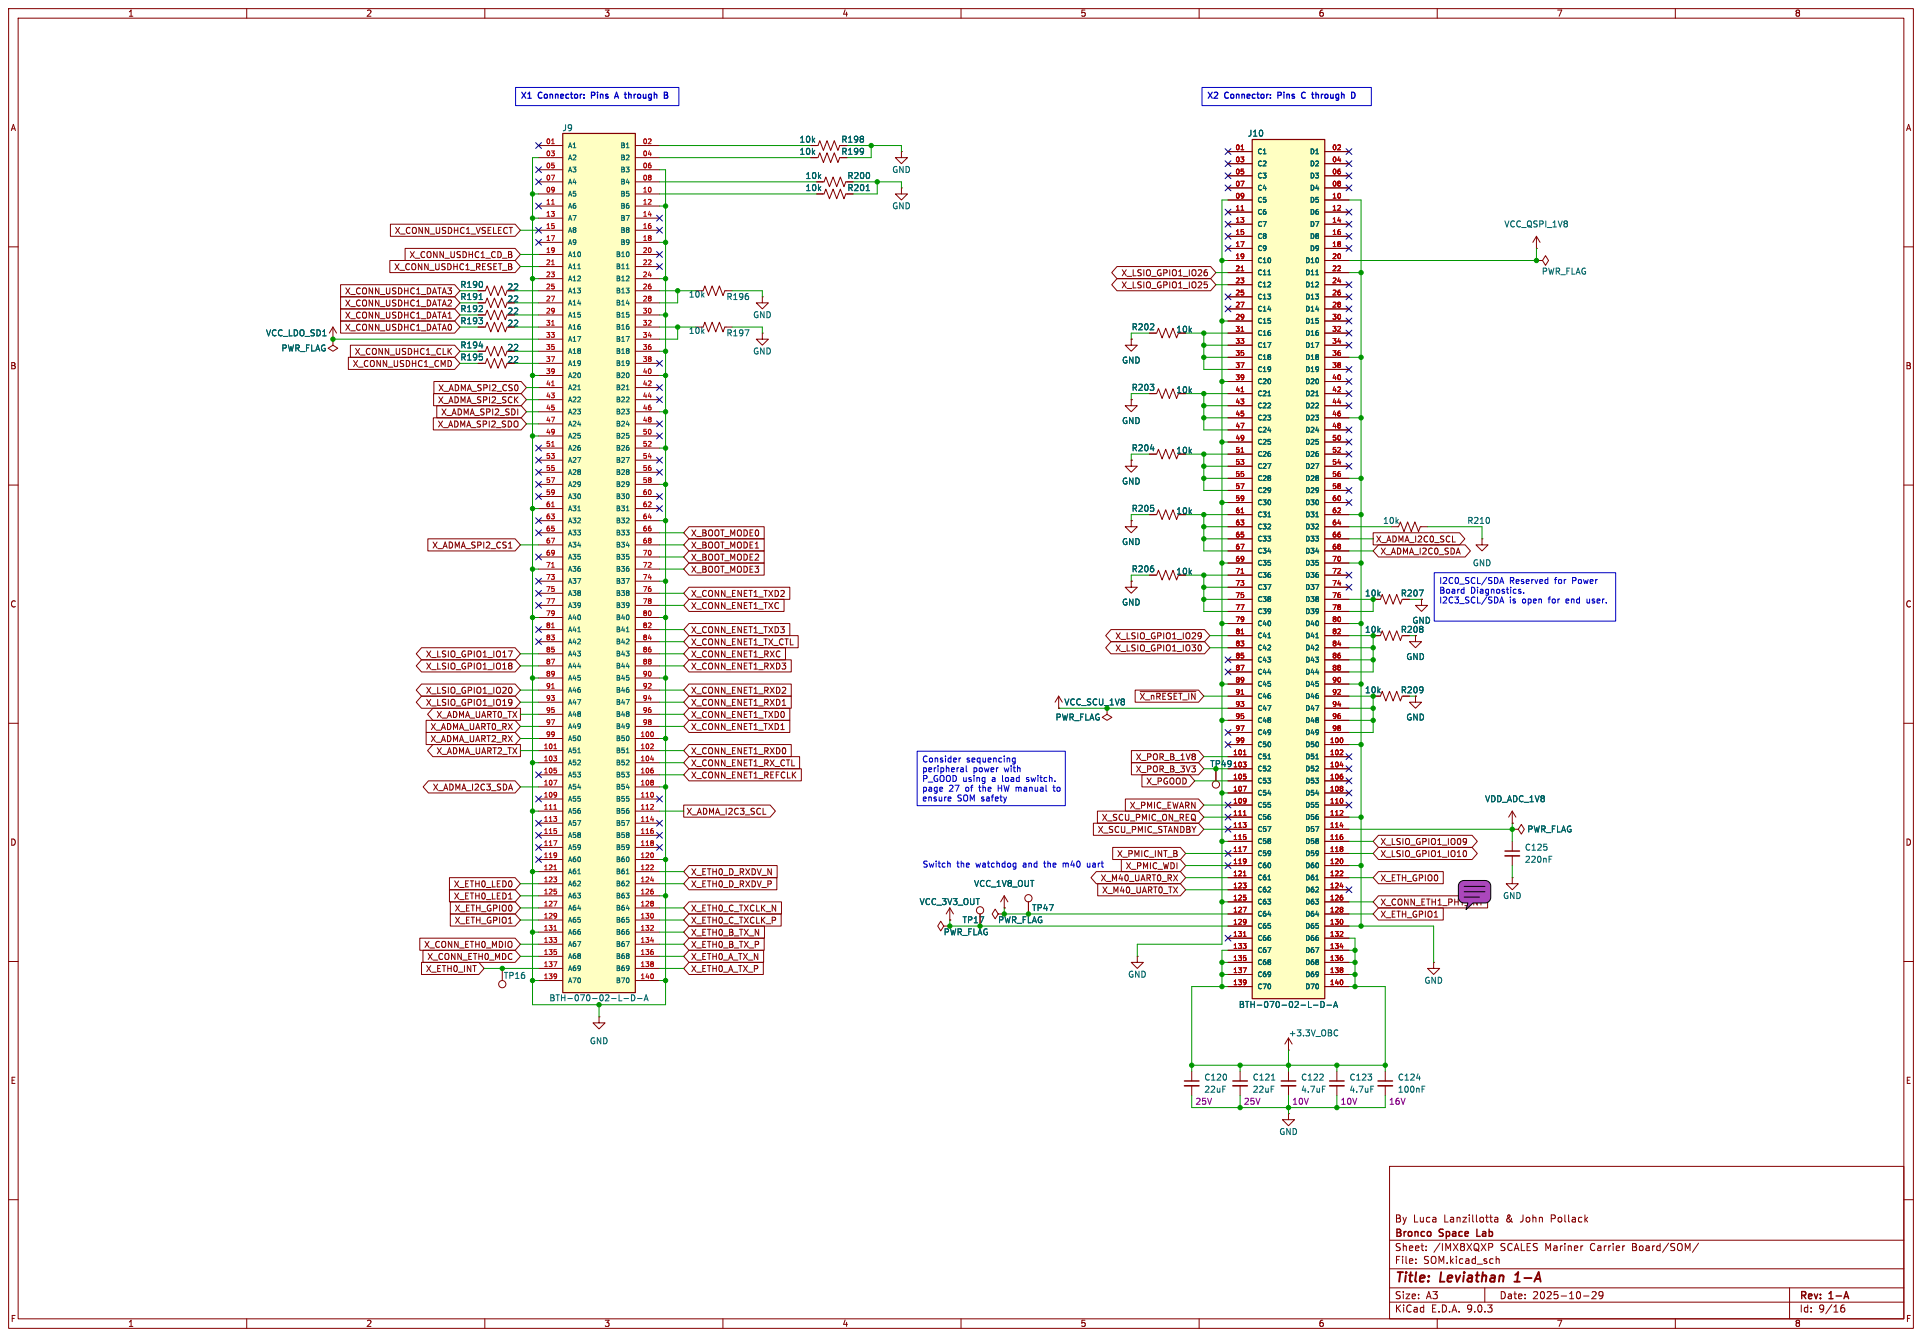
[picture p126: page 14]

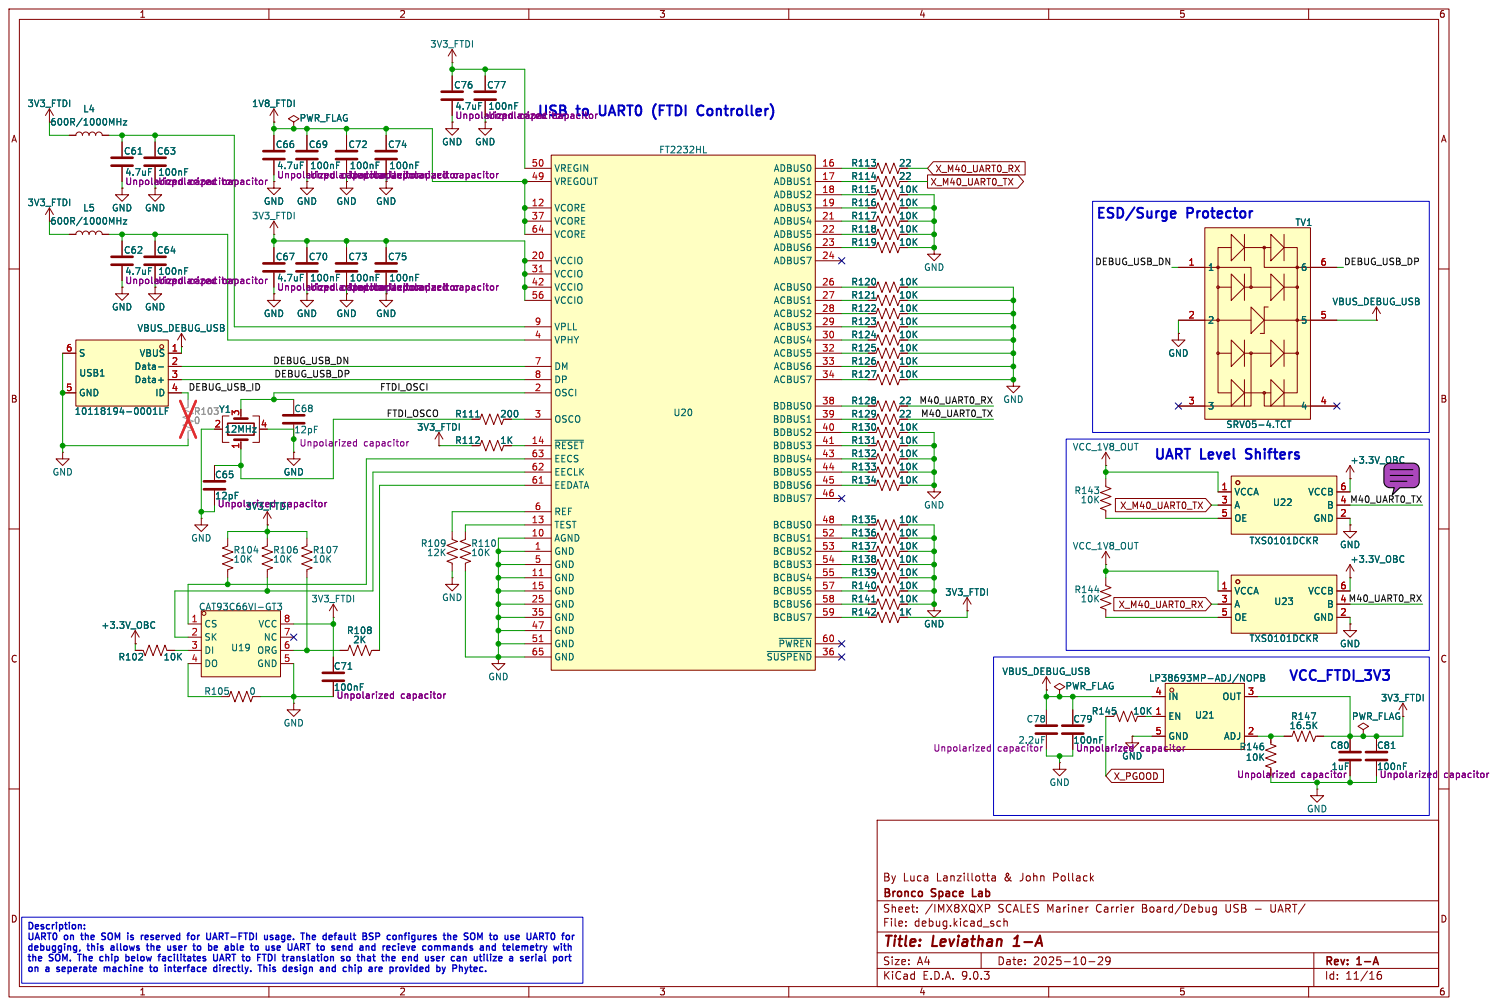
[picture p127: page 15]

USB to UART0 (FTDI Controller)

Description: UART0 on the SOM is reserved for UART-FTDI usage. The default BSP configures the SOM to use UART0 for debugging, this allows the user to be able to use UART to send and recieve commands and telemetry with

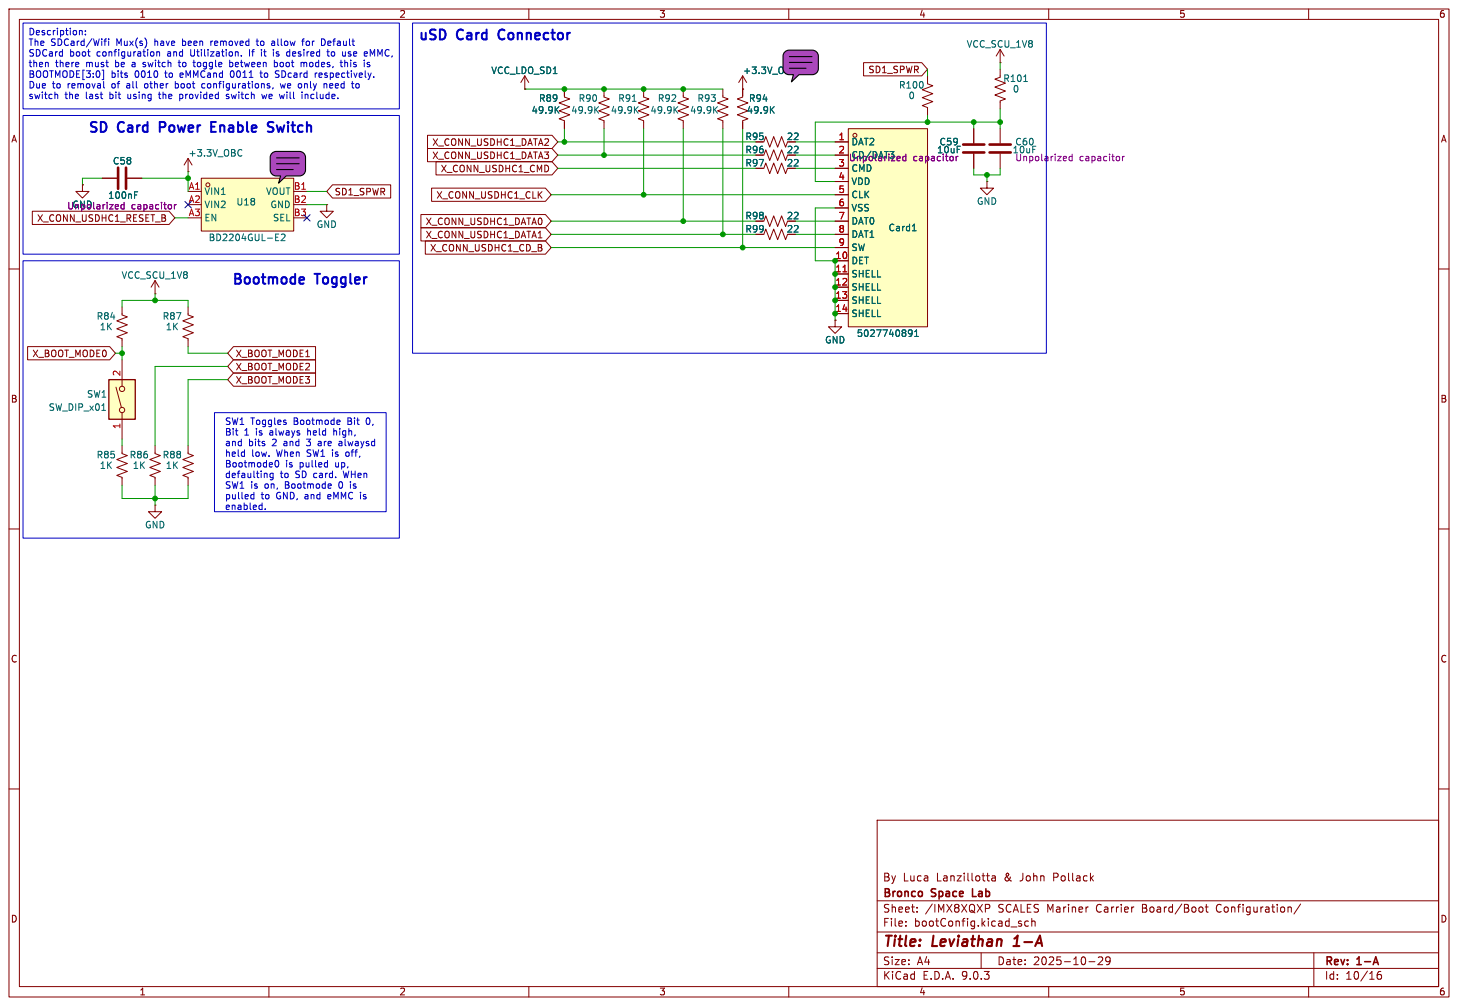
[picture p128: page 16]

switch the last bit using the provided switch we will include. SD Card Power Enable Switch
