BroncoSpace-Lab/scales-hardware/imx8x_eps_leviathan_v2/simulation_models/Rev E Calcs.pdf

Ri 56.26 | R2lot

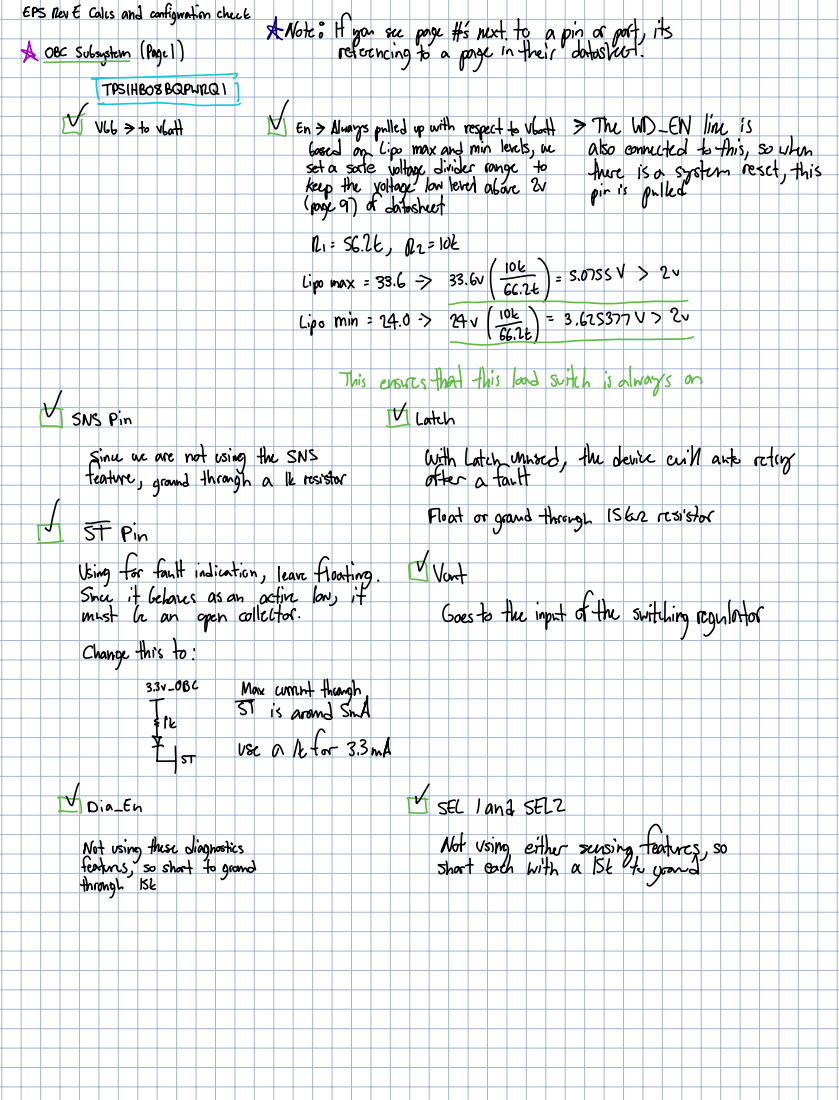
[picture p129: page 1]
EPSRevecallsandconfirmationcheck; Note; Ifgnsgngp.ggspjetintfhe9PidatfskYits; OBCSubsystems; Paget; Lipomin; Dia En; SELlandSELZ; Figgis; Iijima; MartianEitherassistfts so

MI F | on Alwayspulledupwithrespecttobat | TheWDENlineis

based onLipomaxandminlevelswe | alsoconnectedtothis sowhen
setasafevoltagedivider | range | to | there | stemresetthis
keepthevoltagelowlevelabove20 | | | pini
page9 | ofdatasheet

Lipomax 33.6 | | 33.60 | 1 | 2 | 5.075SV | 20

This ensuresthatthisloadsuitthisalways on

SNSPin | | Latch
Fare | in | n Inthe Eistor | Yithelatifaypsed | thedevicewillautoretry

Float orgroundthrough 15Eurresistor

STPin
Usingforfaultindication leavefloating | | Vont
smilstitabekh.pe hcaEftrlow | it | Goestotheinputoftheswithingregulator

changethisto

OBC | | Maxcurrentthrough

5T isaround5mA

Efst | | | use a Afor3.3mA

# 2I-24vshjutluau.kr

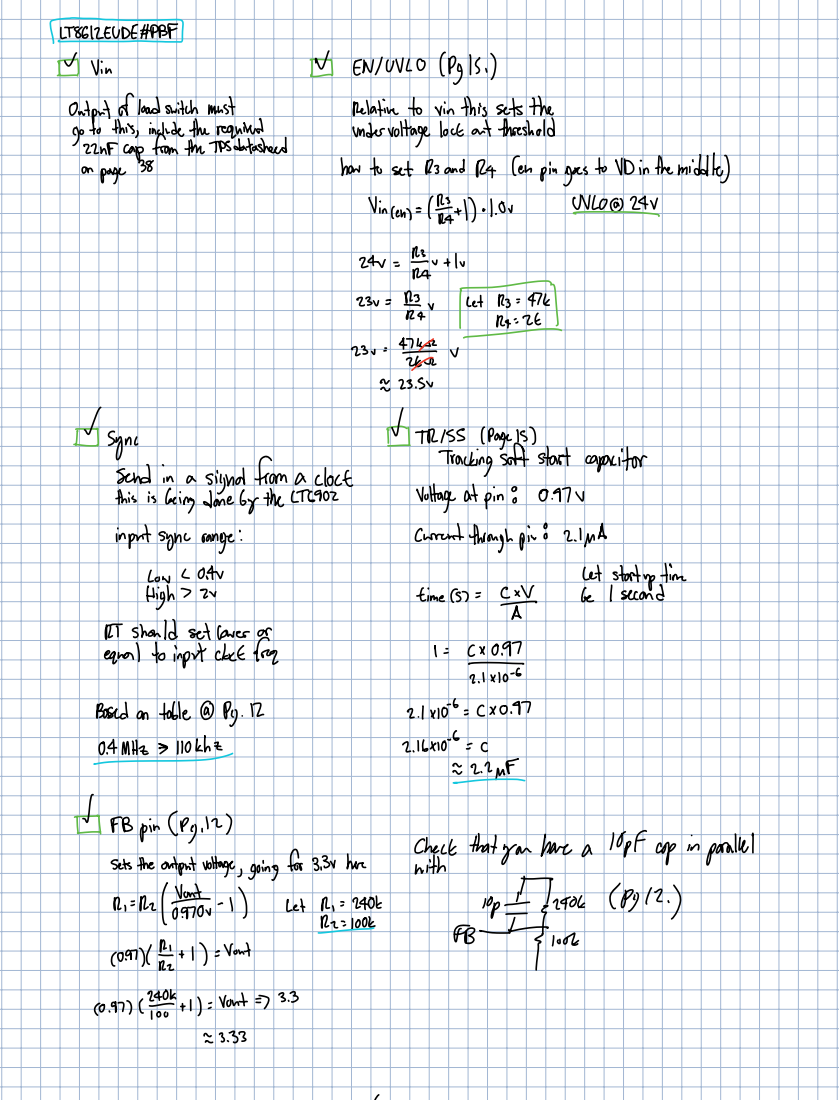
[picture p130: page 2]
ftpI; sync; TREac.in sfftstart capacitor; Etisiaig.SIdfmmFGttvoltageatpin; inputsyncrange; currentthroughpie; Fight t; timers; Yittadim; Effie

LT8GIZEUDEPBF
Vin | ENUULO Pyls
Outputofloadswitchmust
gotothisincludetherequired | | | kktioltheyieth.lt | | sthed

22nFcapfromtheTPSdatasheed
onpage38 | howtosetRsandRt | | | enpingoestoVDinthemiddle

Vincent | Etl 1.00 | | UVLO

III

Basedontable | | Py12 | 2.1106 | 2 0.97
1271104kt | | 2.1610

FBpin Py¹²
nine | i | c.tngyEhtthatmhaea1tpfcpinporalel
0.97 | 1 | Vont | FB | 10ᵗʰ

setstheoutputvoltagegoingfor3.3here

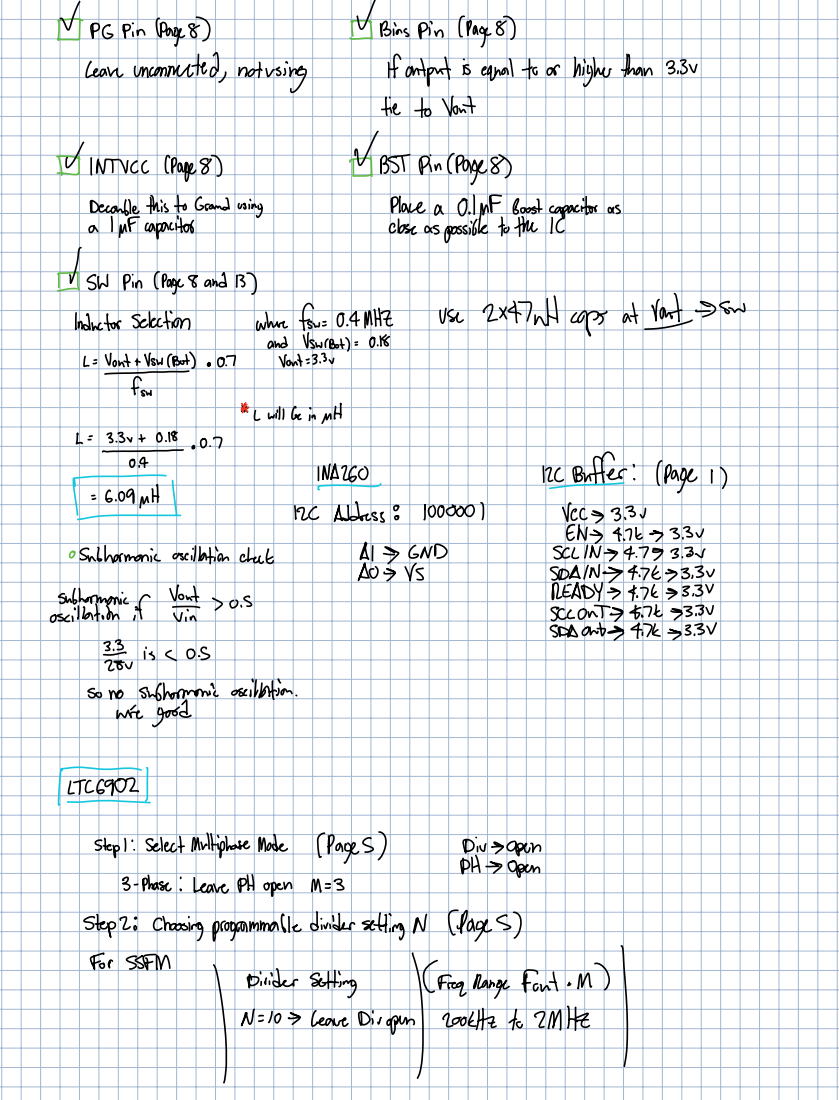
[picture p131: page 3]
INTVCC; Pages; FIBSTPinPage8; SWPin Page8and13; Inductorselection; use 247; copsatrout; feat; hhf.si; selectmultiphasemode; pages; Div open PH; Open 3Phase LeavePHopen M 3

PGPin Pages | BinsPin Pages

Leaveunconnected notusing | ifoutputisequaltoor higherthan3.30

tie toVont

Grandusing | Placea 0.1mFboostcapacitoras

pecattethj.it | closeaspossibletotheIC

gg | o.y | twillbeinnH-12CfII

Bff | page

100000 | VET t.simt | | 3.30

matimance | | SPAIN 47693.30 | scantissin 11 8D

READY 4.76 3.30
SDDout | | 4.74 3.3W

5257tn if | | | | Y | | 05 | sccontst.it93.30

o.ssomugghy.mn | | | | | oscillation

step2 | choosing programmabledividersettingN | Pages
ForSSFM

Dividersetting | | FreqRangeFont | M
N 10 | leaveDiropen | 200kHzto2MHz

| Rset | 20kr.fr1Ef | | | | | | 13.3362

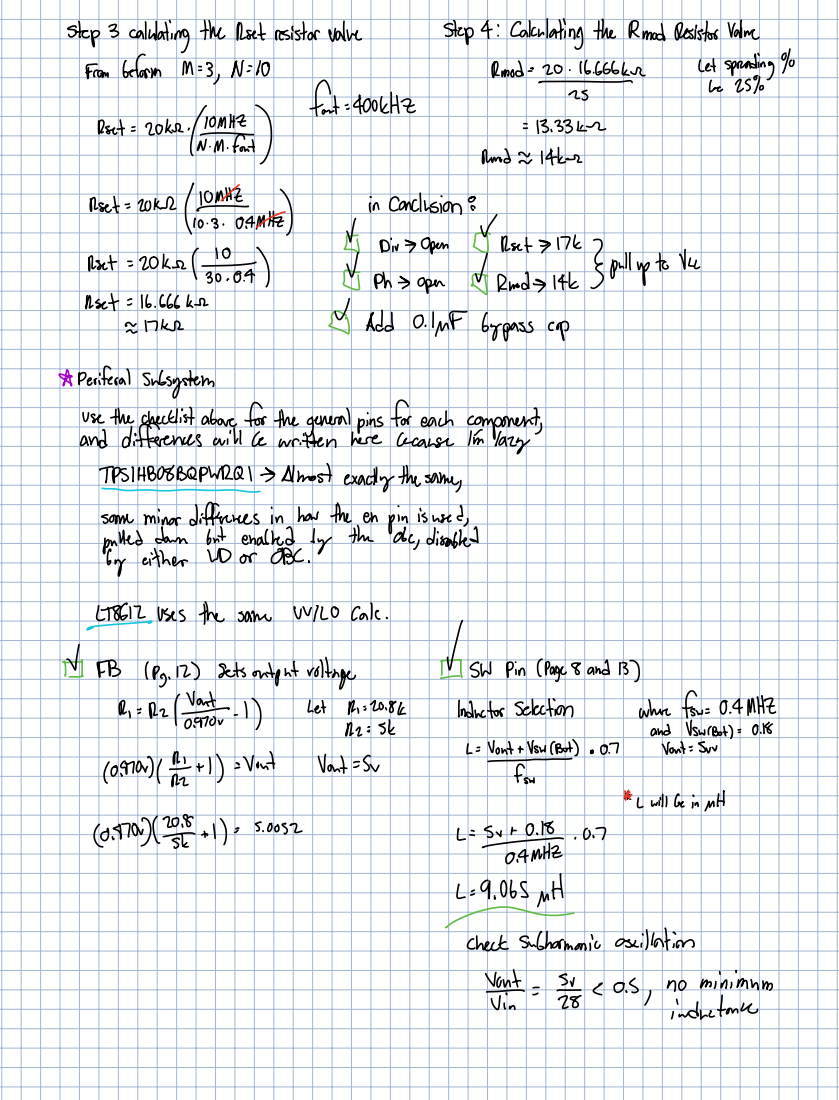
[picture p132: page 4]
Add 0.1mFbypass cop; pulleddown; butenabledbythe Obcdisabled; 18612usesthesame WILOCale; inductance

step3 calulatingtheRsetresistorvalue | | | | | | step4 calculatingtheRmodResistorValue
Frombeform | | M 3 N10 | | | | Rmod 2 | | 6664 | letysprd.jp

Raid | 14hr

Rset 20 2 | | inconclusion

Div | Open | Rset | 174

Rset 20k | 3 | 4 | phsopen | andesite | pulluptoV4
nset

PeriferalSubsystem
Ynathdfhe.tk itnfether.Ieneheresfrac | company's

TP BQPWRQI Almostexactlythesame
someminordifferences in howtheenpinisused
byeither WDor OBC

FB | | Pg12 | setsoutputvoltage | | | | SWPin Page8and13

R1 R2 | | f | 1 | Let | 1 ⁹⁸⁴ | Inductorselection | | whereFsu 0.4MHz

L.vn eBot | 0.7 | | fout.USPt | 0.18

0.9704 22 ¹ | | Vint | Vont su

LwillbeinMH

0.4701 2 8 | | 1 | 5.0052 | | L | svg.fmz

tmnosivati IE | | n-Y

Egco.s | | no minimum

# Iulsystem

| | TamsyleasprifEn heldbyOBE

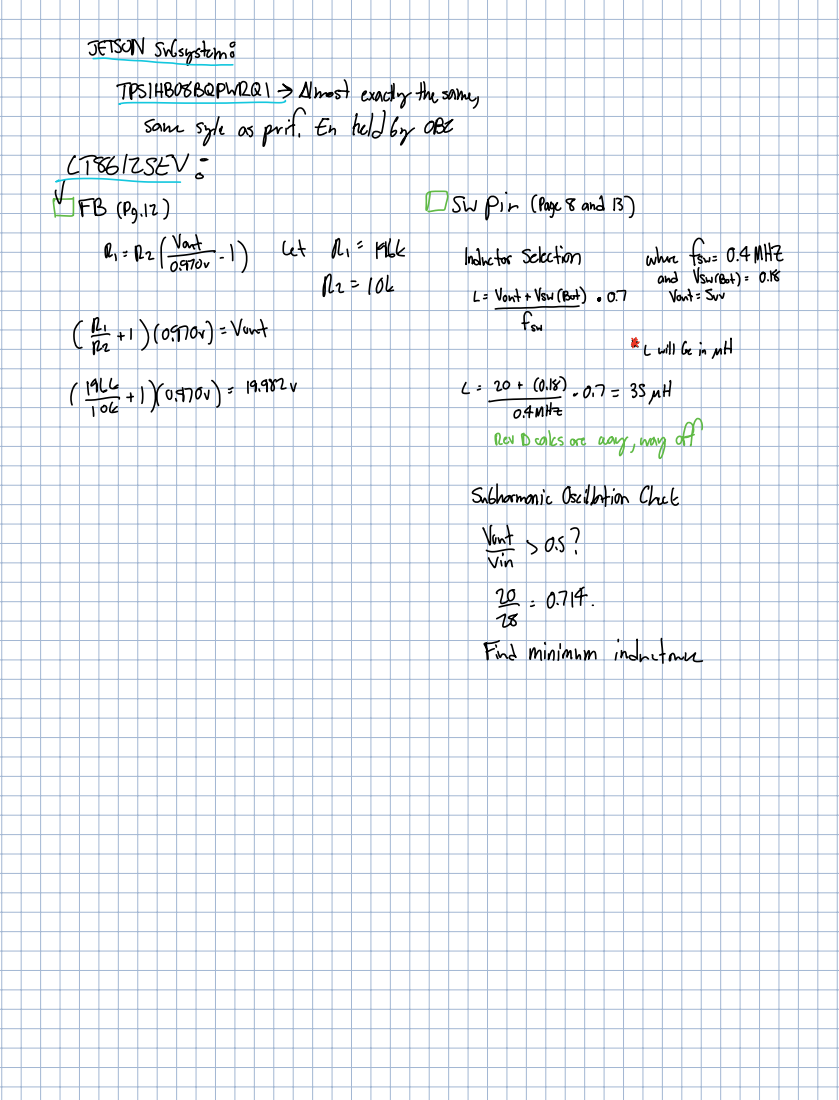
[picture p133: page 5]
Erittie; SWpin Page8and13; RevDeaksarewaywayoff; SubharmonicOscillationChat II sas; Findminimum; inductance

TPSIHB08BQPWRQI | | Almostexactlythesame

R | R2 | f | 1 | Let | Ri 1966 | Inductorselection | | whereFsu 0.4MHz

L.vn yswrBot 0.7 | | fout.USPot 0.18

1 | 0.970 | Vont

willbeinMH
