BroncoSpace-Lab/scales-hardware/imx8x_eps_leviathan_v2/reviews/revision reviews/imx8x_leviathan_v2_for_review.pdf

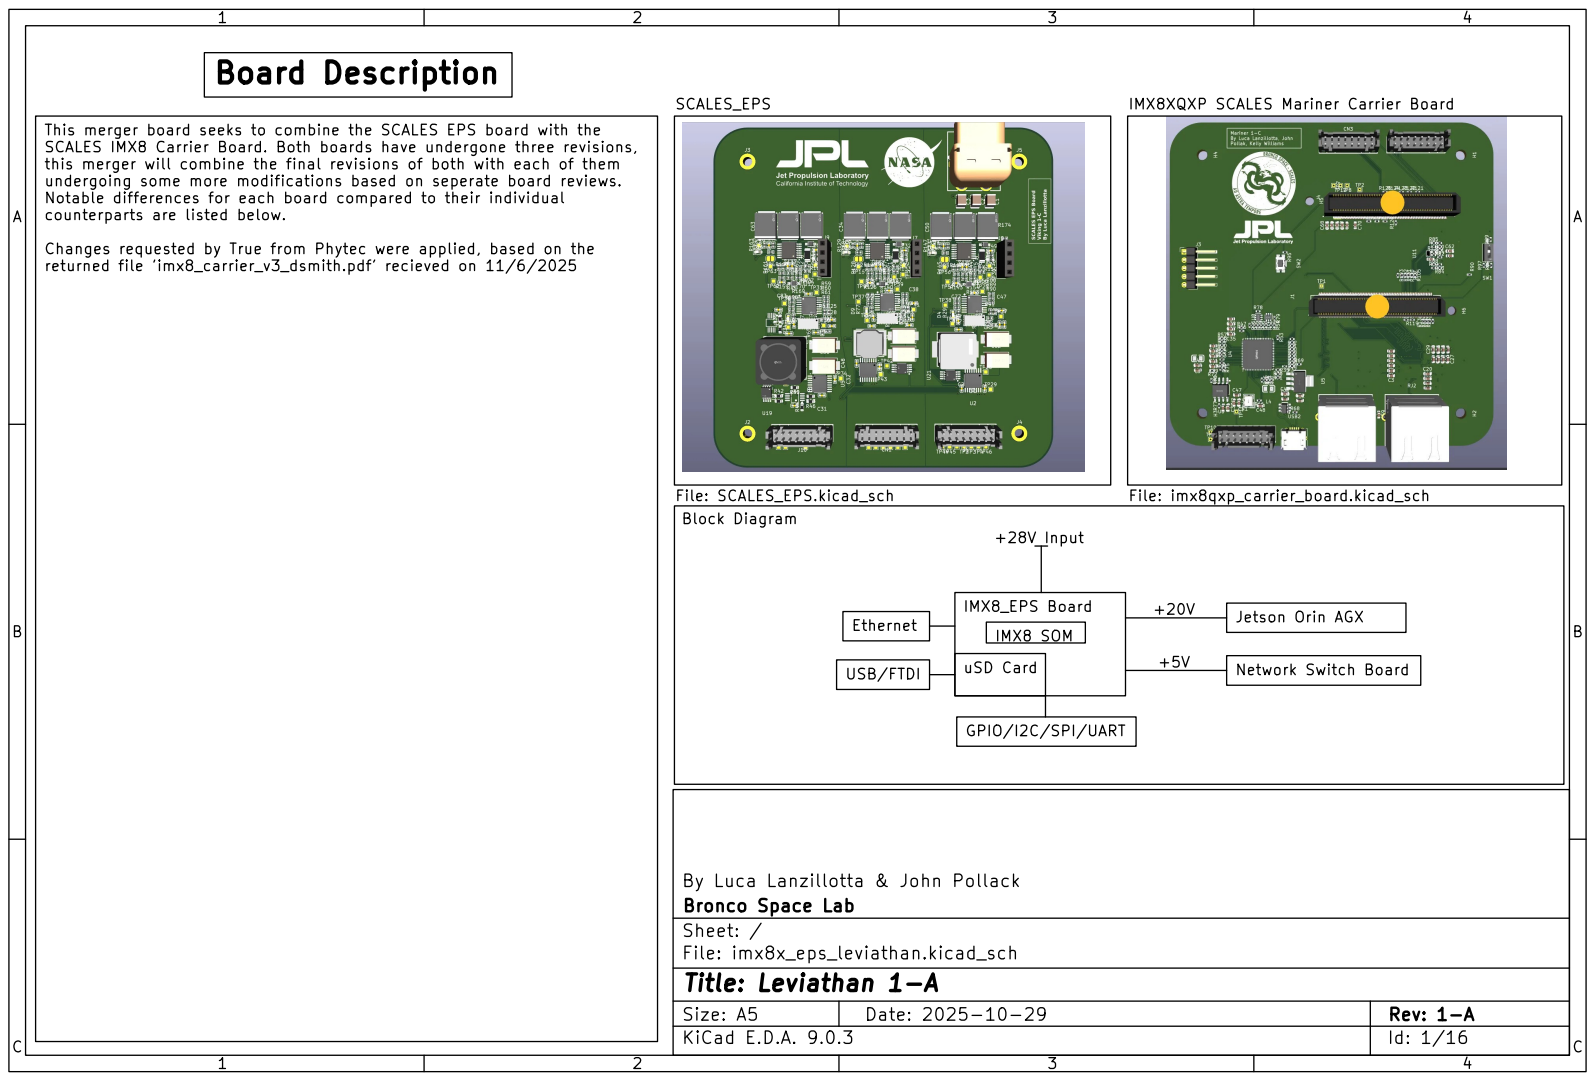
[picture p134: page 1]

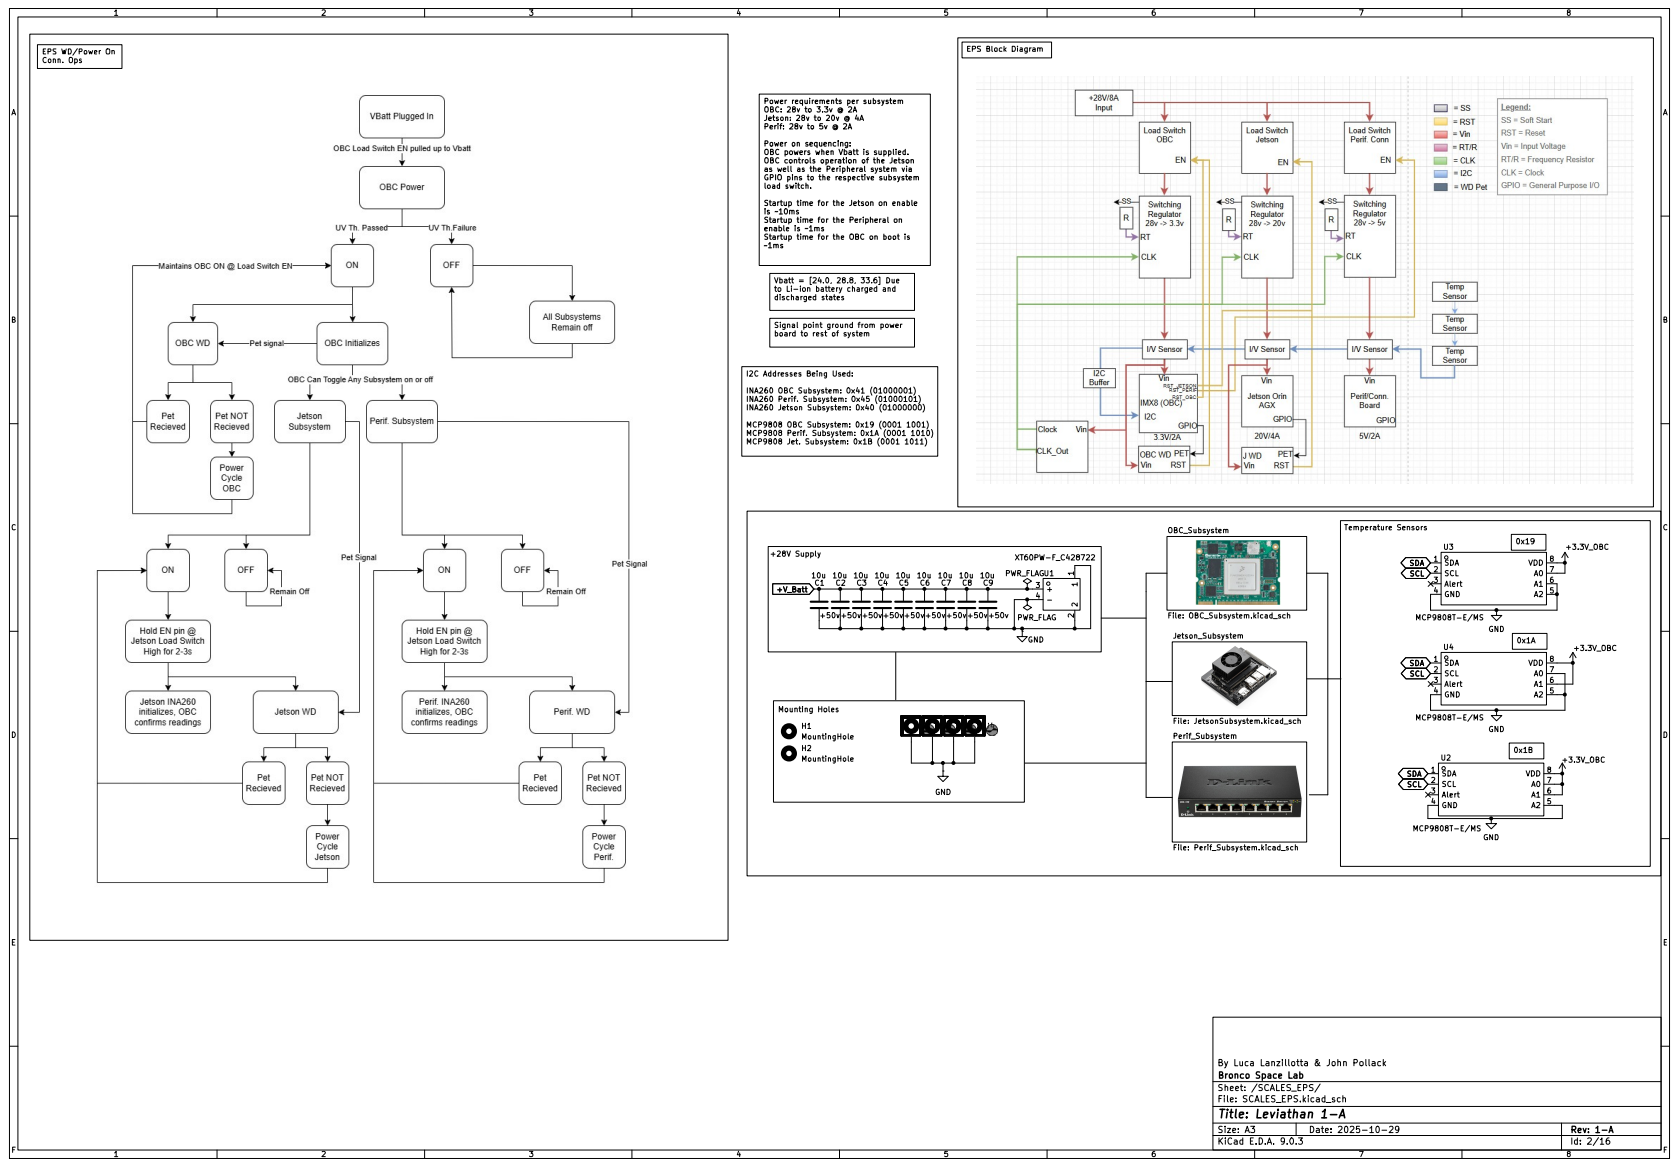
[picture p135: page 2]

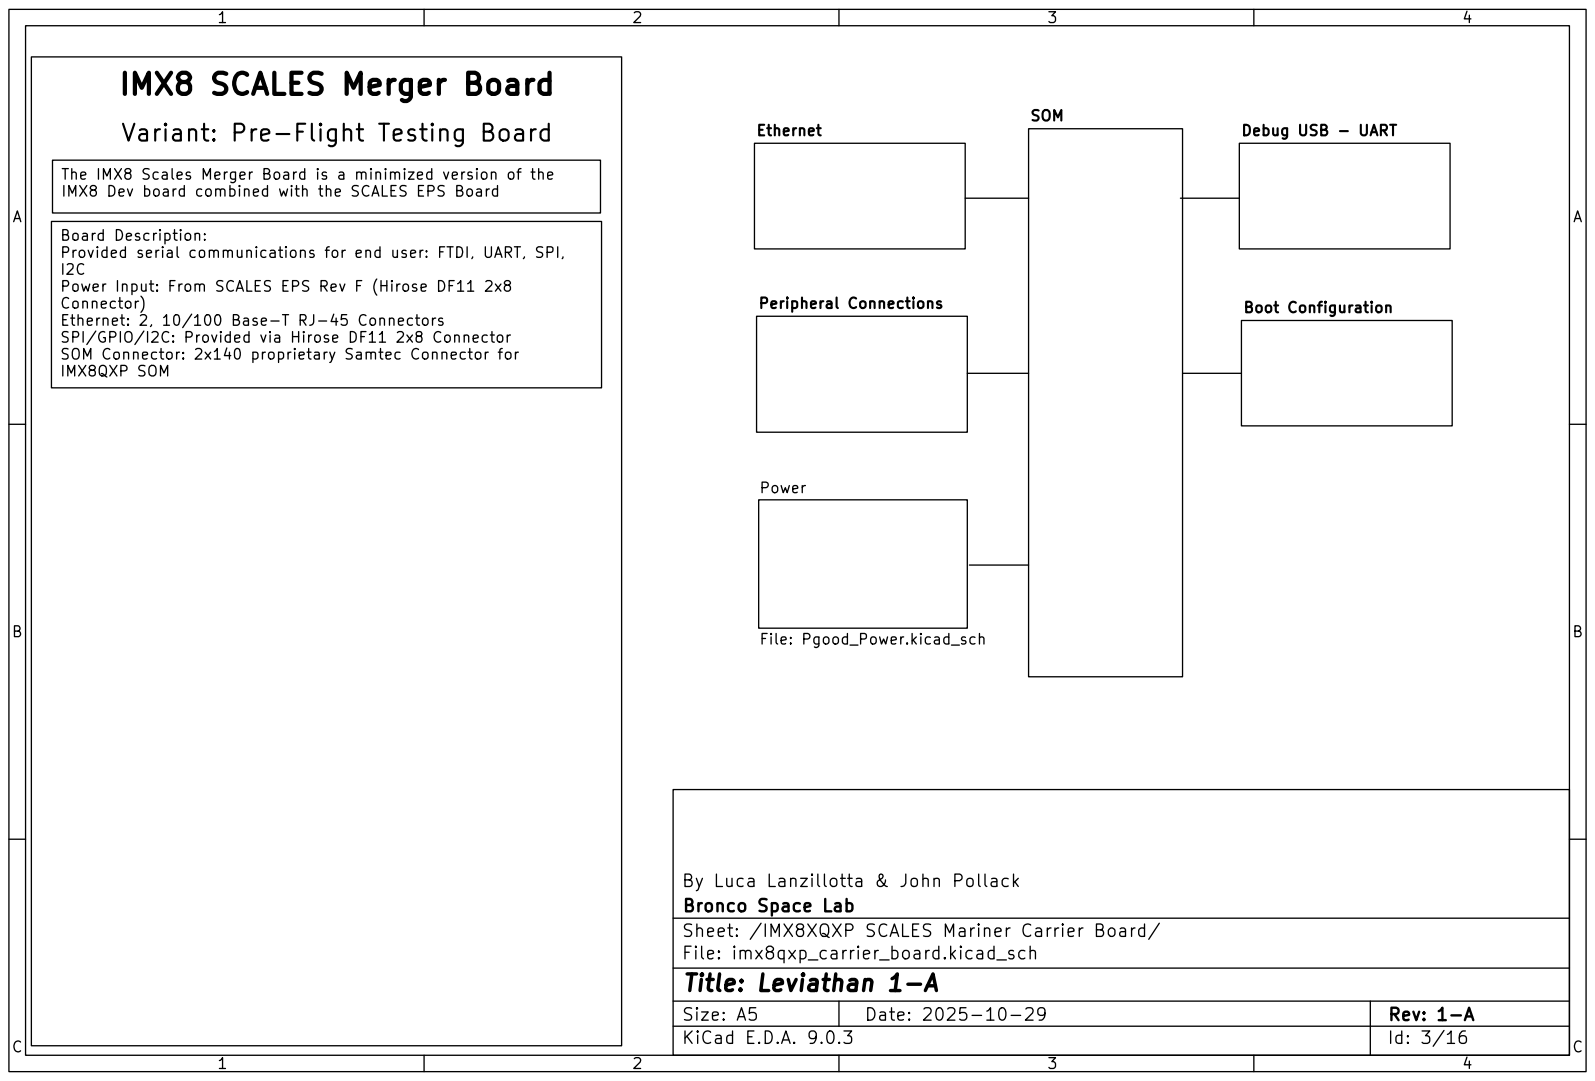
[picture p136: page 3]

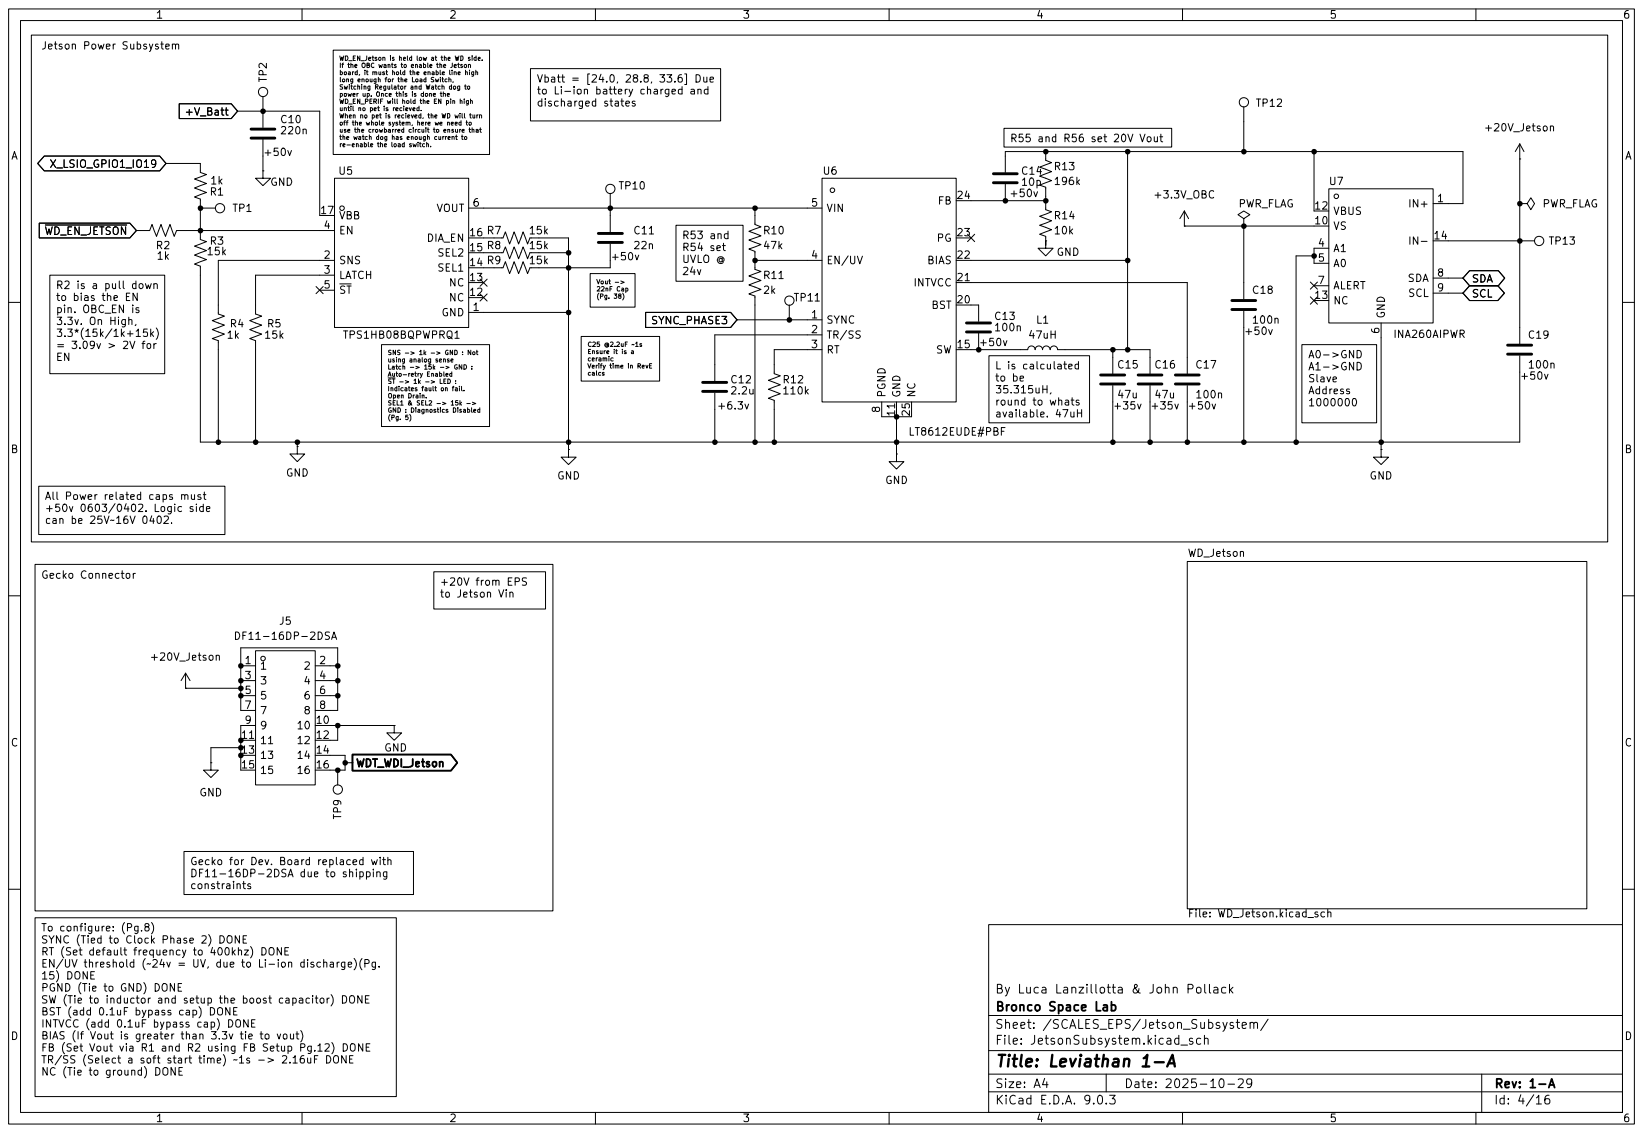
[picture p137: page 4]

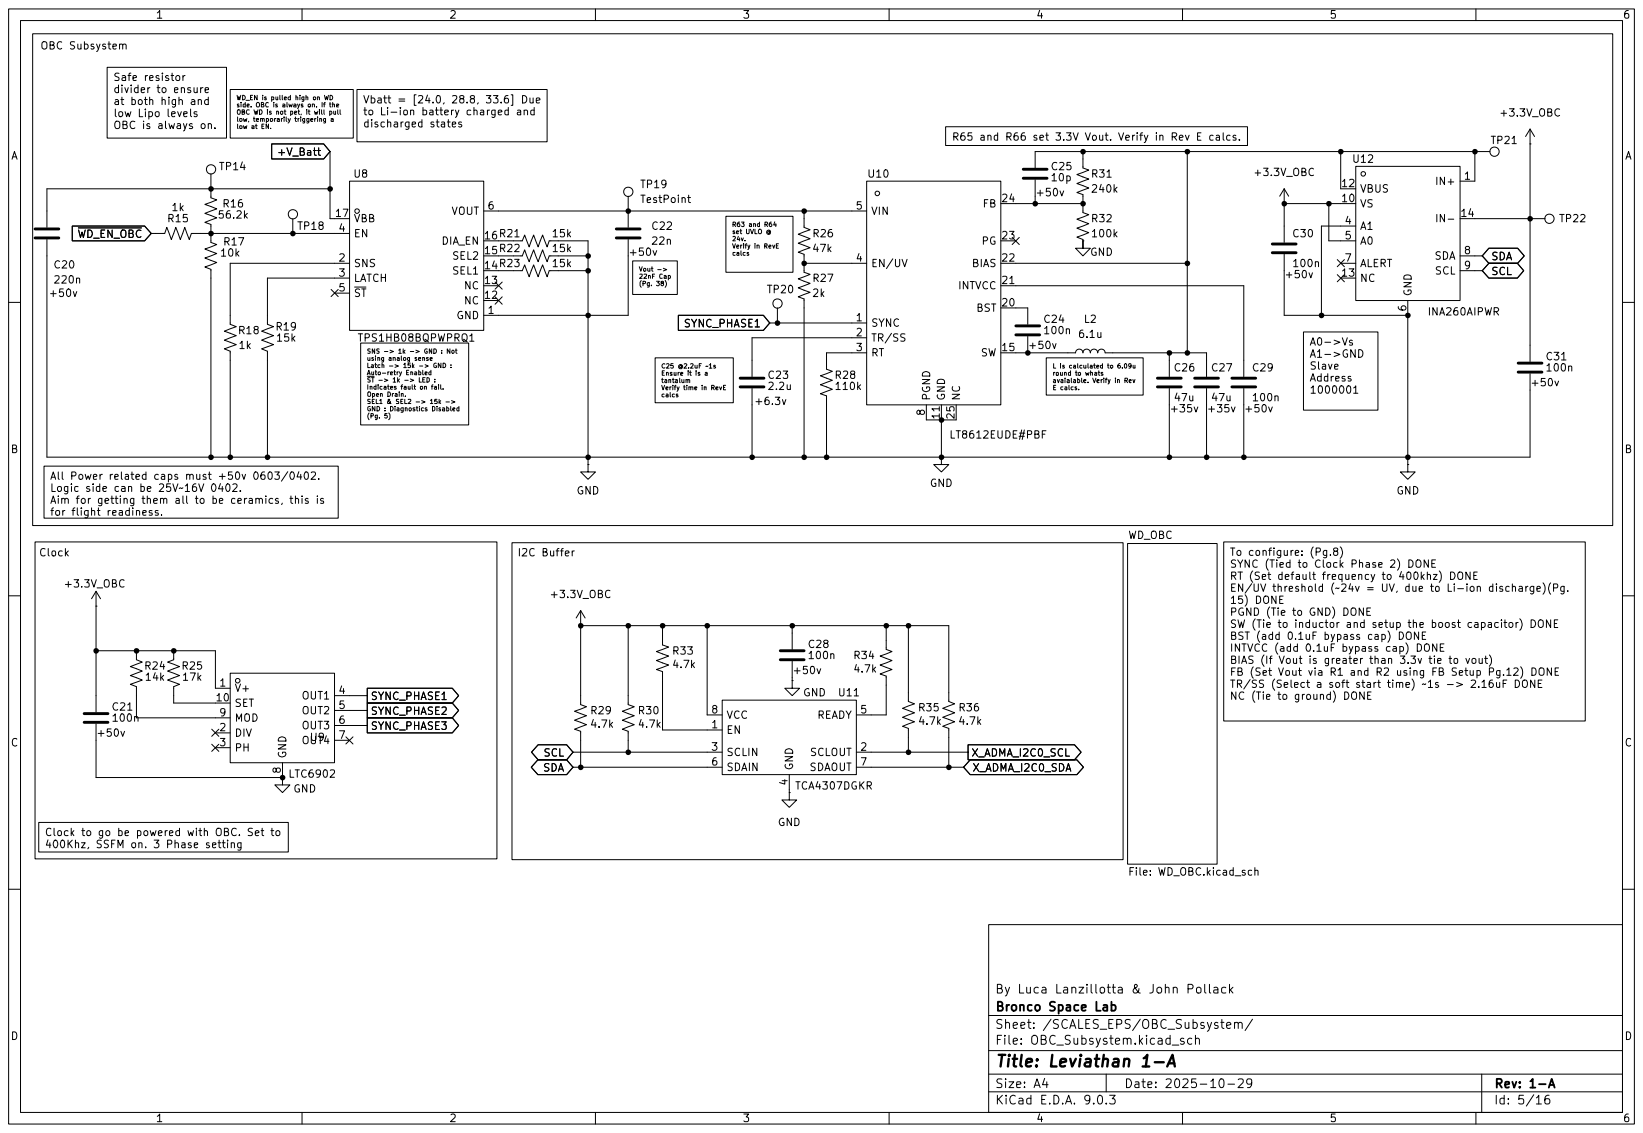
[picture p138: page 5]

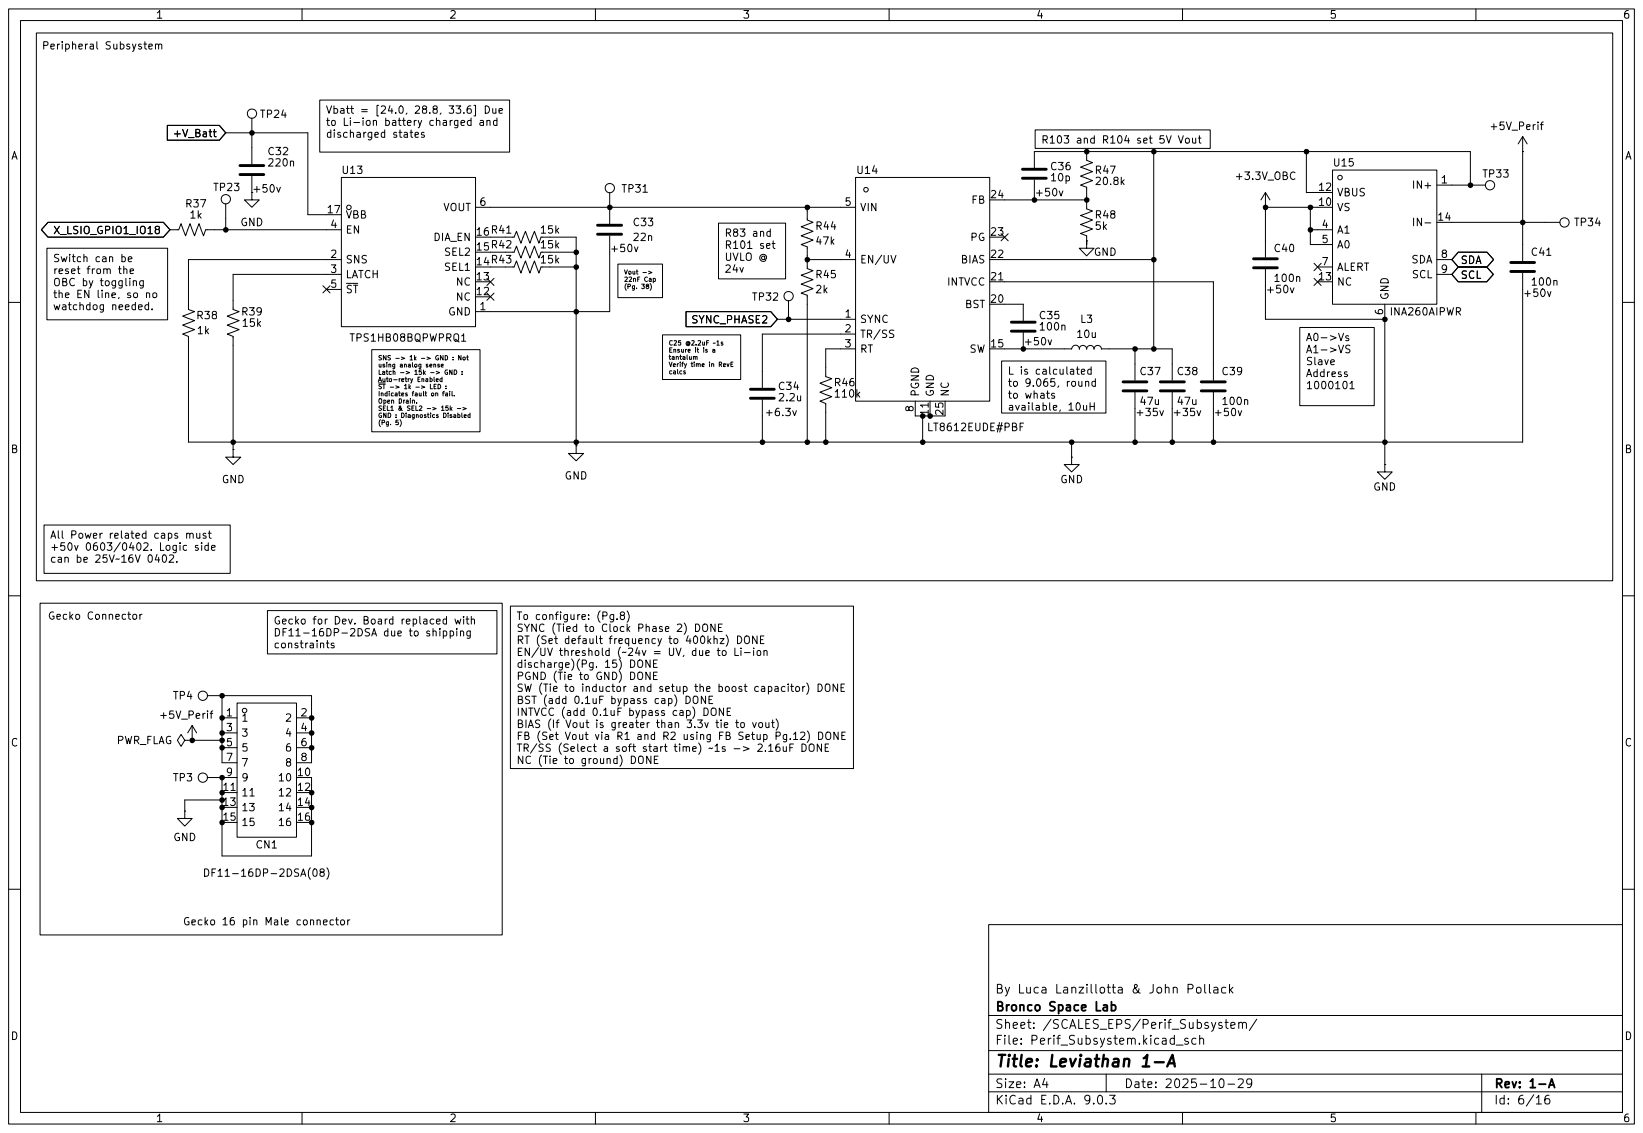
[picture p139: page 6]

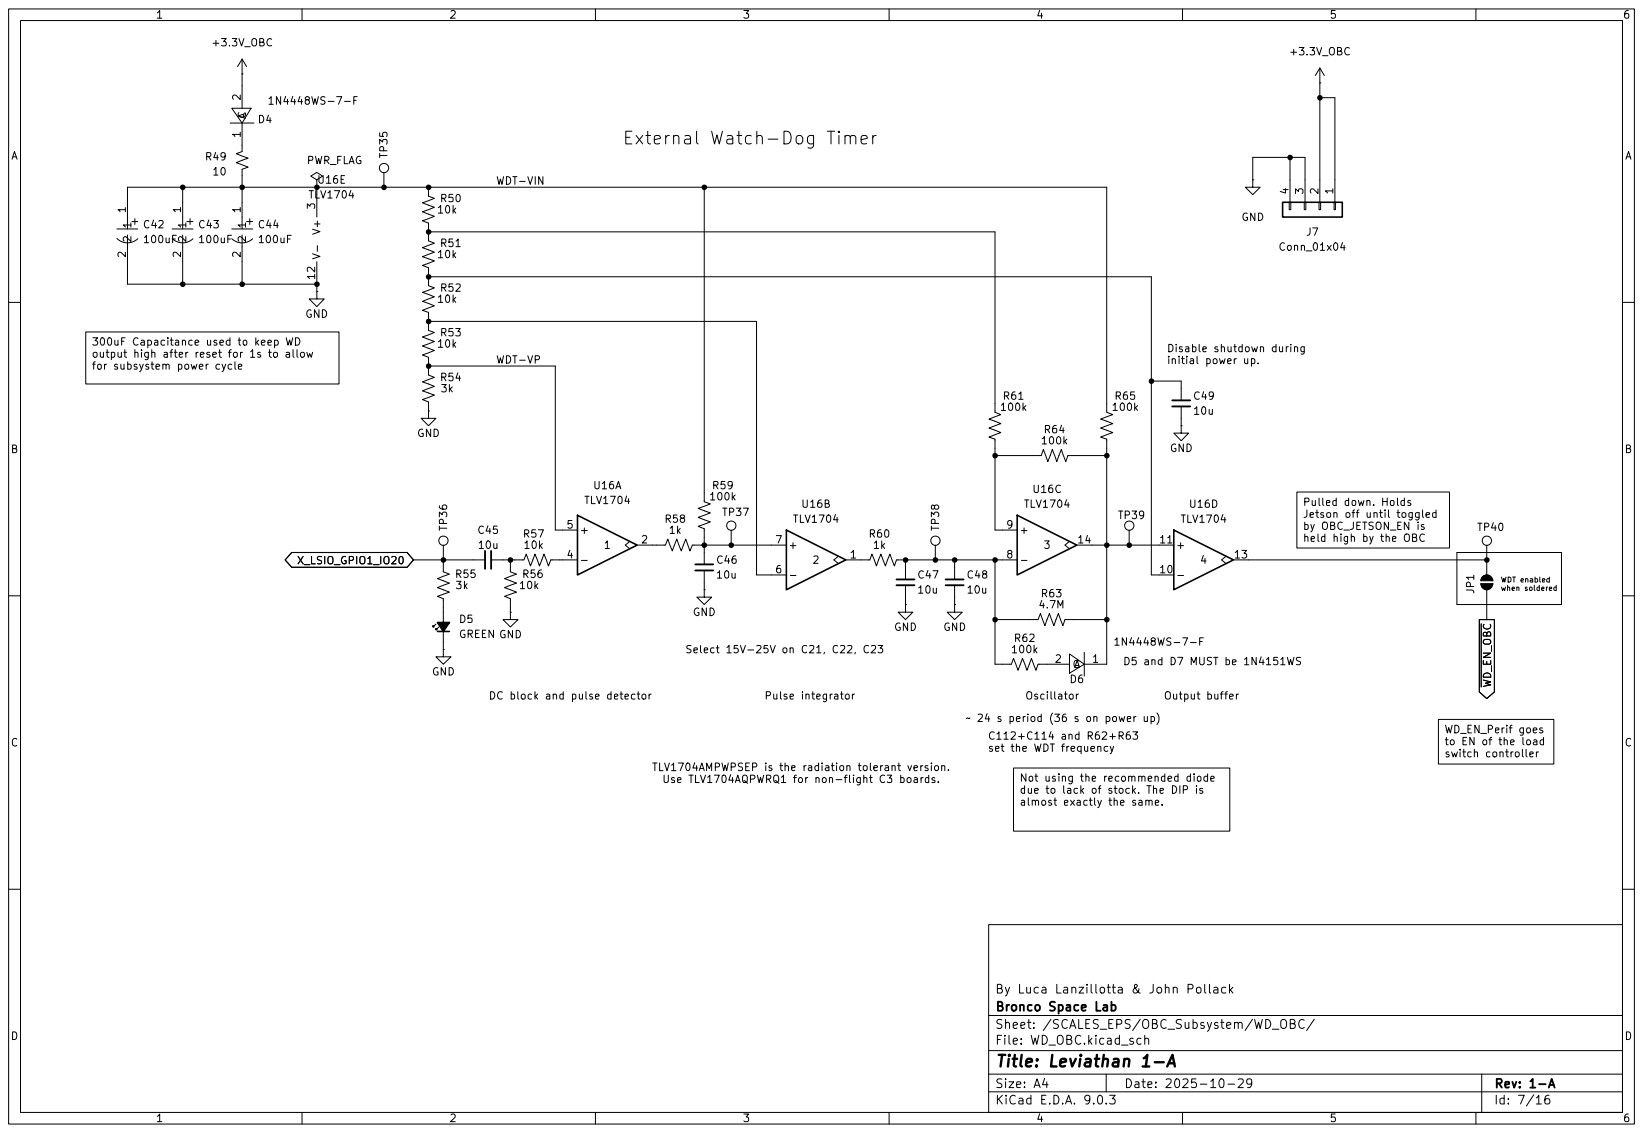
[picture p140: page 7]

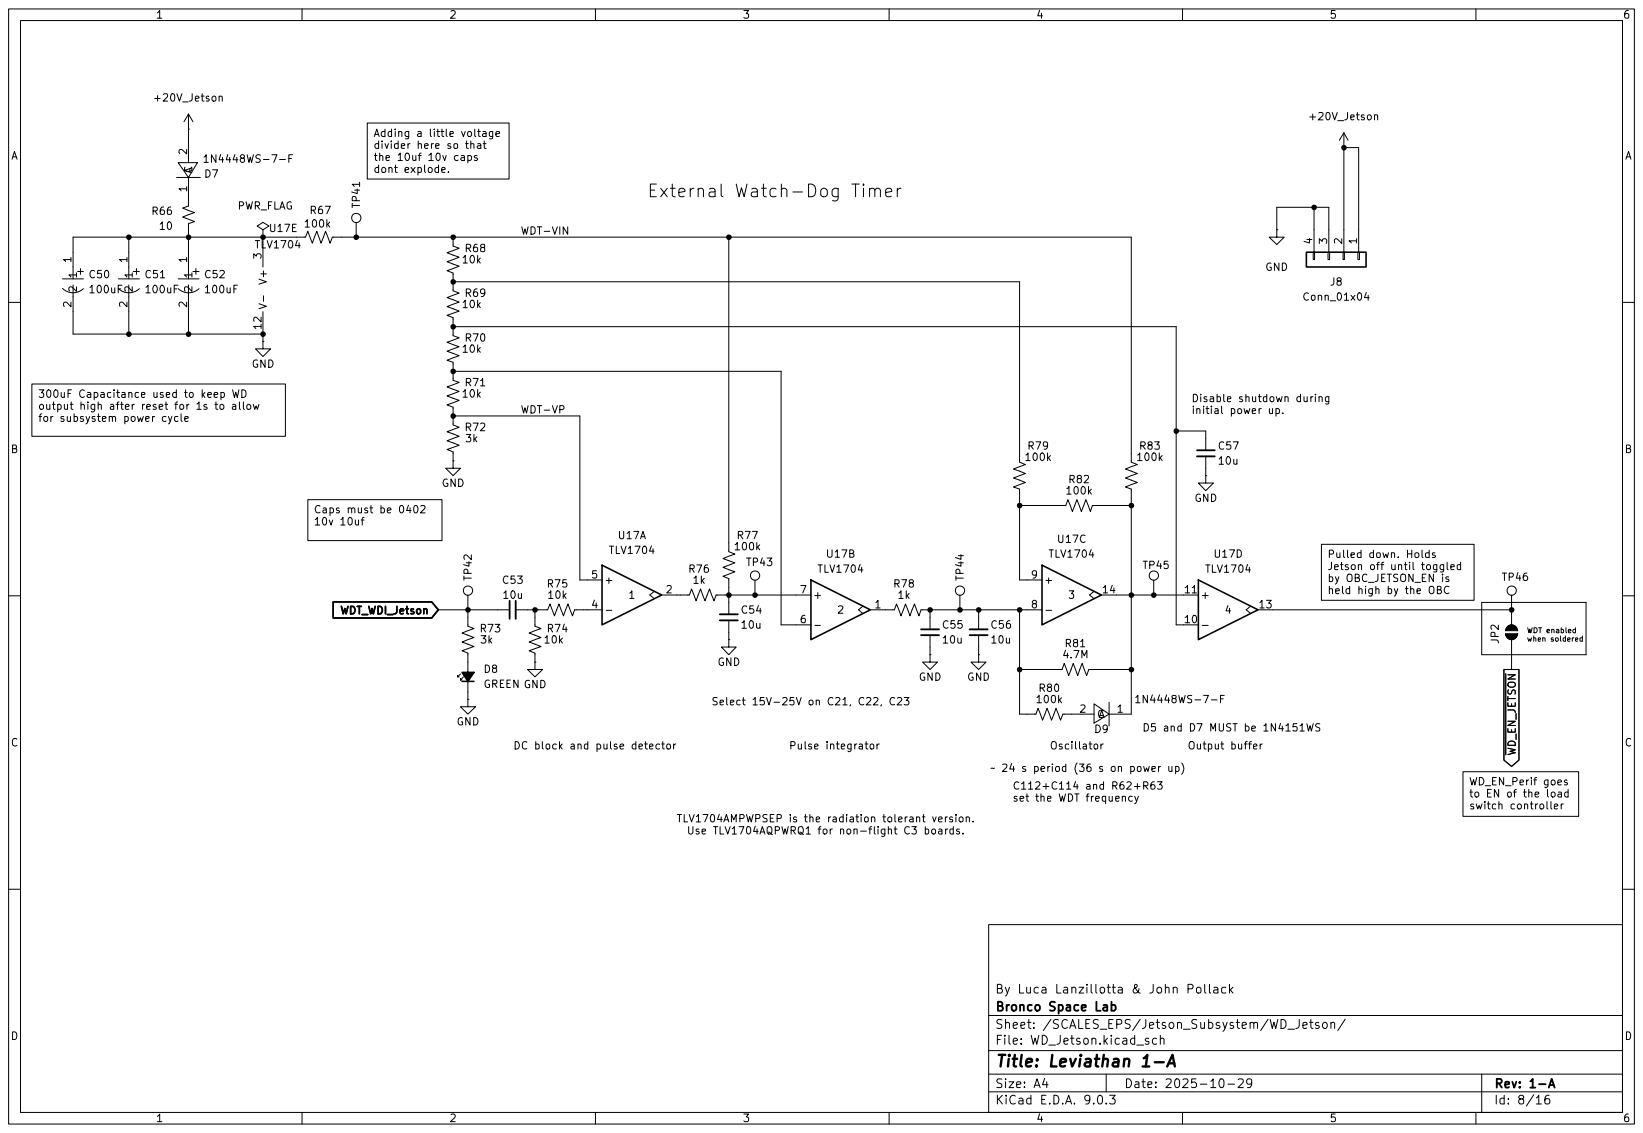
[picture p141: page 8]

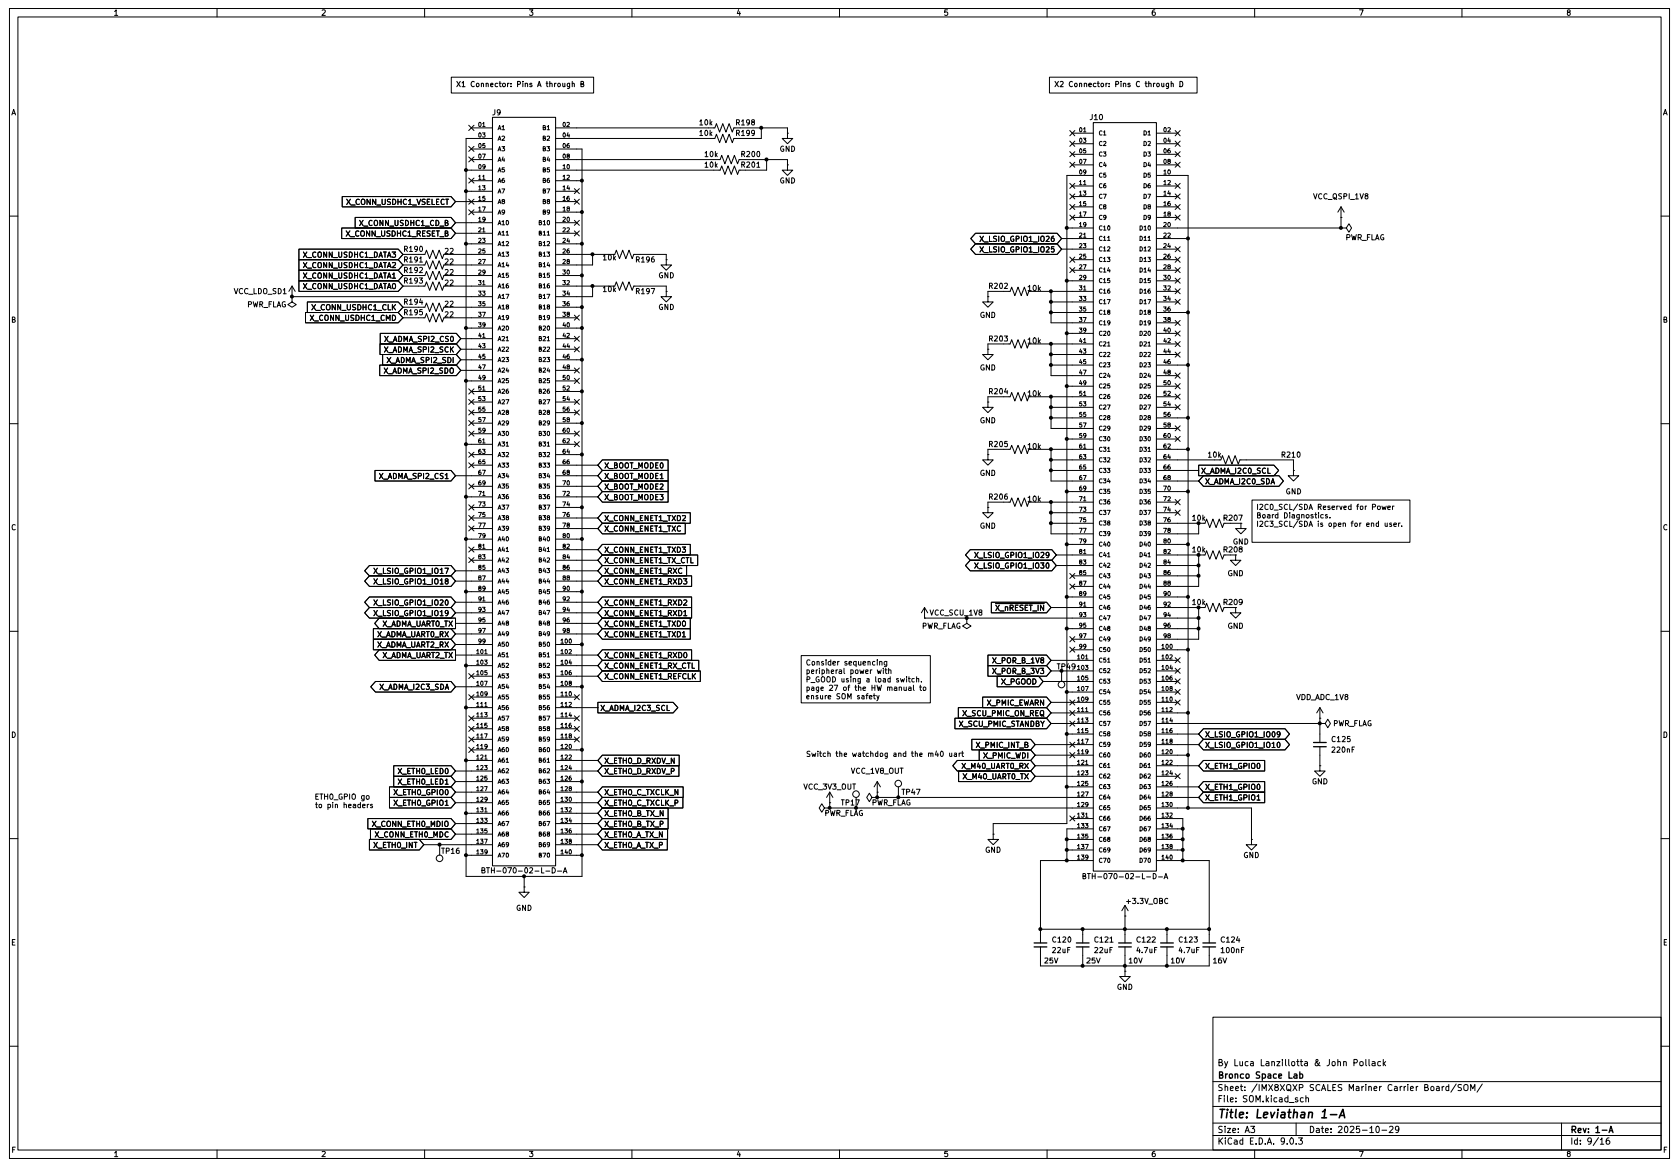
[picture p142: page 9]

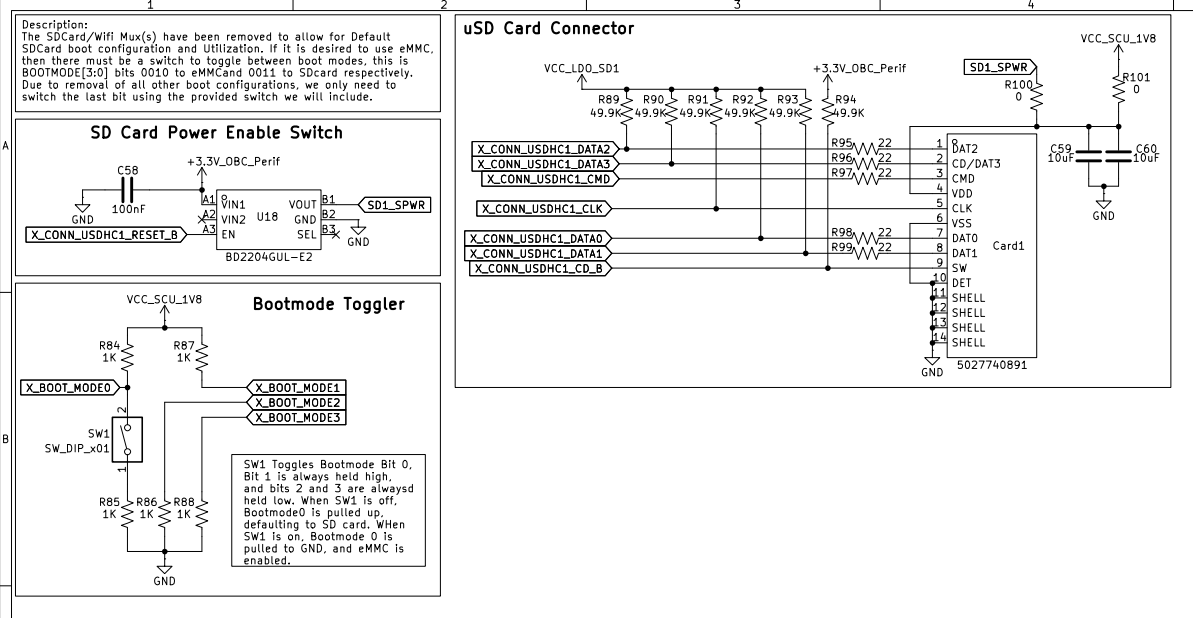
[picture p143: page 10]

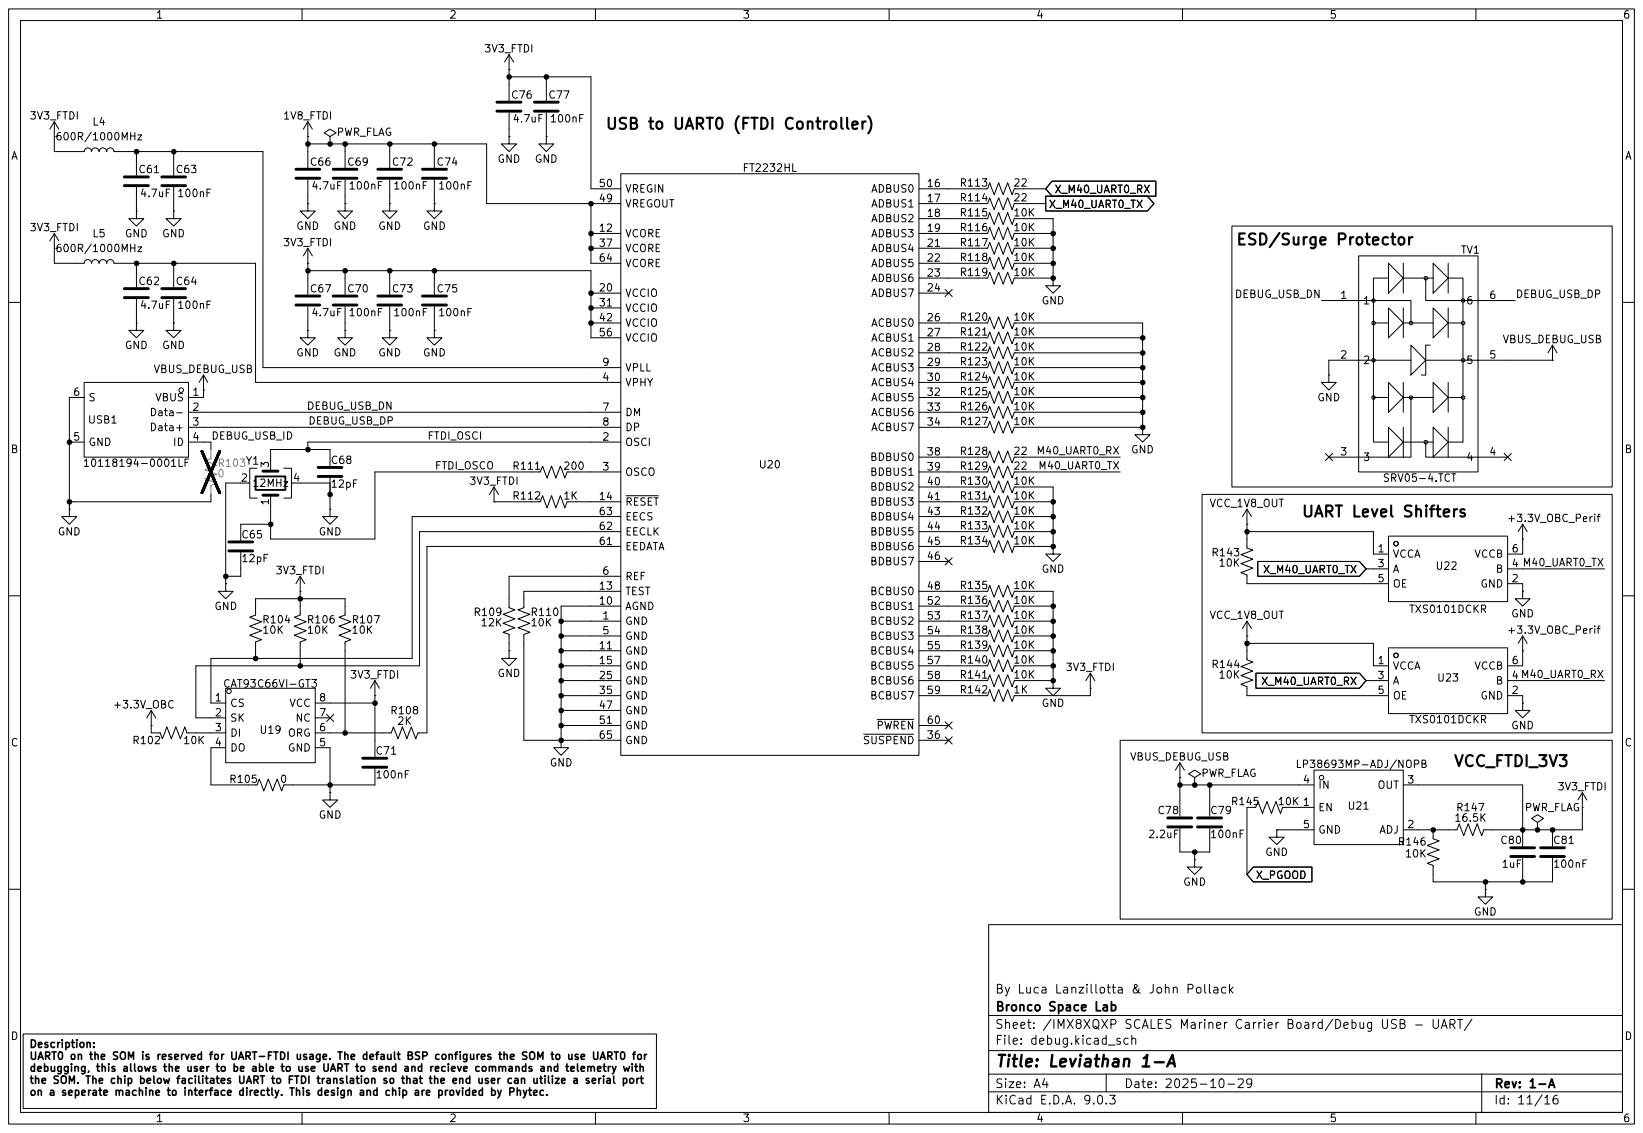
[picture p144: page 11]

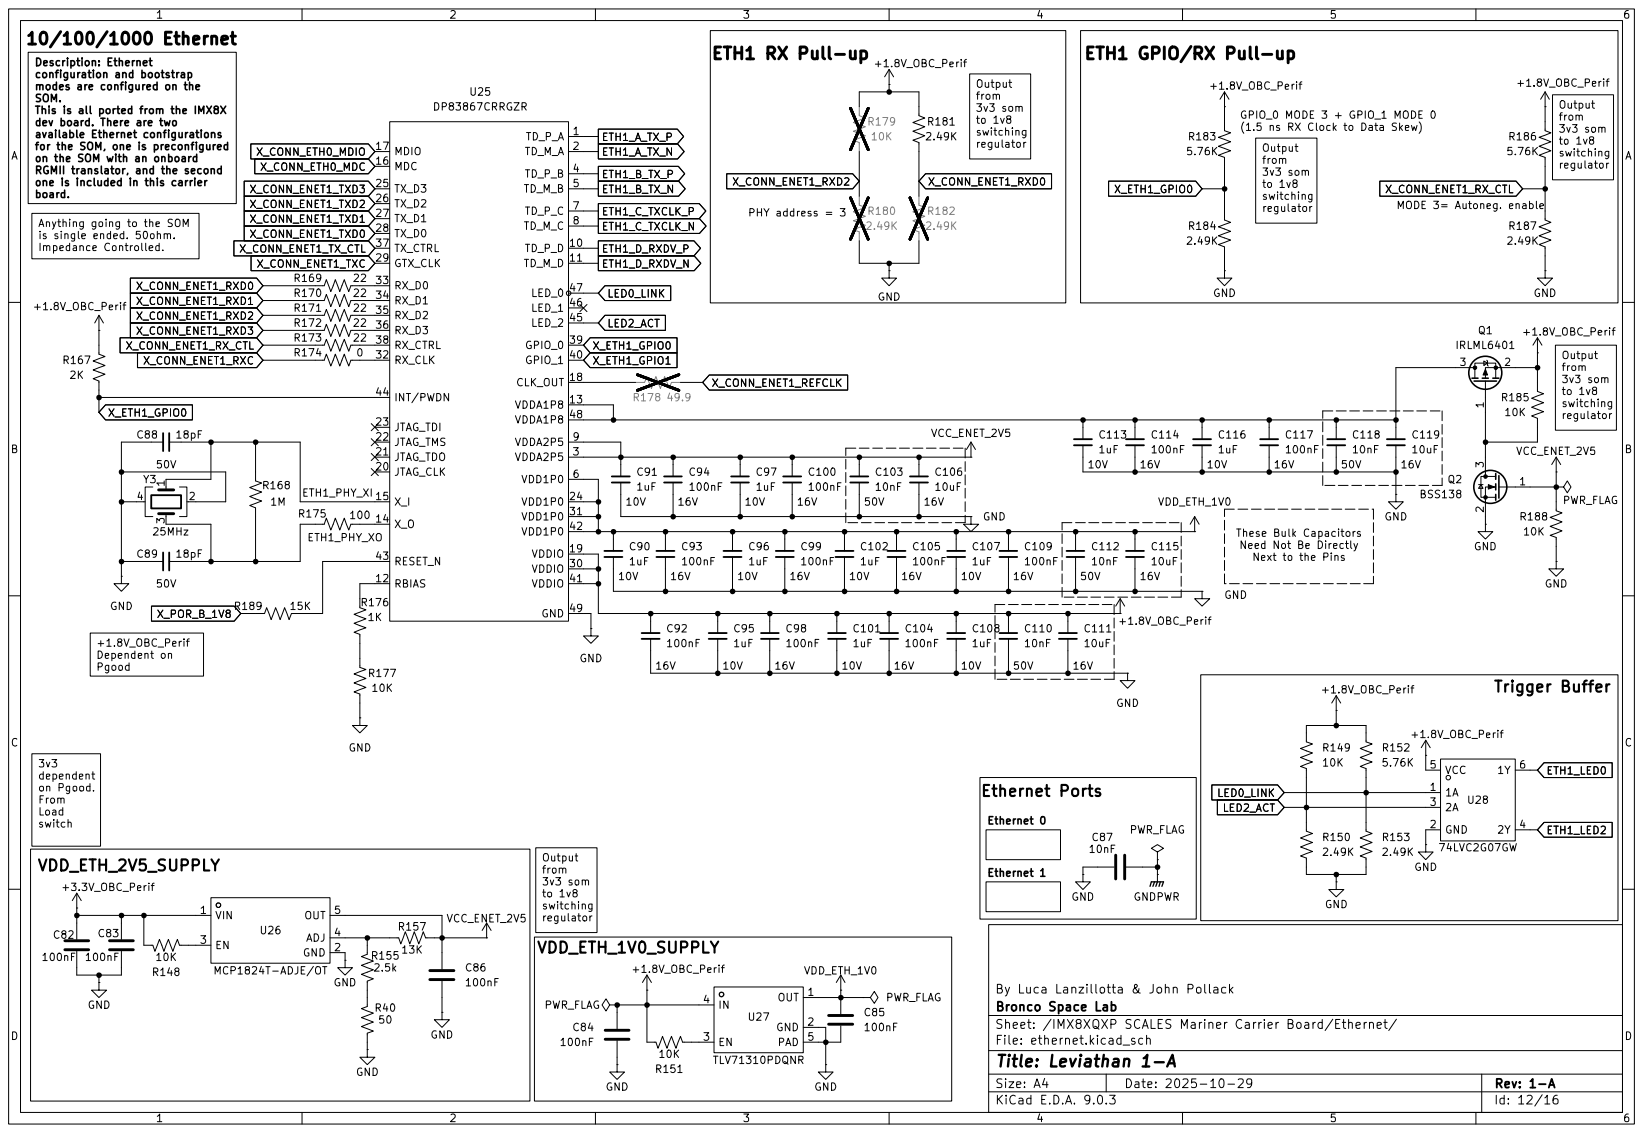
[picture p145: page 12]

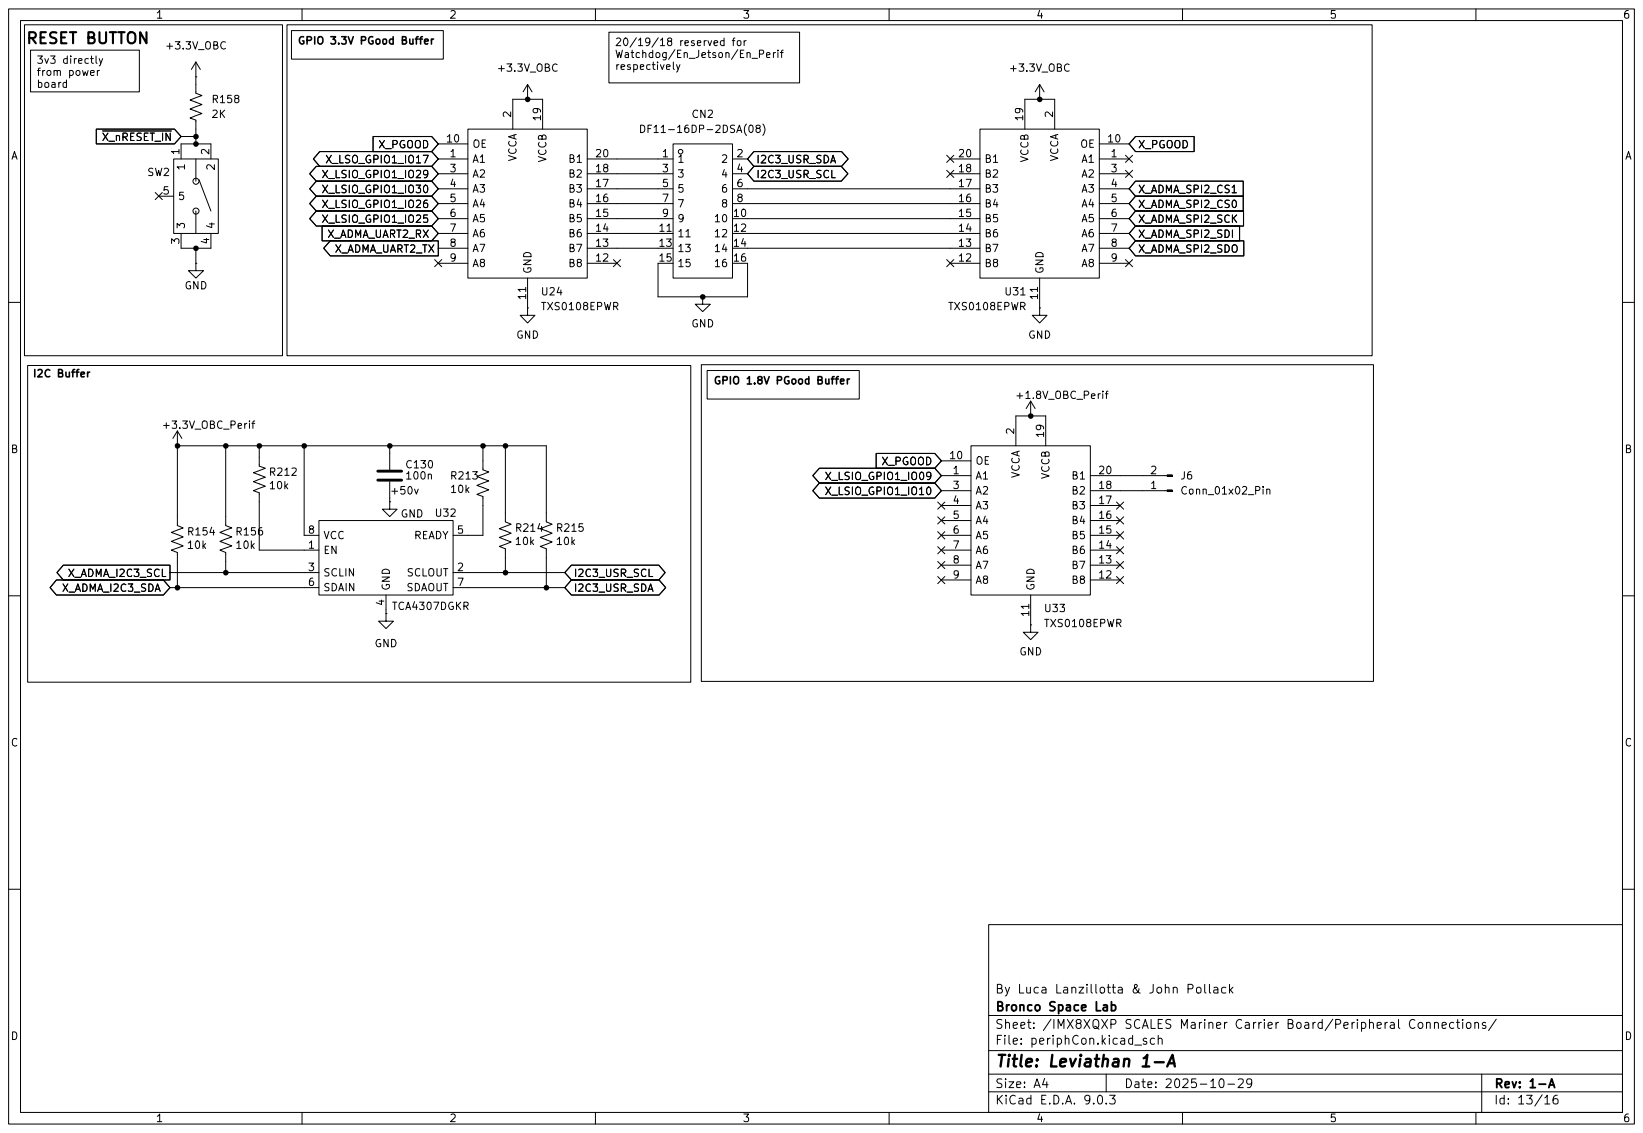
[picture p146: page 13]

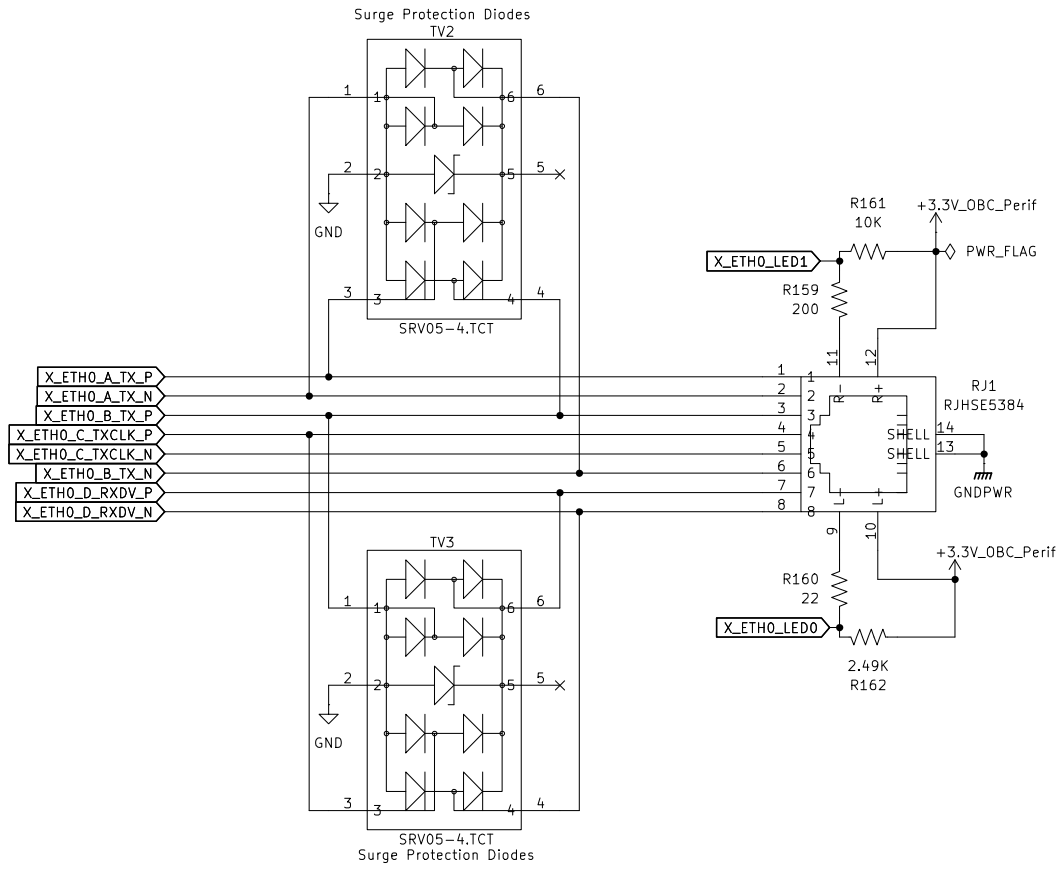
[picture p147: page 14]

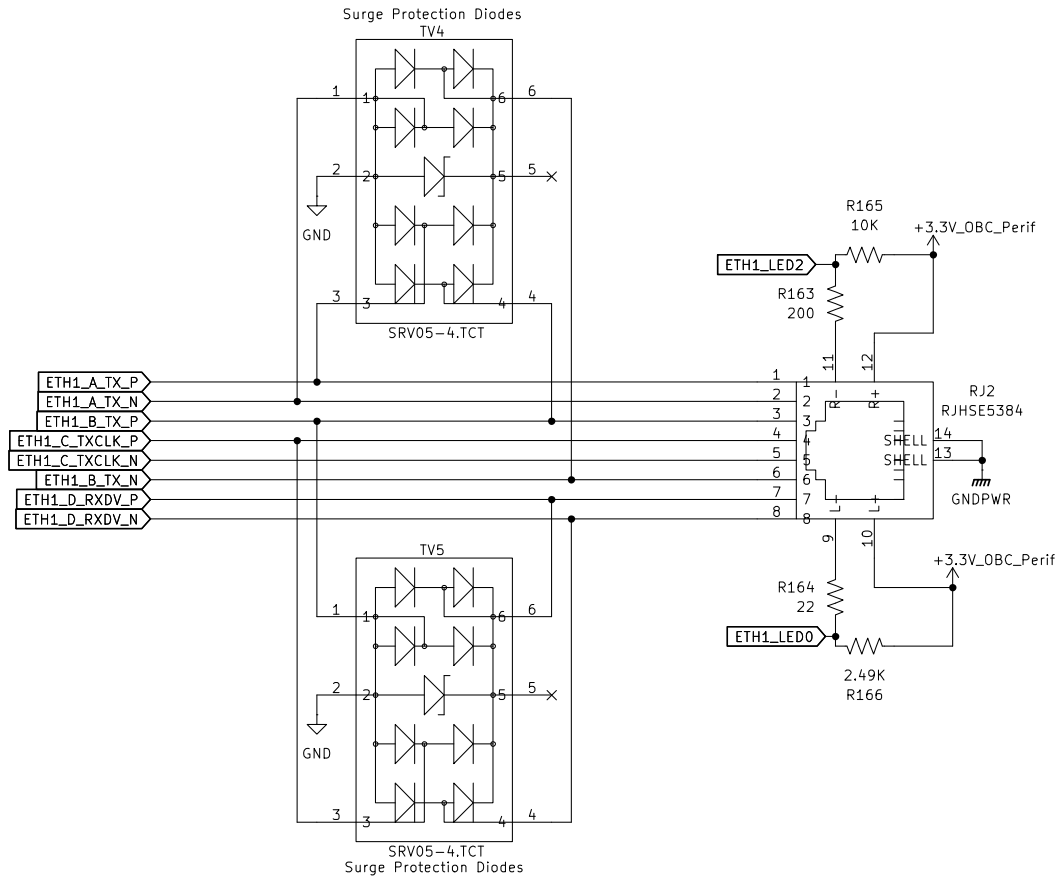
[picture p148: page 15]

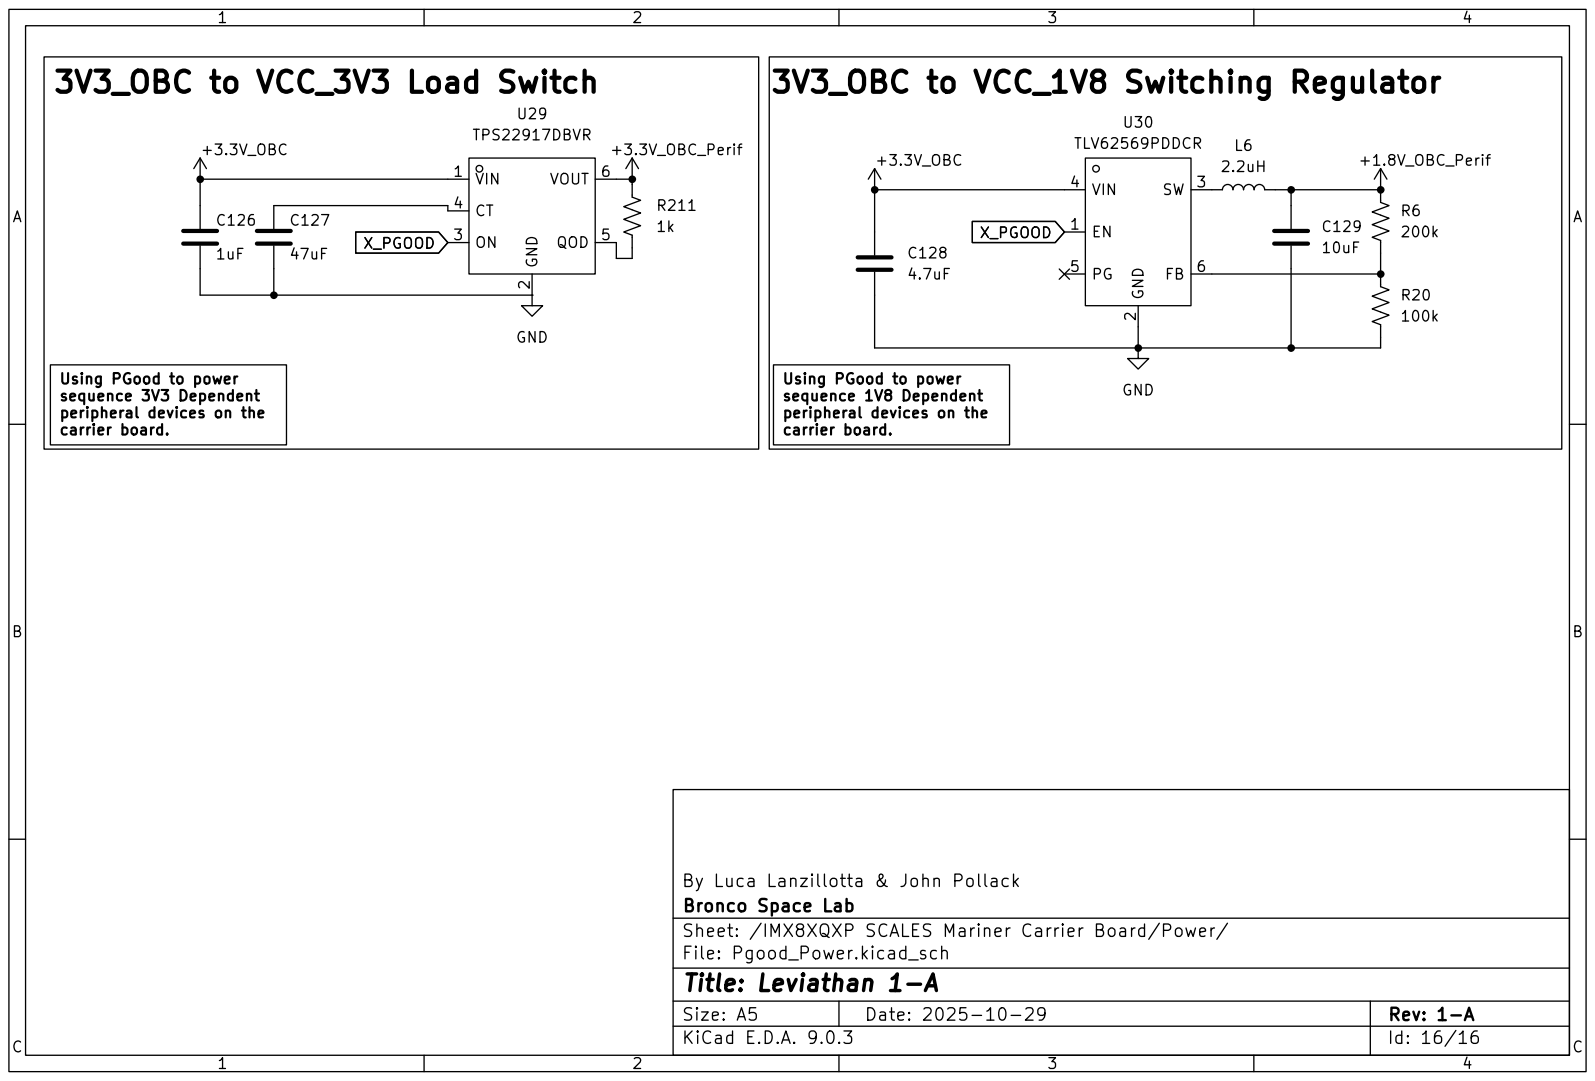
[picture p149: page 16]
