BroncoSpace-Lab/scales-hardware/imx8x_eps_leviathan_v2/reviews/revision reviews/imx8x_leviathan_v2_reviewed31726.pdf

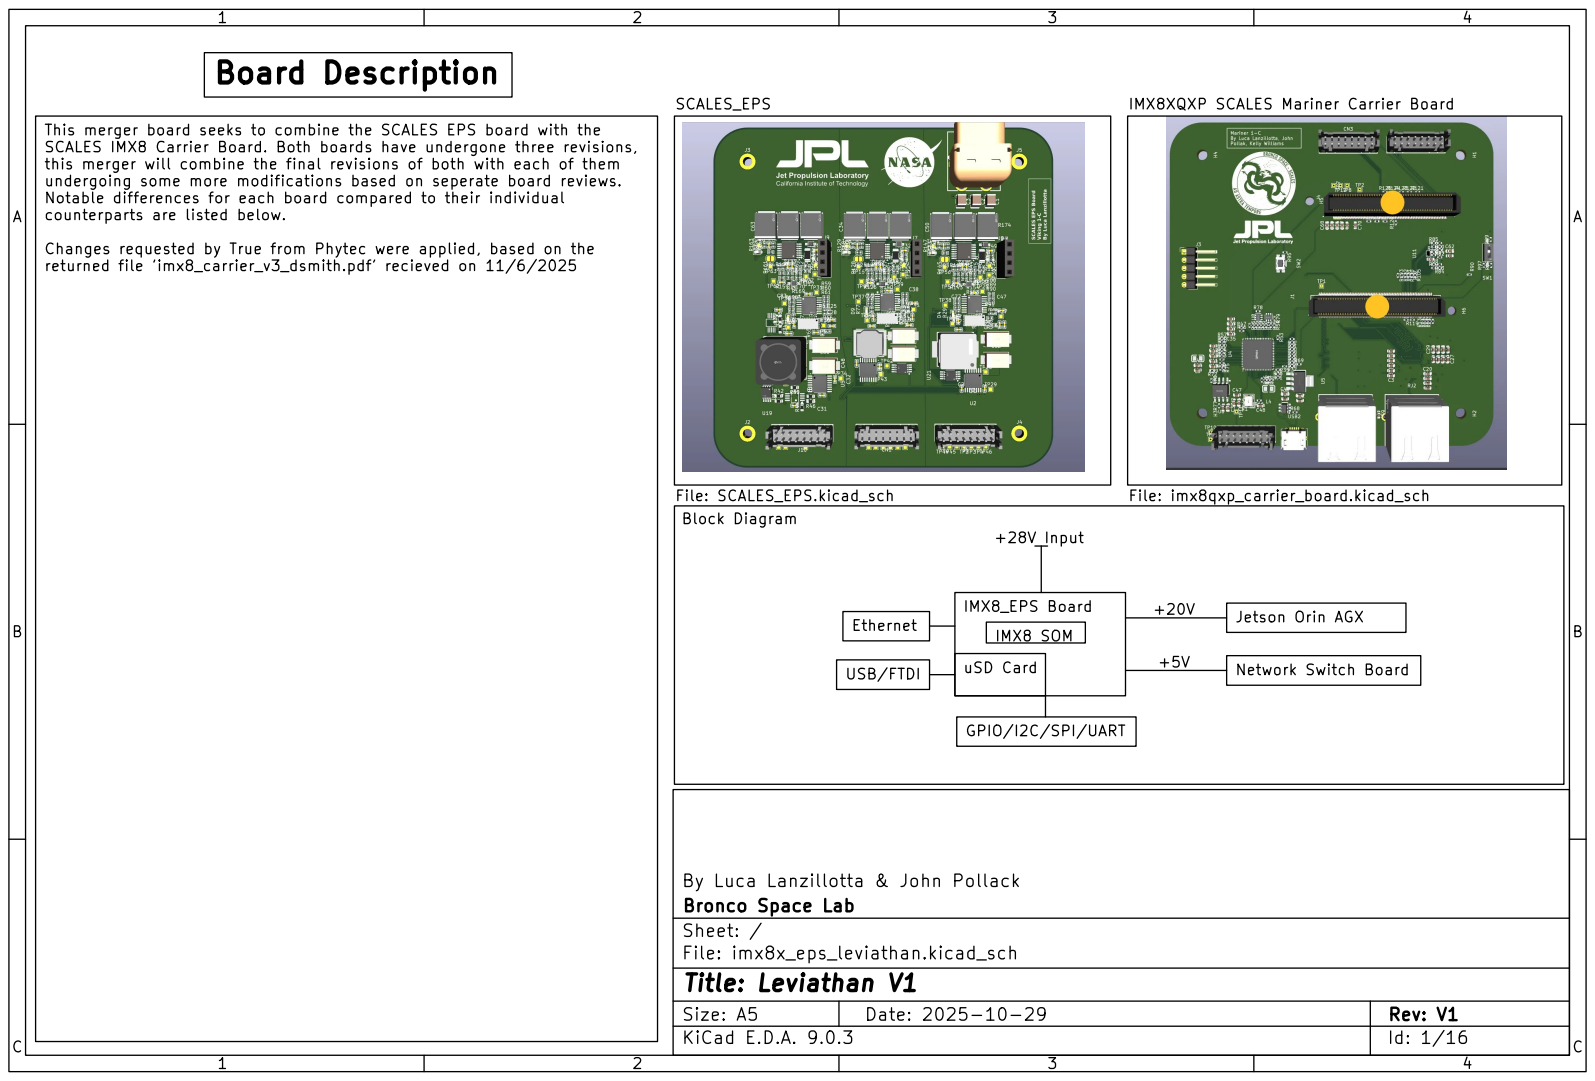
[picture p150: page 1]

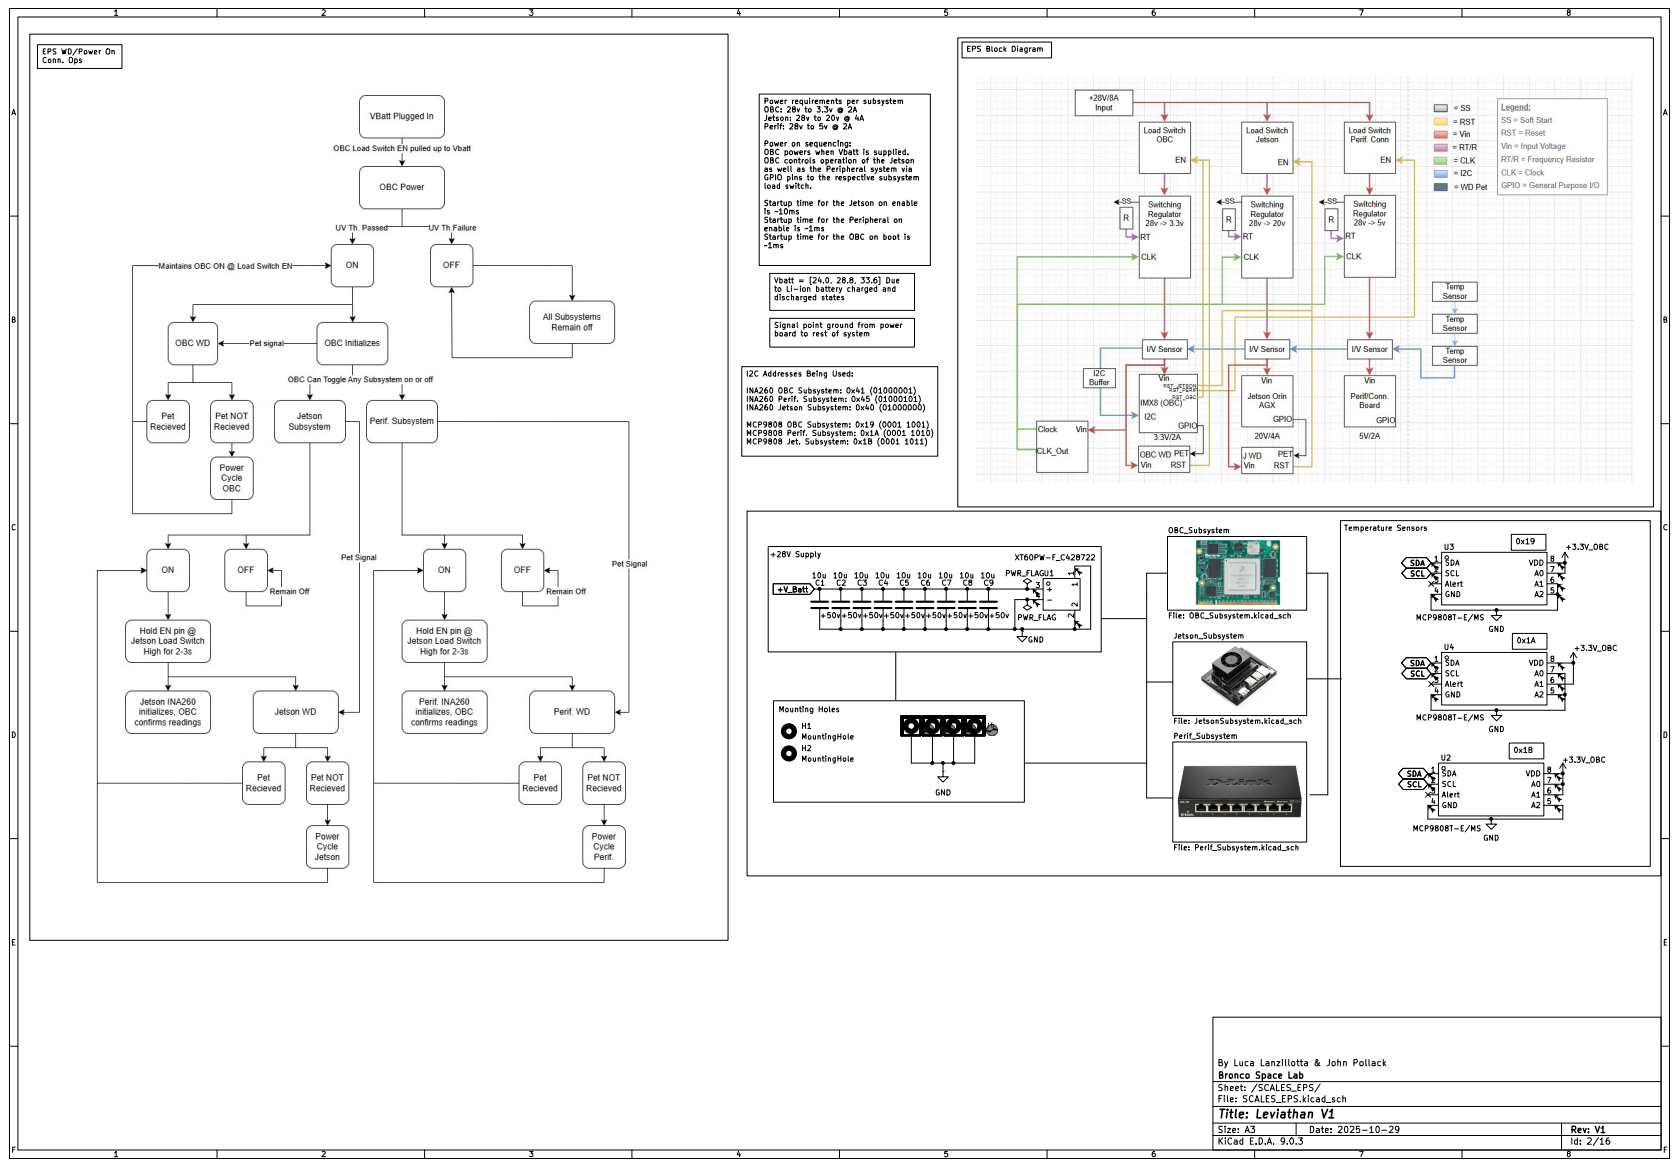
[picture p151: page 2]

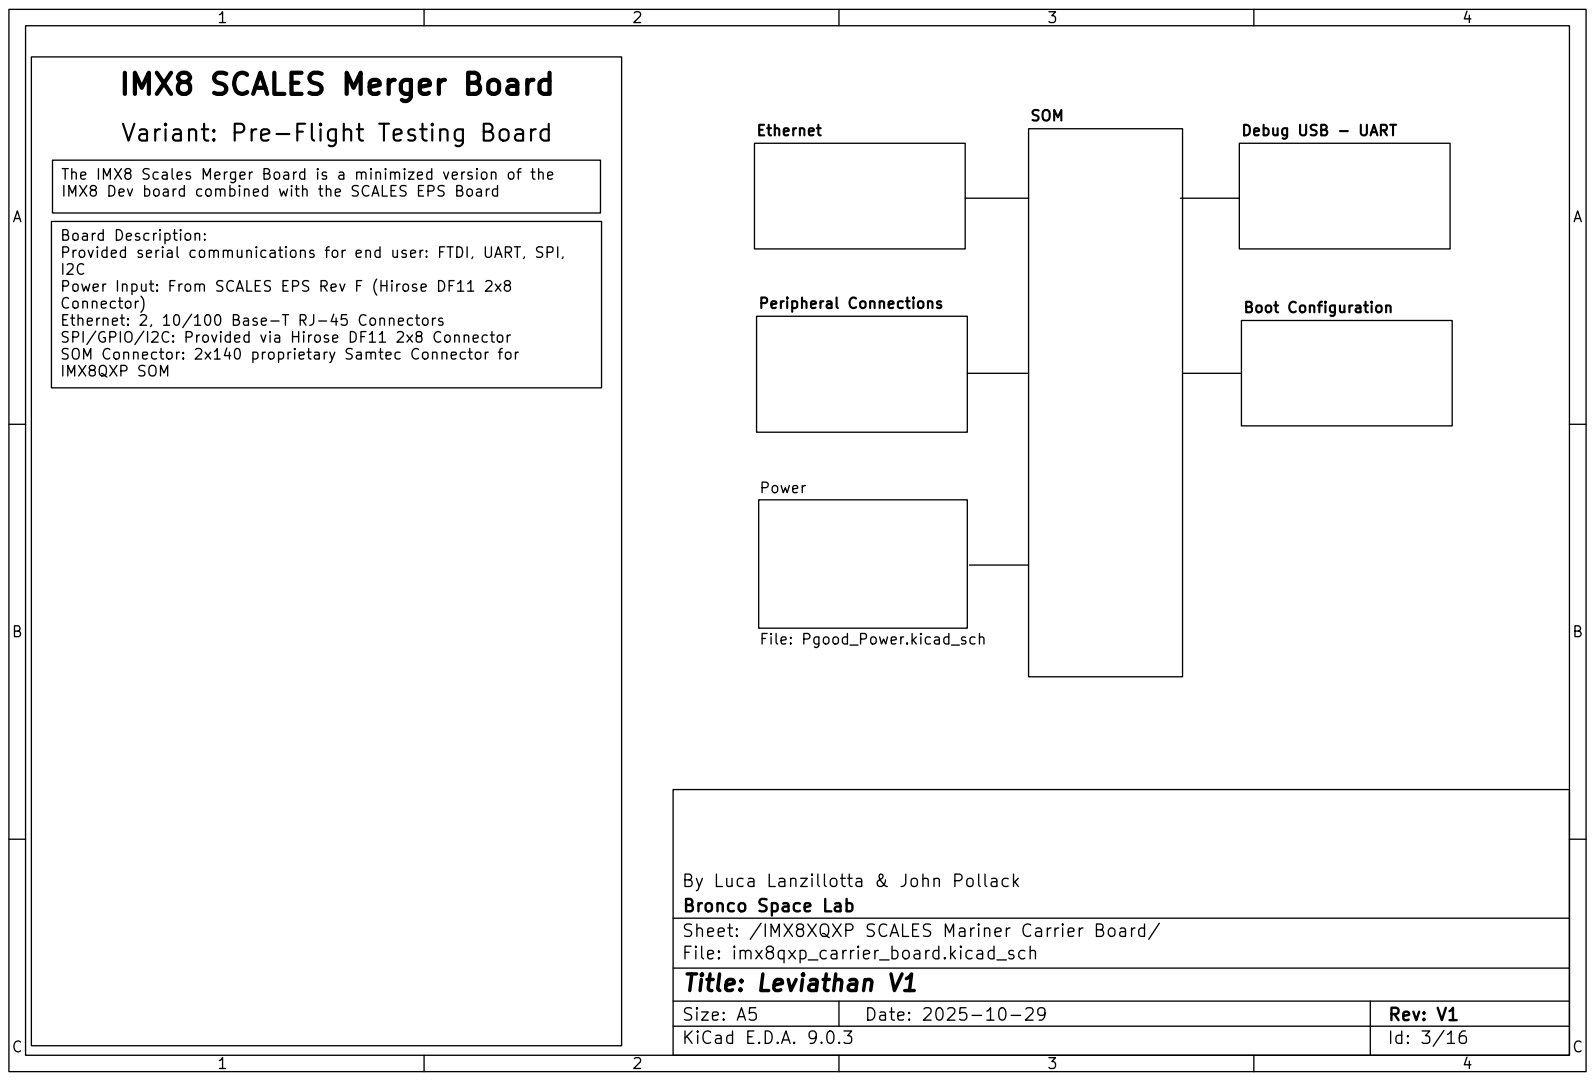
[picture p152: page 3]

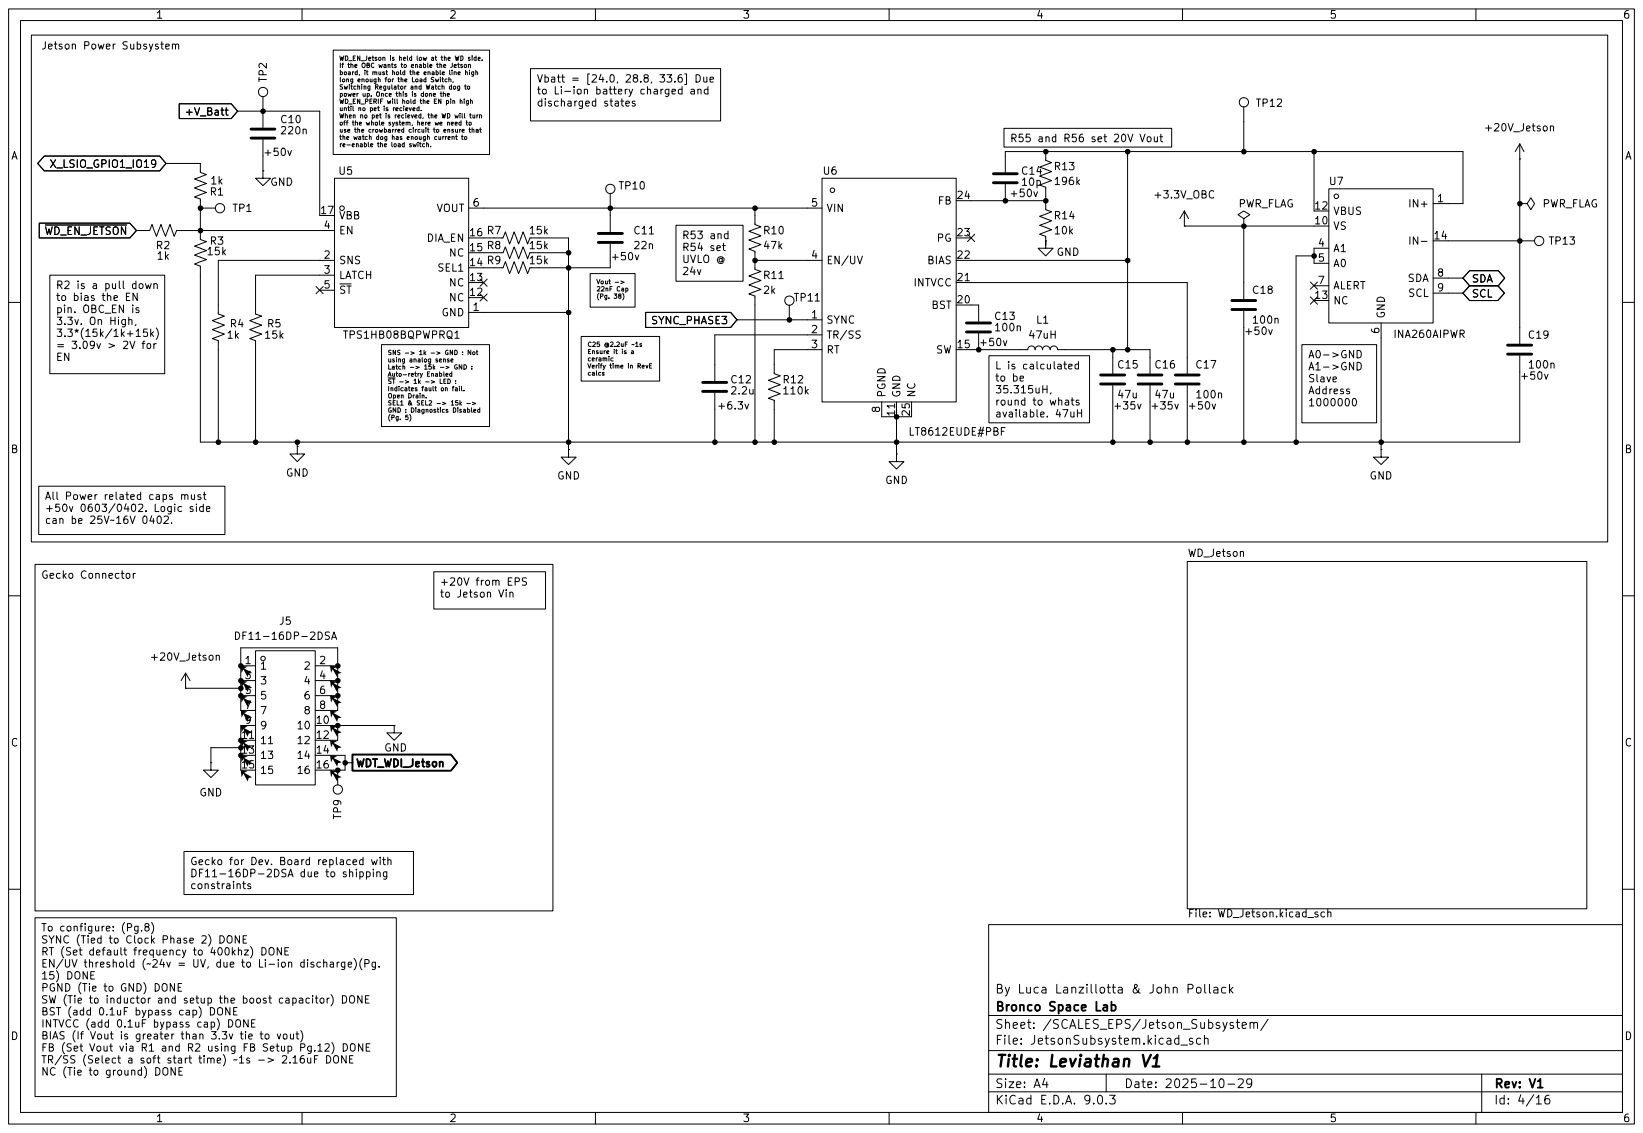
[picture p153: page 4]

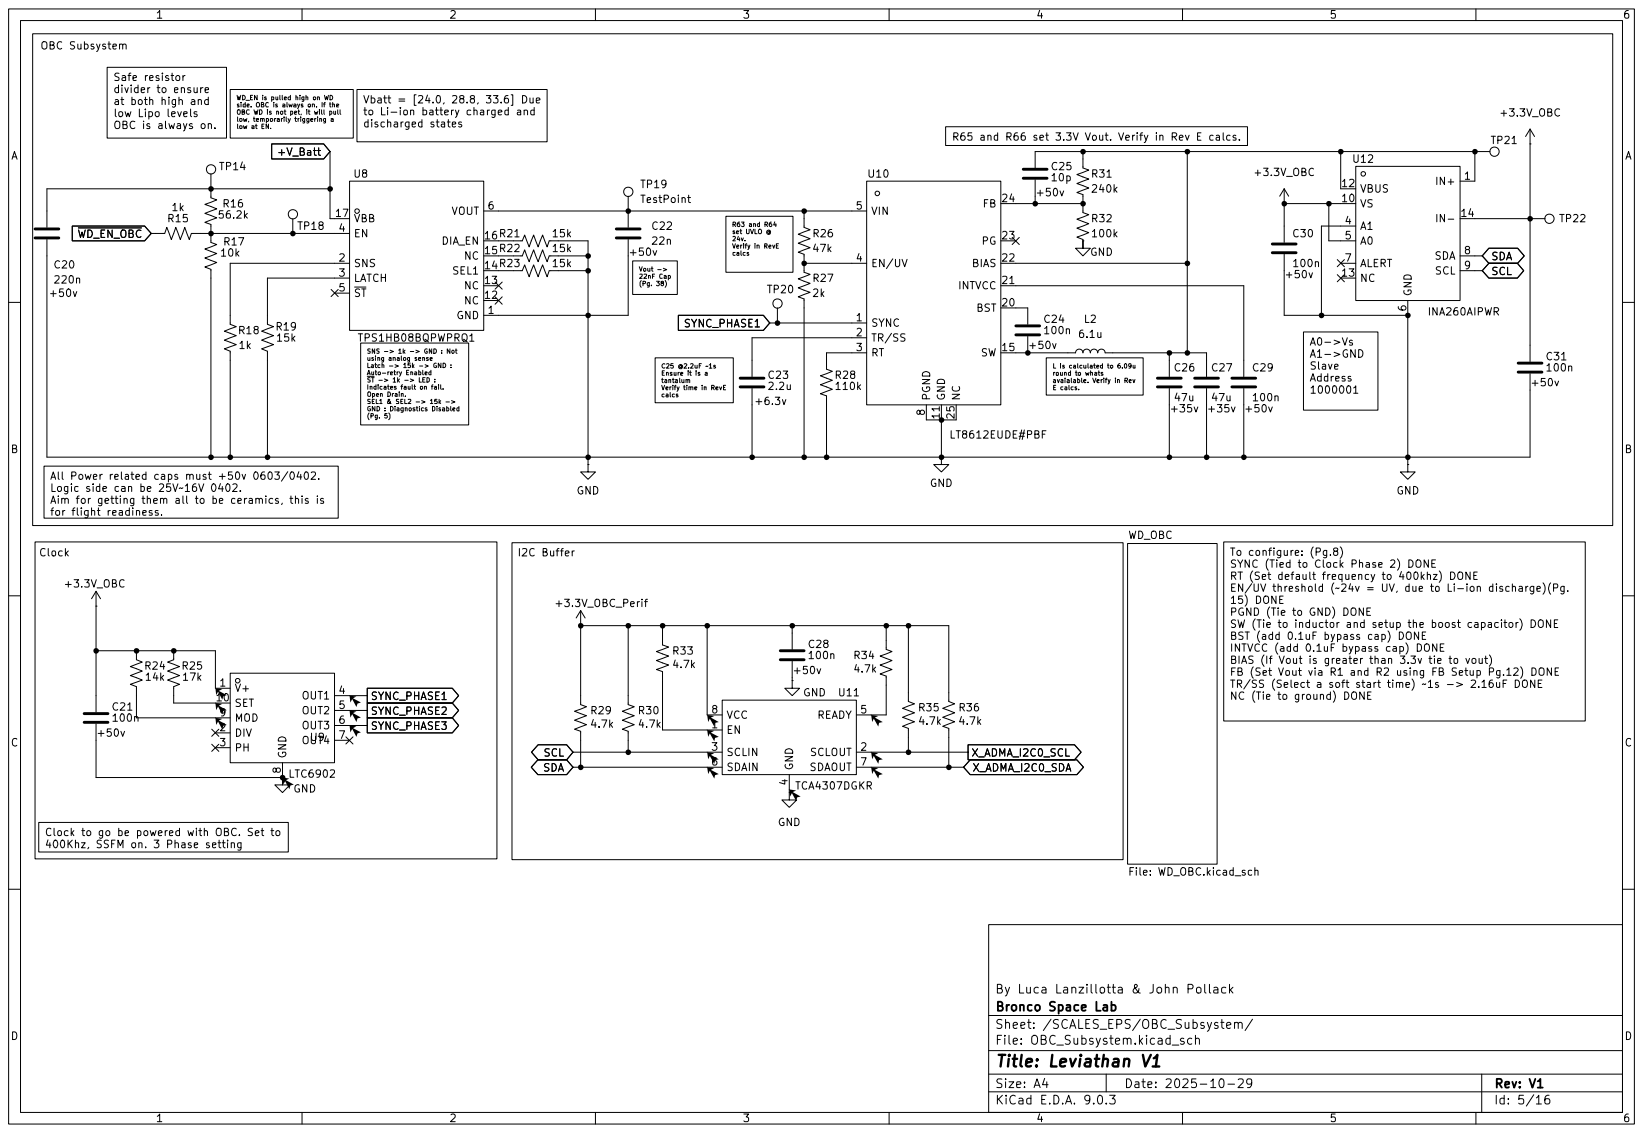
[picture p154: page 5]

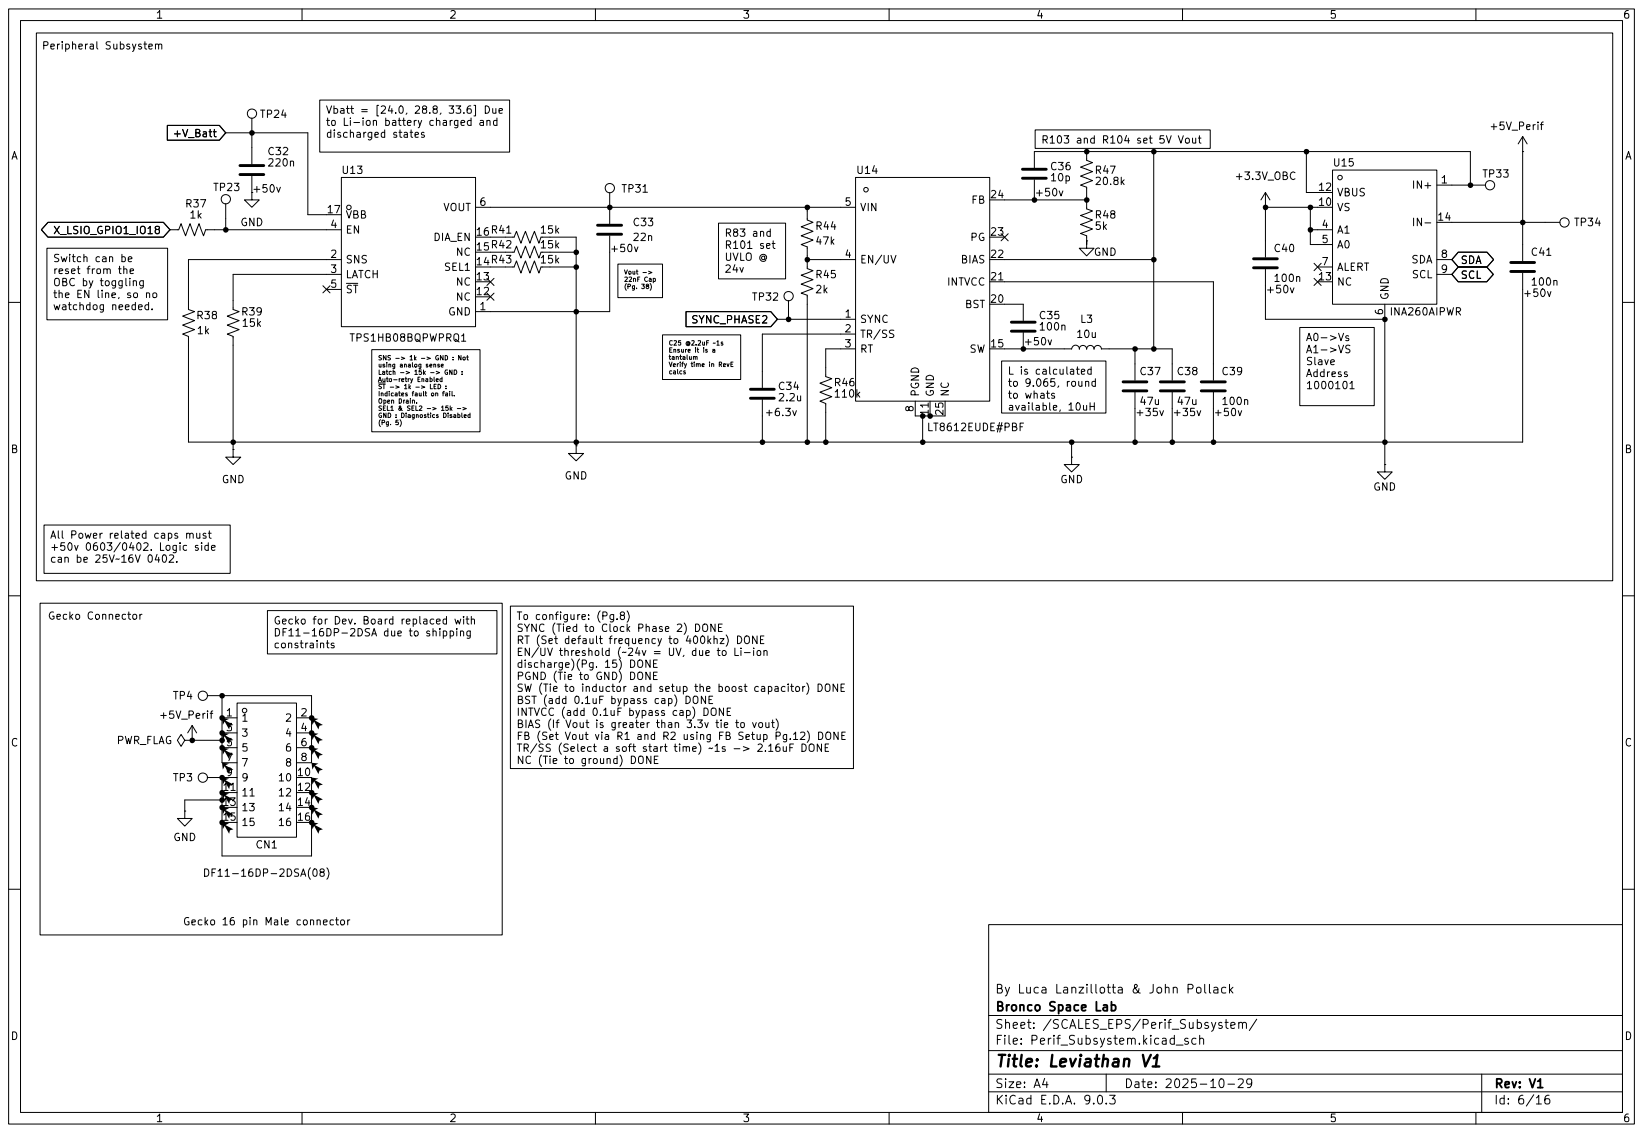
[picture p155: page 6]

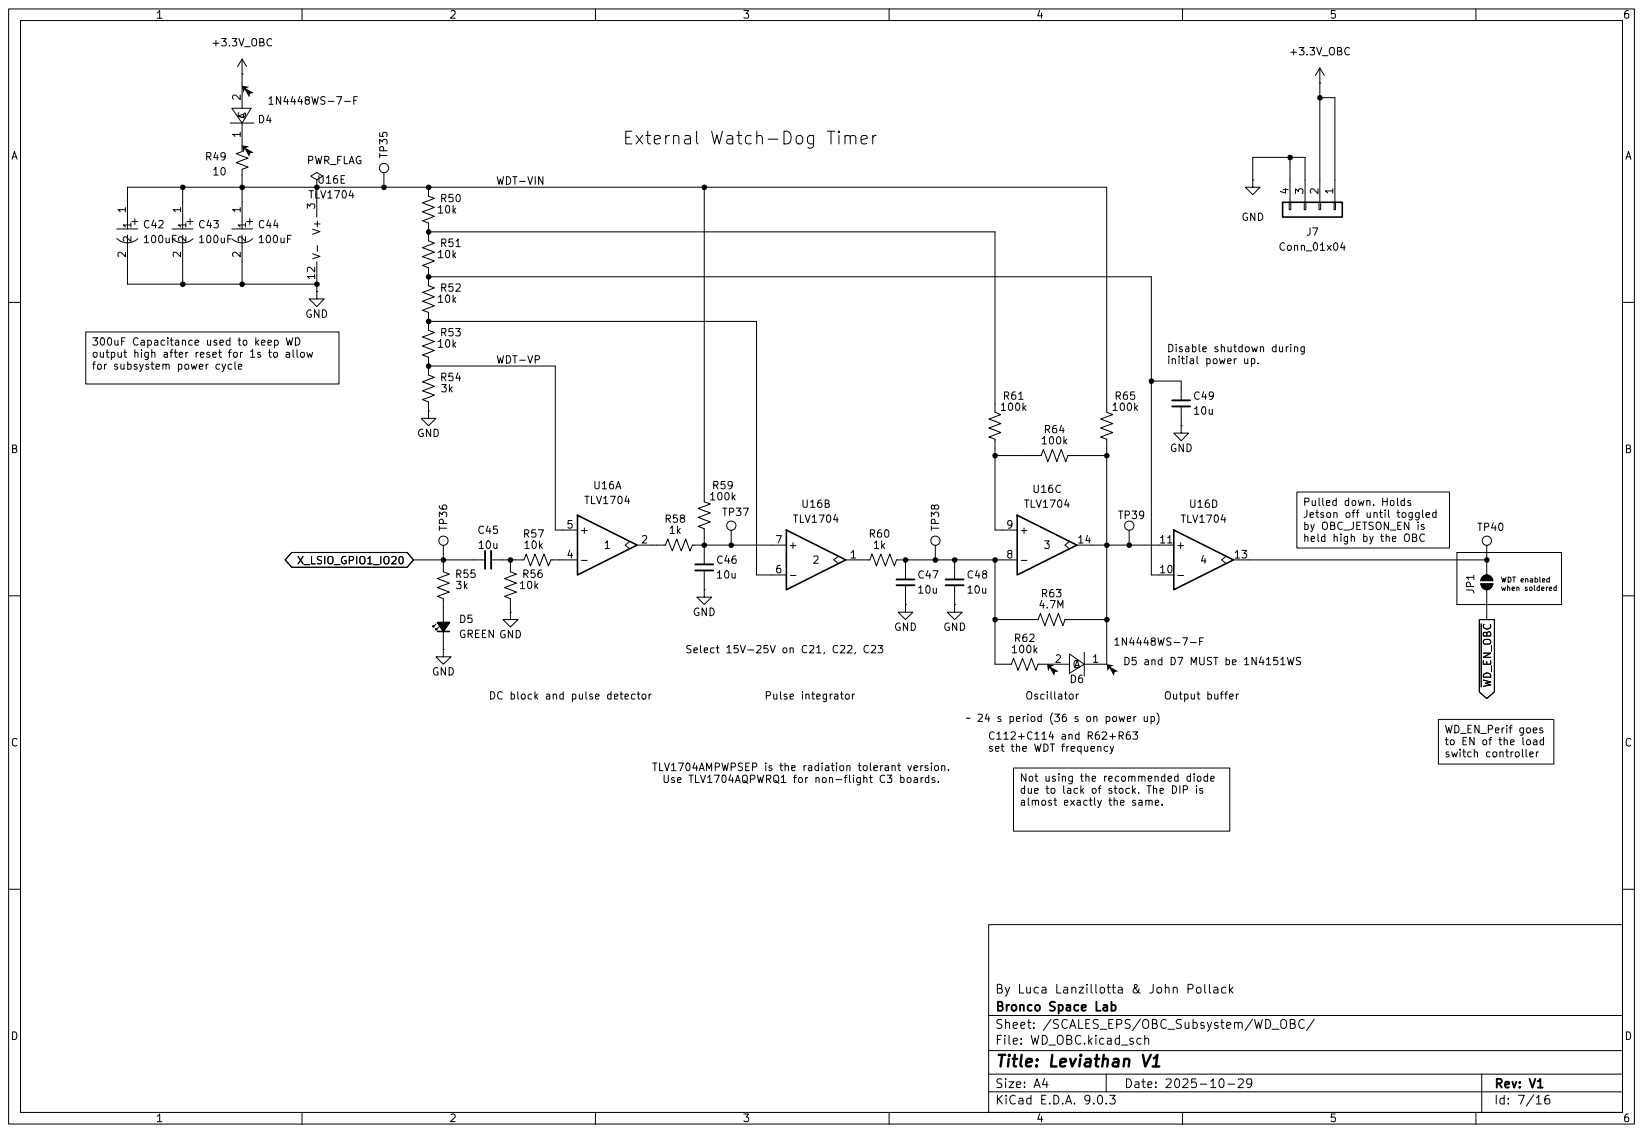
[picture p156: page 7]

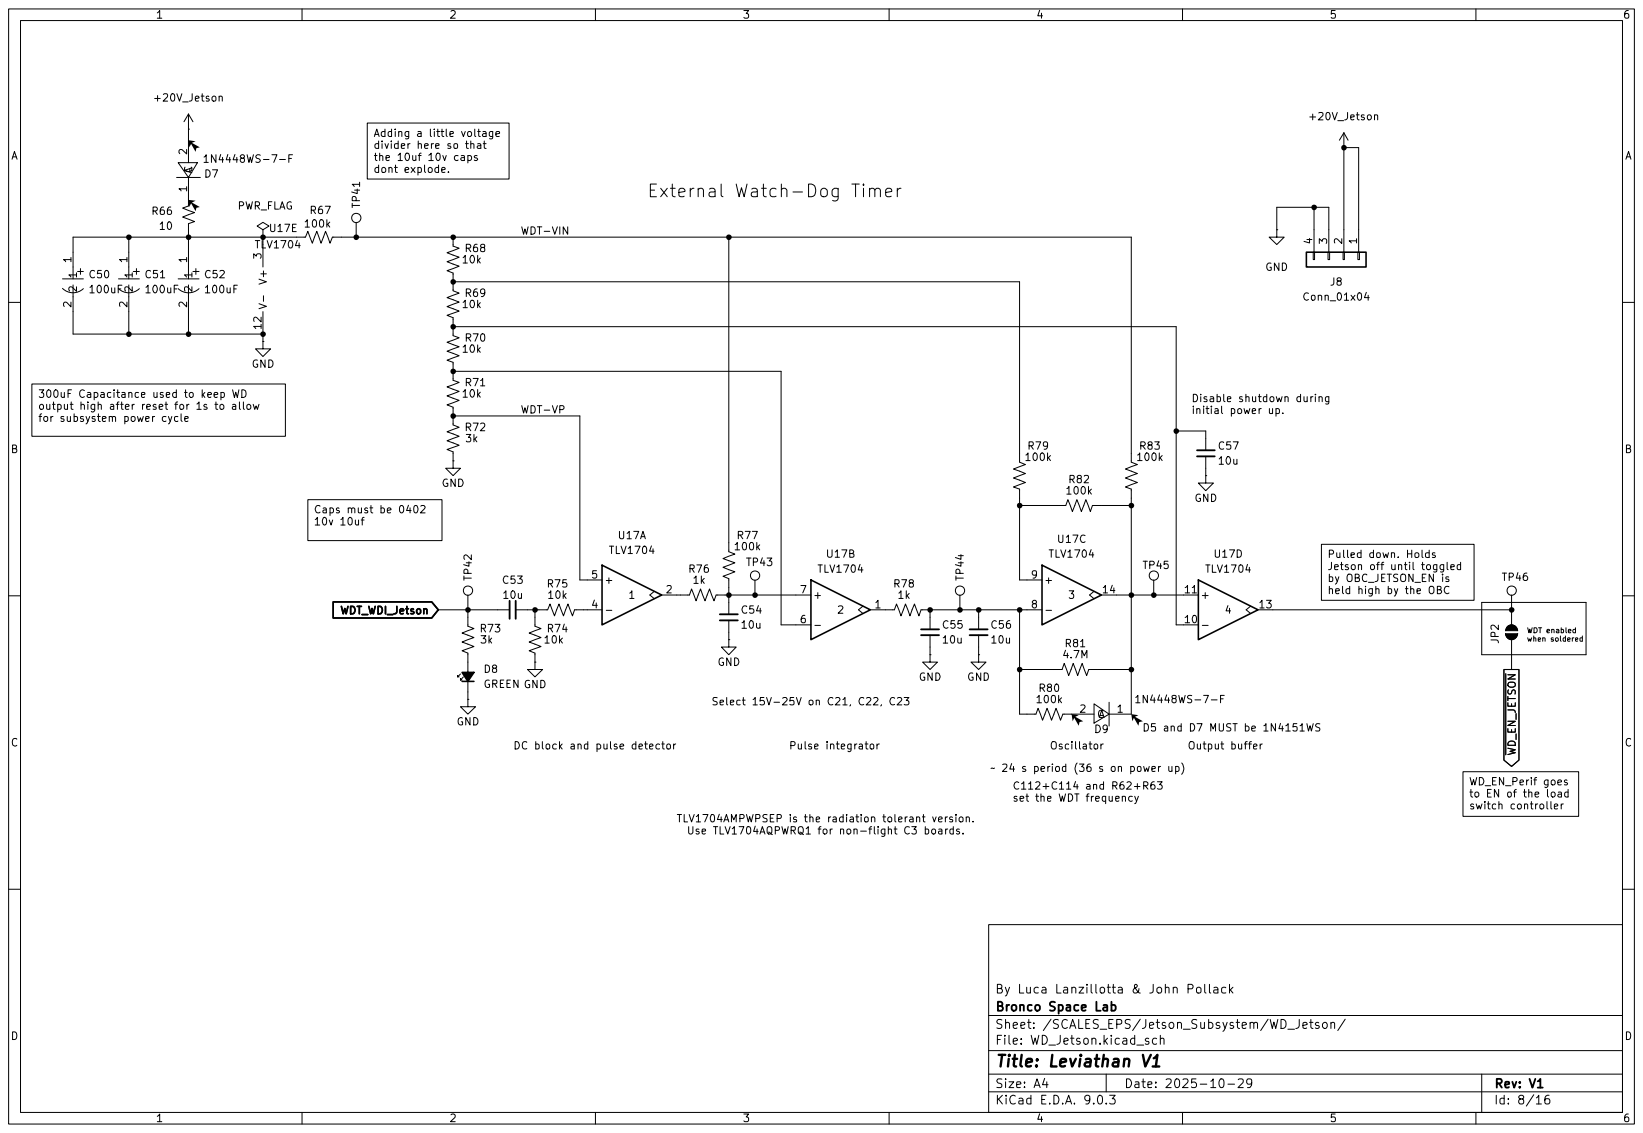
[picture p157: page 8]

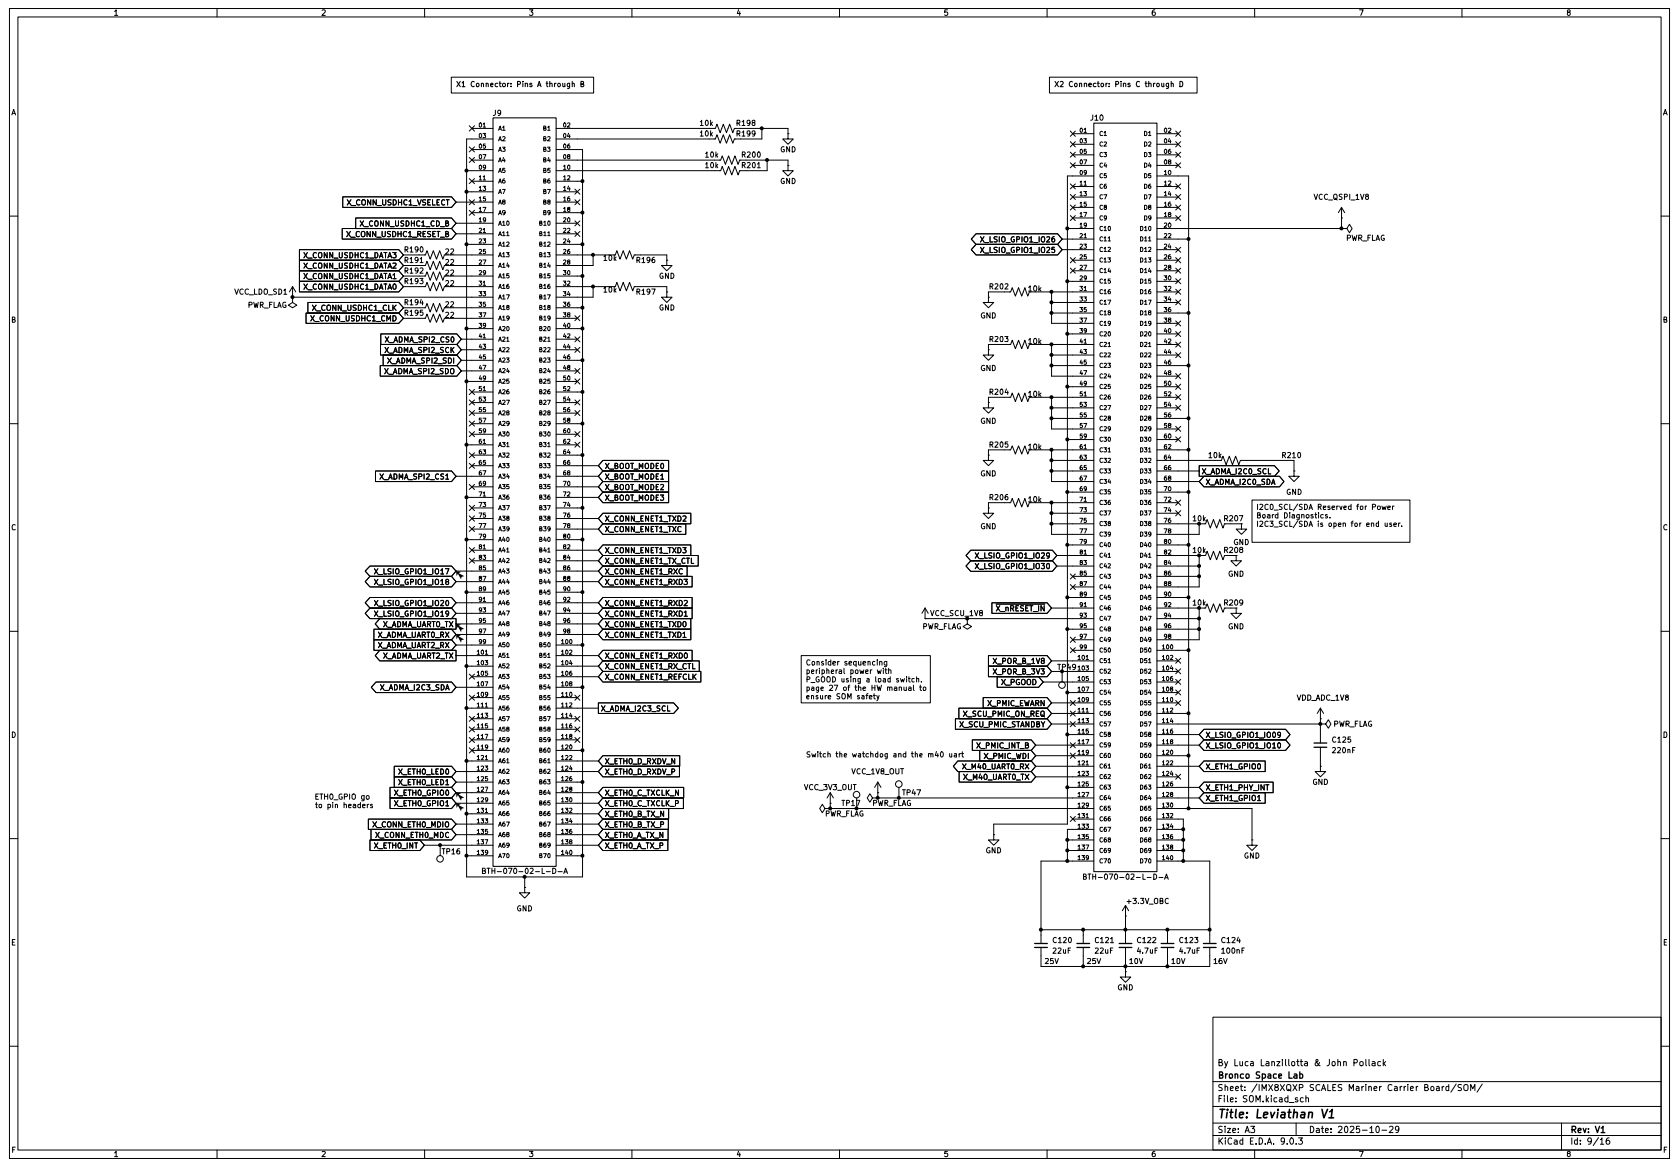
[picture p158: page 9]

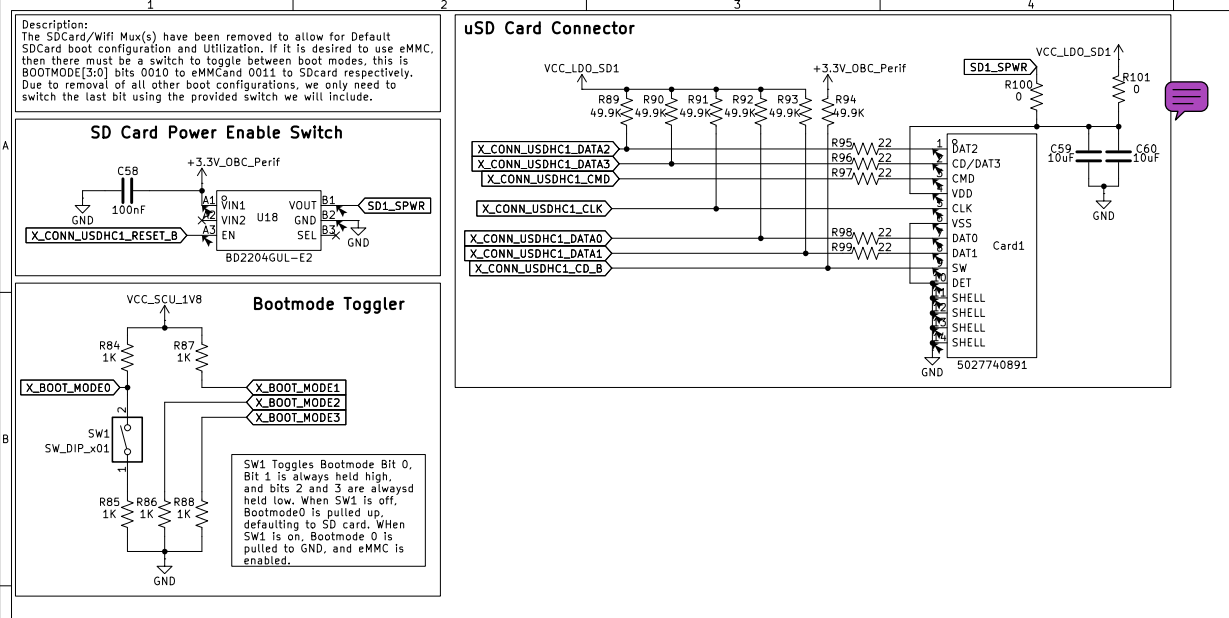
[picture p159: page 10]

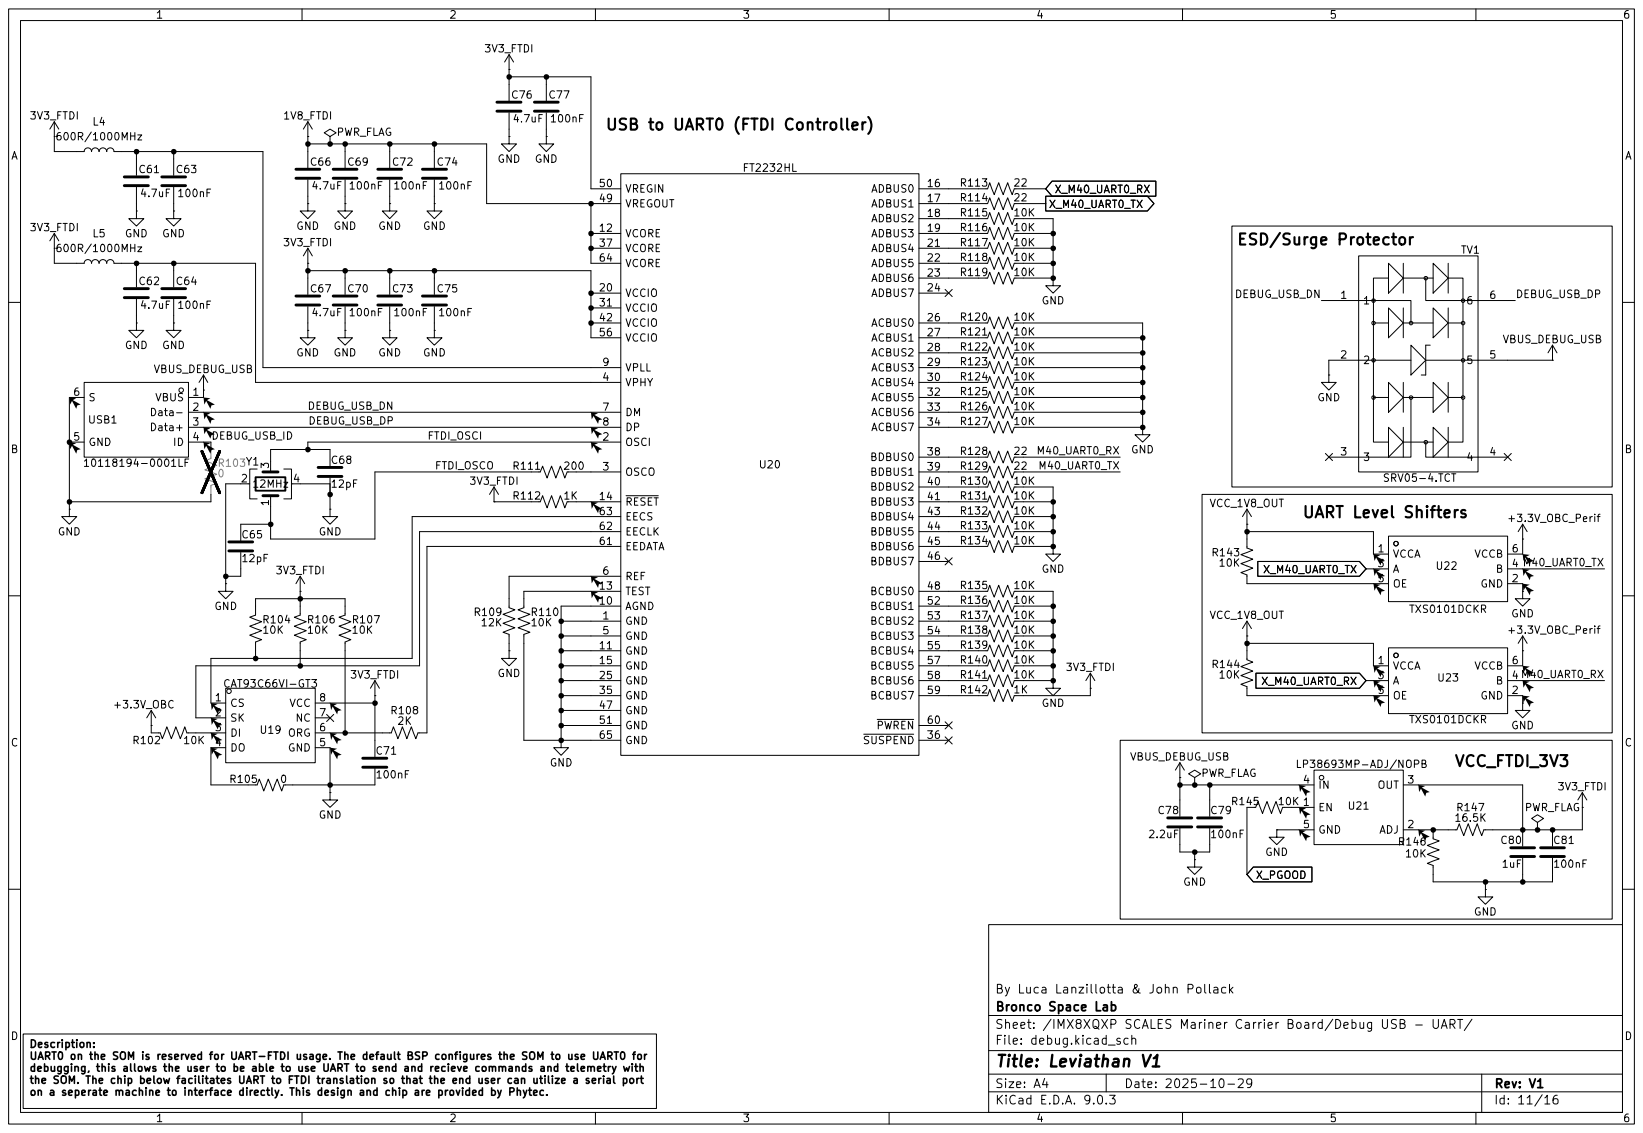
[picture p160: page 11]

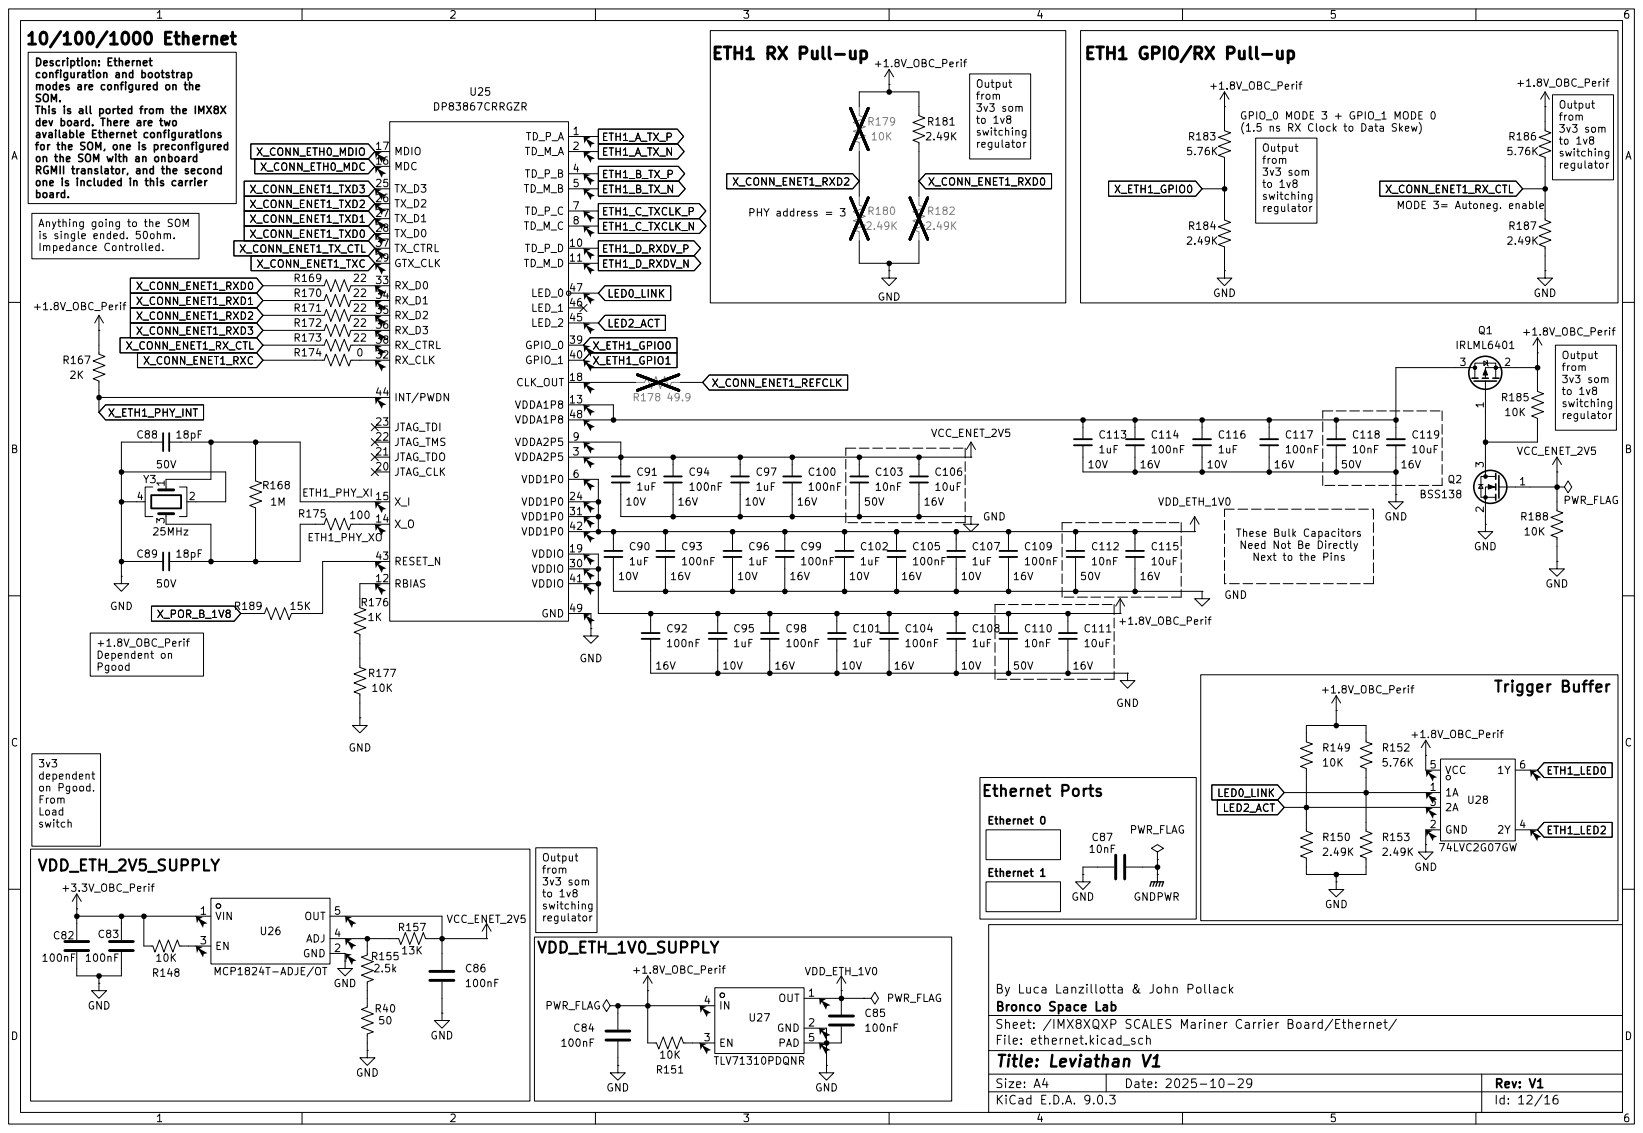
[picture p161: page 12]

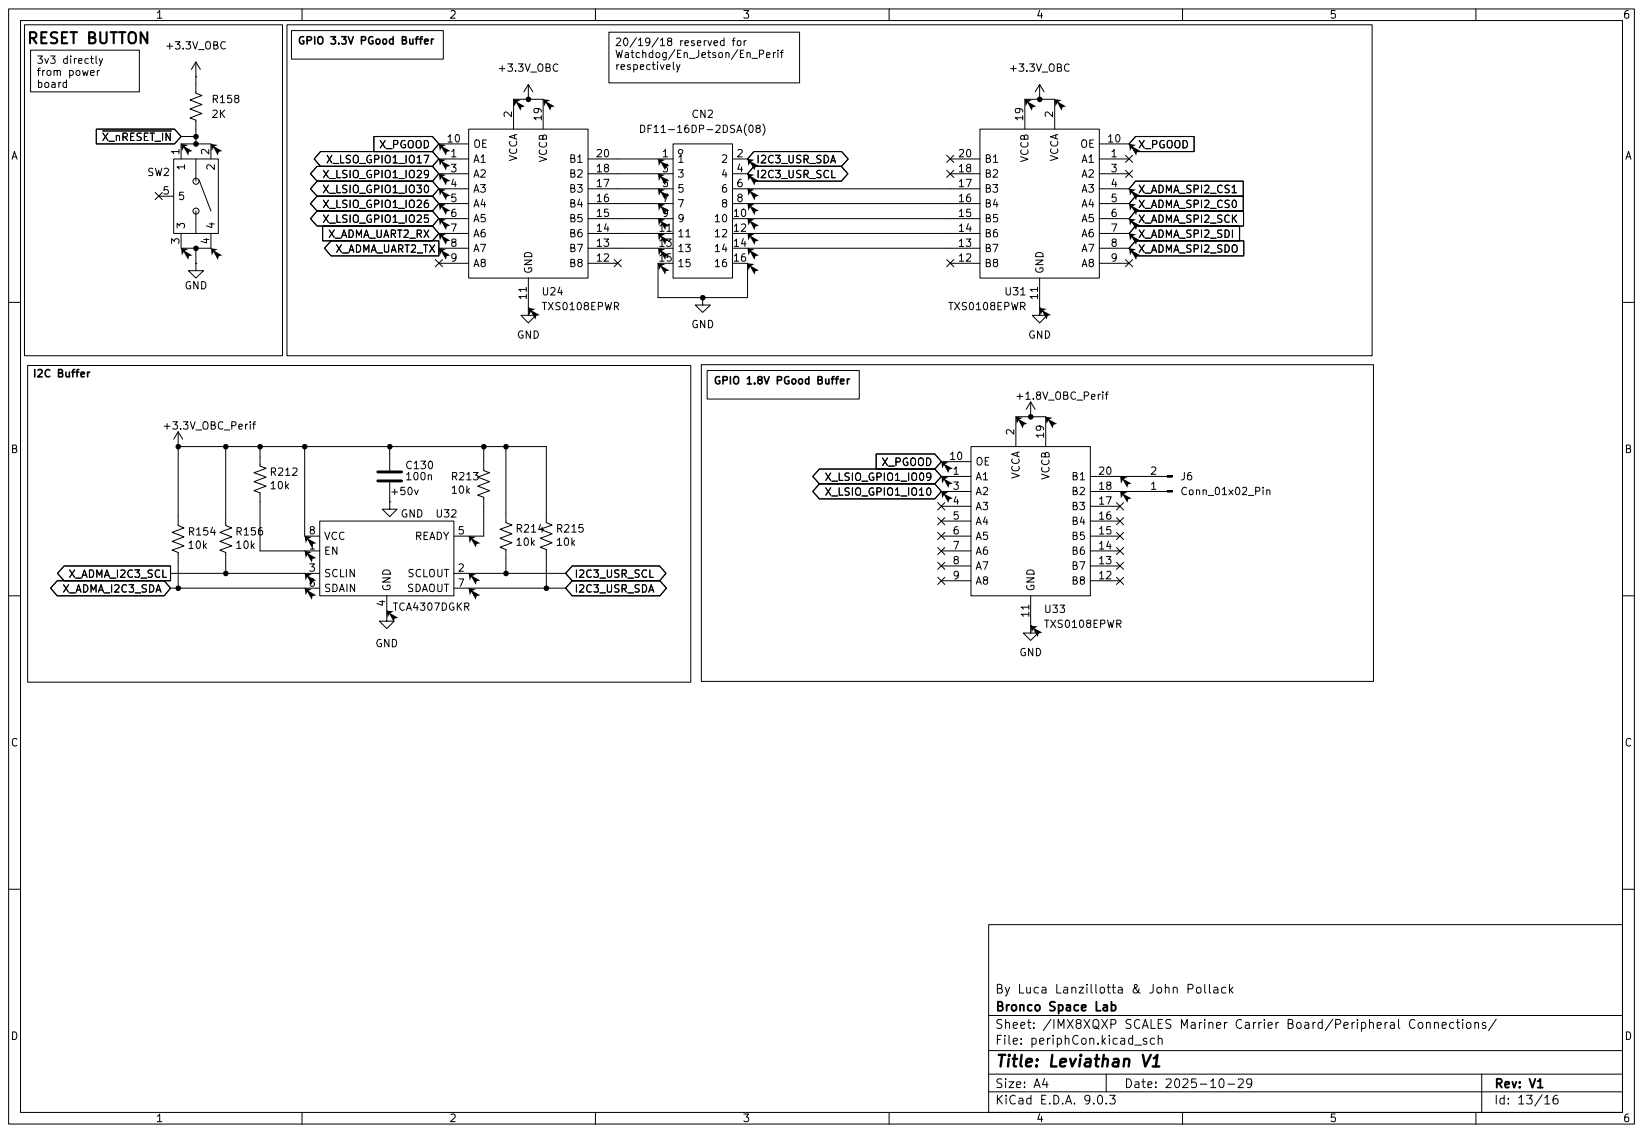
[picture p162: page 13]

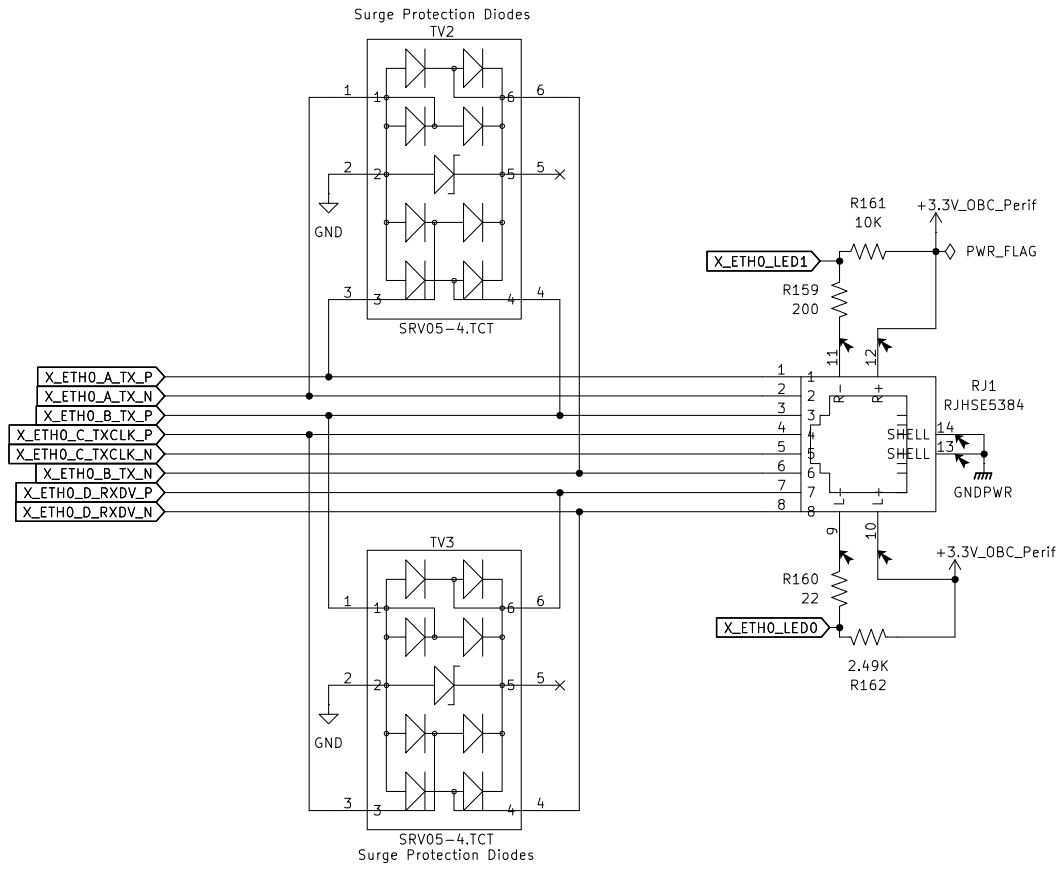
[picture p163: page 14]

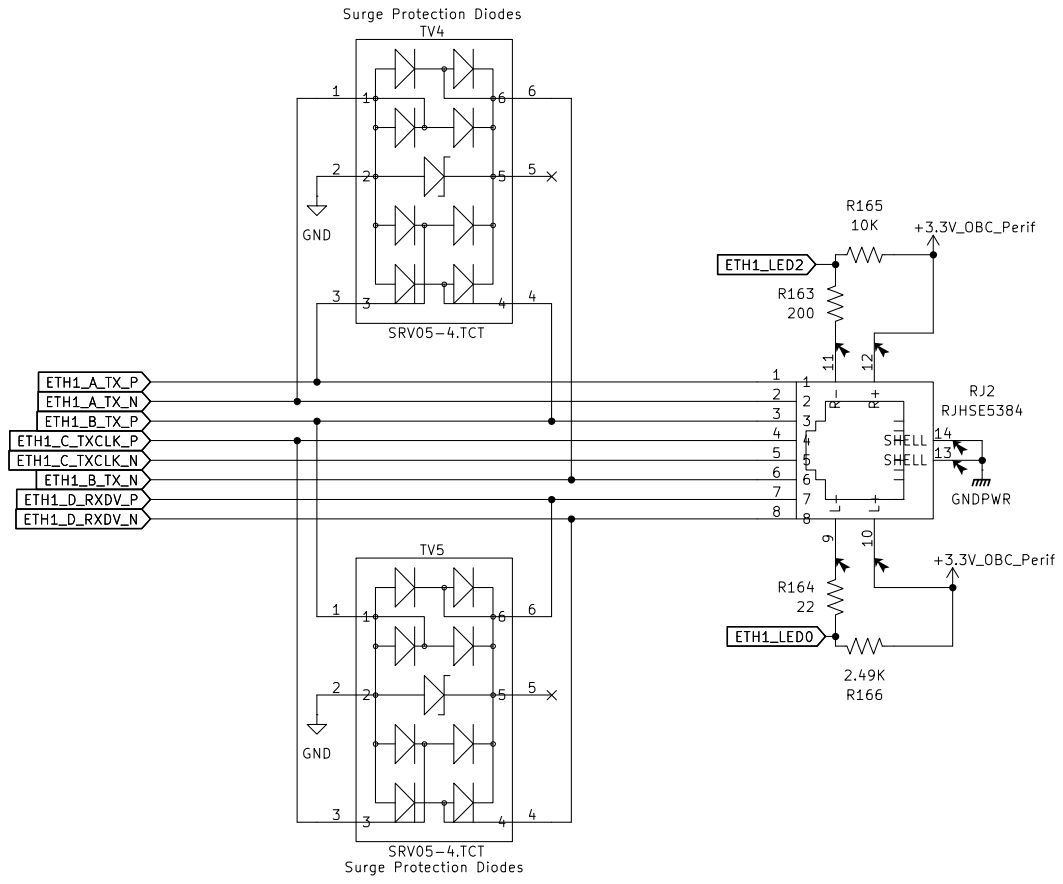
[picture p164: page 15]

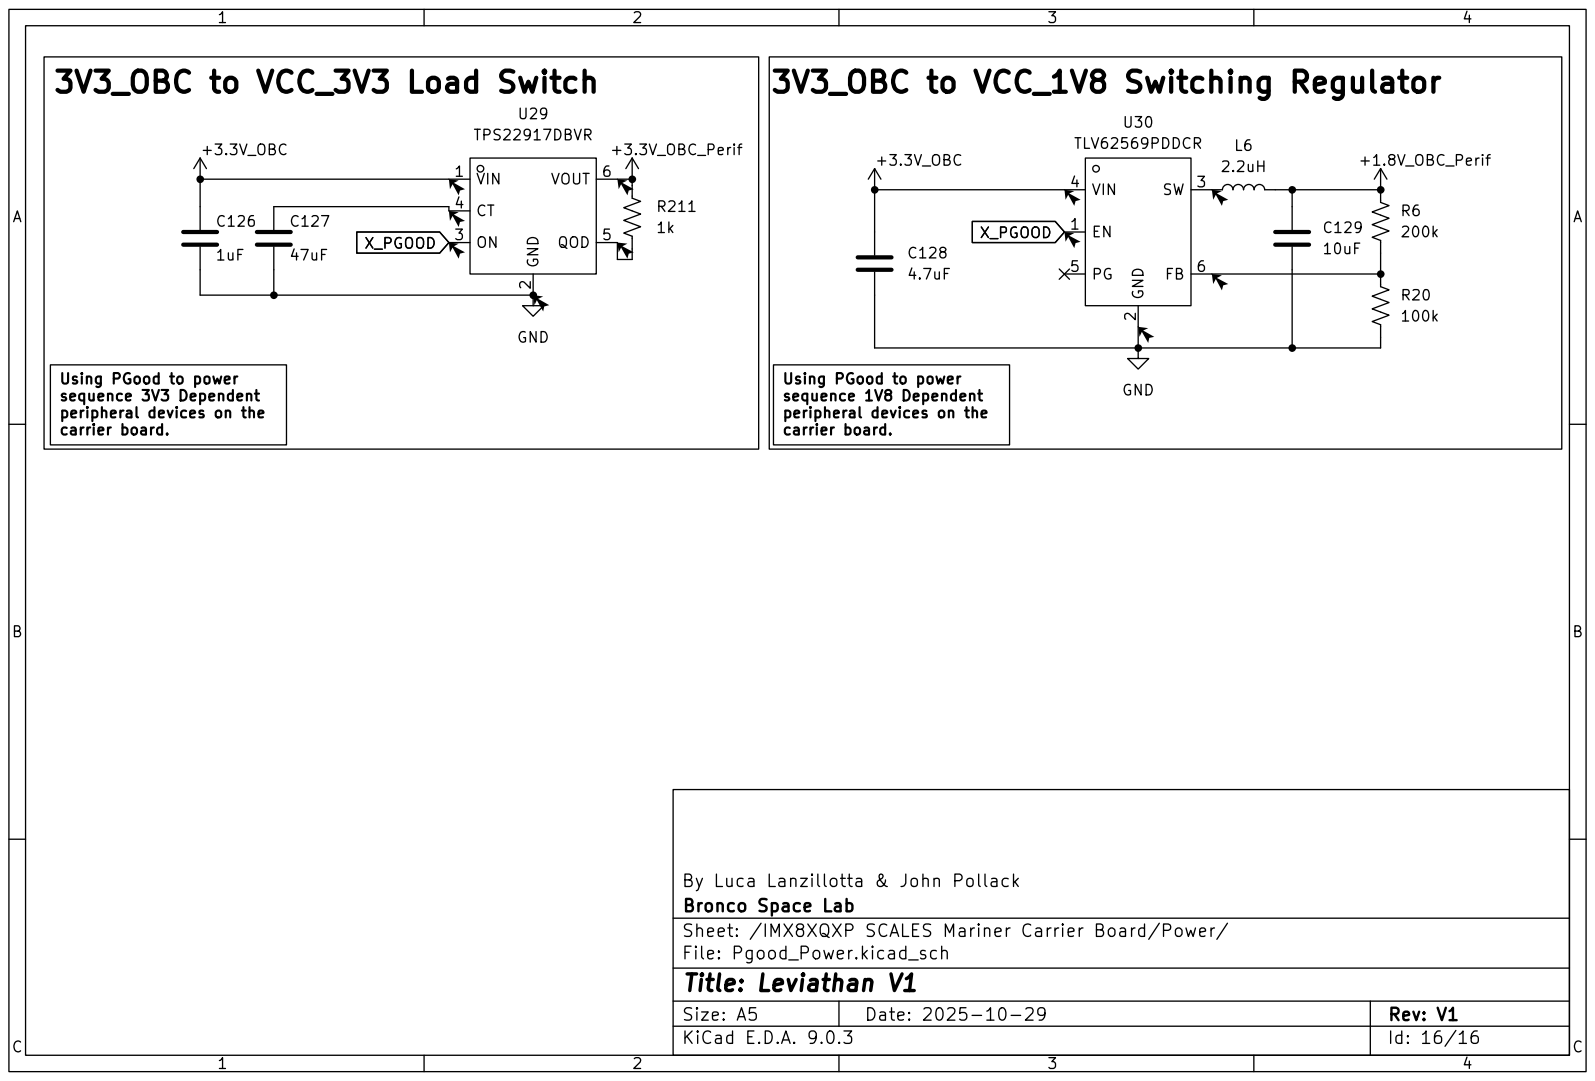
[picture p165: page 16]
