BroncoSpace-Lab/scales-hardware/imx8x_eps_leviathan_v2/reviews/revision reviews/imx8x_leviathan_v2_reviewed_dsmith.pdf

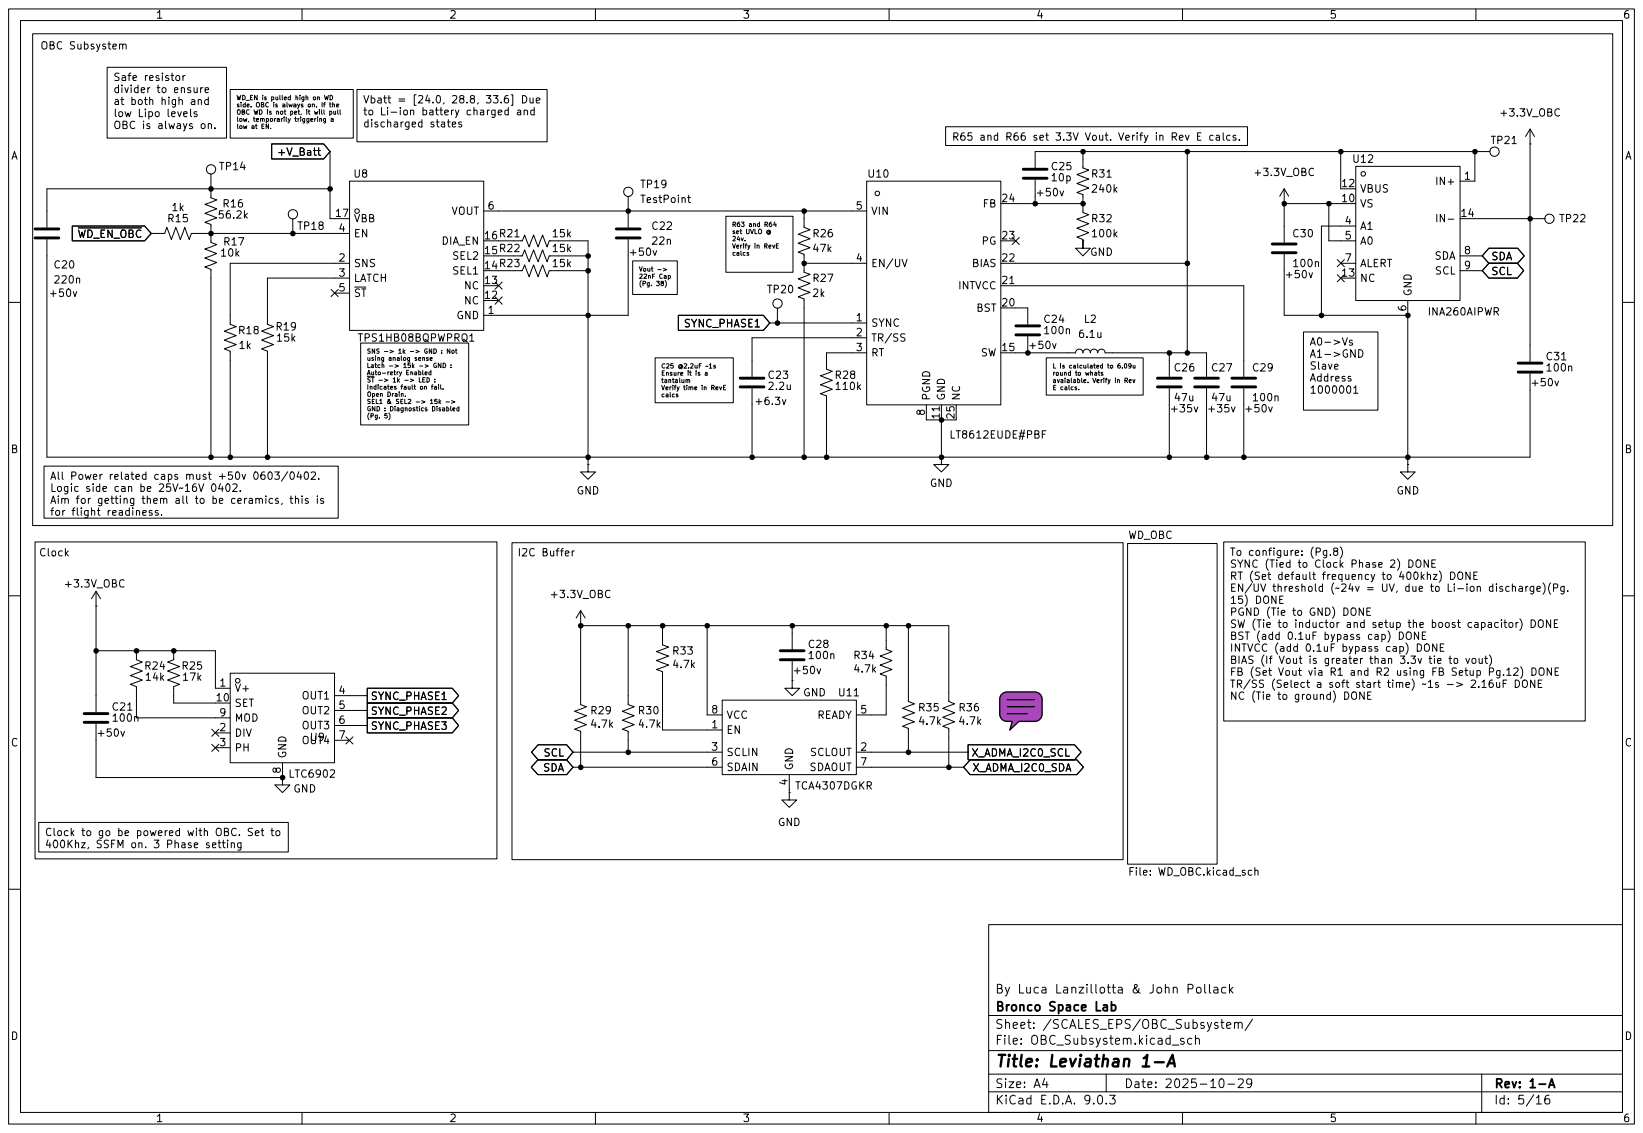
[picture p166: page 5]




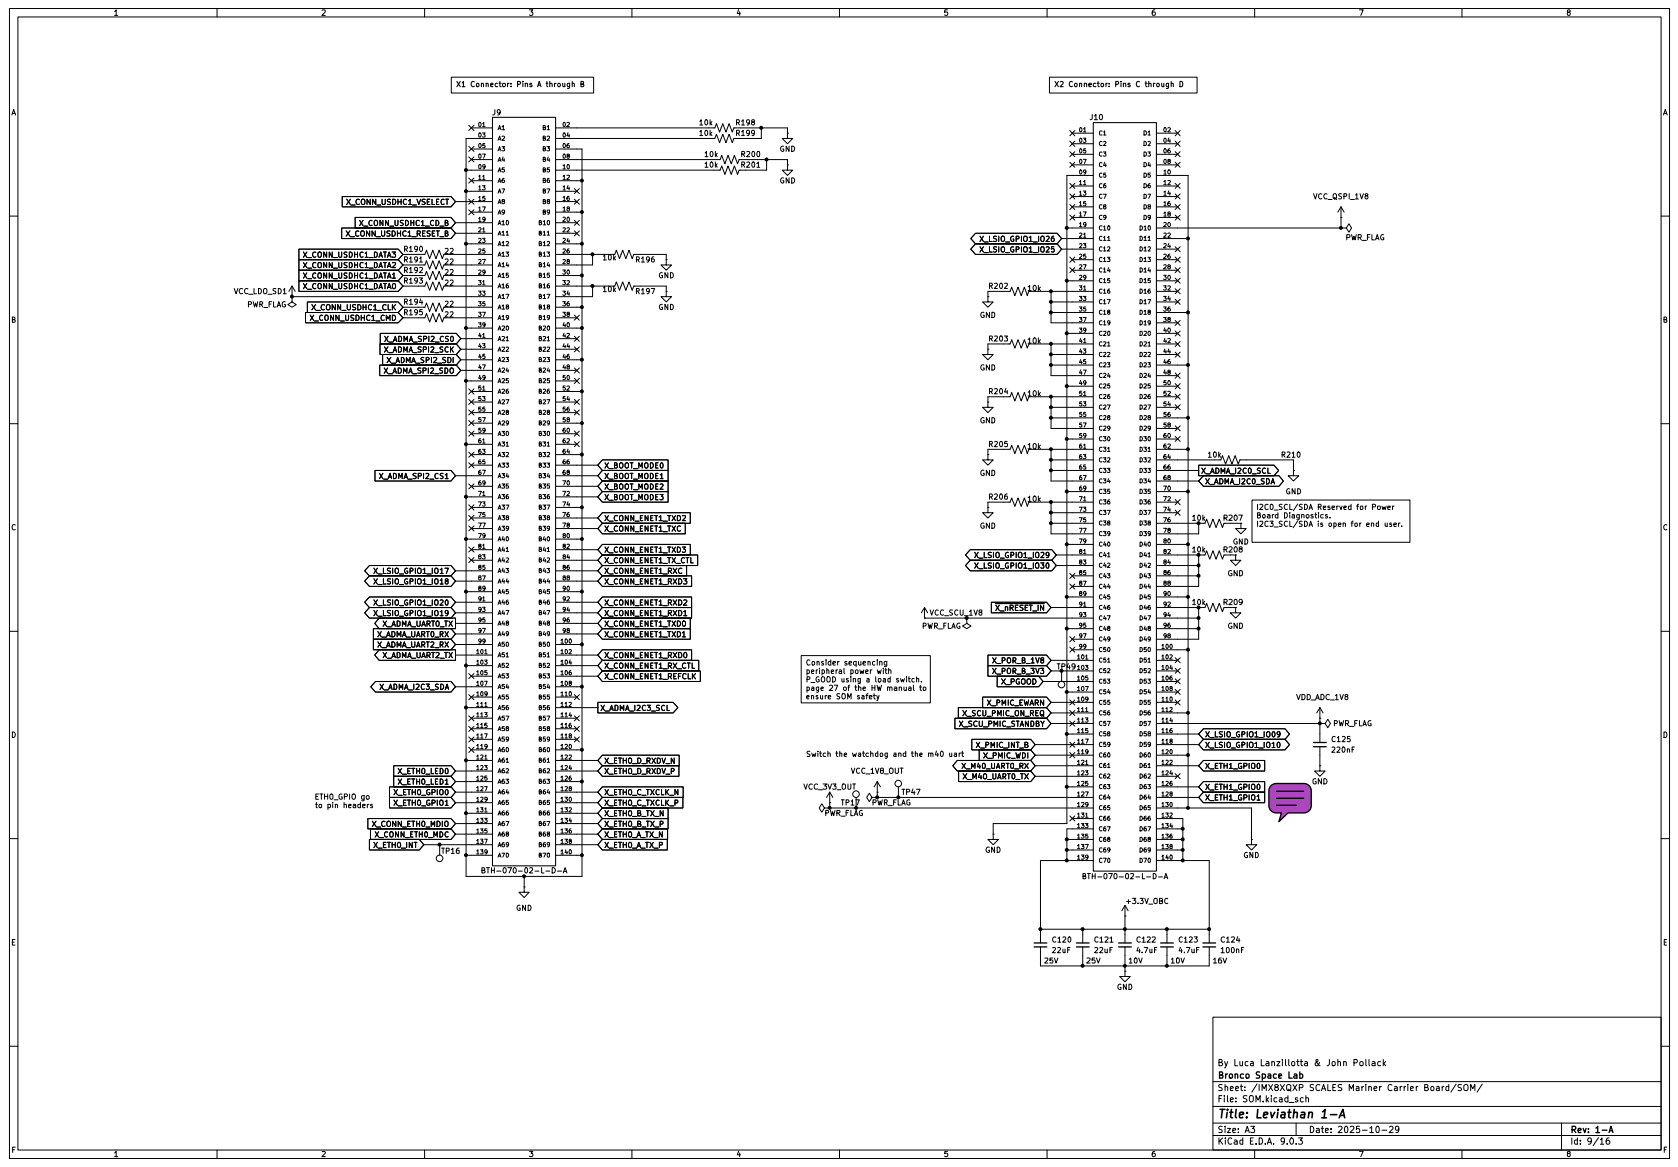
[picture p167: page 9]

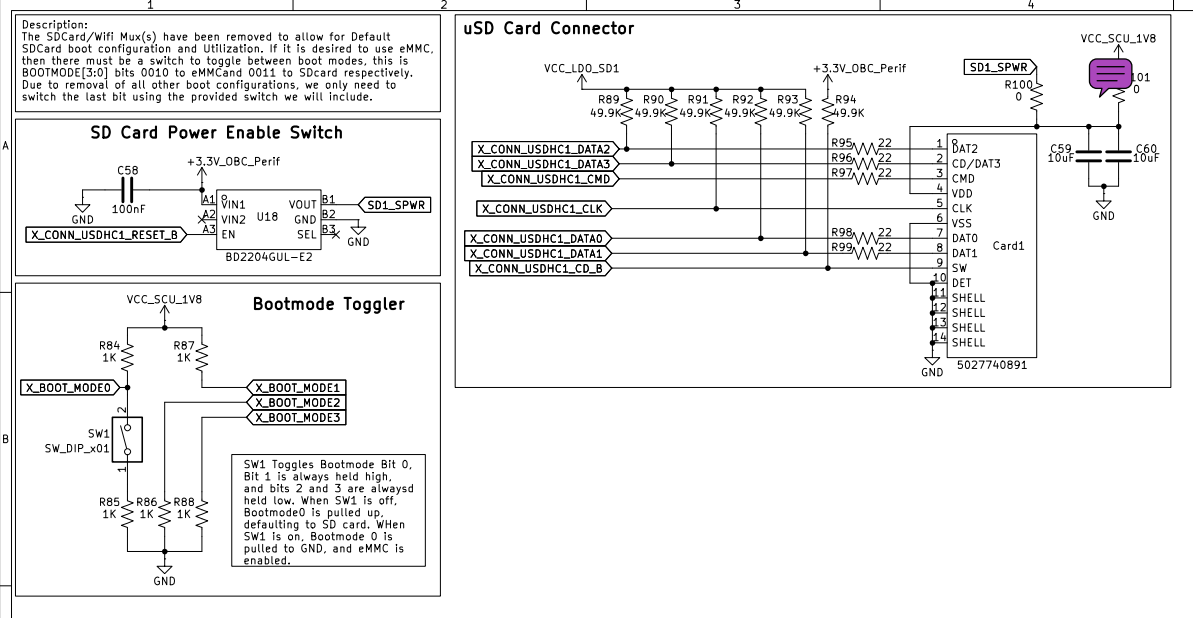
[picture p168: page 10]
