BroncoSpace-Lab/scales-hardware/imx8x_eps_leviathan_v2/reviews/revision reviews/imx8x_leviathan_v3.pdf

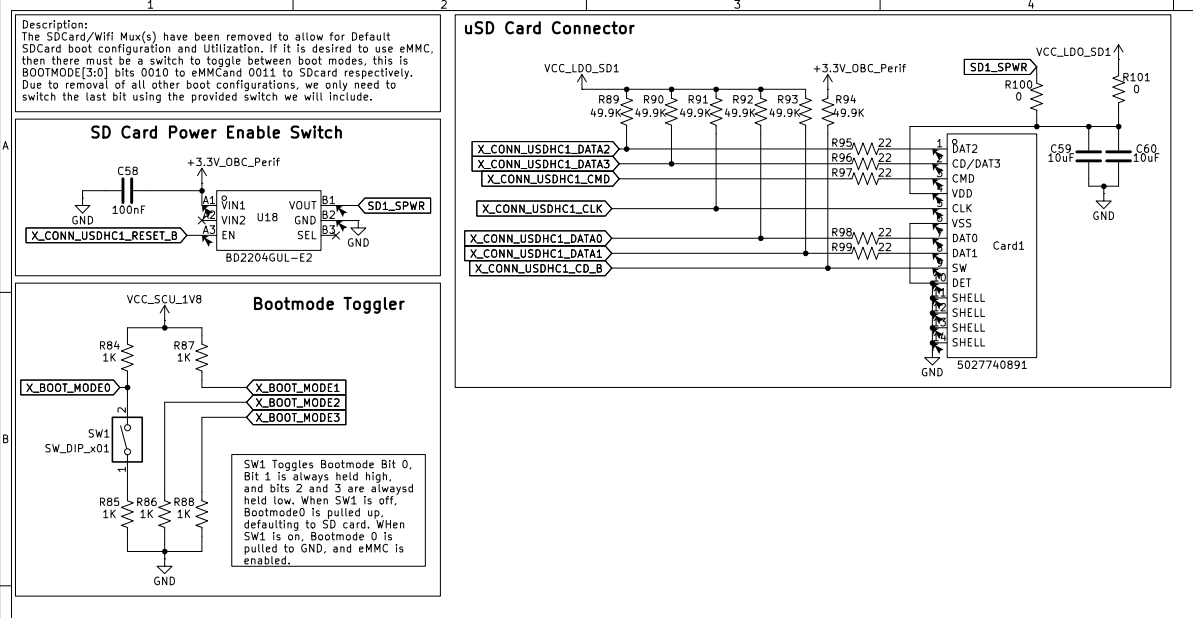
[picture p169: page 10]
