BroncoSpace-Lab/scales-hardware/power_system/EPS_Calculations/Rev_D_calcs/Rev D Calcs.pdf

| | m | esetsbefauttfremncym.tn | Euv gtguderpHgecutof
1fifIii f | c iff

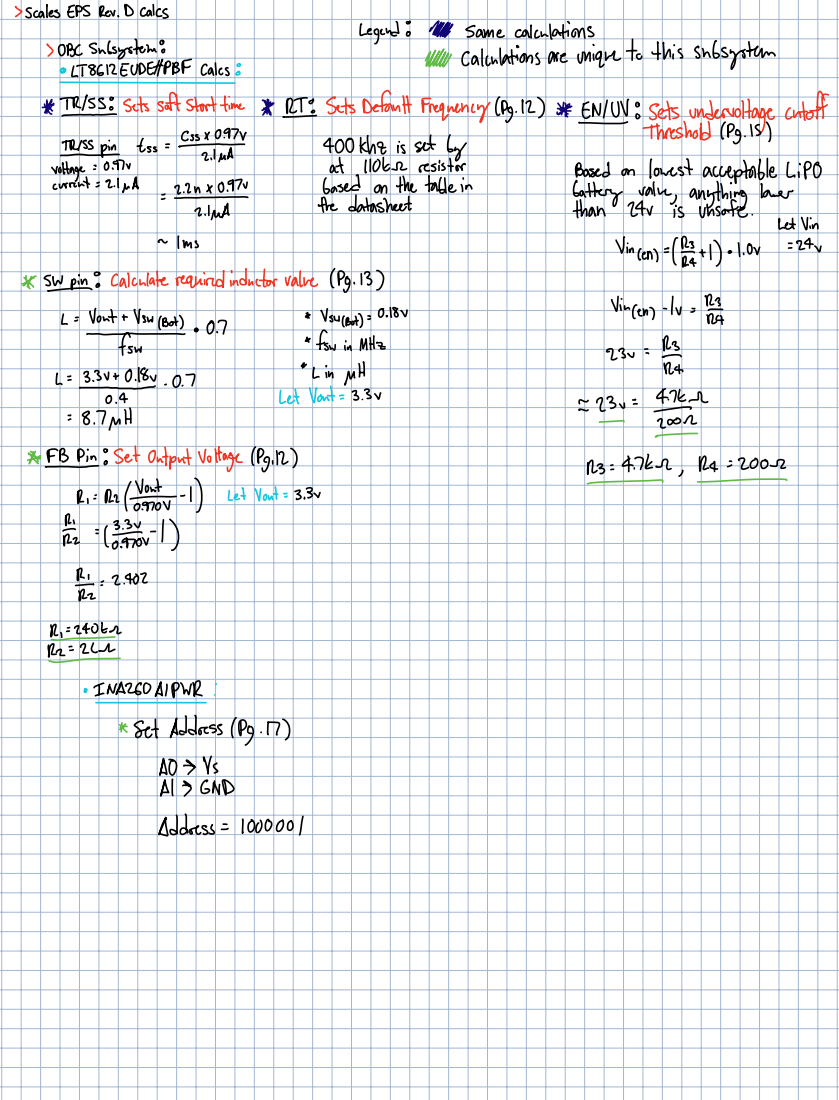
[picture p170: page 1]
ScalesEPSRevDcalcs; Vincent to t.vn; th Ire.n; Left.ittsv-; nr6oAIPWR

Legend | im samecalculations

OBCSubsystem | LT86I2EUDEHPBFcalcs | Mtcalculationsareuniquetothissubsystem

Fin | Basedon lowestacceptableLipo

fE ftp.adfn

ft | | | EEraimsmatstie.hr
1ms | | | | | Vincen | ftp.t.ov | 2Yu-

SWpin | calculaterequiredinductorvalue | | | Pg13

8.7MH | | | | | 111
Erin | | SetOutputVoltagePg.tl | | | nfkr | | 1452001
R | Rr | 1 | LetVont 3.30
B oil

SetAddressPg¹⁷
AO | Vs
AI | GND

Address | | | 1000001

inIgf | ffgm c
| | ffs¹f.hnheffnFin | Ettaftp.smatstif.hr Basedon lowestacceptableLipo contain.IOftt

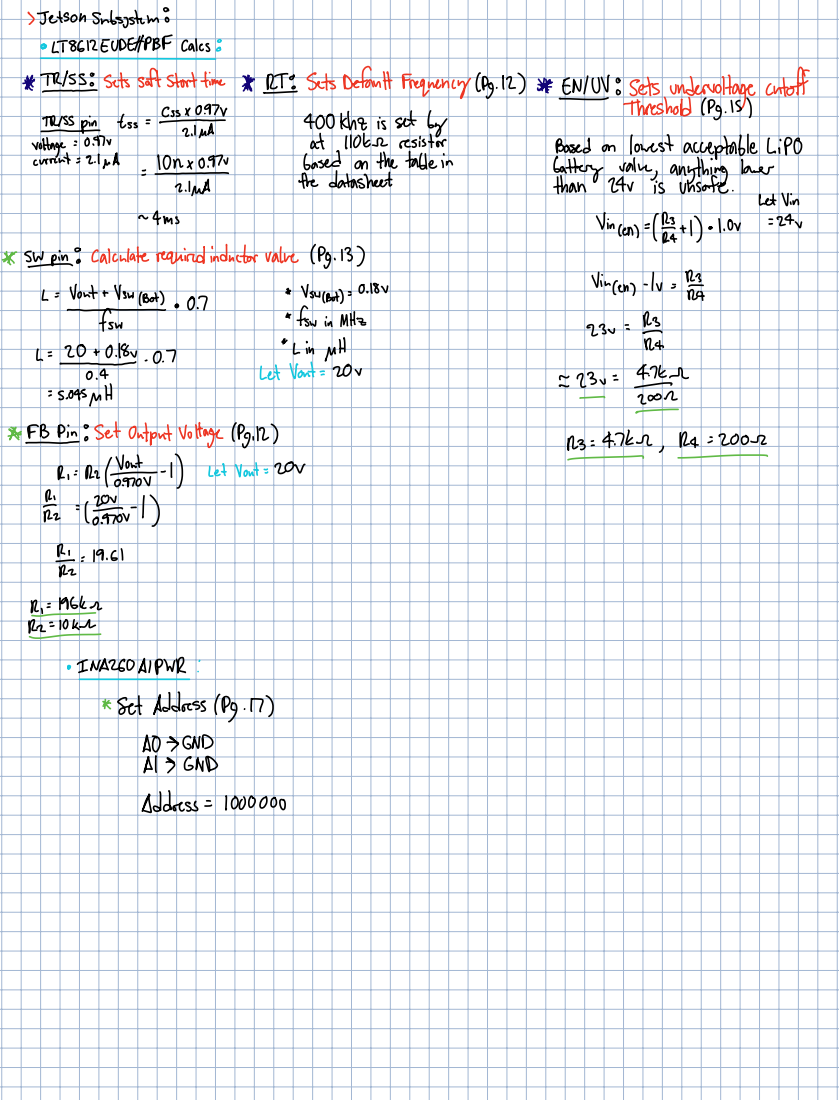
[picture p171: page 2]
JetsonSubsystem; wagonPWR; Address

LT86IZEUDEHPBFcalcs5-1 | | setsbefautfremenco.rs | Euv gtguderpg.tgecutoff

calculaterequiredinductor2Yvalue | | I | Pg13vsWpin Vincent | if | 230 | 11 | to t.vn | th Ire.n

4ms | | | | Vincen | | Matt | | io

cett.ittou-

EBPin SetOutputVoltage Py.l2 | | | | | | Rehr | | 42001
R | Rr | 1 | LetVont 200
Fiorl

SetAddress Pg17
TEEB

## intimates

| setsbefntremn.mn | EuvEntguidepg1agcntoff

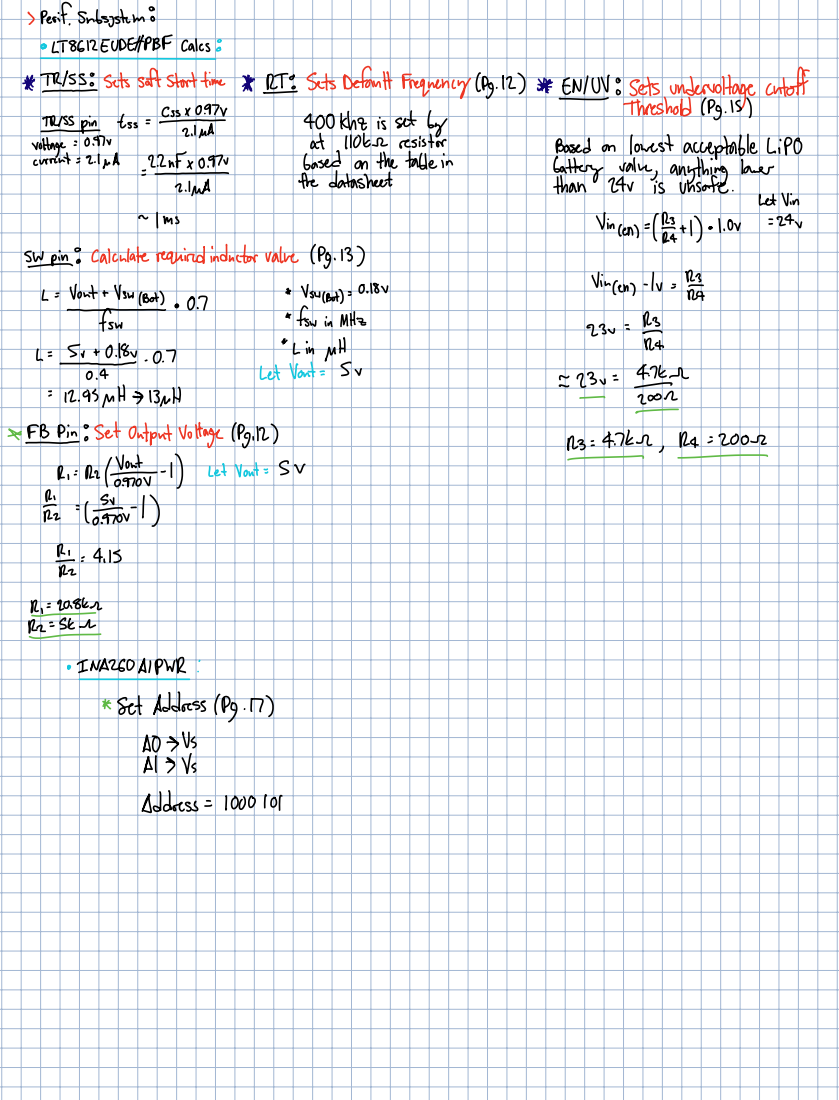
[picture p172: page 3]
Vincent; th Ire.n; Letto; INA26OAIPWR; Address

if.LI Iiii ffIq

911gÉhIFin | Basedon lowestacceptableLipo
1 | Ettaftp.matshif.hr

1ms | | Vincen | Matt | lion

supine | calculaterequiredinductorvalue | | Pg13

13mA | | | | FEI ¹².45MH

Ein | | SetOutputVoltagePg.tl | | | | after | | 42001
R | Rr | | 1 | LetVont 200
Earl

SetAddress Pg17
REEB
