BroncoSpace-Lab/scales-hardware/power_system/EPS_Calculations/Rev_B_calcs/LTC6902 Clock Component Calculations.pdf

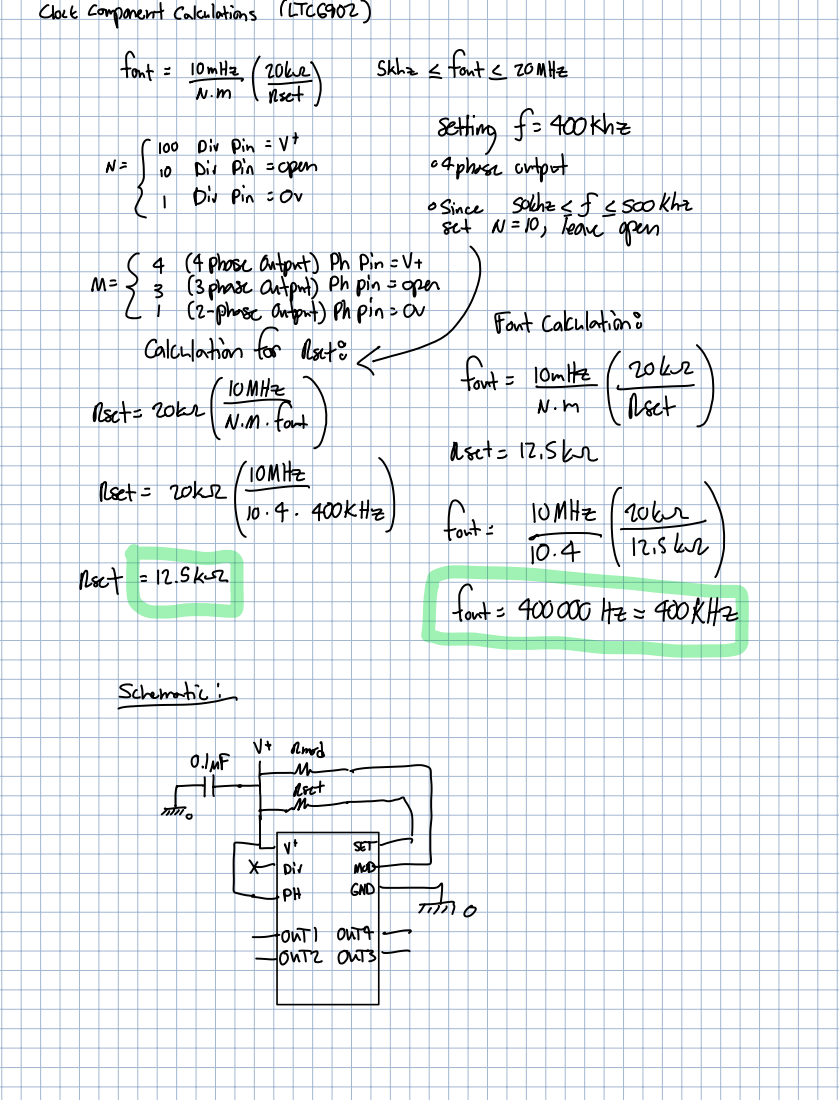
[picture p173: page 1]
Clockcomponentcalculations; LTC6902; Fontcalculation; Schematic

font | 121 | 24 | she | | font | 20MHz

setting | f | 400kHz

w | Bi Pii Yen | | | aphaseoutput

Since sothzsfssookhtsetN.IO leaveopen

calculationfor | rats
rsetszokrf.tn | | | | 1 | Esf fnt
2okr | Skrrset t took e

font

Rset | | 12
fat | | | 111 | 71

Rset | 12.5kt

font | 400000Hz | | | 400kHz
