BroncoSpace-Lab/scales-hardware/power_system/EPS_Calculations/Rev_B_calcs/LTC4365 UV and OV Thresholds for Subsystems.pdf

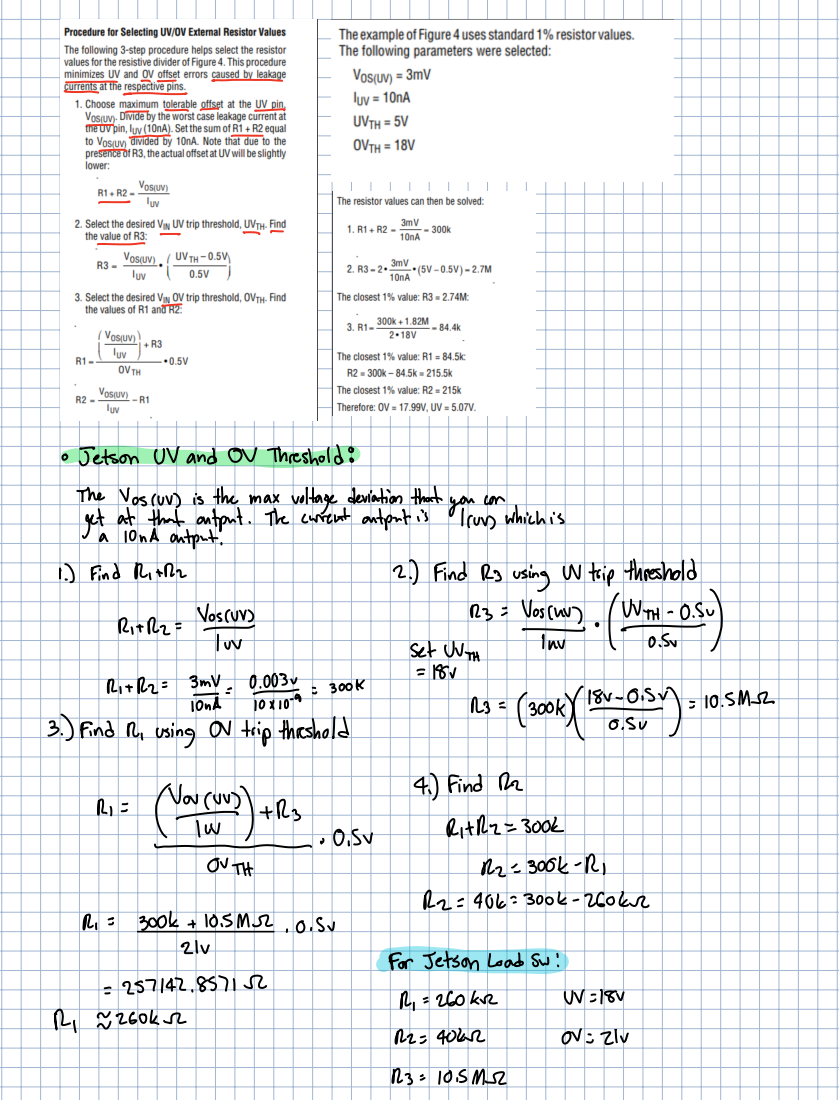
[picture p174: page 1]
Find; Rita; FindR3usingUVtripthreshold

JetsonUVand OVThreshold
YI ftp.inht.mIehetitiptthitrru5whichis

rare | | off | | | | why.fi | e

89th
13 | 300k | 1 | 5 | 10.5MR

RitR2 | | 37 | | 9,9 | s soon

3 | Find R usingOVtripthreshold

4 | Find | Dr
o.su | | Reason

R2 3004 | R
R2 | | 404 3006 26041

ForJetsonLoadSw

257142.857152 | | | | R | 260km | UV 8V
R | | 260hr

| | | | Yth

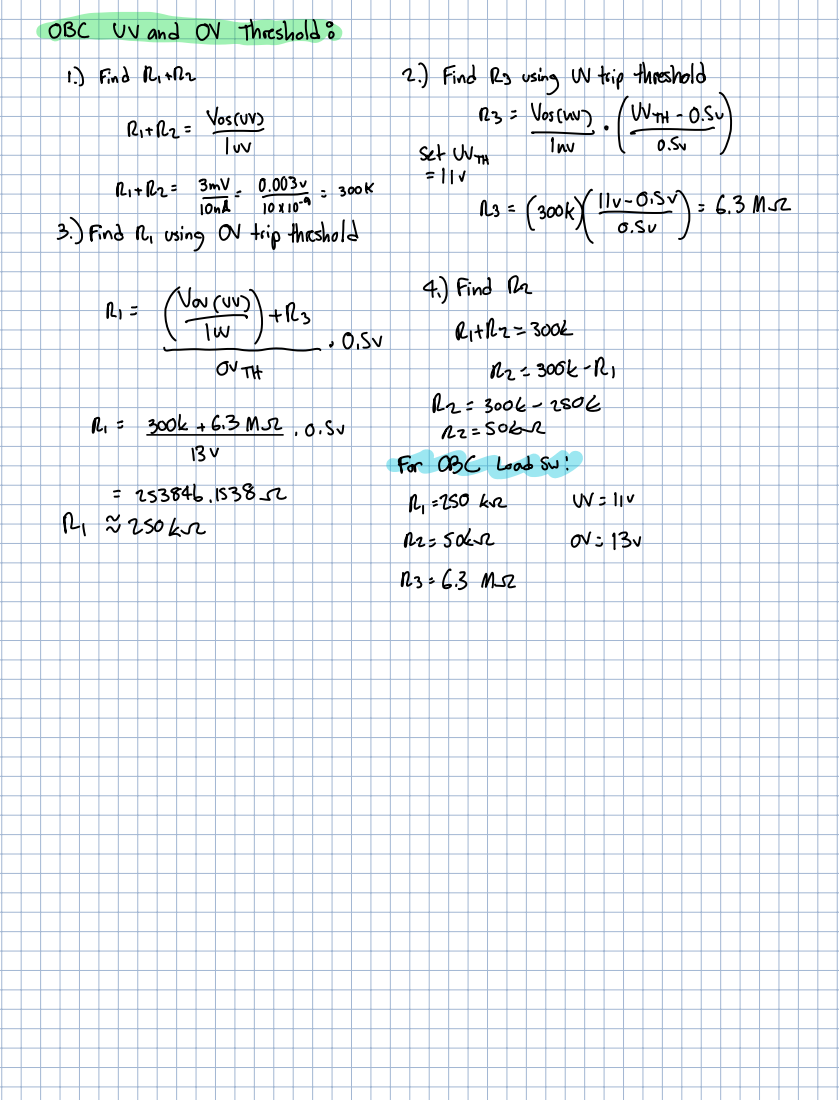
[picture p175: page 2]
Find R usingOVtripthreshold; Find; with

OBC | | | UVand OV Threshold

1 | Find | | Rita | 2 | FindR3usingUVtripthreshold
rare | | off | | | | VII | e

Rita | 324 99 | | soon | | 13 | 300k | | 6.3 Mr

R | N | h | o.su | Reason

R2 | 3004 | | R
R2 | 3006 | | | 2506

R | 0 s | | Rz | | SOER 3004,593Mt

for OBC loadSw

R2 SOER | | OV 130
13 | 6.3 Mr

| rare | | off | | | why.fr | e

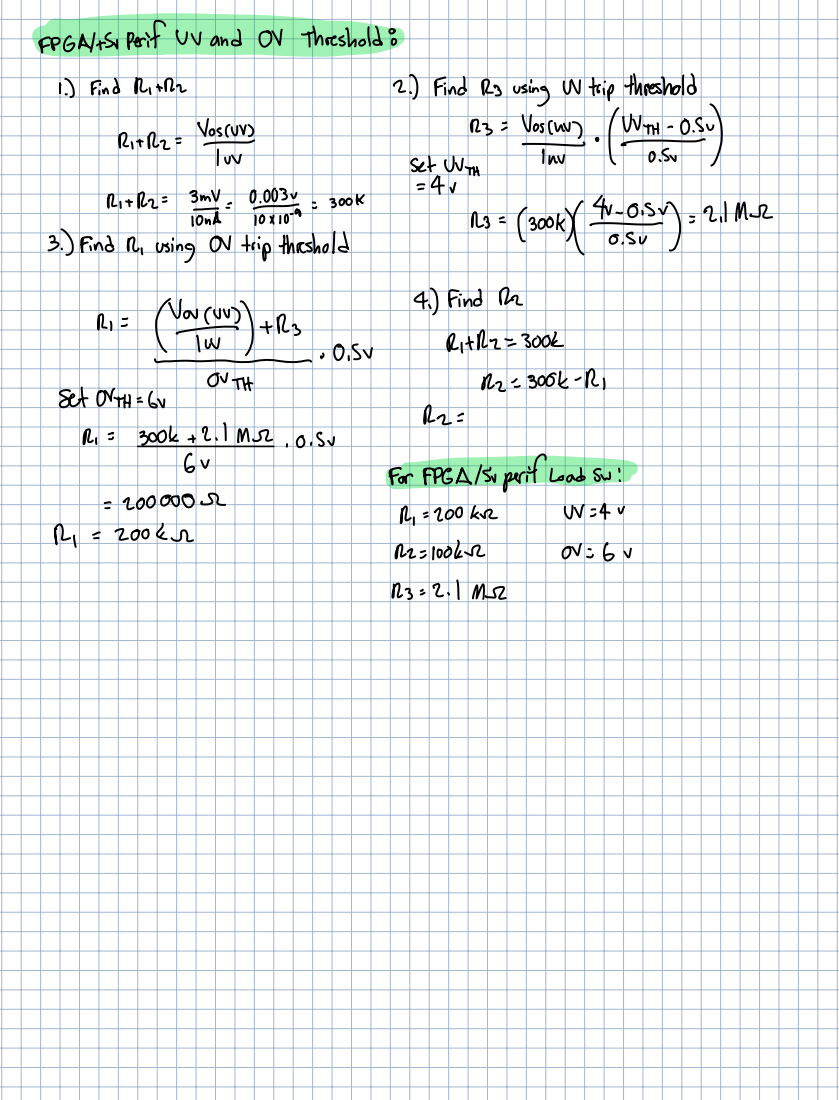
[picture p176: page 3]
Find; Rita; FindR3usingUVtripthreshold

FPGASvPerifUVand OV Threshold

4YUtH
13 | 300k | 2 | Mr

RitR2s | | Ea | | 9QI.ssoo

3 | Find R usingOVtripthreshold

R | | Nf1 | o.su | | | | | Reason

Rr Set
jjegp.lmr.o.su

poppedsuperifloadSw

2000001 | | | | R | | 200hr | | UV 4V
R | 200Eur | | | | | R2 | | look | | OV Gv
