BroncoSpace-Lab/scales-hardware/imx8x_carrier_board/imx8x_carrier_v1/imx_dev_carrier_v1.pdf

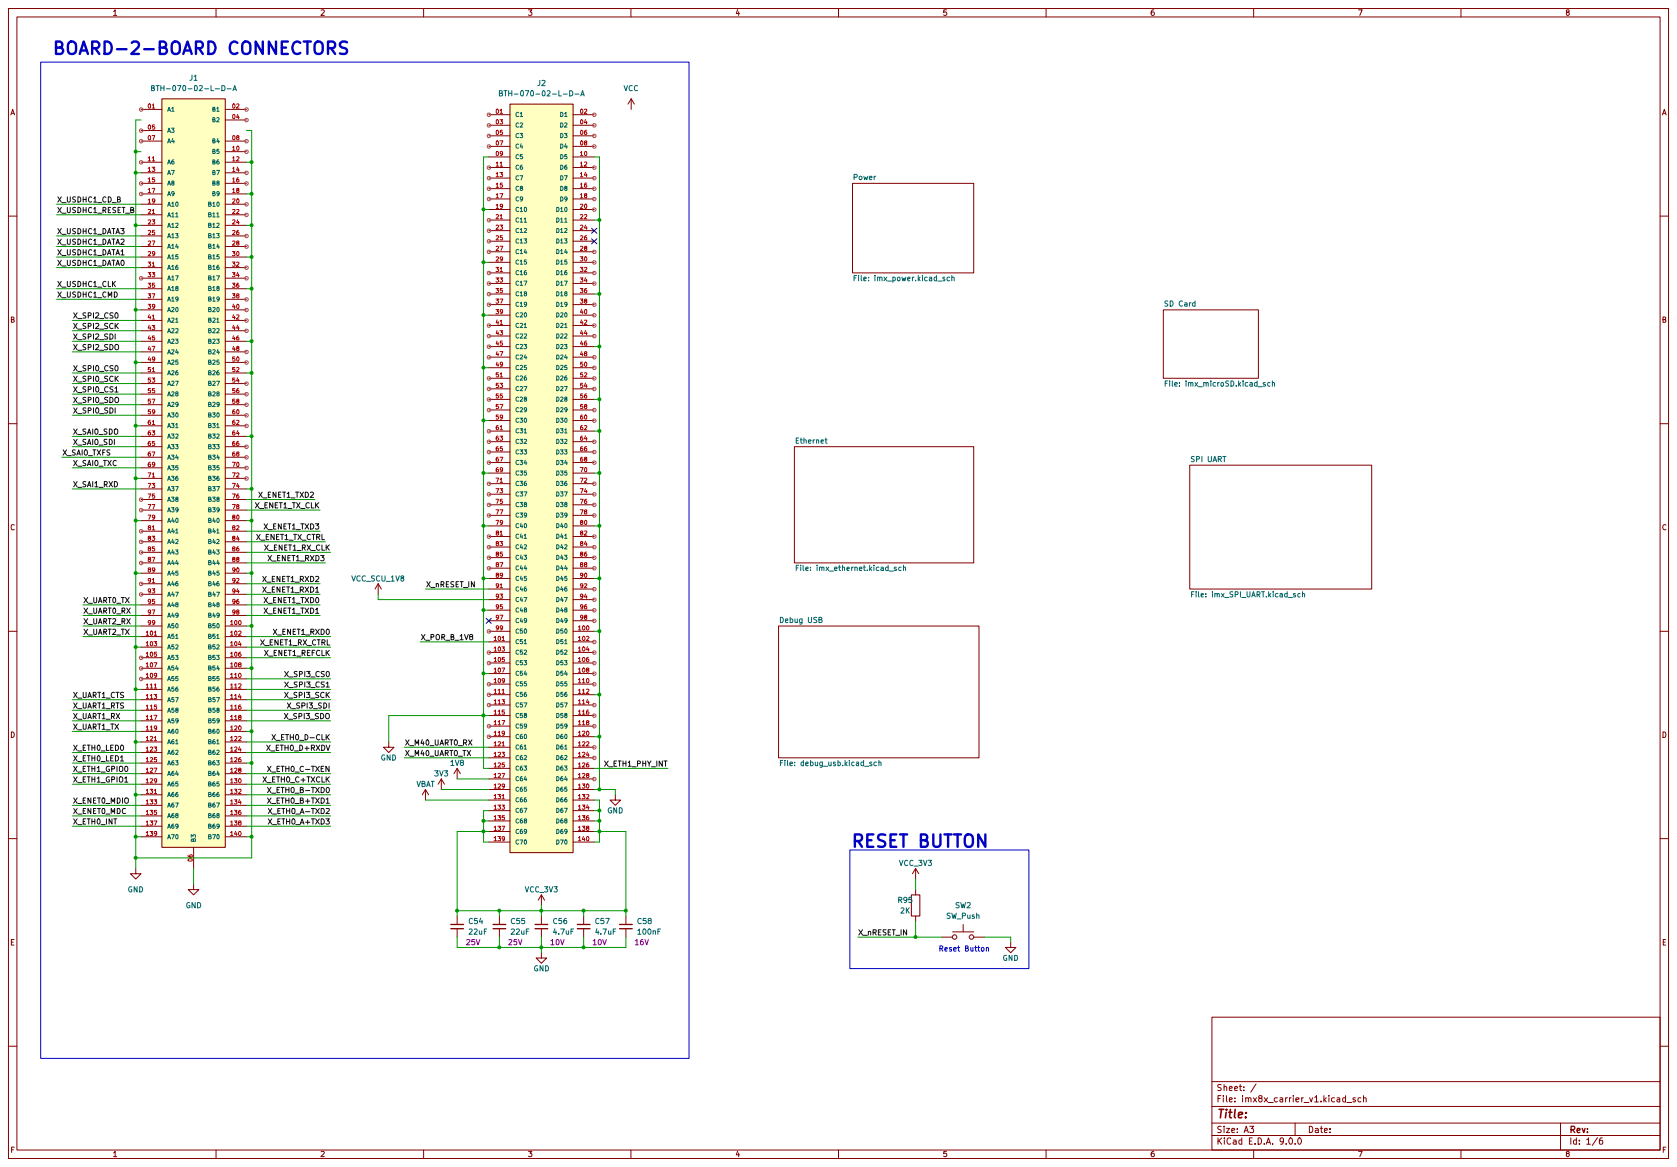
[picture p177: page 1]

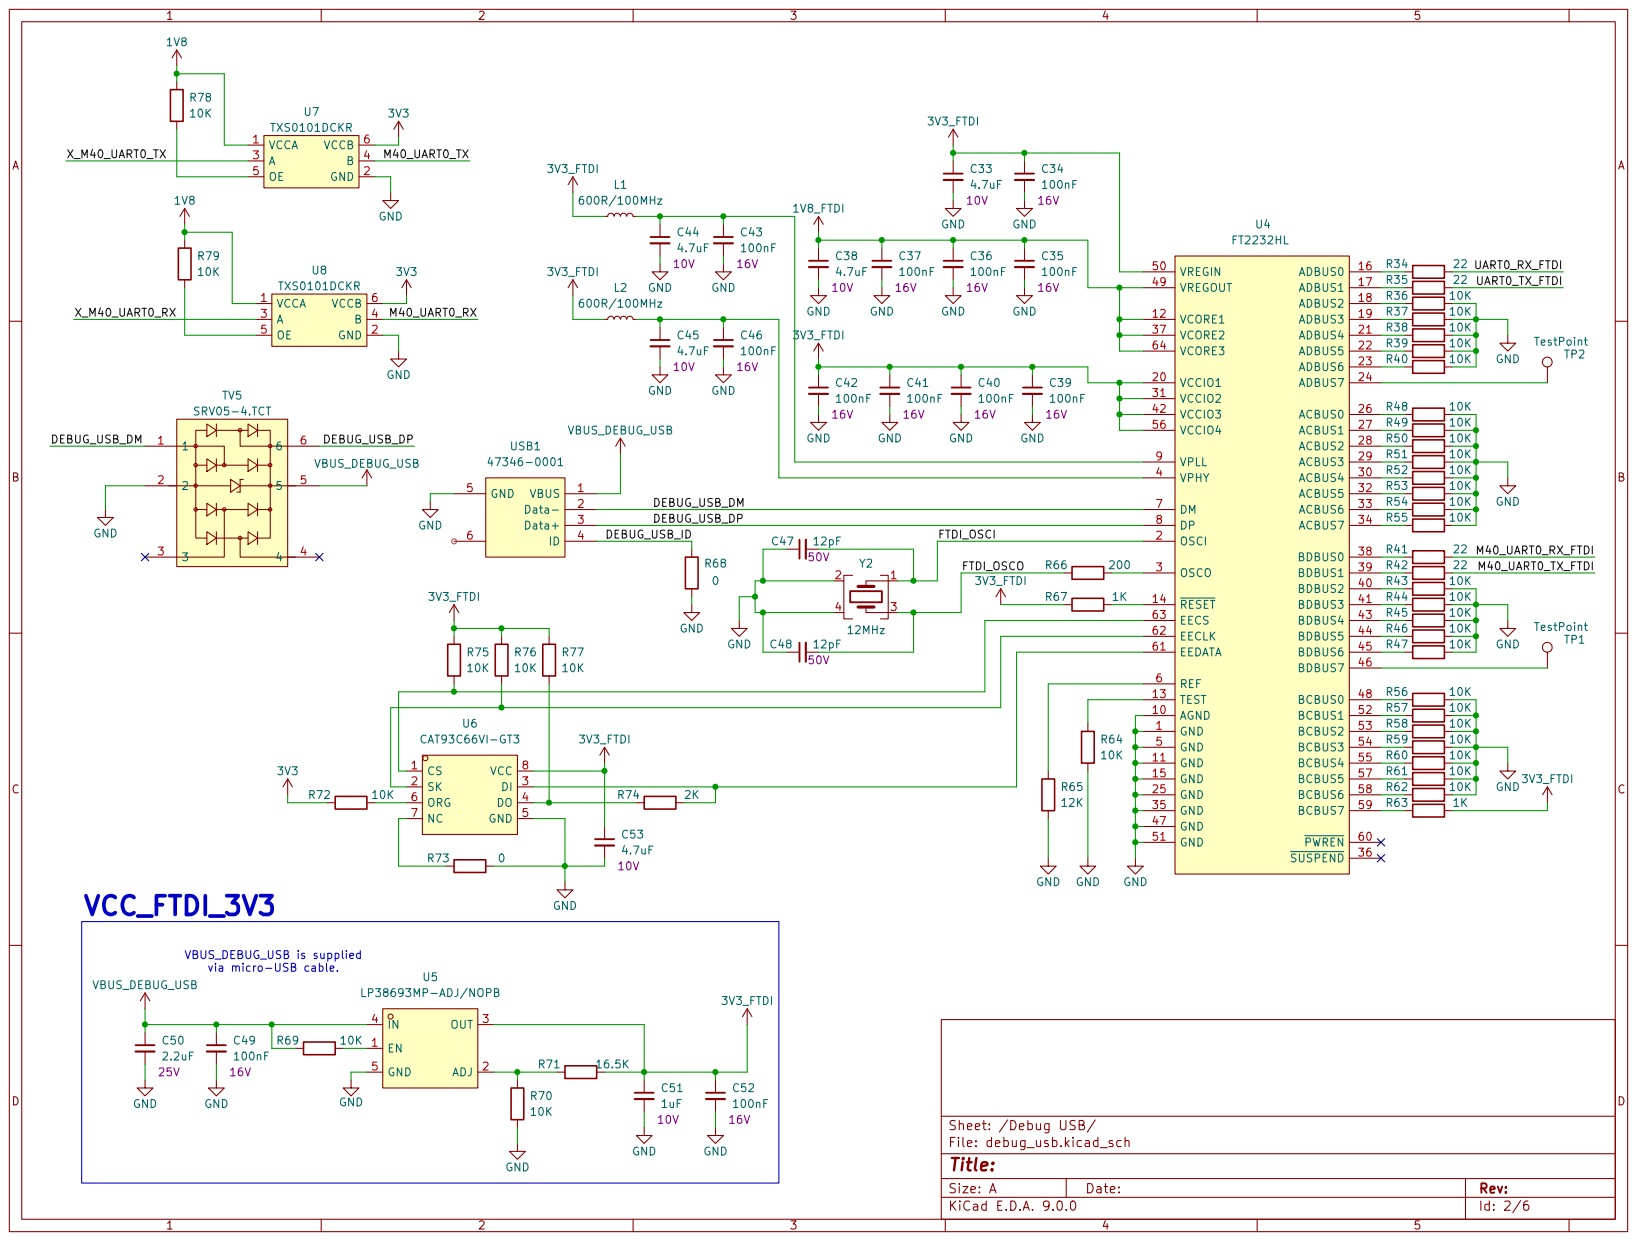
[picture p178: page 2]

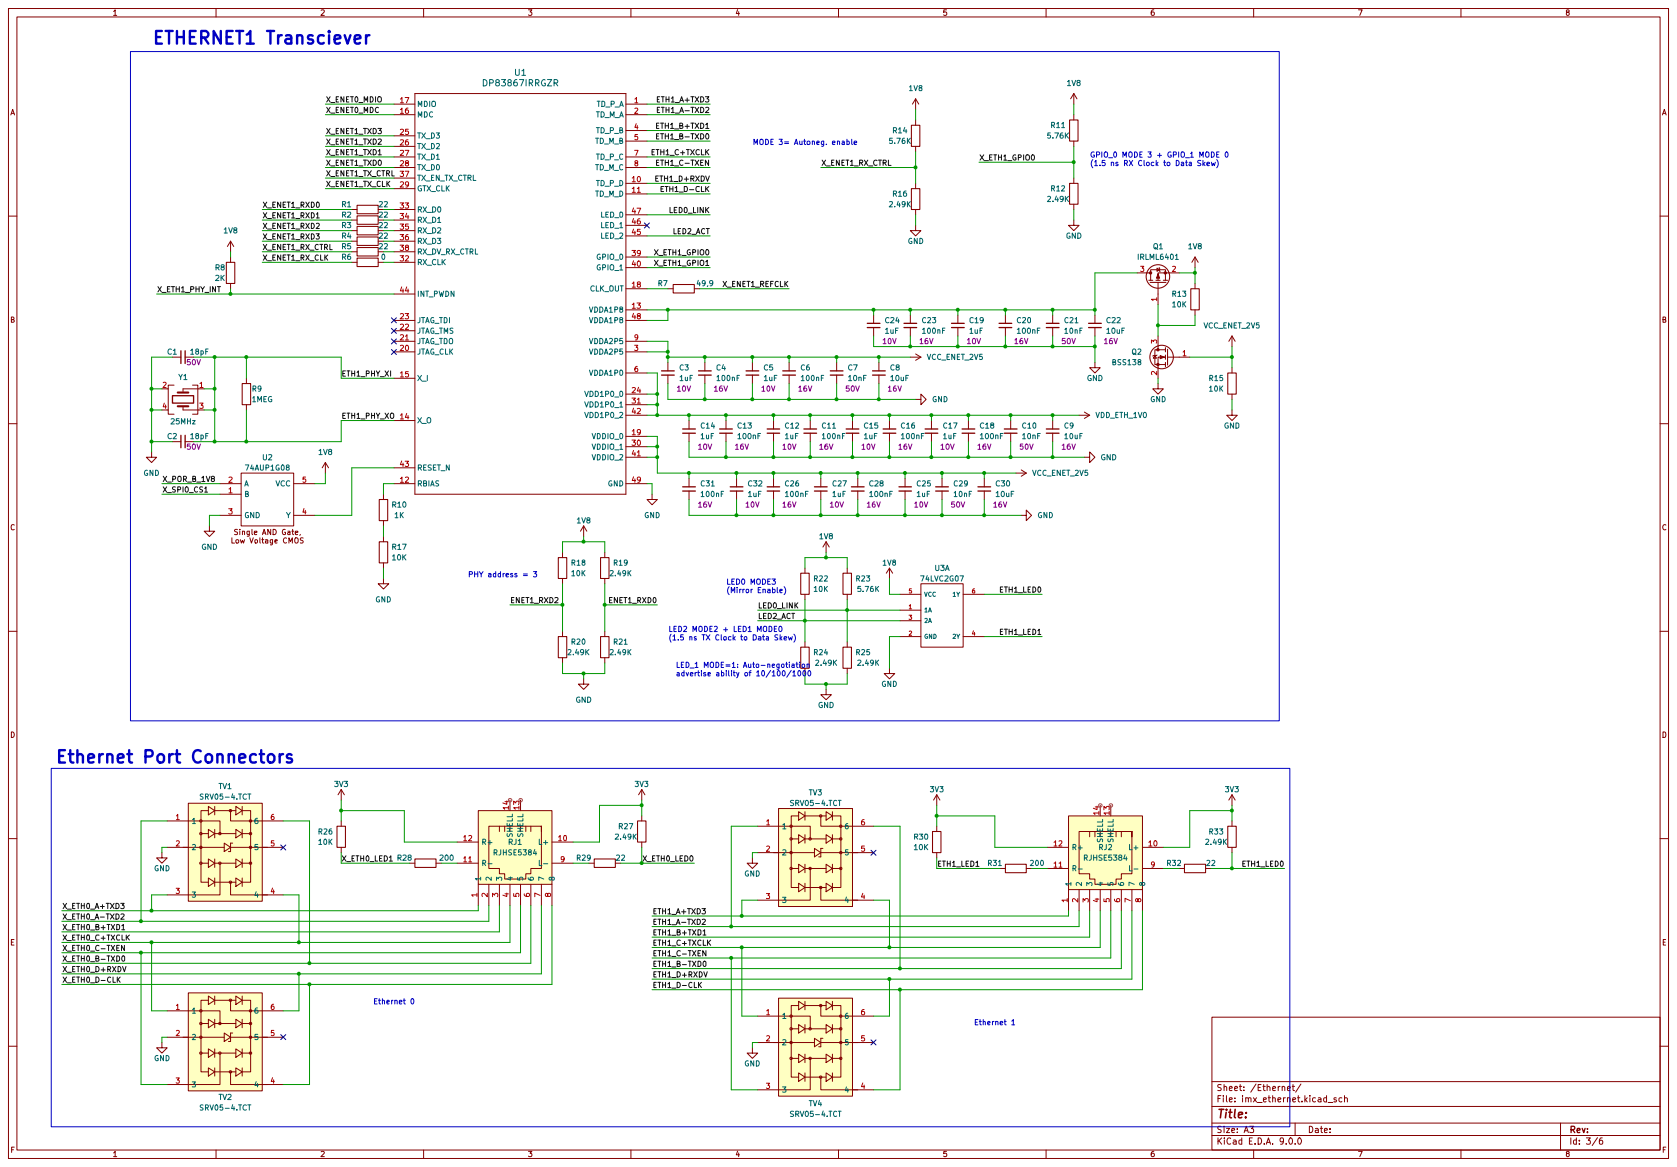
[picture p179: page 3]

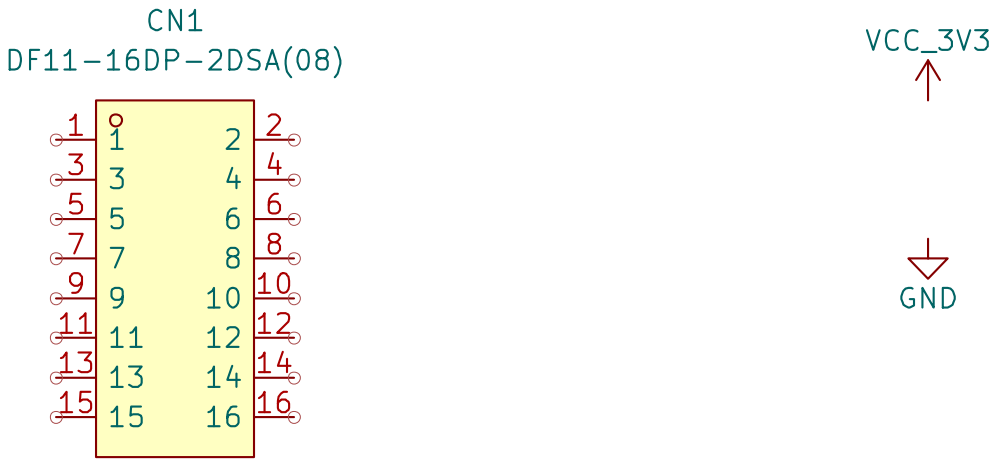
[picture p180: page 4]

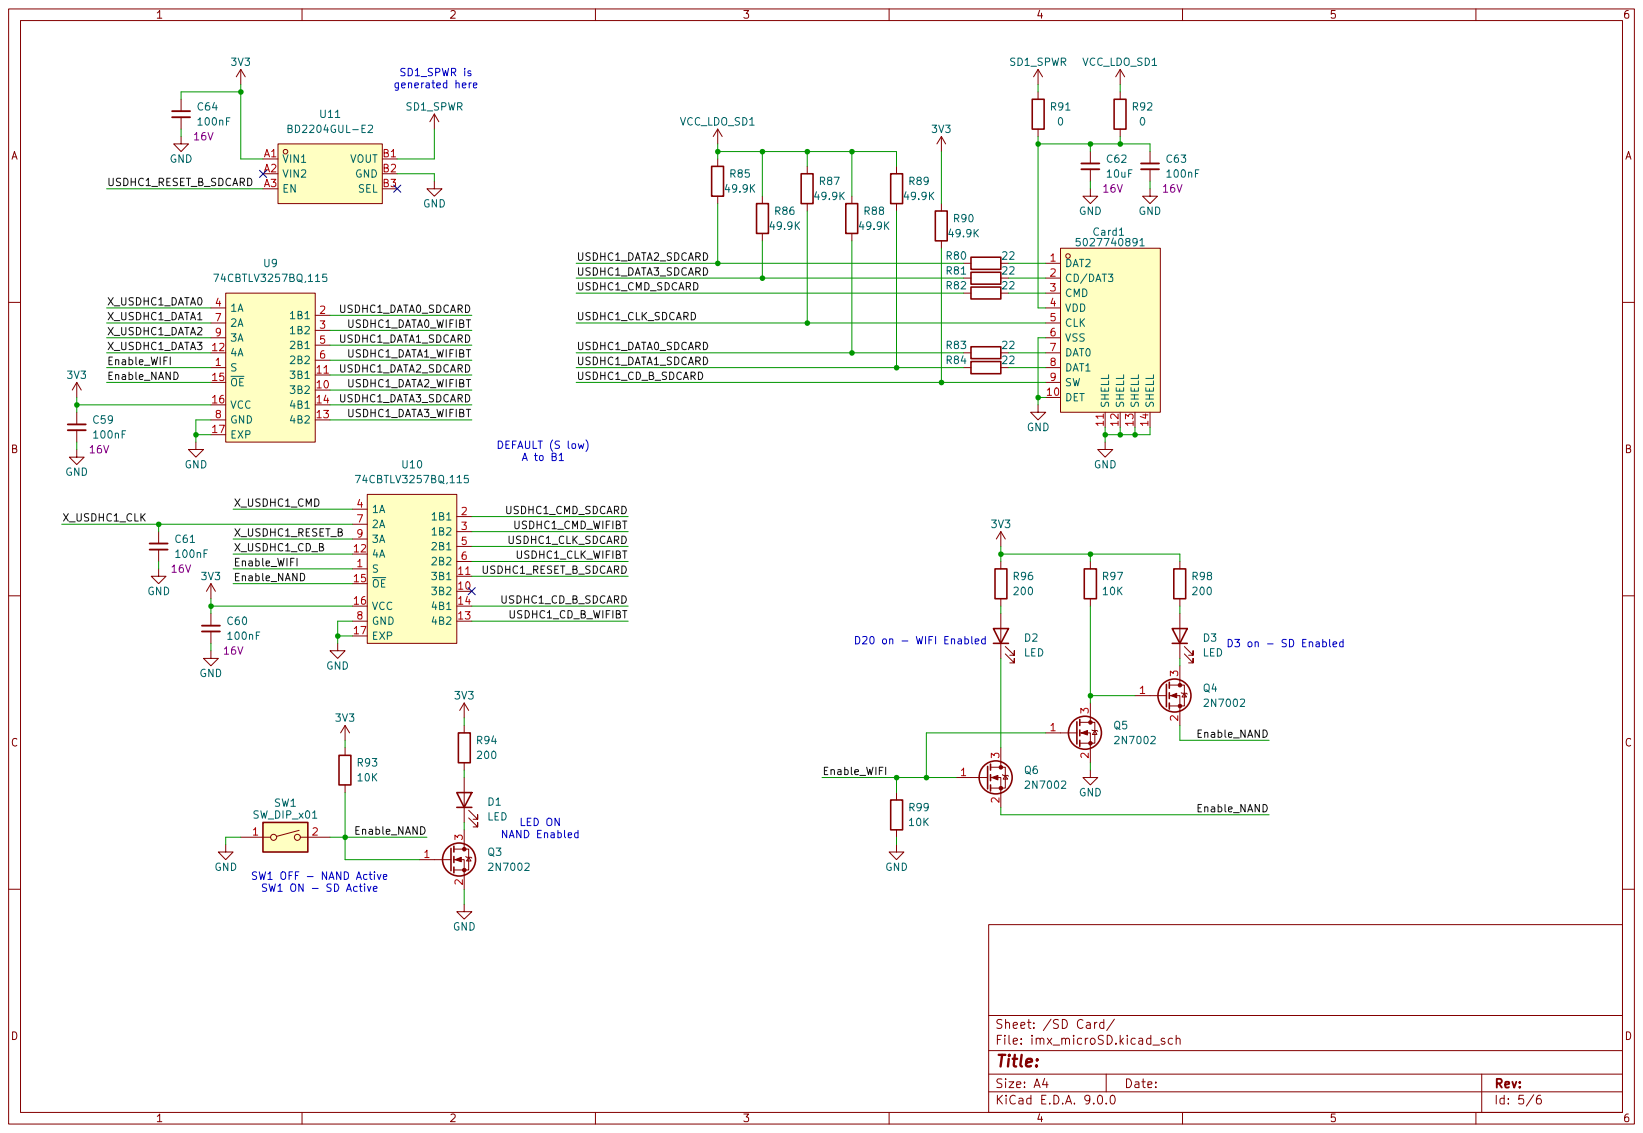
[picture p181: page 5]

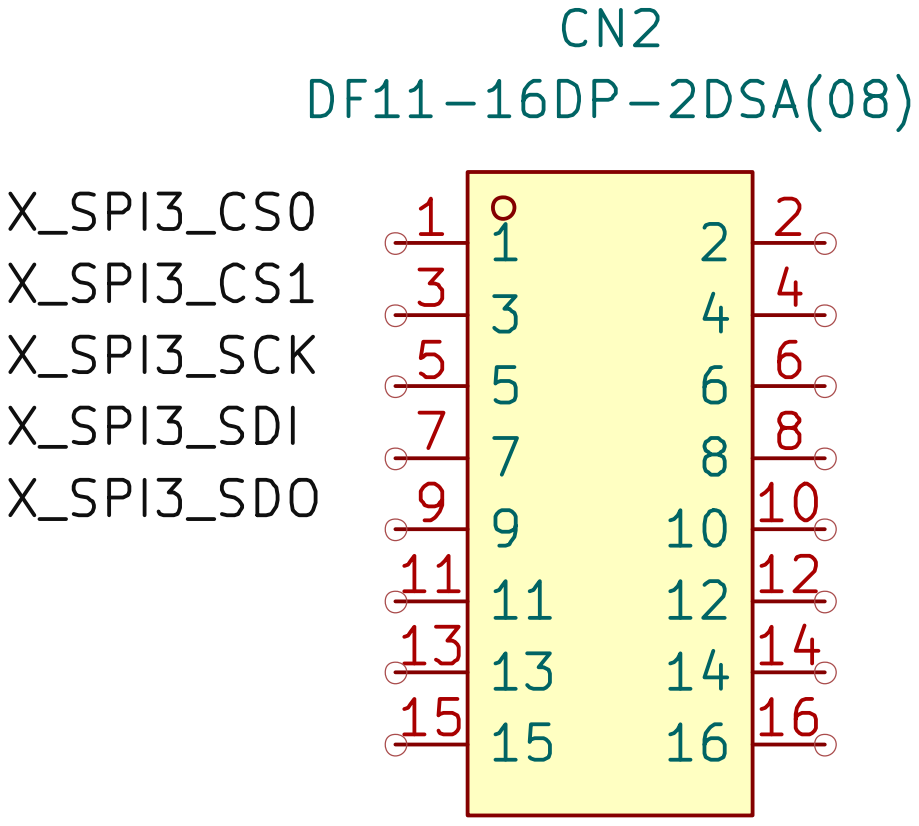
[picture p182: page 6]
