BroncoSpace-Lab/scales-hardware/power_system/EPS_Calculations/Rev_B_calcs/LT8638SEV Switching Regulator Calculations.pdf

msn.lv o | 1 | it | Fourman | t.itYii IFomvsuosoti risk | 2 | 1
msn.cm | ihyis.it | tBEirt | eYt | here

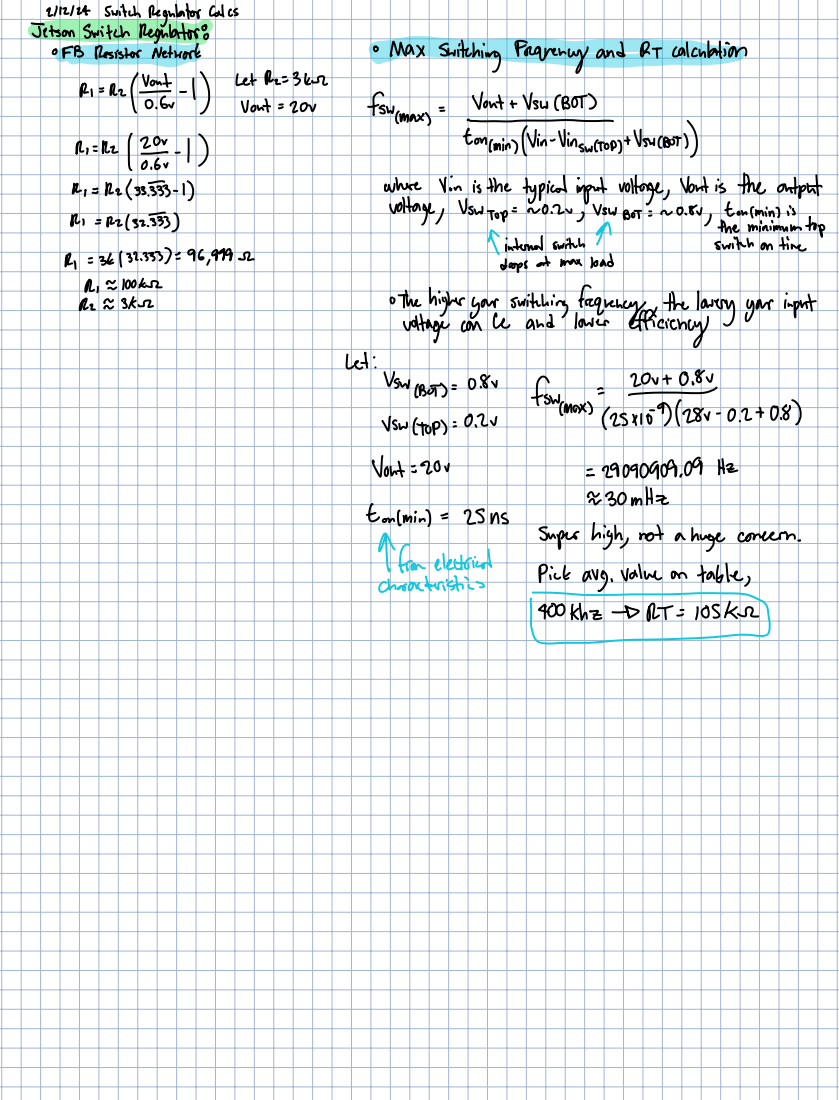
[picture p183: page 1]
21224 SwitchRegulatorCalcs; YESpitstorthtite; Maxswitching FrequencyandRTcalculation; toulmin

R | 36³².333 | | 96,99902 | | | tt Ist
R | looker
rests | | | | tektiteswithinfenyffietendgeryyouri.pt

Let
Vsweats 080
0.20 | fswmaxiysYT.GE | 0.2 0.8 Vswtop

Vont 200 | | | 29090909.09 Hz

30mHz

superhigh not ahugeconcern

fates.tt | Pickanyvalueontable

400Khz | | RT | 105K

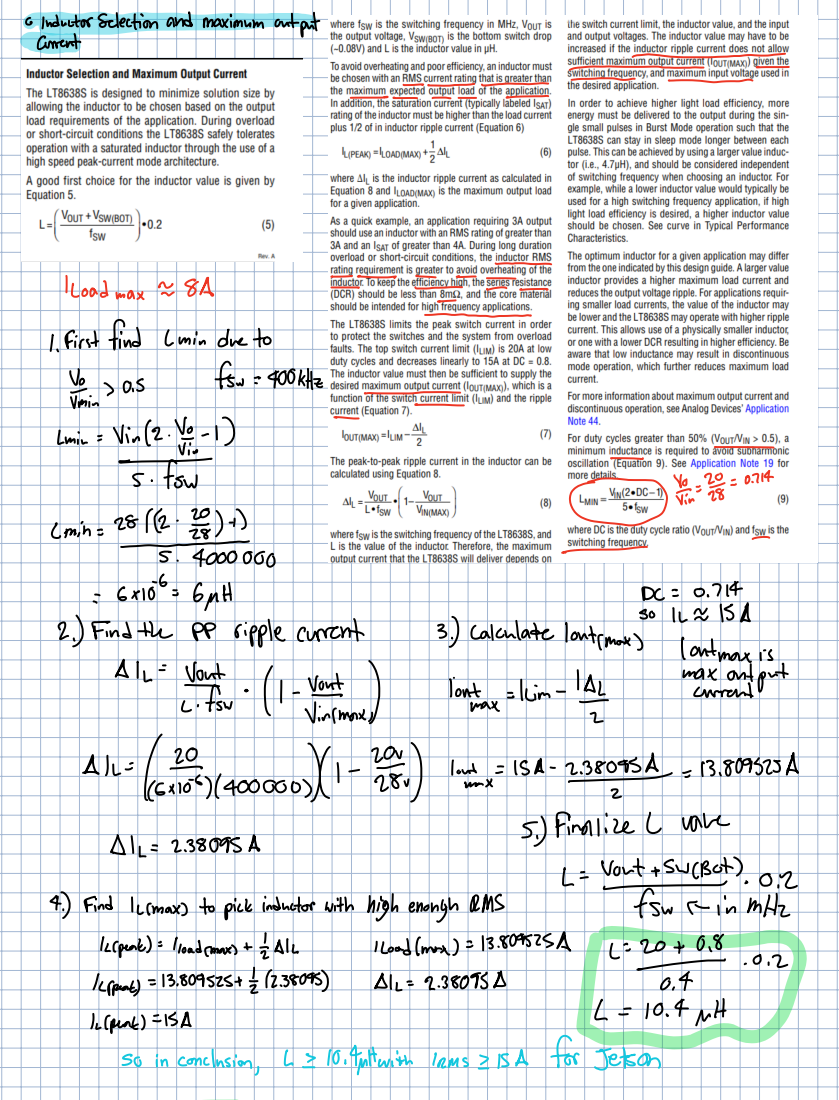
[picture p184: page 2]
differselectionandmaximumoutput; 1min; min; VII; tontax him; tax; Finalize L; vale; 4 Find lurmax; topickinductorwithhighenoughRMS; arpent; loadrman; ALL; Loadman; so inconclusion; 10Fultwith Irms; SA forJetson

Koodmax | | | 8A | | | II
1Firstfind | | | mindueto
Imin | as | | | Fsw | 400kHz

6 186 | GMH
2 | Findthe | | PP ripplecurrent | 3 calculateloutimony
Entretpt Δ

All | 2.38095A

Kppeat 13.809525 1 ².38095 | | Δ L | 2.38095Δ
lurpent | ISA | | | L | 10.4MH

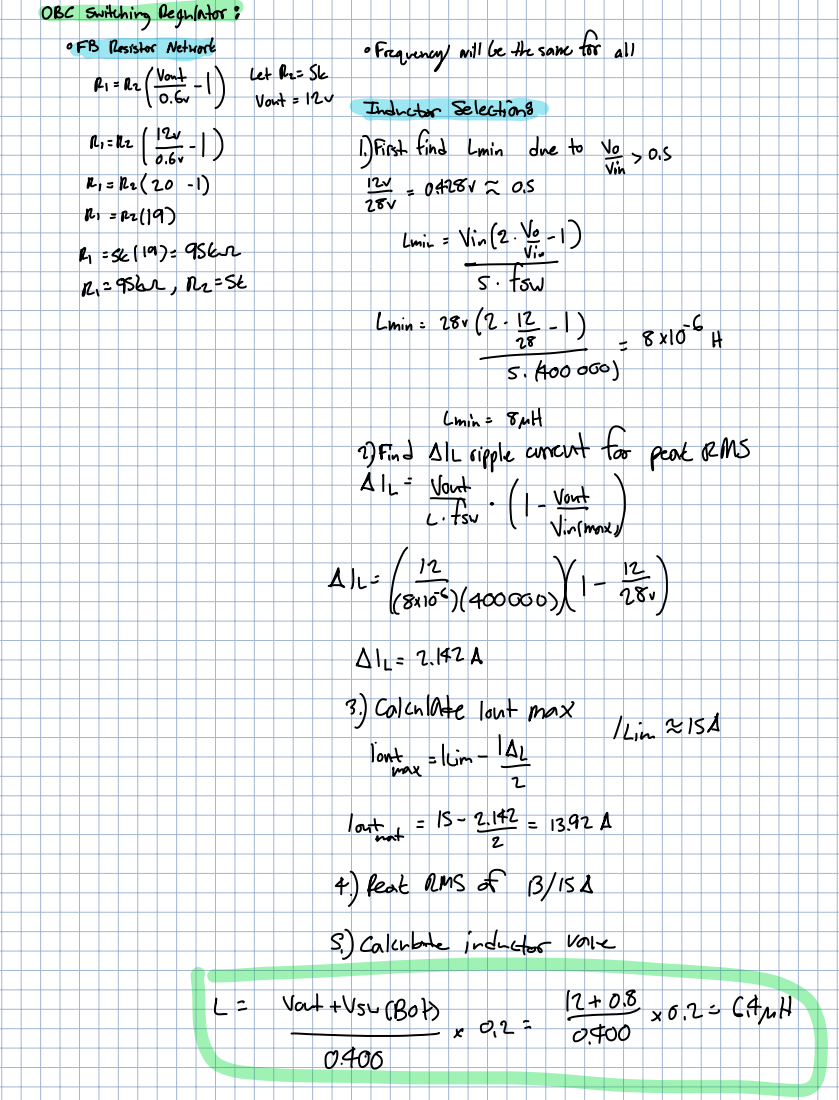
[picture p185: page 3]
OBCswitchingRegulator; Ali; Esv; All; 3 Calculate loutMax; Lin; Tanta Kim; outmat; ReatRMS of; ISA; calculateinductor; Vale

Ri | Ra 1 | 1 | LetRest | | | Fruencywillbethesamefor all
FBResistorNetwork

Vont | 120 | InductorSelections

Risk | | | | 1 | | 1firstfind Lmin dueto VI | | | | | | | | | as
R1 R2 20 | | | | 1 | | 12 | | | 04281 | | | I | 0.5
Ri | | R219
4 | 561197 95Eur | | | | | | | min | | | V | | | t
R | 95Eur | | R2 | | St

Lmin | | | 280 2

min | 8mA

2Find | Allripplecurrentfor peatRMS

wt
f | a | 1tt | xors6tmlt

2 | t | VontyYW | tt | xorssfffxo.rs².9mA

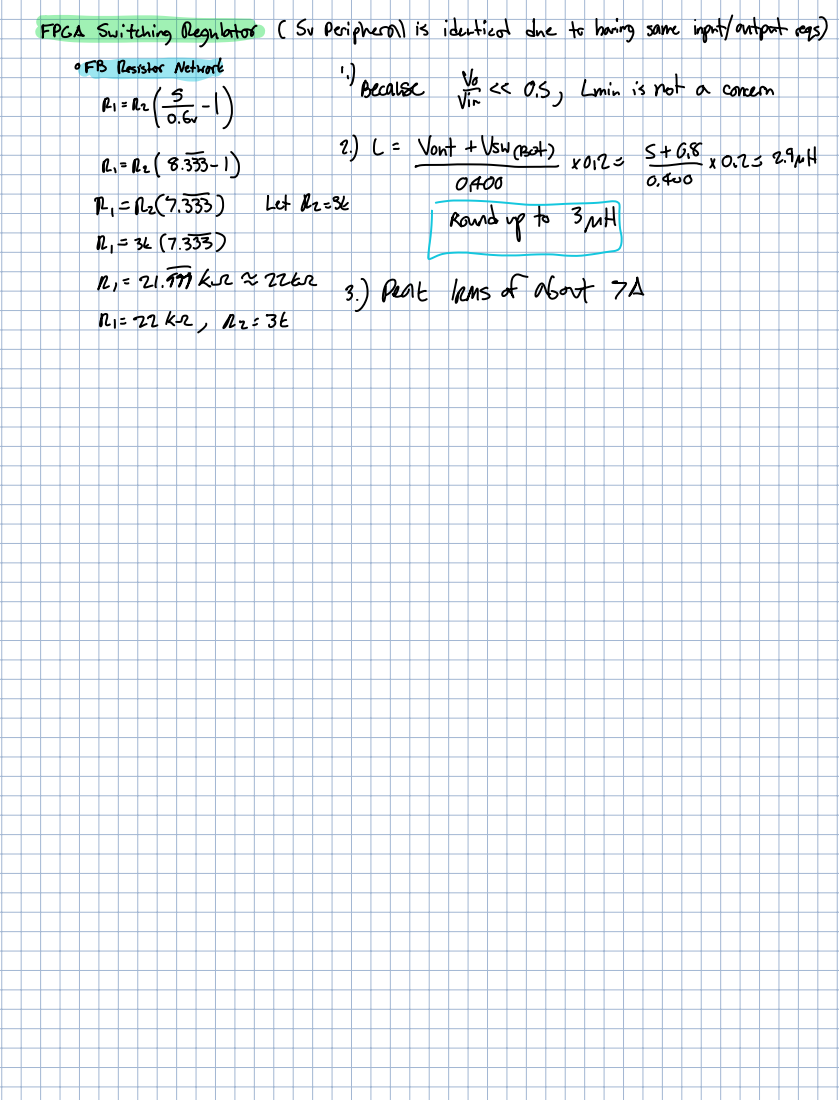
[picture p186: page 4]

FPGASwitchingRegulator | | SuPeripheral is identical duetohavingsameinputoutputregs

FBResistorNetwork | | 1
Ri R2 | l

Because | Yicc 0.5 | Lminisnot a concern

R | Rz7.333 | LetRz3E
21 | | 34 7.333
n | 21.9TEur | | 2262 | 3 | peat | Rms ofabout | | Δ
R1 22 K2 | | | R2 | 36
