BroncoSpace-Lab/scales-hardware/imx8x_eps_leviathan_v2/simulation_models/ngspice/ngspice/examples/ddt/ddt-test1.cir

dd test

V1 1 0 dc 0 pulse 0 2 0 1 1 1 4

B2 2 0 v = ddt(V(1))

.tran 1m 8

.control
run
plot v(1) v(2)
.endc

.end
