BroncoSpace-Lab/scales-hardware/imx8x_eps_leviathan_v2/simulation_models/ngspice/ngspice/examples/measure/buggy-meas-tran.sp

File: buggy-meas-tran.sp
* Simple .measurement examples
* transient simulation of two sine signals with different frequencies
vac1 1 0 DC 0 sin(0 1 1k 0 0)
R1 1 0 100k
vac2 2 0 DC 0 sin(0 1.2 0.9k 0 0)
.tran 10u 5m
*
.measure tra tdiff TRIG v(1) VAL=0.5 RISE=1 TARG v(1) VAL=0.5 RISE=2
.measure tran tdiff RIG v(1) VAL=0.5 RISE=1 TARG v(1) VAL=0.5 RISE=3
.measure tran tdiff TRIG v(1 VAL=0.5 RISE=1 TARG v(1) VAL=0.5 FALL=1
.measure tran tdiff TRIG v(1) VAL FALL=3 TARG v(2) VAL=0 FALL=3
.measure tran tdiff TRIG v(1) VAL=-0.6 CROS=1 TARG v(2) VAL=-0.8 CROSS=1
.measure tran tdiff TRIG AT=1m TARG v(2) VAL -0.8 CROSS=3
.measure tran teval WHE v(2)=0.7 CROSS=LAST
.measure tran teval WHEN v(2)==v(1) FALL=LAST
.measure tran teval WHEN v(1)!=v(2) CROSS=LAST
.measure tran yeval FIND v(2) WHEN v(1)=0.2 FALL=2
.measure tran yeval FIND v(2) AT=2 m
.measure tran ymax MAX v(2) fro m=2m to=3m
.measure tran tymax MAX_AT v(2) from=2m to=3m
.measure tran ypp PP v(1) from=2m to=4m
.measure tran yrms RMS v() from=2m to=3.5m
.measure tran yavg AVG v(1) from 2m to=4m
.measure tran yint INTER v(2) from=2m to=3m
.param fval=5
.measure tran yadd param='fval + 7'
.param vout_diff=50k
.meas tran bw_chk param='(vout_diff < 100k) ? 1 : 0'
.measure tran vtest find par('v(2)*v(1)') AT=2.3m
*
.control
echo
echo **** buggy .measure lines
run
*plot v(1) v(2)
*plot i(vac1)

echo
echo **** good meas lines
meas tran tdiff TRIG v(1) VAL=0.5 RISE=1 TARG v(1) VAL=0.5 RISE=2
meas tran tdiff TRIG v(1) VAL=0.5 RISE=1 TARG v(1) VAL=0.5 RISE=3
meas tran tdiff TRIG v(1) VAL=0.5 RISE=1 TARG v(1) VAL=0.5 FALL=1
meas tran tdiff TRIG v(1) VAL=0 FALL=3 TARG v(2) VAL=0 FALL=3
meas tran tdiff TRIG v(1) VAL=-0.6 CROSS=1 TARG v(2) VAL=-0.8 CROSS=1
meas tran tdiff TRIG AT=1m TARG v(2) VAL=-0.8 CROSS=3
meas tran teval WHEN v(2)=0.7 CROSS=LAST
meas tran teval WHEN v(2)=v(1) FALL=LAST
meas tran teval WHEN v(1)=v(2) CROSS=LAST
meas tran yeval FIND v(2) WHEN v(1)=0.2 FALL=2
meas tran yeval FIND v(2) AT=2m
meas tran ymax MAX v(2) from=2m to=3m
meas tran tymax MAX_AT v(2) from=2m to=3m
meas tran ypp PP v(1) from=2m to=4m
meas tran yrms RMS v(1) from=2m to=3.5m
meas tran yavg AVG v(1) from=2m to=4m
meas tran yint INTEG v(2) from=2m to=3m
meas tran ymax MAX v(2) from=2m to=3m
meas tran tmax WHEN v(2)=YMAX from=1m to=2m

echo
echo **** out of intervall examples
meas tran tdiff TRIG v(1) VAL=0.5 RISE=1 TARG v(1) VAL=0.5 RISE=25
meas tran tdiff TRIG v(1) VAL=0.5 RISE=3 TARG v(1) VAL=0.5 RISE=2
meas tran teval WHEN v(2)=70 CROSS=LAST
meas tran yeval FIND v(2) AT=2

echo
echo **** buggy input lines
meas tran tdiff TRIG v(1) VAL=0.5 RISE=1 TARG v(1) VAL=0.5 RISE=2
meas tran tdiff TRIG v(1) VAL=0.5 RISE=1 TARG v(1) VAL=0.5
meas tran tdiff TRIG v(1) VAL=0.5 RISE=1 TARG v(1)
meas tran tdiff TRIG v(1) VAL=0.5 RISE=1 TARG
meas tran tdiff TRIG v(1) VAL=0.5 RISE=1
meas tran tdiff TRIG v(1) VAL=0.5
meas tran tdiff TRIG v(1)
meas tran tdiff TRIG
meas tran tdiff
meas tran
meas
echo
echo **** more buggy lines
meas tran tdiff TRIG v(1) VAL=0.5 RISE=1 TARG v(1) VAL=0.5 RISE=2
meas tran TRIG v(1) VAL=0.5 RISE=1 TARG v(1) VAL=0.5 RISE=2
meas tran tdiff v(1) VAL=0.5 RISE=1 TARG v(1) VAL=0.5 RISE=2
meas tran tdiff TRIG VAL=0.5 RISE=1 TARG v(1) VAL=0.5 RISE=2
meas tran tdiff TRIG v(1) RISE=1 TARG v(1) VAL=0.5 RISE=2
meas tran tdiff TRIG v(1) VAL=0.5 TARG v(1) VAL=0.5 RISE=2
meas tran tdiff TRIG v(1) VAL=0.5 RISE=1 v(1) VAL=0.5 RISE=2
meas tran tdiff TRIG v(1) VAL=0.5 RISE=1 TARG VAL=0.5 RISE=2
meas tran tdiff TRIG v(1) VAL=0.5 RISE=1 TARG v(1) RISE=2
meas tran tdiff TRIG v(1) VAL= RISE=1 TARG v(1) VAL=0.5 RISE=2
meas tran tdiff TRIG v(1) VAL=0.5 RISE= TARG v(1) VAL=0.5 RISE=2
meas sp tmax MAX v(2) from=2m to=3m
meas dc ymax MAX v(2) from=2m to=3m
.endc
.end
