BroncoSpace-Lab/scales-hardware/imx8x_eps_leviathan_v2/simulation_models/ngspice/ngspice/examples/p-to-n-examples/op-test.cir

OpAmp Test

vddp vp 0 3
vddn vn 0 -3

*vin in 0 0

* OPA171 IN+ IN- VCC VEE OUT
.include OPA171.txt

Xopmap 0 ino vp vn outo OPA171

*Xopmap 0 ino outo vp vn CLC409
Rin in ino 1k
Rfb ino outo 3k

*.dc vin -1 1 0.1

vin in 0 DC 0 PULSE(-0.5 0.5 2uS 200NS 200NS 7uS 14uS)
.tran 100n 16u

.control
run
plot v(in) v(outo)
.endc


*
*   This is a Very Wide band, Low Distortion Monolithic
*   Current Feedback Op Amp.
*
* Version 1, Rev. A, Date 04-09-92, By RRS
*
* Connections: Non-Inverting Input
*              | Inverting Input
*              | | Output
*              | | | +Vcc
*              | | | | -Vcc
*              | | | | |
.SUBCKT CLC409 3 2 6 7 4
*
* DC BIAS MIRROR
*
R1 7 4 28K
R2 7 9 271
R3 10 4 335
*
G1 7 11 POLY(2) 7 9 7 4 0 3.15M 21.5U
C3 11 0 128F
*
G2 14 4 POLY(1) 10 4 0 2.95M
C4 14 0 104F
*
* INPUT VOLTAGE BUFFER
*
E1 3 17 POLY(1) 35 0 1.0M 1.673
C6 17 0 1.00P
*
Q1 10 17 12 QINP
D3 11 12 DY
Q2 9 17 13 QINN
D4 13 14 DY
*
G3 2 0 POLY(1) 36 0 0 9.282M
C10 2 0 2.9P
*
D5 22 2 DY
Q3 21 11 22 QINN
D6 2 23 DY
Q4 24 14 23 QINP
*
* CURRENT MIRROR GAIN BLOCKS
*
R10 7 20 640
V1 20 21 1.9
C8 21 28 294F
G4 7 28 POLY(1) 7 20 0 4.3M
R15 7 28 102K
C13 28 0 641F
D1 28 26 DX
V3 7 26 1.65
G6 7 30 POLY(1) 7 20 0 2.74M
C15 30 0 676F
*
R13 25 4 640
V2 24 25 1.85
C12 24 29 294F
G5 29 4 POLY(1) 25 4 0 4.5M
R16 29 4 761K
C14 29 0 312F
D2 27 29 DX
V4 27 4 1.55
G7 31 4 POLY(1) 25 4 0 6.74M
C16 31 0 330F
*
* OUTPUT STAGE AND COMPENSATION CAPACITORS
*
R14 28 29 45.0
Q5 4 29 30 QOUTP1
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
+ MJE=5.000E-01 TF =3.073E-11 XTF=5.386E+00 VTF=2.713E+00
+ ITF=2.250E-01 PTF=0.000E+00 CJC=9.776E-13 VJC=7.130E-01
+ MJC=4.200E-01 XCJC=923m     TR =1.450E-10 CJS=1.637E-12
+ VJS=6.691E-01 MJS=3.950E-01 KF =2.000E-12 AF =1.000E+00
+ FC =8.803E-01
*
.ENDS CLC409

.end
