BroncoSpace-Lab/scales-hardware/imx8x_eps_leviathan_v2/simulation_models/ngspice/ngspice/examples/p-to-n-examples/remcirc-test.cir

remcirc test
v1 1 0 1
v2 2 0 1
v3 3 0 1
.include rtest.lib

.control
repeat 1000
  reset
end
.endc

.end
