BroncoSpace-Lab/scales-hardware/imx8x_eps_leviathan_v2/simulation_models/ngspice/ngspice/examples/tclspice/tcl-testbench2/example.cir

TITLE: proj1.cir.cir - Rotary Traveling Wave Oscillator 
.control
set filetype=ascii
.endc

VDD0 VDD0 VDD DC 0
VSS0 VSS0 0 DC 0
VDD_A0 VDD_A0 VDD0 DC 0
VSS_A0 VSS_A0 VSS0 DC 0
VDD_B0 VDD_B0 VDD0 DC 0
VSS_B0 VSS_B0 VSS0 DC 0
LA0 A0 LCA0 3.69030941553353e-11
RA0 LCA0 A1 0.266535044422507
LB0 B0 LCB0 3.69030941553353e-11
RB0 LCB0 B1 0.266535044422507
C0 A1 B1 2.50418376625721e-14
MNA0 B0 A0 VSS_B0 VSS_B0 Nmod L=2.53696435353243e-07 W=
+4.24857778403814e-05 AD=3.125e-11 AS=3.125e-11 PD=
+8.49715556807627e-05 PS=8.49715556807627e-05 NQSMOD=1 
MPA0 B0 A0 VDD_B0 VDD_B0 Pmod L=2.55343565546106e-07 W=
+0.000101772203908557 AD=7.8125e-11 AS=7.8125e-11 PD=
+0.000203544407817114 PS=0.000203544407817114 NQSMOD=1 
MNB0 A0 B0 VSS_A0 VSS_A0 Nmod L=2.53941602497219e-07 W=
+4.10652659629401e-05 AD=3.125e-11 AS=3.125e-11 PD=
+8.21305319258802e-05 PS=8.21305319258802e-05 NQSMOD=1 
MPB0 A0 B0 VDD_A0 VDD_A0 Pmod L=2.52010168145607e-07 W=
+0.000103533977891464 AD=7.8125e-11 AS=7.8125e-11 PD=
+0.000207067955782928 PS=0.000207067955782928 NQSMOD=1 
LA1 A1 LCA1 3.69030941553353e-11
RA1 LCA1 A2 0.266535044422507
LB1 B1 LCB1 3.69030941553353e-11
RB1 LCB1 B2 0.266535044422507
C1 A2 B2 2.50418376625721e-14
MNA1 B1 A1 0 0 Nmod L=2.52370578161099e-07 W=4.12246995102289e-05 AD=
+3.125e-11 AS=3.125e-11 PD=8.24493990204578e-05 PS=
+8.24493990204578e-05 NQSMOD=1 
MPA1 B1 A1 VDD VDD Pmod L=2.45709468983316e-07 W=0.000103710764679465 
+AD=7.8125e-11 AS=7.8125e-11 PD=0.000207421529358929 PS=
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
+PCLM    = 0.1098002      LPCLM   = 6.874263E-7    WPCLM   = 6.724724E-7        
+PPCLM   = -1.97766E-13   PDIBLC1 = 0              PDIBLC2 = 5.801323E-3        
+LPDIBLC2= -1.81964E-9    WPDIBLC2= -5.853396E-9   PPDIBLC2= 2.957545E-15       
+PDIBLCB = 0.1921199      DROUT   = 0              PSCBE1  = 7.19E8             
+PSCBE2  = 1E-20          PVAG    = 0              DELTA   = 0.01               
+ALPHA0  = 0              BETA0   = 30             KT1     = -0.3248987         
+LKT1    = -1.160393E-8   WKT1    = 4.153356E-8    PKT1    = -4.62347E-15       
+KT2     = -0.0367632     AT      = 1E4            UTE     = -1.04              
+UA1     = 3.992421E-10   UB1     = -9.23294E-19   LUB1    = -5.28718E-26       
+WUB1    = -6.13069E-26   PUB1    = 1.503674E-32   UC1     = -1.00699E-12       
+KT1L    = 0              PRT     = 0              CJ      =  1.931092e-3                  
+MJ      = 0.4812153      PB      = 0.9134669      CJSW    = 2.232277e-10              
+MJSW    = 0.3237595      PBSW    = 0.9134669      CJSWG   = 1.607088e-10           
+MJSWG   = 0.3237595      PBSWG   = 0.9134669                   
+RSH     = 3.5                     
+CGDO    = 2.68e-10       CGSO    = 2.68e-10                        
+CAPMOD  = 2              
+XPART   = 1
+CF      = 0              XTI     = 3 
+JS      = 3E-7           
+JSW     = 5E-12        

**.... FINISHED INCLUDING: ./proj1/process.models
**
.OPTIONS TEMP=25
VSLEW_CONTROL VSLEW 0 (PULSE 0 1 0 1e-09)
EVLOGIC VRAMP 0 VSLEW 0 2.5
VDDPOWER VDD VRAMP DC 0
VARACTOR_V VARACTOR_V 0 DC 2.5
.SAVE vddpower#branch 
.SAVE vdd 
.SAVE varactor_v 
.TRAN 0.02n 100n 0n 0.5n 
.END
