BroncoSpace-Lab/scales-hardware/(list of files, drawings)

Other design files:
imx8x_eps_leviathan_v2/simulation_models/eps_mergersim.opj
imx8x_eps_leviathan_v2/simulation_models/pspiceForTI/TPS1HB08/TPS1HB08.opj
