BroncoSpace-Lab/scales-hardware/imx8x_eps_leviathan_v2/imx8x_eps_leviathan_v2.kicad_pcb

## KiCad design imx8x_eps_leviathan_v2/imx8x_eps_leviathan_v2.kicad_pcb (2026-06-30)

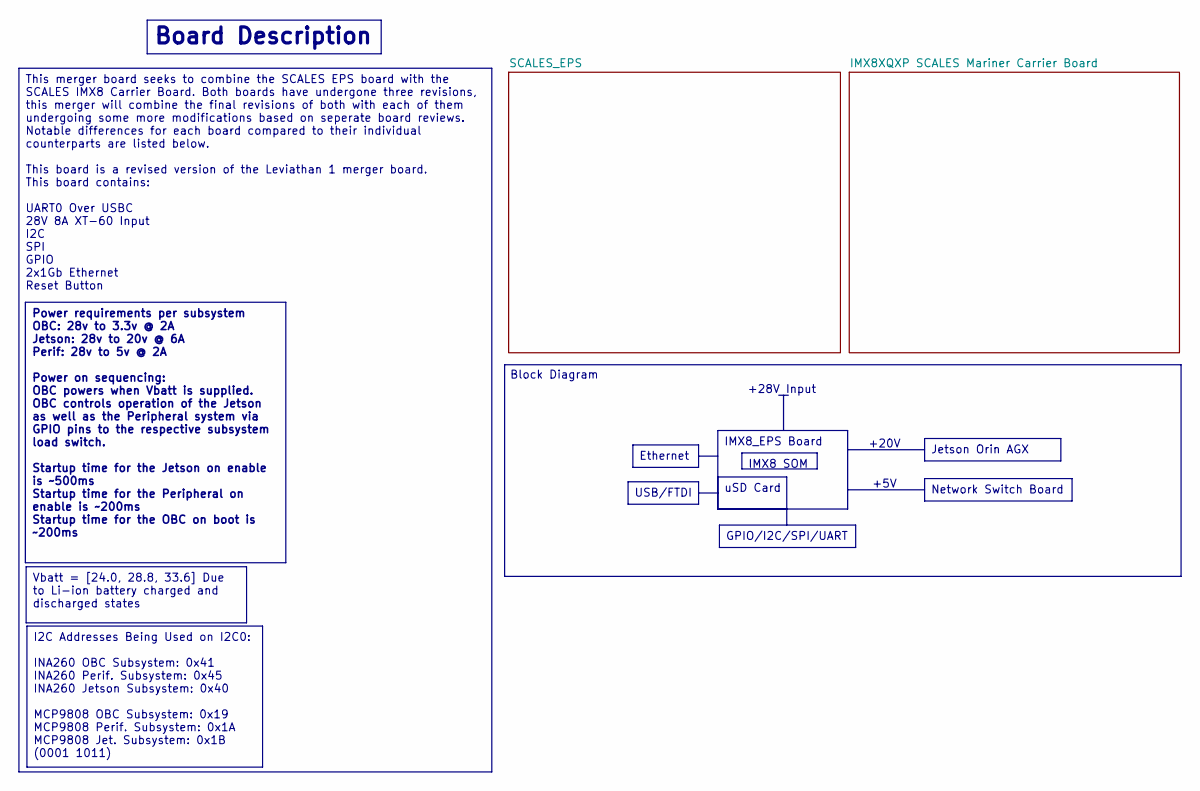
[picture p187: schematic imx8x_eps_leviathan_v2.kicad_sch, Leviathan V2]

Notes on the sheet:
Block Diagram
+20V
+28V Input
+5V
USB/FTDI
IMX8 SOM
GPIO/I2C/SPI/UART
Board Description
IMX8_EPS Board
Jetson Orin AGX
Power requirements per subsystem OBC: 28v to 3.3v @ 2A Jetson: 28v to 20v @ 6A Perif: 28v to 5v @ 2A Power on sequencing: OBC powers when Vbatt is supplied. OBC controls operation of the Jetson as well as the Peripheral system via GPIO pins to the respective subsystem load switch. Startup time for 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
uSD Card
Ethernet
This merger board seeks to combine the SCALES EPS board with the SCALES IMX8 Carrier Board. Both boards have undergone three revisions, this merger will combine the final revisions of both with each of them undergoing some more modifications based on seperate board reviews. Notable differences for 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
I2C Addresses Being Used on I2C0: INA260 OBC Subsystem: 0x41 INA260 Perif. Subsystem: 0x45 INA260 Jetson Subsystem: 0x40 MCP9808 OBC Subsystem: 0x19 MCP9808 Perif. Subsystem: 0x1A MCP9808 Jet. Subsystem: 0x1B (0001 1011)
Network Switch Board
Vbatt = [24.0, 28.8, 33.6] Due to Li-ion battery charged and discharged states

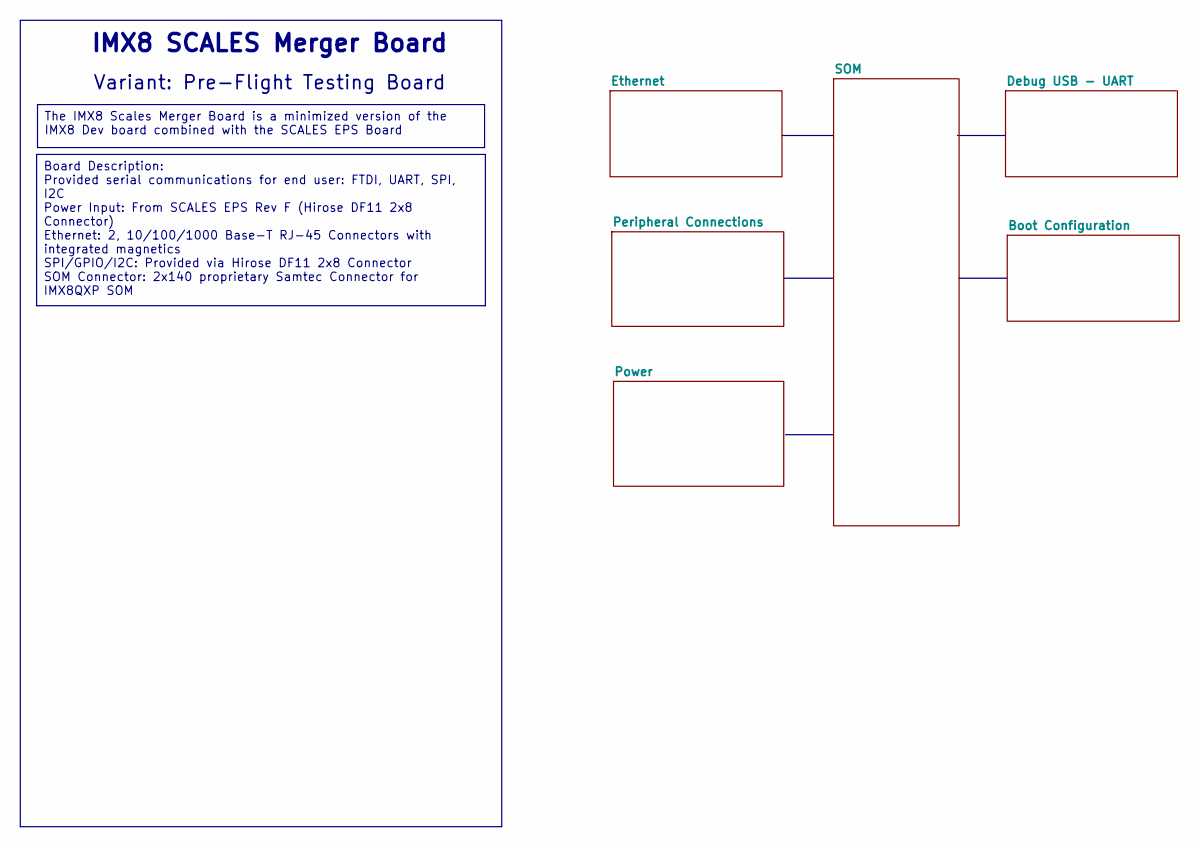
[picture p188: schematic imx8qxp_carrier_board.kicad_sch, Leviathan V2]

Notes on the sheet:
Variant: Pre-Flight Testing Board
IMX8 SCALES Merger Board
The IMX8 Scales Merger Board is a minimized version of the IMX8 Dev board combined with the SCALES EPS Board
Board Description: Provided serial communications for end user: FTDI, UART, SPI, I2C Power Input: From SCALES EPS Rev F (Hirose DF11 2x8 Connector) Ethernet: 2, 10/100/1000 Base-T RJ-45 Connectors with integrated magnetics SPI/GPIO/I2C: Provided via Hirose DF11 2x8 Connector SOM Connector: 2x140 pr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

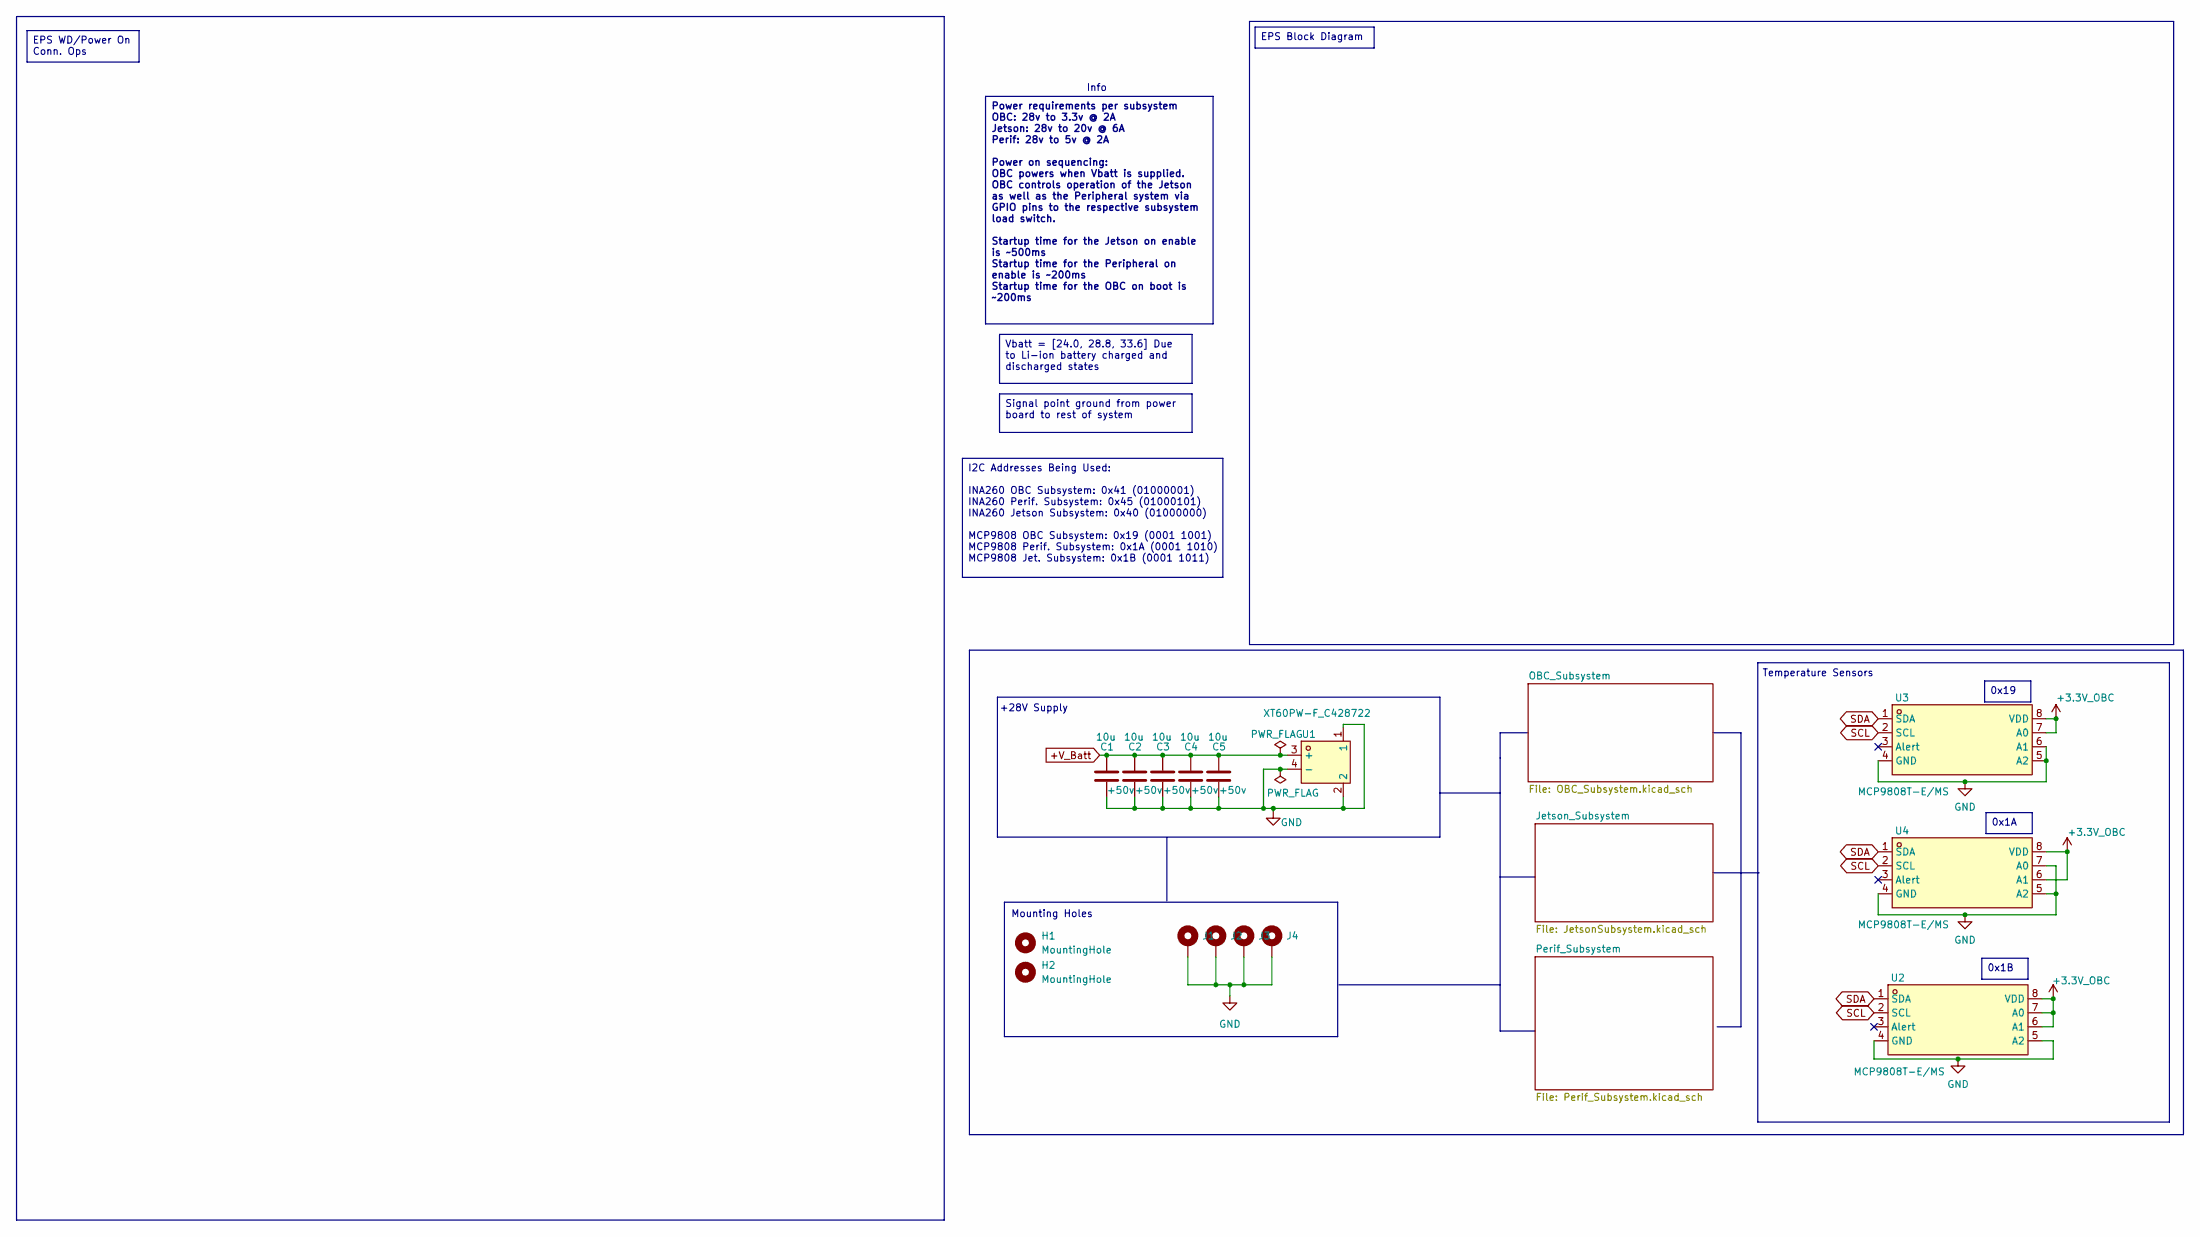
[picture p189: schematic SCALES_EPS.kicad_sch, Leviathan V2]

Parts:
C1, C2, C3, C4, C5: 10u; C_1210_3225Metric; Voltage Rating +50v; LCSC C2918502
H1, H2: MountingHole; MountingHole_2.7mm_M2.5
J1, J2, J3, J4: Conn_01x01_Socket; MountingHole_3.2mm_M3_Pad_Via
U1: XT60PW-F_C428722; TH_2P-XT60PW-F; LCSC Part C428722
U2, U3, U4: MCP9808T-E/MS; MSOP-8_L3.0-W3.0-P0.65-LS4.9-BL; LCSC Part C129490

Connections:
+3.3V_OBC: U2.6 (A1), U2.7 (A0), U2.8 (VDD), U3.7 (A0), U3.8 (VDD), U4.6 (A1), U4.8 (VDD); also elsewhere on the board
+V_Batt: C1.1, C2.1, C3.1, C4.1, C5.1, U1.3 (+); also elsewhere on the board
GND: C1.2, C2.2, C3.2, C4.2, C5.2, J1.1 (1_1), J2.1 (1_1), J3.1 (1_1), J4.1 (1_1), U1.1, U1.2, U1.4 (-), U2.4 (GND), U2.5 (A2), U3.4 (GND), U3.5 (A2), U3.6 (A1), U4.4 (GND), U4.5 (A2), U4.7 (A0); also elsewhere on the board
SCL: U2.2 (SCL), U3.2 (SCL), U4.2 (SCL); also elsewhere on the board
SDA: U2.1 (SDA), U3.1 (SDA), U4.1 (SDA); also elsewhere on the board

Notes on the sheet:
Temperature Sensors
Mounting Holes
+28V Supply
Info
0x19
Power requirements per subsystem OBC: 28v to 3.3v @ 2A Jetson: 28v to 20v @ 6A Perif: 28v to 5v @ 2A Power on sequencing: OBC powers when Vbatt is supplied. OBC controls operation of the Jetson as well as the Peripheral system via GPIO pins to the respective subsystem load switch. Startup time for 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
Signal point ground from power board to rest of system
Vbatt = [24.0, 28.8, 33.6] Due to Li-ion battery charged and discharged states
I2C Addresses Being Used: INA260 OBC Subsystem: 0x41 (01000001) INA260 Perif. Subsystem: 0x45 (01000101) INA260 Jetson Subsystem: 0x40 (01000000) MCP9808 OBC Subsystem: 0x19 (0001 1001) MCP9808 Perif. Subsystem: 0x1A (0001 1010) MCP9808 Jet. Subsystem: 0x1B (0001 1011)
EPS Block Diagram
0x1B
EPS WD/Power On Conn. Ops
0x1A

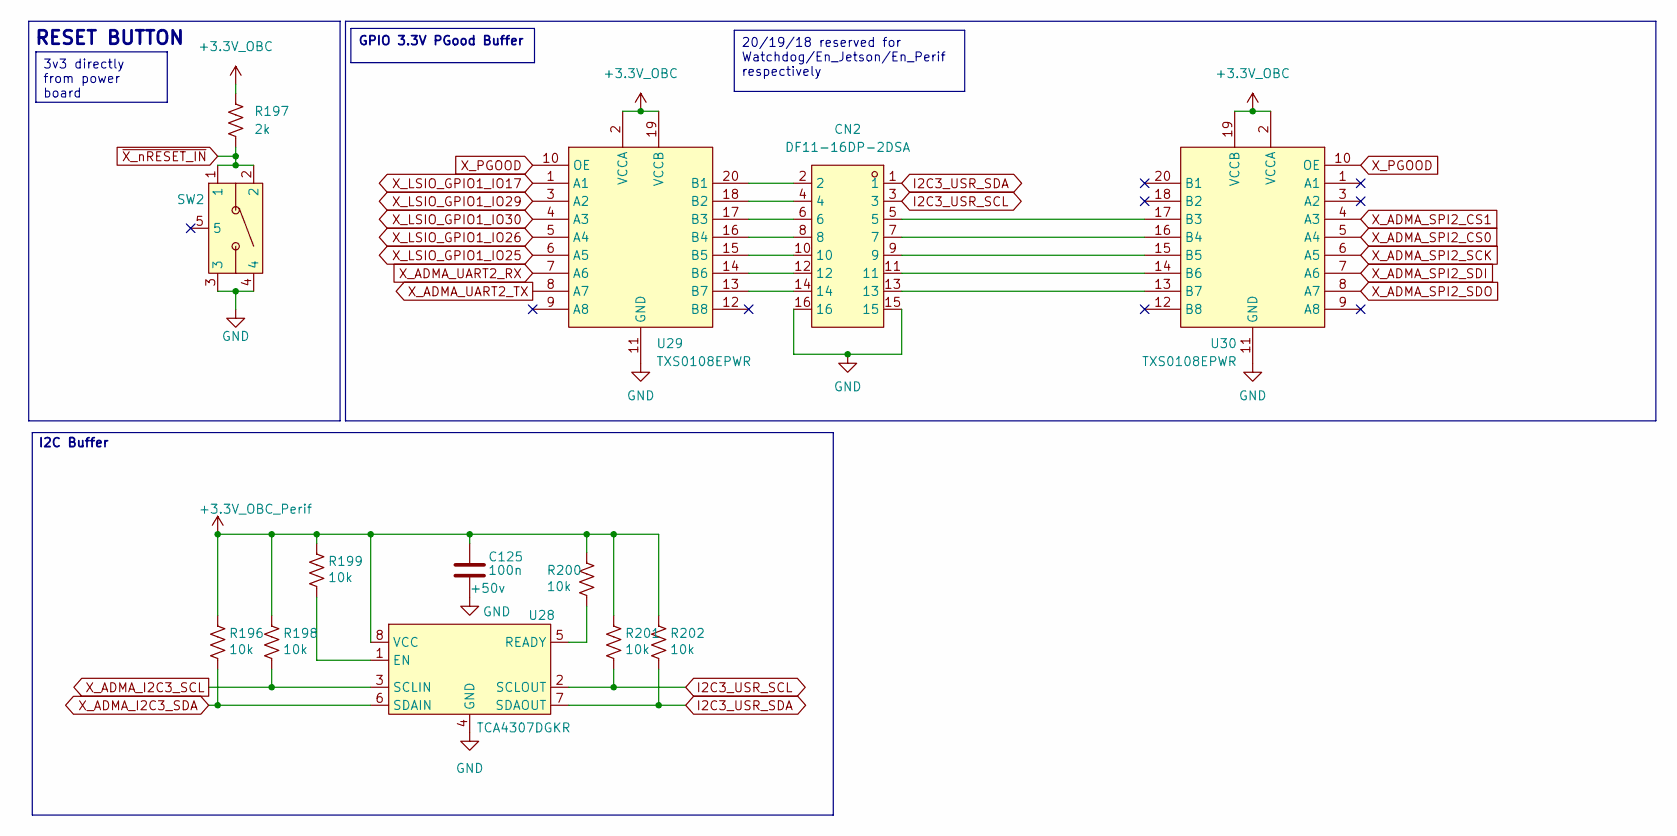
[picture p190: schematic periphCon.kicad_sch, Leviathan V2]

Parts:
C125: 100n; C0402; Voltage Rating +50v; LCSC C85858
CN2: DF11-16DP-2DSA; CONN-TH_DF11-16DP-2DSA-08; LCSC Part C530981
R196, R198, R199, R200, R201, R202: 10k; R_0603_1608Metric; LCSC C99782
R197: 2k; R0402
SW2: KMR221GLFS; KEY-SMD_KMR2XXGXXX; LCSC Part C72443
U28: TCA4307DGKR; VSSOP-8_L3.0-W3.0-P0.65-LS4.9-BL; LCSC Part C880333
U29, U30: TXS0108EPWR; TSSOP-20_L6.5-W4.4-P0.65-LS6.4-BL; LCSC Part C17206

Connections:
+3.3V_OBC: R197.1, U29.2 (VCCA), U29.19 (VCCB), U30.2 (VCCA), U30.19 (VCCB); also elsewhere on the board
+3.3V_OBC_Perif: C125.1, R196.1, R198.1, R199.1, R200.1, R201.1, R202.1, U28.8 (VCC); also elsewhere on the board
GND: C125.2, CN2.15, CN2.16, SW2.3, SW2.4, U28.4 (GND), U29.11 (GND), U30.11 (GND); also elsewhere on the board
I2C3_USR_SCL: CN2.3, R201.2, U28.2 (SCLOUT)
I2C3_USR_SDA: CN2.1, R202.2, U28.7 (SDAOUT)
unnamed: R199.2, U28.1 (EN)
unnamed: R200.2, U28.5 (READY)
unnamed: CN2.2, U29.20 (B1)
unnamed: CN2.4, U29.18 (B2)
unnamed: CN2.6, U29.17 (B3)
unnamed: CN2.8, U29.16 (B4)
unnamed: CN2.10, U29.15 (B5)
unnamed: CN2.12, U29.14 (B6)
unnamed: CN2.14, U29.13 (B7)
unnamed: CN2.5, U30.17 (B3)
unnamed: CN2.7, U30.16 (B4)
unnamed: CN2.9, U30.15 (B5)
unnamed: CN2.11, U30.14 (B6)
unnamed: CN2.13, U30.13 (B7)
X_ADMA_I2C3_SCL: R198.2, U28.3 (SCLIN); also elsewhere on the board
X_ADMA_I2C3_SDA: R196.2, U28.6 (SDAIN); also elsewhere on the board
X_ADMA_SPI2_CS0: U30.5 (A4); also elsewhere on the board
X_ADMA_SPI2_CS1: U30.4 (A3); also elsewhere on the board
X_ADMA_SPI2_SCK: U30.6 (A5); also elsewhere on the board
X_ADMA_SPI2_SDI: U30.7 (A6); also elsewhere on the board
X_ADMA_SPI2_SDO: U30.8 (A7); also elsewhere on the board
X_ADMA_UART2_RX: U29.7 (A6); also elsewhere on the board
X_ADMA_UART2_TX: U29.8 (A7); also elsewhere on the board
X_LSIO_GPIO1_IO17: U29.1 (A1); also elsewhere on the board
X_LSIO_GPIO1_IO25: U29.6 (A5); also elsewhere on the board
X_LSIO_GPIO1_IO26: U29.5 (A4); also elsewhere on the board
X_LSIO_GPIO1_IO29: U29.3 (A2); also elsewhere on the board
X_LSIO_GPIO1_IO30: U29.4 (A3); also elsewhere on the board
X_PGOOD: U29.10 (OE), U30.10 (OE); also elsewhere on the board
~X_nRESET_IN: R197.2, SW2.1, SW2.2; also elsewhere on the board

Notes on the sheet:
I2C Buffer
RESET BUTTON
20/19/18 reserved for Watchdog/En_Jetson/En_Perif respectively
3v3 directly from power board
GPIO 3.3V PGood Buffer

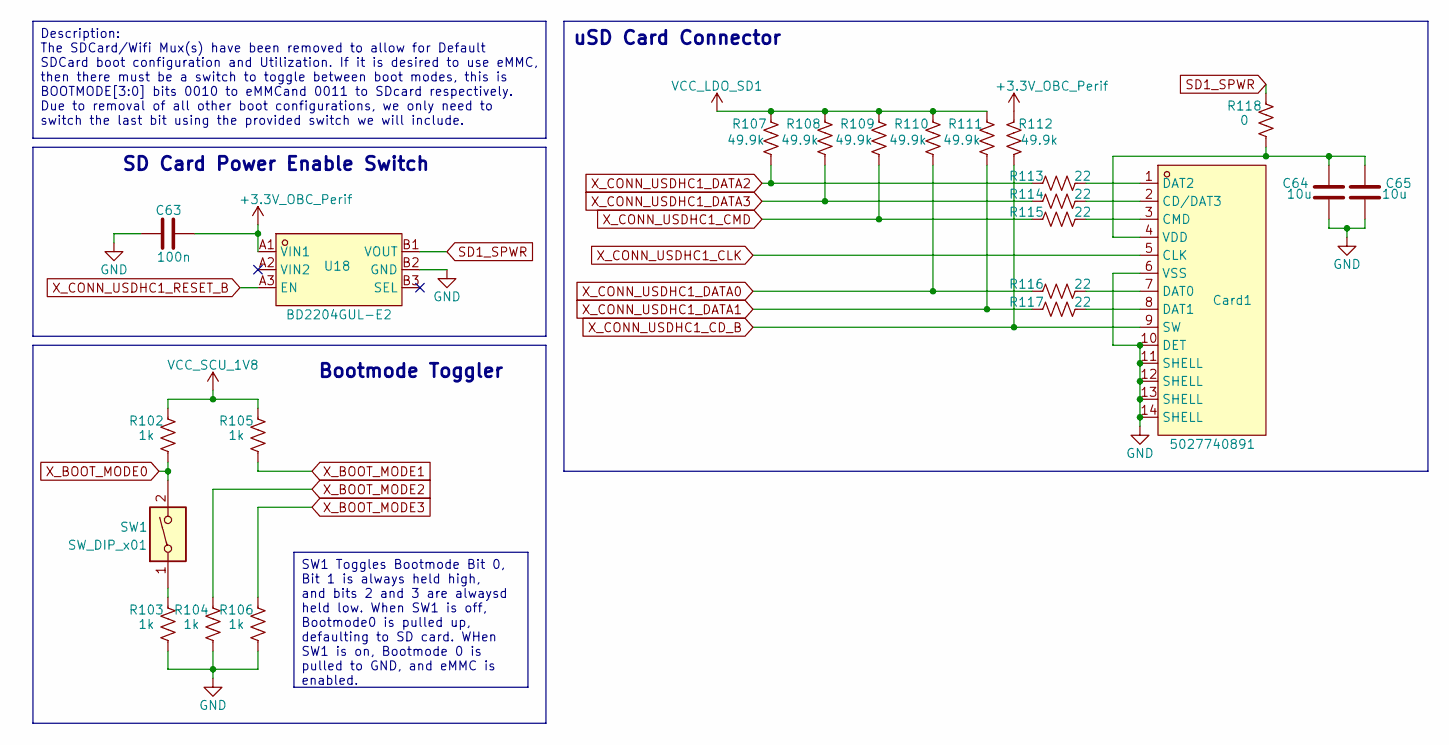
[picture p191: schematic bootConfig.kicad_sch, Leviathan V2]

Parts:
C63: 100n; C0402
C64, C65: 10u; C0402
Card1: 5027740891; TF-SMD_5027740891; LCSC Part C330255
R102, R103, R104, R105, R106: 1k; R0402
R107, R108, R109, R110, R111, R112: 49.9k; R0402
R113, R114, R115, R116, R117: 22; R0402
R118: 0; R0402
SW1: SW_DIP_x01; SW-SMD_1.27-1P-TPPT
U18: BD2204GUL-E2; BGA-6_L1.5-W1.0-P0.50_BD2204GUL-E2; LCSC Part C314699

Connections:
+3.3V_OBC_Perif: C63.2, R112.2, U18.A1 (VIN1); also elsewhere on the board
GND: C63.1, C64.1, C65.1, Card1.6 (VSS), Card1.10 (DET), Card1.11 (SHELL), Card1.12 (SHELL), Card1.13 (SHELL), Card1.14 (SHELL), R103.1, R104.1, R106.1, U18.B2 (GND); also elsewhere on the board
unnamed: Card1.2 (CD/DAT3), R114.1
unnamed: Card1.3 (CMD), R115.1
unnamed: Card1.7 (DAT0), R116.1
unnamed: Card1.8 (DAT1), R117.1
unnamed: Card1.1 (DAT2), R113.1
unnamed: C64.2, C65.2, Card1.4 (VDD), R118.1
unnamed: R103.2, SW1.1
SD1_SPWR: R118.2, U18.B1 (VOUT)
VCC_LDO_SD1: R107.2, R108.2, R109.2, R110.2, R111.2; also elsewhere on the board
VCC_SCU_1V8: R102.2, R105.2; also elsewhere on the board
X_BOOT_MODE0: R102.1, SW1.2; also elsewhere on the board
X_BOOT_MODE1: R105.1; also elsewhere on the board
X_BOOT_MODE2: R104.2; also elsewhere on the board
X_BOOT_MODE3: R106.2; also elsewhere on the board
X_CONN_USDHC1_CD_B: Card1.9 (SW), R112.1; also elsewhere on the board
X_CONN_USDHC1_CLK: Card1.5 (CLK); also elsewhere on the board
X_CONN_USDHC1_CMD: R109.1, R115.2; also elsewhere on the board
X_CONN_USDHC1_DATA0: R110.1, R116.2; also elsewhere on the board
X_CONN_USDHC1_DATA1: R111.1, R117.2; also elsewhere on the board
X_CONN_USDHC1_DATA2: R107.1, R113.2; also elsewhere on the board
X_CONN_USDHC1_DATA3: R108.1, R114.2; also elsewhere on the board
X_CONN_USDHC1_RESET_B: U18.A3 (EN); also elsewhere on the board

Notes on the sheet:
uSD Card Connector
SD Card Power Enable Switch
Bootmode Toggler
Description: The SDCard/Wifi Mux(s) have been removed to allow for Default SDCard boot configuration and Utilization. If it is desired to use eMMC, then there must be a switch to toggle between boot modes, this is BOOTMODE[3:0] bits 0010 to eMMCand 0011 to SDcard respectively. Due to removal of all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
SW1 Toggles Bootmode Bit 0, Bit 1 is always held high, and bits 2 and 3 are alwaysd held low. When SW1 is off, Bootmode0 is pulled up, defaulting to SD card. WHen SW1 is on, Bootmode 0 is pulled to GND, and eMMC is enabled.

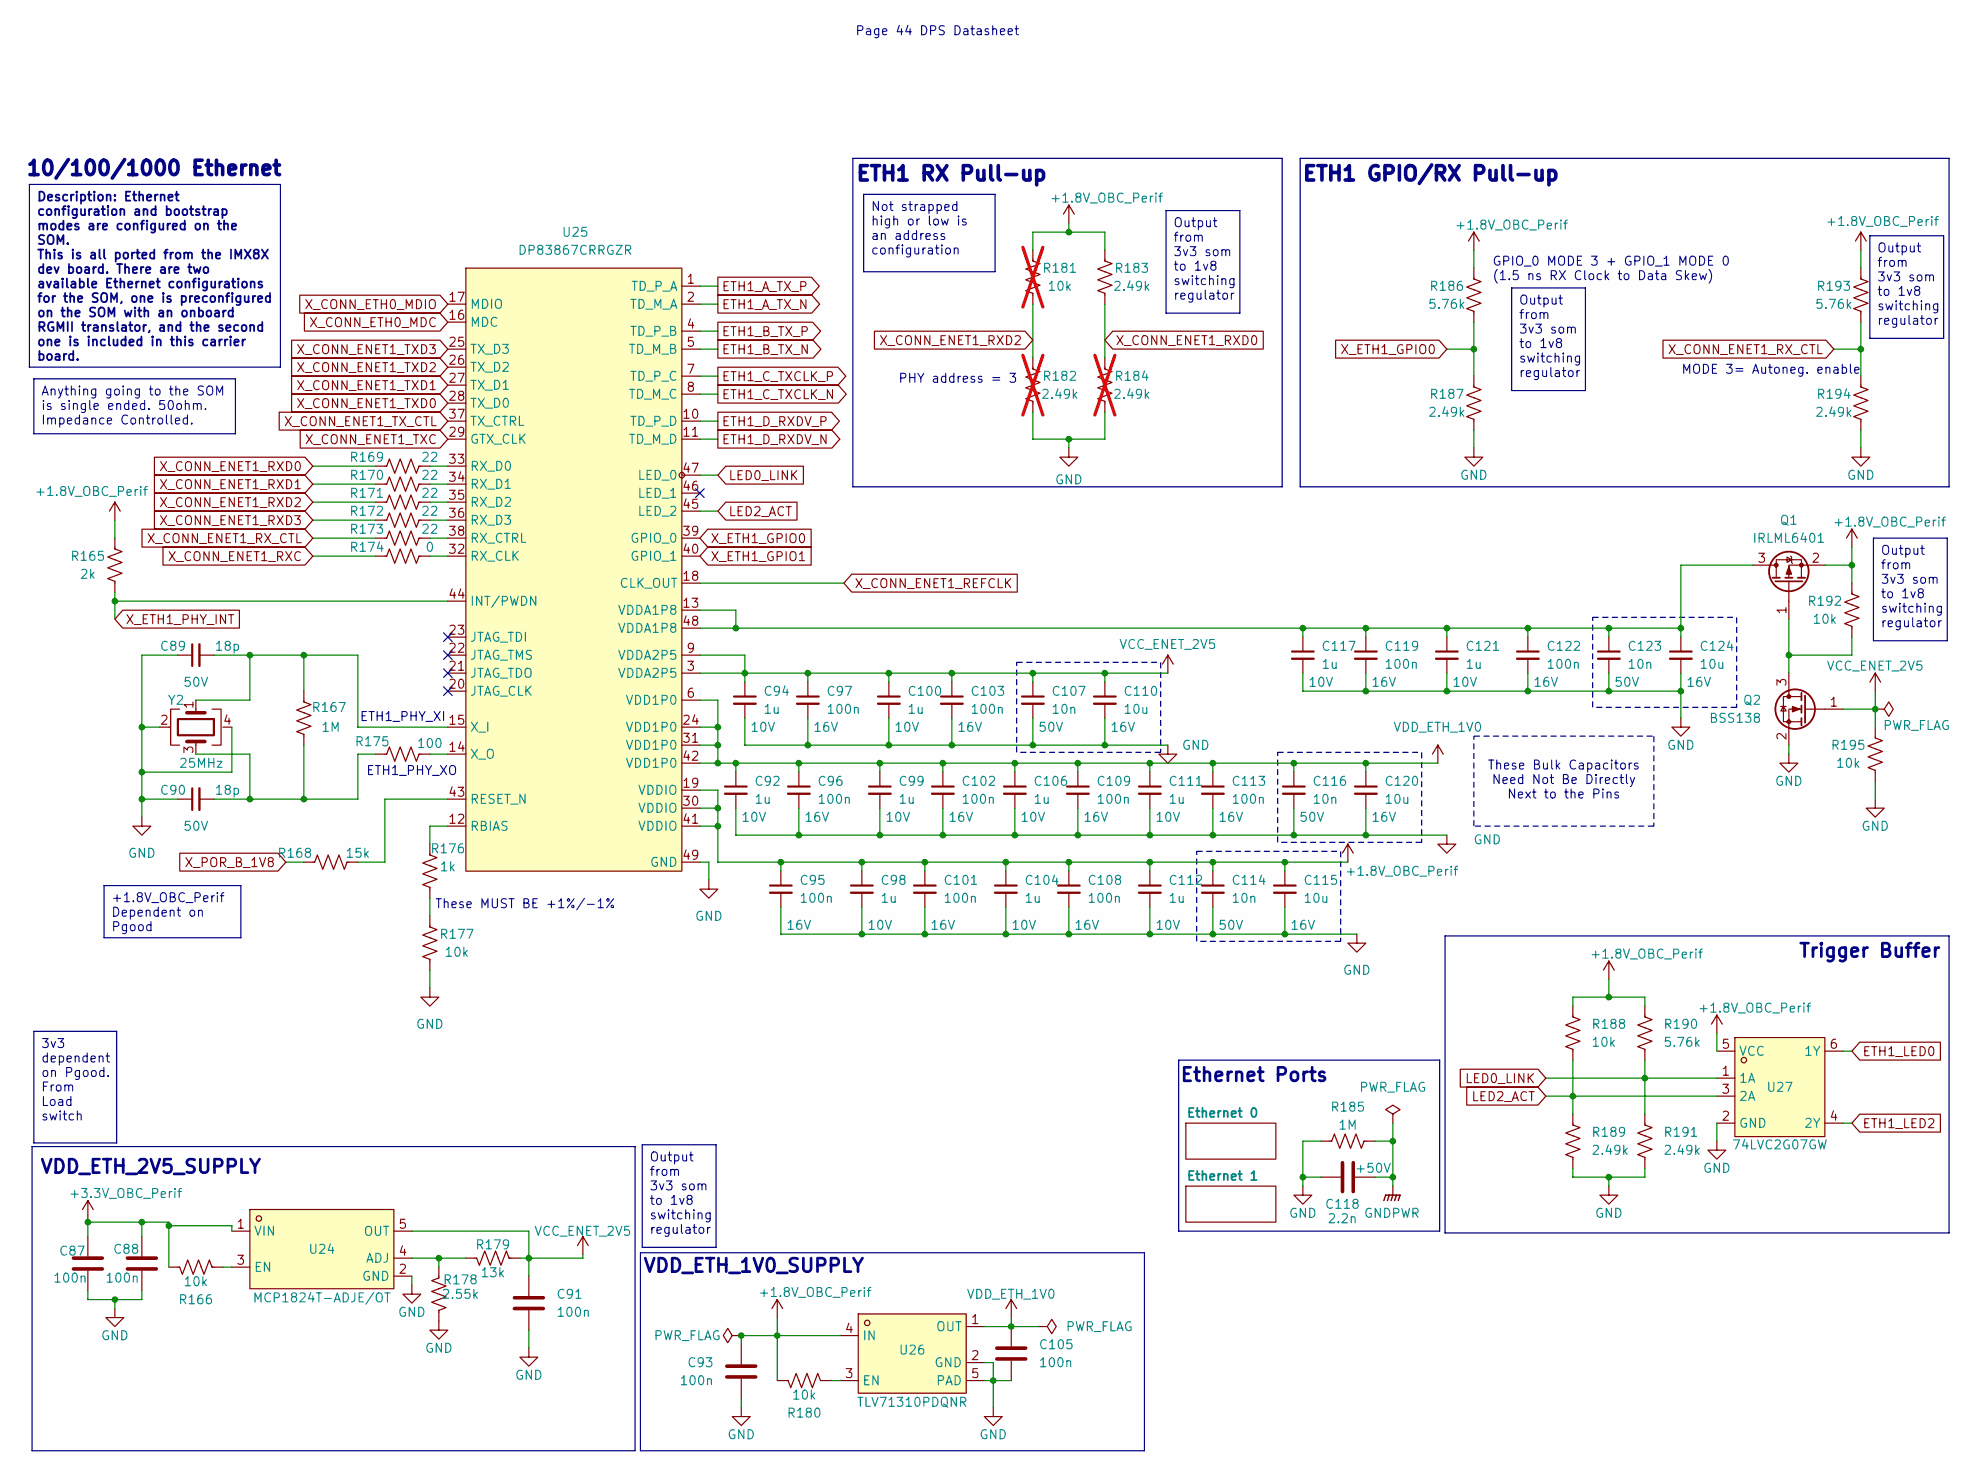
[picture p192: schematic ethernet.kicad_sch, Leviathan V2]

Parts:
C87, C88, C91, C93, C105: 100n; C0402
C89, C90: 18p; C_0603_1608Metric; Voltage 50V
C92, C94, C98, C99, C100, C104, C106, C111, C112, C117, C121: 1u; C_0603_1608Metric; Voltage 10V
C95, C96, C97, C101, C102, C103, C108, C109, C113, C119, C122: 100n; C_0603_1608Metric; Voltage 16V
C107, C114, C116, C123: 10n; C_0603_1608Metric; Voltage 50V
C110, C115, C120, C124: 10u; C_0603_1608Metric; Voltage 16V
C118: 2.2n; C0402; Voltage Rating +50V
Q1: IRLML6401; SOT-23
Q2: BSS138; SOT-23
R165: 2k; R_0402_1005Metric
R166, R180, R188: 10k; R0402
R167: 1M; R_0402_1005Metric
R168: 15k; R_0402_1005Metric
R169, R170, R171, R172, R173: 22; R_0402_1005Metric
R174: 0; R_0402_1005Metric
R175: 100; R_0402_1005Metric
R176: 1k; R_0402_1005Metric
R177, R192, R195: 10k; R_0402_1005Metric
R178: 2.55k; R0402
R179: 13k; R0402
R181: 10k; R_0402_1005Metric; not fitted
R182, R184: 2.49k; R_0402_1005Metric; not fitted
R183, R187, R194: 2.49k; R_0402_1005Metric
R185: 1M; R0402
R186, R193: 5.76k; R_0402_1005Metric
R189, R191: 2.49k; R0402
R190: 5.76k; R0402
U24: MCP1824T-ADJE/OT; SOT-23-5_L3.0-W1.7-P0.95-LS2.8-BL; LCSC Part C145717
U25: DP83867CRRGZR; VQFN-48_L7.0-W7.0-P0.50-BL-EP4.1; LCSC Part C544766
U26: TLV71310PDQNR; X2SON-4_L1.0-W1.0-P0.65-TL-EP; LCSC Part C2872754
U27: 74LVC2G07GW; SOT-363_L2.1-W1.3-P0.65-LS2.2-BL; LCSC Part C19829574
Y2: 25MHz; CRYSTAL-SMD_4P-L3.2-W2.5-BL-2; LCSC C13740

Connections:
+1.8V_OBC_Perif: C93.1, C95.1, C98.1, C101.1, C104.1, C108.1, C112.1, C114.1, C115.1, Q1.2 (S), R165.2, R180.1, R181.1, R183.1, R186.1, R188.1, R190.1, R192.1, R193.1, U25.19 (VDDIO), U25.30 (VDDIO), U25.41 (VDDIO), U26.4 (IN), U27.5 (VCC); also elsewhere on the board
+3.3V_OBC_Perif: C87.1, C88.1, R166.1, U24.1 (VIN); also elsewhere on the board
ETH1_A_TX_N: U25.2 (TD_M_A); also elsewhere on the board
ETH1_A_TX_P: U25.1 (TD_P_A); also elsewhere on the board
ETH1_B_TX_N: U25.5 (TD_M_B); also elsewhere on the board
ETH1_B_TX_P: U25.4 (TD_P_B); also elsewhere on the board
ETH1_C_TXCLK_N: U25.8 (TD_M_C); also elsewhere on the board
ETH1_C_TXCLK_P: U25.7 (TD_P_C); also elsewhere on the board
ETH1_D_RXDV_N: U25.11 (TD_M_D); also elsewhere on the board
ETH1_D_RXDV_P: U25.10 (TD_P_D); also elsewhere on the board
ETH1_LED0: U27.6 (1Y); also elsewhere on the board
ETH1_LED2: U27.4 (2Y); also elsewhere on the board
GND: C87.2, C88.2, C89.1, C90.1, C91.2, C92.2, C93.2, C94.2, C95.2, C96.2, C97.2, C98.2, C99.2, C100.2, C101.2, C102.2, C103.2, C104.2, C105.2, C106.2, C107.2, C108.2, C109.2, C110.2, C111.2, C112.2, C113.2, C114.2, C115.2, C116.2, C117.2, C118.2, C119.2, C120.2, C121.2, C122.2, C123.2, C124.2, Q2.2 (S), R177.2, R178.1, R182.2, R184.2, R185.1, R187.2, R189.2, R191.2, R194.2, R195.2, U24.2 (GND), U25.49 (GND), U26.2 (GND), U26.5 (PAD), U27.2 (GND), Y2.2 (G), Y2.4 (G); also elsewhere on the board
GNDPWR: C118.1, R185.2; also elsewhere on the board
LED0_LINK: R190.2, R191.1, U25.47 (LED_0), U27.1 (1A)
LED2_ACT: R188.2, R189.1, U25.45 (LED_2), U27.3 (2A)
unnamed: C90.2, R167.2, R175.1, Y2.3
unnamed: C117.1, C119.1, C121.1, C122.1, C123.1, C124.1, Q1.3 (D), U25.13 (VDDA1P8), U25.48 (VDDA1P8)
unnamed: Q1.1 (G), Q2.3 (D), R192.2
unnamed: R176.2, R177.1
unnamed: R178.2, R179.1, U24.4 (ADJ)
unnamed: R166.2, U24.3 (EN)
unnamed: R176.1, U25.12 (RBIAS)
unnamed: R168.1, U25.43 (RESET_N)
unnamed: R174.1, U25.32 (RX_CLK)
unnamed: R173.1, U25.38 (RX_CTRL)
unnamed: R169.1, U25.33 (RX_D0)
unnamed: R170.1, U25.34 (RX_D1)
unnamed: R171.1, U25.35 (RX_D2)
unnamed: R172.1, U25.36 (RX_D3)
unnamed: C89.2, R167.1, U25.15 (X_I), Y2.1
unnamed: R175.2, U25.14 (X_O)
unnamed: R180.2, U26.3 (EN)
VCC_ENET_2V5: C91.1, C94.1, C97.1, C100.1, C103.1, C107.1, C110.1, Q2.1 (G), R179.2, R195.1, U24.5 (OUT), U25.3 (VDDA2P5), U25.9 (VDDA2P5)
VDD_ETH_1V0: C92.1, C96.1, C99.1, C102.1, C105.1, C106.1, C109.1, C111.1, C113.1, C116.1, C120.1, U25.6 (VDD1P0), U25.24 (VDD1P0), U25.31 (VDD1P0), U25.42 (VDD1P0), U26.1 (OUT)
X_CONN_ENET1_REFCLK: U25.18 (CLK_OUT); also elsewhere on the board
X_CONN_ENET1_RXC: R174.2; also elsewhere on the board
X_CONN_ENET1_RXD0: R169.2, R183.2, R184.1; also elsewhere on the board
X_CONN_ENET1_RXD1: R170.2; also elsewhere on the board
X_CONN_ENET1_RXD2: R171.2, R181.2, R182.1; also elsewhere on the board
X_CONN_ENET1_RXD3: R172.2; also elsewhere on the board
X_CONN_ENET1_RX_CTL: R173.2, R193.2, R194.1; also elsewhere on the board
X_CONN_ENET1_TXC: U25.29 (GTX_CLK); also elsewhere on the board
X_CONN_ENET1_TXD0: U25.28 (TX_D0); also elsewhere on the board
X_CONN_ENET1_TXD1: U25.27 (TX_D1); also elsewhere on the board
X_CONN_ENET1_TXD2: U25.26 (TX_D2); also elsewhere on the board
X_CONN_ENET1_TXD3: U25.25 (TX_D3); also elsewhere on the board
X_CONN_ENET1_TX_CTL: U25.37 (TX_CTRL); also elsewhere on the board
X_CONN_ETH0_MDC: U25.16 (MDC); also elsewhere on the board
X_CONN_ETH0_MDIO: U25.17 (MDIO); also elsewhere on the board
X_ETH1_GPIO0: R186.2, R187.1, U25.39 (GPIO_0); also elsewhere on the board
X_ETH1_GPIO1: U25.40 (GPIO_1); also elsewhere on the board
X_ETH1_PHY_INT: R165.1, U25.44 (INT/PWDN); also elsewhere on the board
X_POR_B_1V8: R168.2; also elsewhere on the board

Notes on the sheet:
VDD_ETH_2V5_SUPPLY
Page 44 DPS Datasheet
These MUST BE +1%/-1%
Trigger Buffer
GPIO_0 MODE 3 + GPIO_1 MODE 0 (1.5 ns RX Clock to Data Skew)
Ethernet Ports
ETH1 GPIO/RX Pull-up
ETH1_PHY_XI
MODE 3= Autoneg. enable
PHY address = 3
VDD_ETH_1V0_SUPPLY
ETH1 RX Pull-up
10/100/1000 Ethernet
These Bulk Capacitors Need Not Be Directly Next to the Pins
ETH1_PHY_XO
Output from 3v3 som to 1v8 switching regulator
Anything going to the SOM is single ended. 50ohm. Impedance Controlled.
Not strapped high or low is an address configuration
+1.8V_OBC_Perif Dependent on Pgood
3v3 dependent on Pgood. From Load switch
Description: Ethernet configuration and bootstrap modes are configured on the SOM. This is all ported from the IMX8X dev board. There are two available Ethernet configurations for the SOM, one is preconfigured on the SOM with an onboard RGMII translator, and the second one is included in this carri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
