BroncoSpace-Lab/scales-hardware/imx8x_eps_leviathan_v2/imx8x_eps_leviathan_v2.kicad_pcb

## KiCad design imx8x_eps_leviathan_v2/imx8x_eps_leviathan_v2.kicad_pcb (continued)

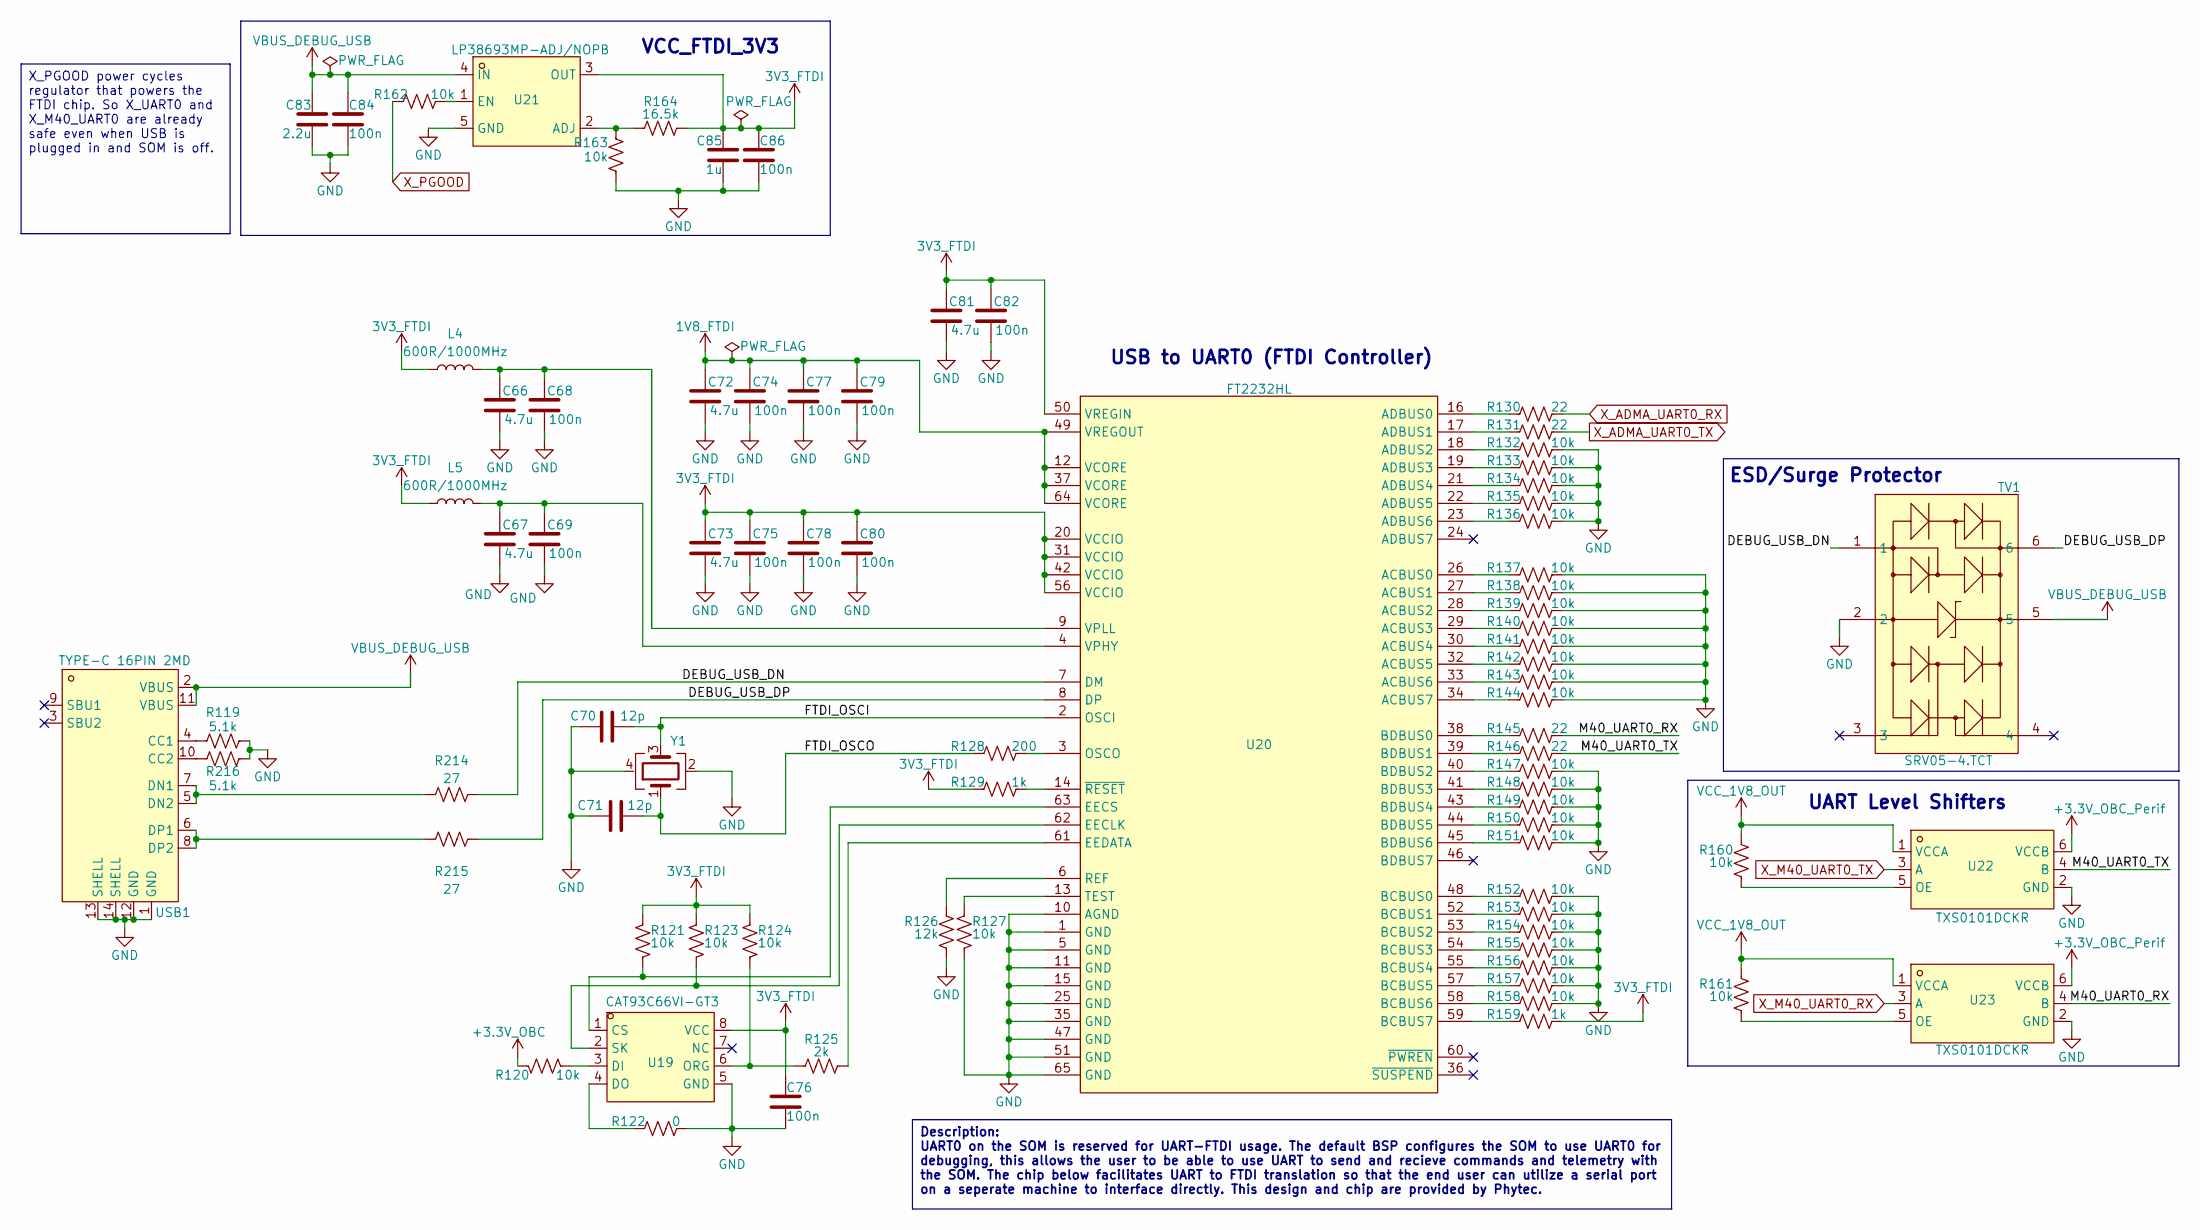
[picture p193: schematic debug.kicad_sch, Leviathan V2]

Parts:
C66, C67, C72, C73, C81: 4.7u; C0402
C68, C69, C74, C75, C76, C77, C78, C79, C80, C82, C84, C86: 100n; C0402
C70, C71: 12p; C0402
C83: 2.2u; C0402
C85: 1u; C0402
L4, L5: 600R/1000MHz; L0805
R119, R216: 5.1k; R0402
R120, R121, R123, R124, R127, R132, R133, R134, R135, R136, R137, R138, R139, R140, R141, R142, R143, R144, R147, R148, R149, R150, R151, R152, R153, R154, R155, R156, R157, R158, R160, R161, R162, R163: 10k; R0402
R122: 0; R0402
R125: 2k; R0402
R126: 12k; R0402
R128: 200; R0402
R129, R159: 1k; R0402
R130, R131, R145, R146: 22; R0402
R164: 16.5k; R0402
R214, R215: 27; R0402
TV1: SRV05-4.TCT; SOT-23-6_L2.9-W1.6-P0.95-LS2.8-BR; LCSC Part C13612
U19: CAT93C66VI-GT3; SOIC-8_L4.9-W3.9-P1.27-LS6.0-BL; LCSC Part C890471
U20: FT2232HL; QFN-64_L9.0-W9.0-P0.50-TL-EP4.3; LCSC Part C27882
U21: LP38693MP-ADJ/NOPB; SOT-223-5_L6.5-W3.5-P1.50-LS7.0-BL; LCSC Part C181420
U22, U23: TXS0101DCKR; SC-70-6_L2.0-W1.3-P0.65-LS2.1-BR; LCSC Part C132031
USB1: TYPE-C 16PIN 2MD; USB-C-SMD_TYPE-C-6PIN-2MD-073; MPN TYPE-C 16PIN 2MD(073); LCSC Part C2765186
Y1: Crystal_GND24; CRYSTAL-SMD_4P-L3.2-W2.5-BL

Connections:
1V8_FTDI: C72.2, C74.2, C77.2, C79.2, U20.12 (VCORE), U20.37 (VCORE), U20.49 (VREGOUT), U20.64 (VCORE)
3V3_FTDI: C73.2, C75.2, C76.2, C78.2, C80.2, C81.2, C82.2, C85.2, C86.2, L4.1, L5.1, R121.2, R123.2, R124.2, R129.2, R159.1, R164.1, U19.8 (VCC), U20.20 (VCCIO), U20.31 (VCCIO), U20.42 (VCCIO), U20.50 (VREGIN), U20.56 (VCCIO), U21.3 (OUT)
+3.3V_OBC: R120.2; also elsewhere on the board
+3.3V_OBC_Perif: U22.6 (VCCB), U23.6 (VCCB); also elsewhere on the board
/IMX8XQXP SCALES Mariner Carrier Board/Debug USB - UART/DEBUG_USB_DN: R214.2, TV1.1, U20.7 (DM)
/IMX8XQXP SCALES Mariner Carrier Board/Debug USB - UART/DEBUG_USB_DP: R215.2, TV1.6, U20.8 (DP)
/IMX8XQXP SCALES Mariner Carrier Board/Debug USB - UART/FTDI_OSCI: C70.1, U20.2 (OSCI), Y1.3
/IMX8XQXP SCALES Mariner Carrier Board/Debug USB - UART/FTDI_OSCO: C71.1, R128.2, Y1.1
/IMX8XQXP SCALES Mariner Carrier Board/Debug USB - UART/M40_UART0_RX: R145.1, U23.4 (B)
/IMX8XQXP SCALES Mariner Carrier Board/Debug USB - UART/M40_UART0_TX: R146.1, U22.4 (B)
GND: C66.1, C67.1, C68.1, C69.1, C70.2, C71.2, C72.1, C73.1, C74.1, C75.1, C76.1, C77.1, C78.1, C79.1, C80.1, C81.1, C82.1, C83.1, C84.1, C85.1, C86.1, R119.2, R122.1, R126.1, R127.1, R132.1, R133.1, R134.1, R135.1, R136.1, R137.1, R138.1, R139.1, R140.1, R141.1, R142.1, R143.1, R144.1, R147.1, R148.1, R149.1, R150.1, R151.1, R152.1, R153.1, R154.1, R155.1, R156.1, R157.1, R158.1, R163.1, R216.2, TV1.2, U19.5 (GND), U20.1 (GND), U20.5 (GND), U20.10 (AGND), U20.11 (GND), U20.15 (GND), U20.25 (GND), U20.35 (GND), U20.47 (GND), U20.51 (GND), U20.65 (GND), U21.5 (GND), U22.2 (GND), U23.2 (GND), USB1.1 (GND), USB1.12 (GND), USB1.13 (SHELL), USB1.14 (SHELL), Y1.2 (G), Y1.4 (G); also elsewhere on the board
unnamed: R121.1, U19.1 (CS), U20.63 (EECS)
unnamed: R120.1, U19.3 (DI)
unnamed: R122.2, U19.4 (DO)
unnamed: R124.1, R125.2, U19.6 (ORG)
unnamed: R123.1, U19.2 (SK), U20.62 (EECLK)
unnamed: R137.2, U20.26 (ACBUS0)
unnamed: R138.2, U20.27 (ACBUS1)
unnamed: R139.2, U20.28 (ACBUS2)
unnamed: R140.2, U20.29 (ACBUS3)
unnamed: R141.2, U20.30 (ACBUS4)
unnamed: R142.2, U20.32 (ACBUS5)
unnamed: R143.2, U20.33 (ACBUS6)
unnamed: R144.2, U20.34 (ACBUS7)
unnamed: R130.2, U20.16 (ADBUS0)
unnamed: R131.2, U20.17 (ADBUS1)
unnamed: R132.2, U20.18 (ADBUS2)
unnamed: R133.2, U20.19 (ADBUS3)
unnamed: R134.2, U20.21 (ADBUS4)
unnamed: R135.2, U20.22 (ADBUS5)
unnamed: R136.2, U20.23 (ADBUS6)
unnamed: R152.2, U20.48 (BCBUS0)
unnamed: R153.2, U20.52 (BCBUS1)
unnamed: R154.2, U20.53 (BCBUS2)
unnamed: R155.2, U20.54 (BCBUS3)
unnamed: R156.2, U20.55 (BCBUS4)
unnamed: R157.2, U20.57 (BCBUS5)
unnamed: R158.2, U20.58 (BCBUS6)
unnamed: R159.2, U20.59 (BCBUS7)
unnamed: R145.2, U20.38 (BDBUS0)
unnamed: R146.2, U20.39 (BDBUS1)
unnamed: R147.2, U20.40 (BDBUS2)
unnamed: R148.2, U20.41 (BDBUS3)
unnamed: R149.2, U20.43 (BDBUS4)
unnamed: R150.2, U20.44 (BDBUS5)
unnamed: R151.2, U20.45 (BDBUS6)
unnamed: R125.1, U20.61 (EEDATA)
unnamed: R128.1, U20.3 (OSCO)
unnamed: R126.2, U20.6 (REF)
unnamed: R127.2, U20.13 (TEST)
unnamed: C67.2, C69.2, L5.2, U20.4 (VPHY)
unnamed: C66.2, C68.2, L4.2, U20.9 (VPLL)
unnamed: R129.1, U20.14 (~RESET)
unnamed: R163.2, R164.2, U21.2 (ADJ)
unnamed: R162.1, U21.1 (EN)
unnamed: R160.1, U22.5 (OE)
unnamed: R161.1, U23.5 (OE)
unnamed: R119.1, USB1.4 (CC1)
unnamed: R216.1, USB1.10 (CC2)
unnamed: R214.1, USB1.5 (DN2), USB1.7 (DN1)
unnamed: R215.1, USB1.6 (DP1), USB1.8 (DP2)
VBUS_DEBUG_USB: C83.2, C84.2, TV1.5, U21.4 (IN), USB1.2 (VBUS), USB1.11 (VBUS)
VCC_1V8_OUT: R160.2, R161.2, U22.1 (VCCA), U23.1 (VCCA); also elsewhere on the board
X_ADMA_UART0_RX: R130.1; also elsewhere on the board
X_ADMA_UART0_TX: R131.1; also elsewhere on the board
X_M40_UART0_RX: U23.3 (A); also elsewhere on the board
X_M40_UART0_TX: U22.3 (A); also elsewhere on the board
X_PGOOD: R162.2; also elsewhere on the board

Notes on the sheet:
UART Level Shifters
VCC_FTDI_3V3
USB to UART0 (FTDI Controller)
ESD/Surge Protector
Description: UART0 on the SOM is reserved for UART-FTDI usage. The default BSP configures the SOM to use UART0 for debugging, this allows the user to be able to use UART to send and recieve commands and telemetry with the SOM. The chip below facilitates UART to FTDI translation so that the end user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
X_PGOOD power cycles regulator that powers the FTDI chip. So X_UART0 and X_M40_UART0 are already safe even when USB is plugged in and SOM is off.

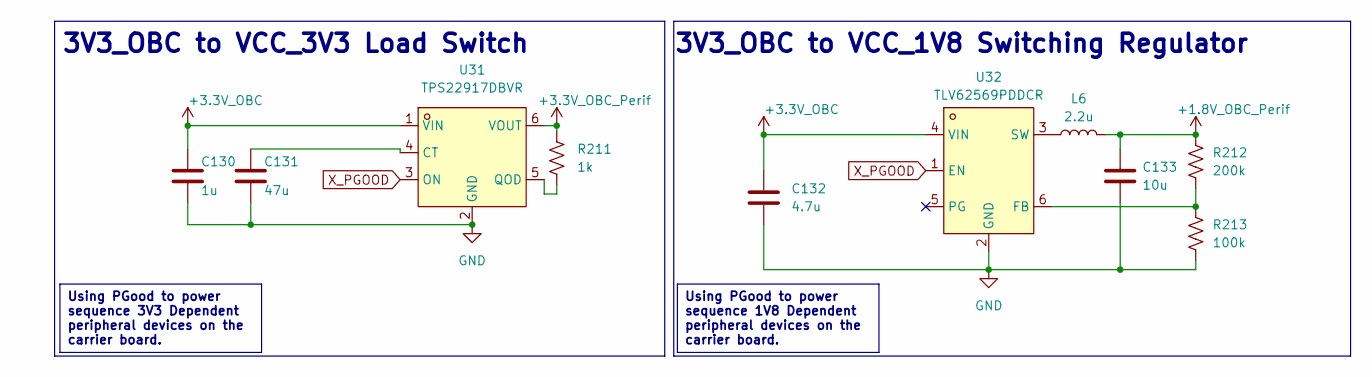
[picture p194: schematic Pgood_Power.kicad_sch, Leviathan V2]

Parts:
C130: 1u; C_0603_1608Metric
C131: 47u; C_0603_1608Metric
C132: 4.7u; C_0603_1608Metric
C133: 10u; C_0603_1608Metric
L6: 2.2u; IND-SMD_L2.5-W2.0_YXMBL252010P; LCSC Part C5349606
R211: 1k; R0402
R212: 200k; R0402
R213: 100k; R0402
U31: TPS22917DBVR; SOT-23-6_L2.9-W1.6-P0.95-LS2.8-BR; LCSC Part C2681320
U32: TLV62569PDDCR; SOT-23-6_L2.9-W1.6-P0.95-LS2.8-BL; LCSC Part C398365

Connections:
+1.8V_OBC_Perif: C133.1, L6.2, R212.1; also elsewhere on the board
+3.3V_OBC: C130.1, C132.1, U31.1 (VIN), U32.4 (VIN); also elsewhere on the board
+3.3V_OBC_Perif: R211.1, U31.6 (VOUT); also elsewhere on the board
GND: C130.2, C131.2, C132.2, C133.2, R213.2, U31.2 (GND), U32.2 (GND); also elsewhere on the board
unnamed: C131.1, U31.4 (CT)
unnamed: R211.2, U31.5 (QOD)
unnamed: R212.2, R213.1, U32.6 (FB)
unnamed: L6.1, U32.3 (SW)
X_PGOOD: U31.3 (ON), U32.1 (EN); also elsewhere on the board

Notes on the sheet:
3V3_OBC to VCC_3V3 Load Switch
3V3_OBC to VCC_1V8 Switching Regulator
Using PGood to power sequence 3V3 Dependent peripheral devices on the carrier board.
Using PGood to power sequence 1V8 Dependent peripheral devices on the carrier board.

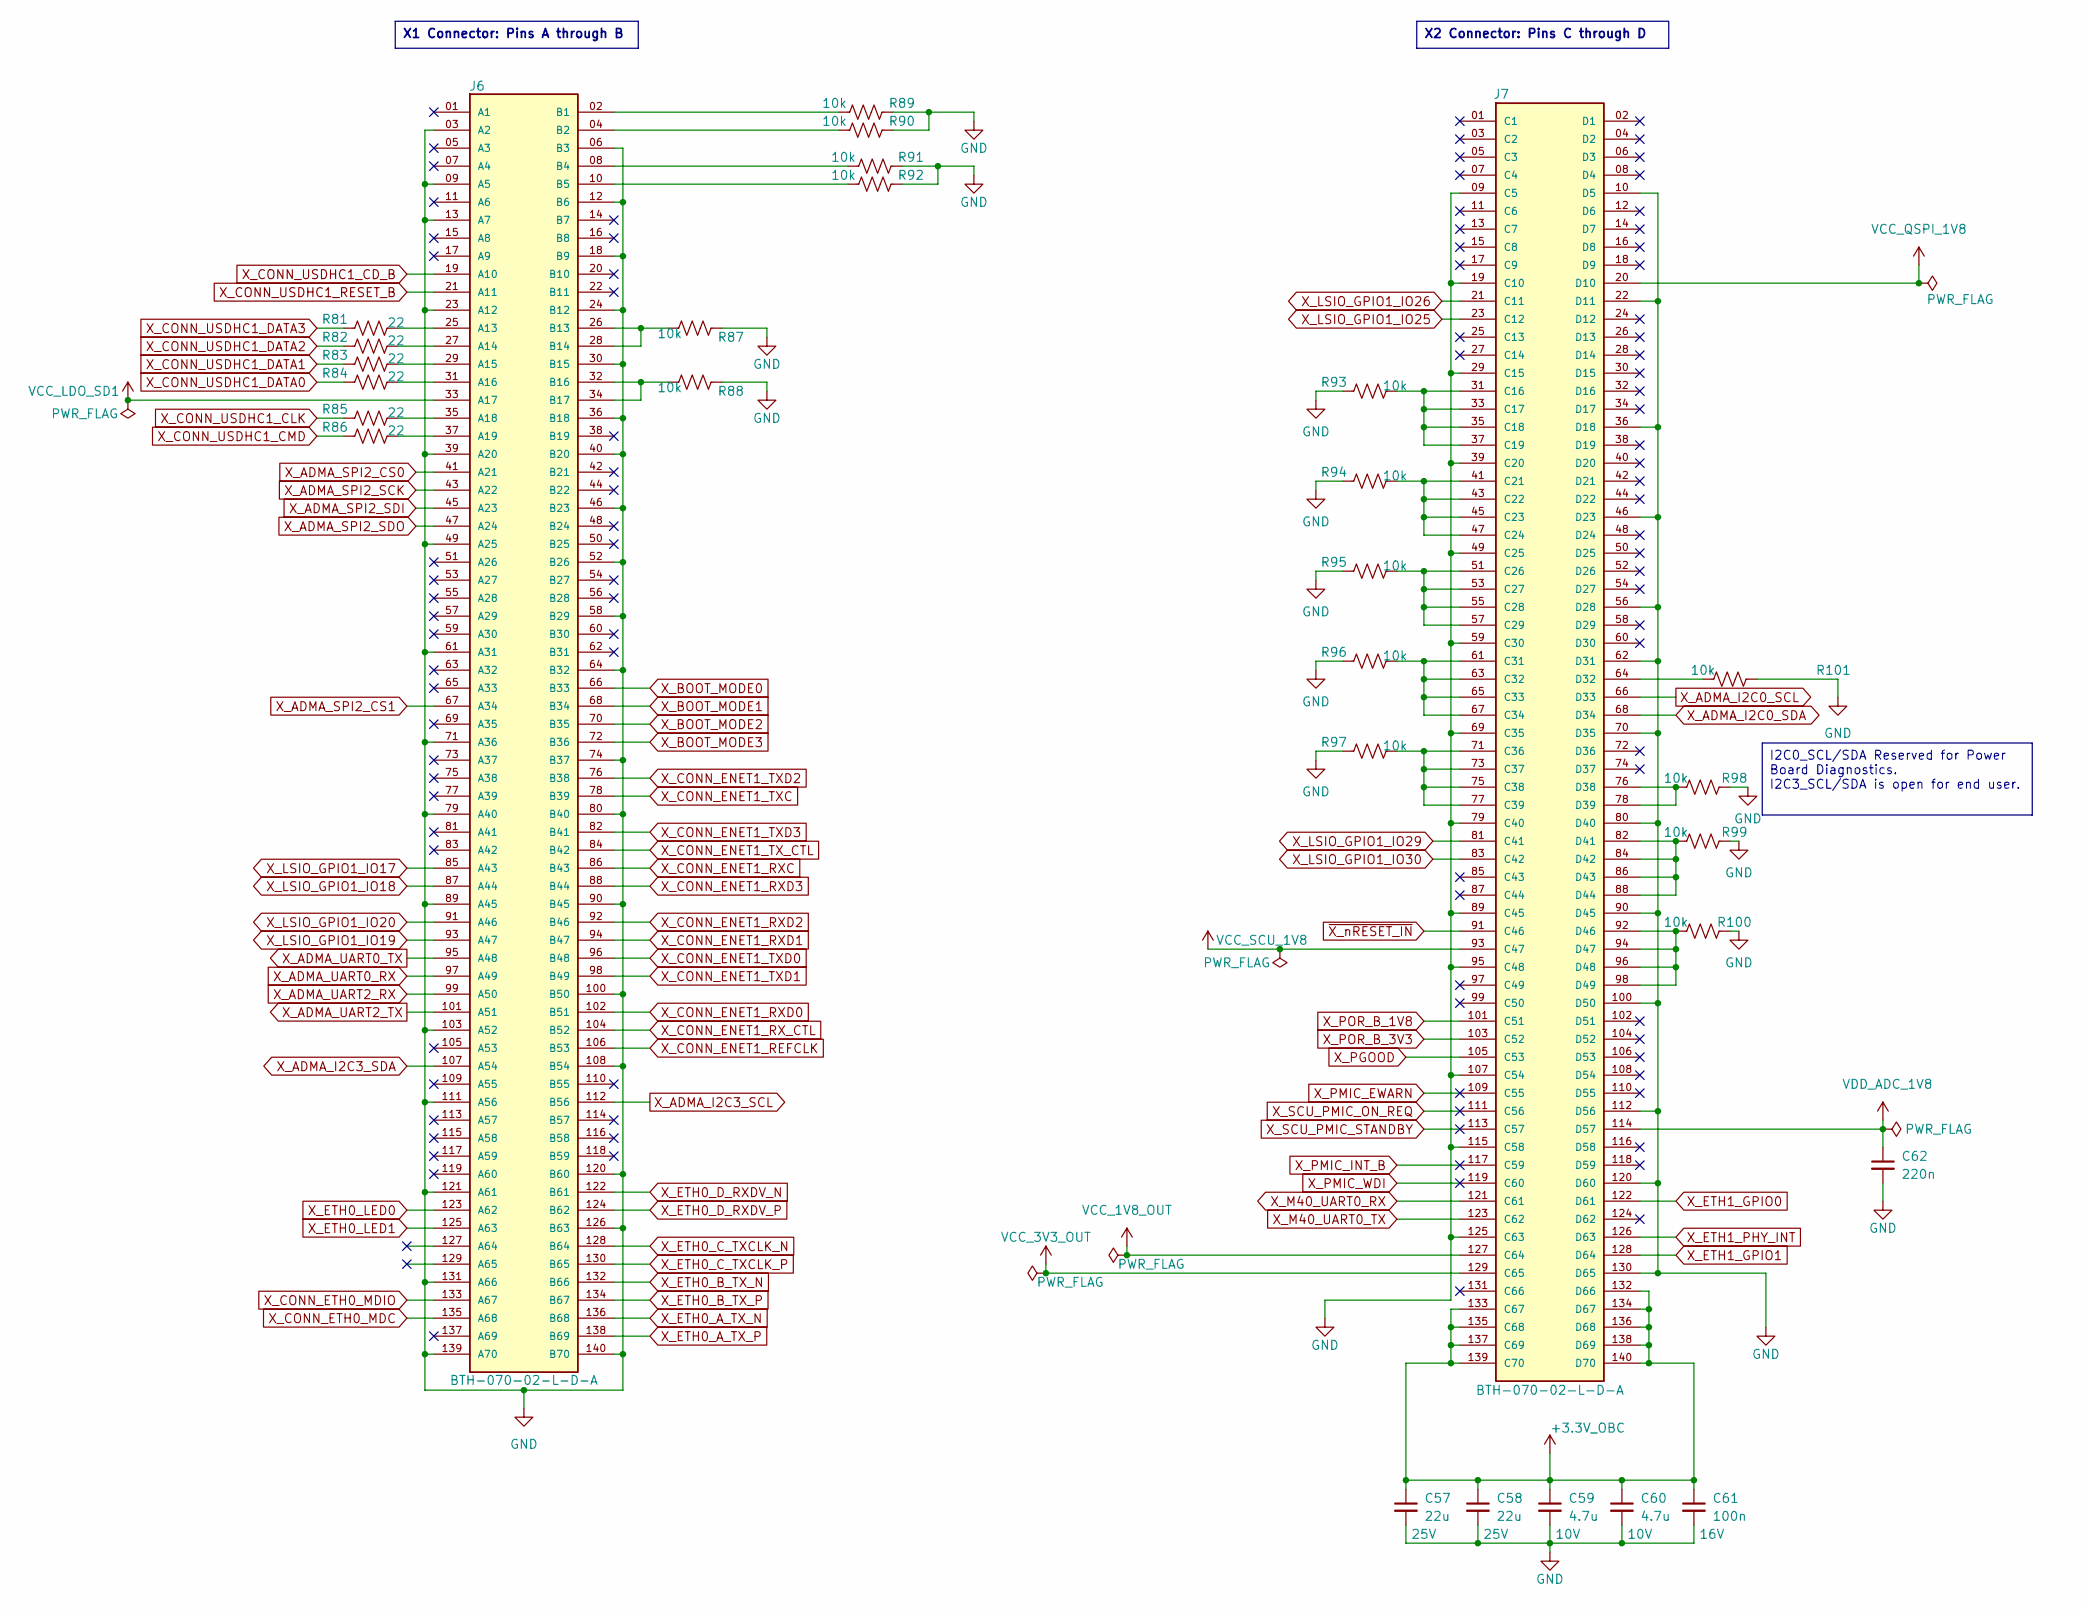
[picture p195: schematic SOM.kicad_sch, Leviathan V2]

Parts:
C57, C58: 22u; C_0603_1608Metric; Voltage 25V
C59, C60: 4.7u; C_0603_1608Metric; Voltage 10V
C61: 100n; C_0603_1608Metric; Voltage 16V
C62: 220n; C_0603_1608Metric
J6, J7: BTH-070-02-L-D-A; SAMTEC_BTH-070-02-L-D-A; PARTREV R
R81, R82, R83, R84, R85, R86: 22; R_0402_1005Metric
R87, R88, R89, R90, R91, R92, R93, R94, R95, R96, R97, R98, R99, R100, R101: 10k; R_0402_1005Metric

Connections:
+3.3V_OBC: C57.1, C58.1, C59.1, C60.1, C61.1, J7.132 (D66), J7.133 (C67), J7.134 (D67), J7.135 (C68), J7.136 (D68), J7.137 (C69), J7.138 (D69), J7.139 (C70), J7.140 (D70); also elsewhere on the board
GND: C57.2, C58.2, C59.2, C60.2, C61.2, C62.2, J6.03 (A2), J6.06 (B3), J6.09 (A5), J6.12 (B6), J6.13 (A7), J6.18 (B9), J6.23 (A12), J6.24 (B12), J6.30 (B15), J6.36 (B18), J6.39 (A20), J6.40 (B20), J6.46 (B23), J6.49 (A25), J6.52 (B26), J6.58 (B29), J6.61 (A31), J6.64 (B32), J6.71 (A36), J6.74 (B37), J6.79 (A40), J6.80 (B40), J6.89 (A45), J6.90 (B45), J6.100 (B50), J6.103 (A52), J6.108 (B54), J6.111 (A56), J6.120 (B60), J6.121 (A61), J6.126 (B63), J6.131 (A66), J6.139 (A70), J6.140 (B70), J7.09 (C5), J7.10 (D5), J7.19 (C10), J7.22 (D11), J7.29 (C15), J7.36 (D18), J7.39 (C20), J7.46 (D23), J7.49 (C25), J7.56 (D28), J7.59 (C30), J7.62 (D31), J7.69 (C35), J7.70 (D35), J7.79 (C40), J7.80 (D40), J7.89 (C45), J7.90 (D45), J7.95 (C48), J7.100 (D50), J7.107 (C54), J7.112 (D56), J7.115 (C58), J7.120 (D60), J7.125 (C63), J7.130 (D65), R87.1, R88.1, R89.1, R90.1, R91.1, R92.1, R93.1, R94.1, R95.1, R96.1, R97.1, R98.1, R99.1, R100.1, R101.1; also elsewhere on the board
unnamed: J6.25 (A13), R81.2
unnamed: J6.27 (A14), R82.2
unnamed: J6.29 (A15), R83.2
unnamed: J6.31 (A16), R84.2
unnamed: J6.35 (A18), R85.2
unnamed: J6.37 (A19), R86.2
unnamed: J6.02 (B1), R89.2
unnamed: J6.04 (B2), R90.2
unnamed: J6.08 (B4), R91.2
unnamed: J6.10 (B5), R92.2
unnamed: J6.26 (B13), J6.28 (B14), R87.2
unnamed: J6.32 (B16), J6.34 (B17), R88.2
unnamed: J7.31 (C16), J7.33 (C17), J7.35 (C18), J7.37 (C19), R93.2
unnamed: J7.41 (C21), J7.43 (C22), J7.45 (C23), J7.47 (C24), R94.2
unnamed: J7.51 (C26), J7.53 (C27), J7.55 (C28), J7.57 (C29), R95.2
unnamed: J7.61 (C31), J7.63 (C32), J7.65 (C33), J7.67 (C34), R96.2
unnamed: J7.71 (C36), J7.73 (C37), J7.75 (C38), J7.77 (C39), R97.2
unnamed: J7.64 (D32), R101.2
unnamed: J7.76 (D38), J7.78 (D39), R98.2
unnamed: J7.82 (D41), J7.84 (D42), J7.86 (D43), J7.88 (D44), R99.2
unnamed: J7.92 (D46), J7.94 (D47), J7.96 (D48), J7.98 (D49), R100.2
VCC_1V8_OUT: J7.127 (C64); also elsewhere on the board
VCC_3V3_OUT: J7.129 (C65)
VCC_LDO_SD1: J6.33 (A17); also elsewhere on the board
VCC_QSPI_1V8: J7.20 (D10)
VCC_SCU_1V8: J7.93 (C47); also elsewhere on the board
VDD_ADC_1V8: C62.1, J7.114 (D57)
X_ADMA_I2C0_SCL: J7.66 (D33); also elsewhere on the board
X_ADMA_I2C0_SDA: J7.68 (D34); also elsewhere on the board
X_ADMA_I2C3_SCL: J6.112 (B56); also elsewhere on the board
X_ADMA_I2C3_SDA: J6.107 (A54); also elsewhere on the board
X_ADMA_SPI2_CS0: J6.41 (A21); also elsewhere on the board
X_ADMA_SPI2_CS1: J6.67 (A34); also elsewhere on the board
X_ADMA_SPI2_SCK: J6.43 (A22); also elsewhere on the board
X_ADMA_SPI2_SDI: J6.45 (A23); also elsewhere on the board
X_ADMA_SPI2_SDO: J6.47 (A24); also elsewhere on the board
X_ADMA_UART0_RX: J6.97 (A49); also elsewhere on the board
X_ADMA_UART0_TX: J6.95 (A48); also elsewhere on the board
X_ADMA_UART2_RX: J6.99 (A50); also elsewhere on the board
X_ADMA_UART2_TX: J6.101 (A51); also elsewhere on the board
X_BOOT_MODE0: J6.66 (B33); also elsewhere on the board
X_BOOT_MODE1: J6.68 (B34); also elsewhere on the board
X_BOOT_MODE2: J6.70 (B35); also elsewhere on the board
X_BOOT_MODE3: J6.72 (B36); also elsewhere on the board
X_CONN_ENET1_REFCLK: J6.106 (B53); also elsewhere on the board
X_CONN_ENET1_RXC: J6.86 (B43); also elsewhere on the board
X_CONN_ENET1_RXD0: J6.102 (B51); also elsewhere on the board
X_CONN_ENET1_RXD1: J6.94 (B47); also elsewhere on the board
X_CONN_ENET1_RXD2: J6.92 (B46); also elsewhere on the board
X_CONN_ENET1_RXD3: J6.88 (B44); also elsewhere on the board
X_CONN_ENET1_RX_CTL: J6.104 (B52); also elsewhere on the board
X_CONN_ENET1_TXC: J6.78 (B39); also elsewhere on the board
X_CONN_ENET1_TXD0: J6.96 (B48); also elsewhere on the board
X_CONN_ENET1_TXD1: J6.98 (B49); also elsewhere on the board
X_CONN_ENET1_TXD2: J6.76 (B38); also elsewhere on the board
X_CONN_ENET1_TXD3: J6.82 (B41); also elsewhere on the board
X_CONN_ENET1_TX_CTL: J6.84 (B42); also elsewhere on the board
X_CONN_ETH0_MDC: J6.135 (A68); also elsewhere on the board
X_CONN_ETH0_MDIO: J6.133 (A67); also elsewhere on the board
X_CONN_USDHC1_CD_B: J6.19 (A10); also elsewhere on the board
X_CONN_USDHC1_CLK: R85.1; also elsewhere on the board
X_CONN_USDHC1_CMD: R86.1; also elsewhere on the board
X_CONN_USDHC1_DATA0: R84.1; also elsewhere on the board
X_CONN_USDHC1_DATA1: R83.1; also elsewhere on the board
X_CONN_USDHC1_DATA2: R82.1; also elsewhere on the board
X_CONN_USDHC1_DATA3: R81.1; also elsewhere on the board
X_CONN_USDHC1_RESET_B: J6.21 (A11); also elsewhere on the board
X_ETH0_A_TX_N: J6.136 (B68); also elsewhere on the board
X_ETH0_A_TX_P: J6.138 (B69); also elsewhere on the board
X_ETH0_B_TX_N: J6.132 (B66); also elsewhere on the board
X_ETH0_B_TX_P: J6.134 (B67); also elsewhere on the board
X_ETH0_C_TXCLK_N: J6.128 (B64); also elsewhere on the board
X_ETH0_C_TXCLK_P: J6.130 (B65); also elsewhere on the board
X_ETH0_D_RXDV_N: J6.122 (B61); also elsewhere on the board
X_ETH0_D_RXDV_P: J6.124 (B62); also elsewhere on the board
X_ETH0_LED0: J6.123 (A62); also elsewhere on the board
X_ETH0_LED1: J6.125 (A63); also elsewhere on the board
X_ETH1_GPIO0: J7.122 (D61); also elsewhere on the board
X_ETH1_GPIO1: J7.128 (D64); also elsewhere on the board
X_ETH1_PHY_INT: J7.126 (D63); also elsewhere on the board
X_LSIO_GPIO1_IO17: J6.85 (A43); also elsewhere on the board
X_LSIO_GPIO1_IO18: J6.87 (A44); also elsewhere on the board
X_LSIO_GPIO1_IO19: J6.93 (A47); also elsewhere on the board
X_LSIO_GPIO1_IO20: J6.91 (A46); also elsewhere on the board
X_LSIO_GPIO1_IO25: J7.23 (C12); also elsewhere on the board
X_LSIO_GPIO1_IO26: J7.21 (C11); also elsewhere on the board
X_LSIO_GPIO1_IO29: J7.81 (C41); also elsewhere on the board
X_LSIO_GPIO1_IO30: J7.83 (C42); also elsewhere on the board
X_M40_UART0_RX: J7.121 (C61); also elsewhere on the board
X_M40_UART0_TX: J7.123 (C62); also elsewhere on the board
X_PGOOD: J7.105 (C53); also elsewhere on the board
X_PMIC_EWARN: J7.109 (C55)
X_PMIC_INT_B: J7.117 (C59)
X_PMIC_WDI: J7.119 (C60)
X_POR_B_1V8: J7.101 (C51); also elsewhere on the board
X_POR_B_3V3: J7.103 (C52)
X_SCU_PMIC_ON_REQ: J7.111 (C56)
X_SCU_PMIC_STANDBY: J7.113 (C57)
~X_nRESET_IN: J7.91 (C46); also elsewhere on the board

Notes on the sheet:
X2 Connector: Pins C through D
I2C0_SCL/SDA Reserved for Power Board Diagnostics. I2C3_SCL/SDA is open for end user.
X1 Connector: Pins A through B

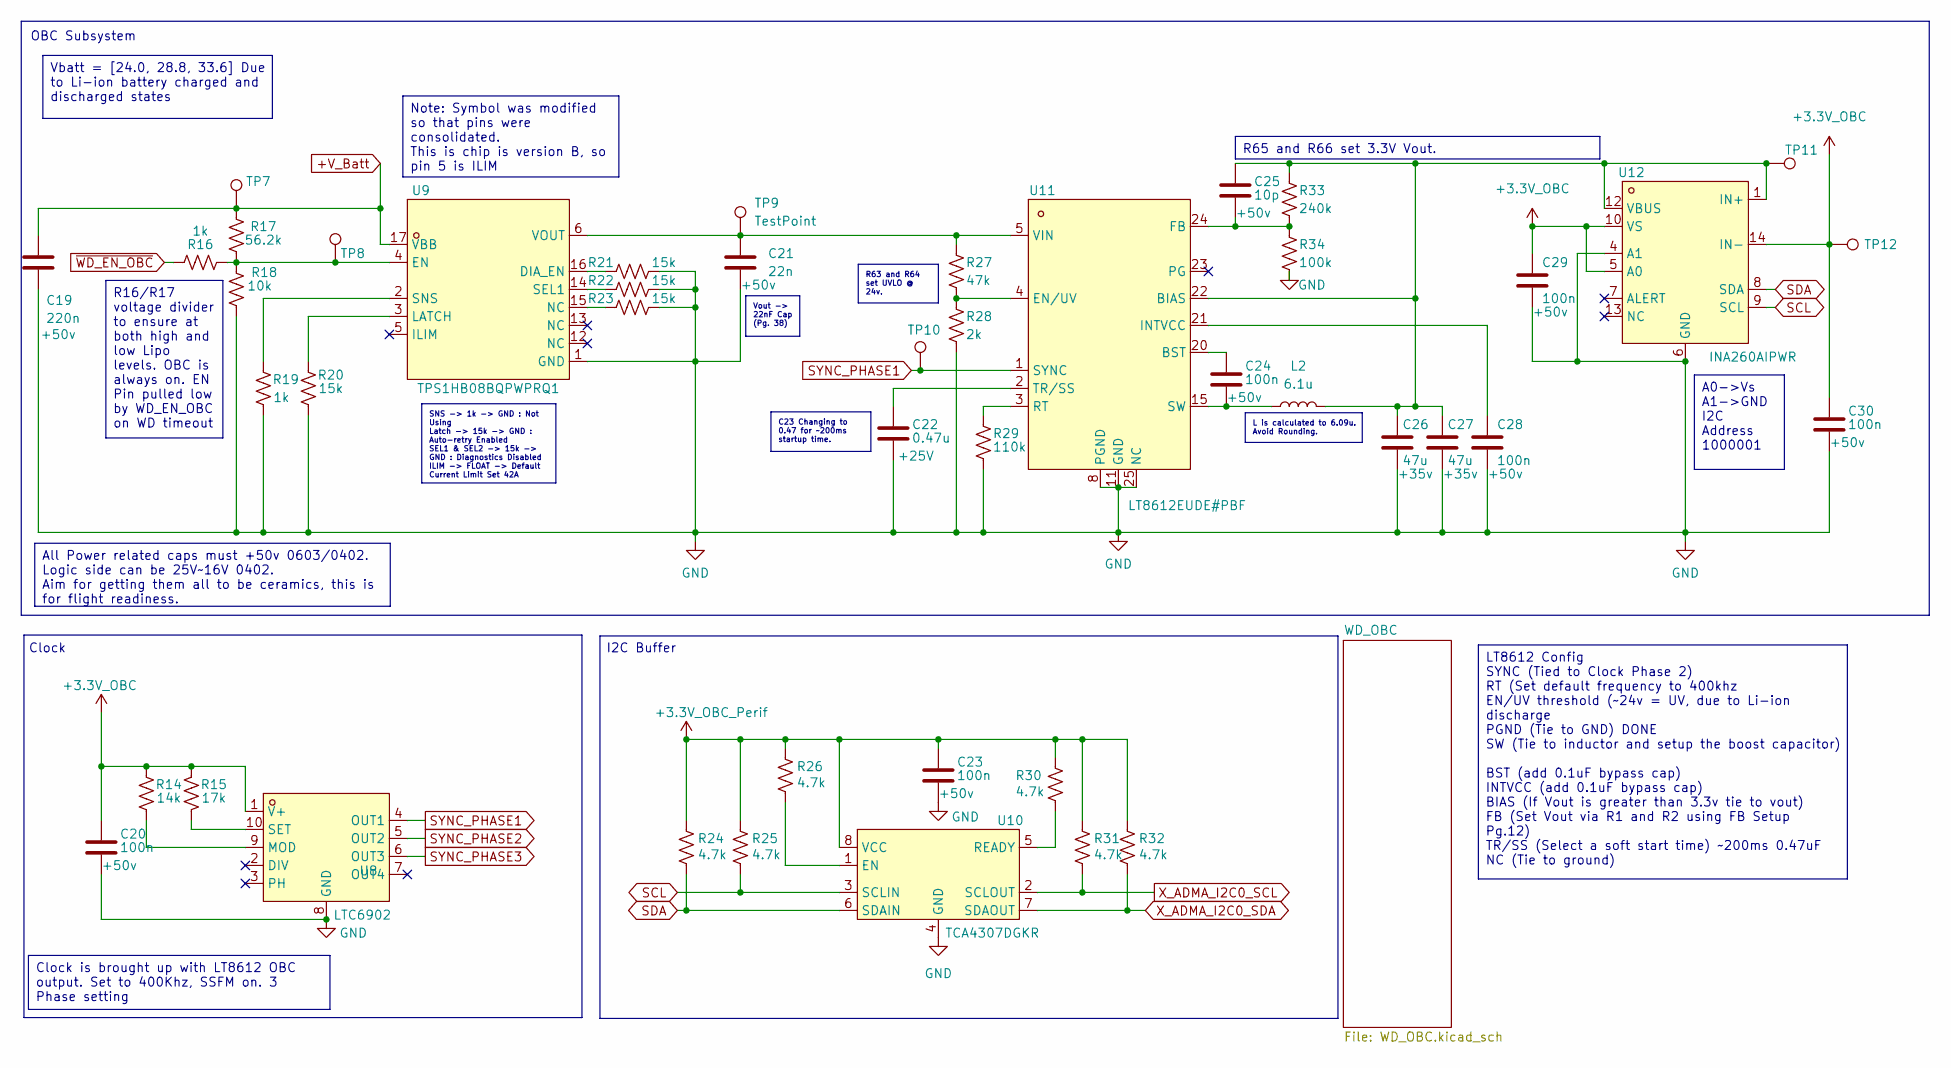
[picture p196: schematic OBC_Subsystem.kicad_sch, Leviathan V2]

Parts:
C19: 220n; C0402; Voltage Rating +50v; LCSC C5159775
C20, C23, C24, C28, C29, C30: 100n; C0402; Voltage Rating +50v; LCSC C85858
C21: 22n; C0402; Voltage Rating +50v; LCSC C77023
C22: 0.47u; C0402; Voltage Rating +25V; LCSC C1623
C25: 10p; C0402; Voltage Rating +50v; LCSC C1545
C26, C27: 47u; CAP-SMD_L7.3-W4.3-FD; Voltage Rating +35v; LCSC C87110
L2: 6.1u; IND-SMD_FTKB1207-6R1NT; LCSC C3040409
R14: 14k; R_0603_1608Metric; LCSC C2930066
R15: 17k; R_0603_1608Metric; LCSC C137788
R16: 1k; R0402; LCSC C54968
R17: 56.2k; R0402; LCSC C54968
R18: 10k; R0402; LCSC C25531
R19: 1k; R0402; LCSC C106235
R20: 15k; R0402; LCSC C114761
R21, R22, R23: 15k; R0402; LCSC C25756
R24, R25, R26, R30, R31, R32: 4.7k; R_0603_1608Metric; LCSC C99782
R27: 47k; R0402; LCSC C93943
R28: 2k; R0402; LCSC C60488
R29: 110k; R0402; LCSC C138065
R33: 240k; R0402; LCSC C138029
R34: 100k; R0402; LCSC C60491
TP7, TP8, TP9, TP10, TP11, TP12: TestPoint; TestPoint_Pad_D1.0mm
U8: LTC6902; MSOP-10_L3.0-W3.0-P0.50-LS5.0-BL; LCSC C581012
U9: TPS1HB08BQPWPRQ1; HTSSOP-16_L5.0-W4.4-P0.65-LS6.4-TL-EP2.9; LCSC Part C3230075
U10: TCA4307DGKR; VSSOP-8_L3.0-W3.0-P0.65-LS4.9-BL; LCSC Part C880333
U11: LT8612EUDE#PBF; QFN-28_L6.0-W3.0-P0.50-BL-EP; LCSC Part C580312
U12: INA260AIPWR; TSSOP-16_L5.0-W4.4-P0.65-LS6.4-BL-1; LCSC Part C2155885

Connections:
+3.3V_OBC: C20.1, C29.1, C30.1, R14.1, R15.1, TP12.1 (1_1), U8.1 (V+), U12.5 (A0), U12.10 (VS), U12.14 (IN-); also elsewhere on the board
+3.3V_OBC_Perif: C23.1, R24.1, R25.1, R26.1, R30.1, R31.1, R32.1, U10.8 (VCC); also elsewhere on the board
+V_Batt: C19.1, R17.2, TP7.1 (1_1), U9.17 (VBB); also elsewhere on the board
GND: C19.2, C20.2, C21.2, C22.2, C23.2, C26.2, C27.2, C28.2, C29.2, C30.2, R18.1, R19.1, R20.1, R21.2, R22.2, R23.2, R28.2, R29.2, R34.2, U8.8 (GND), U9.1 (GND), U10.4 (GND), U11.8 (PGND), U11.11 (GND), U11.25 (NC), U12.4 (A1), U12.6 (GND); also elsewhere on the board
unnamed: R23.1, U9.15 (NC)
unnamed: R14.2, U8.9 (MOD)
unnamed: R15.2, U8.10 (SET)
unnamed: R21.1, U9.16 (DIA_EN)
unnamed: R16.1, R17.1, R18.2, TP8.1 (1_1), U9.4 (EN)
unnamed: R20.2, U9.3 (LATCH)
unnamed: R22.1, U9.14 (SEL1)
unnamed: R19.2, U9.2 (SNS)
unnamed: R26.2, U10.1 (EN)
unnamed: R30.2, U10.5 (READY)
unnamed: C25.1, C26.1, C27.1, L2.2, R33.1, TP11.1 (1_1), U11.22 (BIAS), U12.1 (IN+), U12.12 (VBUS)
unnamed: C24.1, U11.20 (BST)
unnamed: R27.2, R28.1, U11.4 (EN/UV)
unnamed: C25.2, R33.2, R34.1, U11.24 (FB)
unnamed: C28.1, U11.21 (INTVCC)
unnamed: R29.1, U11.3 (RT)
unnamed: C24.2, L2.1, U11.15 (SW)
unnamed: C22.1, U11.2 (TR/SS)
unnamed: C21.1, R27.1, TP9.1 (1_1), U9.6 (VOUT), U11.5 (VIN)
SCL: R25.2, U10.3 (SCLIN), U12.9 (SCL); also elsewhere on the board
SDA: R24.2, U10.6 (SDAIN), U12.8 (SDA); also elsewhere on the board
SYNC_PHASE1: TP10.1 (1_1), U8.4 (OUT1), U11.1 (SYNC)
SYNC_PHASE2: U8.5 (OUT2); also elsewhere on the board
SYNC_PHASE3: U8.6 (OUT3); also elsewhere on the board
X_ADMA_I2C0_SCL: R31.2, U10.2 (SCLOUT); also elsewhere on the board
X_ADMA_I2C0_SDA: R32.2, U10.7 (SDAOUT); also elsewhere on the board
~WD_EN_OBC: R16.2; also elsewhere on the board

Notes on the sheet:
Clock
OBC Subsystem
I2C Buffer
All Power related caps must +50v 0603/0402. Logic side can be 25V~16V 0402. Aim for getting them all to be ceramics, this is for flight readiness.
Clock is brought up with LT8612 OBC output. Set to 400Khz, SSFM on. 3 Phase setting
R63 and R64 set UVLO @ 24v.
Note: Symbol was modified so that pins were consolidated. This is chip is version B, so pin 5 is ILIM
LT8612 Config SYNC (Tied to Clock Phase 2) RT (Set default frequency to 400khz EN/UV threshold (~24v = UV, due to Li-ion discharge PGND (Tie to GND) DONE SW (Tie to inductor and setup the boost capacitor) BST (add 0.1uF bypass cap) INTVCC (add 0.1uF bypass cap) BIAS (If Vout is greater than 3.3v ti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
Vbatt = [24.0, 28.8, 33.6] Due to Li-ion battery charged and discharged states
L is calculated to 6.09u. Avoid Rounding.
SNS -> 1k -> GND : Not Using Latch -> 15k -> GND : Auto-retry Enabled SEL1 & SEL2 -> 15k -> GND : Diagnostics Disabled ILIM -> FLOAT -> Default Current Limit Set 42A
R65 and R66 set 3.3V Vout.
Vout -> 22nF Cap (Pg. 38)
C23 Changing to 0.47 for ~200ms startup time.
R16/R17 voltage divider to ensure at both high and low Lipo levels. OBC is always on. EN Pin pulled low by WD_EN_OBC on WD timeout
A0->Vs A1->GND I2C Address 1000001
