BroncoSpace-Lab/scales-hardware/imx8x_eps_leviathan_v2/imx8x_eps_leviathan_v2.kicad_pcb

## KiCad design imx8x_eps_leviathan_v2/imx8x_eps_leviathan_v2.kicad_pcb (continued)

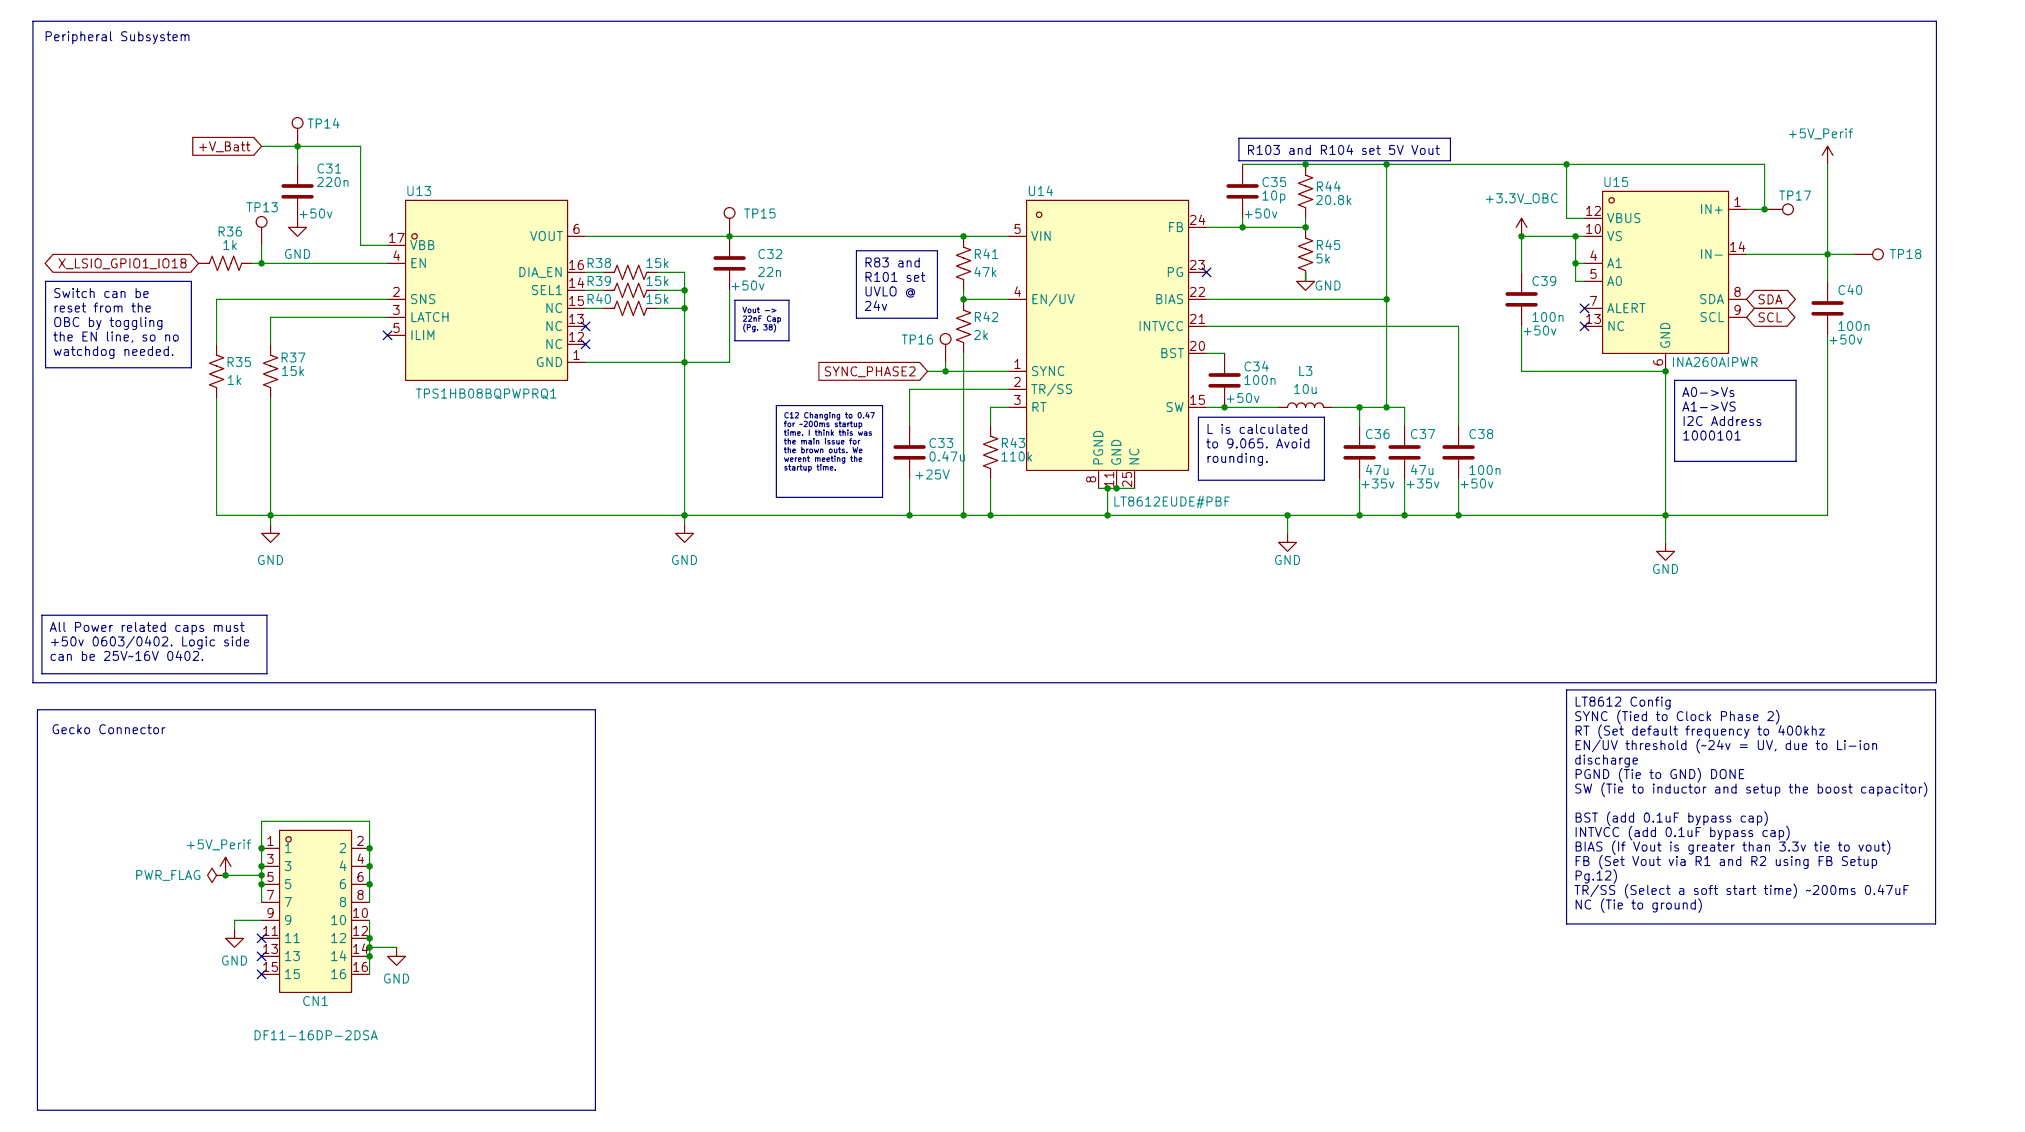
[picture p197: schematic Perif_Subsystem.kicad_sch, Leviathan V2]

Parts:
C31: 220n; C0402; Voltage Rating +50v; LCSC C5159775
C32: 22n; C0402; Voltage Rating +50v; LCSC C77023
C33: 0.47u; C0402; Voltage Rating +25V; LCSC C1623
C34, C38, C39, C40: 100n; C0402; Voltage Rating +50v; LCSC C85858
C35: 10p; C0402; Voltage Rating +50v; LCSC C1545
C36, C37: 47u; CAP-SMD_L7.3-W4.3-FD; Voltage Rating +35v; LCSC C87110
CN1: DF11-16DP-2DSA; CONN-TH_DF11-16DP-2DSA-08; LCSC Part C530981
L3: 10u; IND-SMD_L8.0-W8.0; LCSC C2849554
R35: 1k; R0402; LCSC C106235
R36: 1k; R0402; LCSC C114761
R37, R38, R39, R40: 15k; R0402; LCSC C114761
R41: 47k; R0402; LCSC C93943
R42: 2k; R0402; LCSC C60488
R43: 110k; R0402; LCSC C138065
R44: 20.8k; R0402; LCSC C25766
R45: 5k; R0402; LCSC C477765
TP13, TP14, TP15, TP16, TP17, TP18: TestPoint; TestPoint_Pad_D1.0mm
U13: TPS1HB08BQPWPRQ1; HTSSOP-16_L5.0-W4.4-P0.65-LS6.4-TL-EP2.9; LCSC Part C3230075
U14: LT8612EUDE#PBF; QFN-28_L6.0-W3.0-P0.50-BL-EP; LCSC Part C580312
U15: INA260AIPWR; TSSOP-16_L5.0-W4.4-P0.65-LS6.4-BL-1; LCSC Part C2155885

Connections:
+3.3V_OBC: C39.1, U15.4 (A1), U15.5 (A0), U15.10 (VS); also elsewhere on the board
+5V_Perif: C40.1, CN1.1, CN1.2, CN1.3, CN1.4, CN1.5, CN1.6, CN1.7, CN1.8, TP18.1 (1_1), U15.14 (IN-)
+V_Batt: C31.1, TP14.1 (1_1), U13.17 (VBB); also elsewhere on the board
GND: C31.2, C32.2, C33.2, C36.2, C37.2, C38.2, C39.2, C40.2, CN1.9, CN1.10, CN1.12, CN1.14, CN1.16, R35.1, R37.1, R38.1, R39.1, R40.1, R42.2, R43.2, R45.2, U13.1 (GND), U14.8 (PGND), U14.11 (GND), U14.25 (NC), U15.6 (GND); also elsewhere on the board
unnamed: R40.2, U13.15 (NC)
unnamed: R38.2, U13.16 (DIA_EN)
unnamed: R36.1, TP13.1 (1_1), U13.4 (EN)
unnamed: R37.2, U13.3 (LATCH)
unnamed: R39.2, U13.14 (SEL1)
unnamed: R35.2, U13.2 (SNS)
unnamed: C32.1, R41.1, TP15.1 (1_1), U13.6 (VOUT), U14.5 (VIN)
unnamed: C35.1, C36.1, C37.1, L3.2, R44.1, TP17.1 (1_1), U14.22 (BIAS), U15.1 (IN+), U15.12 (VBUS)
unnamed: C34.1, U14.20 (BST)
unnamed: R41.2, R42.1, U14.4 (EN/UV)
unnamed: C35.2, R44.2, R45.1, U14.24 (FB)
unnamed: C38.1, U14.21 (INTVCC)
unnamed: R43.1, U14.3 (RT)
unnamed: C34.2, L3.1, U14.15 (SW)
unnamed: C33.1, U14.2 (TR/SS)
SCL: U15.9 (SCL); also elsewhere on the board
SDA: U15.8 (SDA); also elsewhere on the board
SYNC_PHASE2: TP16.1 (1_1), U14.1 (SYNC); also elsewhere on the board
X_LSIO_GPIO1_IO18: R36.2; also elsewhere on the board

Notes on the sheet:
Peripheral Subsystem
Gecko Connector
L is calculated to 9.065. Avoid rounding.
Switch can be reset from the OBC by toggling the EN line, so no watchdog needed.
LT8612 Config SYNC (Tied to Clock Phase 2) RT (Set default frequency to 400khz EN/UV threshold (~24v = UV, due to Li-ion discharge PGND (Tie to GND) DONE SW (Tie to inductor and setup the boost capacitor) BST (add 0.1uF bypass cap) INTVCC (add 0.1uF bypass cap) BIAS (If Vout is greater than 3.3v ti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
Vout -> 22nF Cap (Pg. 38)
A0->Vs A1->VS I2C Address 1000101
C12 Changing to 0.47 for ~200ms startup time. I think this was the main issue for the brown outs. We werent meeting the startup time.
R83 and R101 set UVLO @ 24v
R103 and R104 set 5V Vout
All Power related caps must +50v 0603/0402. Logic side can be 25V~16V 0402.

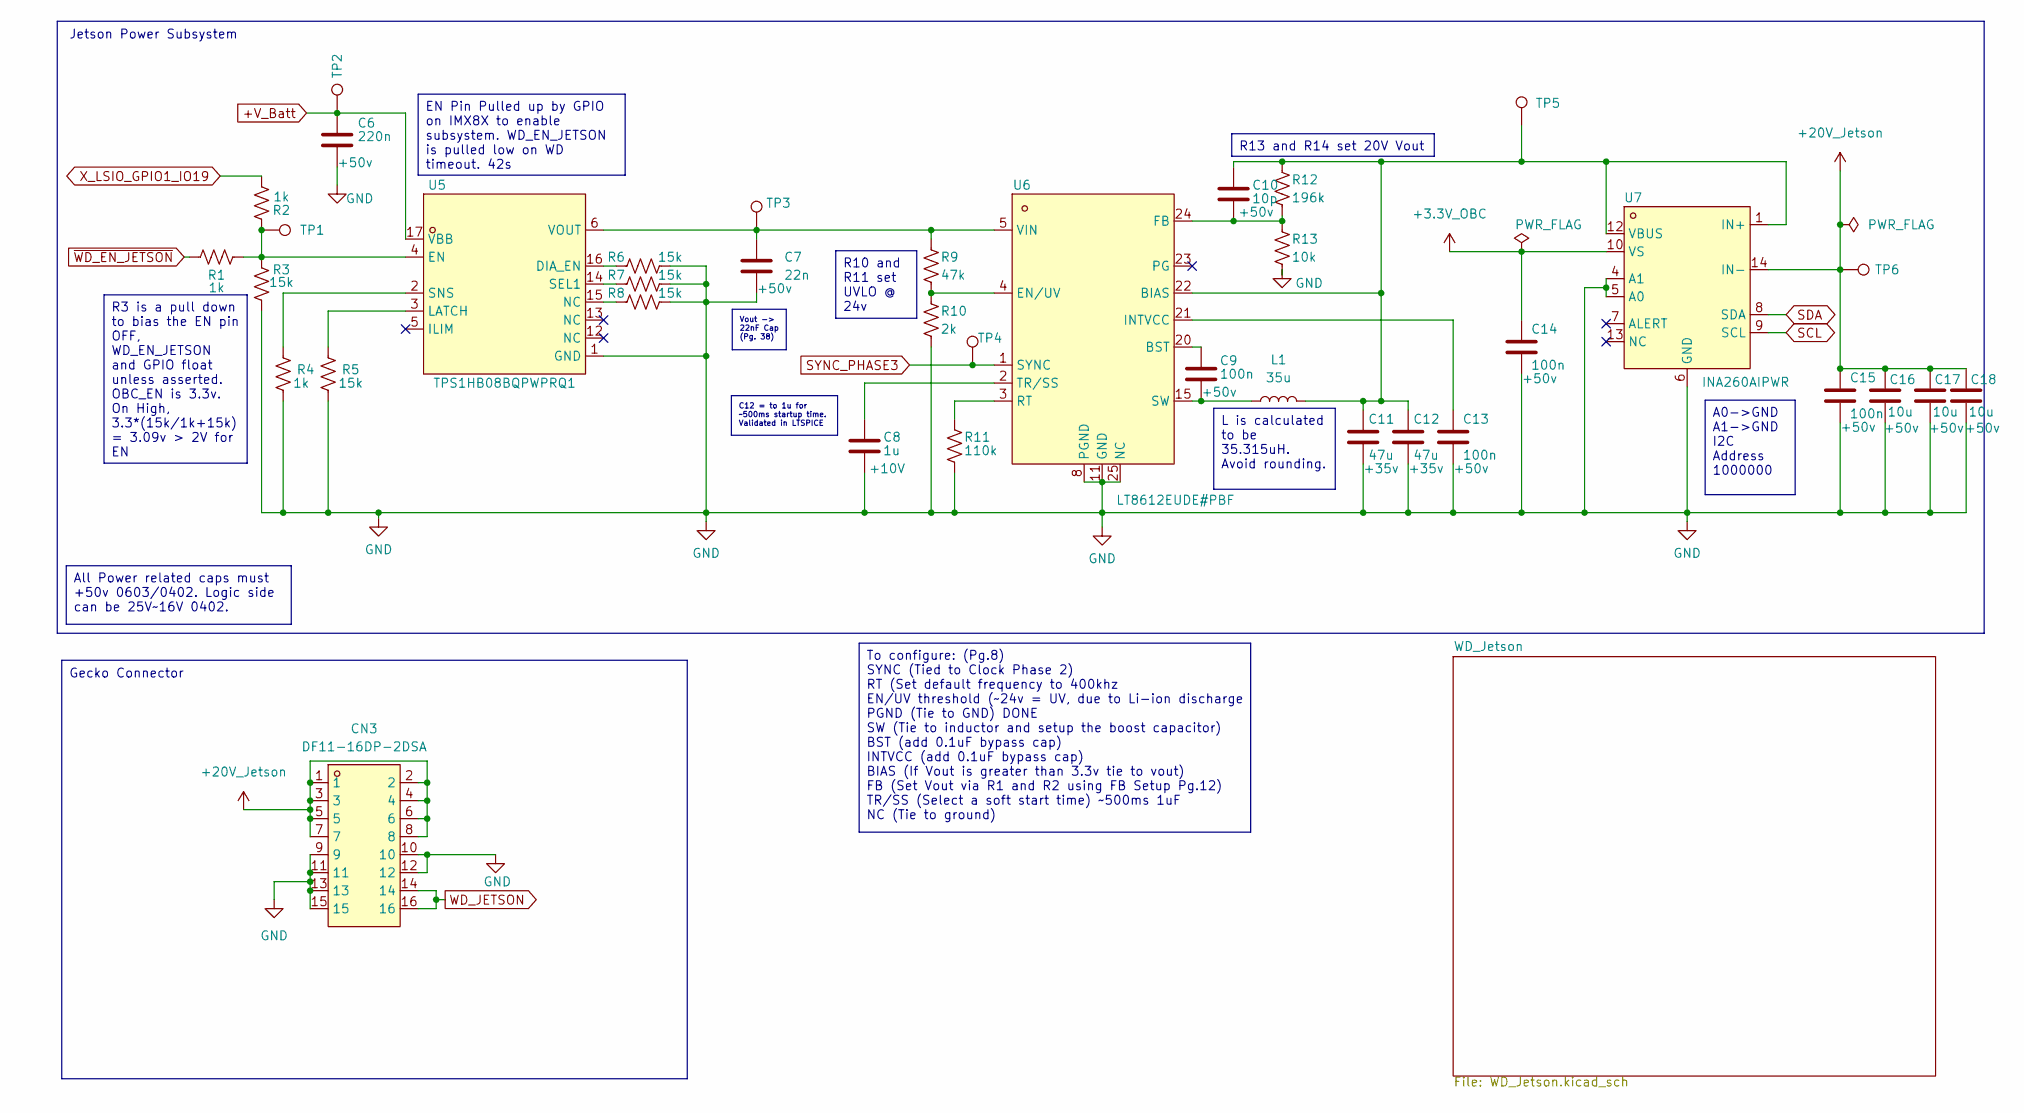
[picture p198: schematic JetsonSubsystem.kicad_sch, Leviathan V2]

Parts:
C6: 220n; C0402; Voltage Rating +50v; LCSC C5159775
C7: 22n; C0402; Voltage Rating +50v; LCSC C77023
C8: 1u; C0402; Voltage Rating +10V; LCSC C14445
C9, C13, C14, C15: 100n; C0402; Voltage Rating +50v; LCSC C85858
C10: 10p; C0402; Voltage Rating +50v; LCSC C1545
C11, C12: 47u; CAP-SMD_L7.3-W4.3-FD; Voltage Rating +35v; LCSC C87110
C16, C17, C18: 10u; C_1210_3225Metric; Voltage Rating +50v; LCSC C2918502
CN3: DF11-16DP-2DSA; CONN-TH_DF11-16DP-2DSA-08; LCSC Part C530981
L1: 35u; IND-SMD_L10.7-W10.0_ETQP5MXXXX; LCSC C2880058
R1, R2: 1k; R0402; LCSC C114761
R3, R5, R6, R7, R8: 15k; R0402; LCSC C114761
R4: 1k; R0402; LCSC C106235
R9: 47k; R0402; LCSC C93943
R10: 2k; R0402; LCSC C60488
R11: 110k; R0402; LCSC C138065
R12: 196k; R0402; LCSC C2077051
R13: 10k; R0402; LCSC C25531
TP1, TP2, TP3, TP4, TP5, TP6: TestPoint; TestPoint_Pad_D1.0mm
U5: TPS1HB08BQPWPRQ1; HTSSOP-16_L5.0-W4.4-P0.65-LS6.4-TL-EP2.9; LCSC Part C3230075
U6: LT8612EUDE#PBF; QFN-28_L6.0-W3.0-P0.50-BL-EP; LCSC Part C580312
U7: INA260AIPWR; TSSOP-16_L5.0-W4.4-P0.65-LS6.4-BL-1; LCSC Part C2155885

Connections:
+3.3V_OBC: C14.1, U7.10 (VS); also elsewhere on the board
+20V_Jetson: C15.1, C16.1, C17.1, C18.1, CN3.1, CN3.2, CN3.3, CN3.4, CN3.5, CN3.6, CN3.7, CN3.8, TP6.1 (1_1), U7.14 (IN-); also elsewhere on the board
+V_Batt: C6.1, TP2.1 (1_1), U5.17 (VBB); also elsewhere on the board
GND: C6.2, C7.2, C8.2, C11.2, C12.2, C13.2, C14.2, C15.2, C16.2, C17.2, C18.2, CN3.9, CN3.10, CN3.11, CN3.12, CN3.13, CN3.15, R3.2, R4.1, R5.2, R6.2, R7.2, R8.2, R10.2, R11.2, R13.2, U5.1 (GND), U6.8 (PGND), U6.11 (GND), U6.25 (NC), U7.4 (A1), U7.5 (A0), U7.6 (GND); also elsewhere on the board
unnamed: R8.1, U5.15 (NC)
unnamed: R6.1, U5.16 (DIA_EN)
unnamed: R1.1, R2.2, R3.1, TP1.1 (1_1), U5.4 (EN)
unnamed: R5.1, U5.3 (LATCH)
unnamed: R7.1, U5.14 (SEL1)
unnamed: R4.2, U5.2 (SNS)
unnamed: C7.1, R9.1, TP3.1 (1_1), U5.6 (VOUT), U6.5 (VIN)
unnamed: C10.1, C11.1, C12.1, L1.2, R12.1, TP5.1 (1_1), U6.22 (BIAS), U7.1 (IN+), U7.12 (VBUS)
unnamed: C9.1, U6.20 (BST)
unnamed: R9.2, R10.1, U6.4 (EN/UV)
unnamed: C10.2, R12.2, R13.1, U6.24 (FB)
unnamed: C13.1, U6.21 (INTVCC)
unnamed: R11.1, U6.3 (RT)
unnamed: C9.2, L1.1, U6.15 (SW)
unnamed: C8.1, U6.2 (TR/SS)
SCL: U7.9 (SCL); also elsewhere on the board
SDA: U7.8 (SDA); also elsewhere on the board
SYNC_PHASE3: TP4.1 (1_1), U6.1 (SYNC); also elsewhere on the board
WD_JETSON: CN3.14, CN3.16; also elsewhere on the board
X_LSIO_GPIO1_IO19: R2.1; also elsewhere on the board
~WD_EN_JETSON: R1.2; also elsewhere on the board

Notes on the sheet:
Jetson Power Subsystem
Gecko Connector
All Power related caps must +50v 0603/0402. Logic side can be 25V~16V 0402.
R3 is a pull down to bias the EN pin OFF, WD_EN_JETSON and GPIO float unless asserted. OBC_EN is 3.3v. On High, 3.3*(15k/1k+15k) = 3.09v > 2V for EN
To configure: (Pg.8) SYNC (Tied to Clock Phase 2) RT (Set default frequency to 400khz EN/UV threshold (~24v = UV, due to Li-ion discharge PGND (Tie to GND) DONE SW (Tie to inductor and setup the boost capacitor) BST (add 0.1uF bypass cap) INTVCC (add 0.1uF bypass cap) BIAS (If Vout is greater than 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
L is calculated to be 35.315uH. Avoid rounding.
Vout -> 22nF Cap (Pg. 38)
C12 = to 1u for ~500ms startup time. Validated in LTSPICE
EN Pin Pulled up by GPIO on IMX8X to enable subsystem. WD_EN_JETSON is pulled low on WD timeout. 42s
R10 and R11 set UVLO @ 24v
A0->GND A1->GND I2C Address 1000000
R13 and R14 set 20V Vout

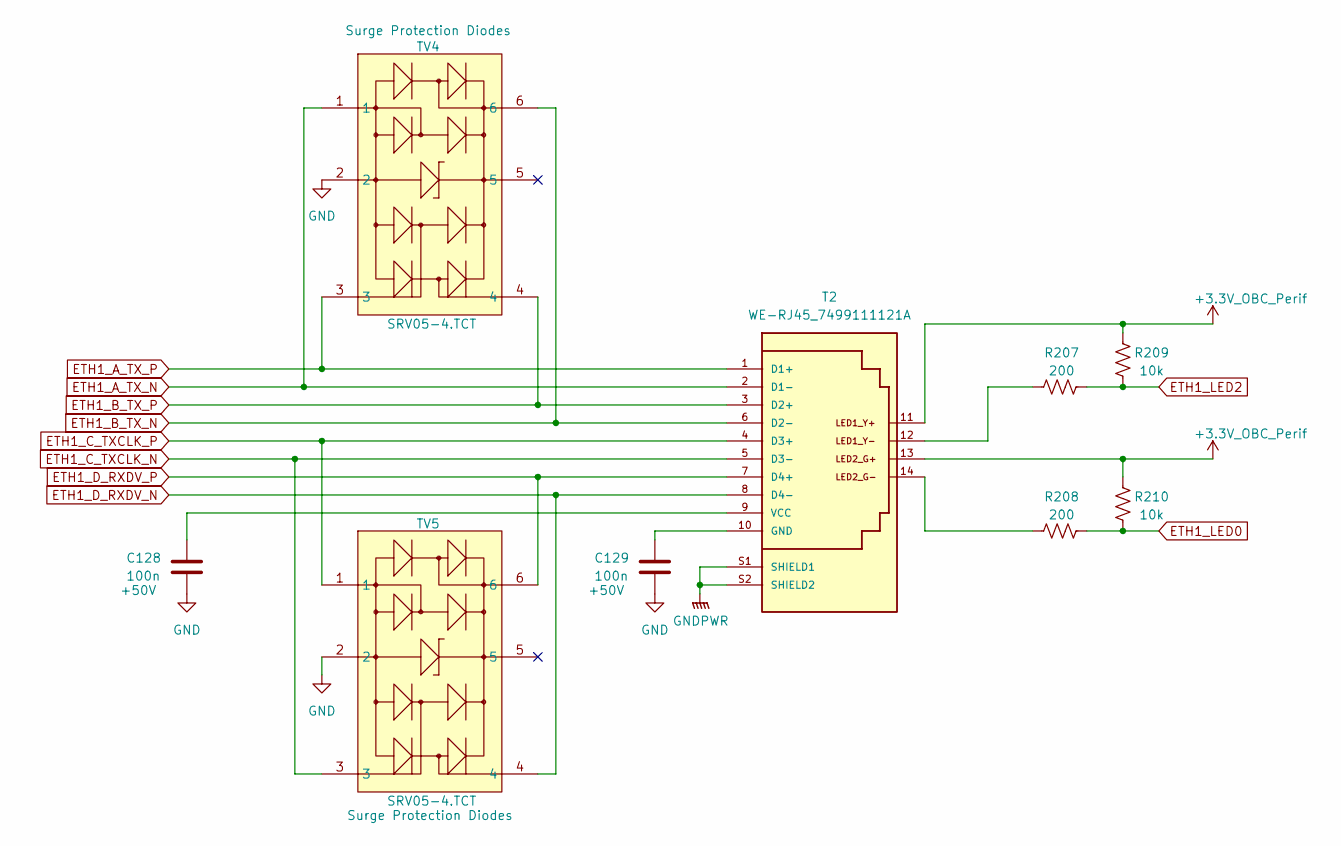
[picture p199: schematic ethernet1.kicad_sch, Leviathan V2]

Parts:
C128, C129: 100n; C0402; Voltage +50V
R207, R208: 200; R0402
R209, R210: 10k; R0402
T2: WE-RJ45_7499111121A; 7499111121A; LCSC Part C5523983
TV4, TV5: SRV05-4.TCT; SOT-23-6_L2.9-W1.6-P0.95-LS2.8-BR; LCSC Part C13612

Connections:
+3.3V_OBC_Perif: R209.1, R210.1, T2.11, T2.13; also elsewhere on the board
ETH1_A_TX_N: T2.2 (D1-), TV4.1; also elsewhere on the board
ETH1_A_TX_P: T2.1 (D1+), TV4.3; also elsewhere on the board
ETH1_B_TX_N: T2.6 (D2-), TV4.6; also elsewhere on the board
ETH1_B_TX_P: T2.3 (D2+), TV4.4; also elsewhere on the board
ETH1_C_TXCLK_N: T2.5 (D3-), TV5.3; also elsewhere on the board
ETH1_C_TXCLK_P: T2.4 (D3+), TV5.1; also elsewhere on the board
ETH1_D_RXDV_N: T2.8 (D4-), TV5.4; also elsewhere on the board
ETH1_D_RXDV_P: T2.7 (D4+), TV5.6; also elsewhere on the board
ETH1_LED0: R208.2, R210.2; also elsewhere on the board
ETH1_LED2: R207.2, R209.2; also elsewhere on the board
GND: C128.2, C129.2, TV4.2, TV5.2; also elsewhere on the board
GNDPWR: T2.S1 (SHIELD1), T2.S2 (SHIELD2); also elsewhere on the board
unnamed: R207.1, T2.12
unnamed: R208.1, T2.14
unnamed: C129.1, T2.10 (GND)
unnamed: C128.1, T2.9 (VCC)

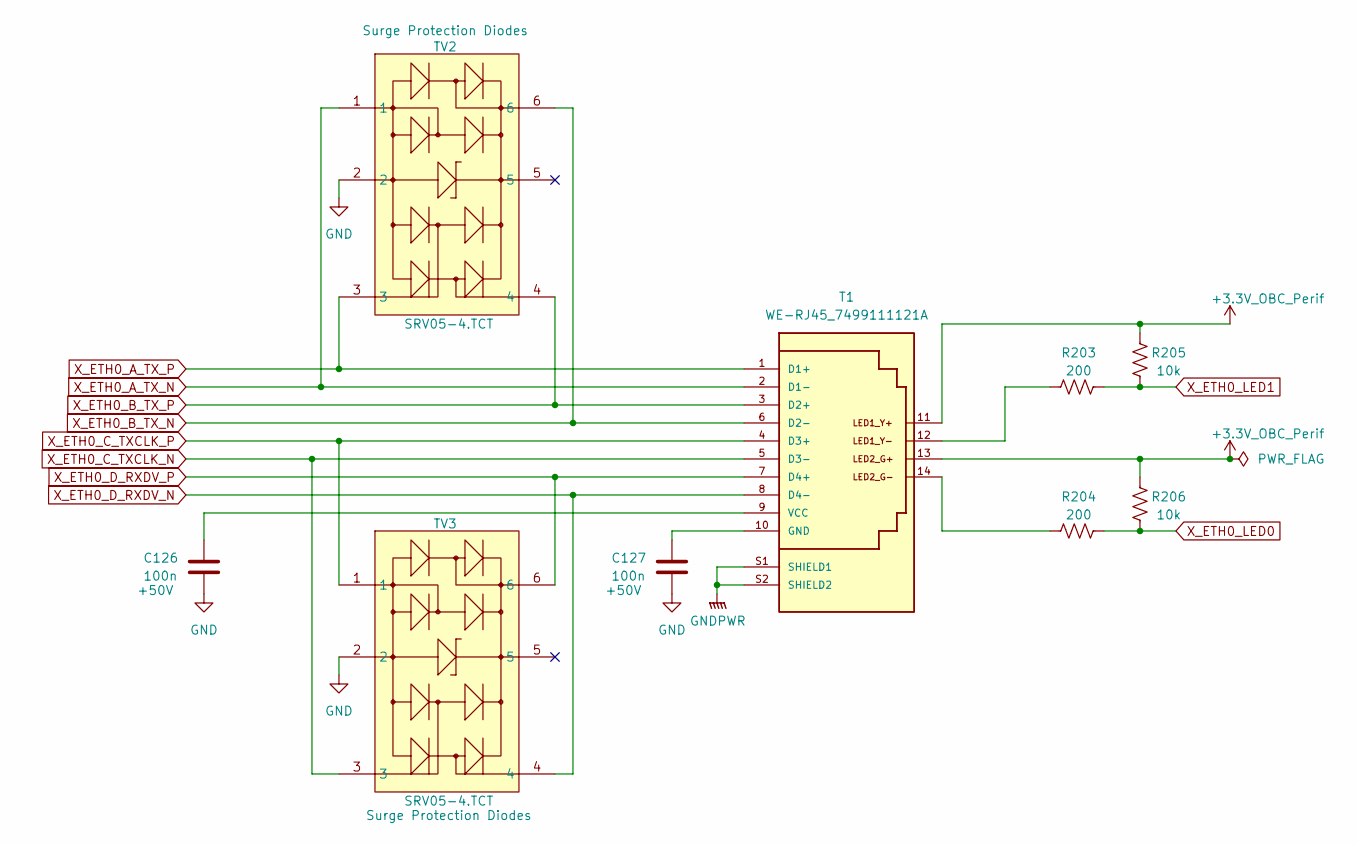
[picture p200: schematic ethernet0.kicad_sch, Leviathan V2]

Parts:
C126, C127: 100n; C0402; Voltage +50V
R203, R204: 200; R0402
R205, R206: 10k; R0402
T1: WE-RJ45_7499111121A; 7499111121A; LCSC Part C5523983
TV2, TV3: SRV05-4.TCT; SOT-23-6_L2.9-W1.6-P0.95-LS2.8-BR; LCSC Part C13612

Connections:
+3.3V_OBC_Perif: R205.1, R206.1, T1.11, T1.13; also elsewhere on the board
GND: C126.2, C127.2, TV2.2, TV3.2; also elsewhere on the board
GNDPWR: T1.S1 (SHIELD1), T1.S2 (SHIELD2); also elsewhere on the board
unnamed: R203.1, T1.12
unnamed: R204.1, T1.14
unnamed: C127.1, T1.10 (GND)
unnamed: C126.1, T1.9 (VCC)
X_ETH0_A_TX_N: T1.2 (D1-), TV2.1; also elsewhere on the board
X_ETH0_A_TX_P: T1.1 (D1+), TV2.3; also elsewhere on the board
X_ETH0_B_TX_N: T1.6 (D2-), TV2.6; also elsewhere on the board
X_ETH0_B_TX_P: T1.3 (D2+), TV2.4; also elsewhere on the board
X_ETH0_C_TXCLK_N: T1.5 (D3-), TV3.3; also elsewhere on the board
X_ETH0_C_TXCLK_P: T1.4 (D3+), TV3.1; also elsewhere on the board
X_ETH0_D_RXDV_N: T1.8 (D4-), TV3.4; also elsewhere on the board
X_ETH0_D_RXDV_P: T1.7 (D4+), TV3.6; also elsewhere on the board
X_ETH0_LED0: R204.2, R206.2; also elsewhere on the board
X_ETH0_LED1: R203.2, R205.2; also elsewhere on the board

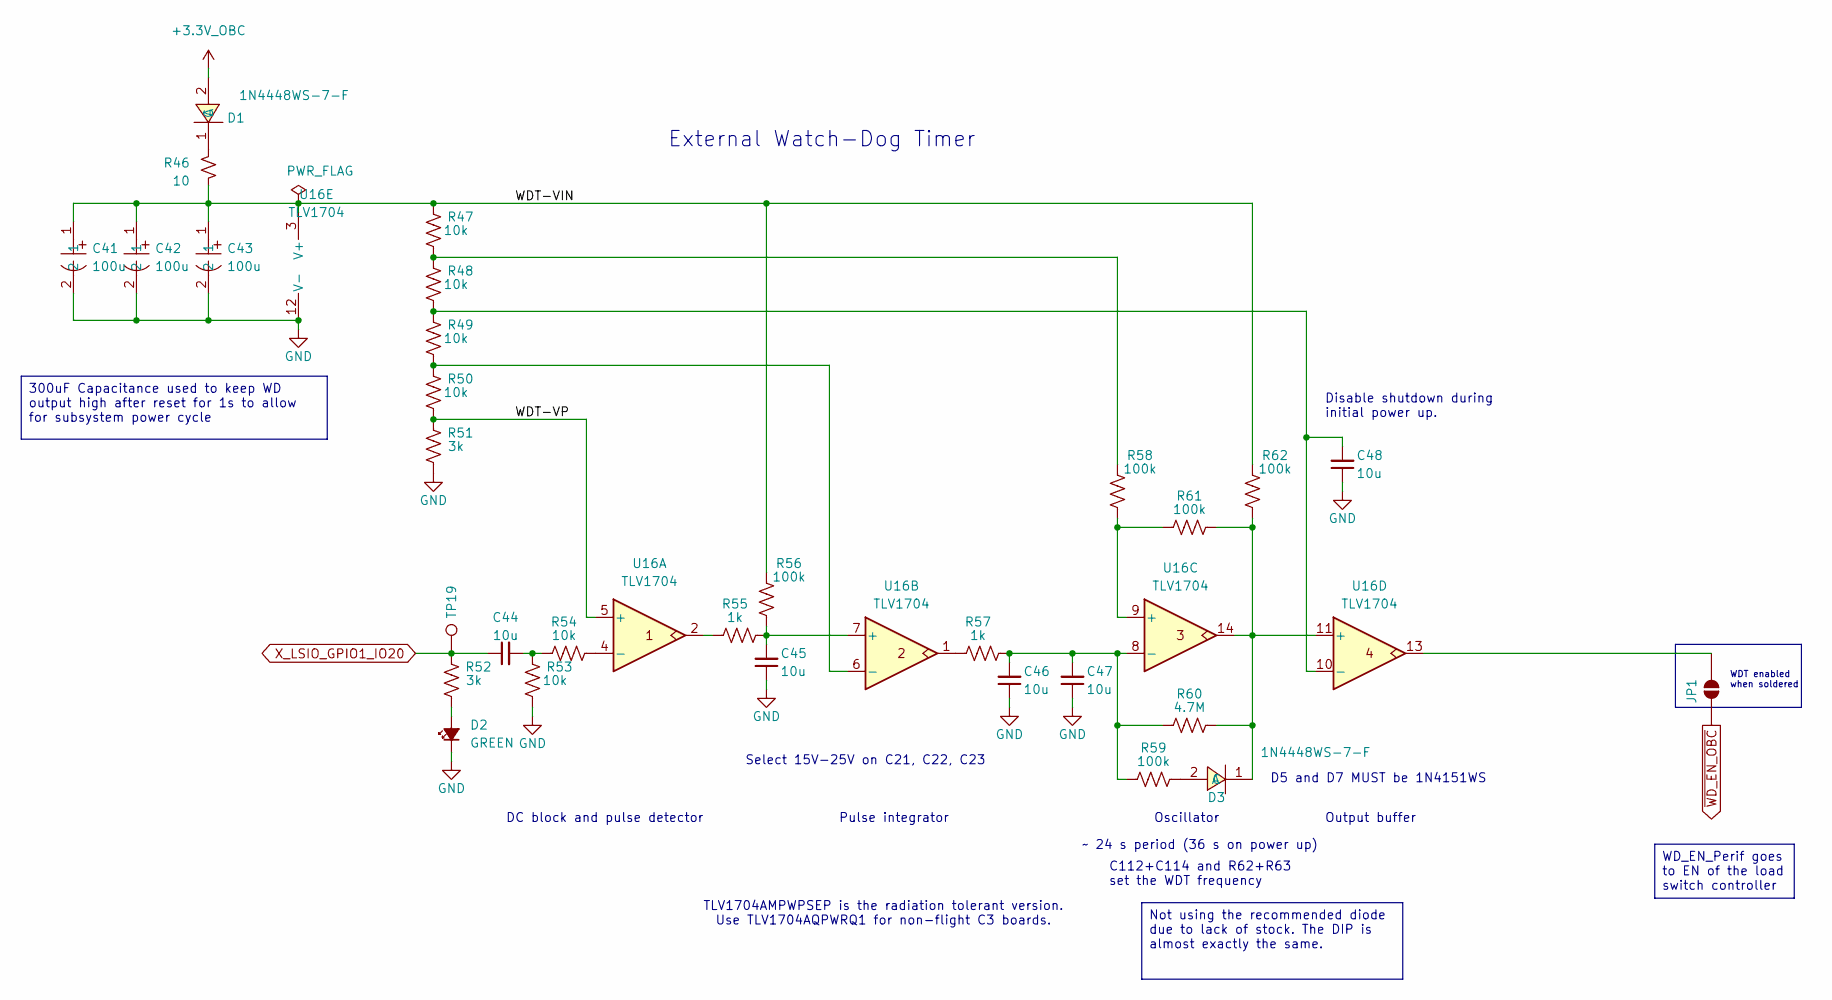
[picture p201: schematic WD_OBC.kicad_sch, Leviathan V2]

Parts:
C41, C42, C43: 100u; CAP-SMD_L7.3-W6.1_TCN4227M025R0100; LCSC Part C2158793
C44, C45, C46, C47, C48: 10u; C0402; LCSC 194427
D1, D3: 1N4448WS-7-F; SOD-323_L1.8-W1.3-LS2.5-RD; MPN 1N4151WS-E3-08; LCSC C2979762
D2: GREEN; LED_0603_1608Metric; MPN 150060GS75000; LCSC C965799
JP1: SolderJumper_2_Open; SolderJumper-2_P1.3mm_Open_RoundedPad1.0x1.5mm
R46: 10; R_1206_3216Metric; MPN ESR18EZPF10R0; LCSC C17903
R47, R48, R49, R50, R53, R54: 10k; R0402; LCSC C25531
R51, R52: 3k; R0402; LCSC C2909355
R55, R57: 1k; R0402; LCSC C106235
R56, R58, R59, R61, R62: 100k; R0402; LCSC C269673
R60: 4.7M; R0402; LCSC C474132
TP19: TestPoint; TestPoint_Pad_D1.0mm
U16: TLV1704; TSSOP-14_4.4x5mm_P0.65mm; MPN TLV1704AQPWRQ1; LCSC C181596

Connections:
+3.3V_OBC: D1.2 (A); also elsewhere on the board
/SCALES_EPS/OBC_Subsystem/WD_OBC/WDT-VIN: C41.1, C42.1, C43.1, R46.2, R47.2, R56.1, R62.1, U16.3 (V+)
/SCALES_EPS/OBC_Subsystem/WD_OBC/WDT-VP: R50.1, R51.2, U16.5 (+)
GND: C41.2, C42.2, C43.2, C45.1, C46.1, C47.1, C48.1, D2.1 (K), R51.1, R53.1, U16.12 (V-); also elsewhere on the board
unnamed: C44.2, R53.2, R54.2
unnamed: D1.1 (C), R46.1
unnamed: D2.2 (A), R52.1
unnamed: D3.2 (A), R59.2
unnamed: D3.1 (C), R60.2, R61.2, R62.2, U16.11 (+), U16.14
unnamed: JP1.1 (A), U16.13
unnamed: R47.1, R48.2, R58.1
unnamed: R55.2, U16.2
unnamed: R57.2, U16.1
unnamed: R54.1, U16.4 (-)
unnamed: C45.2, R55.1, R56.2, U16.7 (+)
unnamed: R49.1, R50.2, U16.6 (-)
unnamed: R58.2, R61.1, U16.9 (+)
unnamed: C46.2, C47.2, R57.1, R59.1, R60.1, U16.8 (-)
unnamed: C48.2, R48.1, R49.2, U16.10 (-)
X_LSIO_GPIO1_IO20: C44.1, R52.2, TP19.1 (1_1); also elsewhere on the board
~WD_EN_OBC: JP1.2 (B); also elsewhere on the board

Notes on the sheet:
Select 15V-25V on C21, C22, C23
C112+C114 and R62+R63 set the WDT frequency
WDT enabled when soldered
Oscillator
TLV1704AMPWPSEP is the radiation tolerant version. Use TLV1704AQPWRQ1 for non-flight C3 boards.
External Watch-Dog Timer
DC block and pulse detector
~ 24 s period (36 s on power up)
D5 and D7 MUST be 1N4151WS
Disable shutdown during initial power up.
Pulse integrator
Output buffer
Not using the recommended diode due to lack of stock. The DIP is almost exactly the same.
300uF Capacitance used to keep WD output high after reset for 1s to allow for subsystem power cycle
WD_EN_Perif goes to EN of the load switch controller

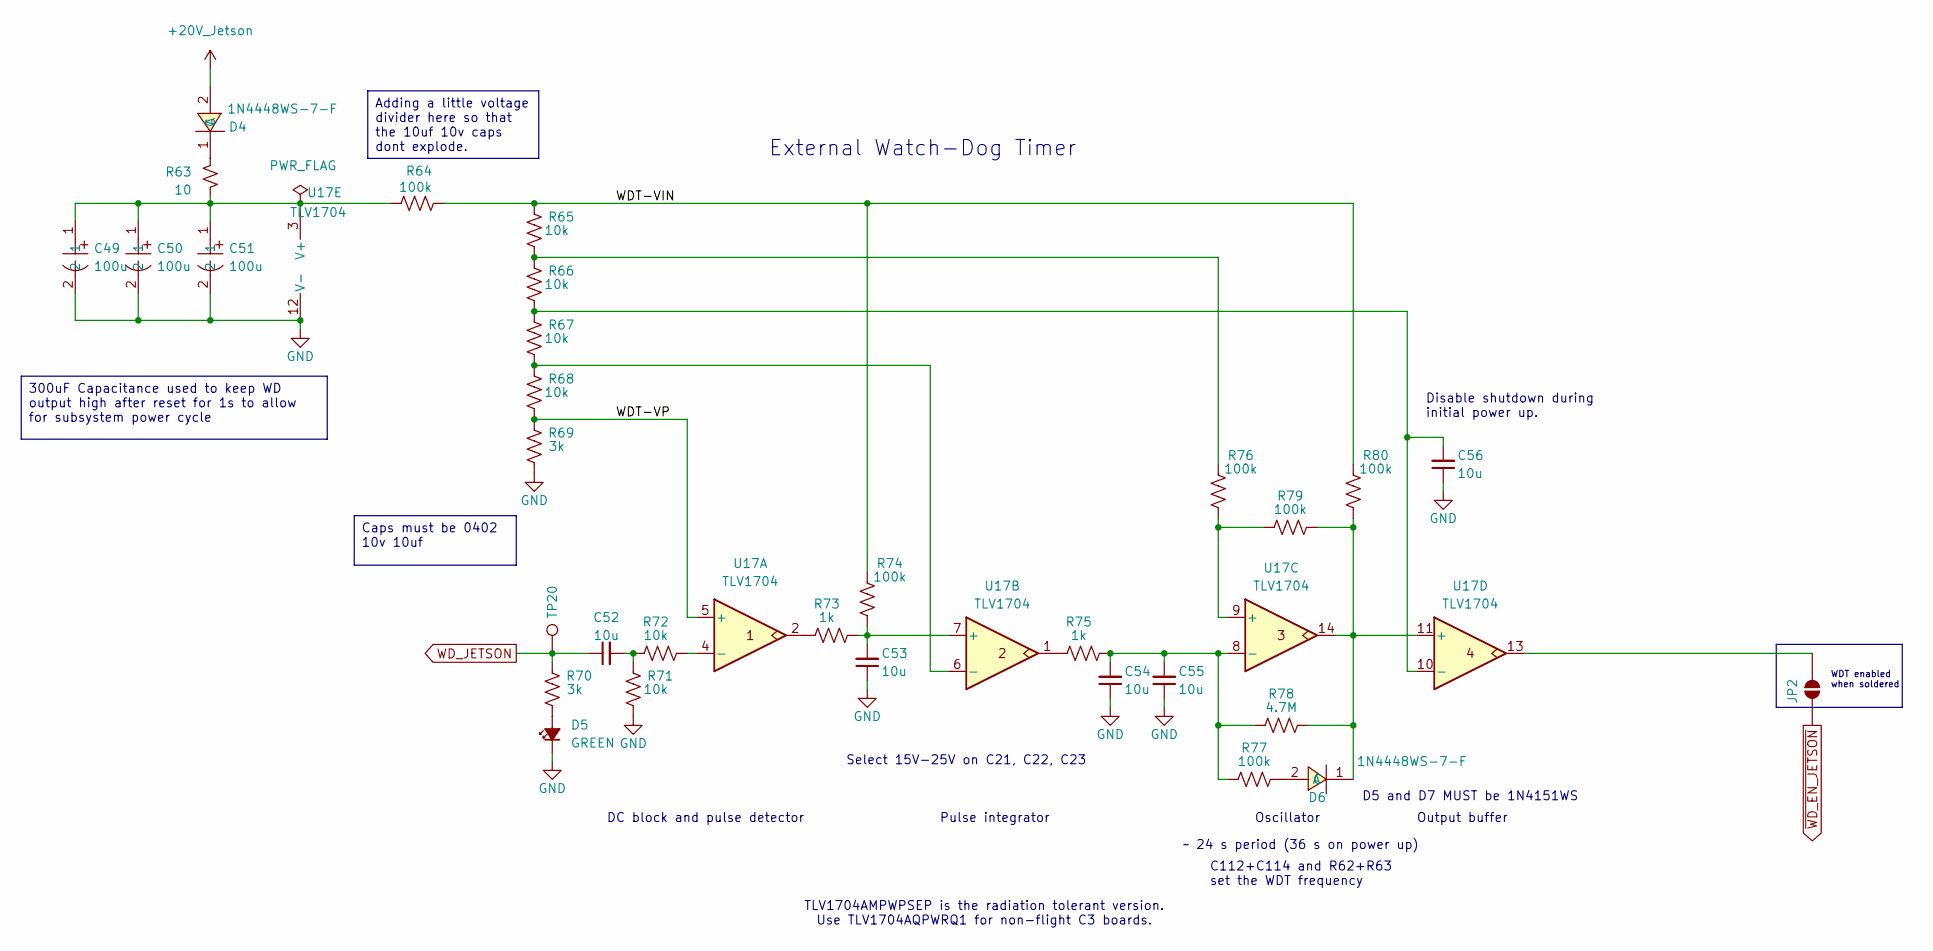
[picture p202: schematic WD_Jetson.kicad_sch, Leviathan V2]

Parts:
C49, C50, C51: 100u; CAP-SMD_L7.3-W6.1_TCN4227M025R0100; LCSC Part C2158793
C52, C55, C56: 10u; C0402; LCSC 194427
C53, C54: 10u; C0402
D4, D6: 1N4448WS-7-F; SOD-323_L1.8-W1.3-LS2.5-RD; MPN 1N4151WS-E3-08; LCSC C2979762
D5: GREEN; LED_0603_1608Metric; MPN 150060GS75000; LCSC C965799
JP2: SolderJumper_2_Open; SolderJumper-2_P1.3mm_Open_RoundedPad1.0x1.5mm
R63: 10; R_1206_3216Metric; MPN ESR18EZPF10R0; LCSC C17903
R64, R74, R76, R77, R79, R80: 100k; R0402; LCSC C269673
R65, R66, R67, R68, R71, R72: 10k; R0402; LCSC C25531
R69, R70: 3k; R0402; LCSC C2909355
R73, R75: 1k; R0402; LCSC C106235
R78: 4.7M; R0402; LCSC C474132
TP20: TestPoint; TestPoint_Pad_D1.0mm
U17: TLV1704; TSSOP-14_4.4x5mm_P0.65mm; MPN TLV1704AQPWRQ1; LCSC C181596

Connections:
+20V_Jetson: D4.2 (A); also elsewhere on the board
/SCALES_EPS/Jetson_Subsystem/WD_Jetson/WDT-VIN: R64.2, R65.2, R74.1, R80.1
/SCALES_EPS/Jetson_Subsystem/WD_Jetson/WDT-VP: R68.1, R69.2, U17.5 (+)
GND: C49.2, C50.2, C51.2, C53.1, C54.1, C55.1, C56.1, D5.1 (K), R69.1, R71.1, U17.12 (V-); also elsewhere on the board
unnamed: C52.2, R71.2, R72.2
unnamed: D4.1 (C), R63.1
unnamed: D5.2 (A), R70.1
unnamed: D6.2 (A), R77.2
unnamed: D6.1 (C), R78.2, R79.2, R80.2, U17.11 (+), U17.14
unnamed: JP2.1 (A), U17.13
unnamed: R65.1, R66.2, R76.1
unnamed: R73.2, U17.2
unnamed: R75.2, U17.1
unnamed: R72.1, U17.4 (-)
unnamed: C53.2, R73.1, R74.2, U17.7 (+)
unnamed: R67.1, R68.2, U17.6 (-)
unnamed: R76.2, R79.1, U17.9 (+)
unnamed: C54.2, C55.2, R75.1, R77.1, R78.1, U17.8 (-)
unnamed: C56.2, R66.1, R67.2, U17.10 (-)
unnamed: C49.1, C50.1, C51.1, R63.2, R64.1, U17.3 (V+)
WD_JETSON: C52.1, R70.2, TP20.1 (1_1); also elsewhere on the board
~WD_EN_JETSON: JP2.2 (B); also elsewhere on the board

Notes on the sheet:
Pulse integrator
TLV1704AMPWPSEP is the radiation tolerant version. Use TLV1704AQPWRQ1 for non-flight C3 boards.
Oscillator
Select 15V-25V on C21, C22, C23
WDT enabled when soldered
C112+C114 and R62+R63 set the WDT frequency
Disable shutdown during initial power up.
~ 24 s period (36 s on power up)
External Watch-Dog Timer
DC block and pulse detector
D5 and D7 MUST be 1N4151WS
Output buffer
Caps must be 0402 10v 10uf
Adding a little voltage divider here so that the 10uf 10v caps dont explode.
300uF Capacitance used to keep WD output high after reset for 1s to allow for subsystem power cycle

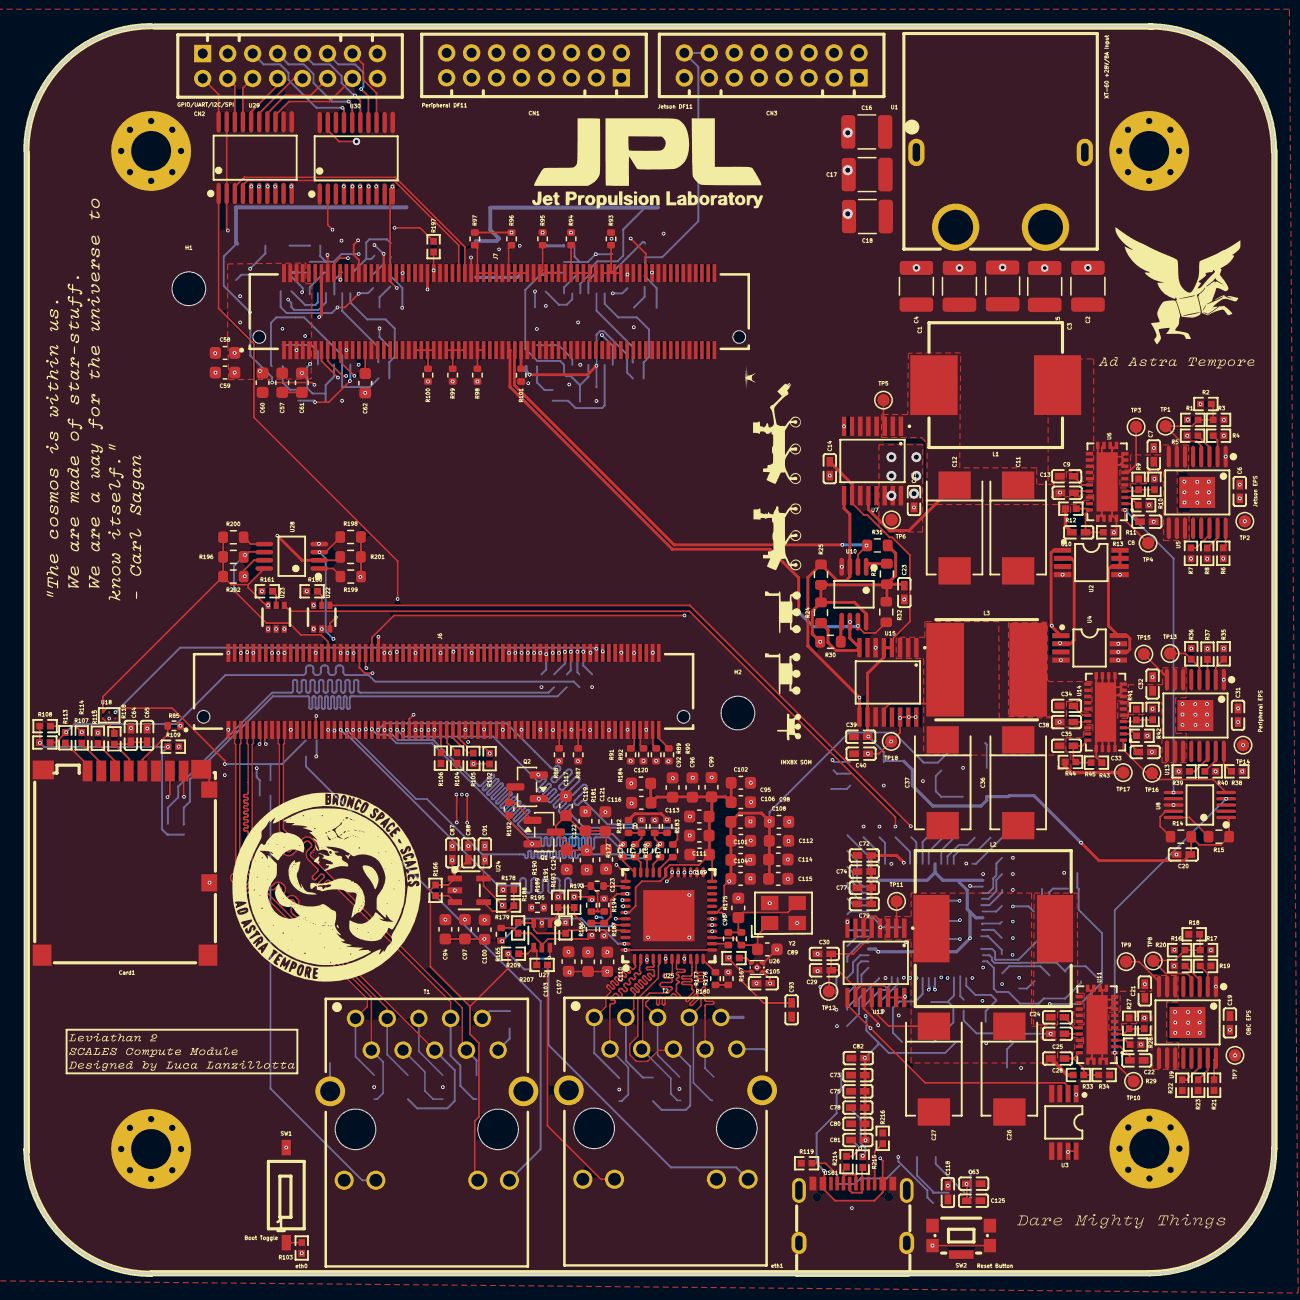
[picture p203: board imx8x_eps_leviathan_v2.kicad_pcb from above]

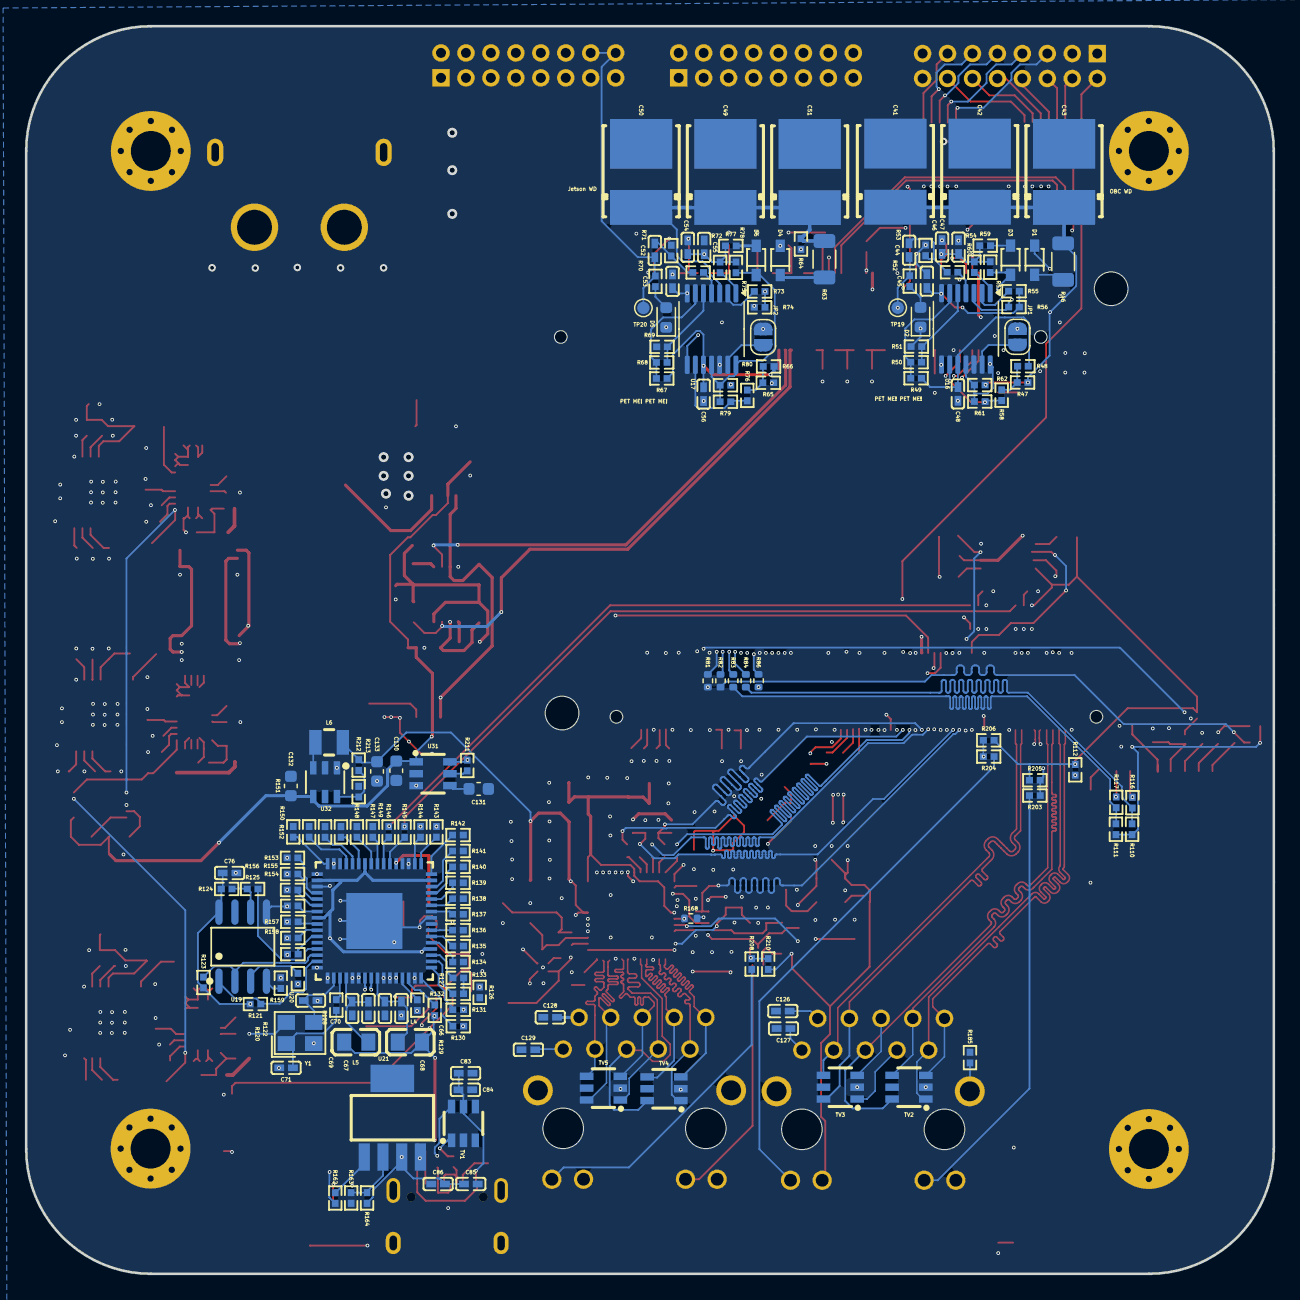
[picture p204: board imx8x_eps_leviathan_v2.kicad_pcb from below]

Board: 6 copper layers, 100.0 x 100.0 mm, 441 parts (160 on the bottom side), 317 nets.
