BroncoSpace-Lab/scales-hardware/peripheral_board/peripheral_board_v1/periph_ethernet_switch/periph_ethernet_switch.kicad_pcb

## KiCad design peripheral_board/peripheral_board_v1/periph_ethernet_switch/periph_ethernet_switch.kicad_pcb (2026-04-14)

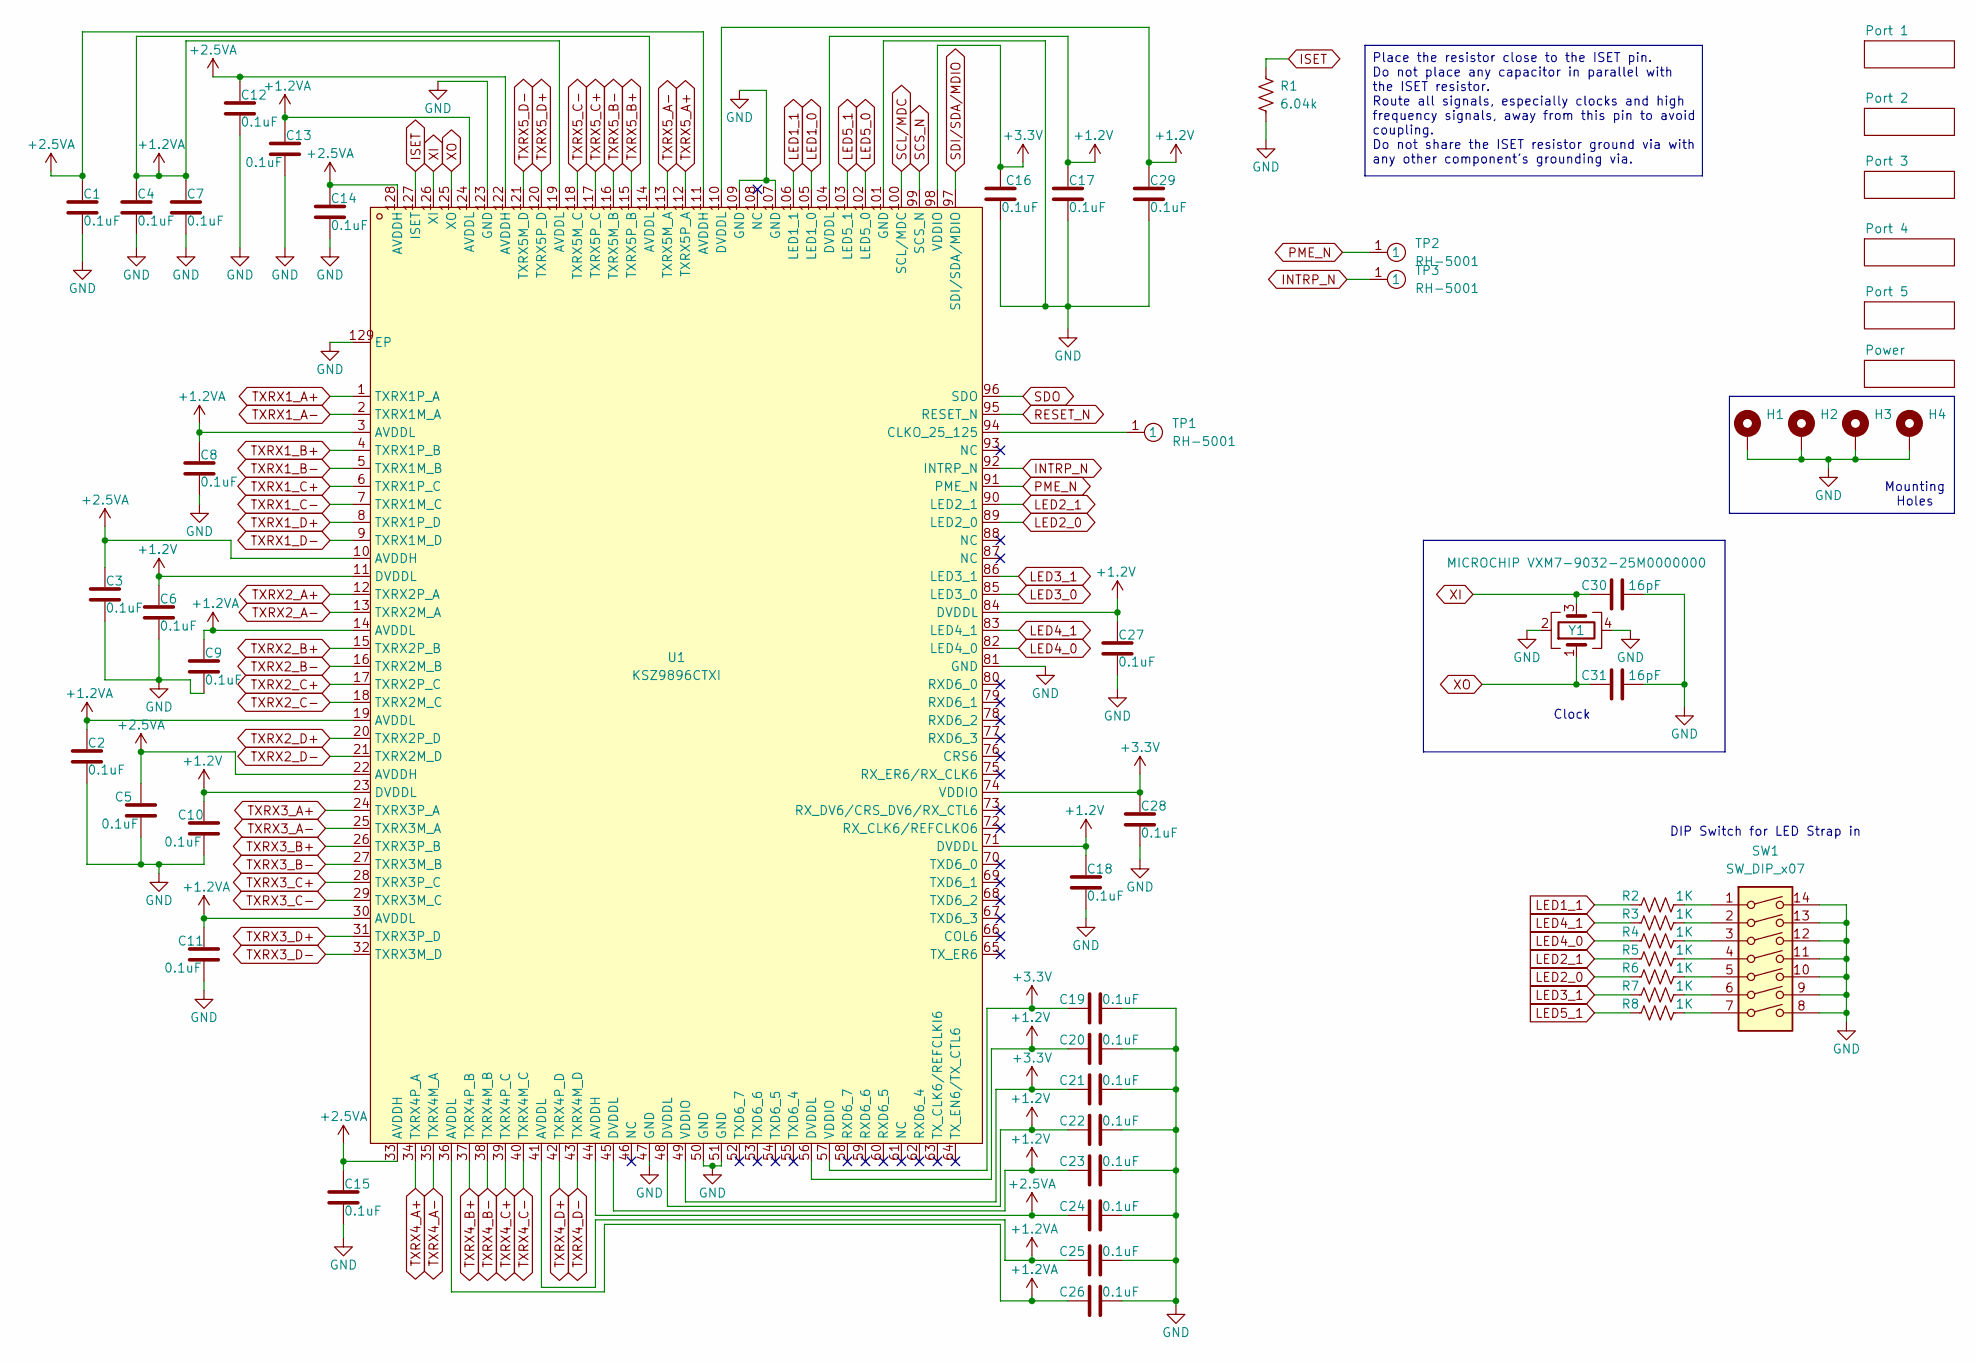
[picture p205: schematic periph_ethernet_switch.kicad_sch]

Parts:
C1, C2, C3, C4, C5, C6, C7, C8, C9, C10, C11, C12, C13, C14, C15, C16, C17, C18, C19, C20, C21, C22, C23, C24, C25, C26, C27, C28, C29: 0.1uF; C_0603_1608Metric
C30, C31: 16pF; C_0603_1608Metric
H1, H2, H3, H4: MountingHole; MountingHole_3mm_Pad
R1: 6.04k; R_0603_1608Metric
R2, R3, R4, R5, R6, R7, R8: 1K; R_0603_1608Metric
SW1: SW_DIP_x07; SW_DIP_SPSTx07_Slide_6.7x19.34mm_W7.62mm_P2.54mm_LowProfile
TP1, TP2, TP3: RH-5001; TEST-TH_BD2.54-P1.4_BLACK; LCSC Part C5199801
U1: KSZ9896CTXI; TQFP-128_L14.0-W14.0-P0.40-LS16.0-BL-EP; LCSC Part C638297
Y1: MICROCHIP VXM7-9032-25M0000000; CRYSTAL-SMD_4P-L3.2-W2.5-BL

Connections:
+1.2V: C6.1, C10.1, C17.1, C18.1, C20.1, C22.1, C23.1, C27.1, C29.1, U1.11 (DVDDL), U1.23 (DVDDL), U1.45 (DVDDL), U1.48 (DVDDL), U1.56 (DVDDL), U1.71 (DVDDL), U1.84 (DVDDL), U1.104 (DVDDL), U1.110 (DVDDL); also elsewhere on the board
+1.2VA: C2.1, C4.1, C7.1, C8.1, C9.1, C11.1, C13.1, C25.1, C26.1, U1.3 (AVDDL), U1.14 (AVDDL), U1.19 (AVDDL), U1.30 (AVDDL), U1.36 (AVDDL), U1.41 (AVDDL), U1.114 (AVDDL), U1.119 (AVDDL), U1.124 (AVDDL); also elsewhere on the board
+2.5VA: C1.1, C3.1, C5.1, C12.1, C14.1, C15.1, C24.1, U1.10 (AVDDH), U1.22 (AVDDH), U1.33 (AVDDH), U1.44 (AVDDH), U1.111 (AVDDH), U1.122 (AVDDH), U1.128 (AVDDH); also elsewhere on the board
+3.3V: C16.1, C19.1, C21.1, C28.1, U1.49 (VDDIO), U1.57 (VDDIO), U1.74 (VDDIO), U1.98 (VDDIO); also elsewhere on the board
GND: C1.2, C2.2, C3.2, C4.2, C5.2, C6.2, C7.2, C8.2, C9.2, C10.2, C11.2, C12.2, C13.2, C14.2, C15.2, C16.2, C17.2, C18.2, C19.2, C20.2, C21.2, C22.2, C23.2, C24.2, C25.2, C26.2, C27.2, C28.2, C29.2, C30.2, C31.2, H1.1, H2.1, H3.1, H4.1, R1.1, SW1.8, SW1.9, SW1.10, SW1.11, SW1.12, SW1.13, SW1.14, U1.47 (GND), U1.50 (GND), U1.51 (GND), U1.81 (GND), U1.101 (GND), U1.107 (GND), U1.109 (GND), U1.123 (GND), U1.129 (EP), Y1.2, Y1.4; also elsewhere on the board
INTRP_N: TP3.1, U1.92 (INTRP_N)
ISET: R1.2, U1.127 (ISET)
LED1_0: U1.105 (LED1_0); also elsewhere on the board
LED1_1: R2.2, U1.106 (LED1_1); also elsewhere on the board
LED2_0: R6.2, U1.89 (LED2_0); also elsewhere on the board
LED2_1: R5.2, U1.90 (LED2_1); also elsewhere on the board
LED3_0: U1.85 (LED3_0); also elsewhere on the board
LED3_1: R7.2, U1.86 (LED3_1); also elsewhere on the board
LED4_0: R4.2, U1.82 (LED4_0); also elsewhere on the board
LED4_1: R3.2, U1.83 (LED4_1); also elsewhere on the board
LED5_0: U1.102 (LED5_0); also elsewhere on the board
LED5_1: R8.2, U1.103 (LED5_1); also elsewhere on the board
unnamed: R2.1, SW1.1
unnamed: R3.1, SW1.2
unnamed: R4.1, SW1.3
unnamed: R5.1, SW1.4
unnamed: R6.1, SW1.5
unnamed: R7.1, SW1.6
unnamed: R8.1, SW1.7
unnamed: TP1.1, U1.94 (CLKO_25_125)
PME_N: TP2.1, U1.91 (PME_N)
RESET_N: U1.95 (RESET_N); also elsewhere on the board
SCL/MDC: U1.100 (SCL/MDC); also elsewhere on the board
SCS_N: U1.99 (SCS_N); also elsewhere on the board
SDI/SDA/MDIO: U1.97 (SDI/SDA/MDIO); also elsewhere on the board
SDO: U1.96 (SDO); also elsewhere on the board
TXRX1_A+: U1.1 (TXRX1P_A); also elsewhere on the board
TXRX1_A-: U1.2 (TXRX1M_A); also elsewhere on the board
TXRX1_B+: U1.4 (TXRX1P_B); also elsewhere on the board
TXRX1_B-: U1.5 (TXRX1M_B); also elsewhere on the board
TXRX1_C+: U1.6 (TXRX1P_C); also elsewhere on the board
TXRX1_C-: U1.7 (TXRX1M_C); also elsewhere on the board
TXRX1_D+: U1.8 (TXRX1P_D); also elsewhere on the board
TXRX1_D-: U1.9 (TXRX1M_D); also elsewhere on the board
TXRX2_A+: U1.12 (TXRX2P_A); also elsewhere on the board
TXRX2_A-: U1.13 (TXRX2M_A); also elsewhere on the board
TXRX2_B+: U1.15 (TXRX2P_B); also elsewhere on the board
TXRX2_B-: U1.16 (TXRX2M_B); also elsewhere on the board
TXRX2_C+: U1.17 (TXRX2P_C); also elsewhere on the board
TXRX2_C-: U1.18 (TXRX2M_C); also elsewhere on the board
TXRX2_D+: U1.20 (TXRX2P_D); also elsewhere on the board
TXRX2_D-: U1.21 (TXRX2M_D); also elsewhere on the board
TXRX3_A+: U1.24 (TXRX3P_A); also elsewhere on the board
TXRX3_A-: U1.25 (TXRX3M_A); also elsewhere on the board
TXRX3_B+: U1.26 (TXRX3P_B); also elsewhere on the board
TXRX3_B-: U1.27 (TXRX3M_B); also elsewhere on the board
TXRX3_C+: U1.28 (TXRX3P_C); also elsewhere on the board
TXRX3_C-: U1.29 (TXRX3M_C); also elsewhere on the board
TXRX3_D+: U1.31 (TXRX3P_D); also elsewhere on the board
TXRX3_D-: U1.32 (TXRX3M_D); also elsewhere on the board
TXRX4_A+: U1.34 (TXRX4P_A); also elsewhere on the board
TXRX4_A-: U1.35 (TXRX4M_A); also elsewhere on the board
TXRX4_B+: U1.37 (TXRX4P_B); also elsewhere on the board
TXRX4_B-: U1.38 (TXRX4M_B); also elsewhere on the board
TXRX4_C+: U1.39 (TXRX4P_C); also elsewhere on the board
TXRX4_C-: U1.40 (TXRX4M_C); also elsewhere on the board
TXRX4_D+: U1.42 (TXRX4P_D); also elsewhere on the board
TXRX4_D-: U1.43 (TXRX4M_D); also elsewhere on the board
TXRX5_A+: U1.112 (TXRX5P_A); also elsewhere on the board
TXRX5_A-: U1.113 (TXRX5M_A); also elsewhere on the board
TXRX5_B+: U1.115 (TXRX5P_B); also elsewhere on the board
TXRX5_B-: U1.116 (TXRX5M_B); also elsewhere on the board
TXRX5_C+: U1.117 (TXRX5P_C); also elsewhere on the board
TXRX5_C-: U1.118 (TXRX5M_C); also elsewhere on the board
TXRX5_D+: U1.120 (TXRX5P_D); also elsewhere on the board
TXRX5_D-: U1.121 (TXRX5M_D); also elsewhere on the board
XI: C30.1, U1.126 (XI), Y1.3
XO: C31.1, U1.125 (XO), Y1.1

Notes on the sheet:
Mounting Holes
DIP Switch for LED Strap in
Clock
Place the resistor close to the ISET pin. Do not place any capacitor in parallel with the ISET resistor. Route all signals, especially clocks and high frequency signals, away from this pin to avoid coupling. Do not share the ISET resistor ground via with any other component's grounding via.

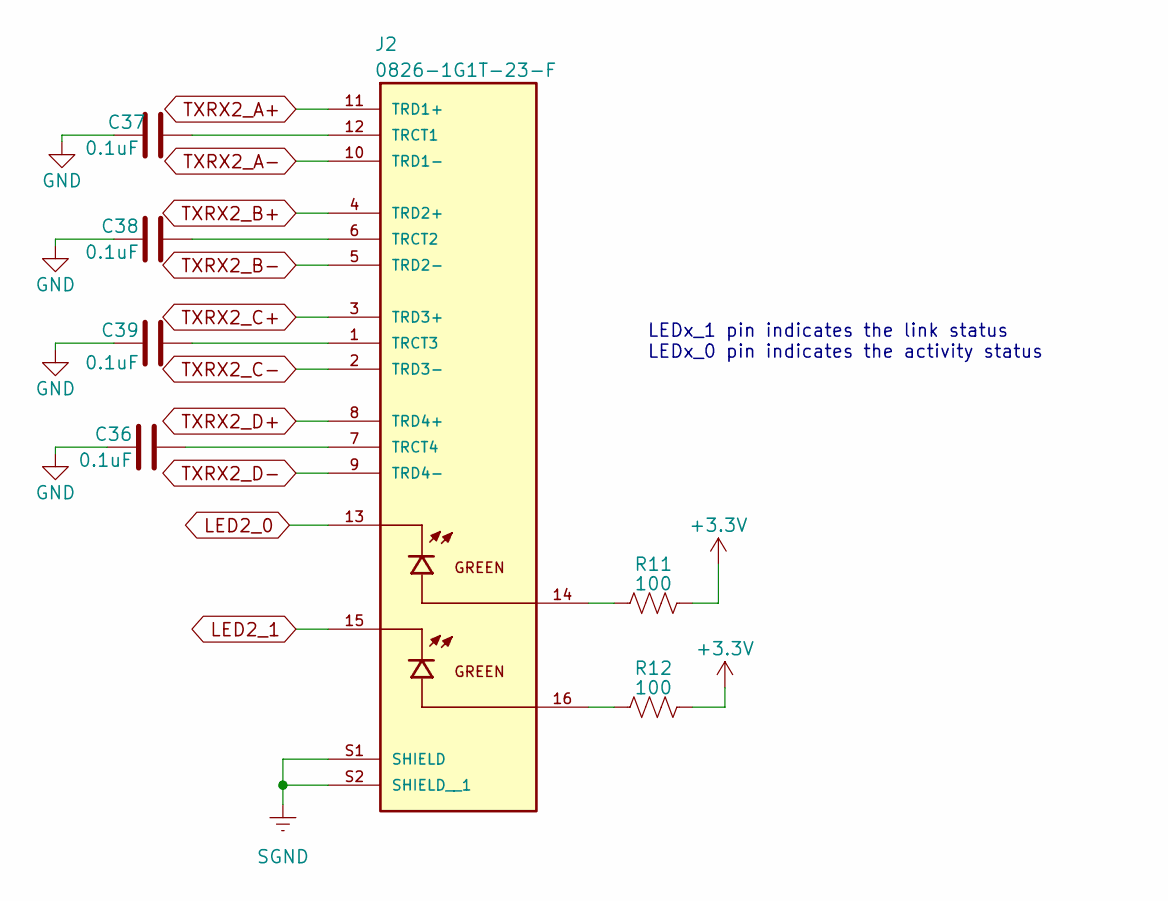
[picture p206: schematic port2.kicad_sch]

Parts:
C36, C37, C38, C39: 0.1uF; C_0603_1608Metric
J2: 0826-1G1T-23-F; BEL_0826-1G1T-23-F
R11, R12: 100; R_0603_1608Metric

Connections:
+3.3V: R11.1, R12.1; also elsewhere on the board
GND: C36.1, C37.1, C38.1, C39.1; also elsewhere on the board
LED2_0: J2.13; also elsewhere on the board
LED2_1: J2.15; also elsewhere on the board
unnamed: J2.14, R11.2
unnamed: J2.16, R12.2
unnamed: C37.2, J2.12 (TRCT1)
unnamed: C38.2, J2.6 (TRCT2)
unnamed: C39.2, J2.1 (TRCT3)
unnamed: C36.2, J2.7 (TRCT4)
SGND: J2.S1 (SHIELD), J2.S2 (SHIELD__1); also elsewhere on the board
TXRX2_A+: J2.11 (TRD1+); also elsewhere on the board
TXRX2_A-: J2.10 (TRD1-); also elsewhere on the board
TXRX2_B+: J2.4 (TRD2+); also elsewhere on the board
TXRX2_B-: J2.5 (TRD2-); also elsewhere on the board
TXRX2_C+: J2.3 (TRD3+); also elsewhere on the board
TXRX2_C-: J2.2 (TRD3-); also elsewhere on the board
TXRX2_D+: J2.8 (TRD4+); also elsewhere on the board
TXRX2_D-: J2.9 (TRD4-); also elsewhere on the board

Notes on the sheet:
LEDx_1 pin indicates the link status LEDx_0 pin indicates the activity status

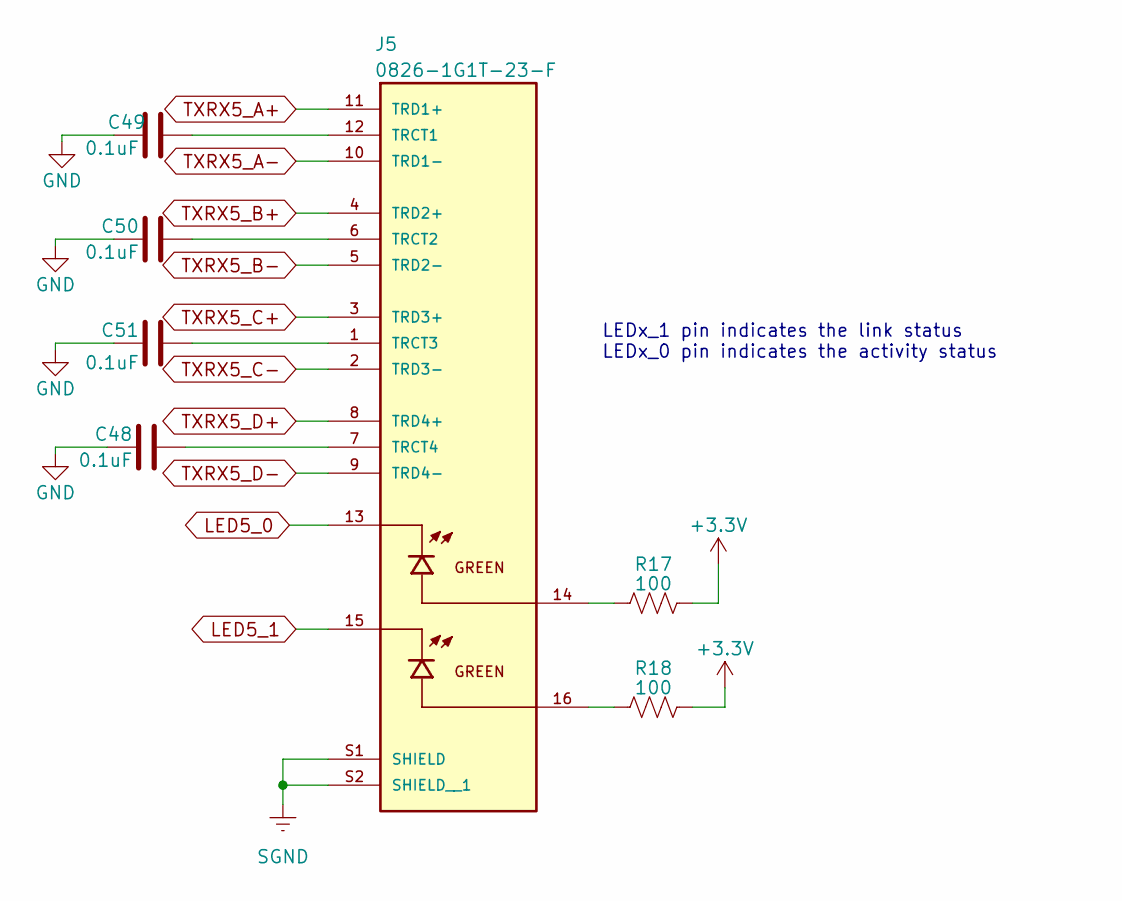
[picture p207: schematic port5.kicad_sch]

Parts:
C48, C49, C50, C51: 0.1uF; C_0603_1608Metric
J5: 0826-1G1T-23-F; BEL_0826-1G1T-23-F
R17, R18: 100; R_0603_1608Metric

Connections:
+3.3V: R17.1, R18.1; also elsewhere on the board
GND: C48.1, C49.1, C50.1, C51.1; also elsewhere on the board
LED5_0: J5.13; also elsewhere on the board
LED5_1: J5.15; also elsewhere on the board
unnamed: J5.14, R17.2
unnamed: J5.16, R18.2
unnamed: C49.2, J5.12 (TRCT1)
unnamed: C50.2, J5.6 (TRCT2)
unnamed: C51.2, J5.1 (TRCT3)
unnamed: C48.2, J5.7 (TRCT4)
SGND: J5.S1 (SHIELD), J5.S2 (SHIELD__1); also elsewhere on the board
TXRX5_A+: J5.11 (TRD1+); also elsewhere on the board
TXRX5_A-: J5.10 (TRD1-); also elsewhere on the board
TXRX5_B+: J5.4 (TRD2+); also elsewhere on the board
TXRX5_B-: J5.5 (TRD2-); also elsewhere on the board
TXRX5_C+: J5.3 (TRD3+); also elsewhere on the board
TXRX5_C-: J5.2 (TRD3-); also elsewhere on the board
TXRX5_D+: J5.8 (TRD4+); also elsewhere on the board
TXRX5_D-: J5.9 (TRD4-); also elsewhere on the board

Notes on the sheet:
LEDx_1 pin indicates the link status LEDx_0 pin indicates the activity status

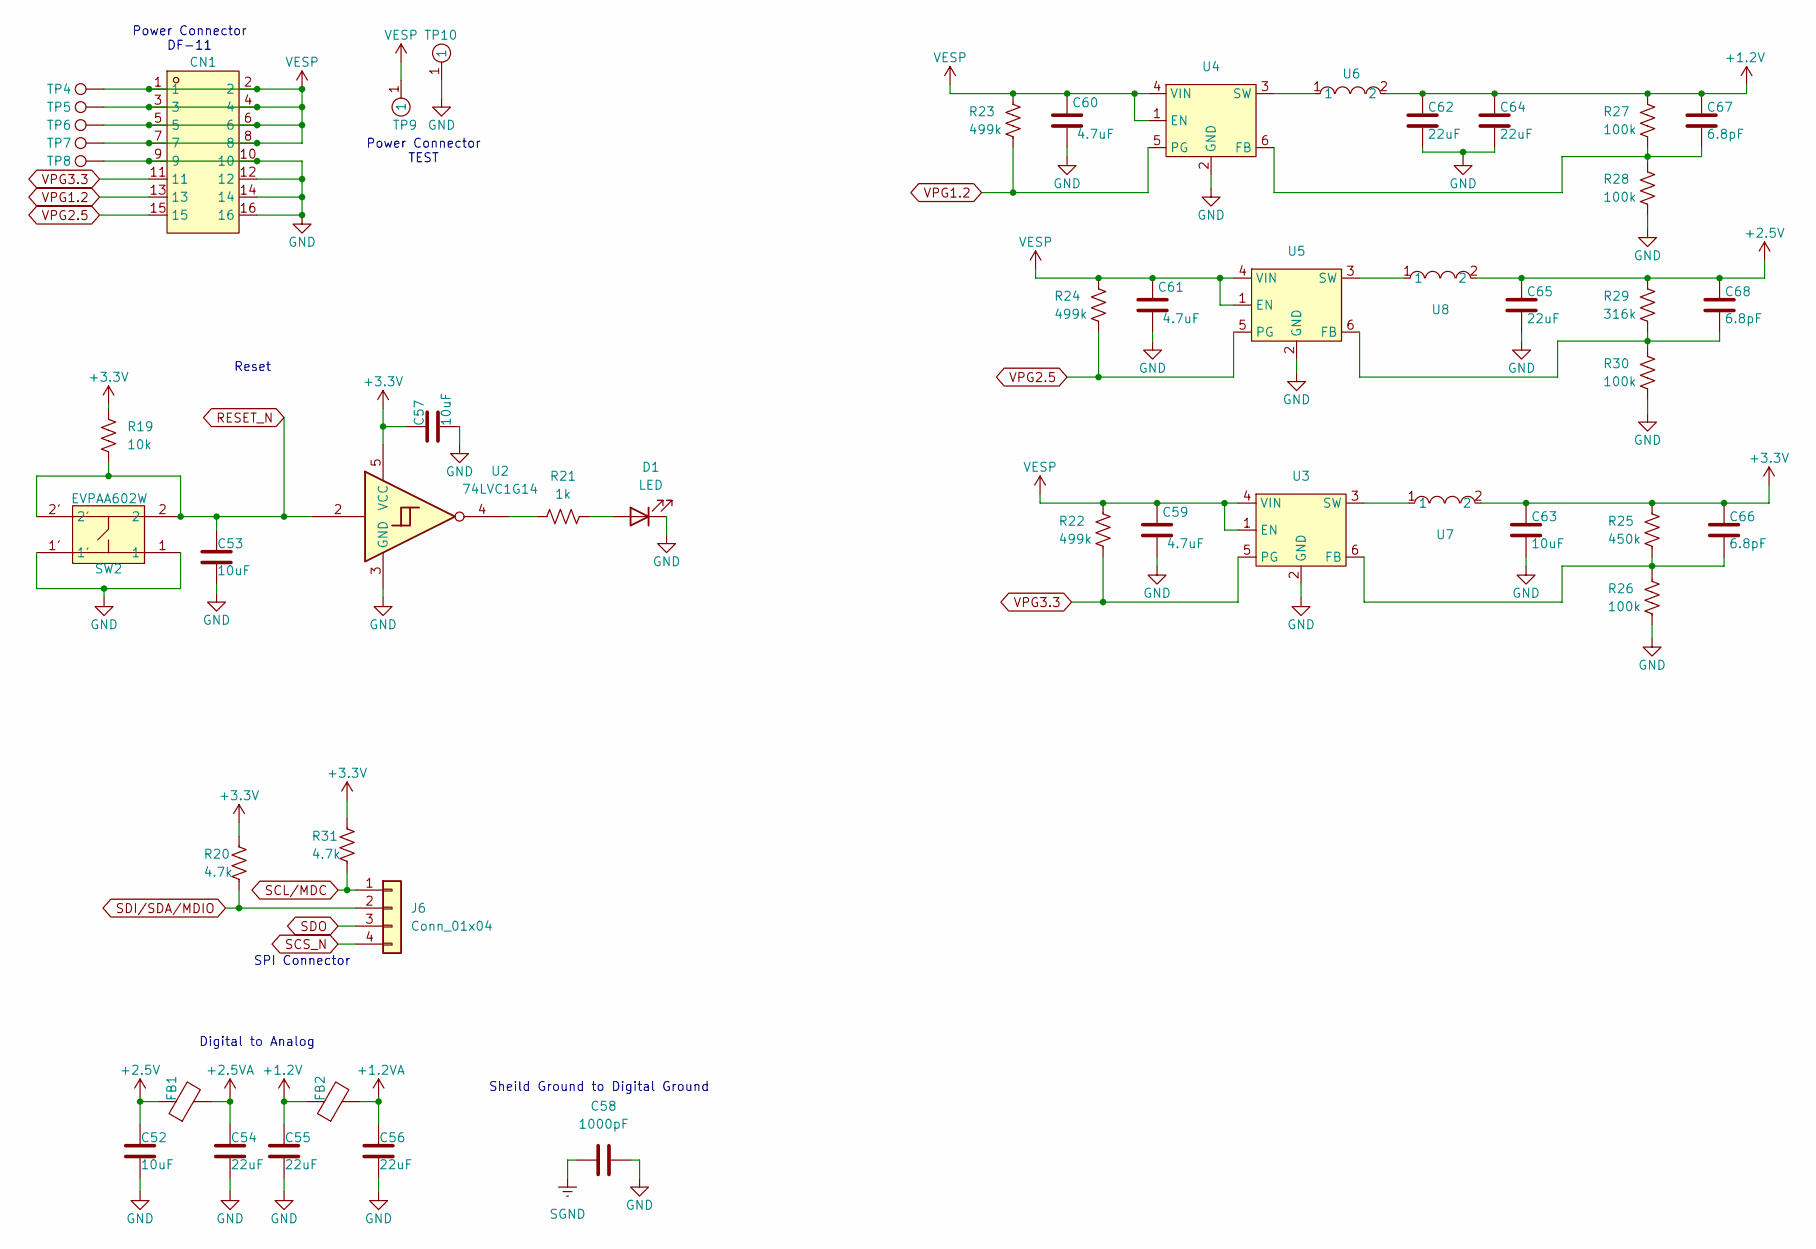
[picture p208: schematic power.kicad_sch]

Parts:
C52, C53, C57, C63: 10uF; C_0603_1608Metric
C54, C55, C56, C62, C64, C65: 22uF; C_0603_1608Metric
C58: 1000pF; C_1210_3225Metric
C59, C60, C61: 4.7uF; C_0603_1608Metric
C66, C67, C68: 6.8pF; C_0603_1608Metric
CN1: DF11-16DP-2DSA(08); CONN-TH_DF11-16DP-2DSA-08; LCSC Part C530981
D1: LED; LED0603-RD
FB1, FB2: FerriteBead; L_0805_2012Metric
J6: Conn_01x04; PinHeader_1x04_P2.54mm_Vertical
R19: 10k; R_0603_1608Metric
R20, R31: 4.7k; R_0603_1608Metric
R21: 1k; R_0603_1608Metric
R22, R23, R24: 499k; R_0603_1608Metric
R25: 450k; R_0603_1608Metric
R26, R27, R28, R30: 100k; R_0603_1608Metric
R29: 316k; R_0603_1608Metric
SW2: EVPAA602W; KEY-TH_4P-L3.5-W4.9-P2.80-LS4.3; LCSC Part C79148
TP4, TP5, TP6, TP7, TP8: TestPoint; TestPoint_Pad_1.0x1.0mm
TP9, TP10: RH-5001; TEST-TH_BD2.54-P1.4_BLACK; LCSC Part C5199801
U2: 74LVC1G14; SOT-23-5
U3, U4, U5: TLV62569PDDCR; SOT-23-6_L2.9-W1.6-P0.95-LS2.8-BL; LCSC Part C398365
U6, U7, U8: XAL4020-222MEC; IND-SMD_L4.0-W4.0-A; LCSC Part C3151182

Connections:
+1.2V: C55.1, C62.1, C64.1, C67.1, FB2.1, R27.2, U6.2; also elsewhere on the board
+1.2VA: C56.1, FB2.2; also elsewhere on the board
+2.5V: C52.1, C65.1, C68.1, FB1.1, R29.2, U8.2
+2.5VA: C54.1, FB1.2; also elsewhere on the board
+3.3V: C57.1, C63.1, C66.1, R19.2, R20.2, R25.2, R31.2, U2.5 (VCC), U7.2; also elsewhere on the board
GND: C52.2, C53.2, C54.2, C55.2, C56.2, C57.2, C58.2, C59.2, C60.2, C61.2, C62.2, C63.2, C64.2, C65.2, CN1.9, CN1.10, CN1.12, CN1.14, CN1.16, D1.1 (K), R26.1, R28.1, R30.1, SW2.1, SW2.1', TP8.1, TP10.1, U2.3 (GND), U3.2 (GND), U4.2 (GND), U5.2 (GND); also elsewhere on the board
unnamed: D1.2 (A), R21.1
unnamed: R21.2, U2.4
unnamed: C66.2, R25.1, R26.2, U3.6 (FB)
unnamed: U3.3 (SW), U7.1
unnamed: C67.2, R27.1, R28.2, U4.6 (FB)
unnamed: U4.3 (SW), U6.1
unnamed: C68.2, R29.1, R30.2, U5.6 (FB)
unnamed: U5.3 (SW), U8.1
RESET_N: C53.1, R19.1, SW2.2, SW2.2', U2.2; also elsewhere on the board
SCL/MDC: J6.1, R31.1; also elsewhere on the board
SCS_N: J6.4; also elsewhere on the board
SDI/SDA/MDIO: J6.2, R20.1; also elsewhere on the board
SDO: J6.3; also elsewhere on the board
SGND: C58.1; also elsewhere on the board
VESP: C59.1, C60.1, C61.1, CN1.1, CN1.2, CN1.3, CN1.4, CN1.5, CN1.6, CN1.7, CN1.8, R22.2, R23.2, R24.2, TP4.1, TP5.1, TP6.1, TP7.1, TP9.1, U3.1 (EN), U3.4 (VIN), U4.1 (EN), U4.4 (VIN), U5.1 (EN), U5.4 (VIN)
VPG1.2: CN1.13, R23.1, U4.5 (PG)
VPG2.5: CN1.15, R24.1, U5.5 (PG)
VPG3.3: CN1.11, R22.1, U3.5 (PG)

Notes on the sheet:
Reset
SPI Connector
Sheild Ground to Digital Ground
Digital to Analog
Power Connector DF-11
Power Connector TEST

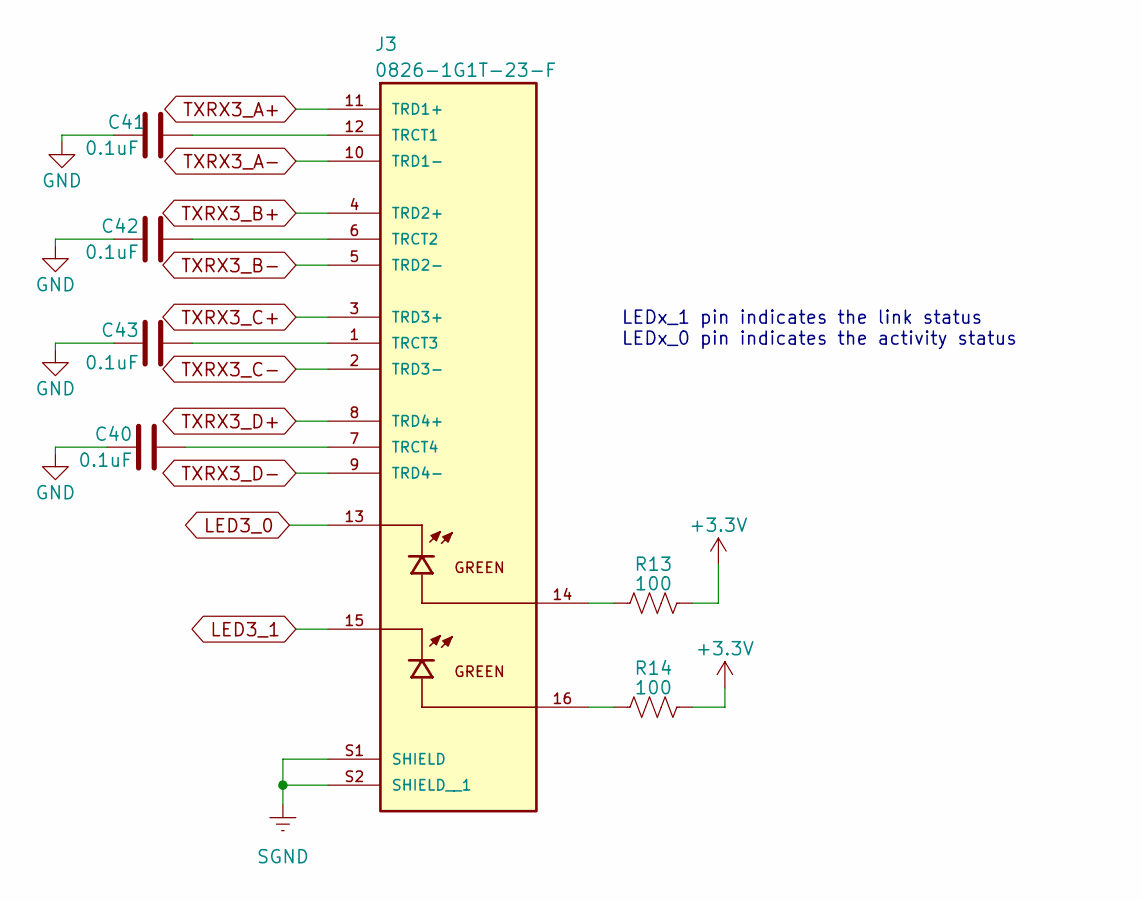
[picture p209: schematic port3.kicad_sch]

Parts:
C40, C41, C42, C43: 0.1uF; C_0603_1608Metric
J3: 0826-1G1T-23-F; BEL_0826-1G1T-23-F
R13, R14: 100; R_0603_1608Metric

Connections:
+3.3V: R13.1, R14.1; also elsewhere on the board
GND: C40.1, C41.1, C42.1, C43.1; also elsewhere on the board
LED3_0: J3.13; also elsewhere on the board
LED3_1: J3.15; also elsewhere on the board
unnamed: J3.14, R13.2
unnamed: J3.16, R14.2
unnamed: C41.2, J3.12 (TRCT1)
unnamed: C42.2, J3.6 (TRCT2)
unnamed: C43.2, J3.1 (TRCT3)
unnamed: C40.2, J3.7 (TRCT4)
SGND: J3.S1 (SHIELD), J3.S2 (SHIELD__1); also elsewhere on the board
TXRX3_A+: J3.11 (TRD1+); also elsewhere on the board
TXRX3_A-: J3.10 (TRD1-); also elsewhere on the board
TXRX3_B+: J3.4 (TRD2+); also elsewhere on the board
TXRX3_B-: J3.5 (TRD2-); also elsewhere on the board
TXRX3_C+: J3.3 (TRD3+); also elsewhere on the board
TXRX3_C-: J3.2 (TRD3-); also elsewhere on the board
TXRX3_D+: J3.8 (TRD4+); also elsewhere on the board
TXRX3_D-: J3.9 (TRD4-); also elsewhere on the board

Notes on the sheet:
LEDx_1 pin indicates the link status LEDx_0 pin indicates the activity status

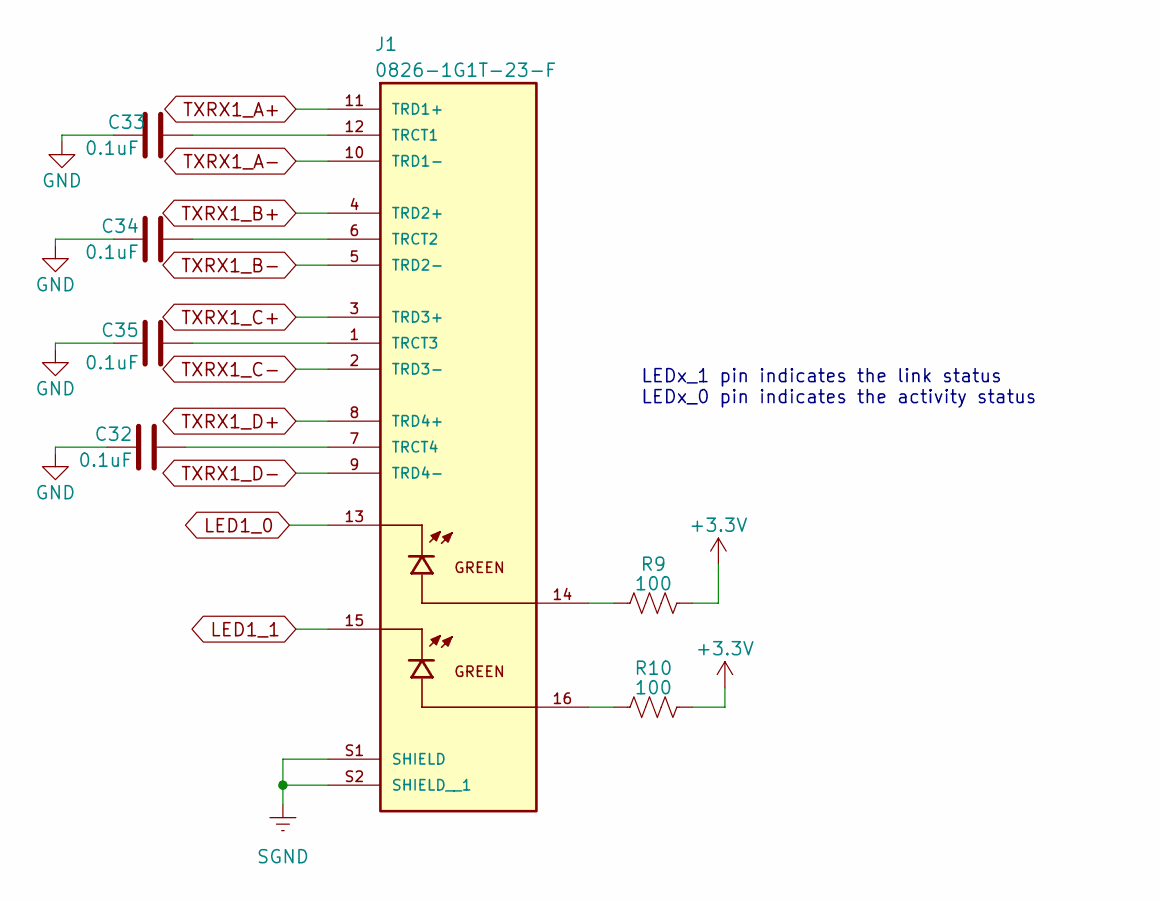
[picture p210: schematic port1.kicad_sch]

Parts:
C32, C33, C34, C35: 0.1uF; C_0603_1608Metric
J1: 0826-1G1T-23-F; BEL_0826-1G1T-23-F
R9, R10: 100; R_0603_1608Metric

Connections:
+3.3V: R9.1, R10.1; also elsewhere on the board
GND: C32.1, C33.1, C34.1, C35.1; also elsewhere on the board
LED1_0: J1.13; also elsewhere on the board
LED1_1: J1.15; also elsewhere on the board
unnamed: J1.14, R9.2
unnamed: J1.16, R10.2
unnamed: C33.2, J1.12 (TRCT1)
unnamed: C34.2, J1.6 (TRCT2)
unnamed: C35.2, J1.1 (TRCT3)
unnamed: C32.2, J1.7 (TRCT4)
SGND: J1.S1 (SHIELD), J1.S2 (SHIELD__1); also elsewhere on the board
TXRX1_A+: J1.11 (TRD1+); also elsewhere on the board
TXRX1_A-: J1.10 (TRD1-); also elsewhere on the board
TXRX1_B+: J1.4 (TRD2+); also elsewhere on the board
TXRX1_B-: J1.5 (TRD2-); also elsewhere on the board
TXRX1_C+: J1.3 (TRD3+); also elsewhere on the board
TXRX1_C-: J1.2 (TRD3-); also elsewhere on the board
TXRX1_D+: J1.8 (TRD4+); also elsewhere on the board
TXRX1_D-: J1.9 (TRD4-); also elsewhere on the board

Notes on the sheet:
LEDx_1 pin indicates the link status LEDx_0 pin indicates the activity status

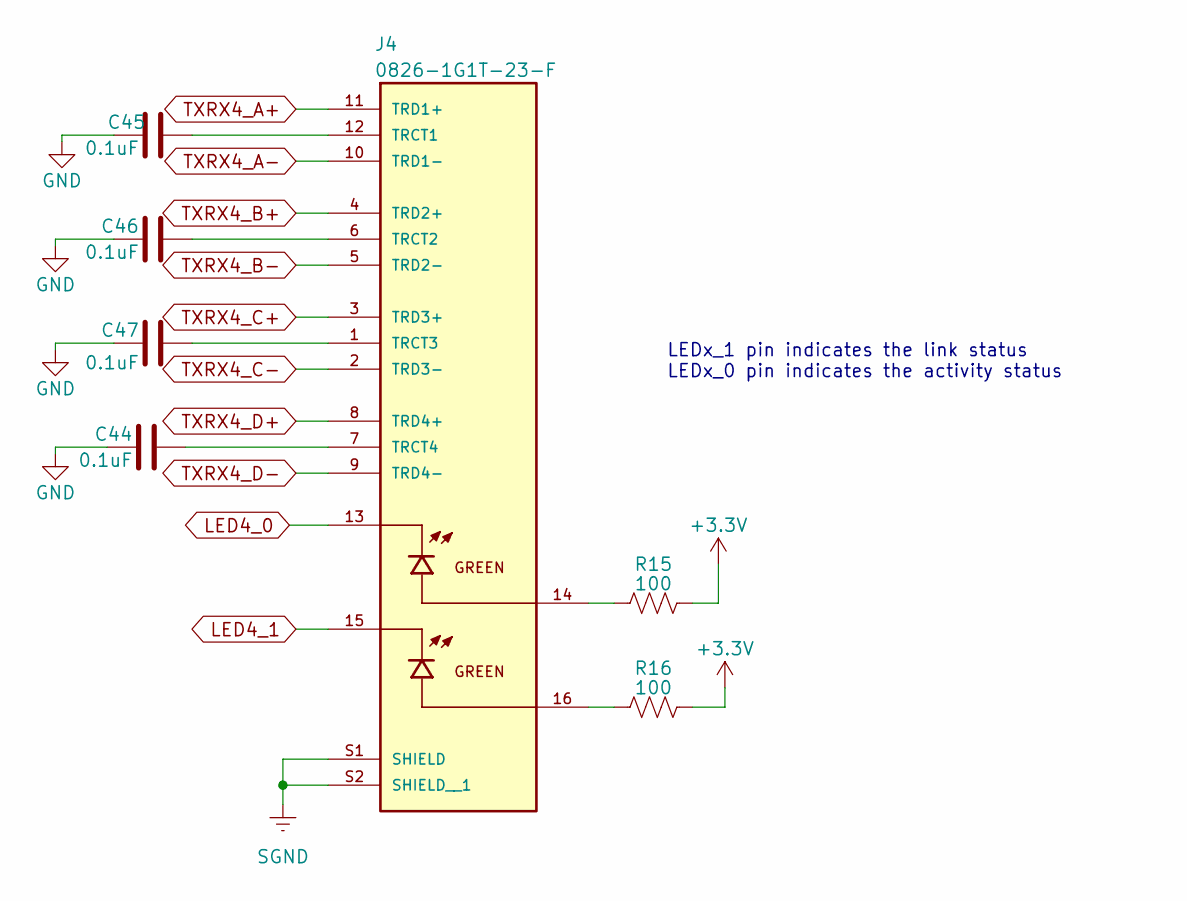
[picture p211: schematic port4.kicad_sch]

Parts:
C44, C45, C46, C47: 0.1uF; C_0603_1608Metric
J4: 0826-1G1T-23-F; BEL_0826-1G1T-23-F
R15, R16: 100; R_0603_1608Metric

Connections:
+3.3V: R15.1, R16.1; also elsewhere on the board
GND: C44.1, C45.1, C46.1, C47.1; also elsewhere on the board
LED4_0: J4.13; also elsewhere on the board
LED4_1: J4.15; also elsewhere on the board
unnamed: J4.14, R15.2
unnamed: J4.16, R16.2
unnamed: C45.2, J4.12 (TRCT1)
unnamed: C46.2, J4.6 (TRCT2)
unnamed: C47.2, J4.1 (TRCT3)
unnamed: C44.2, J4.7 (TRCT4)
SGND: J4.S1 (SHIELD), J4.S2 (SHIELD__1); also elsewhere on the board
TXRX4_A+: J4.11 (TRD1+); also elsewhere on the board
TXRX4_A-: J4.10 (TRD1-); also elsewhere on the board
TXRX4_B+: J4.4 (TRD2+); also elsewhere on the board
TXRX4_B-: J4.5 (TRD2-); also elsewhere on the board
TXRX4_C+: J4.3 (TRD3+); also elsewhere on the board
TXRX4_C-: J4.2 (TRD3-); also elsewhere on the board
TXRX4_D+: J4.8 (TRD4+); also elsewhere on the board
TXRX4_D-: J4.9 (TRD4-); also elsewhere on the board

Notes on the sheet:
LEDx_1 pin indicates the link status LEDx_0 pin indicates the activity status

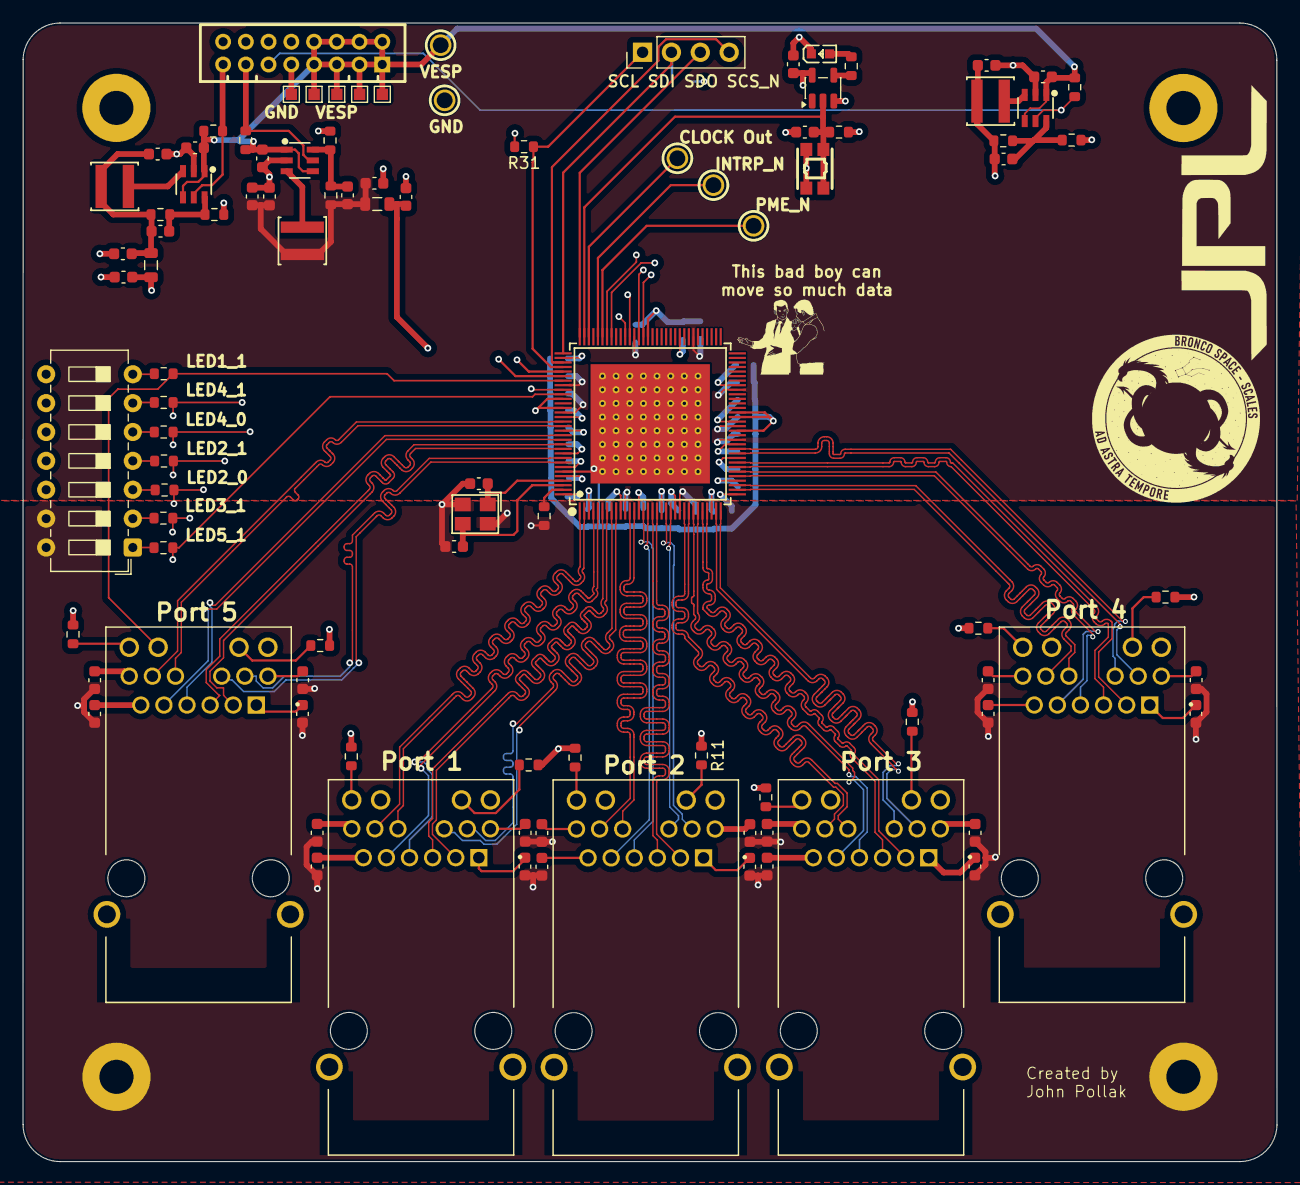
[picture p212: board periph_ethernet_switch.kicad_pcb from above]

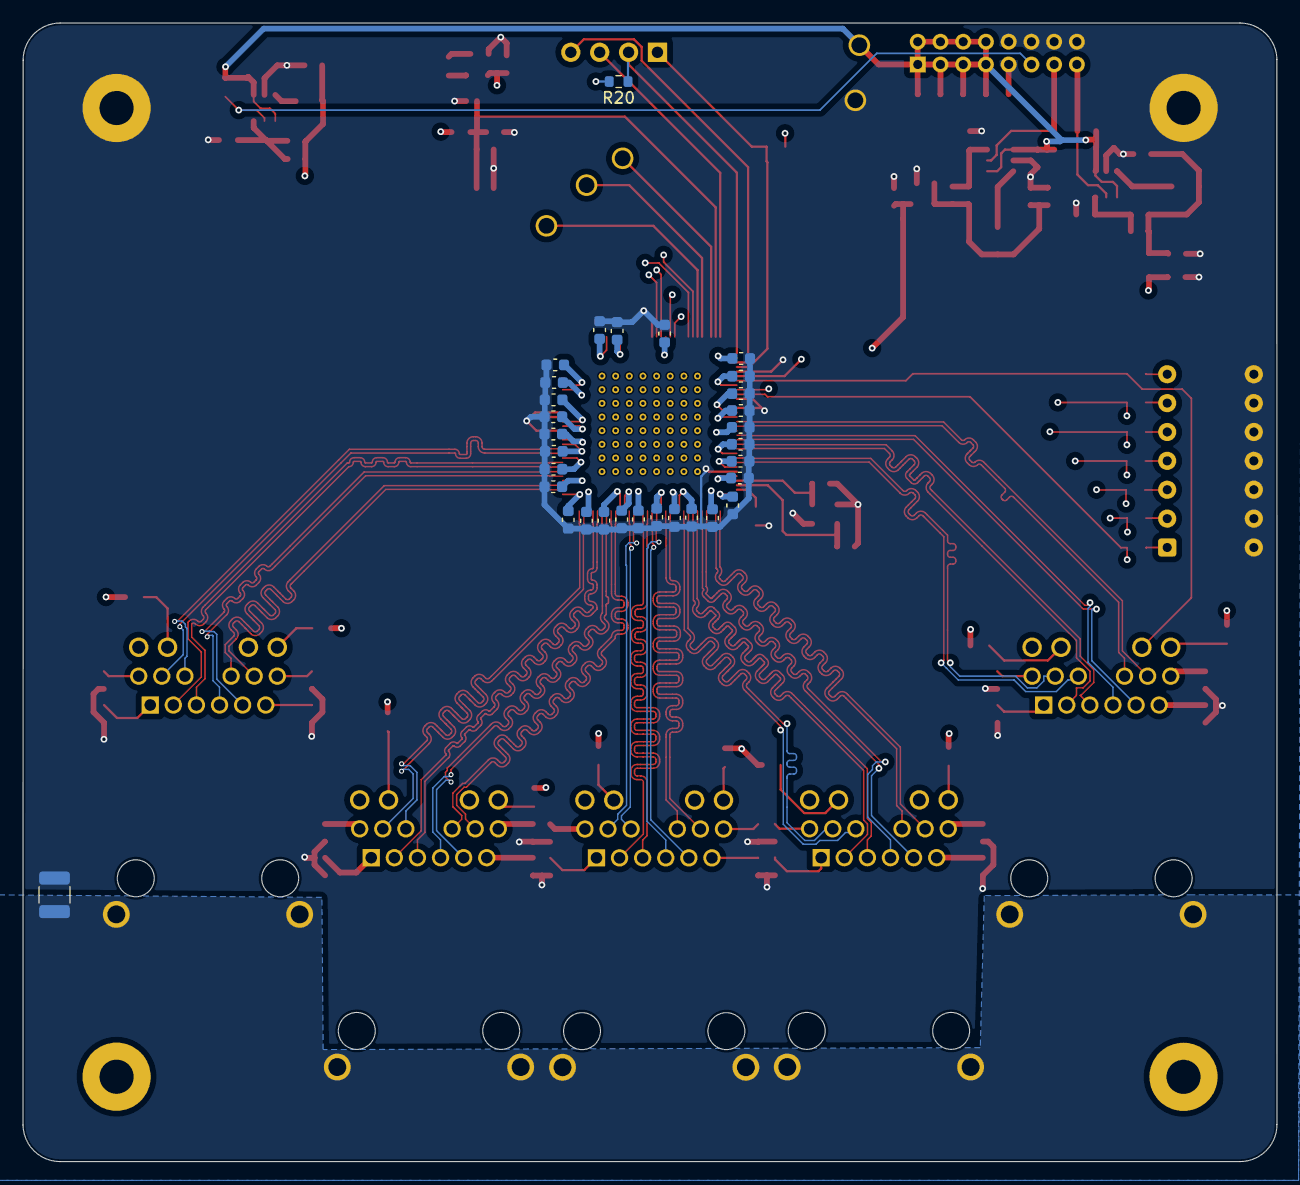
[picture p213: board periph_ethernet_switch.kicad_pcb from below]

Board: 6 copper layers, 110.3 x 100.2 mm, 134 parts (31 on the bottom side), 117 nets.
