BroncoSpace-Lab/scales-hardware/power_system/EPS/EPS_Scales_Merger_Sim_Model/EPS_Scales_RevG.kicad_pcb

## KiCad design power_system/EPS/EPS_Scales_Merger_Sim_Model/EPS_Scales_RevG.kicad_pcb (2026-04-14)

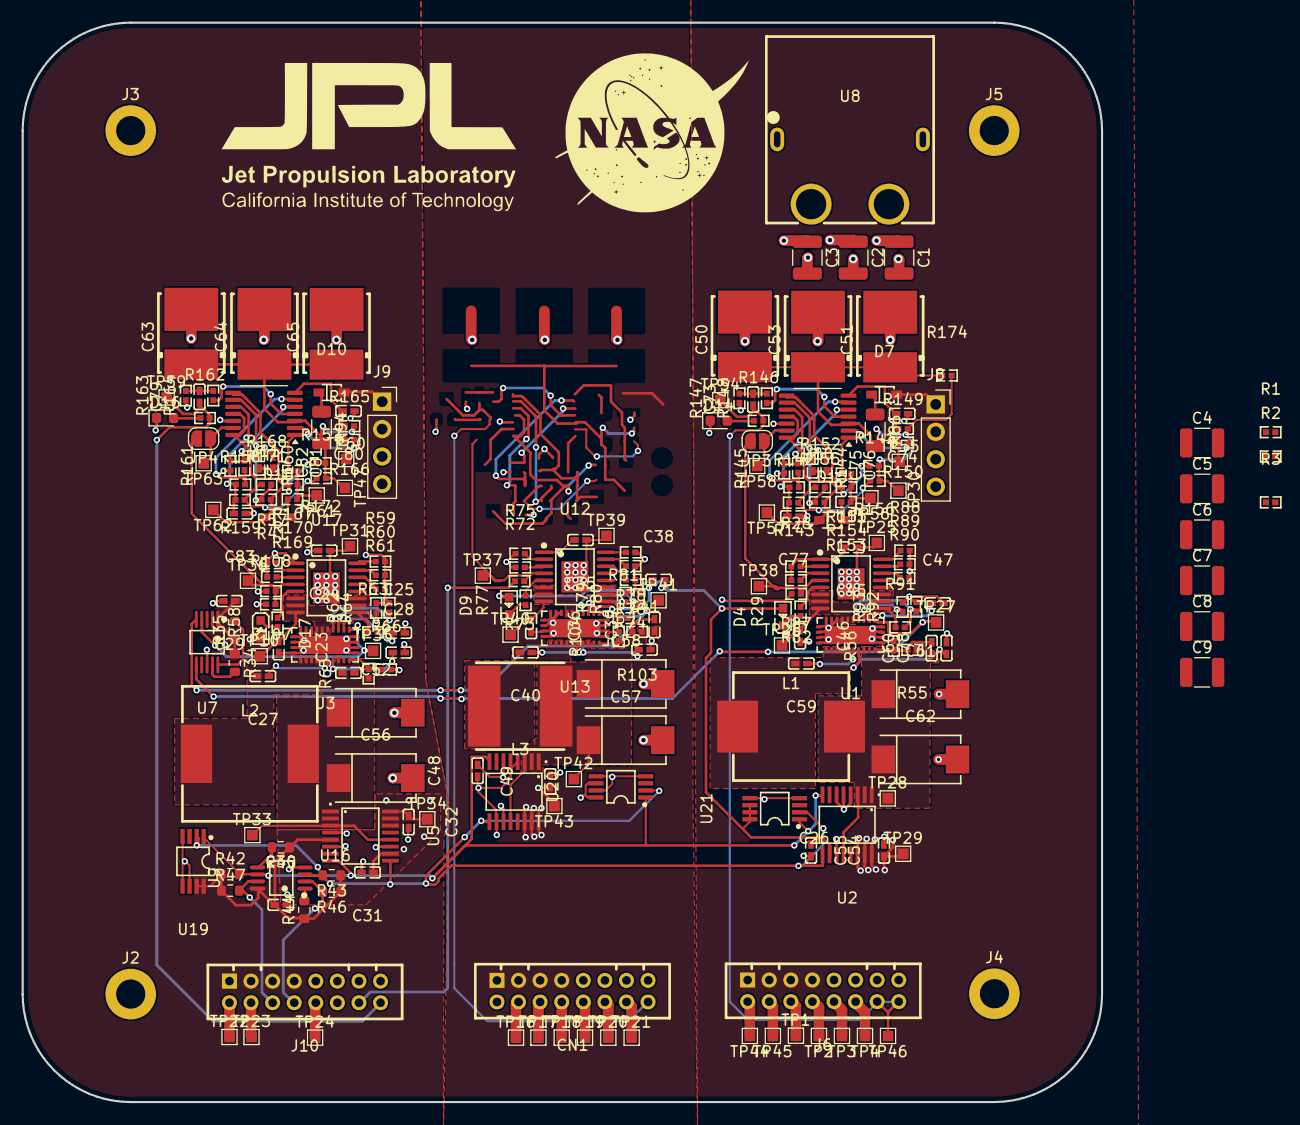
[picture p214: board EPS_Scales_RevG.kicad_pcb from above]

Board: 4 copper layers, 100.0 x 100.0 mm, 226 parts (0 on the bottom side), 123 nets.

Parts:
C1, C2, C3, C4, C5, C6, C7, C8, C9: 10u; C_1210_3225Metric
C23, C36, C46: 22n; C0402
C24, C35, C45: 220n; C0402
C25, C38, C47: 2.2u; C0402
C26, C39, C60: 10p; C0402
C27, C28, C29, C30, C31, C32, C40, C41, C48, C49, C54, C55, C59, C78: 100n; C0402
C50, C51, C53, C63, C64, C65: 100uF; CAP-SMD_L7.3-W6.1_TCN4227M025R0100
C52, C56, C57, C58, C61, C62: 47u; CAP-SMD_L7.3-W4.3-FD
C73, C74, C75, C76, C77, C79, C80, C81, C82, C83: 10u; C0402
CN1: DF11-16DP-2DSA(08); CONN-TH_DF11-16DP-2DSA-08
D4, D9, D17: LED; LED0603-RD_RED
D7, D10, D15, D18: 1N4448WS-7-F; SOD-323_L1.8-W1.3-LS2.5-RD
D14, D16: GREEN; LED_0603_1608Metric
J2, J3, J4, J5: Conn_01x01_Socket; MountingHole_2.7mm_M2.5_DIN965_Pad
J6, J10: DF11-16DP-2DSA; CONN-TH_DF11-16DP-2DSA-08
J8, J9: Conn_01x04; PinSocket_1x04_P2.54mm_Vertical
JP3, JP4: SolderJumper_2_Open; SolderJumper-2_P1.3mm_Open_RoundedPad1.0x1.5mm
L1: 47uH; IND-SMD_L10.7-W10.0_ETQP5MXXXX
L2: 6.1u; IND-SMD_FTKB1207-6R1NT
L3: 10u; IND-SMD_L8.0-W8.0
R1, R3, R28, R29, R57, R58, R73, R75, R77, R82, R149, R151, R165, R167: 1k; R0402
R2, R41, R59, R60, R61, R72, R74, R76, R78, R87, R88, R89, R90: 15k; R0402
R34: 14k; R_0603_1608Metric
R35: 17k; R_0603_1608Metric
R42, R43, R44, R45, R46, R47: 4.7k; R_0603_1608Metric
R55: 196k; R0402
R56, R108, R141, R142, R143, R144, R147, R148, R157, R158, R159, R160, R163, R164: 10k; R0402
R62, R79, R93: 110k; R0402
R63, R81, R91: 47k; R0402
R64, R80, R92: 2k; R0402
R65: 240k; R0402
R66, R150, R152, R153, R155, R156, R166, R168, R169, R171, R172, R174: 100k; R0402
R86, R94: 10; R_1206_3216Metric
R103: 20.8k; R0402
R104: 5k; R0402
R107: 56.2k; R0402
R145, R146, R161, R162: 3k; R0402
R154, R170: 4.7M; R0402
TP1, TP2, TP3, TP4, TP10, TP16, TP17, TP18, TP19, TP20, TP21, TP22, TP23, TP24, TP25, TP26, TP27, TP28, TP29, TP30, TP31, TP33, TP34, TP35, TP36, TP37, TP38, TP39, TP40, TP41, TP42, TP43, TP44, TP45, TP46, TP47, TP54, TP55, TP56, TP57, TP58, TP59, TP60, TP61, TP62, TP63: TestPoint; TestPoint_Pad_1.0x1.0mm
U1, U3, U13: LT8612EUDE#PBF; QFN-28_L6.0-W3.0-P0.50-BL-EP
U2, U5, U16: INA260AIPWR; TSSOP-16_L5.0-W4.4-P0.65-LS6.4-BL-1
U7: LTC6902; MSOP-10_L3.0-W3.0-P0.50-LS5.0-BL
U8: XT60PW-F_C428722; TH_2P-XT60PW-F
U9: TCA4307DGKR; VSSOP-8_L3.0-W3.0-P0.65-LS4.9-BL
U10, U11: TLV1704; TSSOP-14_4.4x5mm_P0.65mm
U12, U15, U17: TPS1HB08BQPWPRQ1; HTSSOP-16_L5.0-W4.4-P0.65-LS6.4-TL-EP2.9
U19, U20, U21: MCP9808T-E/MS; MSOP-8_L3.0-W3.0-P0.65-LS4.9-BL

Connections:
+3.3V_OBC: C29.1, C30.1, C31.1, C32.1, C48.1, C54.1, D4.2 (A), D9.2 (A), D10.2 (A), D17.2 (A), J9.1, J9.2, J10.1, J10.3, J10.5, J10.7, R34.1, R35.1, R42.1, R43.1, R44.1, R45.1, R46.1, R47.1, TP34.1, U2.10 (VS), U5.5 (A0), U5.10 (VS), U5.14 (IN-), U7.1 (V+), U9.8 (VCC), U16.4 (A1), U16.5 (A0), U16.10 (VS), U19.7 (A0), U19.8 (VDD), U20.6 (A1), U20.8 (VDD), U21.6 (A1), U21.7 (A0), U21.8 (VDD)
+5V_Perif: C49.1, CN1.1, CN1.3, CN1.5, CN1.7, TP43.1, U16.14 (IN-)
+20V_Jetson: C55.1, D7.2 (A), J6.1, J6.3, J6.5, J6.7, J8.1, J8.2, TP29.1, U2.14 (IN-)
+V_Batt: C1.1, C2.1, C3.1, C4.1, C5.1, C6.1, C7.1, C8.1, C9.1, C24.1, C35.1, C45.1, R107.2, TP25.1, TP31.1, TP39.1, U8.3 (+), U12.17 (VBB), U15.17 (VBB), U17.17 (VBB)
/Jetson_Subsystem/WD_Jetson/WDT-VIN: R141.2, R150.1, R156.1, R174.2, TP30.1
/Jetson_Subsystem/WD_Jetson/WDT-VP: R144.1, R145.2, U10.5 (+)
/OBC_Subsystem/WD_OBC/WDT-VIN: C63.1, C64.1, C65.1, R94.2, R157.2, R166.1, R172.1, TP47.1, U11.3 (V+)
/OBC_Subsystem/WD_OBC/WDT-VP: R160.1, R161.2, U11.5 (+)
GND: C1.2, C2.2, C3.2, C4.2, C5.2, C6.2, C7.2, C8.2, C9.2, C23.2, C24.2, C25.2, C28.2, C29.2, C30.2, C31.2, C32.2, C35.2, C36.2, C38.2, C41.2, C45.2, C46.2, C47.2, C48.2, C49.2, C50.2, C51.2, C52.2, C53.2, C54.2, C55.2, C56.2, C57.2, C58.2, C61.2, C62.2, C63.2, C64.2, C65.2, C74.1, C75.1, C76.1, C77.1, C78.2, C80.1, C81.1, C82.1, C83.1, CN1.9, CN1.11, CN1.13, CN1.15, D14.1 (K), D16.1 (K), J2.1, J3.1, J4.1, J5.1, J6.9, J6.11, J6.13, J6.15, J8.3, J8.4, J9.3, J9.4, J10.9, J10.11, J10.13, J10.15, R2.2, R28.1, R41.1, R56.2, R57.1, R59.2, R60.2, R61.2, R62.2, R64.2, R66.2, R72.1, R74.1, R75.1, R76.1, R78.1, R79.2, R80.2, R87.2, R88.2, R89.2, R90.2, R92.2, R93.2, R104.2, R108.1, R145.1, R147.1, R161.1, R163.1, U1.8 (PGND), U1.11 (GND), U1.25 (NC), U2.4 (A1), U2.5 (A0), U2.6 (GND), U3.8 (PGND), U3.11 (GND), U3.25 (NC), U5.4 (A1), U5.6 (GND), U7.8 (GND), U8.1, U8.2, U8.4 (-), U9.4 (GND), U10.12 (V-), U11.12 (V-), U12.1 (GND), U13.8 (PGND), U13.11 (GND), U13.25 (NC), U15.1 (GND), U16.6 (GND), U17.1 (GND), U19.4 (GND), U19.5 (A2), U19.6 (A1), U20.4 (GND), U20.5 (A2), U20.7 (A0), U21.4 (GND), U21.5 (A2)
unnamed: C73.2, R147.2, R148.2
unnamed: C79.2, R163.2, R164.2
unnamed: CN1.4, TP16.1
unnamed: CN1.6, TP17.1
unnamed: CN1.8, TP18.1
unnamed: CN1.10, TP19.1
unnamed: CN1.12, TP20.1
unnamed: CN1.14, TP21.1
unnamed: D4.1 (K), R29.1
unnamed: D7.1 (C), R86.1
unnamed: D9.1 (K), R77.1
unnamed: D10.1 (C), R94.1
unnamed: D14.2 (A), R146.1
unnamed: D15.2 (A), R153.2
unnamed: D15.1 (C), R154.2, R155.2, R156.2, TP57.1, U10.11 (+), U10.14
unnamed: D16.2 (A), R162.1
unnamed: D17.1 (K), R58.1
unnamed: D18.2 (A), R169.2
unnamed: D18.1 (C), R170.2, R171.2, R172.2, TP62.1, U11.11 (+), U11.14
unnamed: J6.2, TP44.1
unnamed: J6.4, TP45.1
unnamed: J6.6, TP1.1
unnamed: J6.8, TP2.1
unnamed: J6.10, TP3.1
unnamed: J6.12, TP4.1
unnamed: J10.2, TP22.1
unnamed: J10.4, TP23.1
unnamed: J10.10, TP24.1
unnamed: JP3.1 (A), TP58.1, U10.13
unnamed: JP4.1 (A), TP63.1, U11.13
unnamed: R141.1, R142.2, R152.1
unnamed: R149.2, U10.2
unnamed: R151.2, U10.1
unnamed: R157.1, R158.2, R168.1
unnamed: R165.2, U11.2
unnamed: R167.2, U11.1
unnamed: C60.1, C61.1, C62.1, L1.2, R55.1, TP28.1, U1.22 (BIAS), U2.1 (IN+), U2.12 (VBUS)
unnamed: C59.1, U1.20 (BST)
unnamed: R91.2, R92.1, U1.4 (EN/UV)
unnamed: C60.2, R55.2, R56.1, U1.24 (FB)
unnamed: C78.1, U1.21 (INTVCC)
unnamed: R93.1, U1.3 (RT)
unnamed: C59.2, L1.1, U1.15 (SW)
unnamed: C47.1, U1.2 (TR/SS)
unnamed: C46.1, R91.1, TP26.1, U1.5 (VIN), U15.6 (VOUT)
unnamed: C26.1, C52.1, C56.1, L2.2, R65.1, TP33.1, U3.22 (BIAS), U5.1 (IN+), U5.12 (VBUS)
unnamed: C27.1, U3.20 (BST)
unnamed: R63.2, R64.1, U3.4 (EN/UV)
unnamed: C26.2, R65.2, R66.1, U3.24 (FB)
unnamed: C28.1, U3.21 (INTVCC)
unnamed: R62.1, U3.3 (RT)
unnamed: C27.2, L2.1, U3.15 (SW)
unnamed: C25.1, U3.2 (TR/SS)
unnamed: R34.2, U7.9 (MOD)
unnamed: R35.2, U7.10 (SET)
unnamed: R44.2, U9.1 (EN)
unnamed: R45.2, U9.5 (READY)
unnamed: R148.1, U10.4 (-)
unnamed: C74.2, R149.1, R150.2, TP55.1, U10.7 (+)
unnamed: R143.1, R144.2, U10.6 (-)
unnamed: R152.2, R155.1, U10.9 (+)
unnamed: C75.2, C76.2, R151.1, R153.1, R154.1, TP56.1, U10.8 (-)
unnamed: C77.2, R142.1, R143.2, U10.10 (-)
unnamed: C50.1, C51.1, C53.1, R86.2, R174.1, U10.3 (V+)
unnamed: R164.1, U11.4 (-)
unnamed: C80.2, R165.1, R166.2, TP60.1, U11.7 (+)
unnamed: R159.1, R160.2, U11.6 (-)
unnamed: R168.2, R171.1, U11.9 (+)
unnamed: C81.2, C82.2, R167.1, R169.1, R170.1, TP61.1, U11.8 (-)
unnamed: C83.2, R158.1, R159.2, U11.10 (-)
unnamed: R78.2, U12.16 (DIA_EN)
unnamed: R73.1, TP37.1, U12.4 (EN)
unnamed: R72.2, U12.3 (LATCH)
unnamed: R74.2, U12.14 (SEL1)
unnamed: R76.2, U12.15 (SEL2)
unnamed: R75.2, U12.2 (SNS)
unnamed: C36.1, R81.1, TP40.1, U12.6 (VOUT), U13.5 (VIN)
unnamed: R77.2, U12.5 (~ST)
unnamed: C39.1, C57.1, C58.1, L3.2, R103.1, TP42.1, U13.22 (BIAS), U16.1 (IN+), U16.12 (VBUS)
unnamed: C40.1, U13.20 (BST)
unnamed: R80.1, R81.2, U13.4 (EN/UV)
unnamed: C39.2, R103.2, R104.1, U13.24 (FB)
unnamed: C41.1, U13.21 (INTVCC)
unnamed: R79.1, U13.3 (RT)
unnamed: C40.2, L3.1, U13.15 (SW)
unnamed: C38.1, U13.2 (TR/SS)
unnamed: R88.1, U15.16 (DIA_EN)
unnamed: R1.1, R2.1, R82.1, TP38.1, U15.4 (EN)
unnamed: R87.1, U15.3 (LATCH)
unnamed: R90.1, U15.14 (SEL1)
unnamed: R89.1, U15.15 (SEL2)
unnamed: R28.2, U15.2 (SNS)
unnamed: R29.2, U15.5 (~ST)
unnamed: R59.1, U17.16 (DIA_EN)
unnamed: R3.1, R107.1, R108.2, TP36.1, U17.4 (EN)
unnamed: R41.2, U17.3 (LATCH)
unnamed: R61.1, U17.14 (SEL1)
unnamed: R60.1, U17.15 (SEL2)
unnamed: R57.2, U17.2 (SNS)
unnamed: C23.1, R63.1, TP10.1, U3.5 (VIN), U17.6 (VOUT)
unnamed: R58.2, U17.5 (~ST)
OBC SCL: J10.8, R46.2, U9.2 (SCLOUT)
OBC SDA: J10.6, R47.2, U9.7 (SDAOUT)
OBC_EN_JETSON: J10.12, R82.2
OBC_EN_PERIF: J10.14, R73.2
SCL: R43.2, U2.9 (SCL), U5.9 (SCL), U9.3 (SCLIN), U16.9 (SCL), U19.2 (SCL), U20.2 (SCL), U21.2 (SCL)
SDA: R42.2, U2.8 (SDA), U5.8 (SDA), U9.6 (SDAIN), U16.8 (SDA), U19.1 (SDA), U20.1 (SDA), U21.1 (SDA)
SYNC_PHASE1: TP35.1, U3.1 (SYNC), U7.4 (OUT1)
SYNC_PHASE2: TP41.1, U7.5 (OUT2), U13.1 (SYNC)
SYNC_PHASE3: TP27.1, U1.1 (SYNC), U7.6 (OUT3)
WDT_WDI_Jetson: C73.1, J6.14, J6.16, R146.2, TP46.1, TP54.1
WDT_WDI_OBC: C79.1, J10.16, R162.2, TP59.1
~WD_EN_JETSON: JP3.2 (B), R1.2
~WD_EN_OBC: JP4.2 (B), R3.2
