BroncoSpace-Lab/scales-hardware/peripheral_board/peripheral_board_v0/peripheral_board_v0b/peripheral_board.kicad_pcb

## KiCad design peripheral_board/peripheral_board_v0/peripheral_board_v0b/peripheral_board.kicad_pcb (2025-06-11, an earlier design)

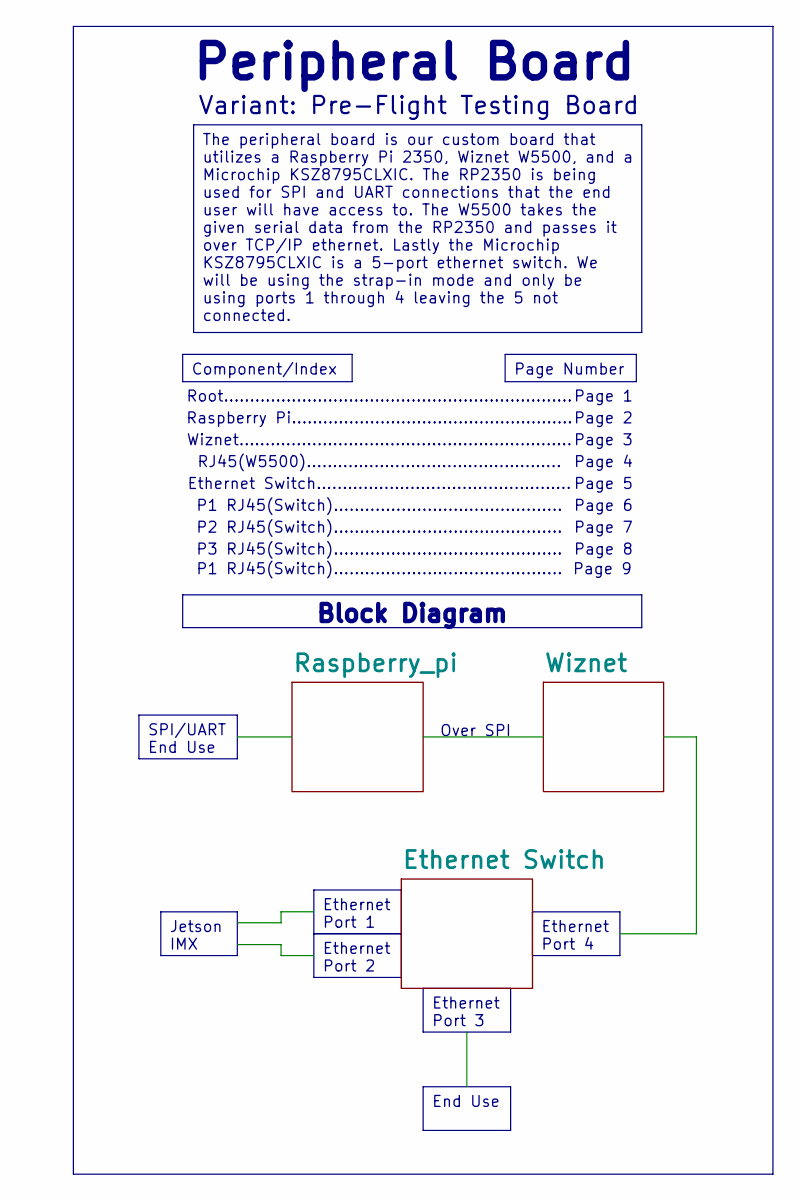
[picture p215: schematic peripheral_board.kicad_sch, Peripheral Board with Ethernet Switch]

Notes on the sheet:
Page 2
Page 1
Wiznet................................................................
Page 4
Page 8
Page 5
Page 6
P3 RJ45(Switch)............................................
Peripheral Board
P1 RJ45(Switch)............................................
RJ45(W5500).................................................
Ethernet Switch.................................................
Page 3
P2 RJ45(Switch)............................................
Root...................................................................
Raspberry Pi......................................................
Page 7
Over SPI
Variant: Pre-Flight Testing Board
Page 9
Ethernet Port 2
Component/Index
Page Number
Block Diagram
Jetson IMX
Ethernet Port 1
SPI/UART End Use
The peripheral board is our custom board that utilizes a Raspberry Pi 2350, Wiznet W5500, and a Microchip KSZ8795CLXIC. The RP2350 is being used for SPI and UART connections that the end user will have access to. The W5500 takes the given serial data from the RP2350 and passes it over TCP/IP ethern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
Ethernet Port 3
End Use
Ethernet Port 4

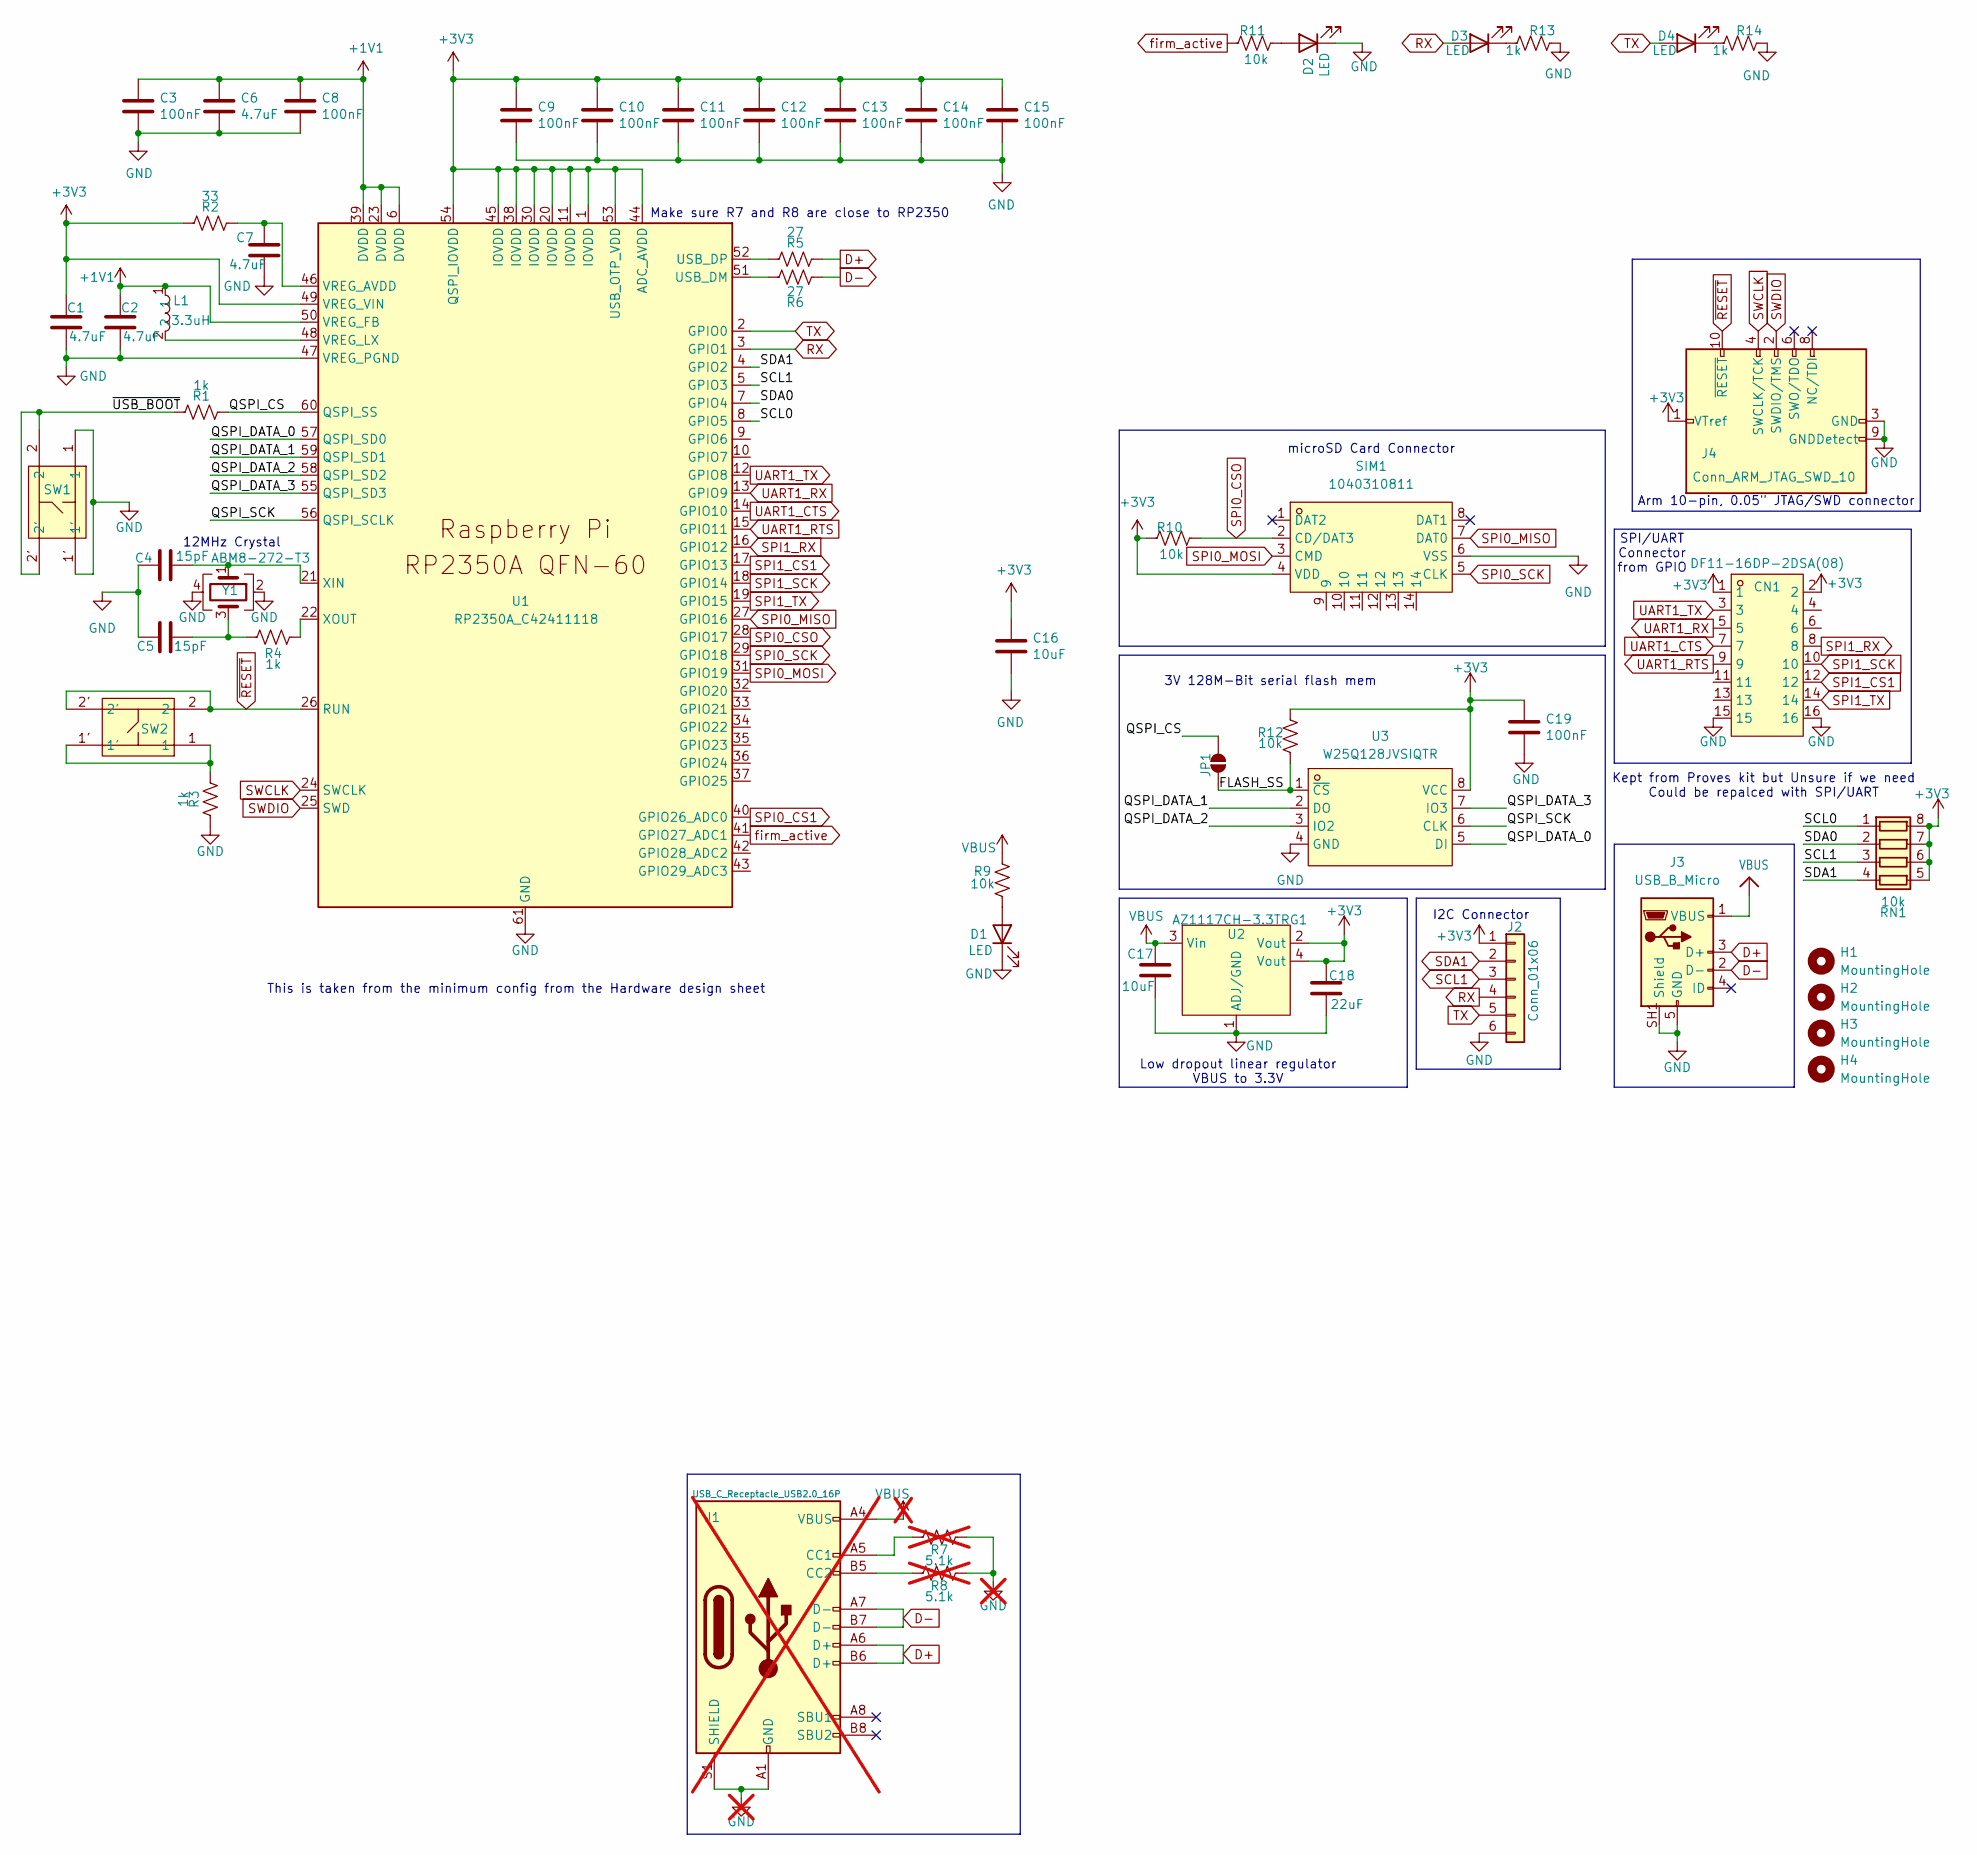
[picture p216: schematic rp.kicad_sch]

Parts:
C1, C2: 4.7uF; C_0402_1005Metric_small_pads
C3, C8, C9, C10, C11, C12, C13, C14, C15, C19: 100nF; C_0402_1005Metric
C4, C5: 15pF; C_0402_1005Metric
C6, C7: 4.7uF; C_0402_1005Metric
C16, C17: 10uF; C_0805_2012Metric
C18: 22uF; C_0805_2012Metric
CN1: DF11-16DP-2DSA(08); CONN-TH_DF11-16DP-2DSA-08; LCSC Part C530981
D1, D2, D3, D4: LED; LED_0603_1608Metric
H1, H2, H3, H4: MountingHole; MountingHole_2.5mm_Pad
J1: USB_C_Receptacle_USB2.0_16P; USB_C_Receptacle_HRO_TYPE-C-31-M-12; not fitted
J2: Conn_01x06; HDR-TH_6P-P2.54-V-M-1
J3: USB_B_Micro; MICRO-USB-SMD_5P-P0.65-H-F_105164-0001
J4: Conn_ARM_JTAG_SWD_10; JTAG_2X05_1.27MM_BOX_NOCREAM
JP1: SolderJumper_2_Open; SolderJumper-2_P1.3mm_Open_RoundedPad1.0x1.5mm
L1: 3.3uH; IND-SMD_L2.0-W1.6_AOTA-B201610S3R3-101-T; LCSC Part C42411119
R1, R3, R4: 1k; R_0402_1005Metric
R2: 33; R_0402_1005Metric
R5, R6: 27; R_0402_1005Metric
R7, R8: 5.1k; R_0603_1608Metric; not fitted
R9, R10, R11, R12: 10k; R_0603_1608Metric
R13, R14: 1k; R_0603_1608Metric
RN1: 10k; R_Array_Convex_4x0603
SIM1: 1040310811; SIM-SMD_8P-1040310811; LCSC Part C585350
SW1, SW2: EVPAA602W; KEY-TH_4P-L3.5-W4.9-P2.80-LS4.3; LCSC Part C79148
U1: RP2350A_C42411118; QFN-60_L7.0-W7.0-P0.40-TL-EP3.4; LCSC Part C42411118
U2: AZ1117CH-3.3TRG1; SOT-223-3_L6.5-W3.4-P2.30-LS7.0-BR; LCSC Part C92102
U3: W25Q128JVSIQTR; SOIC-8_L5.3-W5.3-P1.27-LS8.0-BL; LCSC Part C97521
Y1: ABM8-272-T3; Crystal_SMD_3225-4Pin_3.2x2.5mm

Connections:
+1V1: C2.1, C3.1, C6.1, C8.1, L1.1, U1.6 (DVDD), U1.23 (DVDD), U1.39 (DVDD), U1.50 (VREG_FB)
+3V3: C1.1, C9.1, C10.1, C11.1, C12.1, C13.1, C14.1, C15.1, C16.1, C18.2, C19.1, CN1.1, CN1.2, J2.1, J4.1 (VTref), R2.2, R10.2, R12.2, RN1.5 (R4.2), RN1.6 (R3.2), RN1.7 (R2.2), RN1.8 (R1.2), SIM1.4 (VDD), U1.1 (IOVDD), U1.11 (IOVDD), U1.20 (IOVDD), U1.30 (IOVDD), U1.38 (IOVDD), U1.44 (ADC_AVDD), U1.45 (IOVDD), U1.49 (VREG_VIN), U1.53 (USB_OTP_VDD), U1.54 (QSPI_IOVDD), U2.2 (Vout), U2.4 (Vout), U3.8 (VCC); also elsewhere on the board
/Raspberry_pi/ QSPI_CS: JP1.1 (A), R1.1, U1.60 (QSPI_SS)
/Raspberry_pi/FLASH_SS: JP1.2 (B), R12.1, U3.1 (~CS)
/Raspberry_pi/QSPI_DATA_0: U1.57 (QSPI_SD0), U3.5 (DI)
/Raspberry_pi/QSPI_DATA_1: U1.59 (QSPI_SD1), U3.2 (DO)
/Raspberry_pi/QSPI_DATA_2: U1.58 (QSPI_SD2), U3.3 (IO2)
/Raspberry_pi/QSPI_DATA_3: U1.55 (QSPI_SD3), U3.7 (IO3)
/Raspberry_pi/QSPI_SCK: U1.56 (QSPI_SCLK), U3.6 (CLK)
/Raspberry_pi/SCL0: RN1.1 (R1.1), U1.8 (GPIO5)
/Raspberry_pi/SDA0: RN1.2 (R2.1), U1.7 (GPIO4)
/Raspberry_pi/~USB_BOOT: R1.2, SW1.2, SW1.2'
D+: J1.A6 (D+), J1.B6 (D+), J3.3 (D+), R5.1
D-: J1.A7 (D-), J1.B7 (D-), J3.2 (D-), R6.1
GND: C1.2, C2.2, C3.2, C4.1, C5.1, C6.2, C7.2, C8.2, C9.2, C10.2, C11.2, C12.2, C13.2, C14.2, C15.2, C16.2, C17.1, C18.1, C19.2, CN1.15, CN1.16, D1.1 (K), D2.1 (K), J1.A1 (GND), J1.A12 (GND), J1.B1 (GND), J1.B12 (GND), J1.S1 (SHIELD), J2.6, J3.5 (GND), J3.SH1 (Shield), J4.3 (GND), J4.5 (GND), J4.9 (GNDDetect), R3.2, R7.1, R8.1, R13.2, R14.2, SIM1.6 (VSS), SW1.1, SW1.1', U1.47 (VREG_PGND), U1.61 (GND), U2.1 (ADJ/GND), U3.4 (GND), Y1.2, Y1.4; also elsewhere on the board
unnamed: C5.2, R4.1, Y1.3
unnamed: D1.2 (A), R9.1
unnamed: D2.2 (A), R11.1
unnamed: D3.1 (K), R13.1
unnamed: D4.1 (K), R14.1
unnamed: J1.A5 (CC1), R7.2
unnamed: J1.B5 (CC2), R8.2
unnamed: R3.1, SW2.1, SW2.1'
unnamed: R6.2, U1.51 (USB_DM)
unnamed: R5.2, U1.52 (USB_DP)
unnamed: C7.1, R2.1, U1.46 (VREG_AVDD)
unnamed: L1.2, U1.48 (VREG_LX)
unnamed: C4.2, U1.21 (XIN), Y1.1
unnamed: R4.2, U1.22 (XOUT)
RX: D3.2 (A), J2.4, U1.3 (GPIO1)
SCL1: J2.3, RN1.3 (R3.1), U1.5 (GPIO3)
SDA1: J2.2, RN1.4 (R4.1), U1.4 (GPIO2)
SPI0_CS1: U1.40 (GPIO26_ADC0); also elsewhere on the board
SPI0_CSO: R10.1, SIM1.2 (CD/DAT3), U1.28 (GPIO17)
SPI0_MISO: SIM1.7 (DAT0), U1.27 (GPIO16); also elsewhere on the board
SPI0_MOSI: SIM1.3 (CMD), U1.31 (GPIO19); also elsewhere on the board
SPI0_SCK: SIM1.5 (CLK), U1.29 (GPIO18); also elsewhere on the board
SPI1_CS1: CN1.12, U1.17 (GPIO13)
SPI1_RX: CN1.8, U1.16 (GPIO12)
SPI1_SCK: CN1.10, U1.18 (GPIO14)
SPI1_TX: CN1.14, U1.19 (GPIO15)
SWCLK: J4.4 (SWCLK/TCK), U1.24 (SWCLK)
SWDIO: J4.2 (SWDIO/TMS), U1.25 (SWD)
TX: D4.2 (A), J2.5, U1.2 (GPIO0)
UART1_CTS: CN1.7, U1.14 (GPIO10)
UART1_RTS: CN1.9, U1.15 (GPIO11)
UART1_RX: CN1.5, U1.13 (GPIO9)
UART1_TX: CN1.3, U1.12 (GPIO8)
VBUS: C17.2, J1.A4 (VBUS), J1.A9 (VBUS), J1.B4 (VBUS), J1.B9 (VBUS), J3.1 (VBUS), R9.2, U2.3 (Vin); also elsewhere on the board
firm_active: R11.2, U1.41 (GPIO27_ADC1)
~RESET: J4.10 (~RESET), SW2.2, SW2.2', U1.26 (RUN)

Notes on the sheet:
12MHz Crystal
Low dropout linear regulator VBUS to 3.3V
Kept from Proves kit but Unsure if we need Could be repalced with SPI/UART
3V 128M-Bit serial flash mem
Make sure R7 and R8 are close to RP2350
microSD Card Connector
Arm 10-pin, 0.05" JTAG/SWD connector
This is taken from the minimum config from the Hardware design sheet
I2C Connector
SPI/UART Connector from GPIO

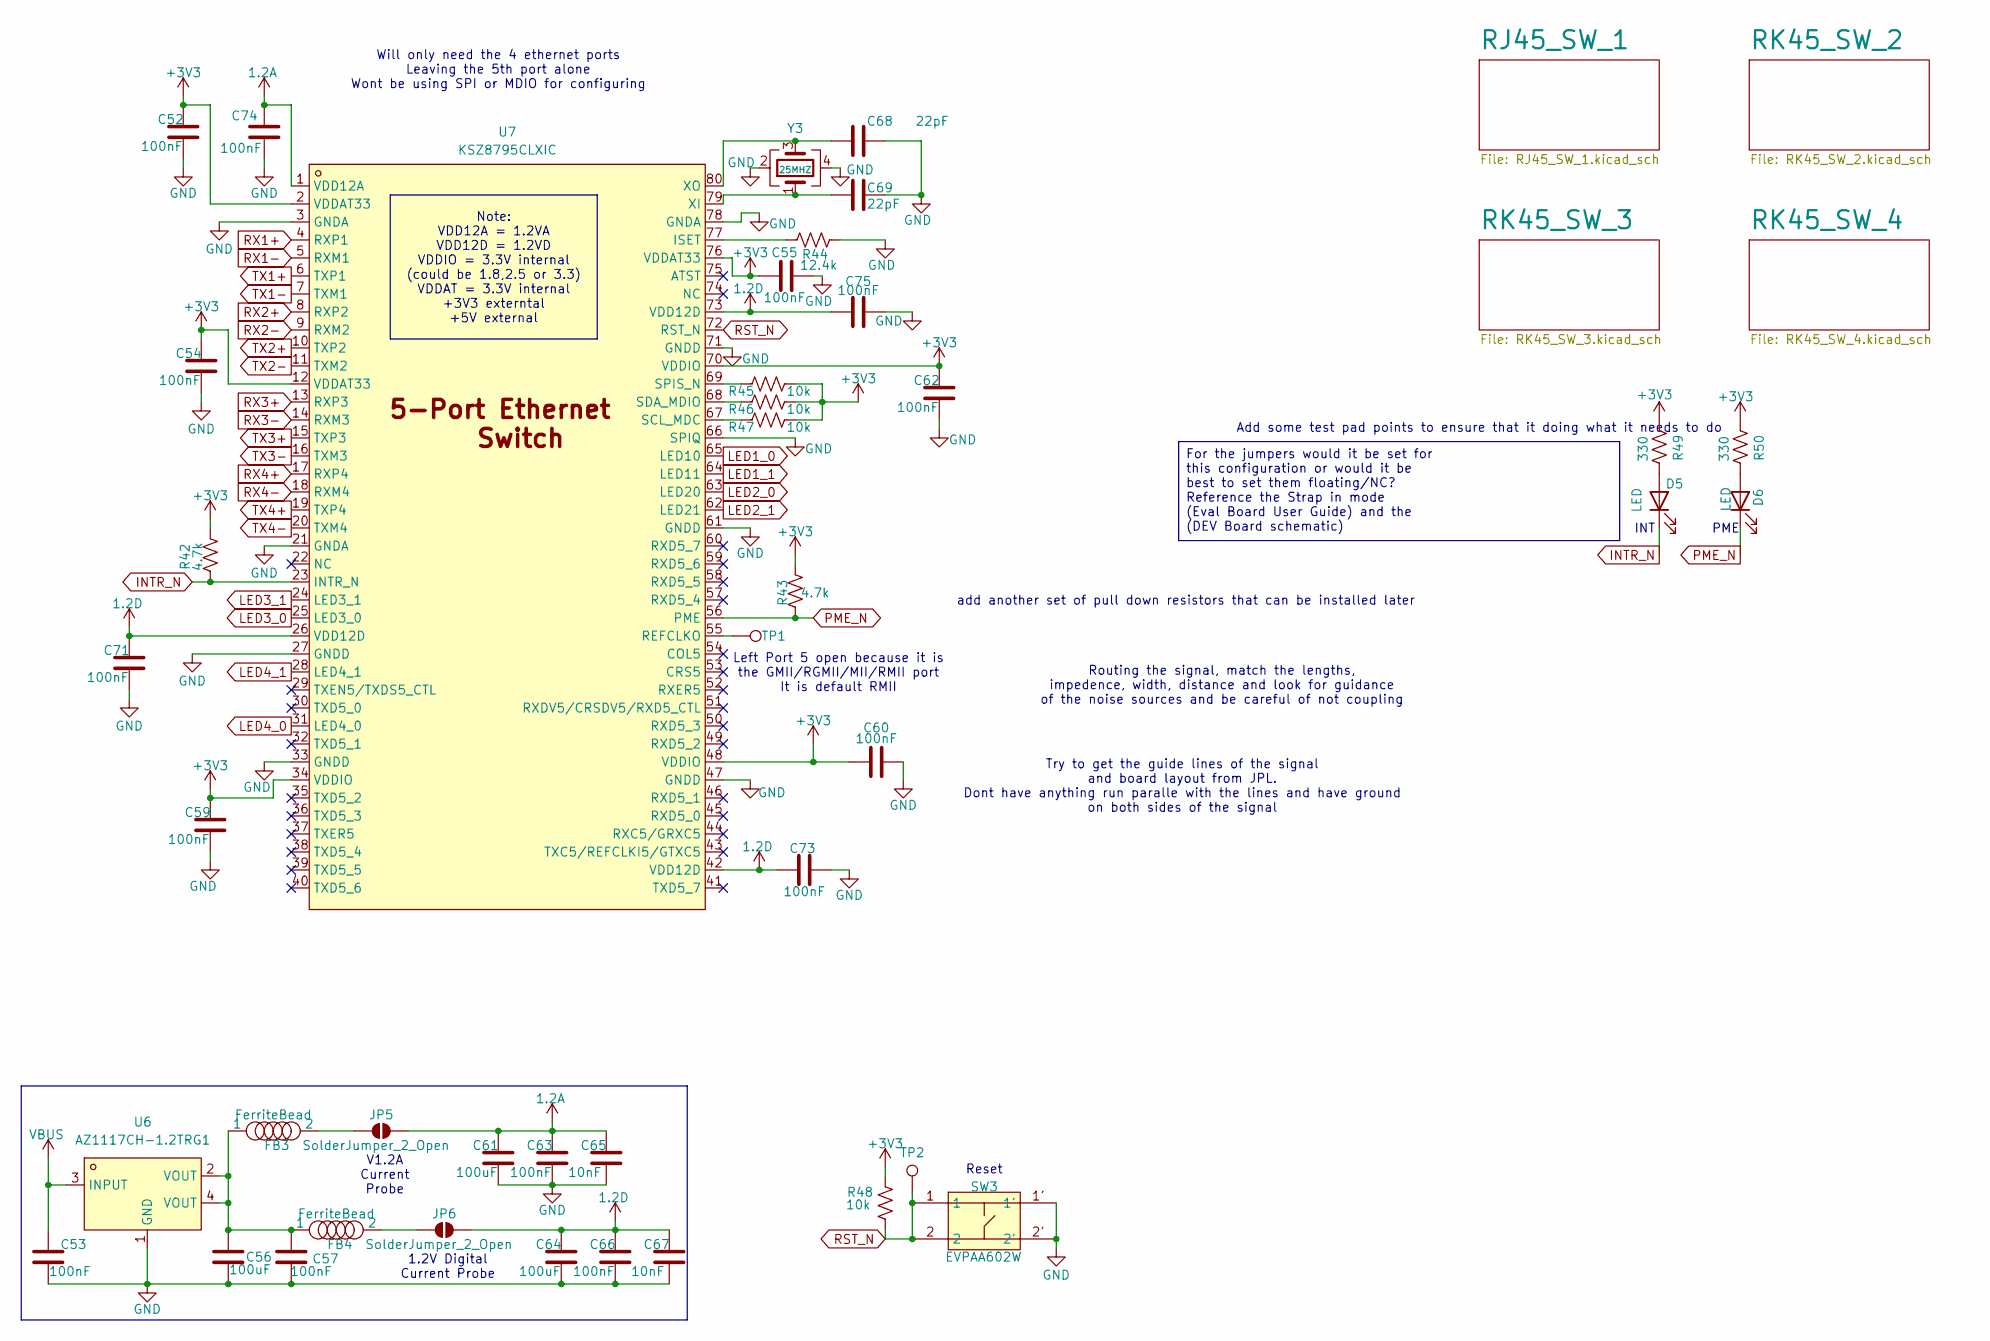
[picture p217: schematic newethernet.kicad_sch]

Parts:
C52, C53, C54, C55, C57, C59, C60, C62, C63, C66, C71, C73, C74, C75: 100nF; C_0402_1005Metric
C56, C61, C64: 100uF; C_0805_2012Metric
C65, C67: 10nF; C_0402_1005Metric
C68, C69: 22pF; C_0402_1005Metric
D5, D6: LED; LED_0603_1608Metric
FB3, FB4: FerriteBead; L_0603_1608Metric
JP5, JP6: SolderJumper_2_Open; SolderJumper-2_P1.3mm_Open_RoundedPad1.0x1.5mm
R42, R43: 4.7k; R_0603_1608Metric
R44: 12.4k; R_0603_1608Metric
R45, R46, R47: 10k; R_0402_1005Metric
R48: 10k; R_0603_1608Metric
R49, R50: 330; R_0603_1608Metric
SW3: EVPAA602W; KEY-TH_4P-L3.5-W4.9-P2.80-LS4.3; LCSC Part C79148
TP1, TP2: TestPoint; TestPoint_Pad_1.0x1.0mm
U6: AZ1117CH-1.2TRG1; SOT-223-3_L6.5-W3.4-P2.30-LS7.0-BR; LCSC Part C507895
U7: KSZ8795CLXIC; LQFP-80_L10.0-W10.0-P0.40-LS12.2-BL; LCSC Part C69416
Y3: 25MHZ; CRYSTAL-SMD_4P-L3.2-W2.5-BL

Connections:
1.2A: C61.2, C63.2, C65.2, C74.2, JP5.1 (A), U7.1 (VDD12A)
1.2D: C64.2, C66.2, C67.2, C71.2, C73.2, C75.2, JP6.1 (A), U7.26 (VDD12D), U7.42 (VDD12D), U7.73 (VDD12D)
+3V3: C52.2, C54.2, C55.2, C59.2, C60.2, C62.2, R42.1, R43.1, R45.2, R46.2, R47.2, R48.1, R49.2, R50.2, U7.2 (VDDAT33), U7.12 (VDDAT33), U7.34 (VDDIO), U7.48 (VDDIO), U7.70 (VDDIO), U7.76 (VDDAT33); also elsewhere on the board
GND: C52.1, C53.1, C54.1, C55.1, C56.1, C57.1, C59.1, C60.1, C61.1, C62.1, C63.1, C64.1, C65.1, C66.1, C67.1, C68.2, C69.2, C71.1, C73.1, C74.1, C75.1, R44.2, SW3.1', SW3.2', U6.1 (GND), U7.3 (GNDA), U7.21 (GNDA), U7.27 (GNDD), U7.33 (GNDD), U7.47 (GNDD), U7.61 (GNDD), U7.66 (SPIQ), U7.71 (GNDD), U7.78 (GNDA), Y3.2, Y3.4; also elsewhere on the board
INTR_N: D5.1 (K), R42.2, U7.23 (INTR_N)
LED1_0: U7.65 (LED10); also elsewhere on the board
LED1_1: U7.64 (LED11); also elsewhere on the board
LED2_0: U7.63 (LED20); also elsewhere on the board
LED2_1: U7.62 (LED21); also elsewhere on the board
LED3_0: U7.25 (LED3_0); also elsewhere on the board
LED3_1: U7.24 (LED3_1); also elsewhere on the board
LED4_0: U7.31 (LED4_0); also elsewhere on the board
LED4_1: U7.28 (LED4_1); also elsewhere on the board
unnamed: C56.2, C57.2, FB3.1, FB4.1, U6.2 (VOUT), U6.4 (VOUT)
unnamed: D5.2 (A), R49.1
unnamed: D6.2 (A), R50.1
unnamed: FB3.2, JP5.2 (B)
unnamed: FB4.2, JP6.2 (B)
unnamed: R44.1, U7.77 (ISET)
unnamed: TP1.1, U7.55 (REFCLKO)
unnamed: R47.1, U7.67 (SCL_MDC)
unnamed: R46.1, U7.68 (SDA_MDIO)
unnamed: R45.1, U7.69 (SPIS_N)
unnamed: C69.1, U7.79 (XI), Y3.1
unnamed: C68.1, U7.80 (XO), Y3.3
PME_N: D6.1 (K), R43.2, U7.56 (PME)
RST_N: R48.2, SW3.1, SW3.2, TP2.1, U7.72 (RST_N)
RX1+: U7.4 (RXP1); also elsewhere on the board
RX1-: U7.5 (RXM1); also elsewhere on the board
RX2+: U7.8 (RXP2); also elsewhere on the board
RX2-: U7.9 (RXM2); also elsewhere on the board
RX3+: U7.13 (RXP3); also elsewhere on the board
RX3-: U7.14 (RXM3); also elsewhere on the board
RX4+: U7.17 (RXP4); also elsewhere on the board
RX4-: U7.18 (RXM4); also elsewhere on the board
TX1+: U7.6 (TXP1); also elsewhere on the board
TX1-: U7.7 (TXM1); also elsewhere on the board
TX2+: U7.10 (TXP2); also elsewhere on the board
TX2-: U7.11 (TXM2); also elsewhere on the board
TX3+: U7.15 (TXP3); also elsewhere on the board
TX3-: U7.16 (TXM3); also elsewhere on the board
TX4+: U7.19 (TXP4); also elsewhere on the board
TX4-: U7.20 (TXM4); also elsewhere on the board
VBUS: C53.2, U6.3 (INPUT); also elsewhere on the board

Notes on the sheet:
Routing the signal, match the lengths, impedence, width, distance and look for guidance of the noise sources and be careful of not coupling
1.2V Digital Current Probe
add another set of pull down resistors that can be installed later
Try to get the guide lines of the signal and board layout from JPL. Dont have anything run paralle with the lines and have ground on both sides of the signal
INT
V1.2A Current Probe
Reset
Will only need the 4 ethernet ports Leaving the 5th port alone Wont be using SPI or MDIO for configuring
Left Port 5 open because it is the GMII/RGMII/MII/RMII port It is default RMII
Add some test pad points to ensure that it doing what it needs to do
PME
For the jumpers would it be set for this configuration or would it be best to set them floating/NC? Reference the Strap in mode (Eval Board User Guide) and the (DEV Board schematic)
Note: VDD12A = 1.2VA VDD12D = 1.2VD VDDIO = 3.3V internal (could be 1.8,2.5 or 3.3) VDDAT = 3.3V internal +3V3 externtal +5V external
