BroncoSpace-Lab/scales-hardware/peripheral_board/peripheral_board_v0/peripheral_board_v0b/peripheral_board.kicad_pcb

## KiCad design peripheral_board/peripheral_board_v0/peripheral_board_v0b/peripheral_board.kicad_pcb (continued)

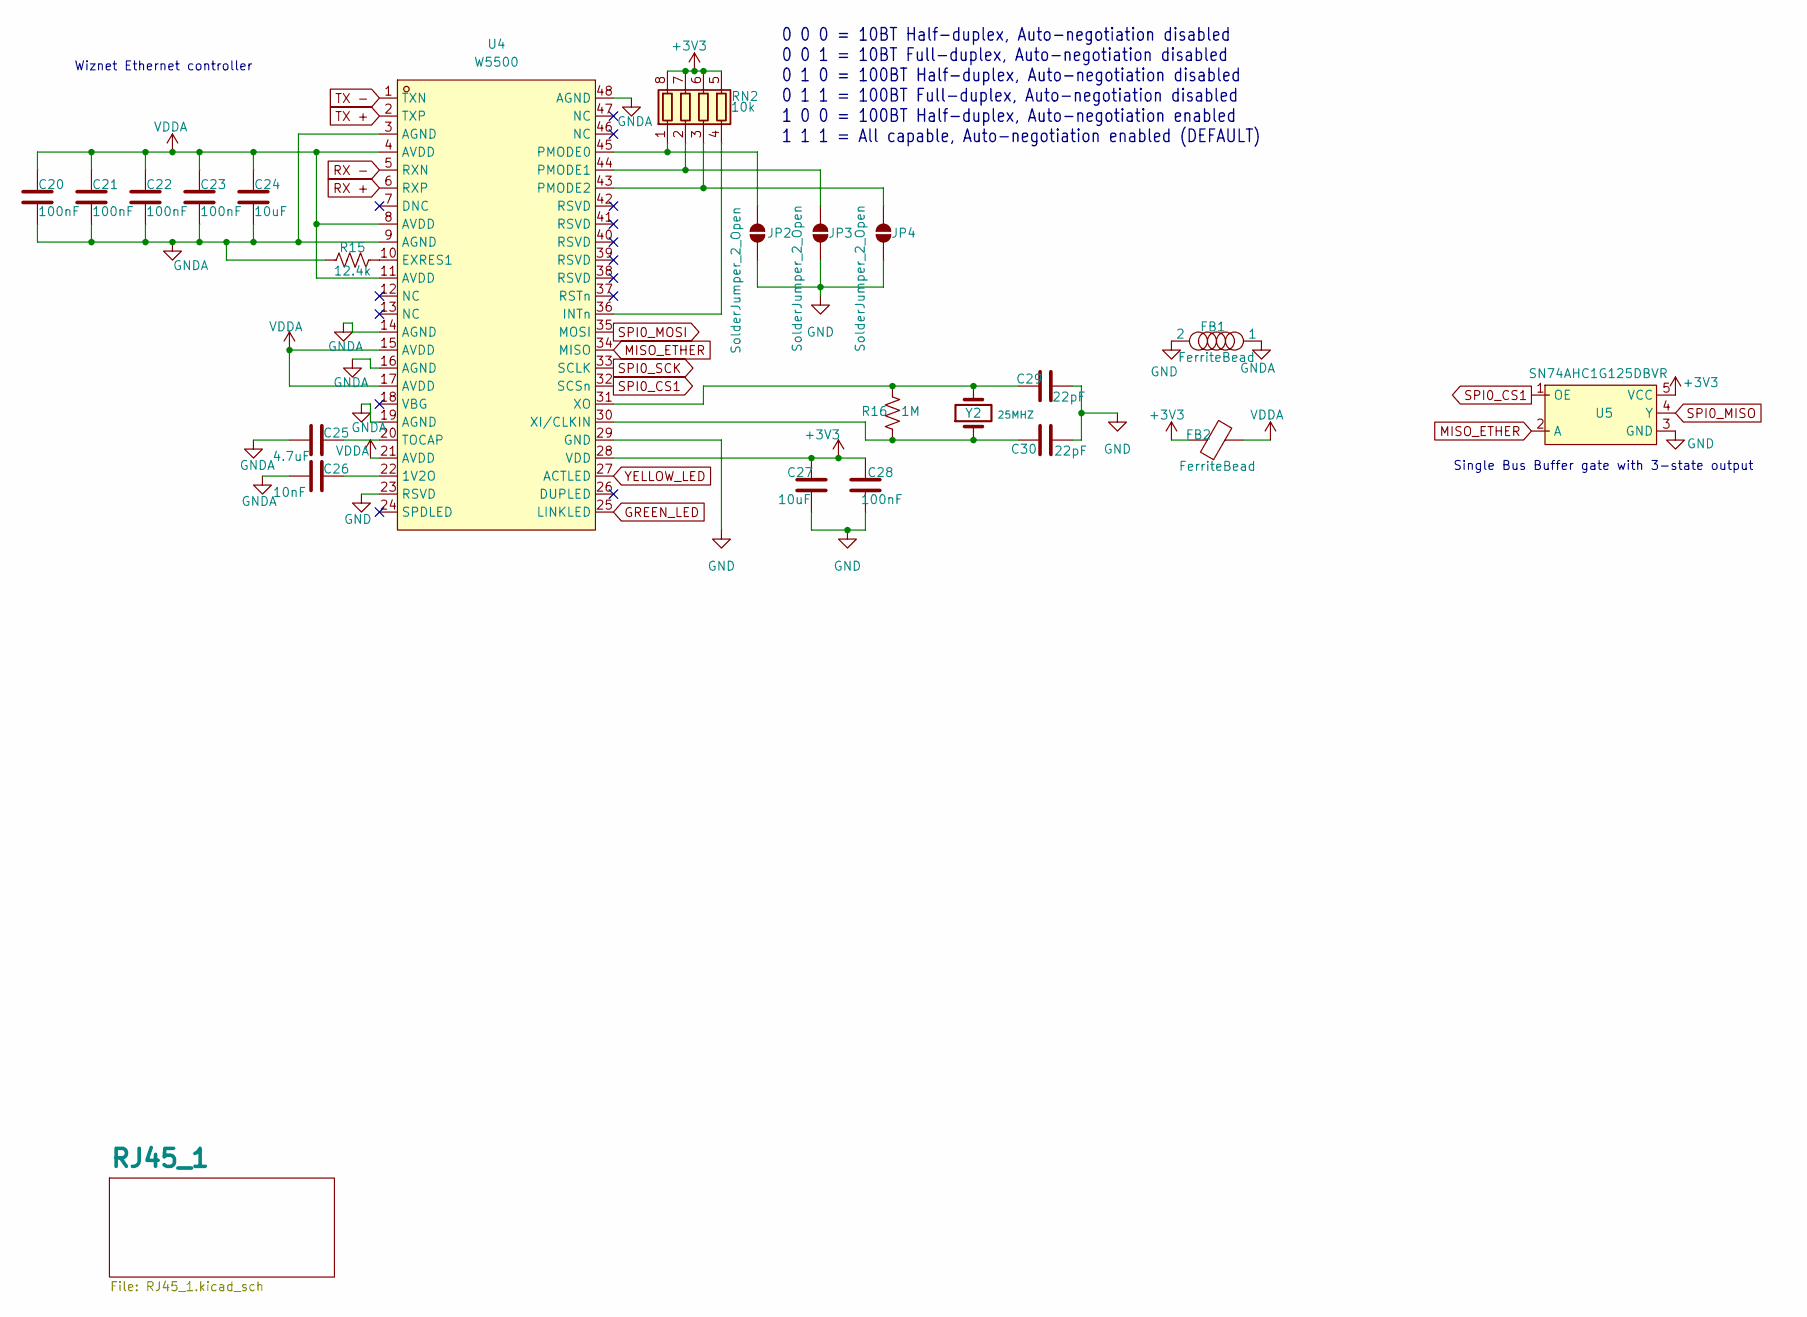
[picture p218: schematic Wiznet.kicad_sch]

Parts:
C20, C21, C22, C23, C28: 100nF; C_0402_1005Metric
C24, C27: 10uF; C_0402_1005Metric
C25: 4.7uF; C_0402_1005Metric
C26: 10nF; C_0402_1005Metric
C29, C30: 22pF; C_0402_1005Metric
FB1, FB2: FerriteBead; L_0603_1608Metric
JP2, JP3, JP4: SolderJumper_2_Open; SolderJumper-2_P1.3mm_Open_RoundedPad1.0x1.5mm
R15: 12.4k; R_0603_1608Metric
R16: 1M; R_0603_1608Metric
RN2: 10k; R_Array_Convex_4x0603
U4: W5500; LQFP-48_L7.0-W7.0-P0.50-LS9.0-BL; LCSC Part C32843
U5: SN74AHC1G125DBVR; SOT-23-5_L3.0-W1.7-P0.95-LS2.8-BR; LCSC Part C7468
Y2: 25MHZ; Crystal_SMD_3225-4Pin_3.2x2.5mm

Connections:
+3V3: C27.2, C28.2, FB2.1, RN2.5 (R4.2), RN2.6 (R3.2), RN2.7 (R2.2), RN2.8 (R1.2), U4.28 (VDD), U5.5 (VCC); also elsewhere on the board
GND: C27.1, C28.1, C29.1, C30.1, FB1.2, JP2.1 (A), JP3.1 (A), JP4.1 (A), U4.23 (RSVD), U4.29 (GND), U5.3 (GND); also elsewhere on the board
GNDA: C20.1, C21.1, C22.1, C23.1, C24.1, C25.2, C26.2, FB1.1, R15.1, U4.3 (AGND), U4.9 (AGND), U4.14 (AGND), U4.16 (AGND), U4.19 (AGND), U4.48 (AGND); also elsewhere on the board
GREEN_LED: U4.25 (LINKLED); also elsewhere on the board
MISO_ETHER: U4.34 (MISO), U5.2 (A)
unnamed: JP2.2 (B), RN2.1 (R1.1), U4.45 (PMODE0)
unnamed: JP3.2 (B), RN2.2 (R2.1), U4.44 (PMODE1)
unnamed: JP4.2 (B), RN2.3 (R3.1), U4.43 (PMODE2)
unnamed: RN2.4 (R4.1), U4.36 (INTn)
unnamed: C26.1, U4.22 (1V2O)
unnamed: R15.2, U4.10 (EXRES1)
unnamed: C25.1, U4.20 (TOCAP)
unnamed: C30.2, R16.1, U4.30 (XI/CLKIN), Y2.1
unnamed: C29.2, R16.2, U4.31 (XO), Y2.3 (2)
RX +: U4.6 (RXP); also elsewhere on the board
RX -: U4.5 (RXN); also elsewhere on the board
SPI0_CS1: U4.32 (SCSn), U5.1 (OE); also elsewhere on the board
SPI0_MISO: U5.4 (Y); also elsewhere on the board
SPI0_MOSI: U4.35 (MOSI); also elsewhere on the board
SPI0_SCK: U4.33 (SCLK); also elsewhere on the board
TX +: U4.2 (TXP); also elsewhere on the board
TX -: U4.1 (TXN); also elsewhere on the board
VDDA: C20.2, C21.2, C22.2, C23.2, C24.2, FB2.2, U4.4 (AVDD), U4.8 (AVDD), U4.11 (AVDD), U4.15 (AVDD), U4.17 (AVDD), U4.21 (AVDD); also elsewhere on the board
YELLOW_LED: U4.27 (ACTLED); also elsewhere on the board

Notes on the sheet:
Wiznet Ethernet controller
Single Bus Buffer gate with 3-state output
0 0 0 = 10BT Half-duplex, Auto-negotiation disabled 0 0 1 = 10BT Full-duplex, Auto-negotiation disabled 0 1 0 = 100BT Half-duplex, Auto-negotiation disabled 0 1 1 = 100BT Full-duplex, Auto-negotiation disabled 1 0 0 = 100BT Half-duplex, Auto-negotiation enabled 1 1 1 = All capable, Auto-negotiation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

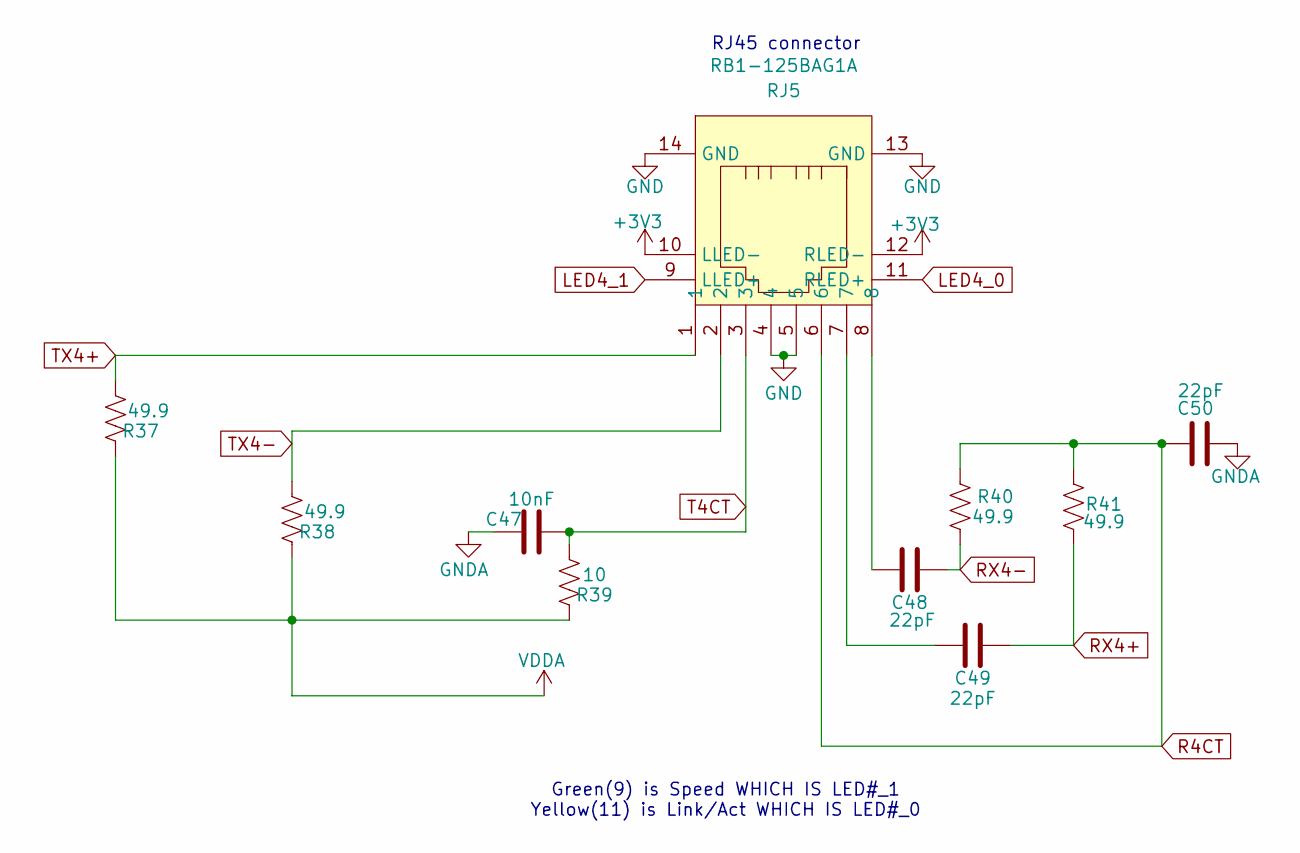
[picture p219: schematic RK45_SW_4.kicad_sch]

Parts:
C47: 10nF; C_0402_1005Metric
C48, C49, C50: 22pF; C_0402_1005Metric
R37, R38, R40, R41: 49.9; R_0603_1608Metric
R39: 10; R_0603_1608Metric
RJ5: RB1-125BAG1A; RJ45-TH_RB1-125BAG1A; LCSC Part C910370

Connections:
+3V3: RJ5.10 (LLED-), RJ5.12 (RLED-); also elsewhere on the board
GND: RJ5.4, RJ5.5, RJ5.13 (GND), RJ5.14 (GND); also elsewhere on the board
GNDA: C47.1, C50.1; also elsewhere on the board
LED4_0: RJ5.11 (RLED+); also elsewhere on the board
LED4_1: RJ5.9 (LLED+); also elsewhere on the board
unnamed: C48.2, RJ5.8
unnamed: C49.2, RJ5.7
R4CT: C50.2, R40.1, R41.1, RJ5.6
RX4+: C49.1, R41.2; also elsewhere on the board
RX4-: C48.1, R40.2; also elsewhere on the board
T4CT: C47.2, R39.1, RJ5.3
TX4+: R37.1, RJ5.1; also elsewhere on the board
TX4-: R38.1, RJ5.2; also elsewhere on the board
VDDA: R37.2, R38.2, R39.2; also elsewhere on the board

Notes on the sheet:
Green(9) is Speed WHICH IS LED#_1 Yellow(11) is Link/Act WHICH IS LED#_0
RJ45 connector

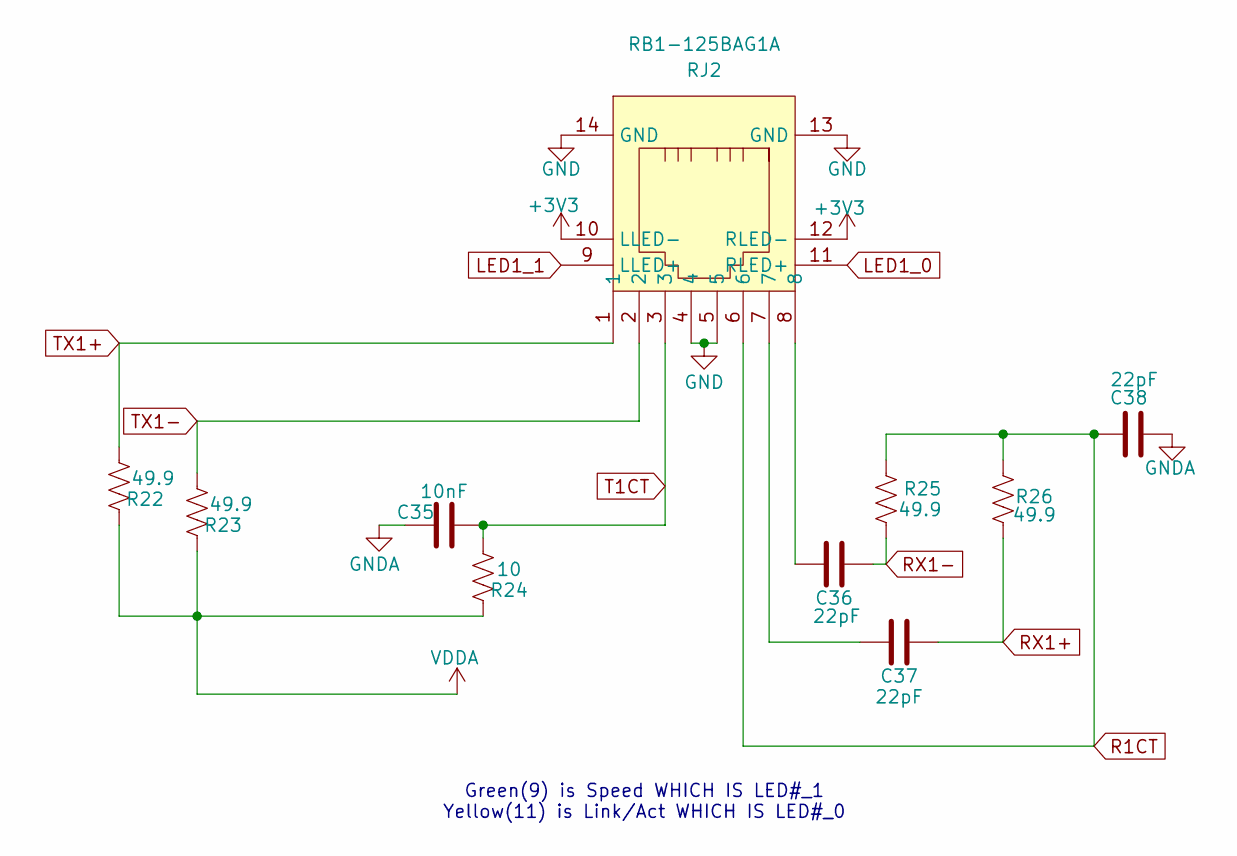
[picture p220: schematic RJ45_SW_1.kicad_sch]

Parts:
C35: 10nF; C_0402_1005Metric
C36, C37, C38: 22pF; C_0402_1005Metric
R22, R23, R25, R26: 49.9; R_0603_1608Metric
R24: 10; R_0603_1608Metric
RJ2: RB1-125BAG1A; RJ45-TH_RB1-125BAG1A; LCSC Part C910370

Connections:
+3V3: RJ2.10 (LLED-), RJ2.12 (RLED-); also elsewhere on the board
GND: RJ2.4, RJ2.5, RJ2.13 (GND), RJ2.14 (GND); also elsewhere on the board
GNDA: C35.1, C38.1; also elsewhere on the board
LED1_0: RJ2.11 (RLED+); also elsewhere on the board
LED1_1: RJ2.9 (LLED+); also elsewhere on the board
unnamed: C36.2, RJ2.8
unnamed: C37.2, RJ2.7
R1CT: C38.2, R25.1, R26.1, RJ2.6
RX1+: C37.1, R26.2; also elsewhere on the board
RX1-: C36.1, R25.2; also elsewhere on the board
T1CT: C35.2, R24.1, RJ2.3
TX1+: R22.1, RJ2.1; also elsewhere on the board
TX1-: R23.1, RJ2.2; also elsewhere on the board
VDDA: R22.2, R23.2, R24.2; also elsewhere on the board

Notes on the sheet:
Green(9) is Speed WHICH IS LED#_1 Yellow(11) is Link/Act WHICH IS LED#_0

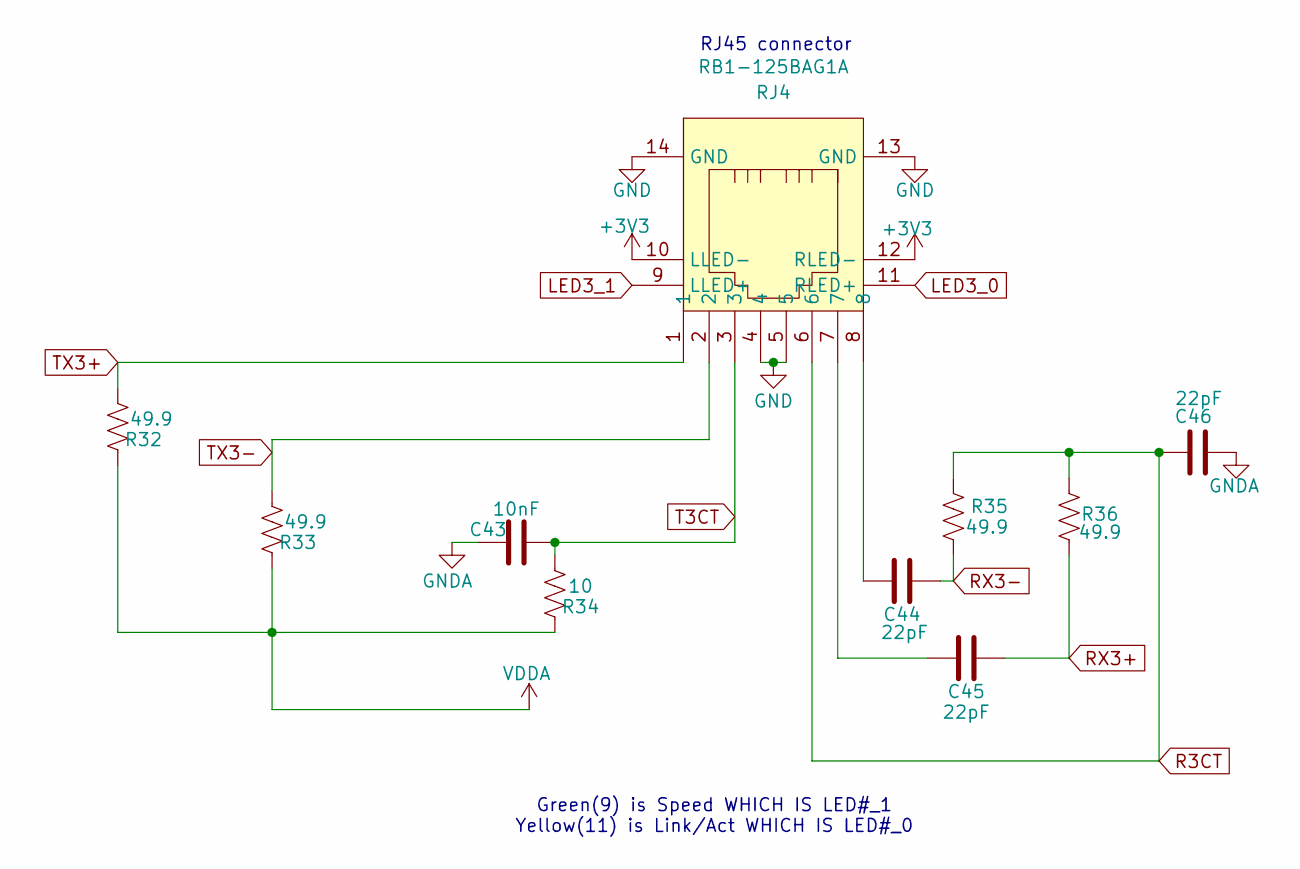
[picture p221: schematic RK45_SW_3.kicad_sch]

Parts:
C43: 10nF; C_0402_1005Metric
C44, C45, C46: 22pF; C_0402_1005Metric
R32, R33, R35, R36: 49.9; R_0603_1608Metric
R34: 10; R_0603_1608Metric
RJ4: RB1-125BAG1A; RJ45-TH_RB1-125BAG1A; LCSC Part C910370

Connections:
+3V3: RJ4.10 (LLED-), RJ4.12 (RLED-); also elsewhere on the board
GND: RJ4.4, RJ4.5, RJ4.13 (GND), RJ4.14 (GND); also elsewhere on the board
GNDA: C43.1, C46.1; also elsewhere on the board
LED3_0: RJ4.11 (RLED+); also elsewhere on the board
LED3_1: RJ4.9 (LLED+); also elsewhere on the board
unnamed: C44.2, RJ4.8
unnamed: C45.2, RJ4.7
R3CT: C46.2, R35.1, R36.1, RJ4.6
RX3+: C45.1, R36.2; also elsewhere on the board
RX3-: C44.1, R35.2; also elsewhere on the board
T3CT: C43.2, R34.1, RJ4.3
TX3+: R32.1, RJ4.1; also elsewhere on the board
TX3-: R33.1, RJ4.2; also elsewhere on the board
VDDA: R32.2, R33.2, R34.2; also elsewhere on the board

Notes on the sheet:
RJ45 connector
Green(9) is Speed WHICH IS LED#_1 Yellow(11) is Link/Act WHICH IS LED#_0

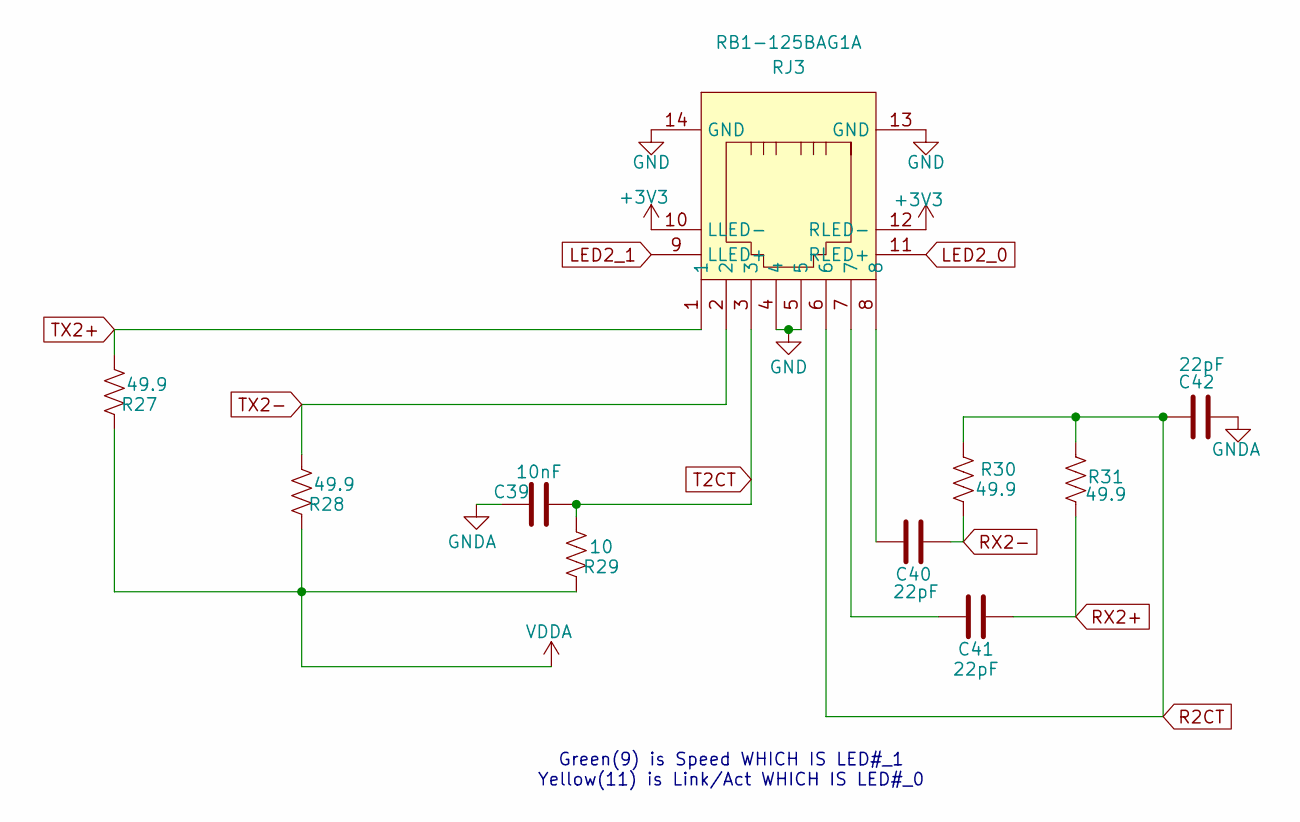
[picture p222: schematic RK45_SW_2.kicad_sch]

Parts:
C39: 10nF; C_0402_1005Metric
C40, C41, C42: 22pF; C_0402_1005Metric
R27, R28, R30, R31: 49.9; R_0603_1608Metric
R29: 10; R_0603_1608Metric
RJ3: RB1-125BAG1A; RJ45-TH_RB1-125BAG1A; LCSC Part C910370

Connections:
+3V3: RJ3.10 (LLED-), RJ3.12 (RLED-); also elsewhere on the board
GND: RJ3.4, RJ3.5, RJ3.13 (GND), RJ3.14 (GND); also elsewhere on the board
GNDA: C39.1, C42.1; also elsewhere on the board
LED2_0: RJ3.11 (RLED+); also elsewhere on the board
LED2_1: RJ3.9 (LLED+); also elsewhere on the board
unnamed: C40.2, RJ3.8
unnamed: C41.2, RJ3.7
R2CT: C42.2, R30.1, R31.1, RJ3.6
RX2+: C41.1, R31.2; also elsewhere on the board
RX2-: C40.1, R30.2; also elsewhere on the board
T2CT: C39.2, R29.1, RJ3.3
TX2+: R27.1, RJ3.1; also elsewhere on the board
TX2-: R28.1, RJ3.2; also elsewhere on the board
VDDA: R27.2, R28.2, R29.2; also elsewhere on the board

Notes on the sheet:
Green(9) is Speed WHICH IS LED#_1 Yellow(11) is Link/Act WHICH IS LED#_0

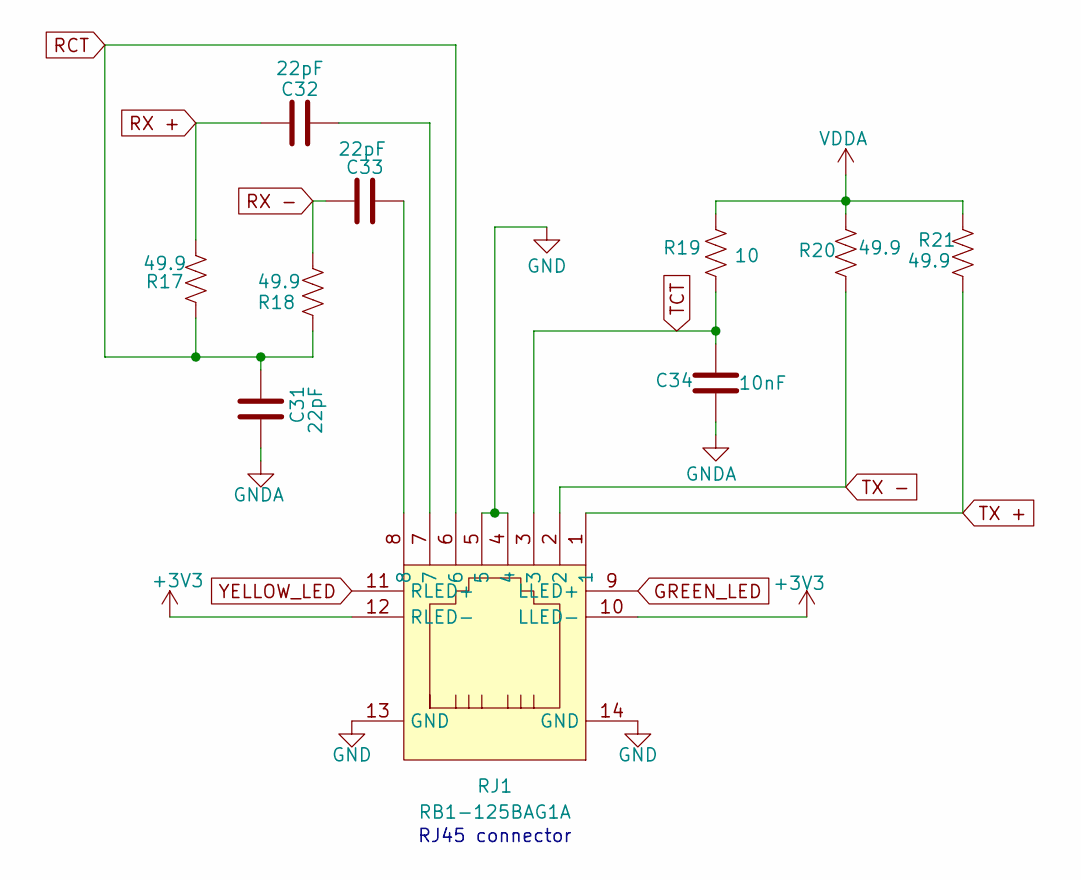
[picture p223: schematic RJ45_1.kicad_sch]

Parts:
C31, C32, C33: 22pF; C_0402_1005Metric
C34: 10nF; C_0402_1005Metric
R17, R18, R20, R21: 49.9; R_0603_1608Metric
R19: 10; R_0603_1608Metric
RJ1: RB1-125BAG1A; RJ45-TH_RB1-125BAG1A; LCSC Part C910370

Connections:
+3V3: RJ1.10 (LLED-), RJ1.12 (RLED-); also elsewhere on the board
GND: RJ1.4, RJ1.5, RJ1.13 (GND), RJ1.14 (GND); also elsewhere on the board
GNDA: C31.1, C34.1; also elsewhere on the board
GREEN_LED: RJ1.9 (LLED+); also elsewhere on the board
unnamed: C32.2, RJ1.7
unnamed: C33.2, RJ1.8
RCT: C31.2, R17.1, R18.1, RJ1.6
RX +: C32.1, R17.2; also elsewhere on the board
RX -: C33.1, R18.2; also elsewhere on the board
TCT: C34.2, R19.1, RJ1.3
TX +: R21.1, RJ1.1; also elsewhere on the board
TX -: R20.1, RJ1.2; also elsewhere on the board
VDDA: R19.2, R20.2, R21.2; also elsewhere on the board
YELLOW_LED: RJ1.11 (RLED+); also elsewhere on the board

Notes on the sheet:
RJ45 connector

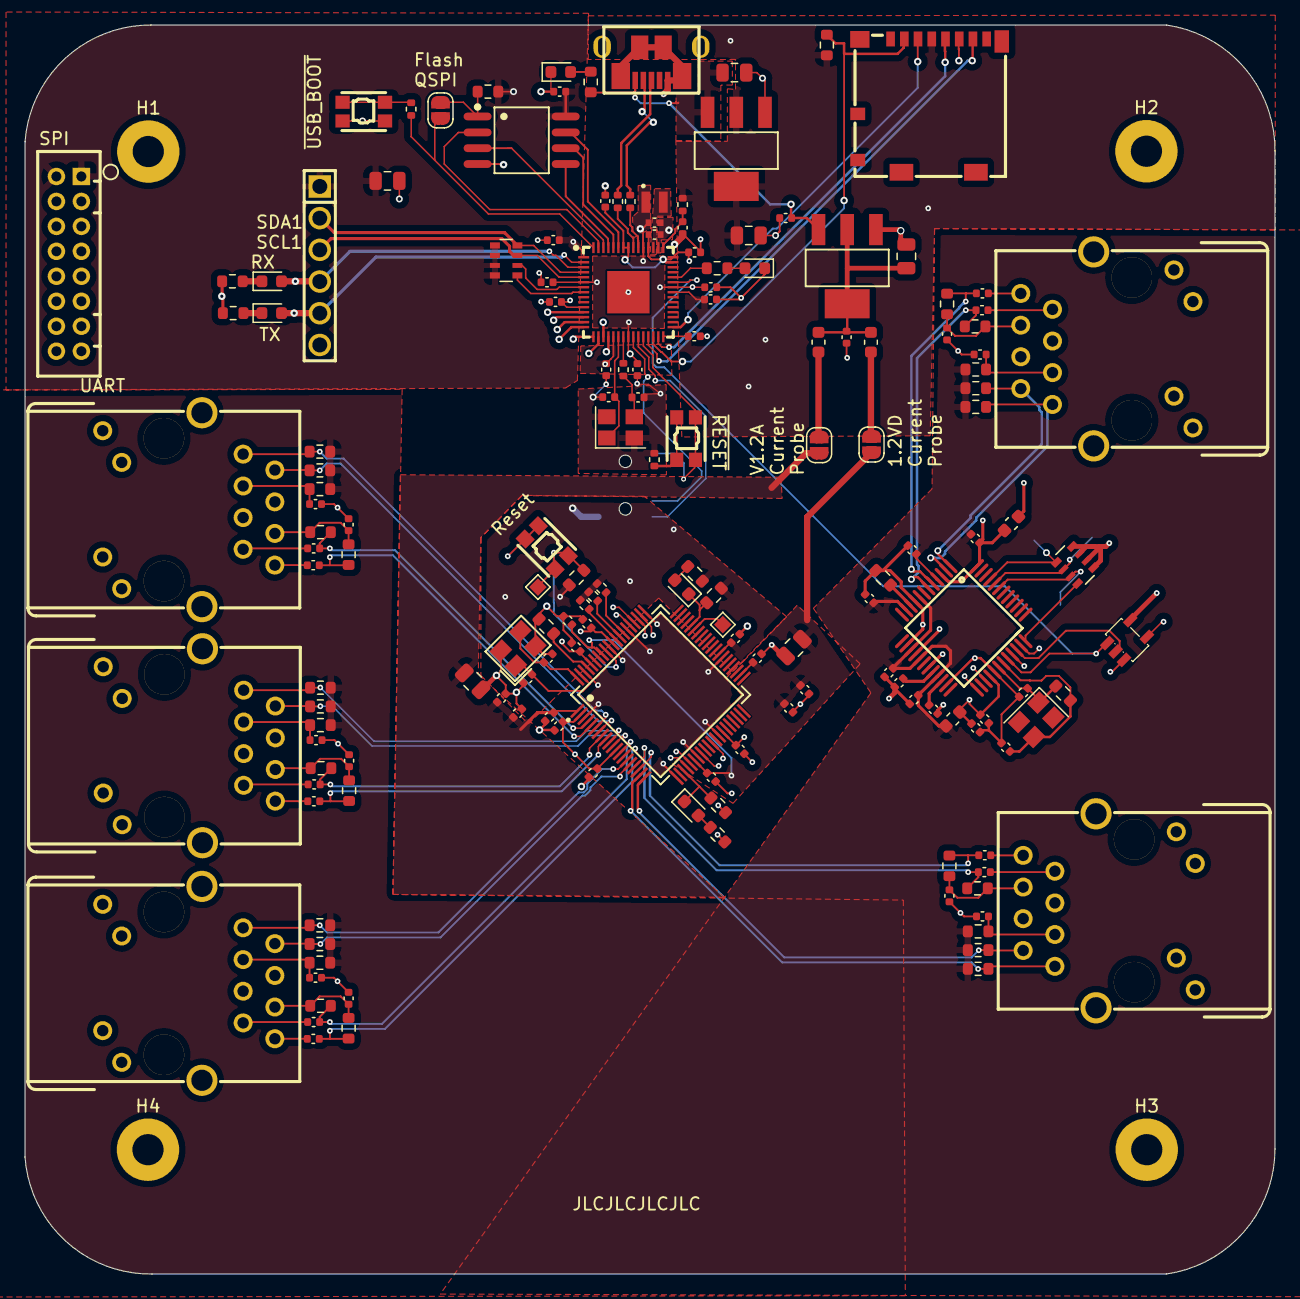
[picture p224: board peripheral_board.kicad_pcb from above]

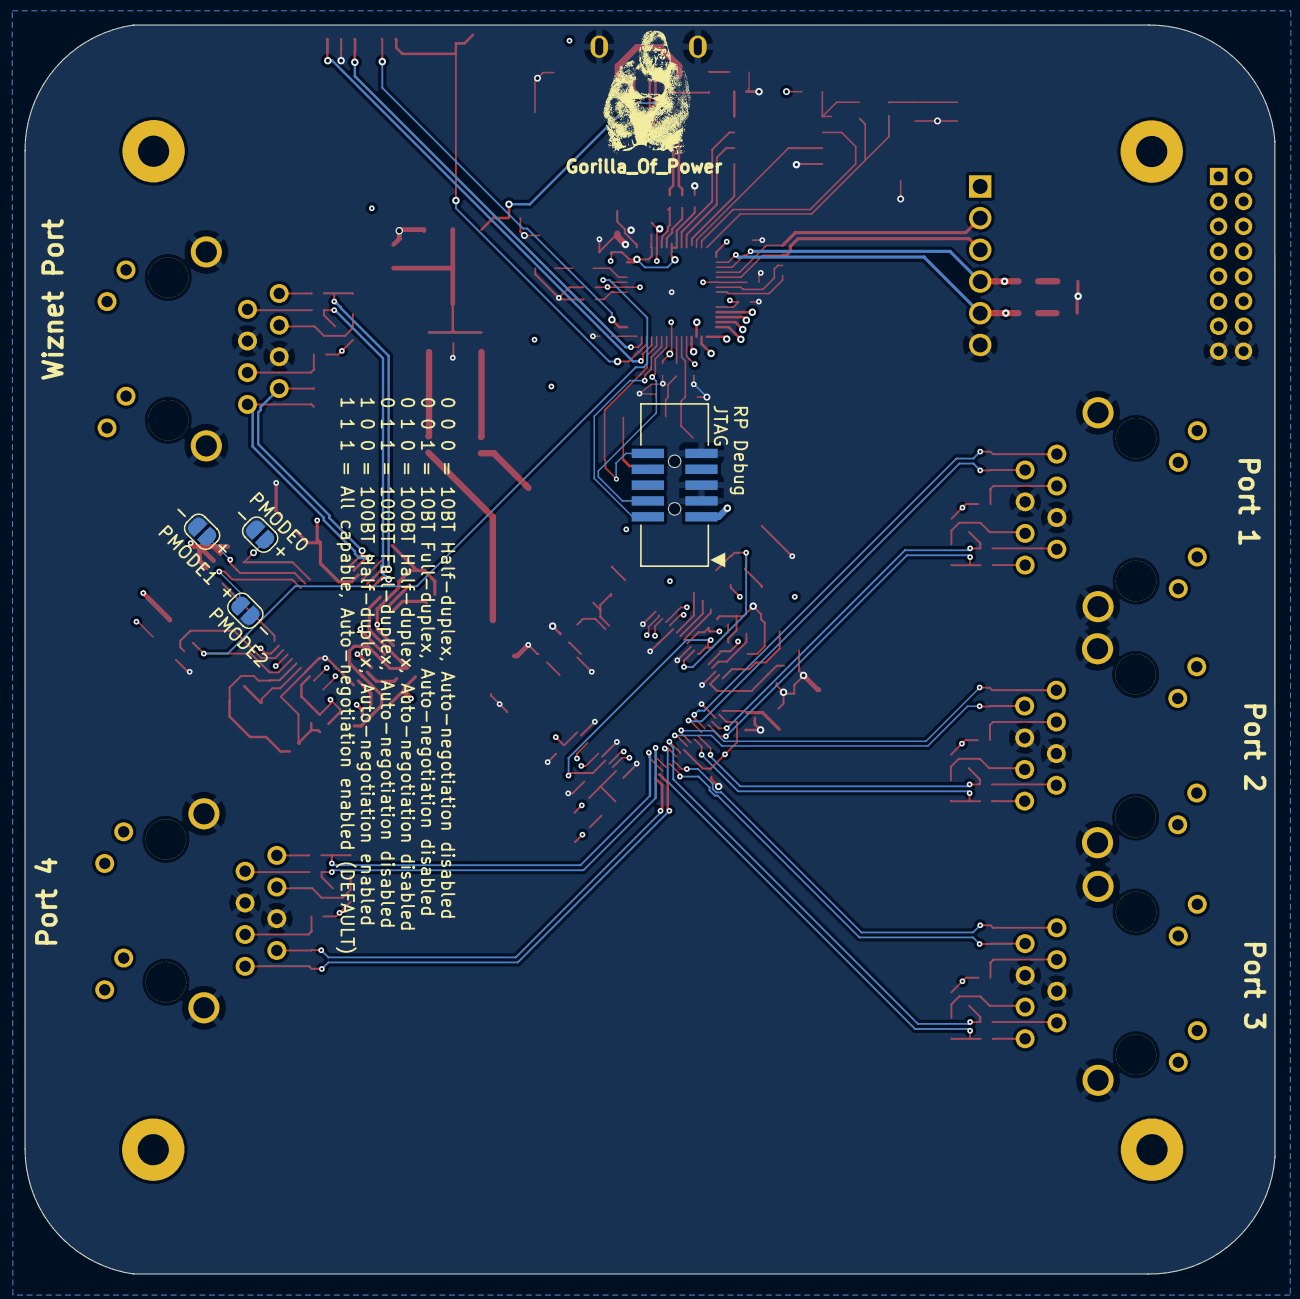
[picture p225: board peripheral_board.kicad_pcb from below]

Board: 4 copper layers, 100.2 x 100.1 mm, 168 parts (5 on the bottom side), 128 nets.

Other parts of the board:
Gorilla_Of_Power: LOGO
