BroncoSpace-Lab/scales-hardware/power_system/EPS/EPS_Scales_RevC/EPS_Scales_RevC.kicad_pcb

## KiCad design power_system/EPS/EPS_Scales_RevC/EPS_Scales_RevC.kicad_pcb (2025-06-03, an earlier design)

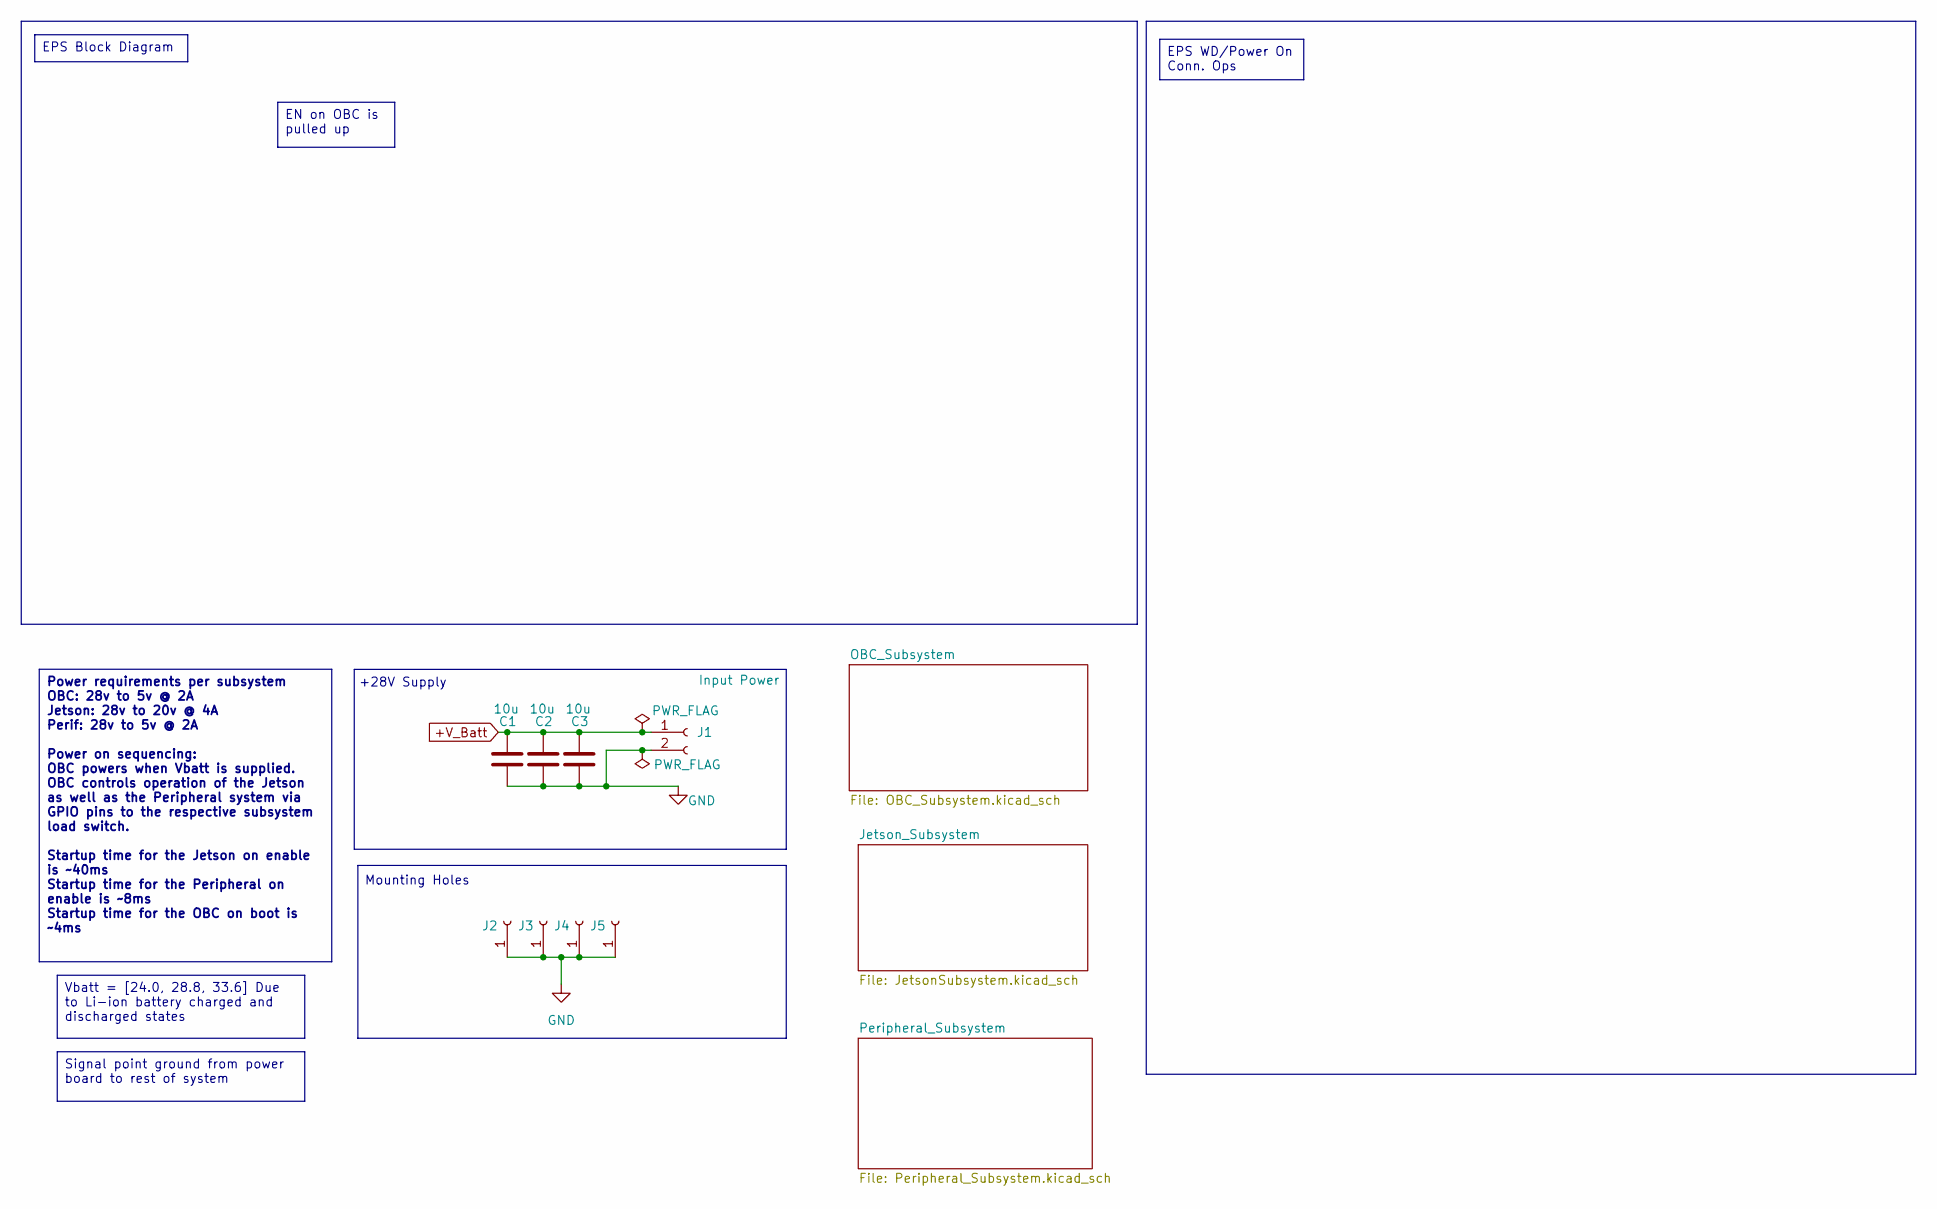
[picture p226: schematic EPS_Scales_RevC.kicad_sch, SCALES EPS Viking-1A]

Parts:
C1, C2, C3: 10u; C_1210_3225Metric
J1: Input Power; AMASS_XT60PW-F_1x02_P7.20mm_Horizontal
J2, J3, J4, J5: Conn_01x01_Socket; MountingHole_2.5mm_Pad

Connections:
+V_Batt: C1.1, C2.1, C3.1, J1.1; also elsewhere on the board
GND: C1.2, C2.2, C3.2, J1.2, J2.1, J3.1, J4.1, J5.1; also elsewhere on the board

Notes on the sheet:
Mounting Holes
+28V Supply
Signal point ground from power board to rest of system
EPS Block Diagram
Power requirements per subsystem OBC: 28v to 5v @ 2A Jetson: 28v to 20v @ 4A Perif: 28v to 5v @ 2A Power on sequencing: OBC powers when Vbatt is supplied. OBC controls operation of the Jetson as well as the Peripheral system via GPIO pins to the respective subsystem load switch. Startup time for th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
Vbatt = [24.0, 28.8, 33.6] Due to Li-ion battery charged and discharged states
EPS WD/Power On Conn. Ops
EN on OBC is pulled up

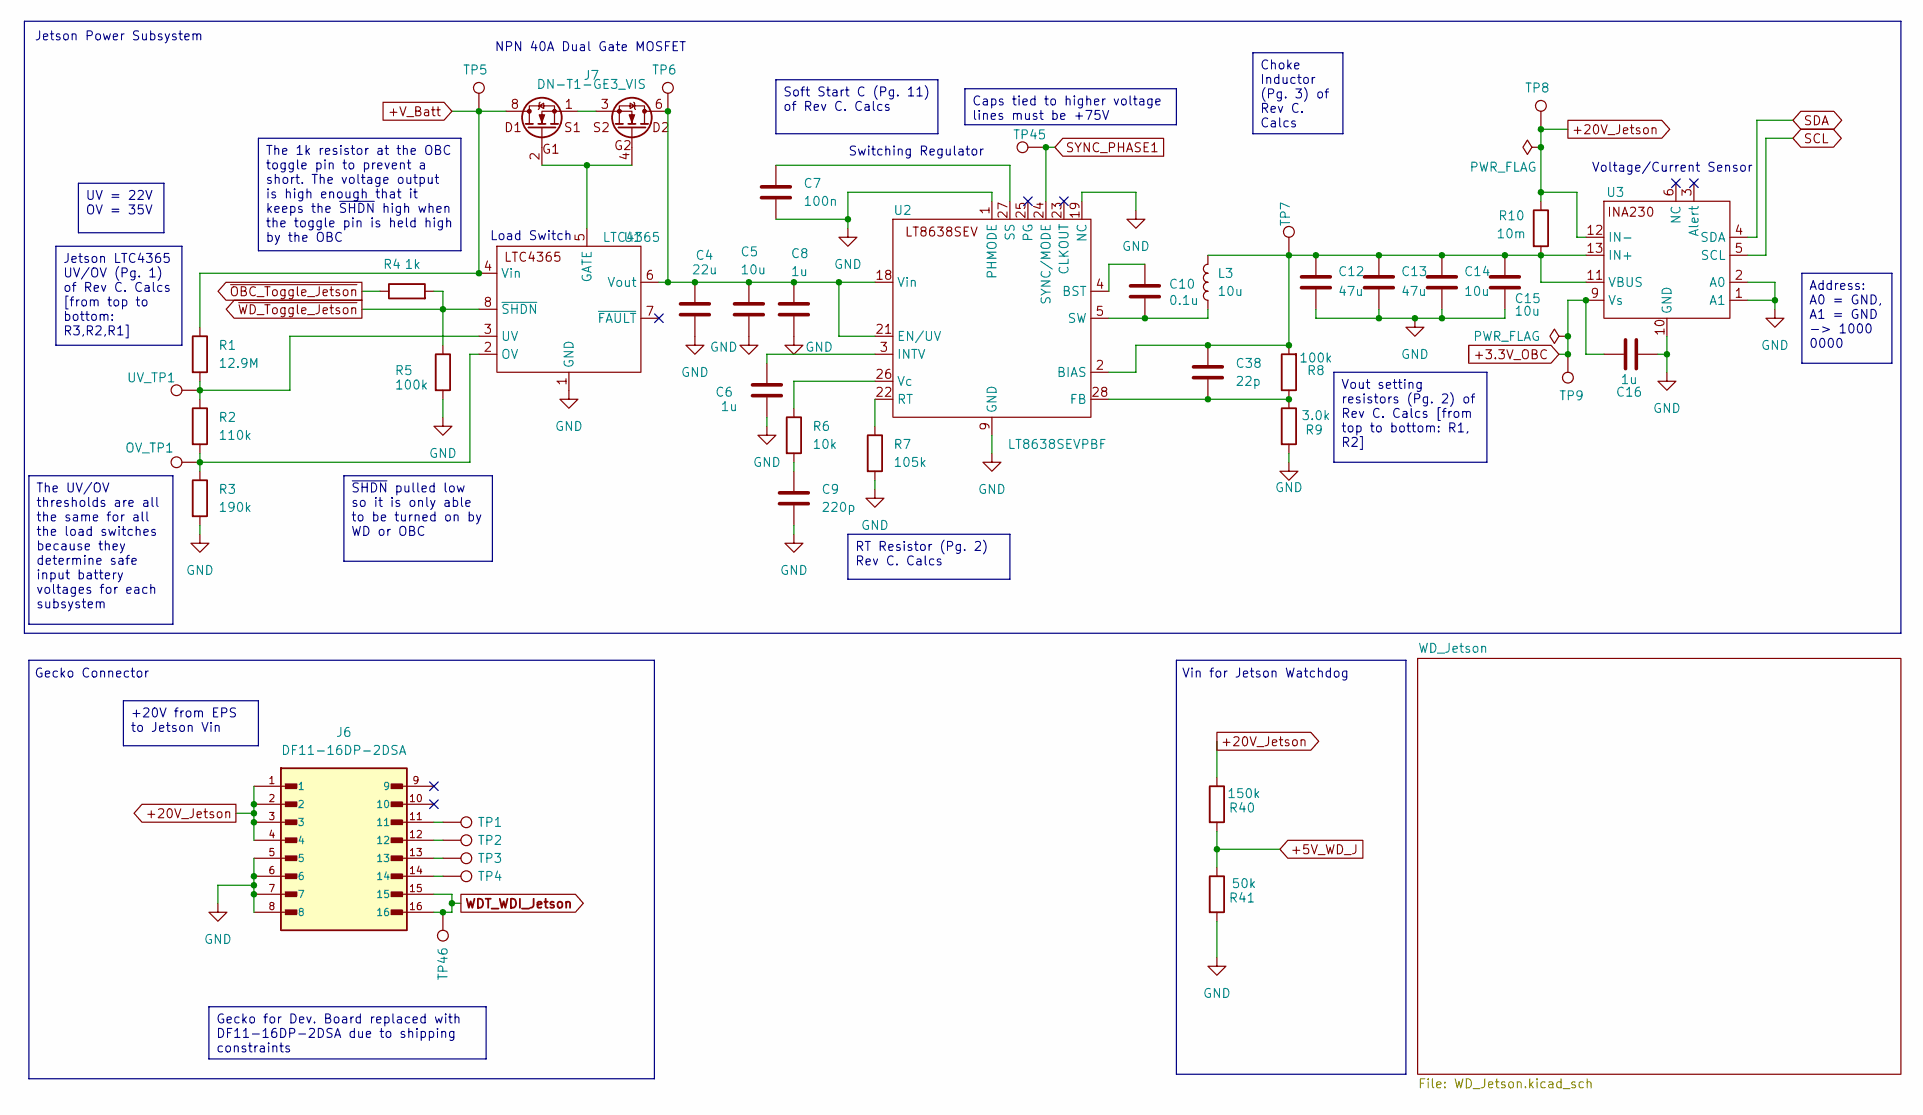
[picture p227: schematic JetsonSubsystem.kicad_sch]

Parts:
C4: 22u; C_1210_3225Metric; LCSC C309062
C5, C14, C15: 10u; C_1210_3225Metric
C6: 1u; C_0603_1608Metric; LCSC C304010
C7: 100n; C_0603_1608Metric
C8, C16: 1u; C_1210_3225Metric; LCSC C304010
C9: 220p; C_0603_1608Metric
C10: 0.1u; C_1210_3225Metric; LCSC C436244
C12, C13: 47u; C_1210_3225Metric
C38: 22p; C1206
J6: DF11-16DP-2DSA; DF1116DP2DSA08
J7: DN-T1-GE3_VIS; SISB46DN-T1-GE3
L3: 10u; IND-SMD_L13.8-W12.6_MHCC12050
OV_TP1: TestPoint; TestPoint_Pad_1.0x1.0mm
R1: 12.9M; R_0603_1608Metric
R2: 110k; R_0603_1608Metric; LCSC C25805
R3: 190k; R_0603_1608Metric; LCSC C25811
R4: 1k; R_0603_1608Metric; LCSC C13163
R5, R8: 100k; R_0603_1608Metric; LCSC C14675
R6: 10k; R_0603_1608Metric; LCSC C13564
R7: 105k; R_0603_1608Metric; LCSC C16840
R9: 3.0k; R_0603_1608Metric
R10: 10m; R_2512_6332Metric
R40: 150k; R_0603_1608Metric
R41: 50k; R_0603_1608Metric
TP1, TP2, TP3, TP4, TP5, TP6, TP7, TP8, TP9, TP45, TP46: TestPoint; TestPoint_Pad_1.0x1.0mm
U1: LTC4365; LCSC C580882
U2: LT8638SEVPBF; LCSC C3188906
U3: INA230; INA230AIRGTT; LCSC C92112
UV_TP1: TestPoint; TestPoint_Pad_1.0x1.0mm

Connections:
+3.3V_OBC: C16.2, TP9.1, U3.9 (Vs); also elsewhere on the board
+5V_WD_J: R40.2, R41.1; also elsewhere on the board
+20V_Jetson: J6.1, J6.2, J6.3, J6.4, R10.1, R40.1, TP8.1, U3.12 (IN-)
+V_Batt: J7.7, J7.8, R1.1, TP5.1, U1.4 (Vin); also elsewhere on the board
GND: C4.2, C5.2, C6.2, C7.2, C8.2, C9.2, C12.2, C13.2, C14.2, C15.2, C16.1, J6.5, J6.6, J6.7, J6.8, R3.2, R5.2, R7.2, R9.2, R41.2, U1.1 (GND), U2.1 (PHMODE), U2.9 (GND), U2.19 (NC), U3.1 (A1), U3.2 (A0), U3.10 (GND); also elsewhere on the board
unnamed: C9.1, R6.2
unnamed: J6.11, TP1.1
unnamed: J6.12, TP2.1
unnamed: J6.13, TP3.1
unnamed: J6.14, TP4.1
unnamed: J7.1, J7.3
unnamed: J7.2, J7.4, U1.5 (GATE)
unnamed: OV_TP1.1, R2.2, R3.1, U1.2 (OV)
unnamed: R1.2, R2.1, U1.3 (UV), UV_TP1.1
unnamed: C4.1, C5.1, C8.1, J7.5, J7.6, TP6.1, U1.6 (Vout), U2.18 (Vin), U2.21 (EN/UV)
unnamed: C12.1, C13.1, C14.1, C15.1, C38.1, L3.2, R8.2, R10.2, TP7.1, U2.2 (BIAS), U3.11 (VBUS), U3.13 (IN+)
unnamed: C10.1, U2.4 (BST)
unnamed: C38.2, R8.1, R9.1, U2.28 (FB)
unnamed: C6.1, U2.3 (INTV)
unnamed: R7.1, U2.22 (RT)
unnamed: C7.1, U2.27 (SS)
unnamed: C10.2, L3.1, U2.5 (SW)
unnamed: R6.1, U2.26 (Vc)
SCL: U3.5 (SCL); also elsewhere on the board
SDA: U3.4 (SDA); also elsewhere on the board
SYNC_PHASE1: TP45.1, U2.24 (SYNC/MODE); also elsewhere on the board
WDT_WDI_Jetson: J6.15, J6.16, TP46.1; also elsewhere on the board
~OBC_Toggle_Jetson: R4.1; also elsewhere on the board
~WD_Toggle_Jetson: R4.2, R5.1, U1.8 (~SHDN); also elsewhere on the board

Notes on the sheet:
Switching Regulator
Jetson Power Subsystem
Gecko Connector
Vin for Jetson Watchdog
NPN 40A Dual Gate MOSFET
Load Switch
Voltage/Current Sensor
Gecko for Dev. Board replaced with DF11-16DP-2DSA due to shipping constraints
~{SHDN} pulled low so it is only able to be turned on by WD or OBC
RT Resistor (Pg. 2) Rev C. Calcs
Jetson LTC4365 UV/OV (Pg. 1) of Rev C. Calcs [from top to bottom: R3,R2,R1]
Caps tied to higher voltage lines must be +75V
Choke Inductor (Pg. 3) of Rev C. Calcs
The UV/OV thresholds are all the same for all the load switches because they determine safe input battery voltages for each subsystem
Vout setting resistors (Pg. 2) of Rev C. Calcs [from top to bottom: R1, R2]
UV = 22V OV = 35V
Soft Start C (Pg. 11) of Rev C. Calcs
+20V from EPS to Jetson Vin
Address: A0 = GND, A1 = GND -> 1000 0000
The 1k resistor at the OBC toggle pin to prevent a short. The voltage output is high enough that it keeps the ~{SHDN} high when the toggle pin is held high by the OBC
