BroncoSpace-Lab/scales-hardware/power_system/EPS/EPS_Scales_RevC/EPS_Scales_RevC.kicad_pcb

## KiCad design power_system/EPS/EPS_Scales_RevC/EPS_Scales_RevC.kicad_pcb (continued)

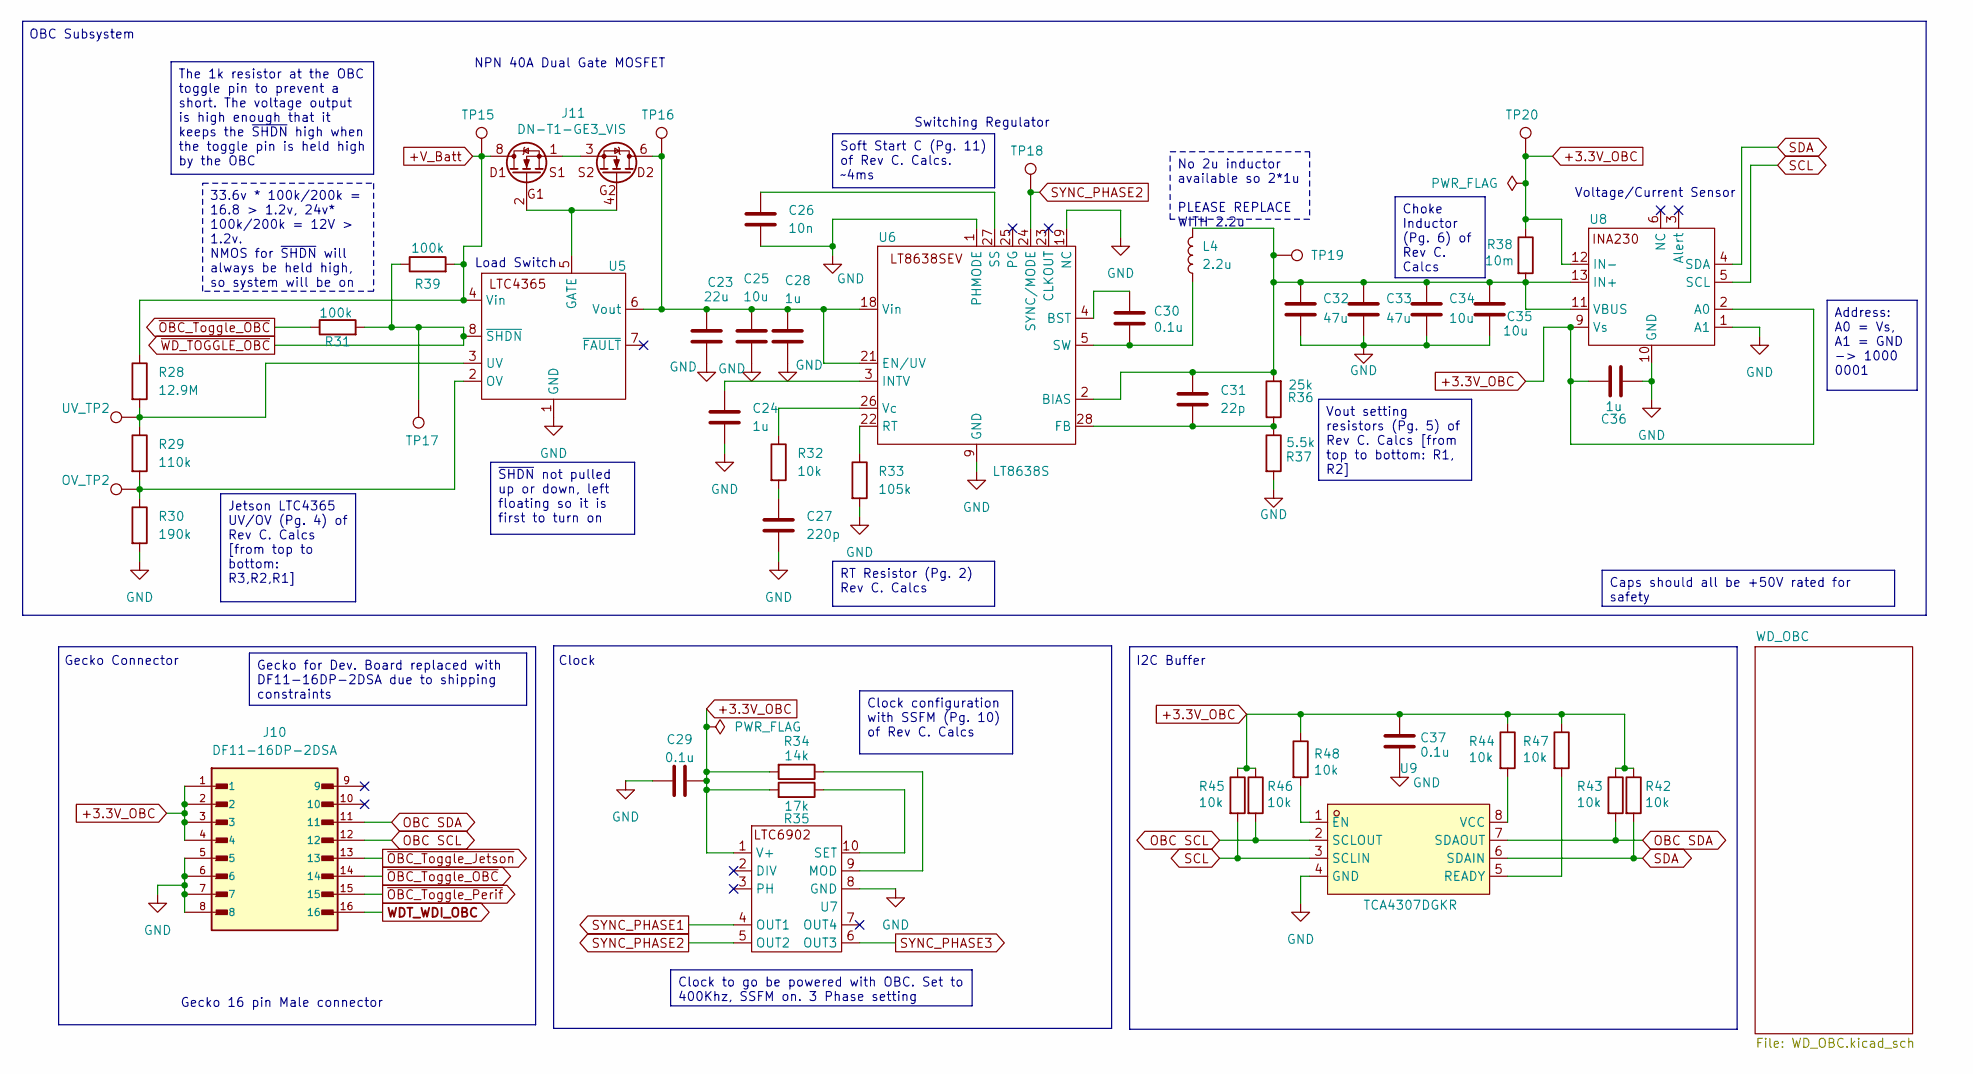
[picture p228: schematic OBC_Subsystem.kicad_sch]

Parts:
C23: 22u; C_1210_3225Metric; LCSC C309062
C24: 1u; C_0603_1608Metric; LCSC C304010
C25, C34, C35: 10u; C_1210_3225Metric
C26: 10n; C_0603_1608Metric
C27: 220p; C_0603_1608Metric
C28, C36: 1u; C_1210_3225Metric; LCSC C304010
C29, C30: 0.1u; C_1210_3225Metric; LCSC C436244
C31: 22p; C1206
C32, C33: 47u; C_1210_3225Metric
C37: 0.1u; C_1210_3225Metric
J10: DF11-16DP-2DSA; DF1116DP2DSA08
J11: DN-T1-GE3_VIS; SISB46DN-T1-GE3
L4: 2.2u; XEL6030; LCSC C5157561
OV_TP2: TestPoint; TestPoint_Pad_1.0x1.0mm
R28: 12.9M; R_0603_1608Metric
R29: 110k; R_0603_1608Metric; LCSC C25805
R30: 190k; R_0603_1608Metric; LCSC C25811
R31, R39: 100k; R_0603_1608Metric; LCSC C13163
R32: 10k; R_0603_1608Metric; LCSC C13564
R33: 105k; R_0603_1608Metric; LCSC C16840
R34: 14k; R_0603_1608Metric
R35: 17k; R_0603_1608Metric
R36: 25k; R_0603_1608Metric
R37: 5.5k; R_0603_1608Metric
R38: 10m; R_2512_6332Metric
R42, R43, R44, R45, R46, R47, R48: 10k; R_0603_1608Metric
TP15, TP16, TP17, TP18, TP19, TP20: TestPoint; TestPoint_Pad_1.0x1.0mm
U5: LTC4365; LCSC C580882
U6: LT8638S; LT8638SEVPBF
U7: LTC6902; LCSC C581012
U8: INA230; INA230AIRGTT
U9: TCA4307DGKR; VSSOP-8_L3.0-W3.0-P0.65-LS4.9-BL; LCSC Part C880333
UV_TP2: TestPoint; TestPoint_Pad_1.0x1.0mm

Connections:
+3.3V_OBC: C29.2, C36.2, C37.1, J10.1, J10.2, J10.3, J10.4, R34.2, R35.2, R38.1, R42.1, R43.1, R44.1, R45.1, R46.1, R47.1, R48.1, TP20.1, U7.1 (V+), U8.2 (A0), U8.9 (Vs), U8.12 (IN-); also elsewhere on the board
+V_Batt: J11.7, J11.8, R28.1, R39.2, TP15.1, U5.4 (Vin); also elsewhere on the board
GND: C23.2, C24.2, C25.2, C26.2, C27.2, C28.2, C29.1, C32.2, C33.2, C34.2, C35.2, C36.1, C37.2, J10.5, J10.6, J10.7, J10.8, R30.2, R33.2, R37.2, U5.1 (GND), U6.1 (PHMODE), U6.9 (GND), U6.19 (NC), U7.8 (GND), U8.1 (A1), U8.10 (GND), U9.4 (GND); also elsewhere on the board
unnamed: C27.1, R32.2
unnamed: J11.1, J11.3
unnamed: J11.2, J11.4, U5.5 (GATE)
unnamed: OV_TP2.1, R29.2, R30.1, U5.2 (OV)
unnamed: R28.2, R29.1, U5.3 (UV), UV_TP2.1
unnamed: C23.1, C25.1, C28.1, J11.5, J11.6, TP16.1, U5.6 (Vout), U6.18 (Vin), U6.21 (EN/UV)
unnamed: C31.1, C32.1, C33.1, C34.1, C35.1, L4.2, R36.2, R38.2, TP19.1, U6.2 (BIAS), U8.11 (VBUS), U8.13 (IN+)
unnamed: C30.1, U6.4 (BST)
unnamed: C31.2, R36.1, R37.1, U6.28 (FB)
unnamed: C24.1, U6.3 (INTV)
unnamed: R33.1, U6.22 (RT)
unnamed: C26.1, U6.27 (SS)
unnamed: C30.2, L4.1, U6.5 (SW)
unnamed: R32.1, U6.26 (Vc)
unnamed: R34.1, U7.9 (MOD)
unnamed: R35.1, U7.10 (SET)
unnamed: R48.2, U9.1 (EN)
unnamed: R47.2, U9.5 (READY)
unnamed: R44.2, U9.8 (VCC)
OBC SCL: J10.12, R46.2, U9.2 (SCLOUT)
OBC SDA: J10.11, R43.2, U9.7 (SDAOUT)
SCL: R45.2, U8.5 (SCL), U9.3 (SCLIN); also elsewhere on the board
SDA: R42.2, U8.4 (SDA), U9.6 (SDAIN); also elsewhere on the board
SYNC_PHASE1: U7.4 (OUT1); also elsewhere on the board
SYNC_PHASE2: TP18.1, U6.24 (SYNC/MODE), U7.5 (OUT2)
SYNC_PHASE3: U7.6 (OUT3); also elsewhere on the board
WDT_WDI_OBC: J10.16; also elsewhere on the board
~OBC_Toggle_Jetson: J10.13; also elsewhere on the board
~OBC_Toggle_OBC: J10.14, R31.1
~OBC_Toggle_Perif: J10.15; also elsewhere on the board
~WD_TOGGLE_OBC: R31.2, R39.1, TP17.1, U5.8 (~SHDN); also elsewhere on the board

Notes on the sheet:
Clock
Load Switch
OBC Subsystem
NPN 40A Dual Gate MOSFET
I2C Buffer
Gecko Connector
Gecko 16 pin Male connector
Switching Regulator
Voltage/Current Sensor
No 2u inductor available so 2*1u PLEASE REPLACE WITH 2.2u
Choke Inductor (Pg. 6) of Rev C. Calcs
RT Resistor (Pg. 2) Rev C. Calcs
Jetson LTC4365 UV/OV (Pg. 4) of Rev C. Calcs [from top to bottom: R3,R2,R1]
Caps should all be +50V rated for safety
33.6v * 100k/200k = 16.8 > 1.2v, 24v* 100k/200k = 12V > 1.2v. NMOS for ~{SHDN} will always be held high, so system will be on
Soft Start C (Pg. 11) of Rev C. Calcs. ~4ms
Address: A0 = Vs, A1 = GND -> 1000 0001
Vout setting resistors (Pg. 5) of Rev C. Calcs [from top to bottom: R1, R2]
Gecko for Dev. Board replaced with DF11-16DP-2DSA due to shipping constraints
The 1k resistor at the OBC toggle pin to prevent a short. The voltage output is high enough that it keeps the ~{SHDN} high when the toggle pin is held high by the OBC
~{SHDN} not pulled up or down, left floating so it is first to turn on
Clock configuration with SSFM (Pg. 10) of Rev C. Calcs
Clock to go be powered with OBC. Set to 400Khz, SSFM on. 3 Phase setting

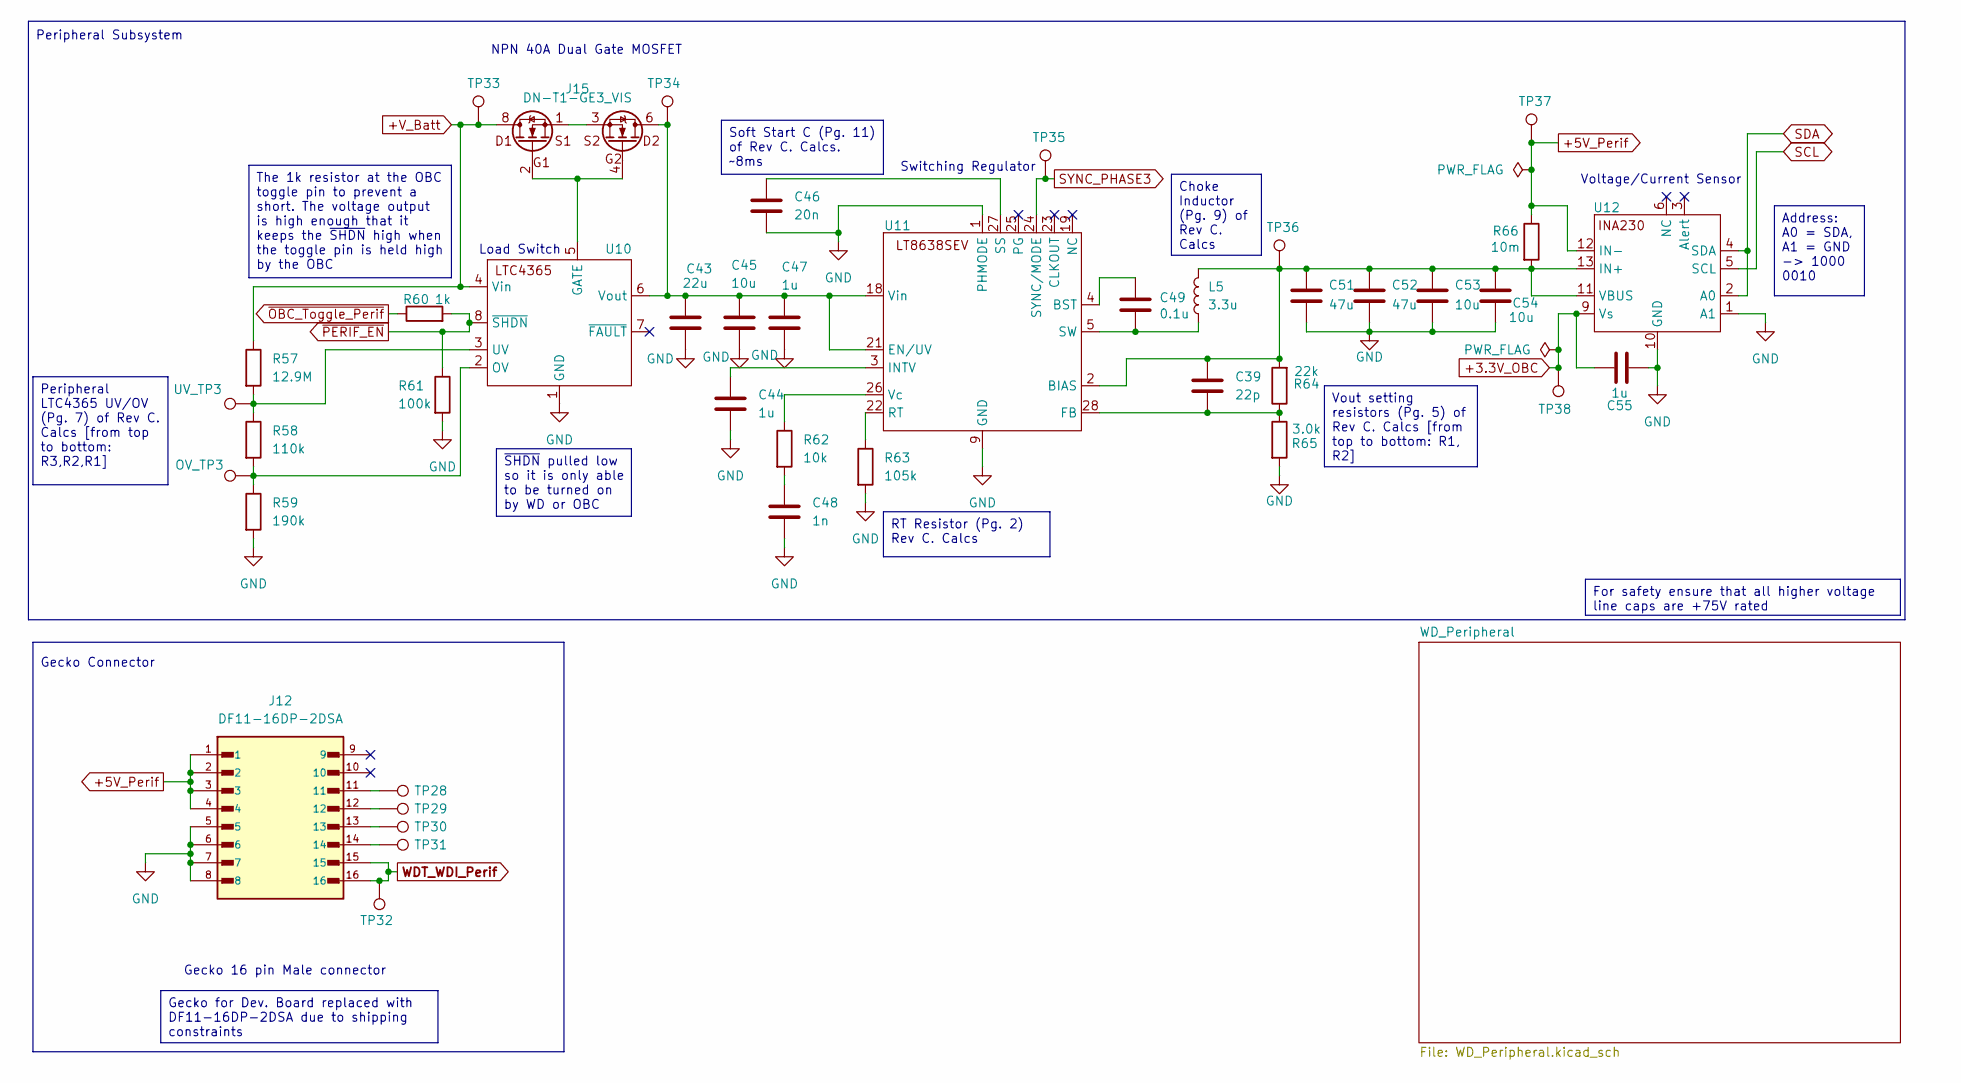
[picture p229: schematic Peripheral_Subsystem.kicad_sch]

Parts:
C39: 22p; C1206
C43: 22u; C_1210_3225Metric; LCSC C309062
C44: 1u; C_0603_1608Metric; LCSC C304010
C45, C53, C54: 10u; C_1210_3225Metric
C46: 20n; C_0603_1608Metric; LCSC C87721
C47, C55: 1u; C_1210_3225Metric; LCSC C304010
C48: 1n; C_0603_1608Metric; LCSC C2173372
C49: 0.1u; C_1210_3225Metric; LCSC C436244
C51, C52: 47u; C_1210_3225Metric
J12: DF11-16DP-2DSA; DF1116DP2DSA08
J15: DN-T1-GE3_VIS; SISB46DN-T1-GE3
L5: 3.3u; XEL6030; LCSC C5157561
OV_TP3: TestPoint; TestPoint_Pad_1.0x1.0mm
R57: 12.9M; R_0603_1608Metric
R58: 110k; R_0603_1608Metric; LCSC C25805
R59: 190k; R_0603_1608Metric; LCSC C25811
R60: 1k; R_0603_1608Metric; LCSC C13163
R61: 100k; R_0603_1608Metric; LCSC C14675
R62: 10k; R_0603_1608Metric; LCSC C13564
R63: 105k; R_0603_1608Metric; LCSC C16840
R64: 22k; R_0603_1608Metric; LCSC C23344
R65: 3.0k; R_0603_1608Metric
R66: 10m; R_2512_6332Metric
TP28, TP29, TP30, TP31, TP32, TP33, TP34, TP35, TP36, TP37, TP38: TestPoint; TestPoint_Pad_1.0x1.0mm
U10: LTC4365; LCSC C580882
U11: LT8638S; LT8638SEVPBF
U12: INA230; INA230AIRGTT
UV_TP3: TestPoint; TestPoint_Pad_1.0x1.0mm

Connections:
+3.3V_OBC: C55.2, TP38.1, U12.9 (Vs); also elsewhere on the board
+5V_Perif: J12.1, J12.2, J12.3, J12.4, R66.1, TP37.1, U12.12 (IN-); also elsewhere on the board
+V_Batt: J15.7, J15.8, R57.1, TP33.1, U10.4 (Vin); also elsewhere on the board
GND: C43.2, C44.2, C45.2, C46.2, C47.2, C48.2, C51.2, C52.2, C53.2, C54.2, C55.1, J12.5, J12.6, J12.7, J12.8, R59.2, R61.2, R63.2, R65.2, U10.1 (GND), U11.1 (PHMODE), U11.9 (GND), U12.1 (A1), U12.10 (GND); also elsewhere on the board
unnamed: C48.1, R62.2
unnamed: J12.11, TP28.1
unnamed: J12.12, TP29.1
unnamed: J12.13, TP30.1
unnamed: J12.14, TP31.1
unnamed: J15.1, J15.3
unnamed: J15.2, J15.4, U10.5 (GATE)
unnamed: OV_TP3.1, R58.2, R59.1, U10.2 (OV)
unnamed: R57.2, R58.1, U10.3 (UV), UV_TP3.1
unnamed: C43.1, C45.1, C47.1, J15.5, J15.6, TP34.1, U10.6 (Vout), U11.18 (Vin), U11.21 (EN/UV)
unnamed: C39.1, C51.1, C52.1, C53.1, C54.1, L5.2, R64.2, R66.2, TP36.1, U11.2 (BIAS), U12.11 (VBUS), U12.13 (IN+)
unnamed: C49.1, U11.4 (BST)
unnamed: C39.2, R64.1, R65.1, U11.28 (FB)
unnamed: C44.1, U11.3 (INTV)
unnamed: R63.1, U11.22 (RT)
unnamed: C46.1, U11.27 (SS)
unnamed: C49.2, L5.1, U11.5 (SW)
unnamed: R62.1, U11.26 (Vc)
SCL: U12.5 (SCL); also elsewhere on the board
SDA: U12.2 (A0), U12.4 (SDA); also elsewhere on the board
SYNC_PHASE3: TP35.1, U11.24 (SYNC/MODE); also elsewhere on the board
WDT_WDI_Perif: J12.15, J12.16, TP32.1; also elsewhere on the board
~OBC_Toggle_Perif: R60.1; also elsewhere on the board
~PERIF_EN: R60.2, R61.1, U10.8 (~SHDN); also elsewhere on the board

Notes on the sheet:
NPN 40A Dual Gate MOSFET
Peripheral Subsystem
Load Switch
Switching Regulator
Gecko Connector
Gecko 16 pin Male connector
Voltage/Current Sensor
The 1k resistor at the OBC toggle pin to prevent a short. The voltage output is high enough that it keeps the ~{SHDN} high when the toggle pin is held high by the OBC
Vout setting resistors (Pg. 5) of Rev C. Calcs [from top to bottom: R1, R2]
~{SHDN} pulled low so it is only able to be turned on by WD or OBC
For safety ensure that all higher voltage line caps are +75V rated
Gecko for Dev. Board replaced with DF11-16DP-2DSA due to shipping constraints
Address: A0 = SDA, A1 = GND -> 1000 0010
Soft Start C (Pg. 11) of Rev C. Calcs. ~8ms
Peripheral LTC4365 UV/OV (Pg. 7) of Rev C. Calcs [from top to bottom: R3,R2,R1]
Choke Inductor (Pg. 9) of Rev C. Calcs
RT Resistor (Pg. 2) Rev C. Calcs

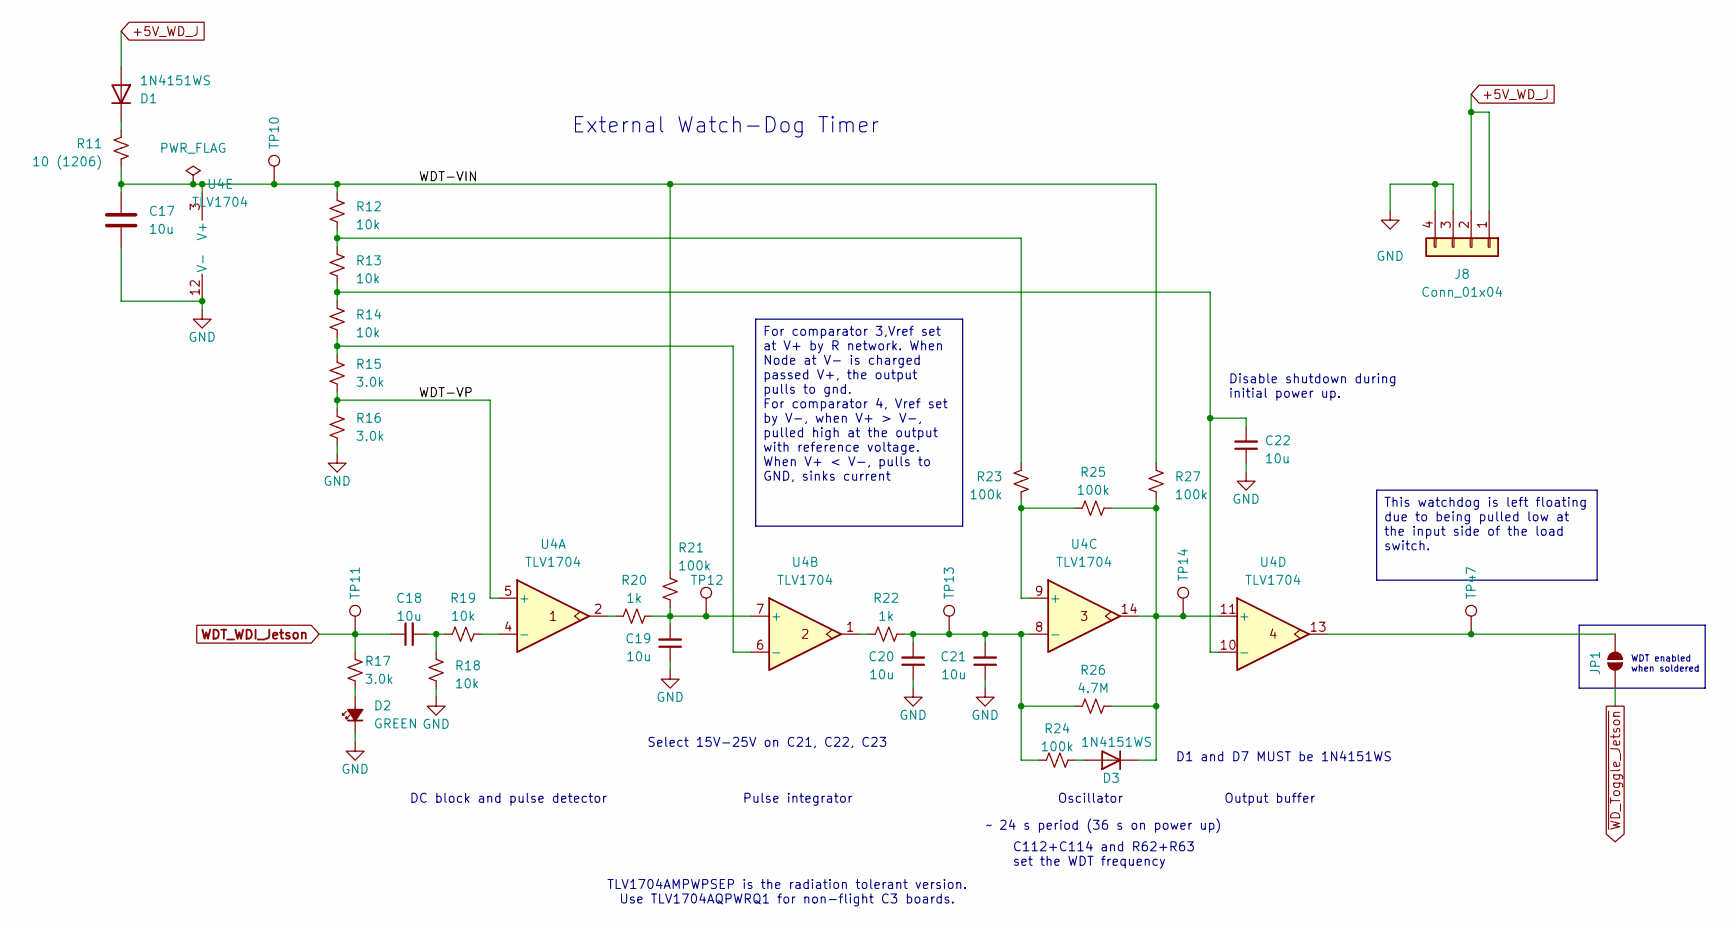
[picture p230: schematic WD_Jetson.kicad_sch]

Parts:
C17: 10u; C_1210_3225Metric
C18, C19, C20, C21, C22: 10u; C_1210_3225Metric; MPN GRT188R61C106KE13D
D1, D3: 1N4151WS; SODFL2512X100N; MPN 1N4151WS-E3-08
D2: GREEN; LED_0603_1608Metric; MPN 150060GS75000
J8: Conn_01x04; PinSocket_1x04_P2.54mm_Vertical
JP1: SolderJumper_2_Open; SolderJumper-2_P1.3mm_Open_RoundedPad1.0x1.5mm
R11: 10 (1206); R_1206_3216Metric; MPN ESR18EZPF10R0; LCSC C17903
R12, R13, R14, R18, R19: 10k; R_0603_1608Metric; MPN RMCF0603FT10K0; LCSC C13564
R15, R16, R17: 3.0k; R_0603_1608Metric; MPN RMCF0603FT3K00; LCSC C4211
R20, R22: 1k; R_0603_1608Metric; MPN RMCF0603FT1K00; LCSC C13163
R21, R23, R24, R25, R27: 100k; R_0603_1608Metric; MPN RMCF0603FT100K; LCSC C14675
R26: 4.7M; R_0603_1608Metric; MPN RMCF0603FT4M70
TP10, TP11, TP12, TP13, TP14, TP47: TestPoint; TestPoint_Pad_1.0x1.0mm
U4: TLV1704; TSSOP-14_4.4x5mm_P0.65mm; MPN TLV1704AQPWRQ1; LCSC C181596

Connections:
+5V_WD_J: D1.2 (A), J8.1, J8.2; also elsewhere on the board
/Jetson_Subsystem/WD_Jetson/WDT-VIN: C17.1, R11.2, R12.1, R21.1, R27.2, TP10.1, U4.3 (V+)
/Jetson_Subsystem/WD_Jetson/WDT-VP: R15.2, R16.1, U4.5 (+)
GND: C17.2, C19.1, C20.1, C21.1, C22.1, D2.1 (K), J8.3, J8.4, R16.2, R18.2, U4.12 (V-); also elsewhere on the board
unnamed: C18.2, R18.1, R19.1
unnamed: D1.1 (K), R11.1
unnamed: D2.2 (A), R17.2
unnamed: D3.2 (A), R24.1
unnamed: D3.1 (K), R25.2, R26.1, R27.1, TP14.1, U4.11 (+), U4.14
unnamed: JP1.1 (A), TP47.1, U4.13
unnamed: R12.2, R13.1, R23.2
unnamed: R20.1, U4.2
unnamed: R22.1, U4.1
unnamed: R19.2, U4.4 (-)
unnamed: C19.2, R20.2, R21.2, TP12.1, U4.7 (+)
unnamed: R14.2, R15.1, U4.6 (-)
unnamed: R23.1, R25.1, U4.9 (+)
unnamed: C20.2, C21.2, R22.2, R24.2, R26.2, TP13.1, U4.8 (-)
unnamed: C22.2, R13.2, R14.1, U4.10 (-)
WDT_WDI_Jetson: C18.1, R17.1, TP11.1; also elsewhere on the board
~WD_Toggle_Jetson: JP1.2 (B); also elsewhere on the board

Notes on the sheet:
TLV1704AMPWPSEP is the radiation tolerant version. Use TLV1704AQPWRQ1 for non-flight C3 boards.
Oscillator
External Watch-Dog Timer
Disable shutdown during initial power up.
Pulse integrator
C112+C114 and R62+R63 set the WDT frequency
~ 24 s period (36 s on power up)
D1 and D7 MUST be 1N4151WS
Select 15V-25V on C21, C22, C23
Output buffer
WDT enabled when soldered
DC block and pulse detector
This watchdog is left floating due to being pulled low at the input side of the load switch.
For comparator 3,Vref set at V+ by R network. When Node at V- is charged passed V+, the output pulls to gnd. For comparator 4, Vref set by V-, when V+ > V-, pulled high at the output with reference voltage. When V+ < V-, pulls to GND, sinks current

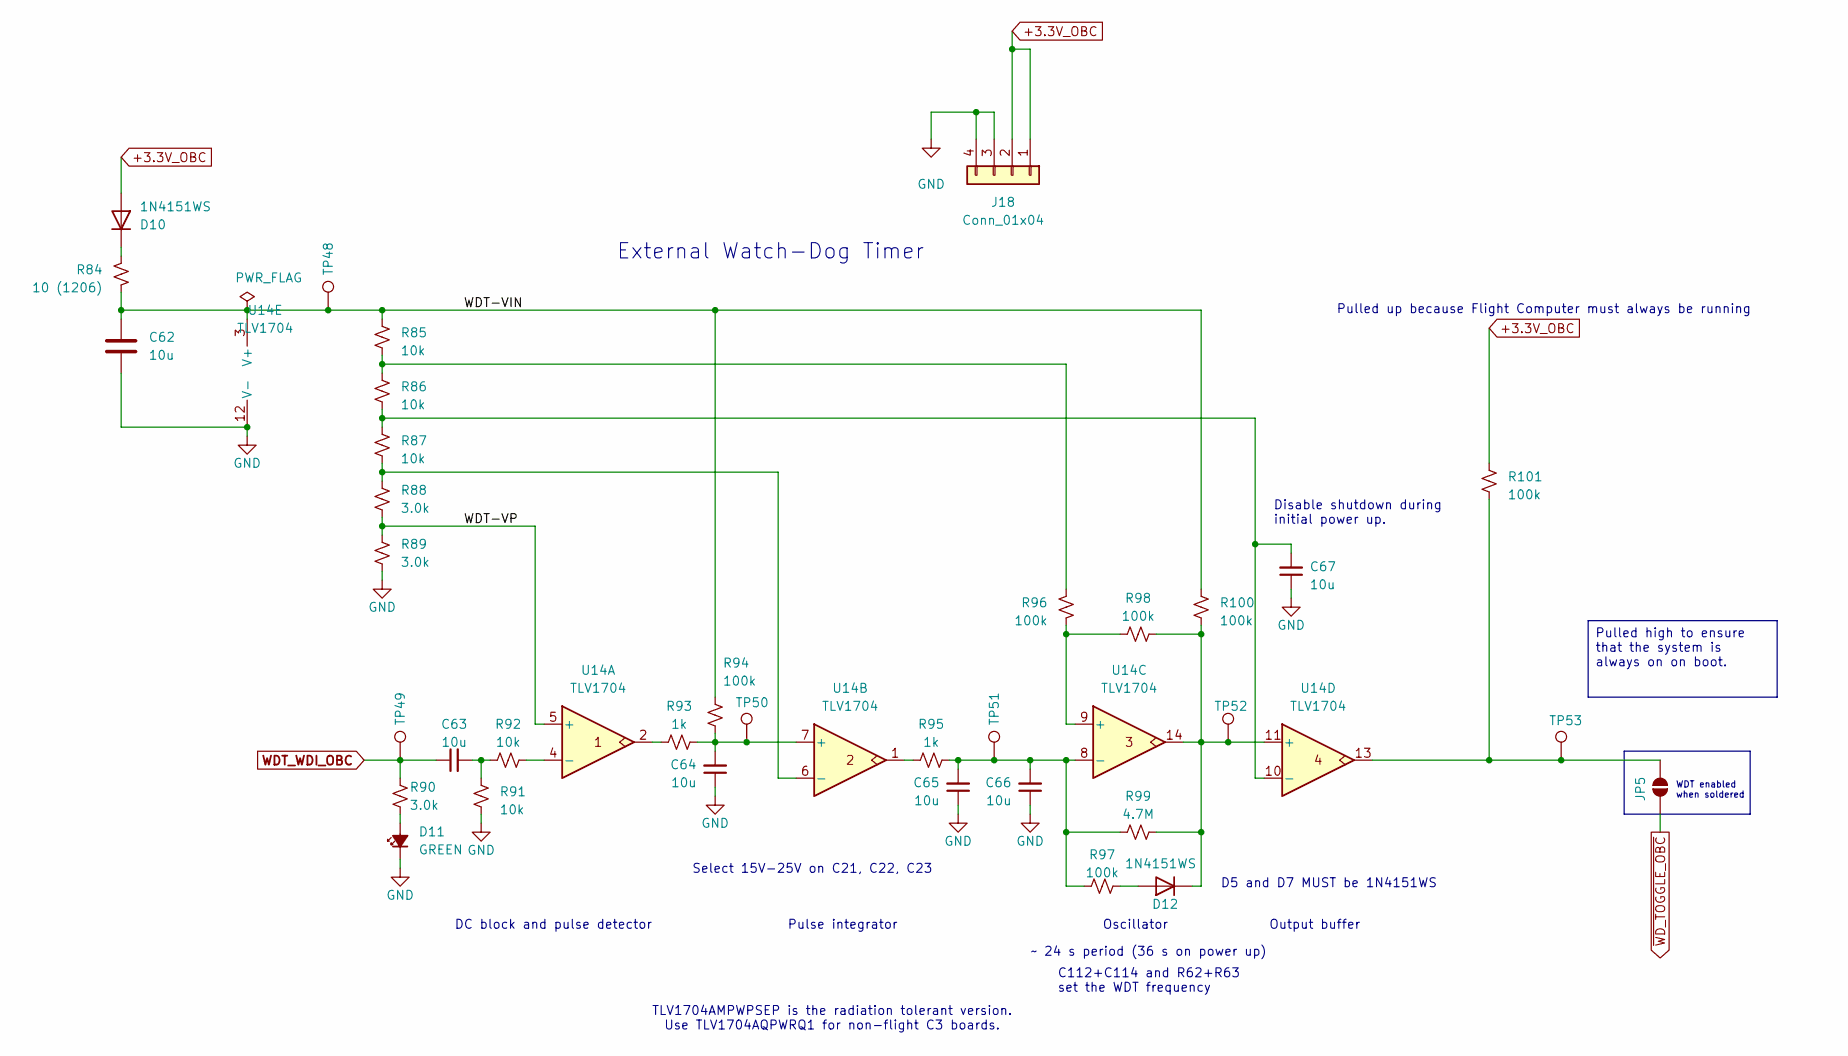
[picture p231: schematic WD_OBC.kicad_sch]

Parts:
C62: 10u; C_1210_3225Metric
C63, C64, C65, C66, C67: 10u; C_1210_3225Metric; MPN GRT188R61C106KE13D
D10, D12: 1N4151WS; SODFL2512X100N; MPN 1N4151WS-E3-08
D11: GREEN; LED_0603_1608Metric; MPN 150060GS75000
J18: Conn_01x04; PinSocket_1x04_P2.54mm_Vertical
JP5: SolderJumper_2_Open; SolderJumper-2_P1.3mm_Open_RoundedPad1.0x1.5mm
R84: 10 (1206); R_1206_3216Metric; MPN ESR18EZPF10R0; LCSC C17903
R85, R86, R87, R91, R92: 10k; R_0603_1608Metric; MPN RMCF0603FT10K0; LCSC C13564
R88, R89, R90: 3.0k; R_0603_1608Metric; MPN RMCF0603FT3K00; LCSC C4211
R93, R95: 1k; R_0603_1608Metric; MPN RMCF0603FT1K00; LCSC C13163
R94, R96, R97, R98, R100, R101: 100k; R_0603_1608Metric; MPN RMCF0603FT100K; LCSC C14675
R99: 4.7M; R_0603_1608Metric; MPN RMCF0603FT4M70
TP48, TP49, TP50, TP51, TP52, TP53: TestPoint; TestPoint_Pad_1.0x1.0mm
U14: TLV1704; TSSOP-14_4.4x5mm_P0.65mm; MPN TLV1704AQPWRQ1; LCSC C181596

Connections:
+3.3V_OBC: D10.2 (A), J18.1, J18.2, R101.2; also elsewhere on the board
/OBC_Subsystem/WD_OBC/WDT-VIN: C62.1, R84.2, R85.1, R94.1, R100.2, TP48.1, U14.3 (V+)
/OBC_Subsystem/WD_OBC/WDT-VP: R88.2, R89.1, U14.5 (+)
GND: C62.2, C64.1, C65.1, C66.1, C67.1, D11.1 (K), J18.3, J18.4, R89.2, R91.2, U14.12 (V-); also elsewhere on the board
unnamed: C63.2, R91.1, R92.1
unnamed: D10.1 (K), R84.1
unnamed: D11.2 (A), R90.2
unnamed: D12.2 (A), R97.1
unnamed: D12.1 (K), R98.2, R99.1, R100.1, TP52.1, U14.11 (+), U14.14
unnamed: JP5.1 (A), R101.1, TP53.1, U14.13
unnamed: R85.2, R86.1, R96.2
unnamed: R93.1, U14.2
unnamed: R95.1, U14.1
unnamed: R92.2, U14.4 (-)
unnamed: C64.2, R93.2, R94.2, TP50.1, U14.7 (+)
unnamed: R87.2, R88.1, U14.6 (-)
unnamed: R96.1, R98.1, U14.9 (+)
unnamed: C65.2, C66.2, R95.2, R97.2, R99.2, TP51.1, U14.8 (-)
unnamed: C67.2, R86.2, R87.1, U14.10 (-)
WDT_WDI_OBC: C63.1, R90.1, TP49.1; also elsewhere on the board
~WD_TOGGLE_OBC: JP5.2 (B); also elsewhere on the board

Notes on the sheet:
Oscillator
Output buffer
DC block and pulse detector
D5 and D7 MUST be 1N4151WS
Disable shutdown during initial power up.
Pulled up because Flight Computer must always be running
Select 15V-25V on C21, C22, C23
Pulse integrator
WDT enabled when soldered
TLV1704AMPWPSEP is the radiation tolerant version. Use TLV1704AQPWRQ1 for non-flight C3 boards.
External Watch-Dog Timer
C112+C114 and R62+R63 set the WDT frequency
~ 24 s period (36 s on power up)
Pulled high to ensure that the system is always on on boot.

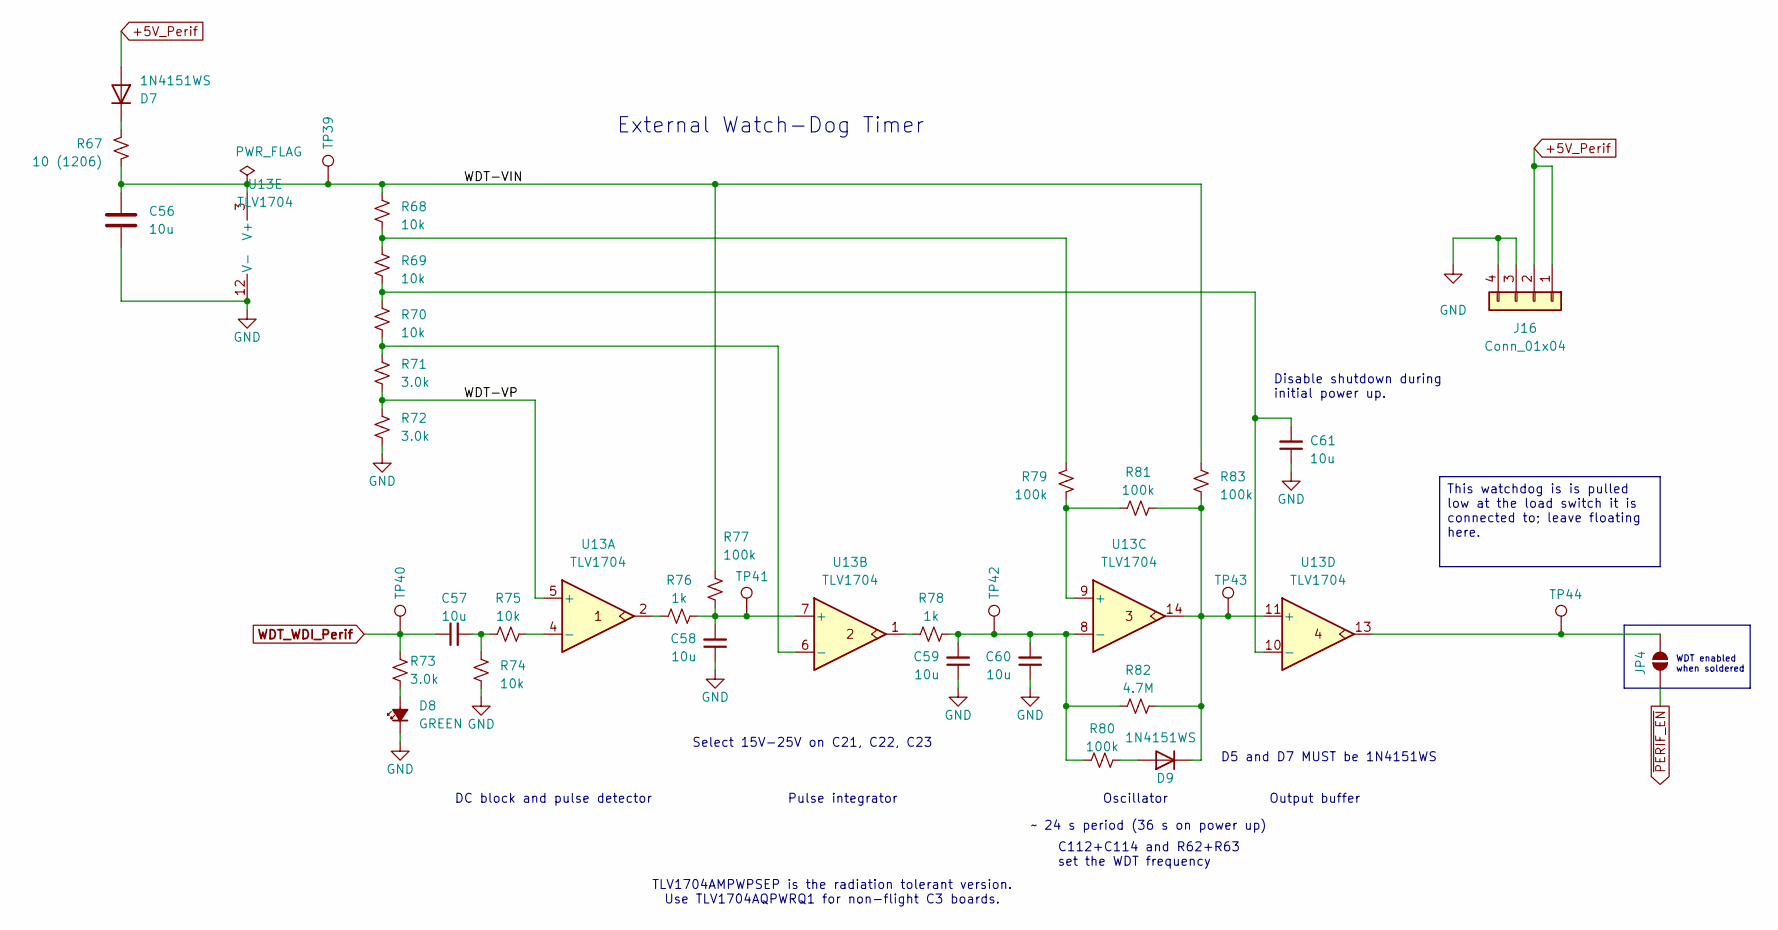
[picture p232: schematic WD_Peripheral.kicad_sch]

Parts:
C56: 10u; C_1210_3225Metric
C57, C58, C59, C60, C61: 10u; C_1210_3225Metric; MPN GRT188R61C106KE13D
D7, D9: 1N4151WS; SODFL2512X100N; MPN 1N4151WS-E3-08
D8: GREEN; LED_0603_1608Metric; MPN 150060GS75000
J16: Conn_01x04; PinSocket_1x04_P2.54mm_Vertical
JP4: SolderJumper_2_Open; SolderJumper-2_P1.3mm_Open_RoundedPad1.0x1.5mm
R67: 10 (1206); R_1206_3216Metric; MPN ESR18EZPF10R0; LCSC C17903
R68, R69, R70, R74, R75: 10k; R_0603_1608Metric; MPN RMCF0603FT10K0; LCSC C13564
R71, R72, R73: 3.0k; R_0603_1608Metric; MPN RMCF0603FT3K00; LCSC C4211
R76, R78: 1k; R_0603_1608Metric; MPN RMCF0603FT1K00; LCSC C13163
R77, R79, R80, R81, R83: 100k; R_0603_1608Metric; MPN RMCF0603FT100K; LCSC C14675
R82: 4.7M; R_0603_1608Metric; MPN RMCF0603FT4M70
TP39, TP40, TP41, TP42, TP43, TP44: TestPoint; TestPoint_Pad_1.0x1.0mm
U13: TLV1704; TSSOP-14_4.4x5mm_P0.65mm; MPN TLV1704AQPWRQ1; LCSC C181596

Connections:
+5V_Perif: D7.2 (A), J16.1, J16.2; also elsewhere on the board
/Peripheral_Subsystem/WD_Peripheral/WDT-VIN: C56.1, R67.2, R68.1, R77.1, R83.2, TP39.1, U13.3 (V+)
/Peripheral_Subsystem/WD_Peripheral/WDT-VP: R71.2, R72.1, U13.5 (+)
GND: C56.2, C58.1, C59.1, C60.1, C61.1, D8.1 (K), J16.3, J16.4, R72.2, R74.2, U13.12 (V-); also elsewhere on the board
unnamed: C57.2, R74.1, R75.1
unnamed: D7.1 (K), R67.1
unnamed: D8.2 (A), R73.2
unnamed: D9.2 (A), R80.1
unnamed: D9.1 (K), R81.2, R82.1, R83.1, TP43.1, U13.11 (+), U13.14
unnamed: JP4.1 (A), TP44.1, U13.13
unnamed: R68.2, R69.1, R79.2
unnamed: R76.1, U13.2
unnamed: R78.1, U13.1
unnamed: R75.2, U13.4 (-)
unnamed: C58.2, R76.2, R77.2, TP41.1, U13.7 (+)
unnamed: R70.2, R71.1, U13.6 (-)
unnamed: R79.1, R81.1, U13.9 (+)
unnamed: C59.2, C60.2, R78.2, R80.2, R82.2, TP42.1, U13.8 (-)
unnamed: C61.2, R69.2, R70.1, U13.10 (-)
WDT_WDI_Perif: C57.1, R73.1, TP40.1; also elsewhere on the board
~PERIF_EN: JP4.2 (B); also elsewhere on the board

Notes on the sheet:
TLV1704AMPWPSEP is the radiation tolerant version. Use TLV1704AQPWRQ1 for non-flight C3 boards.
Oscillator
External Watch-Dog Timer
Disable shutdown during initial power up.
Pulse integrator
C112+C114 and R62+R63 set the WDT frequency
~ 24 s period (36 s on power up)
D5 and D7 MUST be 1N4151WS
Select 15V-25V on C21, C22, C23
Output buffer
WDT enabled when soldered
DC block and pulse detector
This watchdog is is pulled low at the load switch it is connected to; leave floating here.

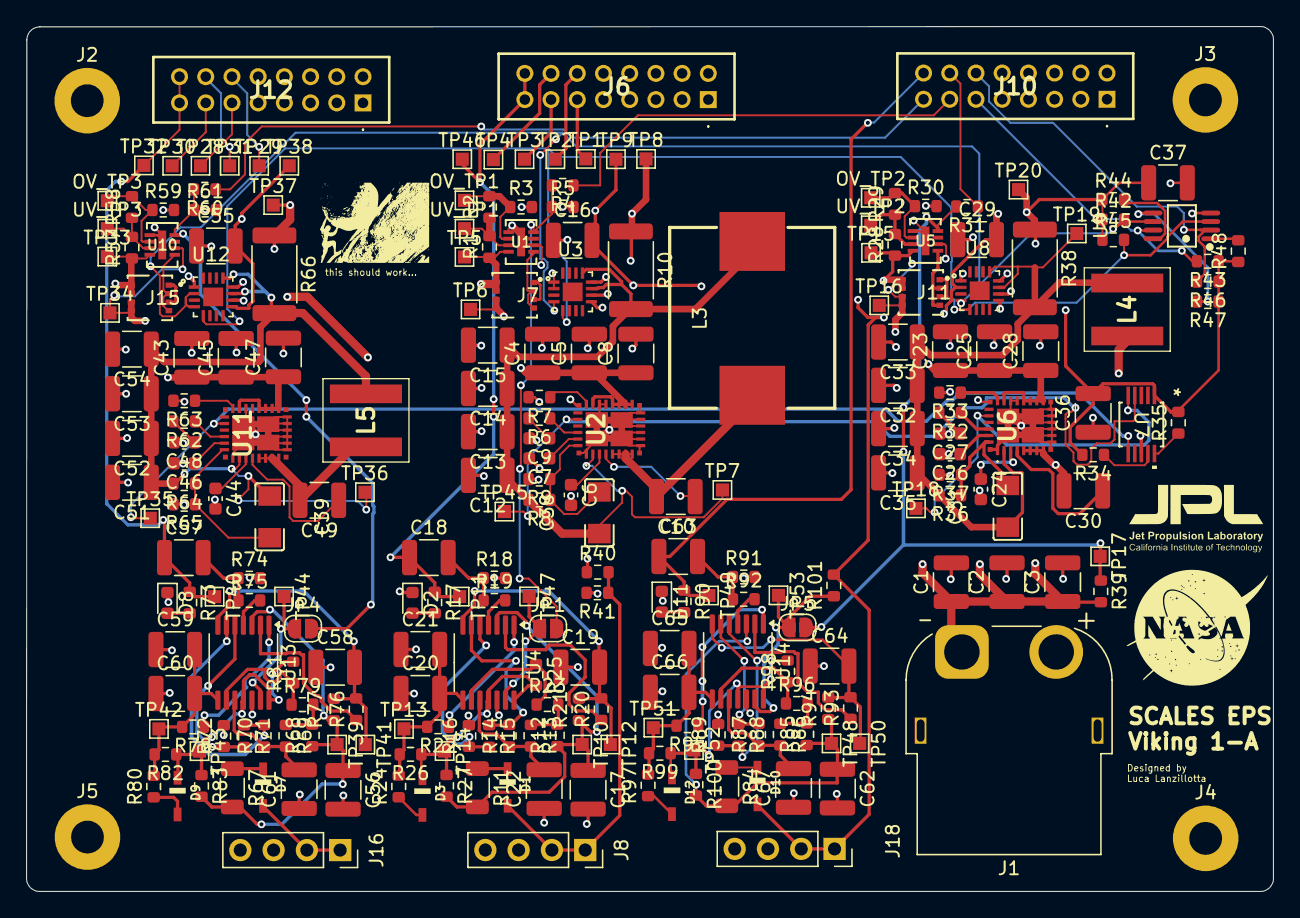
[picture p233: board EPS_Scales_RevC.kicad_pcb from above]

Board: 4 copper layers, 95.2 x 66.0 mm, 250 parts (0 on the bottom side), 128 nets.
