BroncoSpace-Lab/scales-hardware/power_system/EPS/EPS_Voyager_RevA/EPS_Voyager/EPS_Voyager.kicad_pcb

## KiCad design power_system/EPS/EPS_Voyager_RevA/EPS_Voyager/EPS_Voyager.kicad_pcb (2025-04-14)

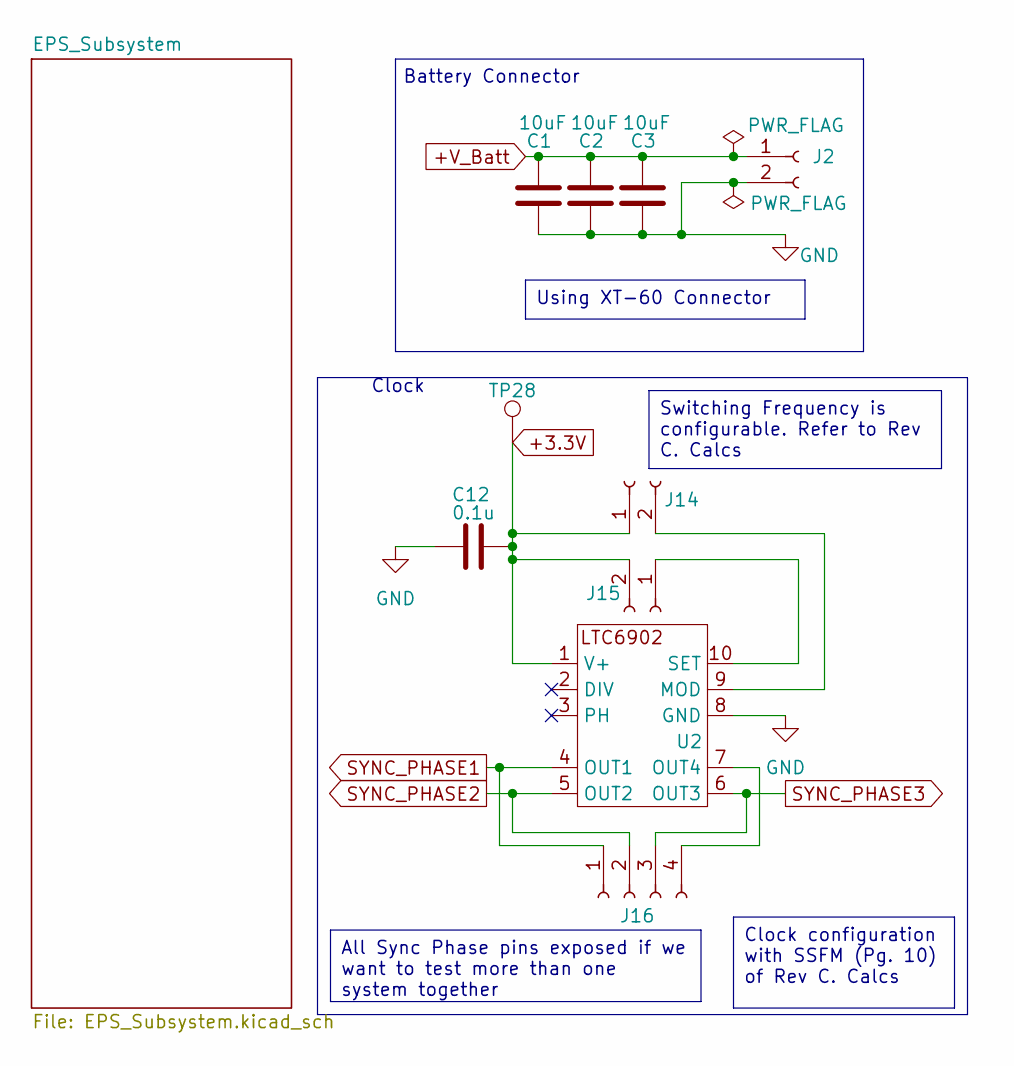
[picture p234: schematic EPS_Voyager.kicad_sch]

Parts:
C1, C2, C3: 10uF; C_1210_3225Metric
C12: 0.1u; C_1210_3225Metric
J2: Input Power; AMASS_XT60PW-F_1x02_P7.20mm_Horizontal
J14, J15: Conn_01x02_Socket; PinSocket_1x02_P2.54mm_Vertical
J16: Conn_01x04_Socket; PinSocket_1x04_P2.54mm_Vertical
TP28: TestPoint; TestPoint_Pad_1.0x1.0mm
U2: LTC6902

Connections:
+3.3V: C12.2, J14.1, J15.2, TP28.1, U2.1 (V+); also elsewhere on the board
+V_Batt: C1.1, C2.1, C3.1, J2.1; also elsewhere on the board
GND: C1.2, C2.2, C3.2, C12.1, J2.2, U2.8 (GND); also elsewhere on the board
unnamed: J14.2, U2.9 (MOD)
unnamed: J15.1, U2.10 (SET)
unnamed: J16.4, U2.7 (OUT4)
SYNC_PHASE1: J16.1, U2.4 (OUT1)
SYNC_PHASE2: J16.2, U2.5 (OUT2)
SYNC_PHASE3: J16.3, U2.6 (OUT3)

Notes on the sheet:
Clock
Battery Connector
Switching Frequency is configurable. Refer to Rev C. Calcs
Clock configuration with SSFM (Pg. 10) of Rev C. Calcs
Using XT-60 Connector
All Sync Phase pins exposed if we want to test more than one system together
