BroncoSpace-Lab/scales-hardware/power_system/EPS/EPS_Voyager_RevA/EPS_Voyager/EPS_Voyager.kicad_pcb

## KiCad design power_system/EPS/EPS_Voyager_RevA/EPS_Voyager/EPS_Voyager.kicad_pcb (continued)

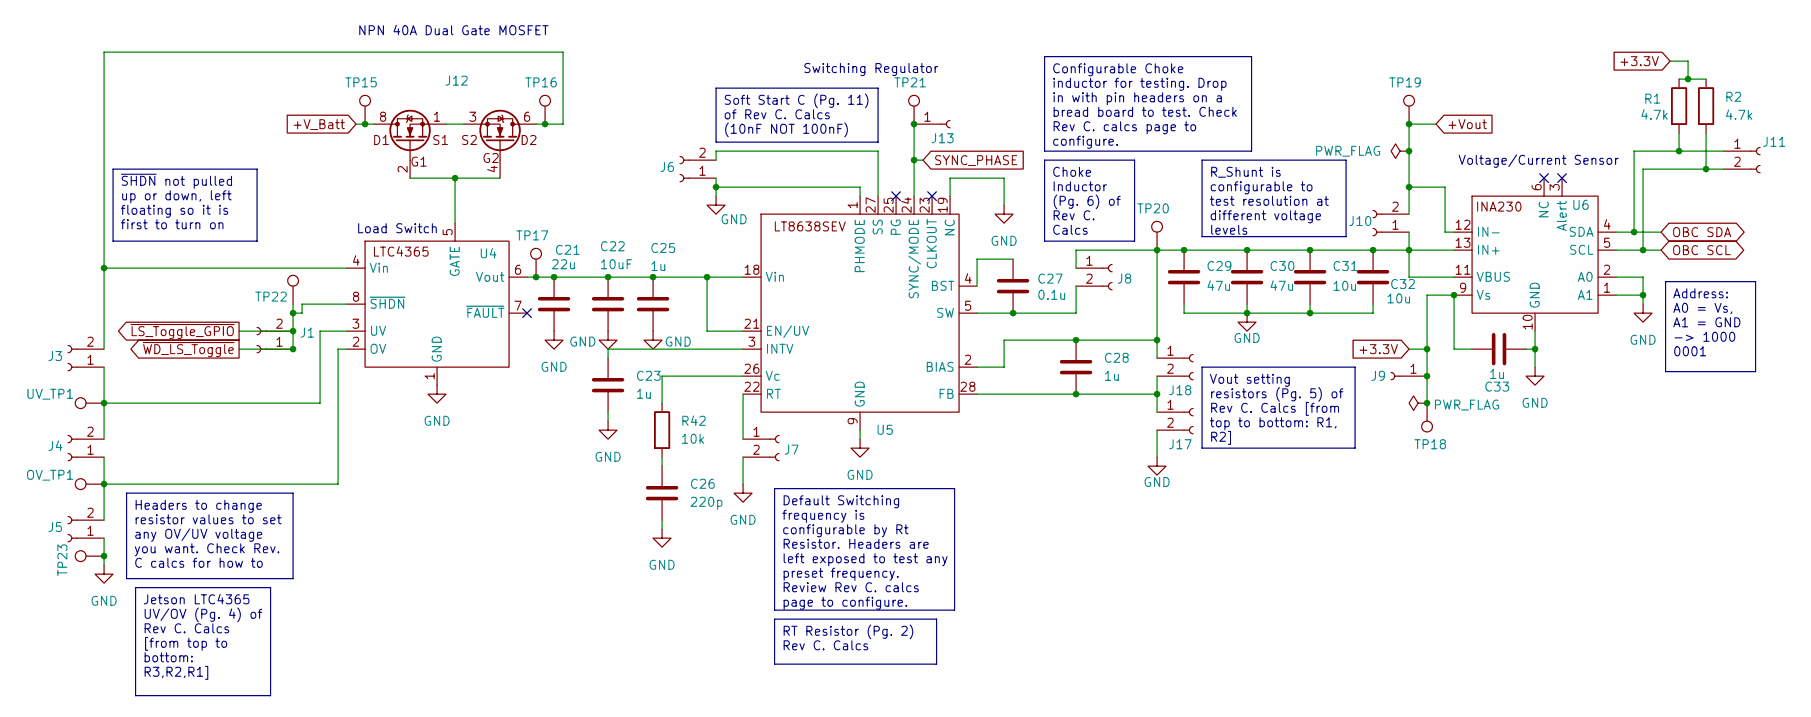
[picture p235: schematic EPS_Subsystem.kicad_sch]

Parts:
C21: 22u; C_1210_3225Metric
C22: 10uF; C_1210_3225Metric
C23, C25, C28, C33: 1u; C_1210_3225Metric
C26: 220p; C_1210_3225Metric
C27: 0.1u; C_1210_3225Metric
C29, C30: 47u; C_1210_3225Metric
C31, C32: 10u; C_1210_3225Metric
J1, J3, J4, J5, J6, J7, J8, J10, J11, J17, J18: Conn_01x02_Socket; PinSocket_1x02_P2.54mm_Vertical
J9, J13: Conn_01x01_Socket; PinSocket_1x01_P2.54mm_Vertical
J12: SISB46DN-T1-GE3
OV_TP1: TestPoint; TestPoint_Pad_1.0x1.0mm
R1, R2: 4.7k; R_0603_1608Metric
R42: 10k; R_0603_1608Metric
TP15, TP16, TP17, TP18, TP19, TP20, TP21, TP22, TP23: TestPoint; TestPoint_Pad_1.0x1.0mm
U4: LTC4365
U5: LT8638SEVPBF
U6: INA230; INA230AIRGTT
UV_TP1: TestPoint; TestPoint_Pad_1.0x1.0mm

Connections:
+3.3V: C33.2, J9.1, R1.1, R2.1, TP18.1, U6.9 (Vs); also elsewhere on the board
+V_Batt: J12.7, J12.8, TP15.1; also elsewhere on the board
+Vout: J10.2, TP19.1, U6.12 (IN-)
GND: C21.2, C22.2, C23.2, C25.2, C26.2, C29.2, C30.2, C31.2, C32.2, C33.1, J5.1, J6.1, J7.2, J17.2, TP23.1, U4.1 (GND), U5.1 (PHMODE), U5.9 (GND), U5.19 (NC), U6.1 (A1), U6.2 (A0), U6.10 (GND); also elsewhere on the board
unnamed: C26.1, R42.2
unnamed: J3.1, J4.2, U4.3 (UV), UV_TP1.1
unnamed: J3.2, J12.5, J12.6, TP16.1, U4.4 (Vin)
unnamed: J4.1, J5.2, OV_TP1.1, U4.2 (OV)
unnamed: J6.2, U5.27 (SS)
unnamed: J7.1, U5.22 (RT)
unnamed: C27.2, J8.2, U5.5 (SW)
unnamed: C28.1, C29.1, C30.1, C31.1, C32.1, J8.1, J10.1, J18.1, TP20.1, U5.2 (BIAS), U6.11 (VBUS), U6.13 (IN+)
unnamed: J12.1, J12.3
unnamed: C28.2, J17.1, J18.2, U5.28 (FB)
unnamed: J12.2, J12.4, U4.5 (GATE)
unnamed: C21.1, C22.1, C25.1, TP17.1, U4.6 (Vout), U5.18 (Vin), U5.21 (EN/UV)
unnamed: C27.1, U5.4 (BST)
unnamed: C23.1, U5.3 (INTV)
unnamed: R42.1, U5.26 (Vc)
OBC SCL: J11.2, R2.2, U6.5 (SCL)
OBC SDA: J11.1, R1.2, U6.4 (SDA)
SYNC_PHASE: J13.1, TP21.1, U5.24 (SYNC/MODE)
~LS_Toggle_GPIO: J1.1, J1.2, TP22.1, U4.8 (~SHDN)

Notes on the sheet:
Switching Regulator
NPN 40A Dual Gate MOSFET
Voltage/Current Sensor
Load Switch
RT Resistor (Pg. 2) Rev C. Calcs
Soft Start C (Pg. 11) of Rev C. Calcs (10nF NOT 100nF)
Headers to change resistor values to set any OV/UV voltage you want. Check Rev. C calcs for how to
R_Shunt is configurable to test resolution at different voltage levels
Configurable Choke inductor for testing. Drop in with pin headers on a bread board to test. Check Rev C. calcs page to configure.
Address: A0 = Vs, A1 = GND -> 1000 0001
Vout setting resistors (Pg. 5) of Rev C. Calcs [from top to bottom: R1, R2]
Choke Inductor (Pg. 6) of Rev C. Calcs
Jetson LTC4365 UV/OV (Pg. 4) of Rev C. Calcs [from top to bottom: R3,R2,R1]
~{SHDN} not pulled up or down, left floating so it is first to turn on
Default Switching frequency is configurable by Rt Resistor. Headers are left exposed to test any preset frequency. Review Rev C. calcs page to configure.

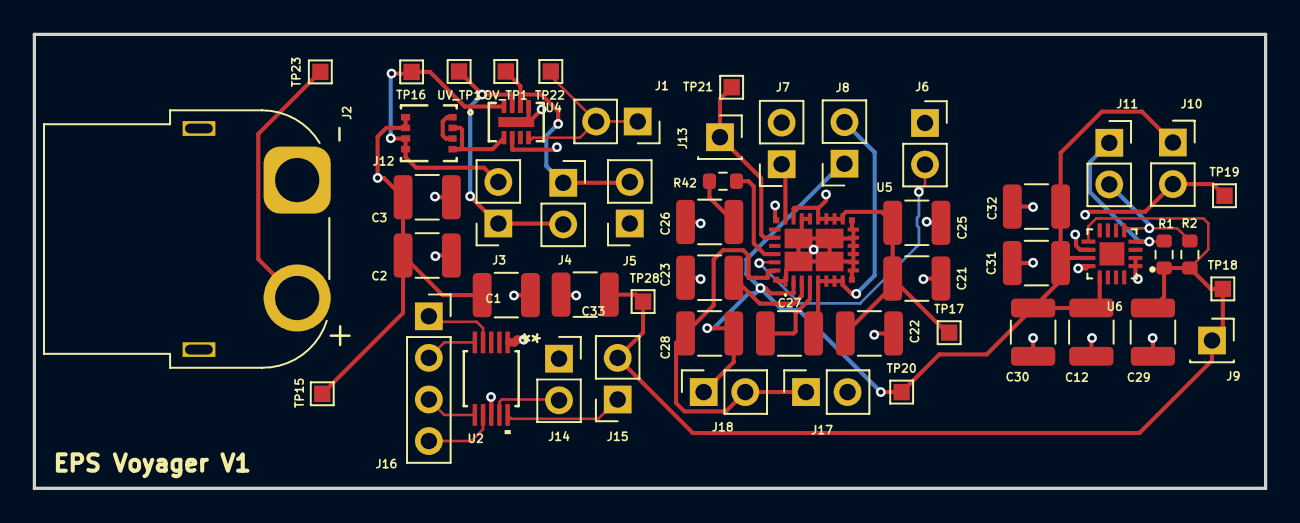
[picture p236: board EPS_Voyager.kicad_pcb from above]

Board: 4 copper layers, 75.2 x 27.7 mm, 53 parts (0 on the bottom side), 29 nets.
