BroncoSpace-Lab/scales-hardware/rad_tolerant_watchdog/RTW_production_pathfinder_V1/RTW_production_pathfinder_V1.kicad_pcb

## KiCad design rad_tolerant_watchdog/RTW_production_pathfinder_V1/RTW_production_pathfinder_V1.kicad_pcb (2025-03-31)

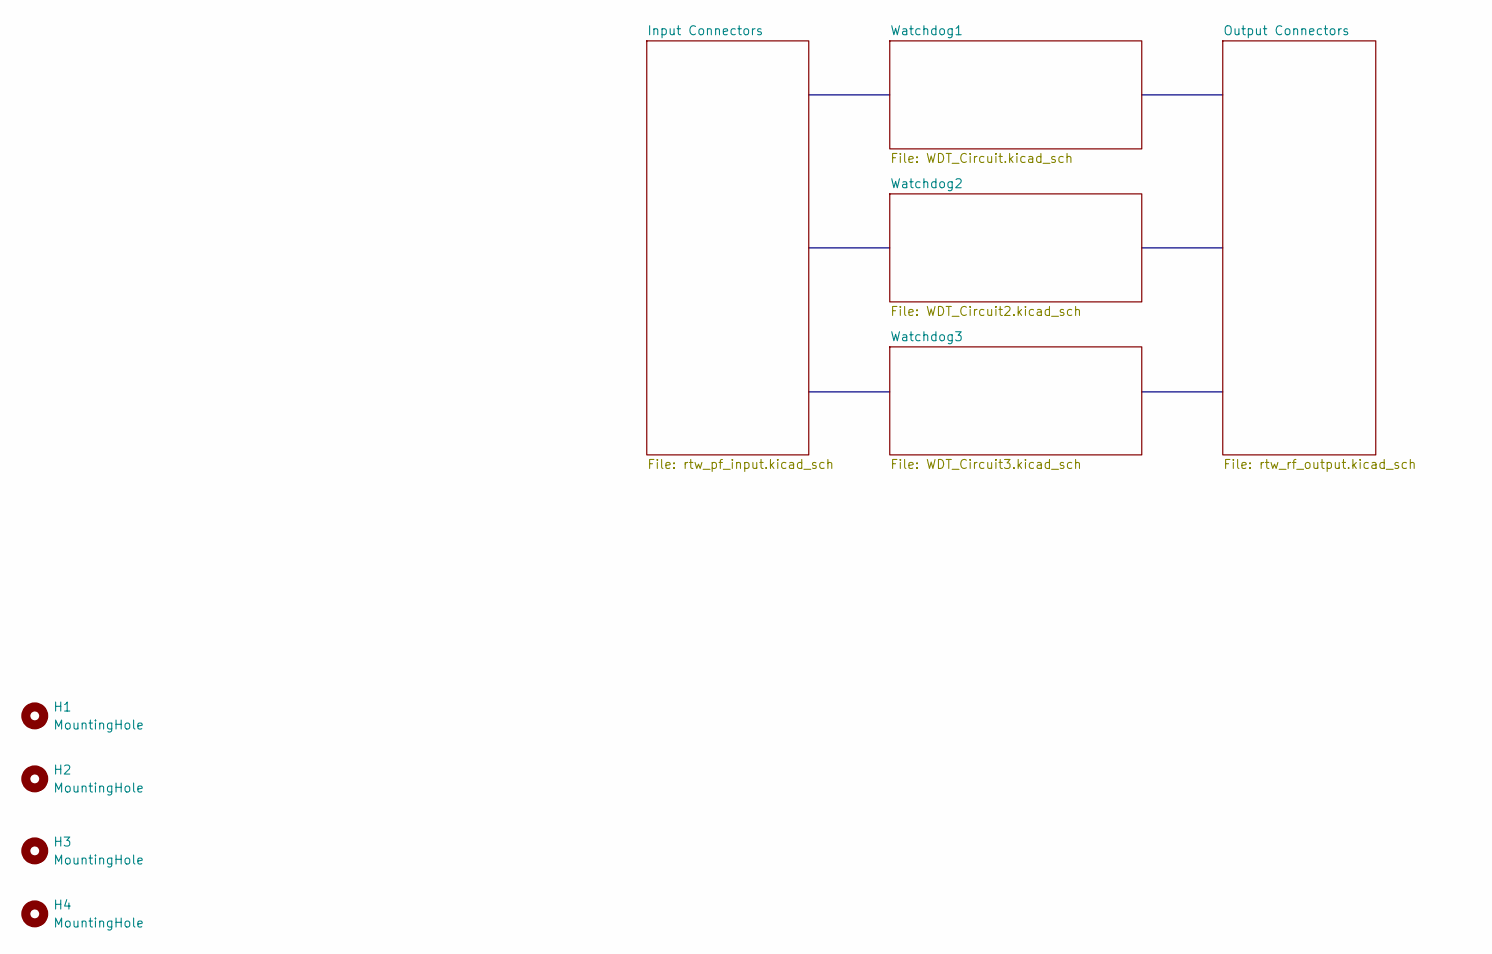
[picture p237: schematic RTW_production_pathfinder_V1.kicad_sch]

Parts:
H1, H2, H3, H4: MountingHole; MountingHole_2.2mm_M2_DIN965_Pad

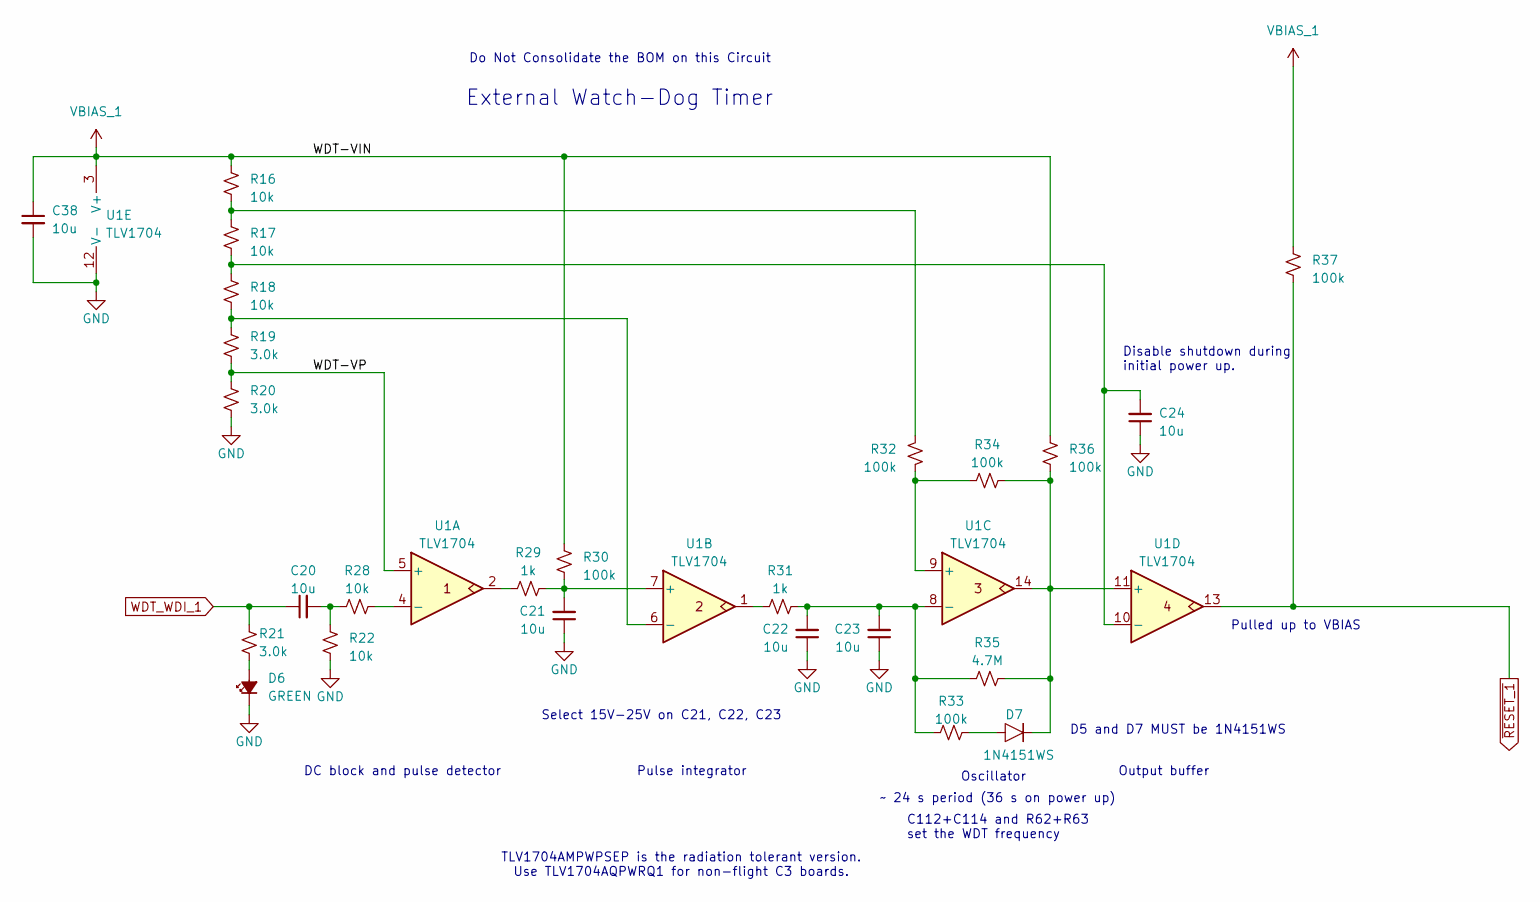
[picture p238: schematic WDT_Circuit.kicad_sch]

Parts:
C20, C21, C22, C23, C24, C38: 10u; C_0603_1608Metric; MPN GRT188R61C106KE13D
D6: GREEN; LED_0603_1608Metric; MPN 150060GS75000
D7: 1N4151WS; D_SOD-323; MPN 1N4151WS-E3-08
R16, R17, R18, R22, R28: 10k; R_0603_1608Metric; MPN RMCF0603FT10K0
R19, R20, R21: 3.0k; R_0603_1608Metric; MPN RMCF0603FT3K00
R29, R31: 1k; R_0603_1608Metric; MPN RMCF0603FT1K00
R30, R32, R33, R34, R36, R37: 100k; R_0603_1608Metric; MPN RMCF0603FT100K
R35: 4.7M; R_0603_1608Metric; MPN RMCF0603FT4M70
U1: TLV1704; TSSOP-14_4.4x5mm_P0.65mm; MPN TLV1704AQPWRQ1

Connections:
/Watchdog1/WDT-VP: R19.2, R20.1, U1.5 (+)
GND: C21.1, C22.1, C23.1, C24.1, C38.2, D6.1 (K), R20.2, R22.2, U1.12 (V-); also elsewhere on the board
unnamed: C20.2, R22.1, R28.1
unnamed: D6.2 (A), R21.2
unnamed: D7.2, R33.1
unnamed: R16.2, R17.1, R32.2
unnamed: R29.1, U1.2
unnamed: R31.1, U1.1
unnamed: R28.2, U1.4 (-)
unnamed: C21.2, R29.2, R30.2, U1.7 (+)
unnamed: R18.2, R19.1, U1.6 (-)
unnamed: R32.1, R34.1, U1.9 (+)
unnamed: C22.2, C23.2, R31.2, R33.2, R35.2, U1.8 (-)
unnamed: D7.1, R34.2, R35.1, R36.1, U1.11 (+), U1.14
unnamed: C24.2, R17.2, R18.1, U1.10 (-)
VBIAS_1: C38.1, R16.1, R30.1, R36.2, R37.2, U1.3 (V+); also elsewhere on the board
WDT_WDI_1: C20.1, R21.1; also elsewhere on the board
~RESET_1: R37.1, U1.13; also elsewhere on the board

Notes on the sheet:
Pulled up to VBIAS
TLV1704AMPWPSEP is the radiation tolerant version. Use TLV1704AQPWRQ1 for non-flight C3 boards.
~ 24 s period (36 s on power up)
Do Not Consolidate the BOM on this Circuit
Select 15V-25V on C21, C22, C23
Disable shutdown during initial power up.
Pulse integrator
External Watch-Dog Timer
DC block and pulse detector
D5 and D7 MUST be 1N4151WS
Oscillator
Output buffer
C112+C114 and R62+R63 set the WDT frequency

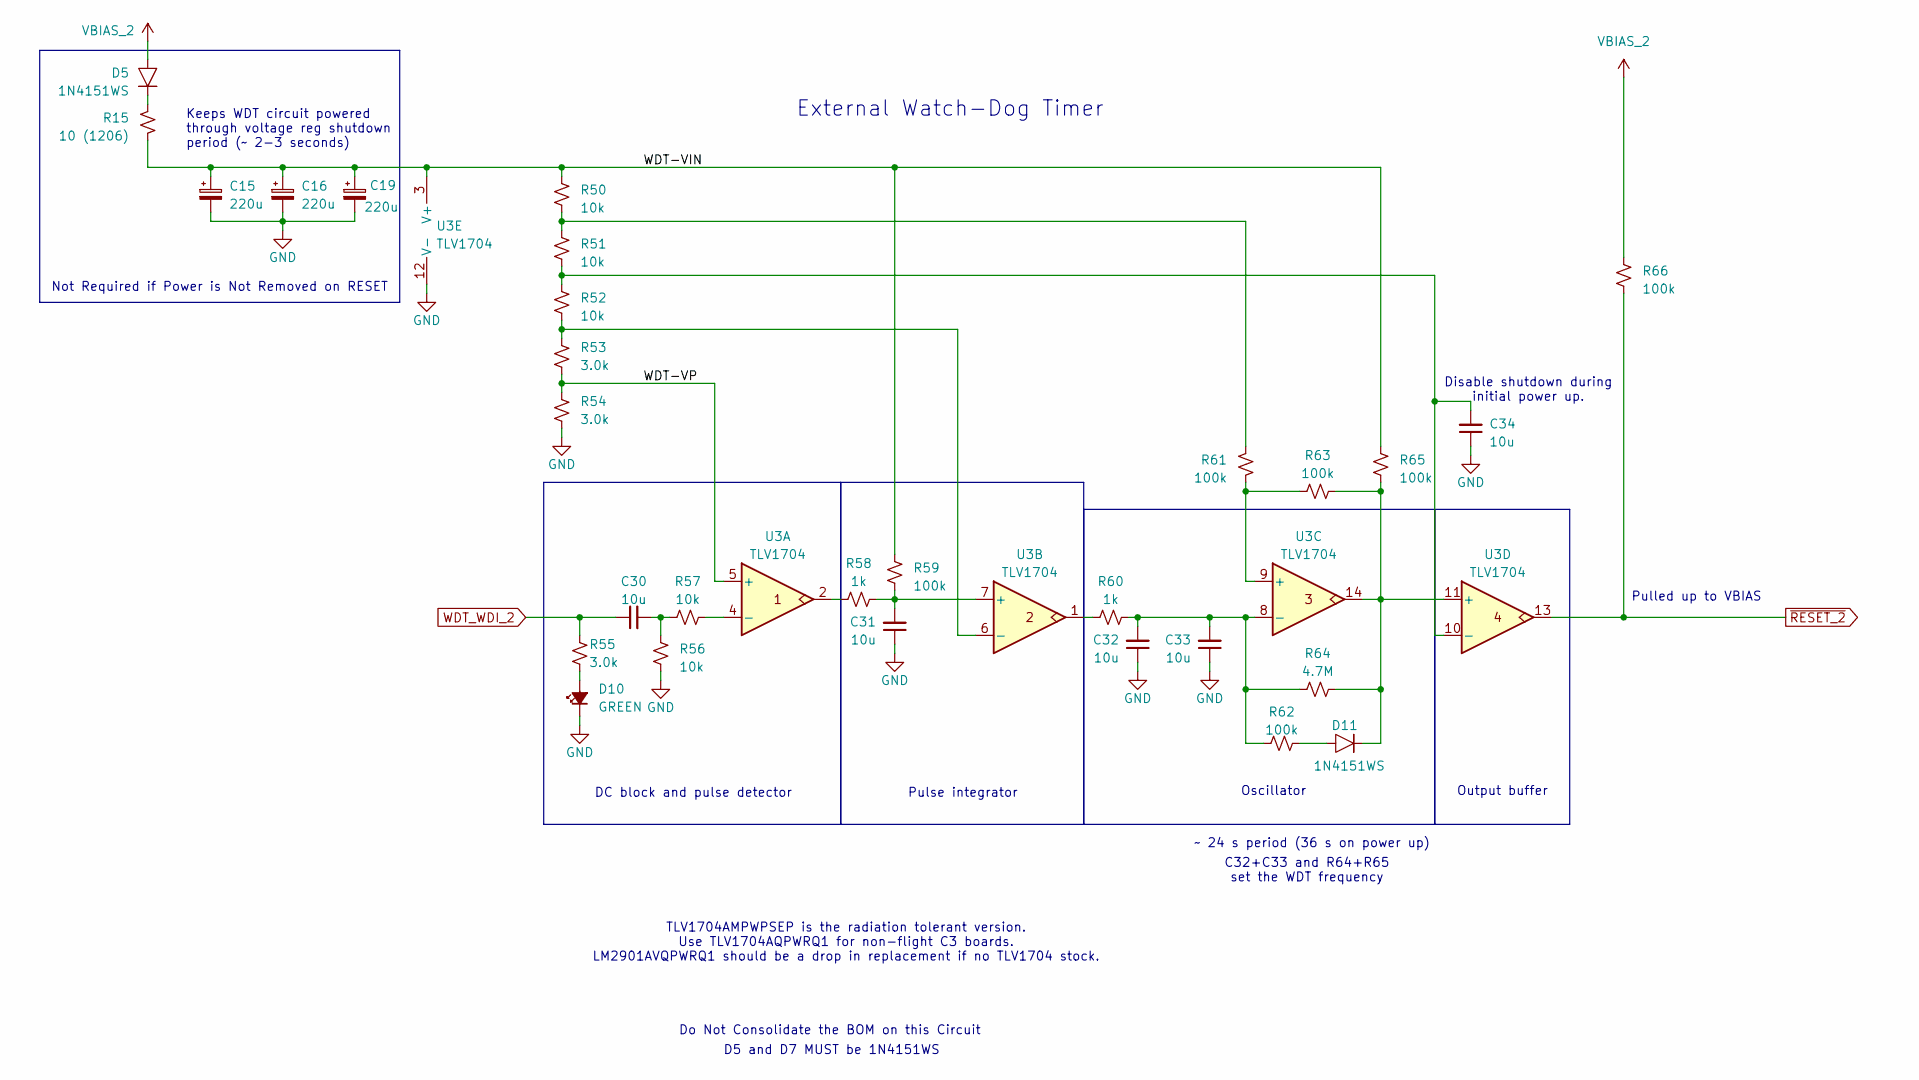
[picture p239: schematic WDT_Circuit2.kicad_sch]

Parts:
C15, C16, C19: 220u; CP_EIA-7361-38_AVX-V; MPN TCN4227M025R0100
C30, C31, C32, C33, C34: 10u; C_0603_1608Metric; MPN GRT188R61C106KE13D
D5, D11: 1N4151WS; D_SOD-323; MPN 1N4151WS-E3-08
D10: GREEN; LED_0603_1608Metric; MPN 150060GS75000
R15: 10 (1206); R_1206_3216Metric; MPN ESR18EZPF10R0
R50, R51, R52, R56, R57: 10k; R_0603_1608Metric; MPN RMCF0603FT10K0
R53, R54, R55: 3.0k; R_0603_1608Metric; MPN RMCF0603FT3K00
R58, R60: 1k; R_0603_1608Metric; MPN RMCF0603FT1K00
R59, R61, R62, R63, R65, R66: 100k; R_0603_1608Metric; MPN RMCF0603FT100K
R64: 4.7M; R_0603_1608Metric; MPN RMCF0603FT4M70
U3: TLV1704; TSSOP-14_4.4x5mm_P0.65mm; MPN TLV1704AQPWRQ1

Connections:
/Watchdog2/WDT-VIN: C15.1, C16.1, C19.1, R15.2, R50.1, R59.1, R65.2, U3.3 (V+)
/Watchdog2/WDT-VP: R53.2, R54.1, U3.5 (+)
GND: C15.2, C16.2, C19.2, C31.1, C32.1, C33.1, C34.1, D10.1 (K), R54.2, R56.2, U3.12 (V-); also elsewhere on the board
unnamed: C30.2, R56.1, R57.1
unnamed: D5.1, R15.1
unnamed: D10.2 (A), R55.2
unnamed: D11.2, R62.1
unnamed: R50.2, R51.1, R61.2
unnamed: R58.1, U3.2
unnamed: R60.1, U3.1
unnamed: R57.2, U3.4 (-)
unnamed: C31.2, R58.2, R59.2, U3.7 (+)
unnamed: R52.2, R53.1, U3.6 (-)
unnamed: R61.1, R63.1, U3.9 (+)
unnamed: C32.2, C33.2, R60.2, R62.2, R64.2, U3.8 (-)
unnamed: D11.1, R63.2, R64.1, R65.1, U3.11 (+), U3.14
unnamed: C34.2, R51.2, R52.1, U3.10 (-)
VBIAS_2: D5.2, R66.2; also elsewhere on the board
WDT_WDI_2: C30.1, R55.1; also elsewhere on the board
~RESET_2: R66.1, U3.13; also elsewhere on the board

Notes on the sheet:
Not Required if Power is Not Removed on RESET
Pulled up to VBIAS
TLV1704AMPWPSEP is the radiation tolerant version. Use TLV1704AQPWRQ1 for non-flight C3 boards. LM2901AVQPWRQ1 should be a drop in replacement if no TLV1704 stock.
~ 24 s period (36 s on power up)
Do Not Consolidate the BOM on this Circuit
Disable shutdown during initial power up.
Pulse integrator
External Watch-Dog Timer
Keeps WDT circuit powered through voltage reg shutdown period (~ 2-3 seconds)
DC block and pulse detector
D5 and D7 MUST be 1N4151WS
Oscillator
Output buffer
C32+C33 and R64+R65 set the WDT frequency

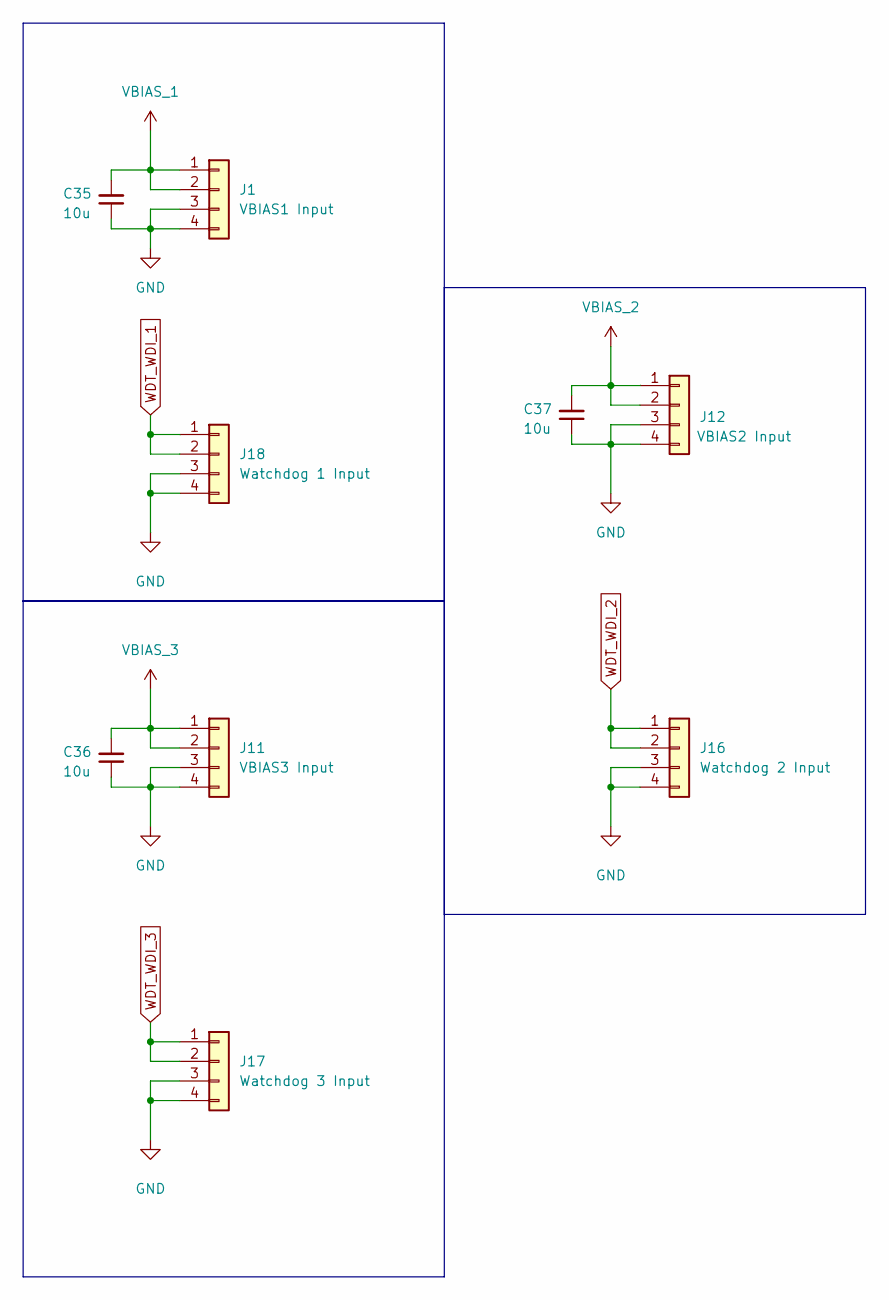
[picture p240: schematic rtw_pf_input.kicad_sch]

Parts:
C35, C36, C37: 10u; C_0603_1608Metric; MPN GRT188R61C106KE13D
J1: VBIAS1 Input; PinHeader_1x04_P2.54mm_Vertical
J11: VBIAS3 Input; PinHeader_1x04_P2.54mm_Vertical
J12: VBIAS2 Input; PinHeader_1x04_P2.54mm_Vertical
J16: Watchdog 2 Input; PinHeader_1x04_P2.54mm_Vertical
J17: Watchdog 3 Input; PinHeader_1x04_P2.54mm_Vertical
J18: Watchdog 1 Input; PinHeader_1x04_P2.54mm_Vertical

Connections:
GND: C35.1, C36.1, C37.1, J1.3, J1.4, J11.3, J11.4, J12.3, J12.4, J16.3, J16.4, J17.3, J17.4, J18.3, J18.4; also elsewhere on the board
VBIAS_1: C35.2, J1.1, J1.2; also elsewhere on the board
VBIAS_2: C37.2, J12.1, J12.2; also elsewhere on the board
VBIAS_3: C36.2, J11.1, J11.2; also elsewhere on the board
WDT_WDI_1: J18.1, J18.2; also elsewhere on the board
WDT_WDI_2: J16.1, J16.2; also elsewhere on the board
WDT_WDI_3: J17.1, J17.2; also elsewhere on the board

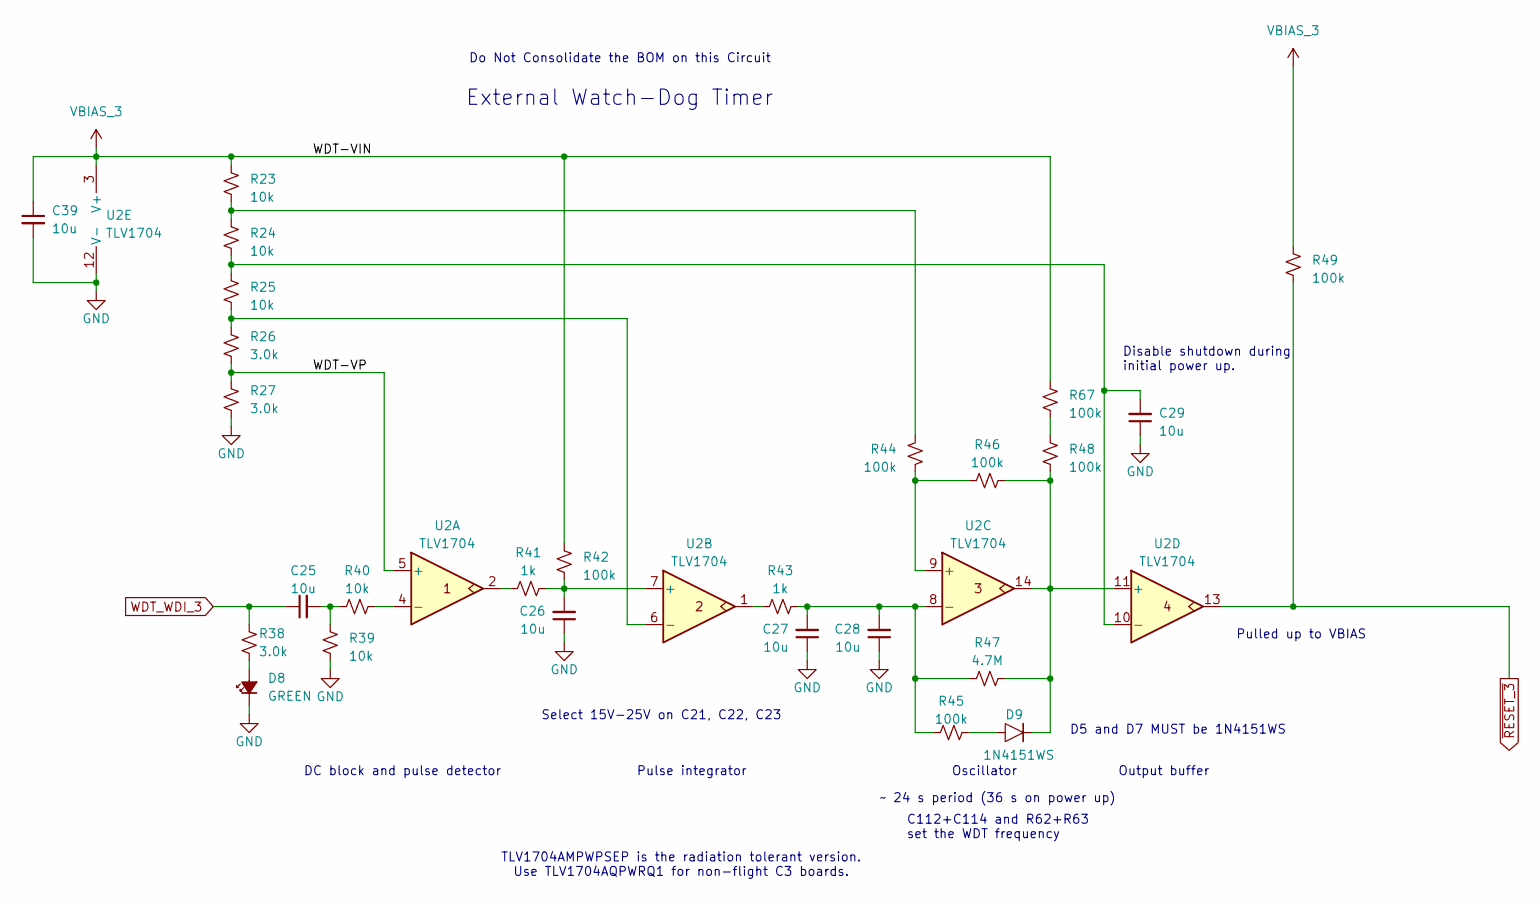
[picture p241: schematic WDT_Circuit3.kicad_sch]

Parts:
C25, C26, C27, C28, C29, C39: 10u; C_0603_1608Metric; MPN GRT188R61C106KE13D
D8: GREEN; LED_0603_1608Metric; MPN 150060GS75000
D9: 1N4151WS; D_SOD-323; MPN 1N4151WS-E3-08
R23, R24, R25, R39, R40: 10k; R_0603_1608Metric; MPN RMCF0603FT10K0
R26, R27, R38: 3.0k; R_0603_1608Metric; MPN RMCF0603FT3K00
R41, R43: 1k; R_0603_1608Metric; MPN RMCF0603FT1K00
R42, R44, R45, R46, R48, R49, R67: 100k; R_0603_1608Metric; MPN RMCF0603FT100K
R47: 4.7M; R_0603_1608Metric; MPN RMCF0603FT4M70
U2: TLV1704; TSSOP-14_4.4x5mm_P0.65mm; MPN TLV1704AQPWRQ1

Connections:
/Watchdog3/WDT-VP: R26.2, R27.1, U2.5 (+)
GND: C26.1, C27.1, C28.1, C29.1, C39.2, D8.1 (K), R27.2, R39.2, U2.12 (V-); also elsewhere on the board
unnamed: C25.2, R39.1, R40.1
unnamed: D8.2 (A), R38.2
unnamed: D9.2, R45.1
unnamed: R23.2, R24.1, R44.2
unnamed: R41.1, U2.2
unnamed: R43.1, U2.1
unnamed: R48.2, R67.1
unnamed: R40.2, U2.4 (-)
unnamed: C26.2, R41.2, R42.2, U2.7 (+)
unnamed: R25.2, R26.1, U2.6 (-)
unnamed: R44.1, R46.1, U2.9 (+)
unnamed: C27.2, C28.2, R43.2, R45.2, R47.2, U2.8 (-)
unnamed: D9.1, R46.2, R47.1, R48.1, U2.11 (+), U2.14
unnamed: C29.2, R24.2, R25.1, U2.10 (-)
VBIAS_3: C39.1, R23.1, R42.1, R49.2, R67.2, U2.3 (V+); also elsewhere on the board
WDT_WDI_3: C25.1, R38.1; also elsewhere on the board
~RESET_3: R49.1, U2.13; also elsewhere on the board

Notes on the sheet:
TLV1704AMPWPSEP is the radiation tolerant version. Use TLV1704AQPWRQ1 for non-flight C3 boards.
~ 24 s period (36 s on power up)
Do Not Consolidate the BOM on this Circuit
Select 15V-25V on C21, C22, C23
Disable shutdown during initial power up.
Pulse integrator
External Watch-Dog Timer
DC block and pulse detector
D5 and D7 MUST be 1N4151WS
Oscillator
Output buffer
C112+C114 and R62+R63 set the WDT frequency
Pulled up to VBIAS

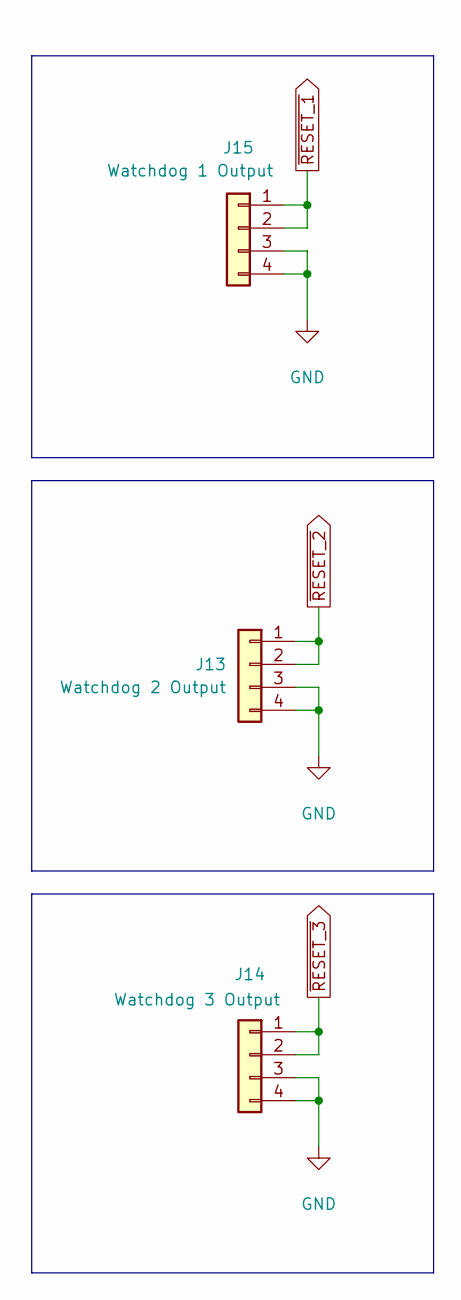
[picture p242: schematic rtw_rf_output.kicad_sch]

Parts:
J13: Watchdog 2 Output; PinHeader_1x04_P2.54mm_Vertical
J14: Watchdog 3 Output; PinHeader_1x04_P2.54mm_Vertical
J15: Watchdog 1 Output; PinHeader_1x04_P2.54mm_Vertical

Connections:
GND: J13.3, J13.4, J14.3, J14.4, J15.3, J15.4; also elsewhere on the board
~RESET_1: J15.1, J15.2; also elsewhere on the board
~RESET_2: J13.1, J13.2; also elsewhere on the board
~RESET_3: J14.1, J14.2; also elsewhere on the board

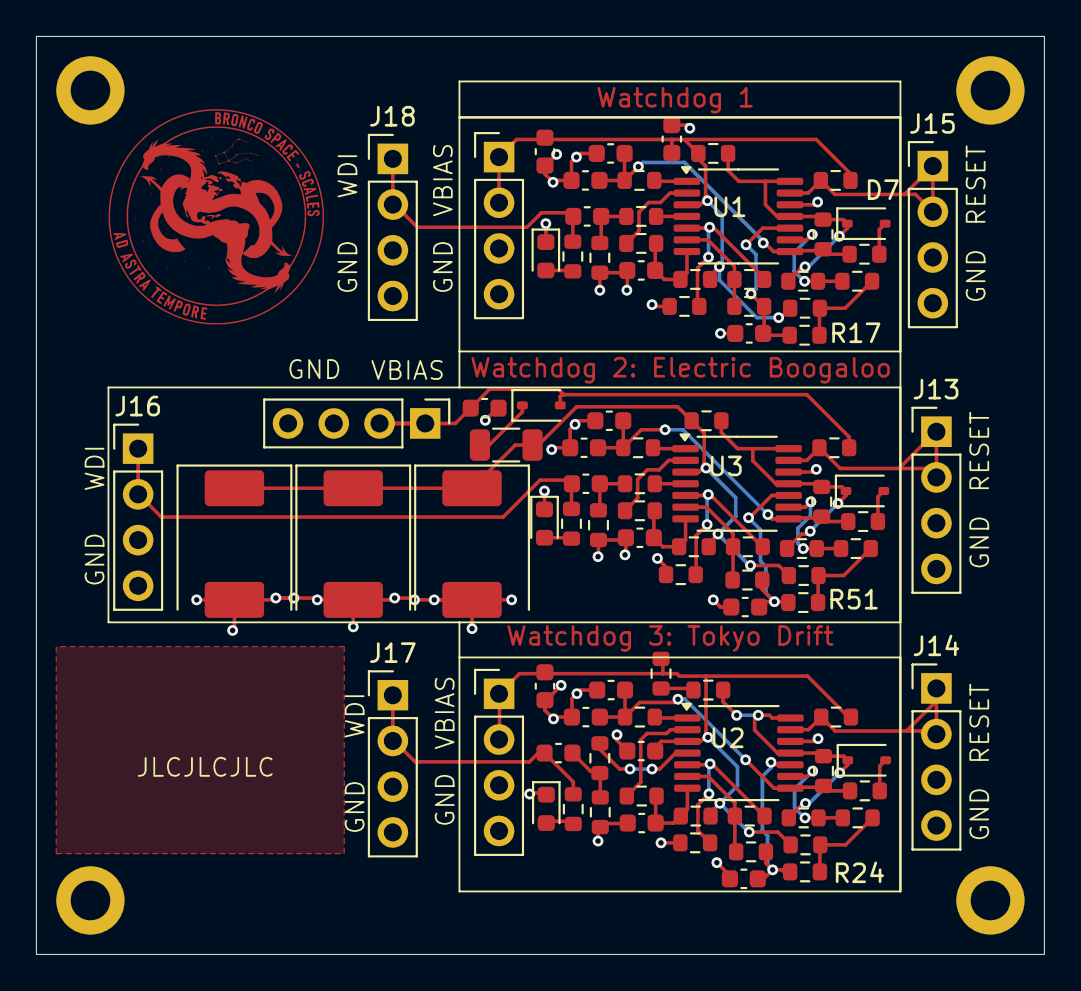
[picture p243: board RTW_production_pathfinder_V1.kicad_pcb from above]

Board: 2 copper layers, 56.0 x 51.0 mm, 99 parts (0 on the bottom side), 55 nets.
