BroncoSpace-Lab/scales-hardware/power_system/EPS/EPS_Scales_RevD/EPS_Scales_RevD.kicad_pcb

## KiCad design power_system/EPS/EPS_Scales_RevD/EPS_Scales_RevD.kicad_pcb (2025-06-11, an earlier design)

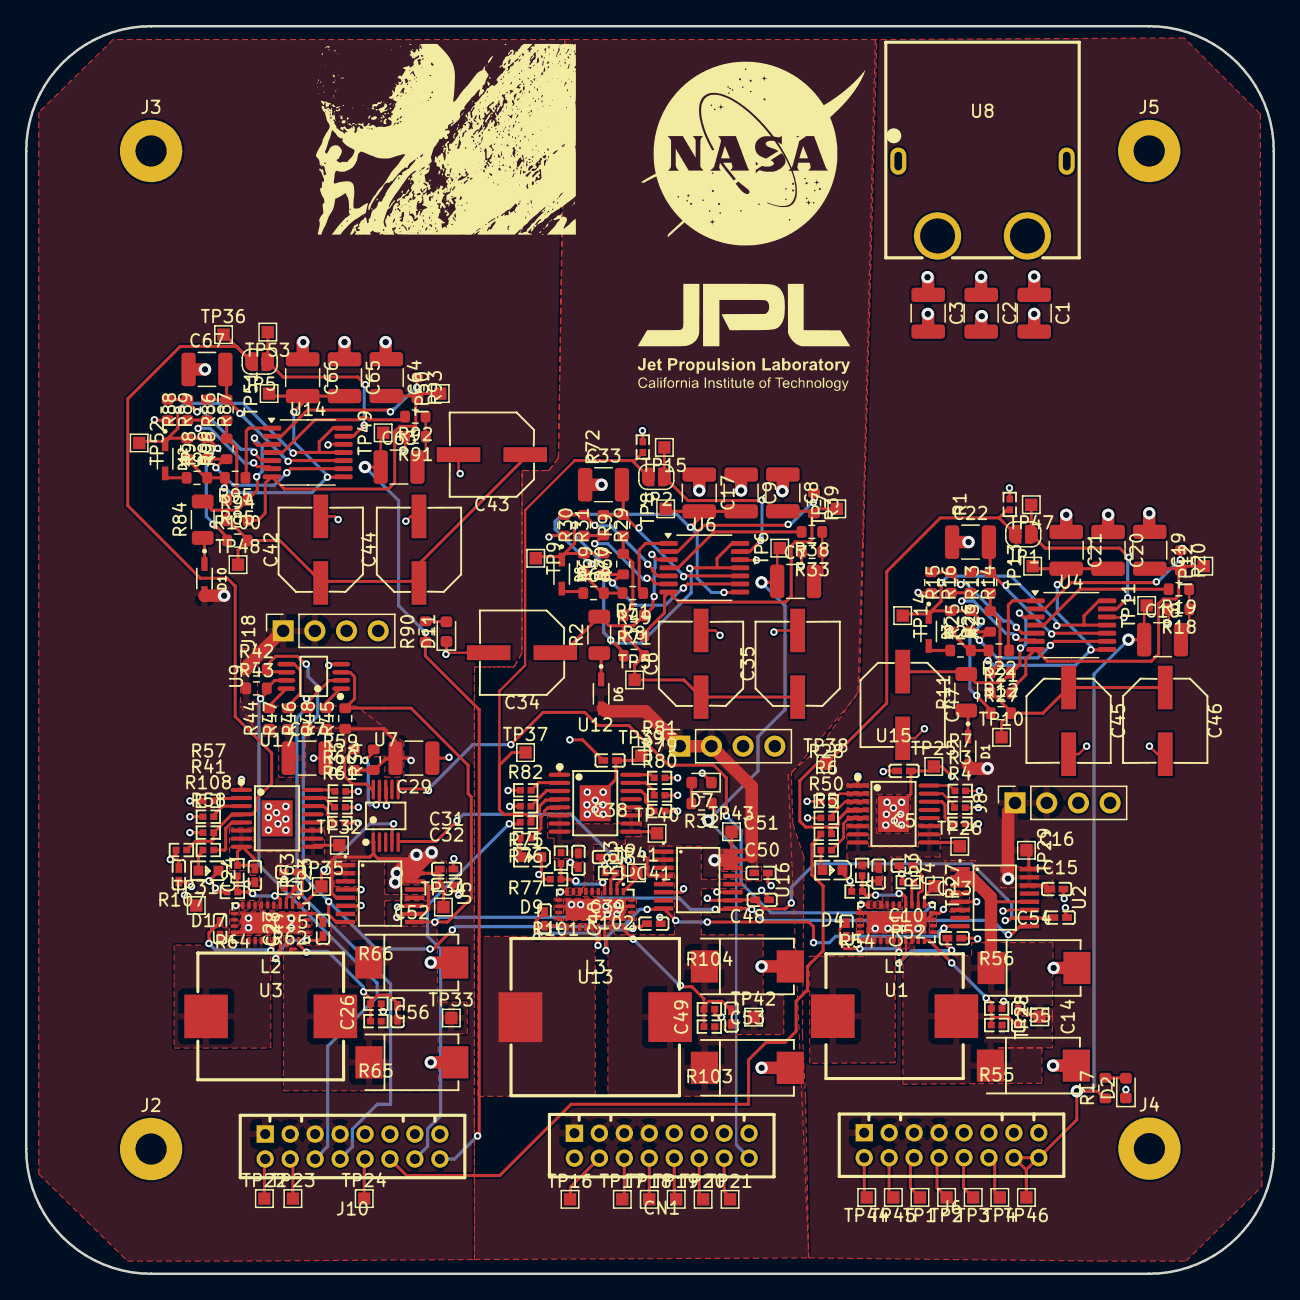
[picture p244: board EPS_Scales_RevD.kicad_pcb from above]

Board: 4 copper layers, 100.0 x 100.0 mm, 253 parts (0 on the bottom side), 139 nets.

Parts:
C1, C2, C3, C7, C8, C9, C17, C18, C19, C20, C21, C22, C33, C63, C64, C65, C66, C67: 10u; C_1210_3225Metric
C4, C23, C36: 22n; C0402
C5, C24, C38: 220n; C0402
C6, C34, C35, C42, C43, C44, C45, C46, C47: 220u; CAP-SMD_BD6.3-L6.6-W6.6-FD
C10: 10n; C0402
C11, C13, C15, C16, C27, C28, C31, C32, C40, C41, C50, C51: 100n; C0402
C14, C26, C49: 10p; C0402
C25, C39: 2.2n; C0402
C29, C37: 0.1u; C_1210_3225Metric
C48, C52, C53, C54, C55, C56: 47u; CAP-SMD_L7.3-W4.3-FD
CN1: DF11-16DP-2DSA(08); CONN-TH_DF11-16DP-2DSA-08
D1, D3, D6, D8, D10, D12: 1N4151WS; SOD2512X116N
D2, D7, D11: GREEN; LED_0603_1608Metric
D4, D9, D17: LED; LED0603-RD_RED
J2, J3, J4, J5: Conn_01x01_Socket; MountingHole_2.5mm_Pad
J6, J10: DF11-16DP-2DSA; CONN-TH_DF11-16DP-2DSA-08
J7, J8, J18: Conn_01x04; PinSocket_1x04_P2.54mm_Vertical
JP1, JP2, JP5: SolderJumper_2_Open; SolderJumper-2_P1.3mm_Open_RoundedPad1.0x1.5mm
L1: 4.7u; IND-SMD_L11.0-W10.0
L2: 8.2u; IND-SMD_L11.5-W10.0
L3: 12u; IND-SMD_L13.5-W12.6
R1, R3, R4, R6, R7, R41, R50, R59, R60, R61, R72, R76, R79, R80, R81, R82: 15k; R0402
R2, R11, R84: 10 (1206); R_1206_3216Metric
R5, R58, R77: 220; R0402
R8, R9, R12, R13, R14, R18, R19, R29, R33, R38, R85, R86, R87, R91, R92: 10k; R_0603_1608Metric
R15, R16, R17, R30, R31, R32, R88, R89, R90: 3.0k; R_0603_1608Metric
R20, R22, R39, R51, R93, R95: 1k; R_0603_1608Metric
R21, R23, R24, R25, R27, R49, R67, R68, R69, R71, R94, R96, R97, R98, R100: 100k; R_0603_1608Metric
R26, R70, R99: 4.7M; R_0603_1608Metric
R28, R57, R75: 1k; R0402
R34: 14k; R_0603_1608Metric
R35: 17k; R_0603_1608Metric
R42, R43, R44, R45, R46, R47, R48: 4.7k; R_0603_1608Metric
R52, R62, R102: 110k; R0402
R53, R63, R83: 47k; R0402
R54, R64, R101: 2k; R0402
R55: 196k; R0402
R56, R66, R108: 10k; R0402
R65: 240k; R0402
R103: 20.8k; R0402
R104: 5k; R0402
R107: 56.2k; R0402
TP1, TP2, TP3, TP4, TP5, TP6, TP7, TP8, TP9, TP10, TP11, TP12, TP13, TP14, TP15, TP16, TP17, TP18, TP19, TP20, TP21, TP22, TP23, TP24, TP25, TP26, TP27, TP28, TP29, TP31, TP32, TP33, TP34, TP35, TP36, TP37, TP38, TP39, TP40, TP41, TP42, TP43, TP44, TP45, TP46, TP47, TP48, TP49, TP50, TP51, TP52, TP53: TestPoint; TestPoint_Pad_1.0x1.0mm
U1, U3, U13: LT8612EUDE#PBF; QFN-28_L6.0-W3.0-P0.50-BL-EP
U2, U5, U16: INA260AIPWR; TSSOP-16_L5.0-W4.4-P0.65-LS6.4-BL-1
U4, U6, U14: TLV1704; TSSOP-14_4.4x5mm_P0.65mm
U7: LTC6902; MSOP-10_L3.0-W3.0-P0.50-LS5.0-BL
U8: XT60PW-F_C428722; TH_2P-XT60PW-F
U9: TCA4307DGKR; VSSOP-8_L3.0-W3.0-P0.65-LS4.9-BL
U12, U15, U17: TPS1HB08BQPWPRQ1; HTSSOP-16_L5.0-W4.4-P0.65-LS6.4-TL-EP2.9

Connections:
+3.3V_OBC: C15.1, C29.2, C31.1, C32.1, C37.1, C50.1, D10.2 (A), J10.1, J10.3, J10.5, J10.7, J18.1, J18.2, R34.1, R35.1, R42.1, R43.1, R44.1, R45.1, R46.1, R47.1, R48.1, TP34.1, U2.10 (VS), U5.5 (A0), U5.10 (VS), U5.14 (IN-), U7.1 (V+), U16.4 (A1), U16.5 (A0), U16.10 (VS)
+5V_Perif: C51.1, CN1.1, CN1.3, CN1.5, CN1.7, D6.2 (A), J7.1, J7.2, TP43.1, U16.14 (IN-)
+20V_Jetson: C16.1, D1.2 (A), J6.1, J6.3, J6.5, J6.7, J8.1, J8.2, TP29.1, U2.14 (IN-)
+V_Batt: C1.1, C2.1, C3.1, C5.1, C24.1, C38.1, R107.2, TP25.1, TP31.1, TP39.1, U8.3 (+), U12.17 (VBB), U15.17 (VBB), U17.17 (VBB)
/Jetson_Subsystem/WD_Jetson/WDT-VIN: C45.1, C46.1, C47.1, R11.2, R12.1, R21.1, R27.2, TP10.1, U4.3 (V+)
/Jetson_Subsystem/WD_Jetson/WDT-VP: R15.2, R16.1, U4.5 (+)
/OBC_Subsystem/WD_OBC/WDT-VIN: C42.1, C43.1, C44.1, R84.2, R85.1, R94.1, R100.2, TP48.1, U14.3 (V+)
/OBC_Subsystem/WD_OBC/WDT-VP: R88.2, R89.1, U14.5 (+)
/Perif_Subsystem/WD_Perif/WDT-VIN: C6.1, C34.1, C35.1, R2.2, R8.1, R49.1, R71.2, TP5.1, U6.3 (V+)
/Perif_Subsystem/WD_Perif/WDT-VP: R30.2, R31.1, U6.5 (+)
GND: C1.2, C2.2, C3.2, C4.2, C5.2, C6.2, C8.1, C9.1, C10.2, C13.2, C15.2, C16.2, C17.1, C19.1, C20.1, C21.1, C22.1, C23.2, C24.2, C25.2, C28.2, C29.1, C31.2, C32.2, C33.1, C34.2, C35.2, C36.2, C37.2, C38.2, C39.2, C41.2, C42.2, C43.2, C44.2, C45.2, C46.2, C47.2, C48.2, C50.2, C51.2, C52.2, C53.2, C54.2, C55.2, C56.2, C64.1, C65.1, C66.1, C67.1, CN1.9, CN1.11, CN1.13, CN1.15, D2.1 (K), D4.1 (K), D7.1 (K), D9.1 (K), D11.1 (K), D17.1 (K), J2.1, J3.1, J4.1, J5.1, J6.9, J6.11, J6.13, J6.15, J7.3, J7.4, J8.3, J8.4, J10.9, J10.11, J10.13, J10.15, J18.3, J18.4, R1.2, R3.2, R4.2, R6.1, R7.2, R16.2, R18.2, R28.1, R31.2, R33.2, R41.1, R52.2, R54.2, R56.2, R57.1, R59.2, R60.2, R61.2, R62.2, R64.2, R66.2, R72.2, R75.2, R76.2, R79.2, R80.2, R81.2, R89.2, R91.2, R101.2, R102.2, R104.2, R108.1, U1.8 (PGND), U1.11 (GND), U1.25 (NC), U2.4 (A1), U2.5 (A0), U2.6 (GND), U3.8 (PGND), U3.11 (GND), U3.25 (NC), U4.12 (V-), U5.4 (A1), U5.6 (GND), U6.12 (V-), U7.8 (GND), U8.1, U8.2, U8.4 (-), U9.4 (GND), U12.1 (GND), U13.8 (PGND), U13.11 (GND), U13.25 (NC), U14.12 (V-), U15.1 (GND), U16.6 (GND), U17.1 (GND)
unnamed: C7.2, R33.1, R38.1
unnamed: C18.2, R18.1, R19.1
unnamed: C63.2, R91.1, R92.1
unnamed: CN1.4, TP16.1
unnamed: CN1.6, TP17.1
unnamed: CN1.8, TP18.1
unnamed: CN1.10, TP19.1
unnamed: CN1.12, TP20.1
unnamed: CN1.14, TP21.1
unnamed: D1.1 (K), R11.1
unnamed: D2.2 (A), R17.2
unnamed: D3.2 (A), R24.1
unnamed: D3.1 (K), R25.2, R26.1, R27.1, TP14.1, U4.11 (+), U4.14
unnamed: D4.2 (A), R5.1
unnamed: D6.1 (K), R2.1
unnamed: D7.2 (A), R32.2
unnamed: D8.2 (A), R68.1
unnamed: D8.1 (K), R69.2, R70.1, R71.1, TP9.1, U6.11 (+), U6.14
unnamed: D9.2 (A), R77.2
unnamed: D10.1 (K), R84.1
unnamed: D11.2 (A), R90.2
unnamed: D12.2 (A), R97.1
unnamed: D12.1 (K), R98.2, R99.1, R100.1, TP52.1, U14.11 (+), U14.14
unnamed: D17.2 (A), R58.1
unnamed: J6.2, TP44.1
unnamed: J6.4, TP45.1
unnamed: J6.6, TP1.1
unnamed: J6.8, TP2.1
unnamed: J6.10, TP3.1
unnamed: J6.12, TP4.1
unnamed: J10.2, TP22.1
unnamed: J10.4, TP23.1
unnamed: J10.10, TP24.1
unnamed: JP1.1 (A), TP47.1, U4.13
unnamed: JP2.1 (A), TP15.1, U6.13
unnamed: JP5.1 (A), TP53.1, U14.13
unnamed: R12.2, R13.1, R23.2
unnamed: R20.1, U4.2
unnamed: R22.1, U4.1
unnamed: R39.1, U6.2
unnamed: R51.1, U6.1
unnamed: R8.2, R9.1, R67.2
unnamed: R85.2, R86.1, R96.2
unnamed: R93.1, U14.2
unnamed: R95.1, U14.1
unnamed: C14.1, C54.1, C55.1, L1.2, R55.1, TP28.1, U1.22 (BIAS), U2.1 (IN+), U2.12 (VBUS)
unnamed: C11.1, U1.20 (BST)
unnamed: R53.2, R54.1, U1.4 (EN/UV)
unnamed: C14.2, R55.2, R56.1, U1.24 (FB)
unnamed: C13.1, U1.21 (INTVCC)
unnamed: R52.1, U1.3 (RT)
unnamed: C11.2, L1.1, U1.15 (SW)
unnamed: C10.1, U1.2 (TR/SS)
unnamed: C4.1, R53.1, TP26.1, U1.5 (VIN), U15.6 (VOUT)
unnamed: C26.1, C52.1, C56.1, L2.2, R65.1, TP33.1, U3.22 (BIAS), U5.1 (IN+), U5.12 (VBUS)
unnamed: C27.1, U3.20 (BST)
unnamed: R63.2, R64.1, U3.4 (EN/UV)
unnamed: C26.2, R65.2, R66.1, U3.24 (FB)
unnamed: C28.1, U3.21 (INTVCC)
unnamed: R62.1, U3.3 (RT)
unnamed: C27.2, L2.1, U3.15 (SW)
unnamed: C25.1, U3.2 (TR/SS)
unnamed: R19.2, U4.4 (-)
unnamed: C19.2, R20.2, R21.2, TP12.1, U4.7 (+)
unnamed: R14.2, R15.1, U4.6 (-)
unnamed: R23.1, R25.1, U4.9 (+)
unnamed: C20.2, C21.2, R22.2, R24.2, R26.2, TP13.1, U4.8 (-)
unnamed: C22.2, R13.2, R14.1, U4.10 (-)
unnamed: R38.2, U6.4 (-)
unnamed: C8.2, R39.2, R49.2, TP7.1, U6.7 (+)
unnamed: R29.2, R30.1, U6.6 (-)
unnamed: R67.1, R69.1, U6.9 (+)
unnamed: C9.2, C17.2, R51.2, R68.2, R70.2, TP8.1, U6.8 (-)
unnamed: C33.2, R9.2, R29.1, U6.10 (-)
unnamed: R34.2, U7.9 (MOD)
unnamed: R35.2, U7.10 (SET)
unnamed: R48.2, U9.1 (EN)
unnamed: R47.2, U9.5 (READY)
unnamed: R44.2, U9.8 (VCC)
unnamed: R81.1, U12.16 (DIA_EN)
unnamed: R76.1, U12.3 (LATCH)
unnamed: R80.1, U12.14 (SEL1)
unnamed: R79.1, U12.15 (SEL2)
unnamed: R75.1, U12.2 (SNS)
unnamed: C36.1, R83.1, TP40.1, U12.6 (VOUT), U13.5 (VIN)
unnamed: R77.1, U12.5 (~ST)
unnamed: C48.1, C49.1, C53.1, L3.2, R103.1, TP42.1, U13.22 (BIAS), U16.1 (IN+), U16.12 (VBUS)
unnamed: C40.1, U13.20 (BST)
unnamed: R83.2, R101.1, U13.4 (EN/UV)
unnamed: C49.2, R103.2, R104.1, U13.24 (FB)
unnamed: C41.1, U13.21 (INTVCC)
unnamed: R102.1, U13.3 (RT)
unnamed: C40.2, L3.1, U13.15 (SW)
unnamed: C39.1, U13.2 (TR/SS)
unnamed: R92.2, U14.4 (-)
unnamed: C64.2, R93.2, R94.2, TP50.1, U14.7 (+)
unnamed: R87.2, R88.1, U14.6 (-)
unnamed: R96.1, R98.1, U14.9 (+)
unnamed: C65.2, C66.2, R95.2, R97.2, R99.2, TP51.1, U14.8 (-)
unnamed: C67.2, R86.2, R87.1, U14.10 (-)
unnamed: R7.1, U15.16 (DIA_EN)
unnamed: R6.2, U15.3 (LATCH)
unnamed: R4.1, U15.14 (SEL1)
unnamed: R3.1, U15.15 (SEL2)
unnamed: R28.2, U15.2 (SNS)
unnamed: R5.2, U15.5 (~ST)
unnamed: R59.1, U17.16 (DIA_EN)
unnamed: R41.2, U17.3 (LATCH)
unnamed: R61.1, U17.14 (SEL1)
unnamed: R60.1, U17.15 (SEL2)
unnamed: R57.2, U17.2 (SNS)
unnamed: C23.1, R63.1, TP32.1, U3.5 (VIN), U17.6 (VOUT)
unnamed: R58.2, U17.5 (~ST)
OBC SCL: J10.8, R46.2, U9.2 (SCLOUT)
OBC SDA: J10.6, R43.2, U9.7 (SDAOUT)
OBC_EN_JETSON: J10.12, R50.1
OBC_EN_PERIF: J10.14, R82.1
SCL: R45.2, U2.9 (SCL), U5.9 (SCL), U9.3 (SCLIN), U16.9 (SCL)
SDA: R42.2, U2.8 (SDA), U5.8 (SDA), U9.6 (SDAIN), U16.8 (SDA)
SYNC_PHASE1: TP35.1, U3.1 (SYNC), U7.4 (OUT1)
SYNC_PHASE2: TP41.1, U7.5 (OUT2), U13.1 (SYNC)
SYNC_PHASE3: TP27.1, U1.1 (SYNC), U7.6 (OUT3)
WDT_WDI_Jetson: C18.1, J6.14, J6.16, R17.1, TP11.1, TP46.1
WDT_WDI_OBC: C63.1, J10.16, R90.1, TP49.1
WDT_WDI_Perif: C7.1, CN1.16, R32.1, TP6.1
~WD_EN_JETSON: JP1.2 (B), R1.1, R50.2, TP38.1, U15.4 (EN)
~WD_EN_OBC: JP5.2 (B), R107.1, R108.2, TP36.1, U17.4 (EN)
~WD_EN_PERIF: JP2.2 (B), R72.1, R82.2, TP37.1, U12.4 (EN)
