BroncoSpace-Lab/scales-hardware/satcat/satcat_carrier_board_scales/satcat_scales/satcat_scales.kicad_sch

## KiCad design satcat/satcat_carrier_board_scales/satcat_scales/satcat_scales.kicad_sch (2025-02-24)

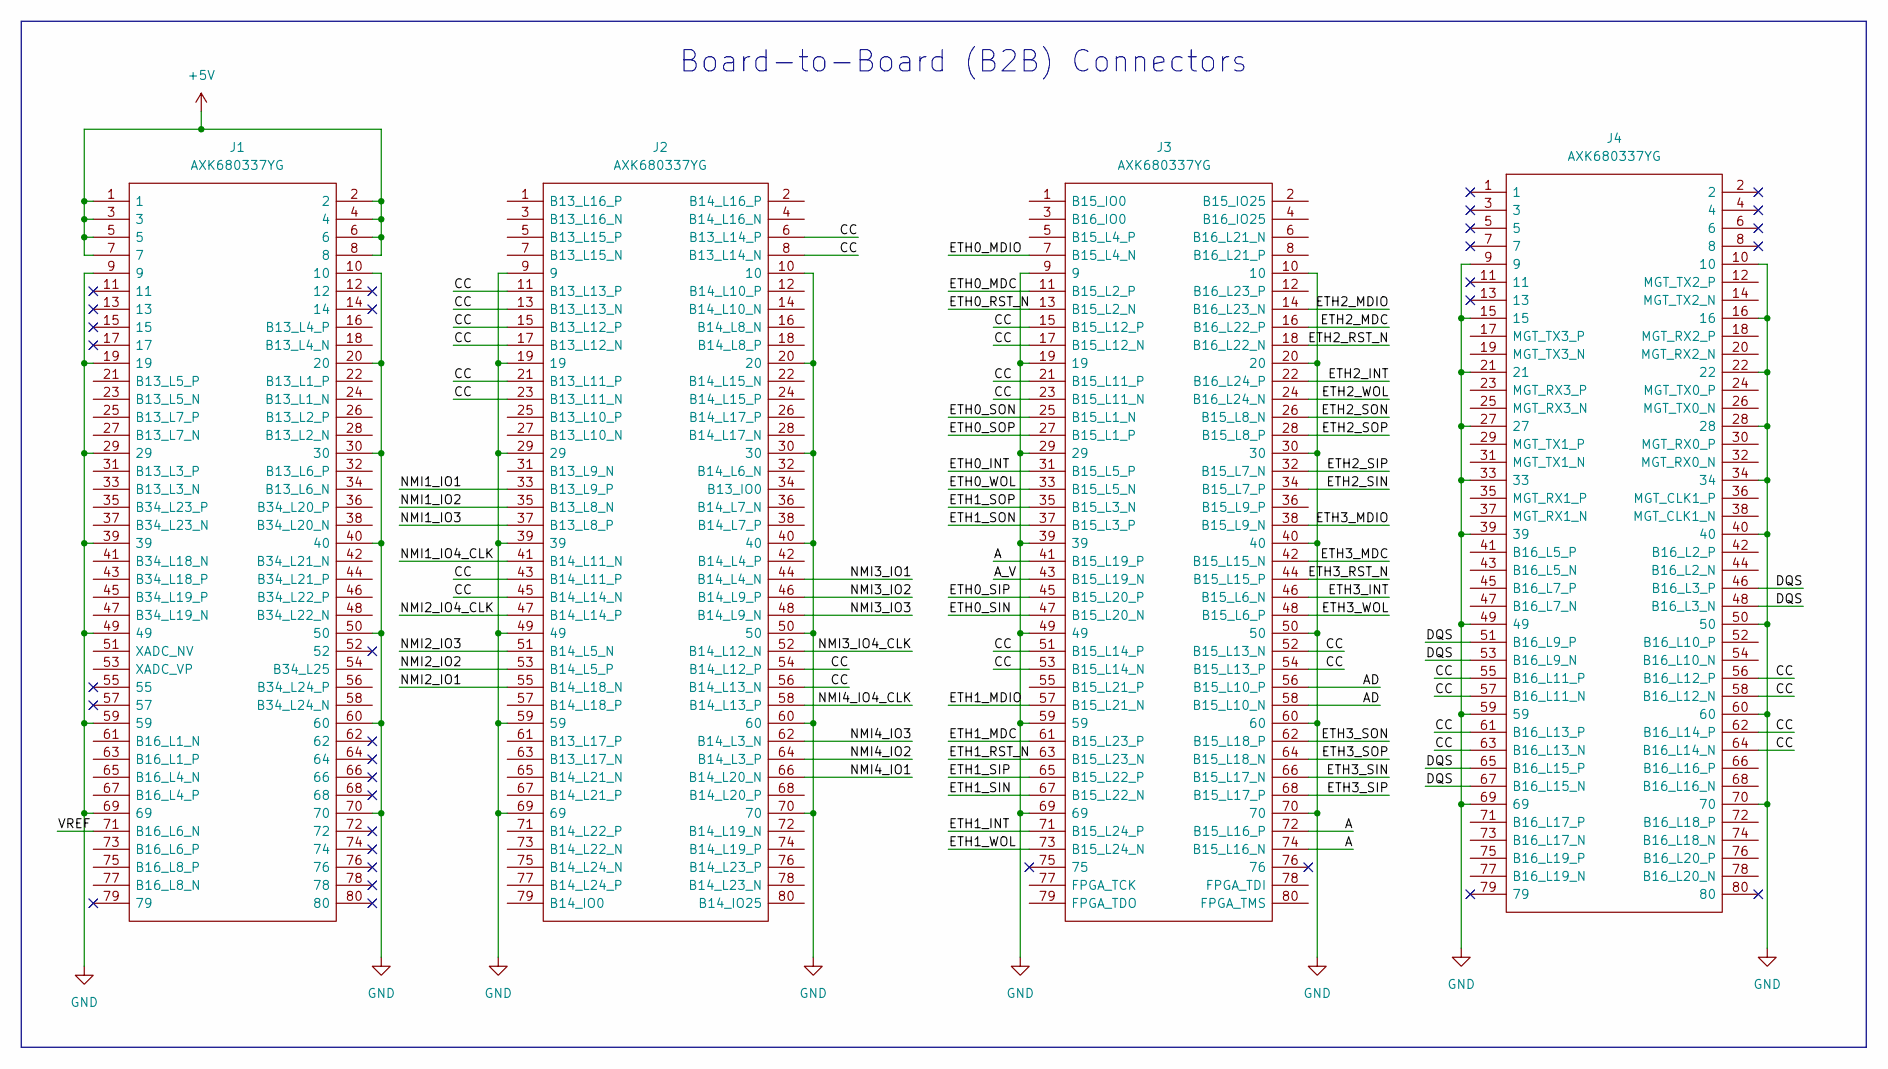
[picture p245: schematic satcat_scales.kicad_sch]

Parts:
J1, J2, J3, J4: AXK680337YG; Mouser Part Number 769-AXK680337YG

Connections:
+5V: J1.1, J1.2, J1.3, J1.4, J1.5, J1.6, J1.7, J1.8
A: J3.41 (B15_L19_P), J3.72 (B15_L16_P), J3.74 (B15_L16_N)
AD: J3.56 (B15_L10_P), J3.58 (B15_L10_N)
A_V: J3.43 (B15_L19_N)
CC: J2.6 (B13_L14_P), J2.8 (B13_L14_N), J2.11 (B13_L13_P), J2.13 (B13_L13_N), J2.15 (B13_L12_P), J2.17 (B13_L12_N), J2.21 (B13_L11_P), J2.23 (B13_L11_N), J2.43 (B14_L11_P), J2.45 (B14_L14_N), J2.54 (B14_L12_P), J2.56 (B14_L13_N), J3.15 (B15_L12_P), J3.17 (B15_L12_N), J3.21 (B15_L11_P), J3.23 (B15_L11_N), J3.51 (B15_L14_P), J3.52 (B15_L13_N), J3.53 (B15_L14_N), J3.54 (B15_L13_P), J4.55 (B16_L11_P), J4.56 (B16_L12_P), J4.57 (B16_L11_N), J4.58 (B16_L12_N), J4.61 (B16_L13_P), J4.62 (B16_L14_P), J4.63 (B16_L13_N), J4.64 (B16_L14_N)
DQS: J4.46 (B16_L3_P), J4.48 (B16_L3_N), J4.51 (B16_L9_P), J4.53 (B16_L9_N), J4.65 (B16_L15_P), J4.67 (B16_L15_N)
ETH0_INT: J3.31 (B15_L5_P)
ETH0_MDC: J3.11 (B15_L2_P)
ETH0_MDIO: J3.7 (B15_L4_N)
ETH0_RST_N: J3.13 (B15_L2_N)
ETH0_SIN: J3.47 (B15_L20_N)
ETH0_SIP: J3.45 (B15_L20_P)
ETH0_SON: J3.25 (B15_L1_N)
ETH0_SOP: J3.27 (B15_L1_P)
ETH0_WOL: J3.33 (B15_L5_N)
ETH1_INT: J3.71 (B15_L24_P)
ETH1_MDC: J3.61 (B15_L23_P)
ETH1_MDIO: J3.57 (B15_L21_N)
ETH1_RST_N: J3.63 (B15_L23_N)
ETH1_SIN: J3.67 (B15_L22_N)
ETH1_SIP: J3.65 (B15_L22_P)
ETH1_SON: J3.37 (B15_L3_P)
ETH1_SOP: J3.35 (B15_L3_N)
ETH1_WOL: J3.73 (B15_L24_N)
ETH2_INT: J3.22 (B16_L24_P)
ETH2_MDC: J3.16 (B16_L22_P)
ETH2_MDIO: J3.14 (B16_L23_N)
ETH2_RST_N: J3.18 (B16_L22_N)
ETH2_SIN: J3.34 (B15_L7_P)
ETH2_SIP: J3.32 (B15_L7_N)
ETH2_SON: J3.26 (B15_L8_N)
ETH2_SOP: J3.28 (B15_L8_P)
ETH2_WOL: J3.24 (B16_L24_N)
ETH3_INT: J3.46 (B15_L6_N)
ETH3_MDC: J3.42 (B15_L15_N)
ETH3_MDIO: J3.38 (B15_L9_N)
ETH3_RST_N: J3.44 (B15_L15_P)
ETH3_SIN: J3.66 (B15_L17_N)
ETH3_SIP: J3.68 (B15_L17_P)
ETH3_SON: J3.62 (B15_L18_P)
ETH3_SOP: J3.64 (B15_L18_N)
ETH3_WOL: J3.48 (B15_L6_P)
GND: J1.9, J1.10, J1.19, J1.20, J1.29, J1.30, J1.39, J1.40, J1.49, J1.50, J1.59, J1.60, J1.69, J1.70, J2.9, J2.10, J2.19, J2.20, J2.29, J2.30, J2.39, J2.40, J2.49, J2.50, J2.59, J2.60, J2.69, J2.70, J3.9, J3.10, J3.19, J3.20, J3.29, J3.30, J3.39, J3.40, J3.49, J3.50, J3.59, J3.60, J3.69, J3.70, J4.9, J4.10, J4.15, J4.16, J4.21, J4.22, J4.27, J4.28, J4.33, J4.34, J4.39, J4.40, J4.49, J4.50, J4.59, J4.60, J4.69, J4.70
NMI1_IO1: J2.33 (B13_L9_P)
NMI1_IO2: J2.35 (B13_L8_N)
NMI1_IO3: J2.37 (B13_L8_P)
NMI1_IO4_CLK: J2.41 (B14_L11_N)
NMI2_IO1: J2.55 (B14_L18_N)
NMI2_IO2: J2.53 (B14_L5_P)
NMI2_IO3: J2.51 (B14_L5_N)
NMI2_IO4_CLK: J2.47 (B14_L14_P)
NMI3_IO1: J2.44 (B14_L4_N)
NMI3_IO2: J2.46 (B14_L9_P)
NMI3_IO3: J2.48 (B14_L9_N)
NMI3_IO4_CLK: J2.52 (B14_L12_N)
NMI4_IO1: J2.66 (B14_L20_N)
NMI4_IO2: J2.64 (B14_L3_P)
NMI4_IO3: J2.62 (B14_L3_N)
NMI4_IO4_CLK: J2.58 (B14_L13_P)
VREF: J1.71 (B16_L6_N)

Notes on the sheet:
Board-to-Board (B2B) Connectors
