BroncoSpace-Lab/scales-hardware/imx8x_eps_leviathan_v2/simulation_models/ngspice/ngspice/examples/osdi/hicuml0/KiCad/ECL-OR.kicad_sch

## KiCad design imx8x_eps_leviathan_v2/simulation_models/ngspice/ngspice/examples/osdi/hicuml0/KiCad/ECL-OR.kicad_sch (2026-06-30)

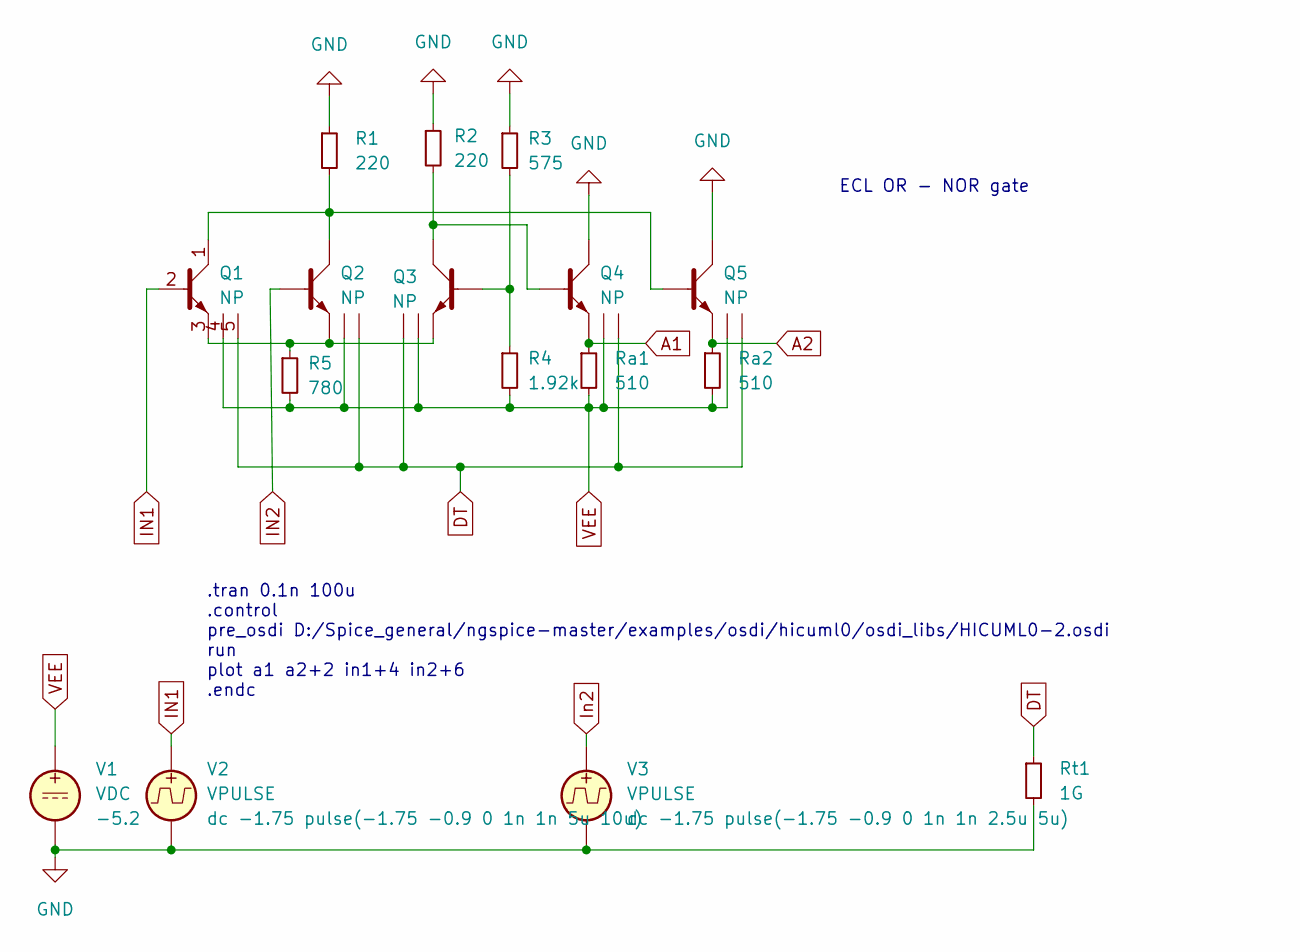
[picture p246: schematic ECL-OR.kicad_sch]

Parts:
Q1, Q2, Q3, Q4, Q5: NP
R1, R2: 220
R3: 575
R4: 1.92k
R5: 780
Ra1, Ra2: 510
Rt1: 1G
V1: VDC
V2, V3: VPULSE

Connections:
A1: Q4.3 (E), Ra1.1
A2: Q5.3 (E), Ra2.1
DT: Q1.5 (DT), Q2.5 (DT), Q3.5 (DT), Q4.5 (DT), Q5.5 (DT), Rt1.1
GND: Q4.1 (C), Q5.1 (C), R1.1, R2.1, R3.1, Rt1.2, V1.2, V2.2, V3.2
IN1: Q1.2 (B), V2.1
In2: Q2.2 (B), V3.1
unnamed: Q1.1 (C), Q2.1 (C), Q5.2 (B), R1.2
unnamed: Q1.3 (E), Q2.3 (E), Q3.3 (E), R5.1
unnamed: Q3.1 (C), Q4.2 (B), R2.2
unnamed: Q3.2 (B), R3.2, R4.1
VEE: Q1.4 (S), Q2.4 (S), Q3.4 (S), Q4.4 (S), Q5.4 (S), R4.2, R5.2, Ra1.2, Ra2.2, V1.1

Notes on the sheet:
ECL OR - NOR gate
.tran 0.1n 100u .control pre_osdi D:/Spice_general/ngspice-master/examples/osdi/hicuml0/osdi_libs/HICUML0-2.osdi run plot a1 a2+2 in1+4 in2+6 .endc
