BroncoSpace-Lab/scales-hardware/(commit log)

2024-10-09 changes to power testing p/f matrix
2024-10-18 added working temp sensor code
2024-10-18 added temp sensor executable
2024-10-22 ML performance doc
    [resnet_test.csv]
2024-10-23 finished resnet testing
    [resnet_15W.csv, resnet_30W.csv, resnet_50W.csv, rolling_averages.csv]
2024-10-23 depth results finished
    [depth_15W.csv, depth_30W.csv, depth_50W.csv, depth_maxn.csv, rolling_averages.csv]
2024-10-25 ML documentation update
    [depth_15W.csv, depth_30W.csv, depth_50W.csv, depth_maxn.csv, phi_30W.csv, resnet_15W.csv, resnet_30W.csv, resnet_50W.csv]
2024-10-25 power stats updated
    [phi_15W.csv, phi_30W.csv, resnet_15W.csv, resnet_maxn.csv, resnet_training_maxnS.csv]
2024-10-28 finished training data
    [resnet_training_15W.csv, resnet_training_30W.csv, resnet_training_50W.csv]
2025-01-28 Reorganized Test Results
    [rolling_averages.csv]
2025-01-28 added satcat stuff
    development board design how-to so far. work in progress.
2025-01-29 update satcat board design doc
2025-01-31 add satcat board design section
2025-01-31 update satcat board docs
    [satcat_scales.kicad_pcb, satcat_scales.kicad_sch]
2025-02-04 Added Power System to the Build Path
2025-02-06 started ki-cad schematic
    [EPS_Scales_RevA.kicad_sch, FPGA_WD.kicad_sch, OBC_WD.kicad_sch, untitled.kicad_sch]
2025-02-08 Schematic Updates + research
    [EPS_Scales_RevA.kicad_sch, J_WD.kicad_sch, OBC_WD.kicad_sch]
2025-02-10 Updated Schematic and Documentation
    Picked Switching regulators and Load Switches, all put on schematic, watchdogs and enable functions also integrated with load switches. Next up is calculating RLC values.
    [EPS_Scales_RevA.kicad_sch, FPGA_WD.kicad_sch, J_WD.kicad_sch, OBC_WD.kicad_sch]
2025-02-11 Started RevB Schematic Design
    Updating: - Notes on Rev A from michael:
    - Switching Regulator: Vicor PI3740 is not in stock, find another one, stick to TI or Analog devices
    - Add a GPIO pin to toggle the enable pin on each regulator, if its needed to reset power output
    - Move to Rev B:
    - Implement the following:
    - New Switching regulator
    - Options:
    - [LT8638](https://www.analog.com/media/en/technical-documentation/data-sheets/lt8638-2.pdf) (2.8V to 42V 10A/12A)
    - [LT8638SEV#PBF](https://www.mouser.com/ProductDetail/Analog-Devices/LT8638SEVPBF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) (2.8V to 42V 10A/12A) Both should b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
    [EPS_Scales_RevA.kicad_sch, EPS_Scales_RevB.kicad_pcb, EPS_Scales_RevB.kicad_sch, FPGA_WD.kicad_sch, J_WD.kicad_sch, OBC_WD.kicad_sch, untitled.kicad_sch]
2025-02-12 Updated to documentation and RevB
    Jetson Switching regulator calculations have been completed. Set to move forward for 3 more. OBC, FPGA, and Peripheral 5v.
    [EPS_Scales_RevB.kicad_sch]
2025-02-12 updated kicad
2025-02-13 Rev B. Updated
    Switching Regulators Inductors, Capacitors and Resistor networks finalized. Added clock to set switching frequency and apply phase shift for each regulator. Including INA902 for current/voltage monitoring. One step closer to a rough final draft of the EPS for SCALES
    [EPS_Scales_RevB.kicad_sch]
2025-02-17 Rev_B_EPS Schematic Updates
    EPS Board Schematic is starting to come to a conclusion. Swapped out to new load switches that use external mosfets and have an enable switch. R and C values finalized for almost everything. Need some reviewing and/or notes on how to proceed with Phases for each component plus if we might need an external DC/DC converter just for the clock oscillator. Good stuff
    [EPS_Scales_RevB.kicad_sch, Perif_WD.kicad_sch]
2025-02-18 Updates
    minor updates
    [EPS_Scales_RevB.kicad_sch, J_WD.kicad_sch]
2025-02-19 update docs
    update imx procedures and satcat board design docs. includes BSP building and modification for the imx and some very minimal (mostly formatting) changes to satcat docs.
    [satcat_scales.kicad_sch]
2025-02-19 REV B. Schematic Finalized. Awaiting First Review
    GPIO toggle pins added
    Decoupling/filter caps added to power input.
    Everything has been documented/added for clarification.
    UV/OV resistors selected for Load Switches.
    +5v Perif regulator tied to WDs and Clock. Slew rates calculated for 3 regulators and for 5v perif to setup phases prior to turning on.
    Awaiting review.
    [EPS_Scales_RevB.kicad_sch, FPGA_WD.kicad_sch, J_WD.kicad_sch, OBC_WD.kicad_sch]
2025-02-19 Calculations sheets added
    Added calculations for UV/OV thresholds for load switches.
2025-02-22 make imx carrier board and update docs
    very minor update to docs
    [imx8x_carrier_v1.kicad_pcb, imx8x_carrier_v1.kicad_sch, satcat_scales.kicad_sch]
2025-03-03 Stash Updates
    [EPS_Scales_RevB.kicad_sch]
2025-03-10 REV C. Schematic Started
    Included new sheets for each subsystem, created my own symbols and footprints for each design for simplified viewing. Based on REV C. Block diagram in Draw.io which was created by me and reviewed by Andrew Greenberg multiple times to confirm design.
    [EPS_Scales_RevC.kicad_pcb, EPS_Scales_RevC.kicad_sch, JetsonSubsystem.kicad_sch, OBC_Subsystem.kicad_sch, Peripheral_Subsystem.kicad_sch, WD_Jetson.kicad_sch, WD_OBC.kicad_sch, WD_Peripheral.kicad_sch]
2025-03-10 Created RTW Folder
    [RTW_production_pathfinder_V1.kicad_pcb, RTW_production_pathfinder_V1.kicad_sch]
2025-03-11 Initial Layout for RTW Production Pathfinder
    [RTW_production_pathfinder_V1.kicad_pcb, RTW_production_pathfinder_V1.kicad_sch]
2025-03-11 Completed Layout for RTW-Proto
    [RTW_production_pathfinder_V1.kicad_pcb, RTW_production_pathfinder_V1.kicad_sch]
2025-03-11 Initial Multichannel Layout
    [RTW_production_pathfinder_V1.kicad_pcb, RTW_production_pathfinder_V1.kicad_sch, WDT_Circuit.kicad_sch, WDT_Circuit2.kicad_sch, WDT_Circuit3.kicad_sch]
2025-03-11 RTW V1 Pathfinder Layout Completed
    [RTW_production_pathfinder_V1.kicad_pcb, RTW_production_pathfinder_V1.kicad_sch, WDT_Circuit.kicad_sch, WDT_Circuit2.kicad_sch, WDT_Circuit3.kicad_sch]
2025-03-11 Production Files Generated for RTW V1
    [RTW_production_pathfinder_V1-CuBottom.gbr, RTW_production_pathfinder_V1-CuTop.gbr, RTW_production_pathfinder_V1-EdgeCuts.gbr, RTW_production_pathfinder_V1-MaskBottom.gbr, RTW_production_pathfinder_V1-MaskTop.gbr, RTW_production_pathfinder_V1-NPTH.drl, RTW_production_pathfinder_V1-PTH.drl, RTW_production_pathfinder_V1-SilkBottom.gbr]
2025-03-11 Calculations
    Lots of behind the scenes stuff going on. Ran through calculations for the Load Switch, Switching Regulator and clock for the jetson using the information from each datasheet. Having to modify these parameters for each subsystem is time consuming as each one requires new calculations. Once this bit is done the schematic will be done, leading to layout. Aiming for thursday Layout.
    [EPS_Scales_RevC.kicad_sch, JetsonSubsystem.kicad_sch, OBC_Subsystem.kicad_sch, WD_Jetson.kicad_sch, WD_Peripheral.kicad_sch]
2025-03-11 Added Decoupling Caps on VBIAS
    [RTW_production_pathfinder_V1-CuBottom.gbr, RTW_production_pathfinder_V1-CuTop.gbr, RTW_production_pathfinder_V1-EdgeCuts.gbr, RTW_production_pathfinder_V1-MaskBottom.gbr, RTW_production_pathfinder_V1-MaskTop.gbr, RTW_production_pathfinder_V1-NPTH.drl, RTW_production_pathfinder_V1-PTH.drl, RTW_production_pathfinder_V1-SilkBottom.gbr]
2025-03-12 REV C calculations Complete
    Integrating numbers for all components in schematic
2025-03-12 Rev C. Schematic 90 % Complete
    All EPS components for each subsystem implemented. Only errors and warning are relating to missing peripheral connections and connectors which will be discussed tomorrow when I go to the lab.
    Calculations are done as well.
    [EPS_Scales_RevC.kicad_sch, JetsonSubsystem.kicad_sch, OBC_Subsystem.kicad_sch, Peripheral_Subsystem.kicad_sch, WD_Jetson.kicad_sch, WD_OBC.kicad_sch, WD_Peripheral.kicad_sch]
2025-03-13 Added Dummy Boards & XNOR functionality
    Almost done with Dummy boards, just need to link some gecko footprints to the schematic symbol pins and layout can begin
    [EPS_Scales_RevC.kicad_sch, JetsonSubsystem.kicad_sch, OBC_Subsystem.kicad_sch, Peripheral_Subsystem.kicad_sch, WD_Jetson.kicad_sch, WD_OBC.kicad_sch, WD_Peripheral.kicad_sch]
2025-03-17 Rev C. Layout Started
    Footprints and Symbols properly linked. Started organizing PCB layout
    [EPS_Scales_RevC.kicad_pcb, EPS_Scales_RevC.kicad_sch, JetsonSubsystem.kicad_sch, OBC_Subsystem.kicad_sch, Peripheral_Subsystem.kicad_sch, WD_Jetson.kicad_sch, WD_OBC.kicad_sch, WD_Peripheral.kicad_sch]
2025-03-18 Added Bypass Caps to WDT 1 & 2
    [RTW_production_pathfinder_V1.kicad_pcb, WDT_Circuit.kicad_sch, WDT_Circuit3.kicad_sch, rtw_pf_input.kicad_sch]
2025-03-18 Layout Revisions
    Organizing components and layering considerations
    [EPS_Scales_RevC.kicad_pcb, JetsonSubsystem.kicad_sch, OBC_Subsystem.kicad_sch, Peripheral_Subsystem.kicad_sch]
2025-03-18 Updated RTW Production Files Mar 18 2025
    [RTW_production_pathfinder_V1-CuBottom.gbr, RTW_production_pathfinder_V1-CuTop.gbr, RTW_production_pathfinder_V1-EdgeCuts.gbr, RTW_production_pathfinder_V1-MaskBottom.gbr, RTW_production_pathfinder_V1-MaskTop.gbr, RTW_production_pathfinder_V1-NPTH.drl, RTW_production_pathfinder_V1-PTH.drl, RTW_production_pathfinder_V1-SilkBottom.gbr]
2025-03-19 EPS Rev C PCB Updated
    Routing and layout improvements, still figuring out what is a good way to lay components out and how to minimize the number of vias used. Will ask for feedback Thursday March 20th
    [EPS_Scales_RevC.kicad_pcb]
2025-03-20 WIP Pre Pour
    [EPS_Scales_RevC.kicad_pcb]
2025-03-20 WIP Rev C. PCB Layout
    [EPS_Scales_RevC.kicad_pcb]
2025-03-20 imx carrier - added ethernet ports
    [imx8x_carrier_v1.kicad_sch]
2025-03-24 WIP REV C. Layout
    Completed primary routing configuration.
    Current orientation of components is for prototyping and does not reflect final layout.
    Need further DRC checkings and track size correction for each sub-system.
    [EPS_Scales_RevC.kicad_pcb, EPS_Scales_RevC.kicad_sch, JetsonSubsystem.kicad_sch, Jetson_EPS.kicad_sch, OBC_EPS.kicad_sch, OBC_Subsystem.kicad_sch, Perif_EPS.kicad_sch, Peripheral_Subsystem.kicad_sch]
2025-03-25 WIP EPS REV C.
    Removed XNOR implementation, redid layout for compactness, restarting routing for more efficient traces.
    [EPS_Scales_RevC.kicad_pcb, JetsonSubsystem.kicad_sch, Jetson_EPS.kicad_sch, OBC_EPS.kicad_sch, OBC_Subsystem.kicad_sch, Perif_EPS.kicad_sch, Peripheral_Subsystem.kicad_sch, WD_Jetson.kicad_sch]
2025-03-26 3/26/24 EPS Rev C.
    Github had an error with file conflicts, this is the one I recovered and is the one im working from, dont know what happened, but I will commit this and then pull to my branch.
    [EPS_Scales_RevC.kicad_pcb]
2025-03-26 Layout and Routing DONE
    Layout and Routing is complete, next step is DRC checking and making sure that the tracks and fab settings coincide with the settings we want to manufacture with. Worth noting that we should probably get a version of this board with just one subsystem to test first before buying the whole thing.
    [EPS_Scales_RevC.kicad_pcb, EPS_Scales_RevC.kicad_sch, JetsonSubsystem.kicad_sch, Jetson_EPS.kicad_sch, OBC_EPS.kicad_sch, OBC_Subsystem.kicad_sch, Perif_EPS.kicad_sch, Peripheral_Subsystem.kicad_sch]
2025-03-27 EPS REV C. Dev. V1 DONE
    Layout complete. Routing Complete. Missing memes
    [EPS_Scales_RevC.kicad_pcb, EPS_Scales_RevC.kicad_sch, JetsonSubsystem.kicad_sch, Jetson_EPS.kicad_sch, OBC_EPS.kicad_sch, OBC_Subsystem.kicad_sch, Perif_EPS.kicad_sch, Peripheral_Subsystem.kicad_sch]
2025-03-27 upload peripheral board wip
    [peripheral_board.kicad_pcb, peripheral_board.kicad_sch]
2025-03-27 Added some labels to the WIP
    [peripheral_board.kicad_sch]
2025-03-27 uart debug wip
    mostly doing this because easyeda2kicad isnt working for some reason so i's trying to fix it
    [imx8x_carrier_v1.kicad_sch]
2025-03-31 Finishing touches
    [EPS_Scales_RevC.kicad_pcb, JetsonSubsystem.kicad_sch, OBC_Subsystem.kicad_sch, Peripheral_Subsystem.kicad_sch]
2025-04-01 Add a few changes with some labels
    [peripheral_board.kicad_sch]
2025-04-01 Revisions made to schematic include the following
    -REV C Dev Board Revision Suggestions from Andrew Greenberg (4/1/25)
    Main Concerns:
    - Stop working on layout so you dont waste your time [DONE]
    - Rename +28V as Vbatt and display voltage ranges (Vbatt = [24.0, 28.8, 33.6]) [DONE]
    -Reconfigure the UV and OV numbers to allow for this voltage range [DONE]
    - Modify in the calculations page (be sure to note the numbers)
    - 100nF caps on +28V inputs can be removed due to 10uF [DONE]
    - Ensure the capacitors are +75v rated so they dont explode at the input side [DONE]
    -Mu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
    [EPS_Scales_RevC.kicad_pcb, EPS_Scales_RevC.kicad_sch, JetsonSubsystem.kicad_sch, Jetson_EPS.kicad_sch, OBC_EPS.kicad_sch, OBC_Subsystem.kicad_sch, Perif_EPS.kicad_sch, Peripheral_Subsystem.kicad_sch]
2025-04-02 Finished UART Debug MicroUSB Port (i think)
    Basically finished the UART Debug port, reorganized the schematic into more sheets, started looking at power and MicroSD card reader.
    [debug_usb.kicad_sch, imx8x_carrier_v1.kicad_sch, imx_ethernet.kicad_sch, imx_microSD.kicad_sch, imx_power.kicad_sch]
2025-04-02 Added libraries
    Added some global libraries to local for ease of use. Added decoupling caps from the dev board.
    [peripheral_board.kicad_sch]
2025-04-03 Slight update
    [peripheral_board.kicad_sch]
2025-04-04 Updated Footprints
    Added 3225 Capacitors instead of 1608, also added the XEL6030 footprint for the inductors (these come recommended by the LS8638SEV reference design page)
    [Jetson_EPS.kicad_sch, OBC_EPS.kicad_sch, OBC_Subsystem.kicad_sch, Perif_EPS.kicad_sch, WD_Jetson.kicad_sch, WD_OBC.kicad_sch, WD_Peripheral.kicad_sch]
2025-04-04 Pulled down Perif and Jetson WD
    [Jetson_EPS.kicad_sch, Perif_EPS.kicad_sch, WD_Jetson.kicad_sch, WD_Peripheral.kicad_sch]
2025-04-04 WD Default config changed
    Pulled up WD OBC, and pulled down Jetson and Perif. WD
    [WD_Jetson.kicad_sch, WD_OBC.kicad_sch]
2025-04-04 Fixed Commit Issues
    [WD_Peripheral.kicad_sch]
2025-04-05 imx SD card dev
    almost finished with sd card
    [imx_microSD.kicad_sch]
2025-04-07 Additions to Schematic
    Added Test points for all subsystems, two on the MOSFETs, Switching regulator, IV sensor supply and detect lines, Clock V+, and UV/OV resistor dividers.
    Updated Rev C. Calcs Doc
    [EPS_Scales_RevC.kicad_sch, Jetson_EPS.kicad_sch, OBC_EPS.kicad_sch, OBC_Subsystem.kicad_sch, Perif_EPS.kicad_sch, Peripheral_Subsystem.kicad_sch, WD_Jetson.kicad_sch, WD_OBC.kicad_sch]
2025-04-07 Started EPS Test board
    [EPS_Subsystem.kicad_sch, EPS_Voyager.kicad_pcb, EPS_Voyager.kicad_sch]
2025-04-07 Small Revisions
    [EPS_Subsystem.kicad_sch, EPS_Voyager.kicad_pcb, EPS_Voyager.kicad_sch]
2025-04-08 Created subpages
    Added subpages for the schematic
    Did a quick overview
    [RJ45_1.kicad_sch, RJ45_SW_1.kicad_sch, RK45_SW_2.kicad_sch, RK45_SW_3.kicad_sch, RK45_SW_4.kicad_sch, RK45_SW_5.kicad_sch, Wiznet.kicad_sch, ethernet_switch.kicad_sch]
2025-04-09 Update to RP and KiCad Version
    Changed the version of KiCad from 8 to 9.
    Added the RP2350A to replace the RP2040.
    Added the minimum config from the Hardware design guide and then modified it to be the same as the RP2040 from proves kit.
    [rp.kicad_sch, rp2350.kicad_sch]
2025-04-09 WD Testing and Minor Schematic Updates to EPS Voyager
    [EPS_Subsystem.kicad_sch, EPS_Voyager.kicad_pcb, EPS_Voyager.kicad_sch]
2025-04-10 prep docs and current schematic pdf for hardware review
    [imx8x_carrier_v1.kicad_sch, imx_SPI_UART.kicad_sch, imx_microSD.kicad_sch]
2025-04-10 Organized Voyager layout
    [EPS_Subsystem.kicad_sch, EPS_Voyager.kicad_pcb]
2025-04-10 Schematic REV_1
    Finished the schematic.
    Started the placement of PCB.
    [RJ45_SW_1.kicad_sch, Wiznet.kicad_sch, ethernet_switch.kicad_sch, peripheral_board.kicad_pcb, power.kicad_sch, rp.kicad_sch, rp2350.kicad_sch, usb_spi.kicad_sch]
2025-04-11 Moved Power System folder to root
    [EPS_Scales_RevA.kicad_pcb, EPS_Scales_RevA.kicad_sch, EPS_Scales_RevB.kicad_pcb, EPS_Scales_RevB.kicad_sch, EPS_Scales_RevC.kicad_pcb, EPS_Scales_RevC.kicad_sch, EPS_Subsystem.kicad_sch, EPS_Voyager.kicad_pcb]
2025-04-11 Started on the PCB
    [peripheral_board.kicad_pcb]
2025-04-14 Final Draft of EPS Voyager Complete
    Basic board using 4 layers similar to what the final board will use. Uses 2.54mm headers for all configurable components. Awaiting review.
    [EPS_Subsystem.kicad_sch, EPS_Voyager.kicad_pcb]
2025-04-14 Moved EPS KiCAD Files to Root Directory
    [EPS_Scales_RevA.kicad_pcb, EPS_Scales_RevA.kicad_sch, EPS_Scales_RevB.kicad_pcb, EPS_Scales_RevB.kicad_sch, EPS_Scales_RevC.kicad_pcb, EPS_Scales_RevC.kicad_sch, EPS_Subsystem.kicad_sch, EPS_Voyager.kicad_pcb]
2025-04-14 Deleted Duplicates
    [EPS_Scales_RevA.kicad_pcb, EPS_Scales_RevA.kicad_sch, EPS_Scales_RevB.kicad_pcb, EPS_Scales_RevB.kicad_sch, EPS_Scales_RevC.kicad_pcb, EPS_Scales_RevC.kicad_sch, EPS_Subsystem.kicad_sch, EPS_Voyager.kicad_pcb]
2025-04-15 Improved Rev C documentation
    Clearly outlined EPS system requirements. Detailed which resistors, capacitors and inductor sized will be used, outlined key design functional traits, improved readability of documentation.
2025-04-15 KiCad
    Added different mil for the fill and made the board a 4 layer. Started laying out the ethernet ports.
    [RJ45_1.kicad_sch, RJ45_SW_1.kicad_sch, RK45_SW_2.kicad_sch, RK45_SW_3.kicad_sch, RK45_SW_4.kicad_sch, Wiznet.kicad_sch, ethernet_switch.kicad_sch, peripheral_board.kicad_pcb]
2025-04-15 Clean up of RJ45
    [peripheral_board.kicad_pcb]
2025-04-16 Update to schematic and moving PCB
    Made some minor style changes to the schematic. Did the multi-channeling for the RJ45. Started on the Wiznet chip.
    [RJ45_1.kicad_sch, RJ45_SW_1.kicad_sch, RK45_SW_2.kicad_sch, RK45_SW_3.kicad_sch, RK45_SW_4.kicad_sch, Wiznet.kicad_sch, peripheral_board.kicad_pcb, usb_spi.kicad_sch]
2025-04-16 Rev C Schematic DONE
    Components were finalized in meeting with Andrew Greenberg today, footprints have been assigned and specific component sizes and values have also been confirmed. Moving to layout for the first dev board of the SCALES EPS board.
    [EPS_Scales_RevC-CuBottom.gbr, EPS_Scales_RevC-CuIn1.gbr, EPS_Scales_RevC-CuIn2.gbr, EPS_Scales_RevC-CuTop.gbr, EPS_Scales_RevC-EdgeCuts.gbr, EPS_Scales_RevC-MaskBottom.gbr, EPS_Scales_RevC-MaskTop.gbr, EPS_Scales_RevC-NPTH.drl]
2025-04-17 Rev C Layout #2 electric boogaloo
    Yes
    [EPS_Scales_RevC-CuBottom.gbr, EPS_Scales_RevC-CuIn1.gbr, EPS_Scales_RevC-CuIn2.gbr, EPS_Scales_RevC-CuTop.gbr, EPS_Scales_RevC-EdgeCuts.gbr, EPS_Scales_RevC-MaskBottom.gbr, EPS_Scales_RevC-MaskTop.gbr, EPS_Scales_RevC-NPTH.drl]
2025-04-17 Update to PCB
    Made added the rest of the Wiznet chip. Unsure how to put the test pads on the underside of the board.
    [Wiznet.kicad_sch, peripheral_board.kicad_pcb]
2025-04-17 Added a readme
    Added a readme with more basic notes of the board.
2025-04-18 Continue working on PCB
    [peripheral_board.kicad_pcb, usb_spi.kicad_sch]
2025-04-21 Some oopsies but fixed Them, routed one segment
    [EPS_Scales_RevC.kicad_pcb, EPS_Scales_RevC.kicad_sch, JetsonSubsystem.kicad_sch, OBC_Subsystem.kicad_sch, Peripheral_Subsystem.kicad_sch, WD_Jetson.kicad_sch, WD_OBC.kicad_sch, WD_Peripheral.kicad_sch]
2025-04-22 More Layout Stuff
    [EPS_Scales_RevC.kicad_pcb, JetsonSubsystem.kicad_sch, OBC_Subsystem.kicad_sch, Peripheral_Subsystem.kicad_sch]
2025-04-22 Update to PCB
    Was added more decoupling CAPS.
    Did a min review to look out for certain pitfalls ie courtyards
    [RJ45_SW_1.kicad_sch, ethernet_switch.kicad_sch, peripheral_board.kicad_pcb, power.kicad_sch, usb_spi.kicad_sch]
2025-04-23 Rough Draft of Rev C completed
    Still lots of work to do with regards to design constraints, assigning BOM links, and sourcing the components from JLC. Will be doing a deep dive on the PCB subreddit to take notes and learn what I could be missing.
    [EPS_Scales_RevC.kicad_pcb, JetsonSubsystem.kicad_sch, OBC_Subsystem.kicad_sch, Peripheral_Subsystem.kicad_sch, WD_Jetson.kicad_sch, WD_OBC.kicad_sch]
2025-04-23 Minor changes to schematic
    [EPS_Scales_RevC.kicad_sch, JetsonSubsystem.kicad_sch, OBC_Subsystem.kicad_sch, Peripheral_Subsystem.kicad_sch]
2025-04-24 Put in the strap in mode
    Found a different configuration that should work as the 4 port switch. Added the courtyards to all the parts.
    [RJ45_1.kicad_sch, RJ45_SW_1.kicad_sch, RK45_SW_2.kicad_sch, RK45_SW_3.kicad_sch, RK45_SW_4.kicad_sch, ethernet_switch.kicad_sch, newethernet.kicad_sch, peripheral_board.kicad_pcb]
2025-04-26 Continue with PCB
    Made some edits to the RP part of the PCB. Setting up the chips with all its CAPs. Started on the power and IO pins.
    [newethernet.kicad_sch, peripheral_board.kicad_pcb, rp.kicad_sch]
2025-04-29 Changes
    Worked on Voyager, refined EPS, added I2C buffer LM4300A to Voyager.
    Ready for Wedneday's review
    [EPS_Scales_RevC.kicad_pcb, EPS_Subsystem.kicad_sch, EPS_Voyager.kicad_sch, untitled.kicad_sch]
2025-04-29 Updated the PCB and the Schematic
    Added in the strap in mode. Almost done with the RP schematic and the will then have to route signals.
    [RJ45_SW_1.kicad_sch, RK45_SW_2.kicad_sch, RK45_SW_3.kicad_sch, RK45_SW_4.kicad_sch, ethernet_switch.kicad_sch, newethernet.kicad_sch, peripheral_board.kicad_pcb, peripheral_board.kicad_sch]
2025-04-30 Update to the Schematic and PCB
    Mini review of the the whole board. Need to look at the PROVES kit to mimic the RP layout.
    Look back through the schematic and the data sheets to ensure that everything is correctly places for the board.
    [RJ45_1.kicad_sch, RJ45_SW_1.kicad_sch, RK45_SW_2.kicad_sch, RK45_SW_3.kicad_sch, RK45_SW_4.kicad_sch, Wiznet.kicad_sch, ethernet_switch.kicad_sch, newethernet.kicad_sch]
2025-04-30 Schematic and Layout changes
    Made all watch dogs powered by +5v perif supply
    All INAs are now powered by the 3.3v OBC supply.
    DFU 16 connectors were updated to through hole versions.
    Redundant test points were removed.
    Layout needs work to reroute new items.
    Still need to add I2C buffer
    [EPS_Scales_RevC.kicad_pcb, EPS_Subsystem.kicad_sch, JetsonSubsystem.kicad_sch, OBC_Subsystem.kicad_sch, Peripheral_Subsystem.kicad_sch, WD_Jetson.kicad_sch, WD_OBC.kicad_sch, WD_Peripheral.kicad_sch]
2025-04-30 Schematic Updates
    Added block diagram to schematic
    Added Power Sequencing description
    Added Power Requirements description
    [EPS_Scales_RevC.kicad_sch, OBC_Subsystem.kicad_sch, Peripheral_Subsystem.kicad_sch]
2025-05-01 Added picture to create a block diagram
    Placed pictures and wires with some text to give a block diagram.
    Looked through the data sheets and found some info on the power for the ethernet switch. The power needs to go through a ferrite bead. Since we are getting power through a USB port I will use voltage regulators to get the 3.3V and the 1.2V needed for the board.
    Tried to get the same version that we are using for the raspberry pi pico but the easyeda2kicad was not working. There is already one that was from the dev board that I have placed but I would like to keep the parts in the same family if possible.
    [RJ45_SW_1.kicad_sch, RK45_SW_2.kicad_sch, RK45_SW_3.kicad_sch, RK45_SW_4.kicad_sch, Wiznet.kicad_sch, ethernet_switch.kicad_sch, newethernet.kicad_sch, peripheral_board.kicad_sch]
2025-05-01 Update to the board
    Need to fix easyeda2kicad and some of the routing on the schematic.
    Grab the proves RP and wiznet config for next board design.
    [Wiznet.kicad_sch, newethernet.kicad_sch, peripheral_board.kicad_pcb, peripheral_board.kicad_sch]
2025-05-01 Layout Improvements
    [EPS_Scales_RevC.kicad_pcb]
2025-05-01 Revisions to Schematic
    Added request to add I2C buffer
    Added request to modify block diagram to figure out WD con ops
    Added pull up to OBC WD for proper SHDN use.
    [EPS_Scales_RevC.kicad_pcb, EPS_Scales_RevC.kicad_sch, JetsonSubsystem.kicad_sch, OBC_Subsystem.kicad_sch, Peripheral_Subsystem.kicad_sch]
2025-05-01 Added in the PROVES dev board and some notes from Jason
    Added in a stripped down proves board.
    Will need to see if there is a more up to date version.
    Will be getting a version done soon when the new RP is added and the ethernet switch is added as well.
    [1042.stp, 1043.stp, 1049.stp, 504050-0291.step, 504050-0291.stp, 504050-0591.stp, 504050-1291.stp, 5040500791.step]
2025-05-02 Changes to the component selection
    [Wiznet.kicad_sch, newethernet.kicad_sch, peripheral_board.kicad_pcb, peripheral_board.kicad_sch, rp.kicad_sch]
2025-05-03 Changes to versions of CAPS
    Need to get the correct version CAPs for the RP.
    Looking online couldn't find the correct ones might need to either edit the footprint or the PCB bounds to allow for pathing for the RP to work with the inductor.
    [Wiznet.kicad_sch, newethernet.kicad_sch, peripheral_board.kicad_pcb, peripheral_board.kicad_sch, rp.kicad_sch]
2025-05-06 Schematic Revisions
    Added updated block diagram
    Added Individual watch dog setups for each subsystem. Resistor and Capacitor values must be modified to reflect desired time range.
    [EPS_Scales_RevC.kicad_sch, JetsonSubsystem.kicad_sch, WD_Jetson.kicad_sch, WD_OBC.kicad_sch, WD_Peripheral.kicad_sch]
2025-05-06 Schematic Revisions
    Added I2c Buffer, not finished yet
    [EPS_Scales_RevC.kicad_pcb, EPS_Scales_RevC.kicad_sch, JetsonSubsystem.kicad_sch, OBC_Subsystem.kicad_sch, Peripheral_Subsystem.kicad_sch]
2025-05-06 Update to Schematic & PCB layout
    Updated the schematic to have a non populated USB-C port to add in at a later date. Removed some reference pages that I no longer using.
    For the PCB I have been making edits to footprints to closely match the RP2350 design requirements. Making the placement of the parts exactly or close to that of the requirements and guide lines.
    Have left the Wiznet alone and the Ethernet switch is not touched because it is mainly signal tracking.
    Still need to make the changes for the signal integrity of the Ethernet switch from the data sheet.
    Made sure the parts from my global library are include in the project specific one.
    [RJ45_1.kicad_sch, RJ45_SW_1.kicad_sch, RK45_SW_2.kicad_sch, RK45_SW_3.kicad_sch, RK45_SW_4.kicad_sch, Wiznet.kicad_sch, ethernet_switch.kicad_sch, newethernet.kicad_sch]
2025-05-07 Update peripheral_board.kicad_pcb
    Minor changes
    [peripheral_board.kicad_pcb]
2025-05-07 Layout Complete
    Added I2C buffer
    Found replacement inductor for 10uH
    Added footprints for new components
    Last thing missing is changing the solder mask sizing on most footprints to remove the errors.
    [EPS_Scales_RevC.kicad_pcb, EPS_Scales_RevC.kicad_sch, JetsonSubsystem.kicad_sch, OBC_Subsystem.kicad_sch, Peripheral_Subsystem.kicad_sch, WD_Jetson.kicad_sch, WD_OBC.kicad_sch, WD_Peripheral.kicad_sch]
2025-05-07 Fixed Layout errors
    Fixed Solder mask expansion errors
    Added signature on board
    [EPS_Scales_RevC.kicad_pcb]
2025-05-08 Revisions to PCB
    Layout has been shrunk, tracks cleaned up, and power plane added.
    [EPS_Scales_RevC.kicad_pcb]
2025-05-08 Update to PCB and minor changes to schematic
    Completed the RP2350 layout. Put in the edge cut that should match the IMX flight board.
    Had to rewire the Ethernet ports but finished one just need to copy and paste it to the others. Once that is done and connected to the Wiznet I can move to the switch.
    [RJ45_1.kicad_sch, RJ45_SW_1.kicad_sch, Wiznet.kicad_sch, newethernet.kicad_sch, peripheral_board.kicad_pcb, peripheral_board.kicad_sch, rp.kicad_sch]
2025-05-09 Minor Updates
    Shortened board even more!
    [EPS_Scales_RevC.kicad_pcb]
2025-05-09 Checked the schematic and made edits to PCB
    Looked through Wiznet's GitHub to get a better understand how to connect it to RP2350.
    Did the basic layout of the board with the RJ45 and the DF11.
    The ethernet switch chip needs to be connected with its decoupling caps and then lastly the RJ45 need to be connected to their respective chips.
    [Wiznet.kicad_sch, newethernet.kicad_sch, peripheral_board.kicad_pcb, peripheral_board.kicad_sch]
2025-05-12 Updates to the Ethernet switch
    Made a change to power to the ethernet switch. The original was thermally regulated so I moved to using one that was similar for the raspberry pi.
    Started putting some of the resistors and LEDs for debugging on the chip.
    Leaving the decoupling capacitors till later to make sure they are attached to the correct pins.
    Needed to add some symbols and libraries back to the project.
    [Wiznet.kicad_sch, newethernet.kicad_sch, peripheral_board.kicad_pcb, peripheral_board.kicad_sch]
2025-05-13 Update to schematic and worked on PCB
    Made a few changes with signals for the ethernet switch schematic. Made it easier for the traces for power.
    Put all the decoupling capacitors onto the ethernet switch chip on the PCB. Was able to route the traces for the Wiznet. Might want to change where the signals are. Want to look into maybe making the 2 or 3 plane as a signal plane for just the ethernet to ensure direct connections.
    Just need to connect the power of 1.2 volts that the ethernet switch needs and then will be able to route the 4 other ethernet switches. I am being sure to use the pair routing for the length.
    Side note figured out how to add images as a layer, which is fun!
    [RJ45_1.kicad_sch, RJ45_SW_1.kicad_sch, RK45_SW_2.kicad_sch, RK45_SW_3.kicad_sch, RK45_SW_4.kicad_sch, Wiznet.kicad_sch, newethernet.kicad_sch, peripheral_board.kicad_pcb]
2025-05-15 Update to the PCB
    Did the signal paths for the Ethernet switch. Need to put in the pathing for the 1.2V analog and digital for the switch.
    Need to finish some other signal connections for the DF11 and some of the test LEDs.
    Once that is in place I will finish the fills and the board will be complete for a review.
    *Disclaimer:* I am not too sure about the placement of the ethernet signals. I am thinking of taking them off the back plane and putting it on the dedicated ground plane.
    [RK45_SW_3.kicad_sch, Wiznet.kicad_sch, newethernet.kicad_sch, peripheral_board.kicad_pcb, peripheral_board.kicad_sch]
2025-05-16 Finished the PCB
    Finished the PCB.
    I will say the traces and fills are not pretty but I am pretty sure that it is good.
    Everything should be connected to either with traces or with vias. I made a change to the Planes by labeling them.
    [Wiznet.kicad_sch, newethernet.kicad_sch, peripheral_board.kicad_pcb, peripheral_board.kicad_sch, rp.kicad_sch]
2025-05-19 Updated PCB, Updated BOM
    Added BOM Components
    Changed 1210 22p Cap to 1206
    Added images to board.
    [EPS_Scales_RevC.kicad_pcb, EPS_Scales_RevC.kicad_sch, JetsonSubsystem.kicad_sch, OBC_Subsystem.kicad_sch, Peripheral_Subsystem.kicad_sch]
2025-05-19 Updated Shematic
    Added Conn. Ops
    [EPS_Scales_RevC.kicad_sch]
2025-05-20 Schematic Updates
    Added pictures, and reorganized a bit of the layout
    [EPS_Scales_RevC.kicad_sch]
2025-05-20 Updated PCB
    Added rounded corners.
    Fixed Clearance problem on a capacitor
    [EPS_Scales_RevC.kicad_pcb]
2025-05-21 Cleaned up Board
    Removed DRC errors due to constraint inconsistencies with pre-defined via and track sizes.
    Removed Annular Ring error from the DRC, had to allow for 0mm ring size, this is due to the RJ45 footprints.
    [peripheral_board.kicad_pcb]
2025-05-21 Removed the stripped proves kit
    Removing the extra proves kit file from the project since it is no longer need as a direct reference. The file and project can be grab if needed for anything else.
    [1042.stp, 1043.stp, 1049.stp, 504050-0291.step, 504050-0291.stp, 504050-0591.stp, 504050-1291.stp, 5040500791.step]
2025-05-22 Fixed Ugly Trace
    [EPS_Scales_RevC.kicad_pcb]
2025-05-22 LTC 4300A Replaced with TCA4307
    Due to stock constraints the LTC4300A must be replaced with the TCA4307 from TI
    [EPS_Scales_RevC.kicad_pcb, EPS_Scales_RevC.kicad_sch, OBC_Subsystem.kicad_sch]
2025-05-22 IMX8 Board Revisions
    Started updating the libraries to be project specific instead of global, that way the project libraries are pushed with it and not lost in translation. WIP
    [imx8x_carrier_v1.kicad_sch, imx_SPI_UART.kicad_sch, imx_power.kicad_sch]
2025-05-23 IMX8 Schematic Changes
    Reimported all Symbols and Footprints to use local project libraries.
    Began cleaning up and reorganizing schematic for the IMX board
    Added documentation on notion for next development steps and what components to decide and select
    Nothing done on the EPS
    [SOM.kicad_sch, debug_usb.kicad_sch, imx8x_carrier_v1.kicad_sch, imx_SPI_UART.kicad_sch, imx_ethernet.kicad_sch, imx_microSD.kicad_sch, imx_power.kicad_sch, miscellaneous.kicad_sch]
2025-05-26 EPS Changes
    Updated Mounting hole size from 2.6mm to 2.5mm
    [EPS_Scales_RevC.kicad_sch]
2025-05-26 IMX8 Board Updates
    Cleaned up SD Card portion. Committing so I can continue working on my desktop
    [EPS_Scales_RevC.kicad_pcb, imx8x_carrier_v1.kicad_sch, imx_microSD.kicad_sch]
2025-05-26 minor fixes to port to new branch
    [debug_usb.kicad_sch]
2025-05-26 Reformatted Schematic Sheets
    Fixed up connections for:
    Ethernet
    SOM Connectors
    Misc.
    Debugger
    [SOM.kicad_sch, debug_usb.kicad_sch, imx8x_carrier_v1.kicad_sch, imx_ethernet.kicad_sch, miscellaneous.kicad_sch]
2025-05-27 Little Changes before Changing Everything again
    [EPS_Scales_RevC.kicad_pcb, EPS_Scales_RevC.kicad_sch]
2025-05-27 Fun times
    Horrendous cleanup. Kill me
    [EPS_Scales_RevC-CuBottom.gbr, EPS_Scales_RevC-CuIn1.gbr, EPS_Scales_RevC-CuIn2.gbr, EPS_Scales_RevC-CuTop.gbr, EPS_Scales_RevC-EdgeCuts.gbr, EPS_Scales_RevC-MaskBottom.gbr, EPS_Scales_RevC-MaskTop.gbr, EPS_Scales_RevC-NPTH.drl]
2025-05-28 Updated to PCB layout
    Made changes to the layout. Made it so there are only 2 sides of ports for the RJ45 connectors.
    Completed the BOM for the board. Leaving the JTAG as just pads for dev purposes.
    Started the error checking for the the board. All but 2 errors and the rest warnings but mainly placement based.
    Should be a cleaner version.
    [RJ45_1.kicad_sch, RJ45_SW_1.kicad_sch, RK45_SW_2.kicad_sch, RK45_SW_3.kicad_sch, RK45_SW_4.kicad_sch, Wiznet.kicad_sch, newethernet.kicad_sch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]
2025-05-28 Standardized Libraries
    Imported EasyEDA LIbraries directly to the project folders using the python environment. Finally for fucks sake I got the hang of it.
    [EPS_Scales_RevC.kicad_sch, JetsonSubsystem.kicad_sch, OBC_Subsystem.kicad_sch, Peripheral_Subsystem.kicad_sch, WD_OBC.kicad_sch]
2025-05-28 Update to schematic and readme
    Made the schematic root page have more info and be a better block diagram.
    Updated the readme with some more general info on the board and what it is based on.
    [Wiznet.kicad_sch, newethernet.kicad_sch, peripheral_board.kicad_sch]
2025-05-28 Implemented New Components
    Added TPS1H80B
    Added LT8612
    Implemented OBC Control Enable via pull up on EN pin on the TPS.
    SS pins have slew rates for delay in power surges for each component. Symbols and Footprints moved into project folder for new components
    [EPS_Scales_RevC.kicad_sch, JetsonSubsystem.kicad_sch, OBC_Subsystem.kicad_sch, Peripheral_Subsystem.kicad_sch, WD_Jetson.kicad_sch, WD_Peripheral.kicad_sch, WD_Peripheral_board.kicad_sch]
2025-05-28 Added WD Crowbar Redundancy
    Since each WD reset toggles the whole subsystem, the WD must be held high for 2-3s after the reset cycle to allow the EN pin of the load switch to turn on the subsystem. Or else the OBC must manually enable each subsystem.
    [WD_Jetson.kicad_sch, WD_OBC.kicad_sch, WD_Peripheral_board.kicad_sch]
2025-05-29 Fixed this POS, it accidentally removed my stuff
    [JetsonSubsystem.kicad_sch, OBC_Subsystem.kicad_sch, Perif_EPS.kicad_sch, Perif_Subsystem.kicad_sch, Peripheral_Subsystem.kicad_sch, WD_Perif.kicad_sch, WD_Peripheral.kicad_sch]
2025-05-29 Finally Fixed Schematic Dissapearing Problems
    WIP!
    [JetsonSubsystem.kicad_sch, OBC_Subsystem.kicad_sch, Perif_Subsystem.kicad_sch]
2025-05-29 minor changes
    [JetsonSubsystem.kicad_sch, Perif_Subsystem.kicad_sch]
2025-05-29 Renamed and Updated Project to RevD
    [EPS_Scales_RevD-CuBottom.gbr, EPS_Scales_RevD-CuIn1.gbr, EPS_Scales_RevD-CuIn2.gbr, EPS_Scales_RevD-CuTop.gbr, EPS_Scales_RevD-EdgeCuts.gbr, EPS_Scales_RevD-MaskBottom.gbr, EPS_Scales_RevD-MaskTop.gbr, EPS_Scales_RevD-NPTH.drl]
2025-05-29 Updated Project History
    RevA through RevD directly accessible to see project revisions
    [JetsonSubsystem.kicad_sch, OBC_Subsystem.kicad_sch, Perif_EPS.kicad_sch, Perif_Subsystem.kicad_sch, Peripheral_Subsystem.kicad_sch, WD_Jetson.kicad_sch, WD_OBC.kicad_sch, WD_Perif.kicad_sch]
2025-05-29 Updated .sch names
    [.kicad_sch, OBC_EPS.kicad_sch, Perif_Subsystem.kicad_sch]
2025-05-29 Revert "Updated .sch names"
    This reverts commit 74cd391a8fa3c918ce36f01b2b9573e3d642e9f0.
    [.kicad_sch, OBC_EPS.kicad_sch, Perif_Subsystem.kicad_sch, WD_Peripheral_board.kicad_sch]
2025-05-29 File Cleanup Correctly
    [OBC_EPS.kicad_sch, WD_Peripheral_board.kicad_sch]
2025-05-29 Lots of Goodies
    Updated Con. Ops
    Updated Footprint Assignments for R and C, WIP
    Fixed Incorrect Resistor Values
    Updated footprints for LEDs
    [EPS_Scales_RevD.kicad_pcb, JetsonSubsystem.kicad_sch, OBC_Subsystem.kicad_sch, Perif_Subsystem.kicad_sch, WD_Jetson.kicad_sch, WD_Perif.kicad_sch]
2025-05-30 Made updates to PCB based on review
    Tried to put ground between the ethernet signals but it didn't work ;(
    Need to relook at the BOM before moving to place the order.
    Need to look through Luca's board to ensure I have the same DF11 pin placement for power.
    [peripheral_board.kicad_pcb]
2025-05-30 More Goodies
    Updated Inductor footprints with most readily available LCSC counterparts
    Updated XT-60 connector
    Updated Edge-Cuts board size
    Updated Diode Footprints to fix DRC errors
    Started Board layout and copper fills for power and ground
    [EPS_Scales_RevD.kicad_pcb, JetsonSubsystem.kicad_sch, OBC_Subsystem.kicad_sch, Perif_Subsystem.kicad_sch, WD_Jetson.kicad_sch, WD_OBC.kicad_sch, WD_Perif.kicad_sch]
2025-05-30 Layout.....
    Pain
    [EPS_Scales_RevD.kicad_pcb]
2025-05-30 MInor PCB Layout Updates
    Started Routing the jetson subsystem
    [EPS_Scales_RevD.kicad_pcb]
2025-05-31 Updates for JLC
    [peripheral_board.kicad_pcb]
2025-06-02 Changes for the production files
    [peripheral_board-CuBottom.gbr, peripheral_board-CuIn1.gbr, peripheral_board-CuIn2.gbr, peripheral_board-CuTop.gbr, peripheral_board-EdgeCuts.gbr, peripheral_board-MaskBottom.gbr, peripheral_board-MaskTop.gbr, peripheral_board-NPTH.drl]
2025-06-02 Board Layout complete
    Its a bit messy but I think ive managed to get the loop areas small enough, and the board to represent what is on the schematic. Probably would be a good idea to get a look at it from someone more reputable than myself on how this board should be layed out.
    [EPS_Scales_RevD.kicad_pcb, OBC_Subsystem.kicad_sch, Perif_Subsystem.kicad_sch, WD_OBC.kicad_sch]
2025-06-03 Updated with JLC requirements
    [EPS_Scales_RevD.kicad_pcb]
2025-06-03 Cleaned up Layout
    Fixed to work with JLC recommendations. Prepping for review with Andrew
    [EPS_Scales_RevD.kicad_pcb]
2025-06-03 Added some more things to Layout
    Added XT-60 Female Right Angle connector
    Added 3d models to almost every component
    Added meme image to board.
    Board is complete. Awaiting review with Andrew Greenberg @2pm
    [EPS_Scales_RevD.kicad_pcb]
2025-06-03 Moved XT-60 Connector
    Rearranged some things to better suit what giselle needed for the model
    [EPS_Scales_RevD.kicad_pcb]
2025-06-03 Fixed fill zone
    ^
    [EPS_Scales_RevD.kicad_pcb]
2025-06-03 Fixes of part selection for the board and generating the files
    [Wiznet.kicad_sch, newethernet.kicad_sch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]
2025-06-03 Revert "Revert "prep to transfer to docs repo""
    This reverts commit a3a901247cace750a207385ef1c305f9f14b8320.
    modified: docs/imx8x_procedures.md
    new file: docs/imx_yocto_bsp.md
    new file: docs/power_system.md
    new file: docs/scales_demo.md
    modified: mkdocs.yml
2025-06-03 Schematic and PCB Cleanup
    After a fairly eventful review with Andrew it is time for some schematic cleanup, PCB cleanup and a well earned break. Tomorrow my goal is to knock out the full Schematic Cleanup, which im almost done with, I just need to redo the jetson portion and then im done. And then for the PCB, theres some minor things like removing components that were removed in the schematic, adding more vias, and then changing some fill parameters. After that I need to do the BOM and the production files. John and I will order the boards tomorrow (HOPEFULLY)
    [EPS_Scales_RevD.kicad_pcb, JetsonSubsystem.kicad_sch, OBC_Subsystem.kicad_sch, Perif_Subsystem.kicad_sch, WD_Jetson.kicad_sch, WD_Perif.kicad_sch]
2025-06-04 Final Updates for REV1
    Last updates for JLC order.
    [Wiznet.kicad_sch, newethernet.kicad_sch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]
2025-06-04 Big Changes
    Schematic legibility overhaul
    Symbols have had pin numbers reduced to have easier legibility, the footprints have had pins renamed to the same pin numbers because pin hiding doesnt work yet in Kicad, grrr.
    Some redundancies were removed and the layout was cleaned up as well.
    The correct xt-60 symbol was added and I fixed the pin numbering as well.
    [EPS_Scales_RevD.kicad_pcb, JetsonSubsystem.kicad_sch, OBC_Subsystem.kicad_sch, Perif_Subsystem.kicad_sch, WD_Jetson.kicad_sch, WD_OBC.kicad_sch, WD_Perif.kicad_sch]
2025-06-04 Production Files Generated for RevD
    Beating a dead horse at this point. Should be done
    [EPS_Scales_RevD-CuBottom.gbr, EPS_Scales_RevD-CuIn1.gbr, EPS_Scales_RevD-CuIn2.gbr, EPS_Scales_RevD-CuTop.gbr, EPS_Scales_RevD-EdgeCuts.gbr, EPS_Scales_RevD-MaskBottom.gbr, EPS_Scales_RevD-MaskTop.gbr, EPS_Scales_RevD-NPTH.drl]
2025-06-04 Added some more vias, Production files remade
    [EPS_Scales_RevD-CuBottom.gbr, EPS_Scales_RevD-CuIn1.gbr, EPS_Scales_RevD-CuIn2.gbr, EPS_Scales_RevD-CuTop.gbr, EPS_Scales_RevD-EdgeCuts.gbr, EPS_Scales_RevD-MaskBottom.gbr, EPS_Scales_RevD-MaskTop.gbr, EPS_Scales_RevD-NPTH.drl]
2025-06-04 Fixed Missing LCSC Components and Some Footprint errors for Production
    Had to swap out the tantalum 10v caps because they would explode on the 10v line. No 25v tantalums were in stock so I went with electrolytics for now. Ready for production.
    [EPS_Scales_RevD-CuBottom.gbr, EPS_Scales_RevD-CuIn1.gbr, EPS_Scales_RevD-CuIn2.gbr, EPS_Scales_RevD-CuTop.gbr, EPS_Scales_RevD-EdgeCuts.gbr, EPS_Scales_RevD-MaskBottom.gbr, EPS_Scales_RevD-MaskTop.gbr, EPS_Scales_RevD-NPTH.drl]
2025-06-04 Labeled all the connections on the SOM
    Put all the global labels on the SOM. Followed the two data sheets to have the resistors, test points and capacitors on it.
    [SOM.kicad_sch]
2025-06-05 Signal1 Fill and Signal2 Fills Added
    Fixed DFM Error in manufacturing process due to lack of fills to seperate tracks.
    [EPS_Scales_RevD-CuBottom.gbr, EPS_Scales_RevD-CuIn1.gbr, EPS_Scales_RevD-CuIn2.gbr, EPS_Scales_RevD-CuTop.gbr, EPS_Scales_RevD-EdgeCuts.gbr, EPS_Scales_RevD-MaskBottom.gbr, EPS_Scales_RevD-MaskTop.gbr, EPS_Scales_RevD-NPTH.drl]
2025-06-05 Fixed some fill errors
    Regenerated production files
    [EPS_Scales_RevD-CuBottom.gbr, EPS_Scales_RevD-CuIn1.gbr, EPS_Scales_RevD-CuIn2.gbr, EPS_Scales_RevD-CuTop.gbr, EPS_Scales_RevD-EdgeCuts.gbr, EPS_Scales_RevD-MaskBottom.gbr, EPS_Scales_RevD-MaskTop.gbr, EPS_Scales_RevD-NPTH.drl]
2025-06-05 Schematic Updated
    Fixed up TOC
    Added SPI
    Added UART
    Added I2C
    These can be added or removed later, but figured it would be good to have for the development board.
    All of this informatin is included in the Notion under the SCALES carrier board page.
    [Backup_Power.kicad_sch, SOM.kicad_sch, imx8x_carrier_v1.kicad_sch]
2025-06-06 Changes to the PCB
    ##Brief list of what I changed:
    1. Changed all the via sizes to be 0.6/0.3 mm which lead to me having to reroute a some things
    2. Changed the trace width to be a bit larger for some signals to see if that would be better instead of the smaller traces I had prior.
    3. In rerouting I wanted to see if different configurations of the RJ45 connections would be better.
    4. Modified some of the fill zones to eliminate traces.
    ##Overall summary:
    Changed via and track sizes because JLC said that I had some errors on my board that need further changes/testing which increased the price. Some of these changes required me to reroute to where I wanted to try and use larger trace sizes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
    [peripheral_board.kicad_pcb]
2025-06-10 Minor changes for the board
    Added some references and notes to the board.
    Notes on things that we should maybe remove them.
    Added a simple version of SPI and QSPI.
    [imx8x_carrier_v1.kicad_sch, imx_SPI_UART.kicad_sch, imx_microSD.kicad_sch]
2025-06-10 Updated for Workflow
    Updated SOM pins with used/unused pins
    Added A-B pins symbol and C-D pins symbol
    Fixed sheet names due to copy pasting and duplication problems.
    [SOM.kicad_sch, imx8x_carrier_v1.kicad_sch, imx_I2C.kicad_sch, imx_SPI.kicad_sch, imx_UART.kicad_sch]
2025-06-10 Added minor things
    WIP
    [imx8x_carrier_v1.kicad_sch, imx_UART.kicad_sch]
2025-06-10 Schematic Updates
    WIP.
    SOM Connector global labels have been updated.
    Commit to update remote. Disregard.
    [SOM.kicad_sch, imx8x_carrier_v1.kicad_sch, imx_UART.kicad_sch, imx_power.kicad_sch]
2025-06-10 Updated Schematic
    Working on Micro SD card connector.
    Working on implementing power connector. Still uncertain about some things I still need to implement. WIP
    [Backup_Power.kicad_sch, SOM.kicad_sch, imx8x_carrier_v1.kicad_sch, imx_microSD.kicad_sch, imx_power.kicad_sch]
2025-06-11 Schematic Updates
    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
    [SOM.kicad_sch, debug_usb.kicad_sch, imx8x_carrier_v1.kicad_sch, imx_I2C.kicad_sch, imx_SPI.kicad_sch, imx_ethernet.kicad_sch, imx_microSD.kicad_sch, imx_power.kicad_sch]
2025-06-11 Power System Documentation and Housekeeping
    Rearranged some files and included the notion documentation on the github. Most image embeds dont work directly into github for some reason so ive linked them to the images in the notion. Annoying work around but its enough to get the point across.
2025-06-11 Restructure of the branch
    Did some housekeeping of this branch. Made it more clean and updated documentation.
    [RJ45_1.kicad_sch, RJ45_SW_1.kicad_sch, RK45_SW_2.kicad_sch, RK45_SW_3.kicad_sch, RK45_SW_4.kicad_sch, RK45_SW_5.kicad_sch, Wiznet.kicad_sch, ethernet_switch.kicad_sch]
2025-06-11 Added things to Ethernet Schematic
    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
    [SOM.kicad_sch, debug_usb.kicad_sch, imx_ethernet.kicad_sch, imx_microSD.kicad_sch, miscellaneous.kicad_sch]
2025-06-12 Schematic Updates
    Added Voltage regulators for ENET, both 1v and 2.5v
    Corrected power symbols.
    Added footprints and 3d models for voltage regulators.
    Schematic is nearly complete. Maybe a thorough review with John is required to make sure weve done everything correctly.
    [SOM.kicad_sch, debug_usb.kicad_sch, imx_I2C.kicad_sch, imx_ethernet.kicad_sch, imx_microSD.kicad_sch, miscellaneous.kicad_sch]
2025-06-12 More Updates
    More Schematic cleanup and verifying power symbols and such, still have some issues with referencing an old library that I removed a while back.
    Added 3d models for every single component so the board preview looks pretty cool. Also I added footprints to some components that were missing some. Last thing to do for those is to add courtyards because some of them dont have them.
    [debug_usb.kicad_sch, imx8x_carrier_v1.kicad_pcb, imx8x_carrier_v1.kicad_sch, imx_I2C.kicad_sch, imx_SPI.kicad_sch, imx_ethernet.kicad_sch, imx_microSD.kicad_sch, imx_power.kicad_sch]
2025-06-13 MInor changes to peripherals
    Added some new peripherals to the board with different connections to ensure redundancy. Need to fix the SOM labels.
    [SOM.kicad_sch, imx8x_carrier_v1.kicad_sch, imx_SPI.kicad_sch]
2025-06-13 SOM signal finished
    Finished labeling the SOM. Handing the board off to Luca to go and configure the rest of the board and look over the rest of the schematic.
    Need to finish the SOM with pull up/down or ground any unused signals.
    [SOM.kicad_sch]
2025-06-14 Update to Schematic
    Did some overview of the schematic and did some touch ups. There are still some GPIOs that need to wired to pins.
    All signals should be named correctly and connected the same.
    Will need a document review before PCB layout.
    [SOM.kicad_sch, debug_usb.kicad_sch, imx8x_carrier_v1.kicad_sch, imx_SPI.kicad_sch, imx_ethernet.kicad_sch, imx_power.kicad_sch, miscellaneous.kicad_sch]
2025-06-17 Created RevE to address current issues with RevD
    Upon recieving the RevD/Viking 1-A Board on June 16th 2025, there are some glaring issues in the board that cause DOA conditions when applying default operating conditions. The RevE version will be improved to by pass these errors and achieve a working board.
    [EPS_Scales_RevE-CuBottom.gbr, EPS_Scales_RevE-CuIn1.gbr, EPS_Scales_RevE-CuIn2.gbr, EPS_Scales_RevE-CuTop.gbr, EPS_Scales_RevE-EdgeCuts.gbr, EPS_Scales_RevE-MaskBottom.gbr, EPS_Scales_RevE-MaskTop.gbr, EPS_Scales_RevE-NPTH.drl]
2025-06-17 WIP
    Removed pull up resistor to I2C buffer. Fixed R66 in OBC Subsystem causing 10v output instead of 3.3v
    [JetsonSubsystem.kicad_sch, OBC_Subsystem.kicad_sch, Perif_Subsystem.kicad_sch]
2025-06-17 New Revision: RevE Schematic / Viking 1-B
    Fixed incorrect resistor in OBC Subsystem
    Fixed fault indication LED in TPS in OBC Subsystem
    Increased Soft Start time to 1s for Switching regulator for OBC Subsystem. Added LCSC part # for that capacitor.
    Fixed Inductor value calculation for Switching regulator. Updated its LCSC part number for the proper inductor.
    Changed Capacitors on the watch dog circuit to 100uf Tantalums. Despite lower capacitances, they can still assert the low long enough. Switching these for flight readiness.
    Updated all capacitor and resistor LCSC numbers to those that are readily available, also shrunk a vast majority of excessively large components to 0402s. for the same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
    [EPS_Scales_RevE.kicad_pcb, JetsonSubsystem.kicad_sch, OBC_Subsystem.kicad_sch, Perif_Subsystem.kicad_sch, WD_Jetson.kicad_sch, WD_OBC.kicad_sch, WD_Perif.kicad_sch]
2025-06-18 RevE/Viking 1-B WIP
    Grinding the same fucking board.
    [EPS_Scales_RevE.kicad_pcb, WD_OBC.kicad_sch]
2025-06-18 Updated a Variety of Datasheets
    [debug_usb.kicad_sch, imx8x_carrier_v1.kicad_pcb, imx_ethernet.kicad_sch, imx_microSD.kicad_sch]
2025-06-18 Assigned Majority of Component Footprints
    All passives are currently assigned as 0603
    [SOM.kicad_sch, debug_usb.kicad_sch, imx8x_carrier_v1.kicad_pcb, imx_I2C.kicad_sch, imx_ethernet.kicad_sch, imx_microSD.kicad_sch, imx_power.kicad_sch, miscellaneous.kicad_sch]
2025-06-18 Initial Layout of ETH PHY Peripherals
    [imx8x_carrier_v1.kicad_pcb, imx_ethernet.kicad_sch]
2025-06-18 Initial Placement Layout of ETH PHY Decoupling Caps
    We will probably need to assemble these on the bottom of the board to clear space for the Ethernet Traces on the top
    [imx8x_carrier_v1.kicad_pcb, imx_ethernet.kicad_sch]
2025-06-18 REV E / Viking 1-B Complete
    Shrunk down many component sizes
    Fixed ST pin with pull down LED to a (hopefully functional one)
    Fixed Inductor values from incorrect calculations
    Fixed incorrect resistor values for OBC subsystem
    Redid layout and routing
    Watch dog routing has been redone
    Changed the 220uf electrolytics to 100uf tantalums for the watch dog
    Created CPL and BOM files as well.
    [EPS_Scales_RevE-CuBottom.gbr, EPS_Scales_RevE-CuIn1.gbr, EPS_Scales_RevE-CuIn2.gbr, EPS_Scales_RevE-CuTop.gbr, EPS_Scales_RevE-EdgeCuts.gbr, EPS_Scales_RevE-MaskBottom.gbr, EPS_Scales_RevE-MaskTop.gbr, EPS_Scales_RevE-NPTH.drl]
2025-06-18 Minor additions
    Added Copper fills to top layer
    Exported new production files
    [EPS_Scales_RevE-CuBottom.gbr, EPS_Scales_RevE-CuIn1.gbr, EPS_Scales_RevE-CuIn2.gbr, EPS_Scales_RevE-CuTop.gbr, EPS_Scales_RevE-EdgeCuts.gbr, EPS_Scales_RevE-MaskBottom.gbr, EPS_Scales_RevE-MaskTop.gbr, EPS_Scales_RevE-NPTH.drl]
2025-06-19 Updated BOM and some schematic values
    [EPS_Scales_RevE-CuBottom.gbr, EPS_Scales_RevE-CuIn1.gbr, EPS_Scales_RevE-CuIn2.gbr, EPS_Scales_RevE-CuTop.gbr, EPS_Scales_RevE-EdgeCuts.gbr, EPS_Scales_RevE-MaskBottom.gbr, EPS_Scales_RevE-MaskTop.gbr, EPS_Scales_RevE-NPTH.drl]
2025-06-19 Fixed Small Layout Problem with VD
    Didnt want to redo layout so instead I added a resistor to drop some voltage
    [EPS_Scales_RevE.kicad_pcb, WD_Jetson.kicad_sch, WD_OBC.kicad_sch, WD_Perif.kicad_sch]
2025-06-19 Layout Improvements and Fixes
    Added workaround for 0402 10v limitation for 10uf caps.
    Added 10uH inductor for Perif board to work around 9.1uh inductor stock limitations.
    Replaced 1N4151WS diodes with 1N4444WS due to stock limitations.
    Ready for PR
    [EPS_Scales_RevE-CuBottom.gbr, EPS_Scales_RevE-CuIn1.gbr, EPS_Scales_RevE-CuIn2.gbr, EPS_Scales_RevE-CuTop.gbr, EPS_Scales_RevE-EdgeCuts.gbr, EPS_Scales_RevE-MaskBottom.gbr, EPS_Scales_RevE-MaskTop.gbr, EPS_Scales_RevE-NPTH.drl]
2025-06-19 Slight mistake with something on the WD circuit. Corrected
    Used a voltage divider but added a 10k in parallel so voltage level dropped too much. Fixed.
    [EPS_Scales_RevE-CuBottom.gbr, EPS_Scales_RevE-CuIn1.gbr, EPS_Scales_RevE-CuIn2.gbr, EPS_Scales_RevE-CuTop.gbr, EPS_Scales_RevE-EdgeCuts.gbr, EPS_Scales_RevE-MaskBottom.gbr, EPS_Scales_RevE-MaskTop.gbr, EPS_Scales_RevE-NPTH.drl]
2025-06-20 Minor KiCad Changes
    Combing through my KiCad Design and making sure that everything is up to standard.
    Board seems to be a bit off and doesn't seem to to be working correctly.
    There are a couple things to note.
    For the Wiznet there are different configurations that seem to me that were unclear and require a closer look.
    For the Ethernet Switch I need to make sure it is being power correctly and I might need to had in the other ethernet switch to ensure that it works as intended because the 5th port I left open but the switch does not seem to work.
    [Wiznet.kicad_sch, newethernet.kicad_sch, rp.kicad_sch]
2025-06-20 Minor manufacturing issue
    Added Fills on power plane and signal2 plane.
    [EPS_Scales_RevE-CuBottom.gbr, EPS_Scales_RevE-CuIn1.gbr, EPS_Scales_RevE-CuIn2.gbr, EPS_Scales_RevE-CuTop.gbr, EPS_Scales_RevE-EdgeCuts.gbr, EPS_Scales_RevE-MaskBottom.gbr, EPS_Scales_RevE-MaskTop.gbr, EPS_Scales_RevE-NPTH.drl]
2025-06-20 Laid Out SD Card
    Also tried fixing some of the power flags. There is still an issue with VCC_LDO_SD1
    [imx8x_carrier_v1.kicad_pcb, imx_microSD.kicad_sch]
2025-06-20 Put Decoupling Caps next to SOM connector
    [imx8x_carrier_v1.kicad_pcb]
2025-06-20 Moved Connectors Around
    [SOM.kicad_sch, imx8x_carrier_v1.kicad_pcb]
2025-06-21 Update to the board
    Changed the WIZNET configuration to match that of the Pico2 eval board.
    Changed the some names and some layout of the page. Not too much besides copying, reading as to why it is they way they made it and then applying.
    [RJ45_1.kicad_sch, RJ45_SW_1.kicad_sch, RK45_SW_2.kicad_sch, RK45_SW_3.kicad_sch, RK45_SW_4.kicad_sch, Wiznet.kicad_sch, newethernet.kicad_sch, rp.kicad_sch]
2025-06-23 Updated Schematic. WIP
    Cross referenced connections from pinmux to dev schematic to this schematic. Made sure every connection has been made, there are a few that are miscellanous that have to be sorted.
    [SCALES i.MX8QXP SOM config_pinmux.xlsx, SOM.kicad_sch, debug_usb.kicad_sch, imx_I2C.kicad_sch, imx_SPI.kicad_sch, imx_ethernet.kicad_sch, imx_microSD.kicad_sch, miscellaneous.kicad_sch]
2025-06-24 Update to the PCB
    #Changes made so far
    ## Wiznet
    * Changed the Wiznet layout to match that of their development board
    * Restructured the RJ45 connections
    * *Looked over the RJ45 still a unsure*
    * Added in 2 differnt versions of Ethernt Connections. The one that shows the magnetics might be used for the Ethernet switch.
    * Removed the Single Bus Buffer gate with 3-state output to match the dev board
    ## Raspberry Pi
    * Moved to USB type C from micro USB for debugging.
    * Changed the GPIO pins to match the Wiznet dev board.
    * Brought in breakout pins for the rest of the GPIO.
    * Cleaned up the Schematic to make it more clean.
    ## Ethernet Switch
    * Changed the crystal to be the same as the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
    [RJ45_1.kicad_sch, RJ45_SW_1.kicad_sch, RK45_SW_2.kicad_sch, RK45_SW_3.kicad_sch, RK45_SW_4.kicad_sch, Wiznet.kicad_sch, newethernet.kicad_sch, peripheral_board.kicad_sch]
2025-06-24 Schematic Complete
    The IMX8X Scales carrier board is done being finalized. Cleaned up lots of things. This updated schematic should be ready for a full layout and track routing process. Only ERC errors are pin types which we dont really care about. All capacitor voltages have been reincluded since they were cleared by a kicad bug.
    [SOM.kicad_sch, debug_usb.kicad_sch, imx8x_carrier_v1.kicad_sch, imx_I2C.kicad_sch, imx_SPI.kicad_sch, imx_ethernet.kicad_sch, imx_microSD.kicad_sch, imx_power.kicad_sch]
2025-06-24 Added Gecko Variant of PCB. Identical Layouts Except for Connectors
    [EPS_Scales_RevE-CuBottom.gbr, EPS_Scales_RevE-CuIn1.gbr, EPS_Scales_RevE-CuIn2.gbr, EPS_Scales_RevE-CuTop.gbr, EPS_Scales_RevE-EdgeCuts.gbr, EPS_Scales_RevE-MaskBottom.gbr, EPS_Scales_RevE-MaskTop.gbr, EPS_Scales_RevE-NPTH.drl]
2025-06-24 Updated Gecko Variant
    Fixed missing 3d model.
    [EPS_Scales_RevE_GECKOS.kicad_pcb]
2025-06-24 small update
    [EPS_Scales_RevE_GECKOS.kicad_pcb]
2025-06-24 Minor Schematic Changes. OK OK its technically done. Time for Layout
    [SOM.kicad_sch, debug_usb.kicad_sch, imx8x_carrier_v1.kicad_pcb, imx8x_carrier_v1.kicad_sch, imx_I2C.kicad_sch, imx_SPI.kicad_sch, imx_ethernet.kicad_sch, imx_microSD.kicad_sch]
2025-06-25 Updated to the schematic
    Kicad died on me so I needed to readd all my libraries to the project.
    Added in the the Power board connector but want to go over it to make sure it will be implemented correctly. It is currently excluded.
    Looked through the SALAD board and I had the same layout but I guess I did something wrong with selection of and or placement of signals traces. Added back in the single bus buffer, jumpers for changing the pmode and the filtering of the power and ground. It is currently excluded. Wiznet RJ45 connection is done.
    Still going through the ethernet switch but found more info on the strap in mode. It is configured from the LED signals. The design guide has some speci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
    [RJ45_1.kicad_sch, RJ45_SW_1.kicad_sch, Wiznet.kicad_sch, newethernet.kicad_sch, rp.kicad_sch]
2025-06-25 Board Layout WIP
    [imx8x_carrier_v1.kicad_pcb, imx8x_carrier_v1.kicad_sch, imx_I2C.kicad_sch, imx_ethernet.kicad_sch]
2025-06-26 Layout WIP
    [imx8x_carrier_v1.kicad_pcb]
2025-06-26 Schematic design ready for review
    Made the last changes for the Wiznet by adding in Dip switches and made sure that the interrupt and reset signals are attached to the raspberry pi.
    Finished the Etherent switch by wiring the RJ45 port 1 with 2 configurations, leaning more towards not using the Wiznet port but might do it any ways for cost. Added test points to port 5 but might change it to be RMII configuration because the 4 port strap in mode sets it to that config. Put solder jumpers in for the LED strap in mode. On the schematic I put in a note about how to configure to the proper mode we want but after a review will change to be a hardwire set. Made the reset switch match that of the EV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
    [RJ45_1.kicad_sch, RJ45_SW_1.kicad_sch, RK45_SW_2.kicad_sch, RK45_SW_3.kicad_sch, RK45_SW_4.kicad_sch, Wiznet.kicad_sch, newethernet.kicad_sch, peripheral_board.kicad_sch]
2025-06-26 Routing WIP
    [SOM.kicad_sch, imx8x_carrier_v1.kicad_pcb]
2025-06-26 Still Routing. :/ WIP
    [imx8x_carrier_v1.kicad_pcb]
2025-06-27 Started the PCB layout
    Finished the schematic. Now working on the PCB. Might looking in to moving to a 6 layer board.
    Need to do a bit of redesign because changing some of the parts had different footprints.
    Started on the Wiznet and the its RJ45 port it has. Want to make the port close to the chip as a possible. Currently working on the 4 layer stack up but if I switch to a 6 layer it might help with impedance and change the overall signal layering.
    Almost done with the Wiznet just need to do the clock and the TX/RX pairs.
    Once that is done I will work on the Ethernet switch then lastly the breakout pins for the RP.
    I should have selected either a 6 layer or 4 layer board, leaning more to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
    [RJ45_1.kicad_sch, RJ45_SW_1.kicad_sch, RK45_SW_2.kicad_sch, RK45_SW_3.kicad_sch, RK45_SW_4.kicad_sch, Wiznet.kicad_sch, newethernet.kicad_sch, peripheral_board.kicad_pcb]
2025-06-27 WIP
    Redoing Layout and tracks
    [imx8x_carrier_v1.kicad_pcb]
2025-06-27 WIP
    This is misery
    [SOM.kicad_sch, debug_usb.kicad_sch, imx8x_carrier_v1.kicad_pcb, imx_ethernet.kicad_sch]
2025-06-28 PCB layout
    Added a new version of the board that went from 4 layers to 6.
    Started the 6 layer board and moving forward with it.
    Need to restructure the board and use the via in pads.
    The wiznet is basically done just needs to be placed on the board.
    The RP is almost done but the GPIO is broken out but still need to put in the pins.
    Ethernet switch is mostly done. Need to figure out routing for the test pads and then place the RJ45 ports on the board. Once I have the ports and the chip in place there calculations have already been done for the routings just need to add the net class to the pins then it will be impedance protected.
    [RJ45_1.kicad_sch, RJ45_SW_1.kicad_sch, RK45_SW_2.kicad_sch, RK45_SW_3.kicad_sch, RK45_SW_4.kicad_sch, RK45_SW_5.kicad_sch, Wiznet.kicad_sch, ethernet_switch.kicad_sch]
2025-07-01 Partially Completed Layout
    [imx8x_carrier_v1.kicad_pcb]
2025-07-01 PCB Update
    Got all the parts on the board placed. Now just finishing the routing for each interconnection.
    Trying to maintain a side to side/up to down but the board kinda follows it. For each plane there is fill zones that will be for the chip that is on the top. Some of the traces are just being fed to where they need to go but the important EMI signals are being contained to their guidelines.
    I will need to look at the lengths of the traces to make sure they are kept around the same length.
    Will need to go over the board with some other eyes to make sure its ok.
    I made sure the Wiznet traces are the same as SALAD.
    [RJ45_SW_1.kicad_sch, RK45_SW_2.kicad_sch, RK45_SW_3.kicad_sch, RK45_SW_4.kicad_sch, Wiznet.kicad_sch, newethernet.kicad_sch, peripheral_board_v1a.kicad_pcb, rp.kicad_sch]
2025-07-01 added the funny
    [imx8x_carrier_v1.kicad_pcb]
2025-07-01 IMX Carrier Board Done
    Completed routing to the best of my ability along with the differential pairs of both ethernet ports, one going to the SOM and the other going to the RGMII translator.
    [imx_ethernet.kicad_sch]
2025-07-02 PCB almost done
    Finished the routing except for the power board connector. Will be looking into adding in a Power path controller or similar. Want to add in via stitching for the DP signals. Should be just about done it would be more of just doing some change/improvements.
    [RJ45_SW_1.kicad_sch, RK45_SW_2.kicad_sch, RK45_SW_3.kicad_sch, RK45_SW_4.kicad_sch, Wiznet.kicad_sch, newethernet.kicad_sch, rp.kicad_sch]
2025-07-02 PCB should be done
    Finished the PCB just needs a review and then the part selection should be easy.
    Added in stitching Vias.
    Added in a Power controller for the two power sources of the USB or the external power board.
    Removed the microSD card reader and added in XTSD which is just onboard NAND. It is around 1 gigabyte which should be enough space for any and all programs we are running.
    [newethernet.kicad_sch, power_control.kicad_sch, rp.kicad_sch]
2025-07-03 Update to root page
    Just changed the block diagram on the root page to separate the two ethernet ports to show the jetson and imx are two different machines.
    [newethernet.kicad_sch, peripheral_board_v1a.kicad_sch]
2025-07-08 Updated Board to RevF / Viking 1-C
    FIxed a minor error in the board that prevented subsystems from enabling correctly. Updated Both DF11 and Gecko variants.
    [EPS_Scales_RevE.kicad_pcb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]
2025-07-09 Part picking for board
    [RJ45_SW_1.kicad_sch, RK45_SW_2.kicad_sch, RK45_SW_3.kicad_sch, RK45_SW_4.kicad_sch, Wiznet.kicad_sch, newethernet.kicad_sch, rp.kicad_sch]
2025-07-09 Finished V1A
    Did a final review and got all the JLC parts and upload it to the shopping cart.
    [peripheral_board_v1a-CuBottom.gbr, peripheral_board_v1a-CuIn1.gbr, peripheral_board_v1a-CuIn2.gbr, peripheral_board_v1a-CuIn3.gbr, peripheral_board_v1a-CuIn4.gbr, peripheral_board_v1a-CuTop.gbr, peripheral_board_v1a-EdgeCuts.gbr, peripheral_board_v1a-MaskBottom.gbr]
2025-07-09 Completed EPS REV F / Viking 1-C PCB
    Fixed minor issue with the extra resistor for the EN line VD, and added temperature sensors for each subsystem.
    Also, the JPL logo is back!
    [EPS_Scales_RevF_DF11-CuBottom.gbr, EPS_Scales_RevF_DF11-CuIn1.gbr, EPS_Scales_RevF_DF11-CuIn2.gbr, EPS_Scales_RevF_DF11-CuTop.gbr, EPS_Scales_RevF_DF11-EdgeCuts.gbr, EPS_Scales_RevF_DF11-MaskBottom.gbr, EPS_Scales_RevF_DF11-MaskTop.gbr, EPS_Scales_RevF_DF11-NPTH.drl]
2025-07-09 JLC didnt have the temp sensor....
    Fixed it. GRRRRR
    [EPS_Scales_RevF_DF11-CuBottom.gbr, EPS_Scales_RevF_DF11-CuIn1.gbr, EPS_Scales_RevF_DF11-CuIn2.gbr, EPS_Scales_RevF_DF11-CuTop.gbr, EPS_Scales_RevF_DF11-EdgeCuts.gbr, EPS_Scales_RevF_DF11-MaskBottom.gbr, EPS_Scales_RevF_DF11-MaskTop.gbr, EPS_Scales_RevF_DF11-NPTH.drl]
2025-07-10 RevF Gecko Variant Added
    Added RevF Gecko Variant
    [EPS_Scales_RevF_GECKOS-CuBottom.gbr, EPS_Scales_RevF_GECKOS-CuIn1.gbr, EPS_Scales_RevF_GECKOS-CuIn2.gbr, EPS_Scales_RevF_GECKOS-CuTop.gbr, EPS_Scales_RevF_GECKOS-EdgeCuts.gbr, EPS_Scales_RevF_GECKOS-MaskBottom.gbr, EPS_Scales_RevF_GECKOS-MaskTop.gbr, EPS_Scales_RevF_GECKOS-NPTH.drl]
2025-07-11 Rerouting for RJ45 connection
    Did some rewiring for the RJ45. Need to route the other connections but Luca said he will take this on.
    All the EMI should be okay. Once all other connections are done then stitching vias.
    [imx_ethernet.kicad_sch, miscellaneous.kicad_sch]
2025-07-11 PCB step update
    Made some additions to the 3d files for the project.
    Deleted some old files that were just not being used.
    Would like to restructure the folders and remove the v1 and make a folder that is just KiCad dependancies to help version control.
    *Unsure if that is a good idea or if I should just leave it as project specific libriaries.*
    Will look over this before this is merged to main.
    [RJ45_1.kicad_sch, RJ45_SW_1.kicad_sch, RJ45_SW_2.kicad_sch, RJ45_SW_3.kicad_sch, RJ45_SW_4.kicad_sch, RK45_SW_2.kicad_sch, RK45_SW_3.kicad_sch, RK45_SW_4.kicad_sch]
2025-07-11 Fixing the file folder
    yes
    [Ethernet_Switch.kicad_sch, RJ45_1.kicad_sch, RJ45_SW_1.kicad_sch, RJ45_SW_2.kicad_sch, RJ45_SW_3.kicad_sch, RJ45_SW_4.kicad_sch, RK45_SW_2.kicad_sch, RK45_SW_3.kicad_sch]
2025-07-15 Changes to the structure of the Folder
    Made more changes to the structure of the folder. Mainly just some renaming of the images and making sure the Readme is correct
    [RJ45_1.kicad_sch, RJ45_SW_1.kicad_sch, RK45_SW_2.kicad_sch, RK45_SW_3.kicad_sch, RK45_SW_4.kicad_sch, RK45_SW_5.kicad_sch, Wiznet.kicad_sch, ethernet_switch.kicad_sch]
2025-08-01 added project files for jetson adapter
    [jetson_adapter_DF11.kicad_pcb, jetson_adapter_DF11.kicad_sch]
2025-08-02 Jetson Adapter Board - DF11 Version
    Created a little adapter board for the jetson to connect directly to the power board.
    [jetson_adapter_DF11.kicad_pcb, jetson_adapter_DF11.kicad_sch]
2025-08-05 Started V2
    [Backup_Power.kicad_sch, SCALES i.MX8QXP SOM config_pinmux.xlsx, SOM.kicad_sch, debug_usb.kicad_sch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]
2025-08-06 Layout Changes
    Consolidated the BOM a little bit, have to rerout
    [SOM.kicad_sch, debug_usb.kicad_sch, imx8x_carrier_v2.kicad_sch, imx_I2C.kicad_sch, imx_SPI.kicad_sch, imx_ethernet.kicad_sch, imx_power.kicad_sch, miscellaneous.kicad_sch]
2025-08-06 Created Gecko Variant
    [jetson_adapter_DF11.kicad_pcb, jetson_adapter_DF11.kicad_sch, jetson_adapter_Geckos.kicad_pcb, jetson_adapter_Geckos.kicad_sch]
2025-08-06 imx8 board v2 ethernet
    Wired the ethernet to the SOM connector. Checked to make sure there is length matching. Will need to look over it again once the board is complete.
    [imx8x_carrier_v2.kicad_pcb]
2025-08-06 Finished Routing.
    Completed routing and zone fills. Fixed some parts of the schematic as well.
    [SOM.kicad_sch, debug_usb.kicad_sch, imx8x_carrier_v2.kicad_sch, imx_SPI.kicad_sch, miscellaneous.kicad_sch]
2025-08-06 Gerbers and BOM generated
    [imx8x_carrier_v2-CuBottom.gbr, imx8x_carrier_v2-CuIn1.gbr, imx8x_carrier_v2-CuIn2.gbr, imx8x_carrier_v2-CuIn3.gbr, imx8x_carrier_v2-CuIn4.gbr, imx8x_carrier_v2-CuTop.gbr, imx8x_carrier_v2-EdgeCuts.gbr, imx8x_carrier_v2-MaskBottom.gbr]
2025-08-07 Fixed Minor things
    Fixed SOM Position
    Fixed Mounting Hole Sizes
    Updated Gerbers
    [SOM.kicad_sch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]
2025-08-09 imx changes
    [SOM.kicad_sch]
2025-08-10 Changes some things
    Made them all DF11. We have tons. And they can be secure.
    Updated PinMux Sheet. 1 of everything, while also using whats preconfigured on the dev board for some stuff. Its good for final review before ordering. This should work.
    [SCALES i.MX8QXP SOM config_pinmux.xlsx, SOM.kicad_sch, debug_usb.kicad_sch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]
2025-08-11 Final Gerbers, Fixed mounting holes
    [SOM.kicad_sch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]
2025-08-11 Created EPS/IMX Merger Board Files
    [Backup_Power.kicad_sch, SOM.kicad_sch, debug_usb.kicad_sch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]
2025-08-11 Refining Schematic Connections.
    [SOM.kicad_sch, imx8x_eps_v1.kicad_sch, imx_power.kicad_sch, jetsonwd.kicad_sch, obcwd.kicad_sch]
2025-08-21 EPS+IMX
    FIxed connector conflicts, redefined GPIO values and established a better flow for visuals.
    [SOM.kicad_sch, imx8x_eps_v1.kicad_sch, imx_microSD.kicad_sch, imx_power.kicad_sch, jetsonwd.kicad_sch, miscellaneous.kicad_sch, obcwd.kicad_sch]
2025-08-26 Added Sub-sheet Descriptions
    [SOM.kicad_sch, debug_usb.kicad_sch, imx8x_carrier_v2.kicad_sch, imx_SPI.kicad_sch, imx_ethernet.kicad_sch, imx_microSD.kicad_sch, imx_power.kicad_sch, miscellaneous.kicad_sch]
2025-08-28 Minor Improvements
    [SOM.kicad_sch, debug_usb.kicad_sch, imx_ethernet.kicad_sch]
2025-08-28 Generated Step
    [SOM.kicad_sch]
2025-08-28 Corrected Unused Pin Strapping
    [SOM.kicad_sch]
2025-08-28 Removed Unused Resistor
2025-08-28 Gerbers Generated
    [imx8x_carrier_v2-CuBottom.gbr, imx8x_carrier_v2-CuIn1.gbr, imx8x_carrier_v2-CuIn2.gbr, imx8x_carrier_v2-CuIn3.gbr, imx8x_carrier_v2-CuIn4.gbr, imx8x_carrier_v2-CuTop.gbr, imx8x_carrier_v2-EdgeCuts.gbr, imx8x_carrier_v2-MaskBottom.gbr]
2025-08-29 New Ethernet Switch
    Moving away from the rp and just creating a smaller board that is just an Ethernet switch. Did a lot of changes to read me and just want a working board that we can use for testing.
    [periph_ethernet_switch.kicad_pcb, periph_ethernet_switch.kicad_sch, peripheral_board_v1a.kicad_sch, port1.kicad_sch, port2.kicad_sch, port3.kicad_sch, port4.kicad_sch, port5.kicad_sch]
2025-08-30 Fixed R56 IC Overlap
    Generated New Production Files
    [imx8x_carrier_v2-CuBottom.gbr, imx8x_carrier_v2-CuIn1.gbr, imx8x_carrier_v2-CuIn2.gbr, imx8x_carrier_v2-CuIn3.gbr, imx8x_carrier_v2-CuIn4.gbr, imx8x_carrier_v2-CuTop.gbr, imx8x_carrier_v2-EdgeCuts.gbr, imx8x_carrier_v2-MaskBottom.gbr]
2025-09-02 Ethernet Switch WIP
    # Changes Made
    ## Ports
    Finished all the Ethernet ports for 1 through 5 while leaving 6 unconfigured.
    ## Hardware Config
    Added in the strap in configuration using break out pins for ease of use and not having to worry about switches. This should allow for the built in Default config but allows for external setting as well.
    [periph_ethernet_switch.kicad_sch, port1.kicad_sch, port2.kicad_sch, port3.kicad_sch, port4.kicad_sch, port5.kicad_sch, port6.kicad_sch]
2025-09-02 Updated readme.md and Adapter board
2025-09-02 Removed Adapter Board
    [jetson_adapter_DF11.kicad_pcb, jetson_adapter_DF11.kicad_sch, jetson_adapter_Geckos.kicad_pcb, jetson_adapter_Geckos.kicad_sch]
2025-09-02 Removed Merge board
    [Backup_Power.kicad_sch, SOM.kicad_sch, debug_usb.kicad_sch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]
2025-09-04 Switch update
    Still making changes to the switch. Finished most of the power but still need to work on the power logic for when it is being powered. Need to do the debug and the clock logic but it is getting close to pcb design.
    [periph_ethernet_switch.kicad_sch, port1.kicad_sch, port2.kicad_sch, port3.kicad_sch, port4.kicad_sch, port5.kicad_sch, power_debug.kicad_sch, strap_in_config.kicad_sch]
2025-09-05 Switch Schematic Update
    The switch schematic should be done. Waiting on a review but should be ready for moving forward with board layout.
    [periph_ethernet_switch.kicad_sch, port1.kicad_sch, port2.kicad_sch, port3.kicad_sch, port4.kicad_sch, port5.kicad_sch, power_debug.kicad_sch, strap_in_config.kicad_sch]
2025-09-06 Moving to PCB layout
    Finished the schematic and now working on the PCB. Got the RJ45 ports on the board but it does not look like it will fit in the current form factor.
    [periph_ethernet_switch.kicad_pcb, periph_ethernet_switch.kicad_sch, port1.kicad_sch, port2.kicad_sch, port3.kicad_sch, port4.kicad_sch, port5.kicad_sch, power.kicad_sch]
2025-09-09 Working on the board layout
    The differential pairs are being a pain. Signals B and D need to be crossed which is not ideal. Some of the signals do not seem to want to connect which is making this a fun time. Still need to put in the structures like the drill holes. I have not done the capacitors yet but I think I might do that next time then do the DP routing to make life a bit more straight forward.
    [periph_ethernet_switch.kicad_pcb, periph_ethernet_switch.kicad_sch, port1.kicad_sch, port2.kicad_sch, port3.kicad_sch, port4.kicad_sch, port5.kicad_sch, power.kicad_sch]
2025-09-11 Board layout WIP
    Redid the placement of the board due to the structure which should be good now. Started to put stuff on the back of the board to make sure that there is enough space for the Ethernet signals. Have not put the pull configuration on the board yet but will do so after the the RJ45 connections are done. This still needs to be decided if they are placed near their port or the pin on the chip. Most of the tougher layout is done. Will still need to run through the design check list to make sure it satisfies the board.
    [periph_ethernet_switch.kicad_pcb, periph_ethernet_switch.kicad_sch]
2025-09-12 Switch PCB layout done
    The layout should be done. there are a lot of DRC errors but it seems like it is all for things like through holes and other similar items are causing this.
    [periph_ethernet_switch.kicad_pcb, periph_ethernet_switch.kicad_sch, port1.kicad_sch, port2.kicad_sch, port3.kicad_sch, port4.kicad_sch, port5.kicad_sch, power.kicad_sch]
2025-09-16 Board layout and DP tuning
    Had to move some items around and then I keep running into a problem for tuning length on one of the ports is double the length making tuning more difficut.
    [periph_ethernet_switch.kicad_pcb]
2025-09-18 PCB just about done
    Need to do a final review of the PCB and then the last of the BOM. Almost done and needed to redownload the JLC addon
    [periph_ethernet_switch-CuBottom.gbr, periph_ethernet_switch-CuIn1.gbr, periph_ethernet_switch-CuIn2.gbr, periph_ethernet_switch-CuTop.gbr, periph_ethernet_switch-EdgeCuts.gbr, periph_ethernet_switch-MaskBottom.gbr, periph_ethernet_switch-MaskTop.gbr, periph_ethernet_switch-NPTH.drl]
2025-09-18 Ready to order the board
    [periph_ethernet_switch-CuBottom.gbr, periph_ethernet_switch-CuIn1.gbr, periph_ethernet_switch-CuIn2.gbr, periph_ethernet_switch-CuTop.gbr, periph_ethernet_switch-EdgeCuts.gbr, periph_ethernet_switch-MaskBottom.gbr, periph_ethernet_switch-MaskTop.gbr, periph_ethernet_switch-NPTH.drl]
2025-10-09 Minor update to the schematic and board
    Added a resistor to the clock and changed some of the trace connections
    [periph_ethernet_switch.kicad_pcb, periph_ethernet_switch.kicad_sch]
2025-10-15 Small changes from Microchip
    [periph_ethernet_switch.kicad_pcb, periph_ethernet_switch.kicad_sch]
2025-10-22 Created EPS_REVG
    Added more Caps to Vbatt side, Added pull downs to bias En lines, added 1k to watchdog outputs. Prepping for IMX+Power board combining.
    [EPS_Scales_RevG-CuBottom.gbr, EPS_Scales_RevG-CuIn1.gbr, EPS_Scales_RevG-CuIn2.gbr, EPS_Scales_RevG-CuTop.gbr, EPS_Scales_RevG-EdgeCuts.gbr, EPS_Scales_RevG-MaskBottom.gbr, EPS_Scales_RevG-MaskTop.gbr, EPS_Scales_RevG-NPTH.drl]
2025-10-22 Created Merger Board
    Added Modified EPS board
    [JetsonSubsystem.kicad_sch, OBC_Subsystem.kicad_sch, Perif_Subsystem.kicad_sch, SCALES_EPS.kicad_sch, WD_Jetson.kicad_sch, WD_OBC.kicad_sch, imx8qxp_carrier_board.kicad_sch, imx8x_eps_leviathan.kicad_pcb]
2025-10-23 Worked on IMX part of schematic
    Did the big part placement for the IMX part of the board. Finished the boot config, debug, ethernet ports, ethernet power and ethernet trigger buffer.
    Still need to do the major part of the ethernet IC.
    There are a few comments on the schematic we got back from Phytec that I am unsure what they mean.
    [JetsonSubsystem.kicad_sch, OBC_Subsystem.kicad_sch, Perif_Subsystem.kicad_sch, SCALES_EPS.kicad_sch, SOM.kicad_sch, WD_Jetson.kicad_sch, WD_OBC.kicad_sch, bootConfig.kicad_sch]
2025-10-24 Did stufffffff
    [OBC_Subsystem.kicad_sch, SCALES_EPS.kicad_sch, bootConfig.kicad_sch, debug.kicad_sch, ethernet.kicad_sch, ethernet0.kicad_sch, ethernet1.kicad_sch, imx8x_eps_leviathan.kicad_pcb]
2025-10-24 small
    small changes
    [JetsonSubsystem.kicad_sch, SCALES_EPS.kicad_sch]
2025-10-24 for john
    [debug.kicad_sch]
2025-10-24 WIP Ethernet
    Don't have right lib on my laptop
    [SOM.kicad_sch, ethernet.kicad_sch, imx8qxp_carrier_board.kicad_sch]
2025-10-24 good stufff
    [Pgood_Power.kicad_sch, SOM.kicad_sch, ethernet.kicad_sch, imx8qxp_carrier_board.kicad_sch]
2025-10-27 Updated Schematic and SOM
    [JetsonSubsystem.kicad_sch, OBC_Subsystem.kicad_sch, Perif_Subsystem.kicad_sch, Pgood_Power.kicad_sch, SCALES_EPS.kicad_sch, SOM.kicad_sch, WD_Jetson.kicad_sch, WD_OBC.kicad_sch]
2025-10-29 Schematic Need Double Checking, But I think its done
    I think ive finished adding every change we wanted to include after the merging along with all the changes requested by PHYTEC. I would like to sit down and review the muxing configuration and double check every single sheet to make sure its perfect. then we can send it off to Phytec.
    [JetsonSubsystem.kicad_sch, OBC_Subsystem.kicad_sch, Perif_Subsystem.kicad_sch, Pgood_Power.kicad_sch, SOM.kicad_sch, WD_OBC.kicad_sch, debug.kicad_sch, ethernet.kicad_sch]
2025-10-29 Schematic Complete. Ready for Phytec.
    Fixed muxing with a few things that were missing with ETH1, and corrected some missing labels. Ready for Phytecs review.
    [SOM.kicad_sch, debug.kicad_sch, ethernet.kicad_sch, ethernet1.kicad_sch, imx8qxp_carrier_board.kicad_sch, imx8x_eps_leviathan.kicad_sch, periphCon.kicad_sch]
2025-10-30 Completed Schematic, Started Layout
    [JetsonSubsystem.kicad_sch, OBC_Subsystem.kicad_sch, Perif_Subsystem.kicad_sch, Pgood_Power.kicad_sch, SCALES_EPS.kicad_sch, SOM.kicad_sch, WD_Jetson.kicad_sch, WD_OBC.kicad_sch]
2025-10-30 WIP for new switch
    Made some minor changes which are detailed in Notion.
    [periph_ethernet_switch.kicad_sch, port1.kicad_sch, port2.kicad_sch, port3.kicad_sch, port4.kicad_sch, port5.kicad_sch, power.kicad_sch, strap_in_config.kicad_sch]
2025-10-31 Changes to the board layout
    Need to finish doing some layout but waiting on Microchip to confirm with what I have. Might want to change the EDA symbol for the switch IC.
    [periph_ethernet_switch.kicad_pcb, periph_ethernet_switch.kicad_sch, port1.kicad_sch, port2.kicad_sch, port3.kicad_sch, port4.kicad_sch, port5.kicad_sch, power.kicad_sch]
2025-11-04 Changes based on Microchip support
    Made some changes for the strap in configuration. Did some some layout changes. Used the same circuit for the clock and strap in switch from their other Dev kit. Waiting on them to get back to me for a potential schematic review/board review.
    [periph_ethernet_switch.kicad_pcb, periph_ethernet_switch.kicad_sch, port1.kicad_sch, port2.kicad_sch, port3.kicad_sch, port4.kicad_sch, port5.kicad_sch, power.kicad_sch]
2025-11-05 Working on Simulation of EPS
    [EPS_Scales_RevG.kicad_sch]
2025-11-06 Next version of the Switch
    Got some feed back from Microchip. I sent it off for them look at. Will continue to make changes and updates here
    [periph_ethernet_switch.kicad_pcb, periph_ethernet_switch.kicad_sch, port1.kicad_sch, port2.kicad_sch, port3.kicad_sch, port4.kicad_sch, port5.kicad_sch, power.kicad_sch]
2025-11-07 Little changes to the PCB
    Made a little bit of some changes of the traces for the decoupling caps.
    [periph_ethernet_switch.kicad_pcb, periph_ethernet_switch.kicad_sch]
2025-11-18 Updates from Microchip
    Finally got a response for my schematic from Microchip support. Made a few changes that they recommended. Changed the crystal, updated a power pin, and added in the resistors for the LEDs. Sent it back with the updates and once it seems okay I will move everything over to layout and then send it to them there. I will need to make it in Altium to make life easier since they do not use KiCad.
    [periph_ethernet_switch.kicad_sch, port1.kicad_sch, port2.kicad_sch, port3.kicad_sch, port4.kicad_sch, port5.kicad_sch, power.kicad_sch]
2025-11-20 Little update from Microchip
    Got a bit more feedback but seems like it might be good to go to board layout. Took the reset circuit from a same family chip dev board. Now just waiting to see if they will accept my stuff from KiCad.
    [periph_ethernet_switch.kicad_sch, port1.kicad_sch, port2.kicad_sch, port3.kicad_sch, port4.kicad_sch, port5.kicad_sch, power.kicad_sch]
2025-11-20 Board layout update from Microchip notes
    Did some minor changes to the board layout.
    [periph_ethernet_switch.kicad_pcb]
2025-12-02 Little Updates from Microchip
    Got some feedback from microchip right before the Holiday weekend and implemented them on to the board and asked some clarifying questions on what steps to do moving forward with some design guidelines. Not much feedback on the layout but there was some confusion since it was ported from KiCad to Altium.
    [periph_ethernet_switch.kicad_pcb, power.kicad_sch]
2025-12-04 Minor updates
    Added a pull resistor for the SPI and added it to the PCB design. Microchip is recommending a couple of different things which will require some more major changes which will need to wait.
    [periph_ethernet_switch.kicad_pcb, power.kicad_sch]
2025-12-15 Switch should be done
    Board layout is done. Should be good to order. Just would need a review. All the parts have been selected and are in the jlcpcb folder of the project.
    [periph_ethernet_switch-CuBottom.gbr, periph_ethernet_switch-CuIn1.gbr, periph_ethernet_switch-CuIn2.gbr, periph_ethernet_switch-CuTop.gbr, periph_ethernet_switch-EdgeCuts.gbr, periph_ethernet_switch-MaskBottom.gbr, periph_ethernet_switch-MaskTop.gbr, periph_ethernet_switch-NPTH.drl]
2025-12-19 Made board a 6-layer
    Microchip wanted the board to be a 6-layer stack up because they said a solid ground plane under the differential signals was needed. Waiting on them now. I might in the mean time look for an alterative for magnetics and use of the geckos but I do not think it will be needed/used.
    [periph_ethernet_switch.kicad_pcb]
2025-12-19 Forgot to save
    Forgot to save some of the changes of the signals before the last push.
    [periph_ethernet_switch.kicad_pcb]
2025-12-29 Update from Microchip
    Changed some things from the recommendation of Microchip over a call. The changes were:
    * Make the chassis ground smaller and more towards the bottom of the board.
    * Add in a resistor for the SPI lines.
    * Move some of the routing around to better help with EMI.
    * Got an approval that it should be good to go.
    [periph_ethernet_switch.kicad_pcb, periph_ethernet_switch.kicad_sch, power.kicad_sch]
2026-01-07 Fixed the Differential pair width
    Fixed some sizes and routing of the DP which should now be 100 ohm impedance for a 6 layer board instead of a 4 layer board.
    [periph_ethernet_switch.kicad_pcb, periph_ethernet_switch.kicad_sch]
2026-01-12 Added text to SPI breakout
    [periph_ethernet_switch.kicad_pcb]
2026-01-12 Fixed the changes from Phytec
    Fixed the issues from the most recent phytec review. Need to still go through the older fixes before the board was merged. This is currently up to date for the what I think is the minimum configuration and use ability.
    Thing to note is that there is still a few different sheets that I think need to be added but the major functinallity is there.
    [SOM.kicad_sch, bootConfig.kicad_sch, debug.kicad_sch, ethernet.kicad_sch]
2026-03-06 Pushed all changes requested by Phytec
    Sent off v2 review pdf to phytec for review. After I will commence layout
    [JetsonSubsystem.kicad_sch, OBC_Subsystem.kicad_sch, Perif_Subsystem.kicad_sch, SOM.kicad_sch, WD_OBC.kicad_sch, ethernet.kicad_sch, imx8x_eps_leviathan.kicad_sch, periphCon.kicad_sch]
2026-03-06 Updated board name
    No desc. needed
    [JetsonSubsystem.kicad_sch, OBC_Subsystem.kicad_sch, Perif_Subsystem.kicad_sch, Pgood_Power.kicad_sch, SCALES_EPS.kicad_sch, SOM.kicad_sch, WD_Jetson.kicad_sch, WD_OBC.kicad_sch]
2026-03-10 Started Cadence Sim of EPS
    [eps_mergersim.opj]
2026-03-10 Production Files regenerated
    [periph_ethernet_switch-CuBottom.gbr, periph_ethernet_switch-CuIn2.gbr, periph_ethernet_switch-CuIn3.gbr, periph_ethernet_switch-CuIn4.gbr, periph_ethernet_switch-CuTop.gbr, periph_ethernet_switch-EdgeCuts.gbr, periph_ethernet_switch-MaskBottom.gbr, periph_ethernet_switch-MaskTop.gbr]
2026-03-12 LCSC mismatch R25 Compared to GERBER
    Issue with R25 being matched to an 0402 part number while having an 0603 footprint. Corrected with a 475Kohm. 4 percent change in voltage, should be negligible
    [periph_ethernet_switch.kicad_pcb]
2026-03-13 getting a simulation model using some kind of circuit simulation tool
    [ECL-OR.kicad_sch, JetsonSubsystem.kicad_sch, OBC_Subsystem.kicad_sch, Perif_Subsystem.kicad_sch, TPS1HB08B-Q1_TRANS.OLB, TPS1HB08B-Q1_TRANS.opj, eps_mergersim.opj]
2026-03-14 Working on Simulation Models
    Got the TPS1 working. Got the LT8612 working. Working on the Comparator network for the watchdog
    [OBC_Subsystem.kicad_sch, SOM.kicad_sch, TPS1HB08.opj, TPS1HB08B-Q1_TRANS.OLB, TPS1HB08B-Q1_TRANS.opj, bootConfig.kicad_sch, ethernet.kicad_sch]
2026-03-14 Got the wd circuit working
2026-03-17 added jetson
    [imx8x_eps_leviathan.kicad_sch]
2026-03-17 testing stuff for simulations
    [JetsonSubsystem.kicad_sch, OBC_Subsystem.kicad_sch, Perif_Subsystem.kicad_sch]
2026-03-17 Added Phytecs last recommended changes
    Updated 3/17/26
    [bootConfig.kicad_sch]
2026-03-18 Started Layout for Leviathan board
    [JetsonSubsystem.kicad_sch, OBC_Subsystem.kicad_sch, Perif_Subsystem.kicad_sch, SCALES_EPS.kicad_sch, WD_Jetson.kicad_sch, WD_OBC.kicad_sch, imx8x_eps_leviathan.kicad_pcb]
2026-03-18 Continuing Layout
    [JetsonSubsystem.kicad_sch, OBC_Subsystem.kicad_sch, Perif_Subsystem.kicad_sch, SCALES_EPS.kicad_sch, WD_Jetson.kicad_sch, WD_OBC.kicad_sch, imx8x_eps_leviathan.kicad_pcb, imx8x_eps_leviathan.kicad_sch]
2026-03-21 working on ethernmet
    [JetsonSubsystem.kicad_sch, Perif_Subsystem.kicad_sch, imx8x_eps_leviathan.kicad_pcb, periphCon.kicad_sch]
2026-03-21 Differential pair routing complete for Ethernet PHY and MAC
    [ethernet.kicad_sch, ethernet0.kicad_sch, ethernet1.kicad_sch]
2026-03-22 Finished Main parts, fixing up minor things.
    [SOM.kicad_sch, debug.kicad_sch]
2026-03-22 Layout Complete
    [JetsonSubsystem.kicad_sch, WD_Jetson.kicad_sch, WD_OBC.kicad_sch, debug.kicad_sch, ethernet.kicad_sch, imx8x_eps_leviathan.kicad_sch]
2026-03-22 Board is complete. Time for review
    [JetsonSubsystem.kicad_sch]
2026-03-22 added pdf for pragun
    [imx8x_eps_leviathan.kicad_sch]
2026-03-23 Revert "added pdf for pragun"
    This reverts commit 87f3d1fa9dc01742d1701195db4eb9d6ea62f6a2.
    [imx8x_eps_leviathan.kicad_sch]
2026-03-23 Reapply "added pdf for pragun"
    This reverts commit 2237413703986e0d90921f0b96416ae631cd9e08.
    [imx8x_eps_leviathan.kicad_sch]
2026-03-23 Minor updates based on Praguns feedback
    moved a power plane that was under differential signals to fix referencing
2026-03-24 Small Fixes. Gerber Push
    [WD_Jetson.kicad_sch, ethernet.kicad_sch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]
2026-03-25 Fixed Micro USB port overlapping board
    [imx8x_eps_leviathan-CuBottom.gbr, imx8x_eps_leviathan-CuIn1.gbr, imx8x_eps_leviathan-CuIn2.gbr, imx8x_eps_leviathan-CuIn3.gbr, imx8x_eps_leviathan-CuIn4.gbr, imx8x_eps_leviathan-CuTop.gbr, imx8x_eps_leviathan-EdgeCuts.gbr, imx8x_eps_leviathan-MaskBottom.gbr]
2026-03-25 Fixed USB problem. New STEP and GERBERS generated
    [imx8x_eps_leviathan-CuBottom.gbr, imx8x_eps_leviathan-CuIn1.gbr, imx8x_eps_leviathan-CuIn2.gbr, imx8x_eps_leviathan-CuIn3.gbr, imx8x_eps_leviathan-CuIn4.gbr, imx8x_eps_leviathan-CuTop.gbr, imx8x_eps_leviathan-EdgeCuts.gbr, imx8x_eps_leviathan-MaskBottom.gbr]
2026-04-01 Updated LCSC Part Mappings to fix Manufacturing issues
    Changed 0402x4 resistors to 0402
    Changed FTDI chip from LFN package to QFN
2026-04-01 Fixed LCSC part numbers
    FTDI corrected to QFN package
    Resistors with 0402x4 corrected to 0402.
    Cant generate Gerbers due to issue with KICAD 10 support with JLCPCB plugin.
    [imx8x_eps_leviathan-CuBottom.gbr, imx8x_eps_leviathan-CuIn1.gbr, imx8x_eps_leviathan-CuIn2.gbr, imx8x_eps_leviathan-CuIn3.gbr, imx8x_eps_leviathan-CuIn4.gbr, imx8x_eps_leviathan-CuTop.gbr, imx8x_eps_leviathan-EdgeCuts.gbr, imx8x_eps_leviathan-MaskBottom.gbr]
2026-04-02 Revert "Delete ~imx8x_eps_leviathan.kicad_sch.lck"
    This reverts commit 8609153bca09ff3d724b382efb6faa0061199db3.
2026-04-02 Reapply "Delete ~imx8x_eps_leviathan.kicad_sch.lck"
    This reverts commit 8216c13ce7caa1f9886631e12e95ca67fb38b01d.
2026-04-02 Updated Production Files to Fix mismatched LCSC part numbers and footprints
    Fixed resistors with 0402x4 part numbers to 0402
    Fixed FTDI chip to QFN package.
    [imx8x_eps_leviathan-CuBottom.gbr, imx8x_eps_leviathan-CuIn1.gbr, imx8x_eps_leviathan-CuIn2.gbr, imx8x_eps_leviathan-CuIn3.gbr, imx8x_eps_leviathan-CuIn4.gbr, imx8x_eps_leviathan-CuTop.gbr, imx8x_eps_leviathan-EdgeCuts.gbr, imx8x_eps_leviathan-MaskBottom.gbr]
2026-04-02 Updated Production files updated for kicad 10
2026-04-21 [FIXES]
    Added RJ45 with integrated Magnetics
    Fixed X_ADMA_UART0 miswiring.
    Need to start mapping connections and reroute on PCB
    [ECL-OR.kicad_sch, JetsonSubsystem.kicad_sch, OBC_Subsystem.kicad_sch, Perif_Subsystem.kicad_sch, Pgood_Power.kicad_sch, SCALES_EPS.kicad_sch, SOM.kicad_sch, TPS1HB08.opj]
2026-04-21 Added new PHY Jacks. Removed Not used Signals
    [SOM.kicad_sch, ethernet0.kicad_sch, ethernet1.kicad_sch]
2026-04-22 updates
    moves symbols to look nicer
    [debug.kicad_sch, ethernet0.kicad_sch]
2026-04-22 Goodies
    Updated USB to USB C. Added Diodes for USB. Improved Layout. Ready for some routing.
    [JetsonSubsystem.kicad_sch, OBC_Subsystem.kicad_sch, Perif_Subsystem.kicad_sch, Pgood_Power.kicad_sch, SCALES_EPS.kicad_sch, SOM.kicad_sch, WD_Jetson.kicad_sch, WD_OBC.kicad_sch]
2026-04-23 Started routing
    [debug.kicad_sch, imx8x_eps_leviathan_v2.kicad_pcb]
2026-04-23 More routing
    [SCALES_EPS.kicad_sch, imx8x_eps_leviathan_v2.kicad_pcb, periphCon.kicad_sch]
2026-04-23 Continued Layout
    [WD_Jetson.kicad_sch, WD_OBC.kicad_sch, ethernet.kicad_sch]
2026-04-23 Added some notes for phytec. Fixed CMD and SCK uSD card pull up.
    [bootConfig.kicad_sch, debug.kicad_sch]
2026-04-24 Routing updates
    [debug.kicad_sch]
2026-04-24 Did more routing
    [SOM.kicad_sch]
2026-04-24 Finished Layout. Board is complete
    [SCALES_EPS.kicad_sch, debug.kicad_sch, ethernet.kicad_sch, imx8x_eps_leviathan_v2.kicad_sch]
2026-04-25 added board outline
2026-04-29 Gerbers + BOM generated
    [imx8x_eps_leviathan_v2-CuBottom.gbr, imx8x_eps_leviathan_v2-CuIn1.gbr, imx8x_eps_leviathan_v2-CuIn2.gbr, imx8x_eps_leviathan_v2-CuIn3.gbr, imx8x_eps_leviathan_v2-CuIn4.gbr, imx8x_eps_leviathan_v2-CuTop.gbr, imx8x_eps_leviathan_v2-EdgeCuts.gbr, imx8x_eps_leviathan_v2-MaskBottom.gbr]
2026-04-30 Updated Gerbers + BOM
    [imx8x_eps_leviathan_v2-CuBottom.gbr, imx8x_eps_leviathan_v2-CuIn1.gbr, imx8x_eps_leviathan_v2-CuIn2.gbr, imx8x_eps_leviathan_v2-CuIn3.gbr, imx8x_eps_leviathan_v2-CuIn4.gbr, imx8x_eps_leviathan_v2-CuTop.gbr, imx8x_eps_leviathan_v2-EdgeCuts.gbr, imx8x_eps_leviathan_v2-MaskBottom.gbr]
2026-05-18 Fixed Duplicates. Updated Gerber and BOM
    [Pgood_Power.kicad_sch, SOM.kicad_sch, WD_OBC.kicad_sch, bootConfig.kicad_sch, debug.kicad_sch, ethernet.kicad_sch, ethernet0.kicad_sch, ethernet1.kicad_sch]
2026-05-18 Fixed an ERC error, and updated reference designators so there are no more conflicts
    [Perif_Subsystem.kicad_sch, WD_Jetson.kicad_sch, imx8x_eps_leviathan_v2.kicad_pcb, periphCon.kicad_sch]
2026-05-18 Generated BOM and Gerbers
    [imx8x_eps_leviathan_v2-CuBottom.gbr, imx8x_eps_leviathan_v2-CuIn1.gbr, imx8x_eps_leviathan_v2-CuIn2.gbr, imx8x_eps_leviathan_v2-CuIn3.gbr, imx8x_eps_leviathan_v2-CuIn4.gbr, imx8x_eps_leviathan_v2-CuTop.gbr, imx8x_eps_leviathan_v2-EdgeCuts.gbr, imx8x_eps_leviathan_v2-MaskBottom.gbr]
2026-05-22 Fixed errors I forgot about
    [debug.kicad_sch, ethernet.kicad_sch, ethernet0.kicad_sch, ethernet1.kicad_sch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]
2026-05-24 Replaced an image and fixed reference designators
    New Gerbers Generated
    [imx8x_eps_leviathan_v2.kicad_pcb]
2026-06-02 Gerbers updated
    [imx8x_eps_leviathan_v2-CuBottom.gbr, imx8x_eps_leviathan_v2-CuIn1.gbr, imx8x_eps_leviathan_v2-CuIn2.gbr, imx8x_eps_leviathan_v2-CuIn3.gbr, imx8x_eps_leviathan_v2-CuIn4.gbr, imx8x_eps_leviathan_v2-CuTop.gbr, imx8x_eps_leviathan_v2-EdgeCuts.gbr, imx8x_eps_leviathan_v2-MaskBottom.gbr]
2026-06-11 Ordered Production Files
    Ordered on 6/10/26
    [imx8x_eps_leviathan_v2-CuBottom.gbr, imx8x_eps_leviathan_v2-CuIn1.gbr, imx8x_eps_leviathan_v2-CuIn2.gbr, imx8x_eps_leviathan_v2-CuIn3.gbr, imx8x_eps_leviathan_v2-CuIn4.gbr, imx8x_eps_leviathan_v2-CuTop.gbr, imx8x_eps_leviathan_v2-EdgeCuts.gbr, imx8x_eps_leviathan_v2-MaskBottom.gbr]
